eSpark-Backup/nabilfesal-smartmeter-hw/Design-Files/OFP_MCM_v1.6.3/Deliverables/_Renderings/2D_C_View.png

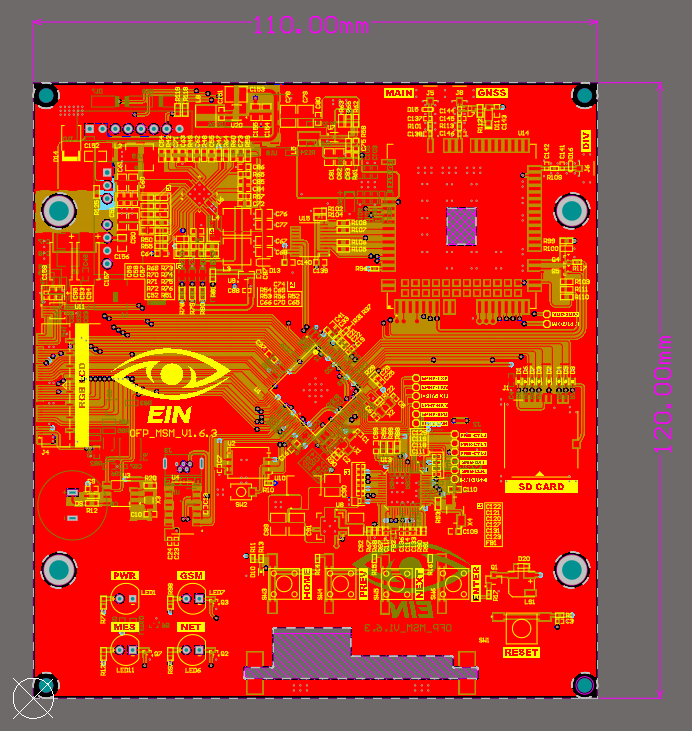
Design-Files/OFP_MCM_v1.6.3/Deliverables/_Renderings/2D_C_View.png
