eSpark-Backup/nabilfesal-smartmeter-hw/Design-Files/OFP_MCM_v1.6.3/Deliverables/_Renderings/3D_Isometric_View.png

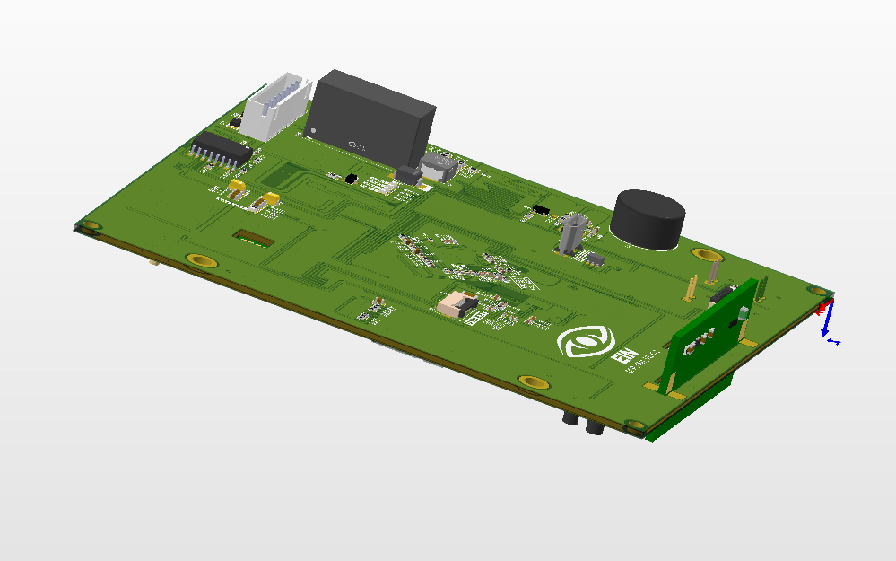
Design-Files/OFP_MCM_v1.6.3/Deliverables/_Renderings/3D_Isometric_View.png
