eSpark-Backup/nabilfesal-smartmeter-hw/Design-Files/OFP_VIM_DC_v1.51/Deliverables/Renderings/2D-C-view.png

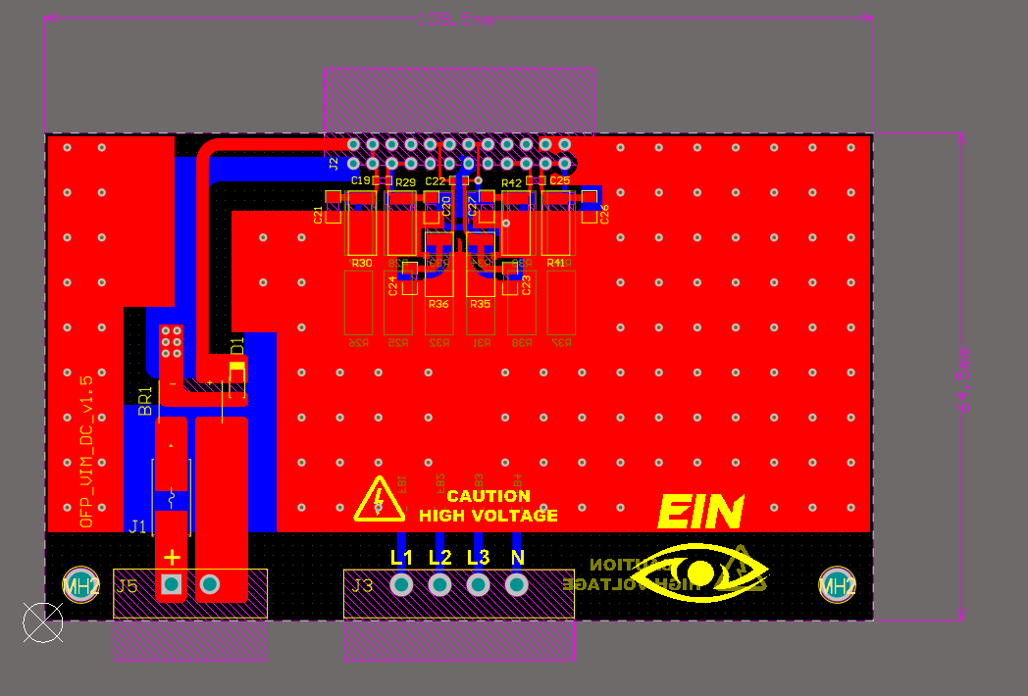
Design-Files/OFP_VIM_DC_v1.51/Deliverables/Renderings/2D-C-view.png
