eSpark-Backup/nabilfesal-smartmeter-hw/Design-Files/OFP_VIM_v1.51/Deliverables/Renderings/3D-ISOMETRIC-view.png

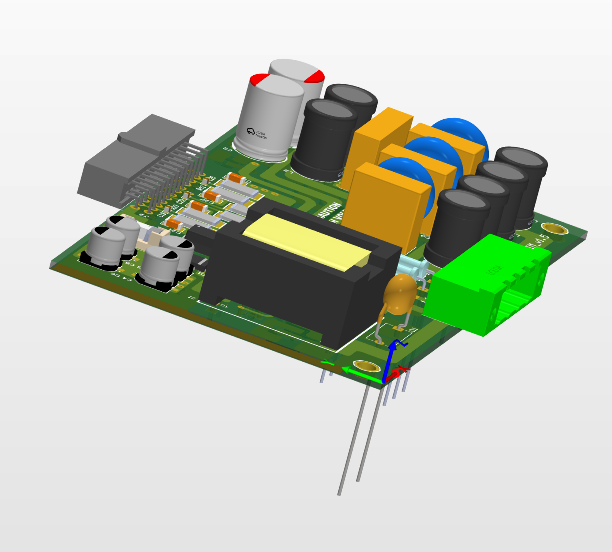
Design-Files/OFP_VIM_v1.51/Deliverables/Renderings/3D-ISOMETRIC-view.png
