eSpark-Backup/nabilfesal-smartmeter-hw/docs/Client-Files/PCB Images/20241227_104141.jpg

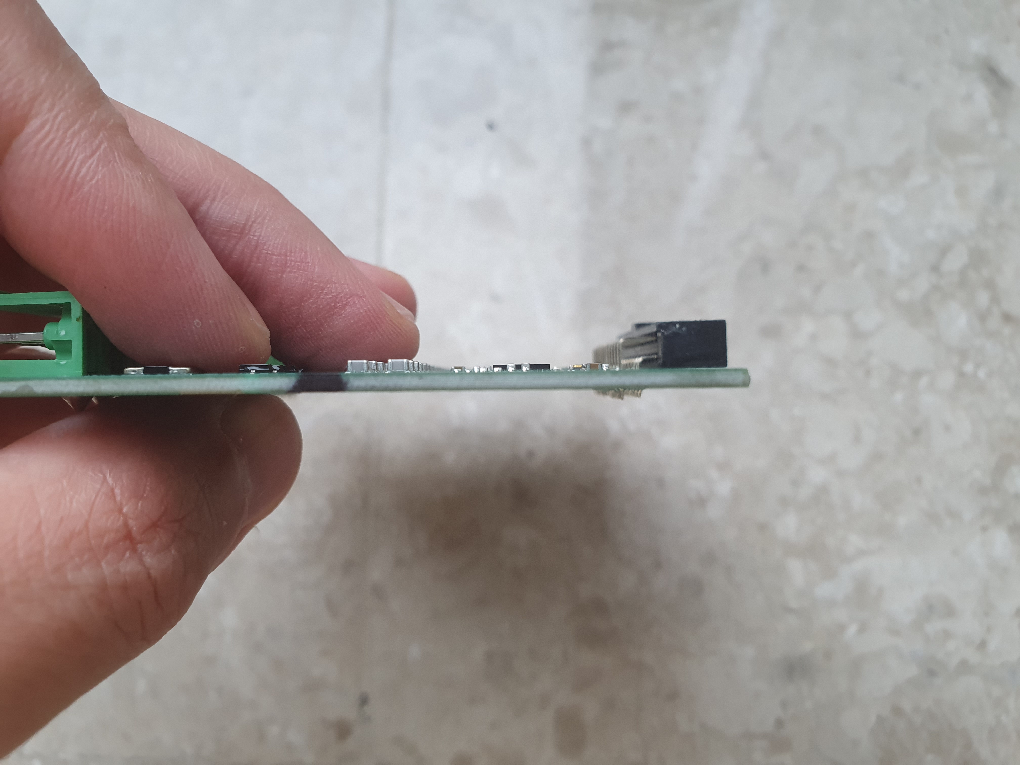
docs/Client-Files/PCB Images/20241227_104141.jpg
