eSpark-Backup/nabilfesal-smartmeter-hw/docs/Client-Files/PCB Images/20241227_104458.jpg

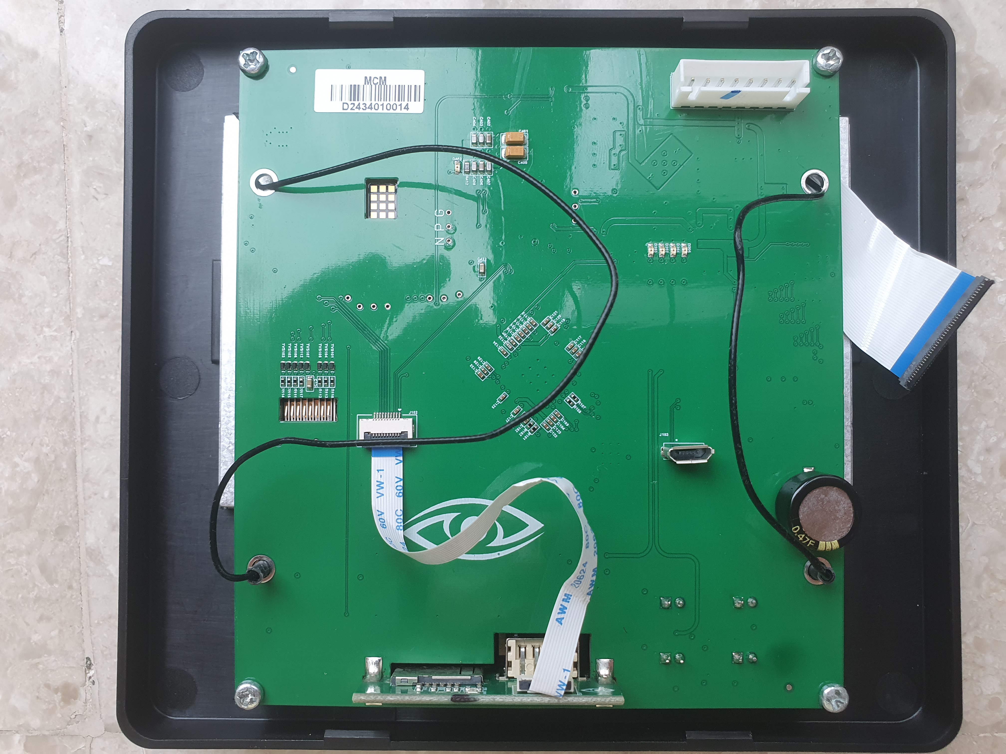
docs/Client-Files/PCB Images/20241227_104458.jpg
