eSpark-Backup/nabilfesal-smartmeter-hw/docs/Client-Files/PCB Images/20241227_105442.jpg

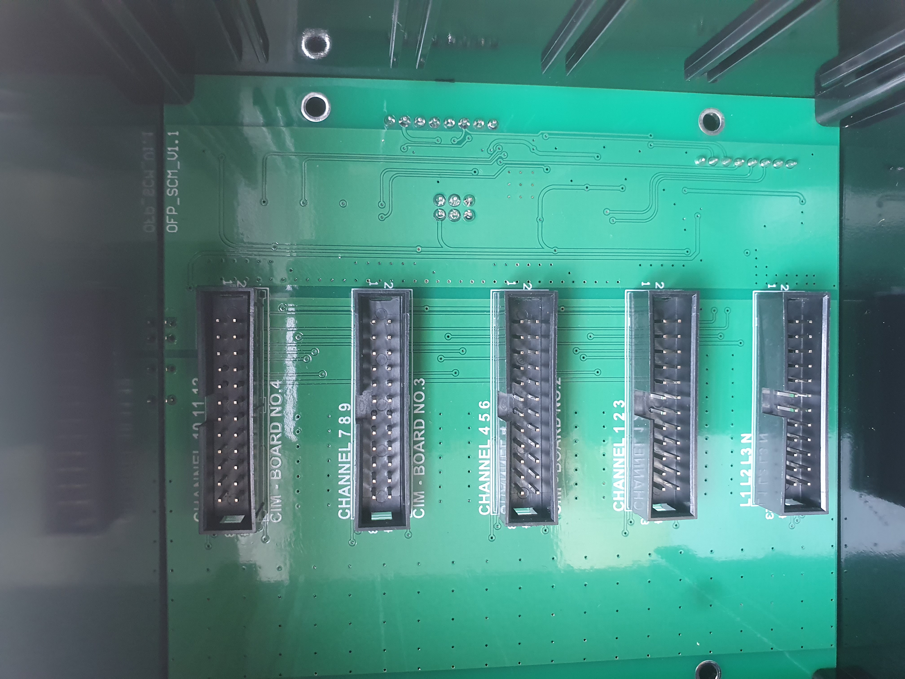
docs/Client-Files/PCB Images/20241227_105442.jpg
