eSpark-Backup/nabilfesal-smartmeter-hw/docs/Client-Files/PCB Images/WhatsApp Image 2024-12-26 at 13.09.12.jpeg

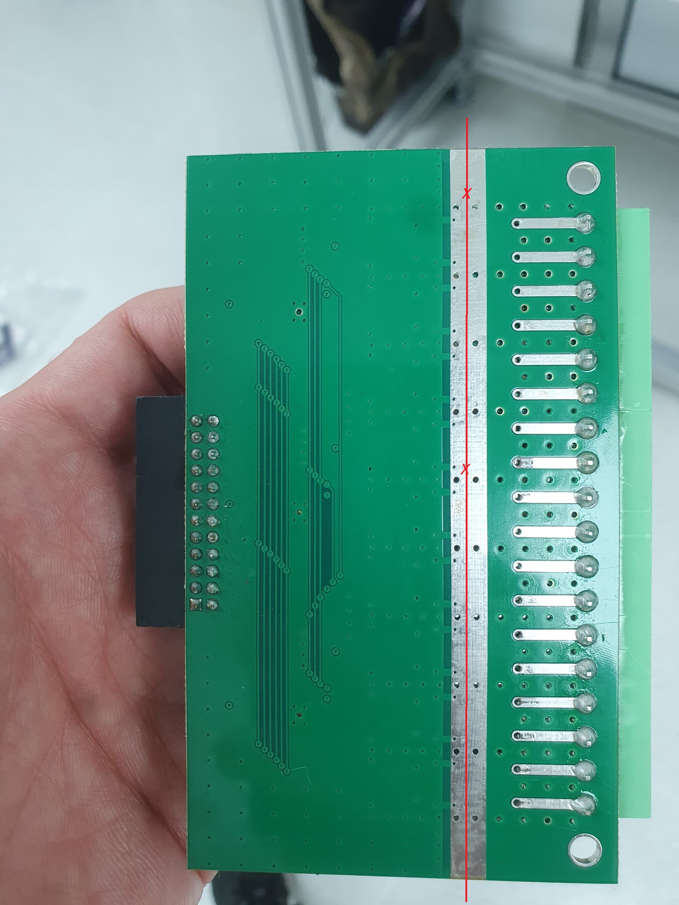
docs/Client-Files/PCB Images/WhatsApp Image 2024-12-26 at 13.09.12.jpeg
