eSpark-Backup/nabilfesal-smartmeter-hw/docs/Custom-Transformer/img-1.png

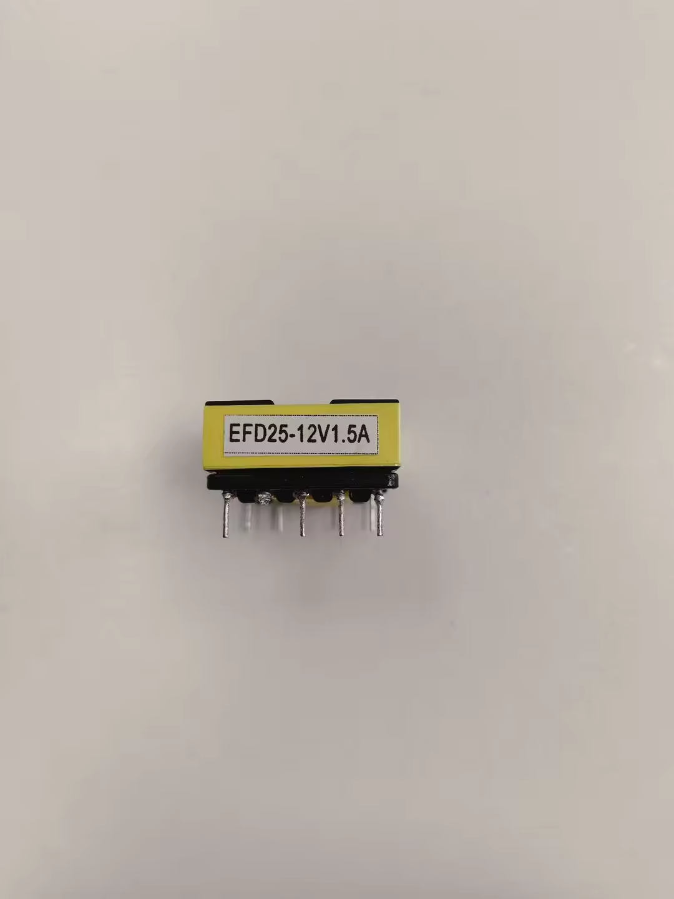
docs/Custom-Transformer/img-1.png
