eSpark-Backup/nabilfesal-smartmeter-hw/docs/Custom-Transformer/img-2.png

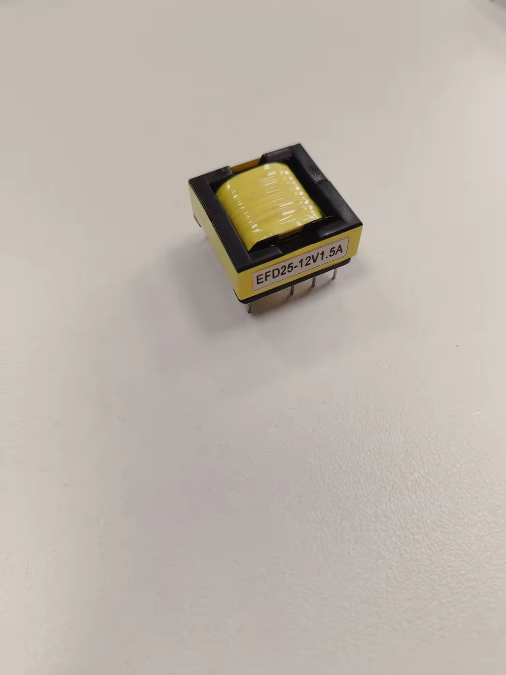
docs/Custom-Transformer/img-2.png
