eSpark-Backup/nabilfesal-smartmeter-hw/docs/Custom-Transformer/img-3.png

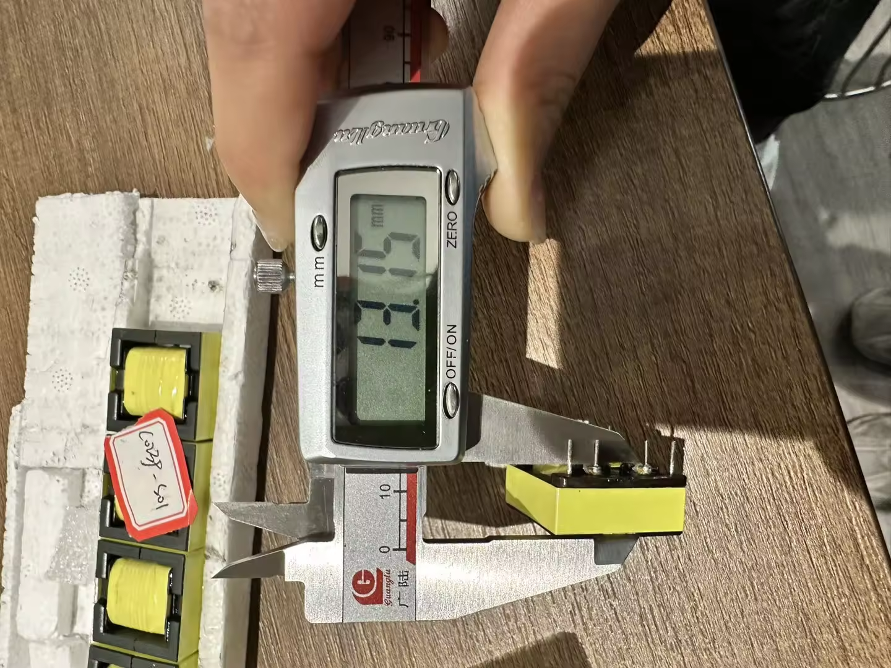
docs/Custom-Transformer/img-3.png
