eSpark-Backup/nabilfesal-smartmeter-hw/docs/Custom-Transformer/img-4.png

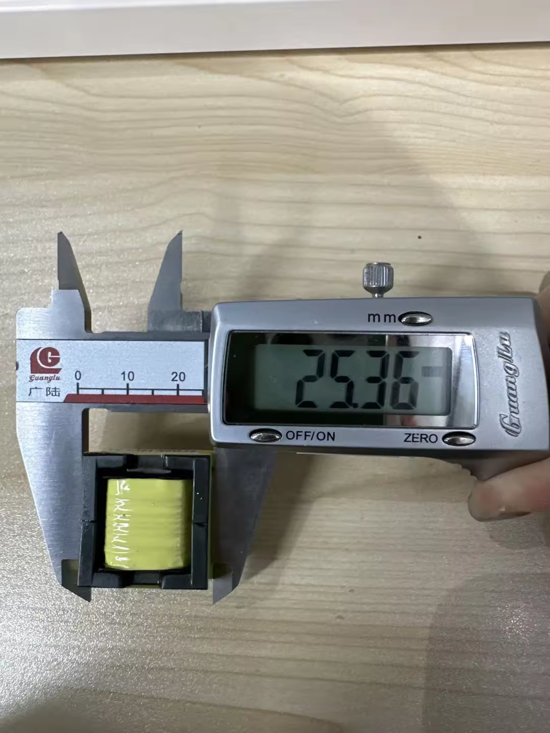
docs/Custom-Transformer/img-4.png
