eSpark-Backup/nabilfesal-smartmeter-hw/docs/Custom-Transformer/img-5.png

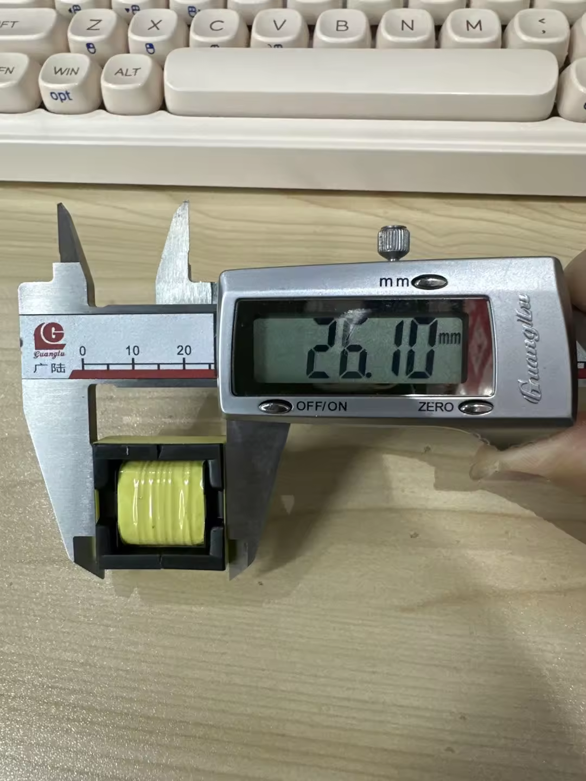
docs/Custom-Transformer/img-5.png
