eSpark-Backup/nabilfesal-smartmeter-hw/docs/Custom-Transformer/img-6.png

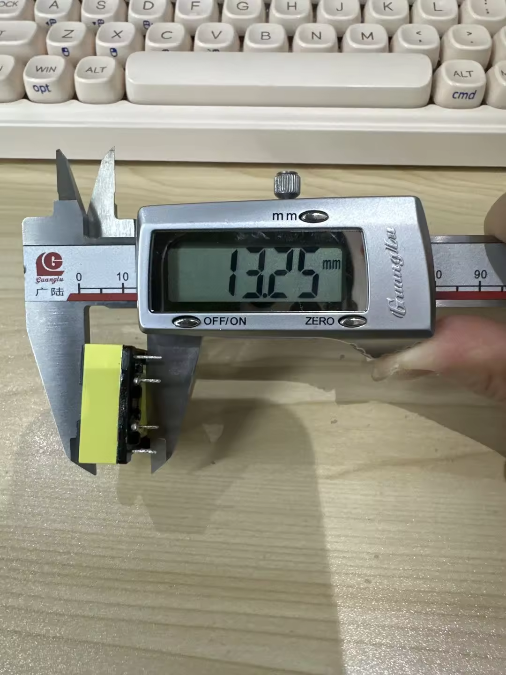
docs/Custom-Transformer/img-6.png
