eSpark-Backup/nabilfesal-smartmeter-hw/docs/Custom-Transformer/img-7.png

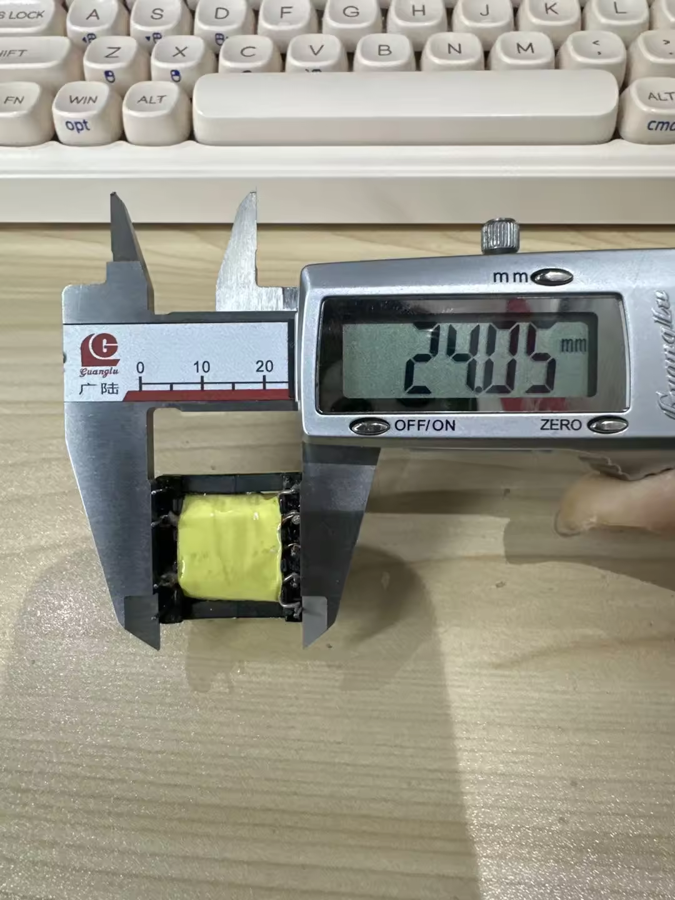
docs/Custom-Transformer/img-7.png
