eSpark-Backup/nabilfesal-smartmeter-hw/docs/Custom-Transformer/img-8.png

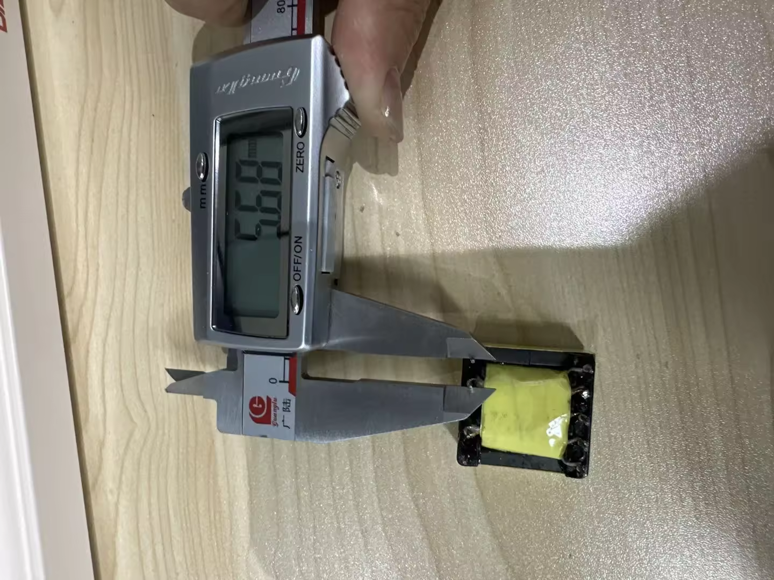
docs/Custom-Transformer/img-8.png
