eSpark-Backup/nabilfesal-smartmeter-hw/docs/Custom-Transformer/img-9.png

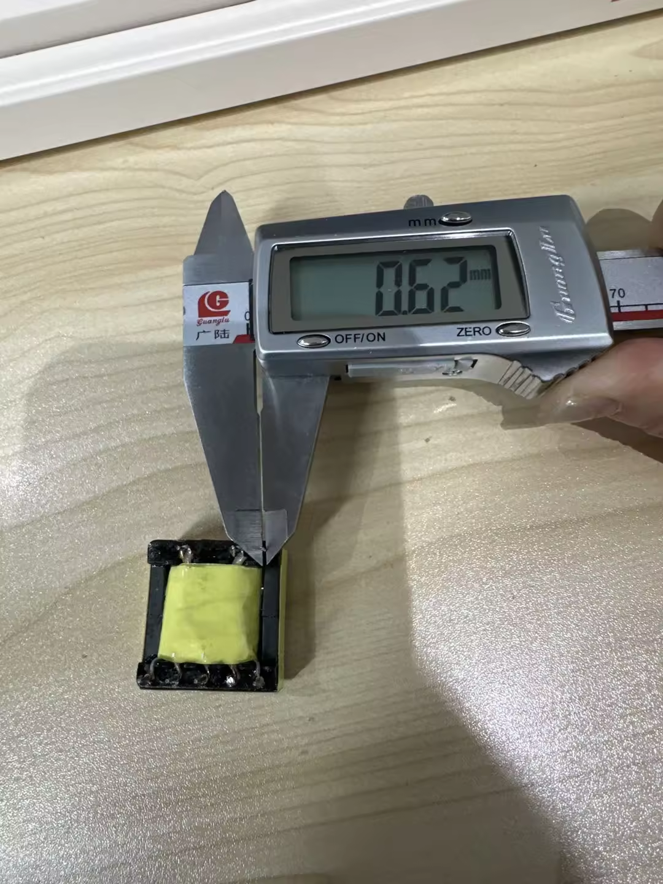
docs/Custom-Transformer/img-9.png
