eSpark-Backup/nabilfesal-smartmeter-hw/Enclosure-Files/Multichannel Smart Meter (MSM)-20251015T050852Z-1-001/Multichannel Smart Meter (MSM)/MSM Final Version V1 141025/MSM Packaging Stuff/BOX Stickers/Box Top Label.png

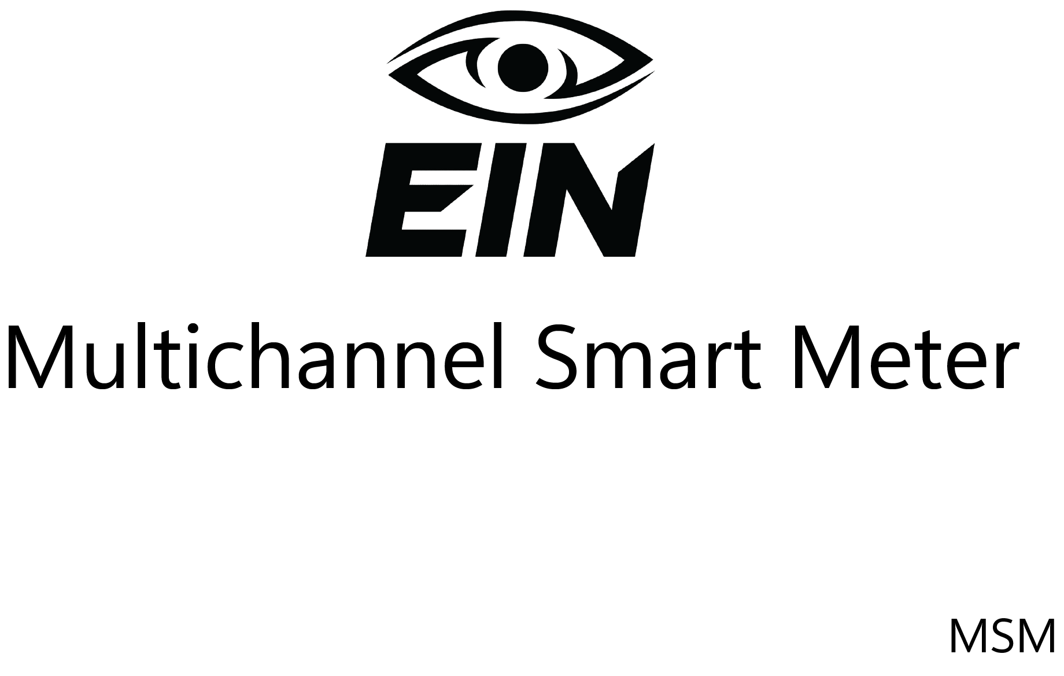
Enclosure-Files/Multichannel Smart Meter (MSM)-20251015T050852Z-1-001/Multichannel Smart Meter (MSM)/MSM Final Version V1 141025/MSM Packaging Stuff/BOX Stickers/Box Top Label.png
