eSpark-Backup/nabilfesal-smartmeter-hw/pics/Prototype/OFP_CIM_v1.5/OFP_CIM_v1 (6).JPG

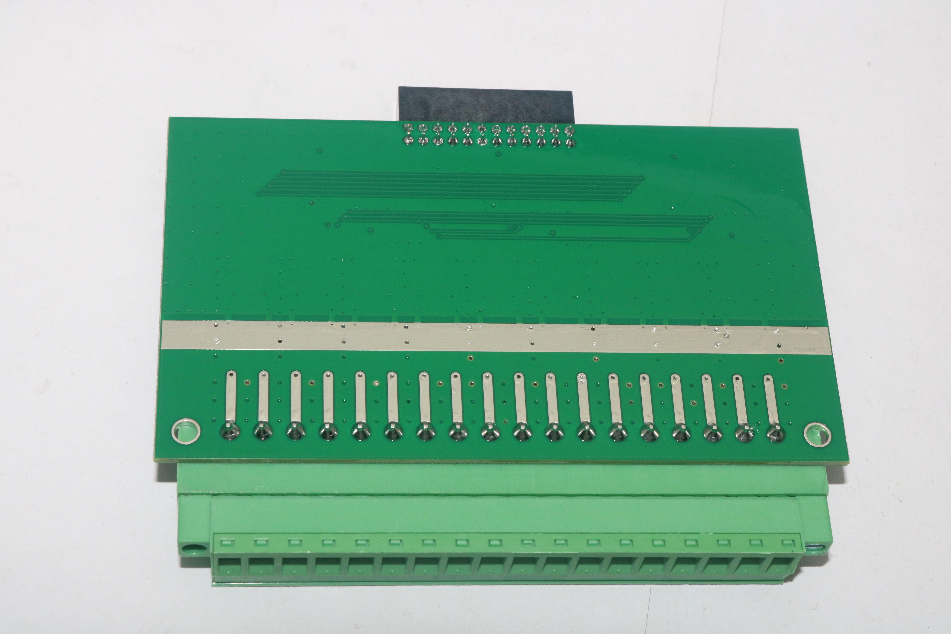
pics/Prototype/OFP_CIM_v1.5/OFP_CIM_v1 (6).JPG
