eSpark-Backup/nabilfesal-smartmeter-hw/pics/Prototype/OFP_MCM_v1.5/IMG_5417.JPG

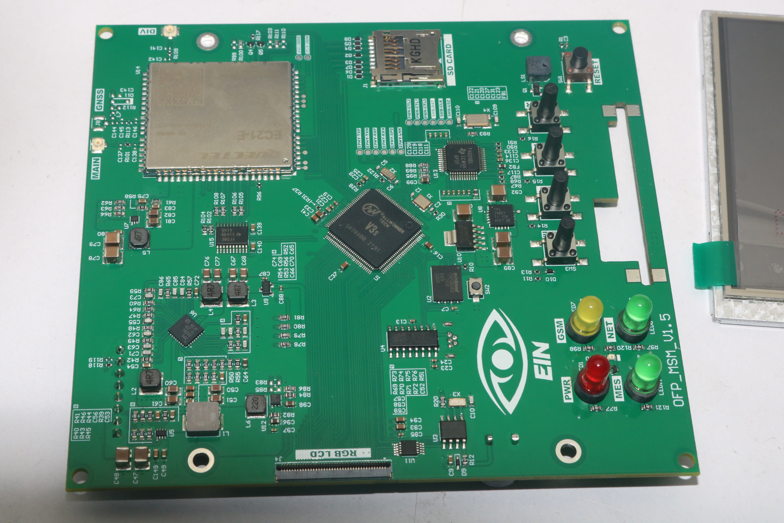
pics/Prototype/OFP_MCM_v1.5/IMG_5417.JPG
