eSpark-Backup/nabilfesal-smartmeter-hw/pics/Prototype/OFP_MCM_v1.5/IMG_5419.JPG

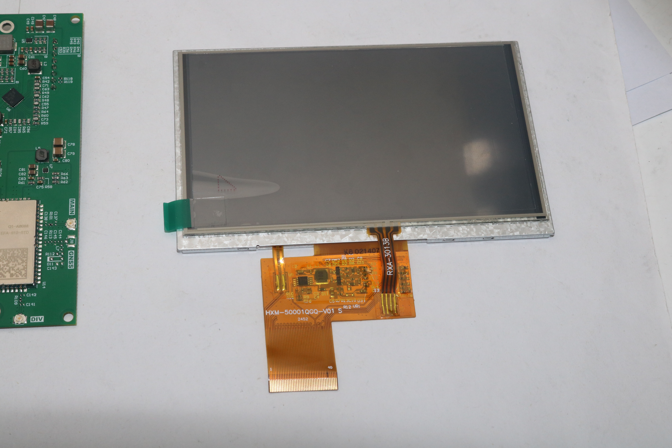
pics/Prototype/OFP_MCM_v1.5/IMG_5419.JPG
