eSpark-Backup/nabilfesal-smartmeter-hw/pics/Prototype/OFP_SCM_v1.5/OFP_SCM_v1 (1).JPG

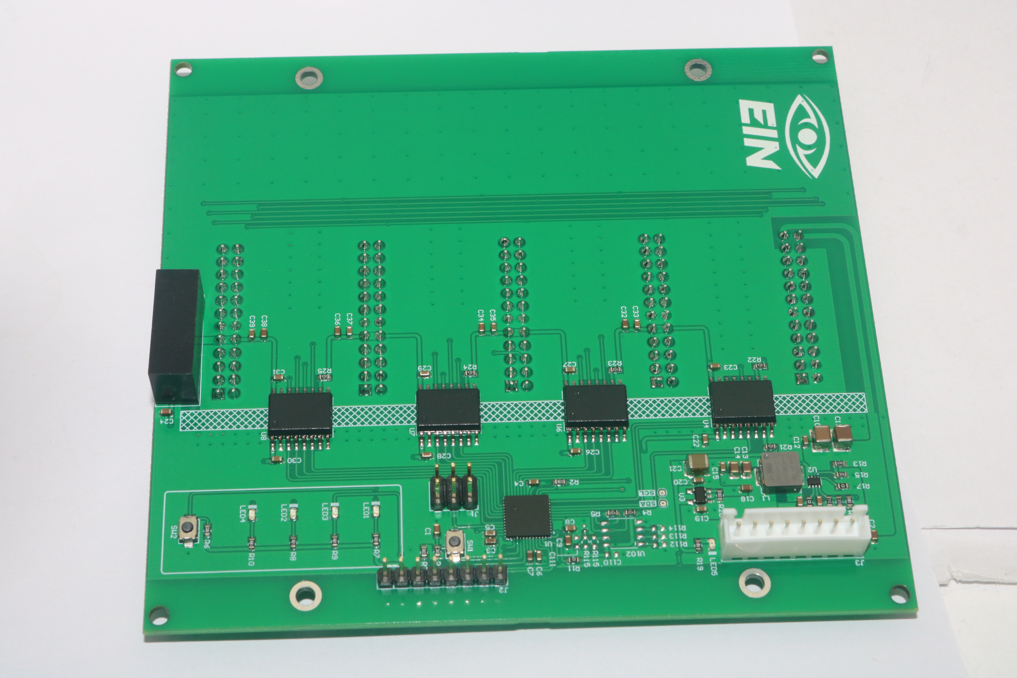
pics/Prototype/OFP_SCM_v1.5/OFP_SCM_v1 (1).JPG
