eSpark-Backup/nabilfesal-smartmeter-hw/pics/Prototype/OFP_USM_v1.5/OFP_USM_v1 (1).JPG

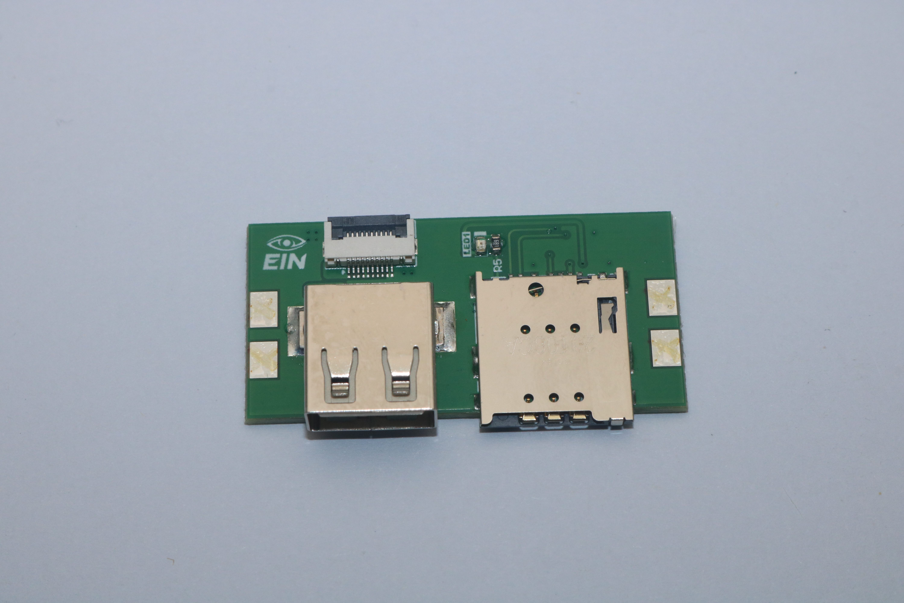
pics/Prototype/OFP_USM_v1.5/OFP_USM_v1 (1).JPG
