eSpark-Backup/nabilfesal-smartmeter-hw/pics/Prototype/OFP_VIM_v1.5/IMG_1143.JPG

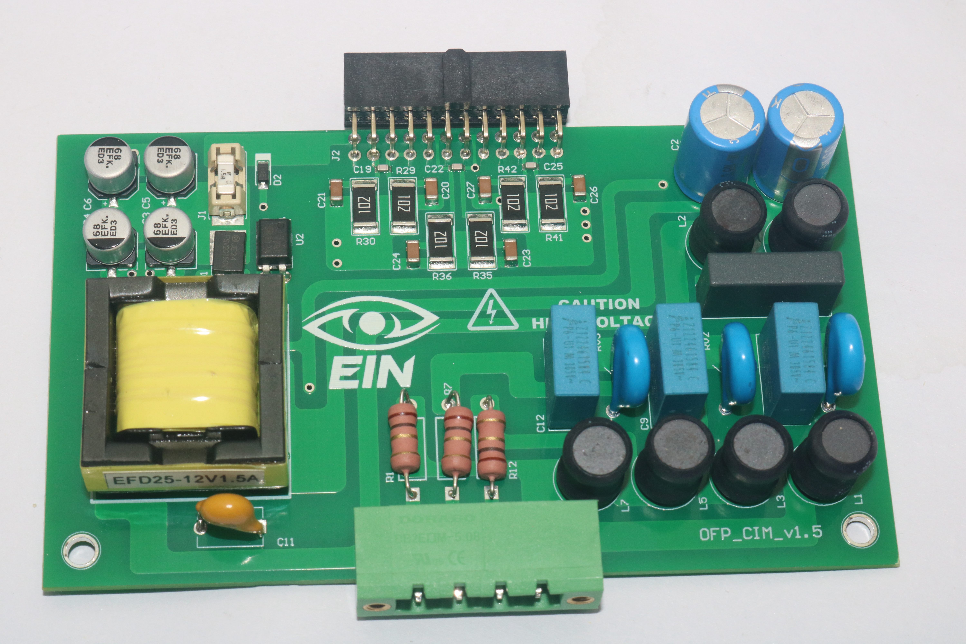
pics/Prototype/OFP_VIM_v1.5/IMG_1143.JPG
