eSpark-Backup/nabilfesal-smartmeter-hw/pics/Prototype/OFP_VIM_v1.5/OFP_VIM_v1 (4).JPG

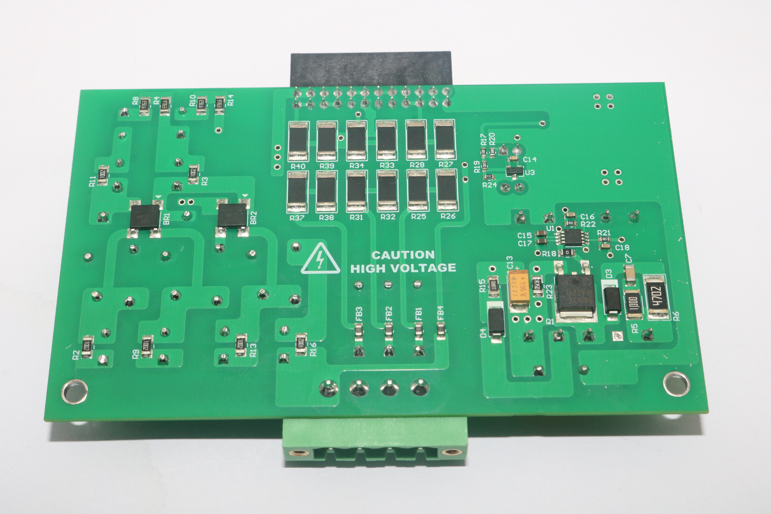
pics/Prototype/OFP_VIM_v1.5/OFP_VIM_v1 (4).JPG
