eSpark-Backup/nabilfesal-smartmeter-hw/Design-Files/OFP_VIM_DC_v1.51/BOM/Client-BOM-OFP_VIM_DC_v1.5.xlsx

# | Item Type | Designator | Description | Footprint | Manufacturer Part Number | Manufacturer | Comment | Quantity
1 | Bridge Rectifiers | BR1 | 60A 1.1V@3A 3A 1kV DBS Bridge Rectifiers ROHS | DBS | DB307S | GOODWORK | DB307S | 1
2 | Capacitors | C19, C22, C25 | 51 pF ±1% 250V Ceramic Capacitor C0G, NP0 0603 (1608 Metric) | Cap-0603 | GQM1875C2E510FB12D | Murata | 51pF | 3
3 | Capacitors | C20, C21, C23, C24, C26, C27 | CAP CER 0.022UF 500V X7R 1206 | Cap-1206 | CC1206KKX7RBBB223 | Yageo | 22nF | 6
4 | Diodes | D1 | DIODE ZENER 15V 500MW SOD123 | SOD-123W | MMSZ5245B-7-F | Diodes | 15V | 1
5 | Fuses | F1 | FUSE BRD MNT 1.5A 125VAC/VDC SMD |  | 045301.5MR | Littelfuse | 045301.5MR | 1
6 | Ferrite Beads | FB1, FB2, FB3, FB4 | FERRITE BEAD 1.5 KOHM 0805 1LN | Ind-0805 | BLM21BD152SN1D | Murata | BLM21BD152SN1D | 4
7 | Fuse Holders | J1 | FUSE BLOK CARTRIDGE 125V 10A SMD | 01550900M | 01550900M | Littelfuse | 01550900M | 1
8 | Connectors | J2 | CONN HDR 24POS 0.1 GOLD PCB R/A | SFH11-PBPC-D12-RA-BK | SFH11-PBPC-D12-RA-BK | Sullins | SFH11-PBPC-D12-RA-BK | 1
9 | Terminal Block | J3 | 320V 20A 4 Bend -40℃~+105℃ 1 5.08mm 1x4P Green Receptacle-Close Screw Fixing Push-Pull,P=5.08mm Pluggable System Terminal Block ROHS | DB2ERM-5.08-4P-GN | DB2ERM-5.08-4P-GN | DORABO | DB2ERM-5.08-4P-GN | 1
10 | Terminal Block | J4 | -40℃~+105℃ 2.5 1 14~28 5.08mm 320V 20A 4 1x4P Green Plug Screw Fixing P=5.08mm Pluggable System Terminal Block ROHS |  | DB2EKM-5.08-4P-GN-S | DORABO | DB2EKM-5.08-4P-GN-S | 1
11 | Terminal Block | J5 | 320V 20A 2 Right-Angle Pin -40℃~+105℃ 1 5.08mm 1x2P Green Board Side/Socket - Closed Screw Push-Pull,P=5.08mm Pluggable System Terminal Block ROHS | DB2ERM-5.08-2P-GN | DB2ERM-5.08-2P-GN | DORABO | DB2ERM-5.08-2P-GN | 1
12 | Terminal Block | J6 | 40℃~+105℃ 2.5 1 14~28 5.08mm 320V 20A 2 1x2P Green Plug Screw P=5.08mm Pluggable System Terminal Block ROHS |  | DB2EKM-5.08-2P-GN-S | DORABO | DB2EKM-5.08-2P-GN-S | 1
13 | Resistors | R25, R26, R27, R28, R31, R32, R33, R34, R37, R38, R39, R40 | RES SMD 200K OHM 1% 1W 2512 | RES-2512 | CRCW2512200KFKEG | Vishay Dale | 200K | 12
14 | Resistor | R29, R30, R35, R36, R41, R42 | RES 1K OHM 5% 1W 2512 | RES-2512 | RC2512JK-071KL | Yageo | 1K | 6
