eSpark-Backup/nabilfesal-smartmeter-hw/Design-Files/OFP_CIM_v1.5/BOM/Client-BOM-OFP_CIM_v1.5.xlsx

# | Item Type | Designator | Description | Footprint | Manufacturer Part Number | Manufacturer | Value | Quantity | Remarks
1 | Capacitors | C1, C2, C3, C4, C5, C6, C7, C8, C11, C12, C13, C14, C28, C29, C30, C31, C32, C33, C34, C35, C38, C39, C40, C41, C55, C56, C57, C58, C59, C60, C61, C62, C65, C66, C67, C68 | CAP CER 0.022UF 50V C0G/NP0 0805 | Cap-0805 | GRM21B5C1H223JA01L | Murata | 22nF | 36
2 | Capacitor | C9, C10, C36, C37, C63, C64 | CAP CER 15PF 50V C0G/NPO 0603 | Cap-0603 | CC0603JRNPO9BN150 | Yageo | 15pF | 6
3 | Capacitors | C15, C20, C22, C24, C26, C42, C47, C49, C51, C53, C69, C74, C76, C78, C80, C82 | CAP CER 0.1UF 50V X7R 0603 | Cap-0603 | GCJ188R71H104KA12D | Murata | 0.1uF | 16
4 | Capacitors | C21, C23, C25, C27, C48, C50, C52, C54, C75, C77, C79, C81, C83 | CAP CER 4.7UF 10V X7R 0603 | Cap-0603 | GRM188Z71A475KE15D | Murata | 4.7uF | 13
5 | Diodes | D1, D2, D3, D4, D5, D6, D9, D10, D11, D12, D13, D14, D17, D18, D19, D20, D21, D22 | DIODE ARR GP 100V 215MA TO-236AB | SOT-23 | BAV99,215 | Nexperia | - | 18
6 | Terminal Block | J1 | 320V 20A 18 Bend -40℃~+105℃ 1 5.08mm 1x18P Green Receptacle-Close Screw Fixing Push-Pull,P=5.08mm Pluggable System Terminal Block ROHS | DB2ERM-5.08-18P-GN | DB2ERM-5.08-18P-GN | DORABO | - | 1
7 | Connectors | J2 | CONN HDR 24POS 0.1 GOLD PCB R/A | Custom | SFH11-PBPC-D12-RA-BK | Sullins | - | 1
8 | Terminal Block | J3 | -40℃~+105℃ 2.5 1 14~28 5.08mm 320V 20A 18 1x18P Green Plug Screw Fixing P=5.08mm Pluggable System Terminal Block ROHS | Custom | DB2EKM-5.08-18P-GN-S | DORABO | - | 1 | This Part Use As Peripheral
9 | LED | LED1, LED2, LED3, LED4, LED5, LED6, LED7, LED8, LED9, LED10, LED11, LED12 | Emerald 0603 Light Emitting Diodes (LED) ROHS | LED-0603 | NCD0603G2 | Foshan NationStar Optoelectronics | - | 12
10 | Resistor | R1, R5, R7, R8, R9, R13, R15, R19, R25, R27, R34, R38, R40, R41, R42, R46, R48, R52, R58, R60, R67, R71, R73, R74, R75, R79, R81, R85, R91, R93 | RES SMD 0R, 1%, 0.1W, 0603 | Res-0603 | RC0603FR-070RL | Yageo | 0R | 30
11 | Resistor | R2, R6, R10, R14, R16, R20, R35, R39, R43, R47, R49, R53, R68, R72, R76, R80, R82, R86 | RES SMD 1K OHM 1% 1/10W 0603 | Res-0603 | RC0603FR-071KL | Yageo | 1K | 18
12 | Resistors | R3, R4, R11, R12, R17, R18, R36, R37, R44, R45, R50, R51, R69, R70, R77, R78, R83, R84 | RES 0.002 OHM 1% 3W 2512 | RES-2512 | PA2512FKE7T0R002E | Yageo | 2mR | 18
13 | Resistor | R21, R54, R87 | RES SMD 10K Ohm 1% 1/10W 0603 | Res-0603 | RC0603FR-0710KL | Yageo | 10K | 3
14 | Resistor | R30, R31, R32, R33, R63, R64, R65, R66, R96, R97, R98, R99 | RES SMD 680 OHM 1% 1/10W 0603 | Res-0603 | RC0603FR-07680RL | Yageo | 680R | 12
15 | IC | U1, U2, U3 | IC AFE 7 CHAN 40LFCSP-WQ | 40-LFCSP-WQ (6x6) | ADE9000ACPZ | Analog Devices | - | 3
16 | Crystal | X1, X2, X3 | 24.576MHz Surface Mount Crystal 12pF ±10ppm ±20ppm SMD3225-4P Crystals ROHS | SMD3225-4P | X322524576MOB4SI | YXC | 24.576MHz | 3
