eSpark-Backup/nabilfesal-smartmeter-hw/Design-Files/OFP_VIM_v1.51/BOM/Client-BOM-OFP_VIM_v1.51.xlsx

# | Item Type | Designator | Description | Footprint | Manufacturer Part Number | Manufacturer | Value | Quantity | Remarks
1 | Bridge | BR1, BR2 | 30A 950mV@400mA 1A 800V LMBS-1 Bridge Rectifiers ROHS | LMBS-1 | LMB8S-TP | MCC(Micro Commercial Components) | - | 2
2 | Film Capacitors | C1, C9, C12 | CAP FILM 0.1UF 20% 630VDC RADIAL | Custom | B32921C3104M000 | TDK EPCOS | 0.1uF | 3
3 | Capacitor | C2, C10 | 33uF 420V 1Ω@100kHz 430mA@100kHz ±20% Plugin,D10xL16mm Aluminum Electrolytic Capacitors - Leaded ROHS | Custom | 87EC0494 | KNSCHA | 33uF | 2
4 | Capacitor | C3, C4, C5, C6 | CAP ALUM 68UF 20% 25V SMD | Custom | EEE-FK1E680P | Panasonic | 68uF | 4
5 | Capacitors | C7 | CAP CER 1000PF 1KV X7R 1206 | Cap-1206 | GRM31BR73A102KW01L | Murata | 1nF | 1
6 | Capacitor | C8 | 10nF -40℃~+105℃ ±5% 1kV Plugin,P=15mm Polypropylene Film Capacitors (CBB) ROHS | Custom | KP103J1000VP15 | KYET | 10nF | 1
7 | Capacitors | C11 | CAP CER 1000PF 440VAC Y5U RADIAL | Custom | VY2102M29Y5US6TV7 | Vishay BCcomponents | 1nF | 1
8 | Tantalum Capacitors | C13 | CAP TANT 10UF 10% 35V 2312 | Case-C | TAJC106K035RNJ | Kyocera AVX | 10uF | 1
9 | Capacitor | C14 | CAP CER 10000PF 50V X7R 0603 | Cap-0603 | CC0603KRX7R9BB103 | Yageo | 0.01uF | 1
10 | Capacitors | C15, C17 | CAP CER 1UF 50V X7R 0603 | Cap-0603 | CC0603KRX7R9BB105 | Yageo | 1uF | 2
11 | Capacitors | C16 | CAP CER 0.22UF 25V X7R 0603 | Cap-0603 | CC0603KRX7R8BB224 | Yageo | 220nF | 1
12 | Capacitors | C18 | CAP CER 220PF 50V X7R 0603 | Cap-0603 | CC0603JRX7R9BB221 | Yageo | 220pF | 1
13 | Capacitors | C19, C22, C25 | 51 pF ±1% 250V Ceramic Capacitor C0G, NP0 0603 (1608 Metric) | Cap-0603 | GQM1875C2E510FB12D | Murata | 51pF | 3
14 | Capacitors | C20, C21, C23, C24, C26, C27 | CAP CER 0.022UF 500V X7R 1206 | Cap-1206 | CC1206KKX7RBBB223 | Yageo | 22nF | 6
15 | Diodes | D1 | DIODE SCHOTTKY 150V 20A TO2773 | TO-277A | FSV20150V | ON Semiconductor / Fairchild | - | 1
16 | Diodes | D2 | DIODE ZENER 15V 500MW SOD123 | SOD-123W | MMSZ5245B-7-F | Diodes | 15V | 1
17 | Diodes | D3 | DIODE STANDARD 800V 1A SMA | SMA | US1K-13-F | Diodes | - | 1
18 | Diodes | D4 | DIODE STANDARD 150V 1A SMA | SMA | ES1C-13-F | Diodes | - | 1
19 | Fuses | F1 | FUSE BRD MNT 1.5A 125VAC/VDC SMD | Custom | 045301.5MR | Littelfuse | - | 1
20 | Ferrite Beads | FB1, FB2, FB3, FB4 | FERRITE BEAD 1.5 KOHM 0805 1LN | Ind-0805 | BLM21BD152SN1D | Murata | - | 4
21 | Fuse Holders | J1 | FUSE BLOK CARTRIDGE 125V 10A SMD | Custom | 01550900M | Littelfuse | - | 1
22 | Connectors | J2 | CONN HDR 24POS 0.1 GOLD PCB R/A | Custom | SFH11-PBPC-D12-RA-BK | Sullins | - | 1
23 | Terminal Block | J3 | 320V 20A 4 Bend -40℃~+105℃ 1 5.08mm 1x4P Green Receptacle-Close Screw Fixing Push-Pull,P=5.08mm Pluggable System Terminal Block ROHS | Custom | DB2ERM-5.08-4P-GN | DORABO | - | 1
24 | Terminal Block | J4 | -40℃~+105℃ 2.5 1 14~28 5.08mm 320V 20A 4 1x4P Green Plug Screw Fixing P=5.08mm Pluggable System Terminal Block ROHS | Custom | DB2EKM-5.08-4P-GN-S | DORABO | - | 1 | This Part Use As Peripheral
25 | Inductor | L1, L2, L3, L5, L6, L7 | 420mA 470uH EI-core Inductor ±20% Plugin Power Inductors ROHS | Custom | PK0810-471MB | SXN(Shun Xiang Nuo Elec) | 470uH | 6
26 | Mosfet | Q1 | 900V 5.1A 83W 1.2Ω@10V,2.8A 3.5V 1 N-channel TO-252-3 MOSFETs ROHS | TO-252-2L | IPD90R1K2C3 | Infineon | - | 1
27 | Through-Hole Resistors | R1, R7, R12 | RES 1 OHM 5% 2W AXIAL | Custom | FMP200JR-52-1R | Yageo | 1R | 3
28 | Resistors | R2, R3, R9, R11, R13, R16 | RES 10K OHM 1% 1/2W 1206 | Res-1206 | AC1206FR-7W10KL | Yageo | 10K | 6
29 | Resistors | R4, R8, R10, R14 | RES SMD 976K OHM 0.1% 1/4W 1206 | Res-1206 | RT1206BRD07976KL | Yageo | 976K | 4
30 | Resistors | R5 | RES SMD 100 OHM 1% 3/4W 2010 | Res_1210 | AC2010FK-07100RL | Yageo | 100R | 1
31 | Resistors | R6 | RES SMD 47K OHM 1% 1W 2512 | RES-2512 | AC2512FK-0747KL | Yageo | 47K | 1
32 | Resistor | R15 | RES 10 OHM 1% 1/4W 1206 | Res-1206 | RC1206FR-0710RL | Yageo | 10R | 1
33 | Resistor | R17 | RES 49.9 OHM 1% 1/10W 0603 | Res-0603 | RC0603FR-0749R9L | Yageo | 49.9R | 1
34 | Resistor | R18 | RES 0 OHM JUMPER 1/8W 0805 | Res-0805 | RC0805FR-070RL | Yageo | 0R | 1
35 | Resistors | R19 | RES 100K OHM 1% 1/10W 0603 | Res-0603 | RC0603FR-07100KL | Yageo | 100K | 1
36 | Resistors | R20 | RES 4.99K OHM 1% 1/10W 0603 | Res-0603 | RC0603FR-074K99L | Yageo | 4.99K | 1
37 | Resistor | R21 | RES SMD 1K OHM 1% 1/10W 0603 | Res-0603 | RC0603FR-071KL | Yageo | 1K | 1
38 | Resistors | R22 | RES SMD 66.5KOHM 0.1% 1/10W 0603 | Res-0603 | RT0603BRD0766K5L | Yageo | 66.5K | 1
39 | Resistors | R23 | RES 0.75 OHM 1% 1/2W 1206 | Res-1206 | RL1206FR-7W0R75L | Yageo | 750mR | 1
40 | Resistors | R24 | RES SMD 26.1KOHM 0.1% 1/10W 0603 | Res-0603 | RT0603BRD0726K1L | Yageo | 26.1K | 1
41 | Resistors | R25, R26, R27, R28, R31, R32, R33, R34, R37, R38, R39, R40 | RES SMD 200K OHM 1% 1W 2512 | RES-2512 | CRCW2512200KFKEG | Vishay Dale | 200K | 12
42 | Resistor | R29, R30, R35, R36, R41, R42 | RES 1K OHM 5% 1W 2512 | RES-2512 | RC2512JK-071KL | Yageo | 1K | 6
43 | Varistors | RV1, RV2, RV3 | 775V 385V 300V 470V Plugin Varistors ROHS | Custom | 471KD10J | Yageo | - | 3
44 | Transformer | T1 | 12V/1.5A transformer | Custom | FTEFD25-037 | - | - | 1 | Design From Custom Supplier
45 | IC | U1 | IC OFFLINE SW MULT TOP 8VSSOP | 8-VSSOP (Pitch 0.65mm)(5x3.1mm) | LM5021MM-1/NOPB | TI National Semiconductor | - | 1
46 | IC | U2 | OPTOISOLATOR 5KV TRANSISTOR 4DIP | DIP-4 | FOD817A | ON Semiconductor / Fairchild | - | 1
47 | IC | U3 | IC VREF SHUNT ADJ 1% SOT23-3 | SOT-23 | ATL431AIDBZR | Texas Instruments | - | 1
