eSpark-Backup/nabilfesal-smartmeter-hw/Design-Files/OFP_VIM_v1.51/BOM/eSpark-BOM-OFP_VIM_v1.51.xlsx

Sheet: 10 Boards
 |  | Component list |  | Bill of Materials for Project [OFP_VIM_v1.5
 |  | Project: |  | OFP_VIM_v1.5
# | Item Type | Designator | Description | Footprint | Manufacturer Part Number | Manufacturer | Alternate Part Number | LCSC Part Number | Value | Quantity | Quantity (10 Boards) | MOQ (10 Boards) | Links | Unit Cost (10 Boards) | Total Cost (10 Boards) | Remarks
1 | Bridge | BR1, BR2 | 30A 950mV@400mA 1A 800V LMBS-1 Bridge Rectifiers ROHS | LMBS-1 | LMB8S-TP | MCC(Micro Commercial Components) | - | C435904 | - | 2 | 20 | 25 | LCSC (https://www.lcsc.com/product-detail/bridge-rectifiers_mcc-micro-commercial-components-lmb8s-tp_C435904.html) | 0.0852 | $2.1300
2 | Film Capacitors | C1, C9, C12 | CAP FILM 0.1UF 20% 630VDC RADIAL | Custom | B32921C3104M000 | TDK EPCOS | - | C361368 | 0.1uF | 3 | 30 | 35 | LCSC (https://www.lcsc.com/product-detail/Safety-Capacitors_TDK-B32921C3104M000_C361368.html?s_z=n_C361368) | $0.2131 | $7.4585
3 | Capacitor | C2, C10 | 33uF 420V 1Ω@100kHz 430mA@100kHz ±20% Plugin,D10xL16mm Aluminum Electrolytic Capacitors - Leaded ROHS | Custom | 87EC0494 | KNSCHA | - | C6718366 | 33uF | 2 | 20 | 21 | LCSC (https://www.lcsc.com/product-detail/aluminum-electrolytic-capacitors-leaded_knscha-87ec0494_C6718366.html) | 0.2582 | $5.4222
4 | Capacitor | C3, C4, C5, C6 | CAP ALUM 68UF 20% 25V SMD | Custom | EEE-FK1E680P | Panasonic | - | C336242 | 68uF | 4 | 40 | 45 | LCSC (https://www.lcsc.com/product-detail/aluminum-electrolytic-capacitors-smd_panasonic-eeefk1e680p_C336242.html) | 0.1894 | $8.5230
5 | Capacitors | C7 | CAP CER 1000PF 1KV X7R 1206 | Cap-1206 | GRM31BR73A102KW01L | Murata | - | C97941 | 1nF | 1 | 10 | 20 | LCSC (https://www.lcsc.com/product-detail/multilayer-ceramic-capacitors-mlcc-smd-smt_murata-electronics-grm31br73a102kw01l_C97941.html) | 0.0238 | $0.4760
6 | Capacitor | C8 | 10nF -40℃~+105℃ ±5% 1kV Plugin,P=15mm Polypropylene Film Capacitors (CBB) ROHS | Custom | KP103J1000VP15 | KYET | - | C390160 | 10nF | 1 | 10 | 15 | LCSC (https://www.lcsc.com/product-detail/polypropylene-film-capacitors-cbb_kyet-kp103j1000vp15_C390160.html) | 0.1561 | $2.3415
7 | Capacitors | C11 | CAP CER 1000PF 440VAC Y5U RADIAL | Custom | VY2102M29Y5US6TV7 | Vishay BCcomponents | - | C511063 | 1nF | 1 | 10 | 15 | LCSC (https://www.lcsc.com/product-detail/safety-capacitors_vishay-intertech-vy2102m29y5us6tv7_C511063.html) | 0.1303 | $1.9545
8 | Tantalum Capacitors | C13 | CAP TANT 10UF 10% 35V 2312 | Case-C | TAJC106K035RNJ | Kyocera AVX | - | C7211 | 10uF | 1 | 10 | 15 | LCSC (https://www.lcsc.com/product-detail/tantalum-capacitors_kyocera-avx-tajc106k035rnj_C7211.html) | 0.2657 | $3.9855
9 | Capacitor | C14 | CAP CER 10000PF 50V X7R 0603 | Cap-0603 | CC0603KRX7R9BB103 | Yageo | - | C100042 | 0.01uF | 1 | 10 | 100 | LCSC (https://www.lcsc.com/product-detail/multilayer-ceramic-capacitors-mlcc-smd-smt_yageo-cc0603krx7r9bb103_C100042.html) | 0.0022 | $0.2200
10 | Capacitors | C15, C17 | CAP CER 1UF 50V X7R 0603 | Cap-0603 | CC0603KRX7R9BB105 | Yageo | - | C559769 | 1uF | 2 | 20 | 40 | LCSC (https://www.lcsc.com/product-detail/multilayer-ceramic-capacitors-mlcc-smd-smt_yageo-cc0603krx7r9bb105_C559769.html) | 0.0257 | $1.0280
11 | Capacitors | C16 | CAP CER 0.22UF 25V X7R 0603 | Cap-0603 | CC0603KRX7R8BB224 | Yageo | - | C106857 | 220nF | 1 | 10 | 50 | LCSC (https://www.lcsc.com/product-detail/multilayer-ceramic-capacitors-mlcc-smd-smt_yageo-cc0603krx7r8bb224_C106857.html) | 0.0079 | $0.3950
12 | Capacitors | C18 | CAP CER 220PF 50V X7R 0603 | Cap-0603 | CC0603JRX7R9BB221 | Yageo | - | C327270 | 220pF | 1 | 10 | 100 | LCSC (https://www.lcsc.com/product-detail/multilayer-ceramic-capacitors-mlcc-smd-smt_yageo-cc0603jrx7r9bb221_C327270.html) | 0.0042 | $0.4200
13 | Capacitors | C19, C22, C25 | 51 pF ±1% 250V Ceramic Capacitor C0G, NP0 0603 (1608 Metric) | Cap-0603 | GQM1875C2E510FB12D | Murata | - | C17504198 | 51pF | 3 | 30 | 32 | LCSC (https://www.lcsc.com/product-detail/multilayer-ceramic-capacitors-mlcc-smd-smt_murata-electronics-gqm1875c2e510fb12d_C17504198.html) | 0.1606 | $5.1392
14 | Capacitors | C20, C21, C23, C24, C26, C27 | CAP CER 0.022UF 500V X7R 1206 | Cap-1206 | CC1206KKX7RBBB223 | Yageo | - | - | 22nF | 6 | 60 | 61 | Chipsmall (https://www.chipsmall.com/Products/CC1206KKX7RBBB223_11665884.html) | $0.0210 | $1.2810
15 | Diodes | D1 | DIODE SCHOTTKY 150V 20A TO2773 | TO-277A | FSV20150V | ON Semiconductor / Fairchild | - | C606024 | - | 1 | 10 | 11 | LCSC (https://www.lcsc.com/product-detail/schottky-diodes_onsemi-fsv20150v_C606024.html) | 0.8316 | $9.1476
16 | Diodes | D2 | DIODE ZENER 15V 500MW SOD123 | SOD-123W | MMSZ5245B-7-F | Diodes | - | C177050 | 15V | 1 | 10 | 20 | LCSC (https://www.lcsc.com/product-detail/zener-diodes_diodes-incorporated-mmsz5245b-7-f_C177050.html) | 0.0285 | $0.5700
17 | Diodes | D3 | DIODE STANDARD 800V 1A SMA | SMA | US1K-13-F | Diodes | - | C110532 | - | 1 | 10 | 20 | LCSC (https://www.lcsc.com/product-detail/fast-recovery-high-efficiency-diodes_diodes-incorporated-us1k-13-f_C110532.html) | 0.0570 | $1.1400
18 | Diodes | D4 | DIODE STANDARD 150V 1A SMA | SMA | ES1C-13-F | Diodes | - | C781252 | - | 1 | 10 | 15 | LCSC (https://www.lcsc.com/product-detail/fast-recovery-high-efficiency-diodes_diodes-incorporated-es1c-13-f_C781252.html) | 0.1548 | $2.3220
19 | Fuses | F1 | FUSE BRD MNT 1.5A 125VAC/VDC SMD | Custom | 045301.5MR | Littelfuse | - | C178994 | - | 1 | 10 | 15 | LCSC (https://www.lcsc.com/product-detail/disposable-fuses_littelfuse-045301-5mr_C178994.html) | 0.2443 | $3.6645
20 | Ferrite Beads | FB1, FB2, FB3, FB4 | FERRITE BEAD 1.5 KOHM 0805 1LN | Ind-0805 | BLM21BD152SN1D | Murata | - | C413959 | - | 4 | 40 | 50 | LCSC (https://www.lcsc.com/product-detail/ferrite-beads_murata-electronics-blm21bd152sn1d_C413959.html) | 0.0438 | $2.1900
21 | Fuse Holders | J1 | FUSE BLOK CARTRIDGE 125V 10A SMD | Custom | 01550900M | Littelfuse | - | C108518 | - | 1 | 10 | 11 | LCSC (https://www.lcsc.com/product-detail/fuseholders_littelfuse-01550900m_C108518.html) | 0.2866 | $3.1526
22 | Connectors | J2 | CONN HDR 24POS 0.1 GOLD PCB R/A | Custom | SFH11-PBPC-D12-RA-BK | Sullins | - | - | - | 1 | 10 | 11 | Chipsmall (https://www.chipsmall.com/Products/SFH11-PBPC-D12-RA-BK_12482478.html) | $1.8387 | $20.2257
23 | Terminal Block | J3 | Plugin,P=3.81mm Pluggable System Terminal Block ROHS | Custom | KF2EDGRG-3.81-4P | Cixi Kefa Elec | - | C6392932 | - | 1 | 10 | 15 | LCSC (https://www.lcsc.com/product-detail/Pluggable-System-Terminal-Block_Cixi-Kefa-Elec-KF2EDGRG-3-81-4P_C6392932.html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) | $0.1853 | $2.7795
24 | Terminal Block | J4 | -40℃~+105℃ 1.5 1 16~28 3.81mm 160V 7A 4 1x4P Green Plug Snap Fit P=3.81mm Pluggable System Terminal Block ROHS | Custom | KF2EDGKNG-3.81-4P | Cixi Kefa Elec | - | C2923028 | - | 1 | 10 | 11 | LCSC (https://www.lcsc.com/product-detail/Pluggable-System-Terminal-Block_Cixi-Kefa-Elec-KF2EDGKNG-3-81-4P_C2923028.html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) | $0.5042 | $5.5462
25 | Inductor | L1, L2, L3, L5, L6, L7 | 420mA 470uH EI-core Inductor ±20% Plugin Power Inductors ROHS | Custom | PK0810-471MB | SXN(Shun Xiang Nuo Elec) | - | C400319 | 470uH | 6 | 60 | 65 | LCSC (https://www.lcsc.com/product-detail/power-inductors_sxn-shun-xiang-nuo-elec-pk0810-471mb_C400319.html) | 0.0861 | $5.5965
26 | Mosfet | Q1 | 900V 5.1A 83W 1.2Ω@10V,2.8A 3.5V 1 N-channel TO-252-3 MOSFETs ROHS | TO-252-2L | IPD90R1K2C3 | Infineon | - | C386347 | - | 1 | 10 | 11 | LCSC (https://www.lcsc.com/product-detail/mosfets_infineon-technologies-ipd90r1k2c3_C386347.html) | 0.7160 | $7.8760
27 | Through-Hole Resistors | R1, R7, R12 | RES 1 OHM 5% 2W AXIAL | Custom | FMP200JR-52-1R | Yageo | - | C1741654 | 1R | 3 | 30 | 40 | LCSC (https://www.lcsc.com/product-detail/through-hole-resistors_yageo-fmp200jr-52-1r_C1741654.html) | 0.0668 | $2.6720
28 | Resistors | R2, R3, R9, R11, R13, R16 | RES 10K OHM 1% 1/2W 1206 | Res-1206 | AC1206FR-7W10KL | Yageo | - | C326700 | 10K | 6 | 60 | 100 | LCSC (https://www.lcsc.com/product-detail/chip-resistor-surface-mount_yageo-ac1206fr-7w10kl_C326700.html) | 0.0104 | $1.0400
29 | Resistors | R4, R8, R10, R14 | RES SMD 976K OHM 0.1% 1/4W 1206 | Res-1206 | RT1206BRD07976KL | Yageo | - | C870948 | 976K | 4 | 40 | 50 | LCSC (https://www.lcsc.com/product-detail/chip-resistor-surface-mount_yageo-rt1206brd07976kl_C870948.html) | 0.0468 | $2.3400
30 | Resistors | R5 | RES SMD 100 OHM 1% 3/4W 2010 | Res_1210 | AC2010FK-07100RL | Yageo | - | C138240 | 100R | 1 | 10 | 20 | LCSC (https://www.lcsc.com/product-detail/chip-resistor-surface-mount_yageo-ac2010fk-07100rl_C138240.html) | 0.0289 | $0.5780
31 | Resistors | R6 | RES SMD 47K OHM 1% 1W 2512 | RES-2512 | AC2512FK-0747KL | Yageo | - | C728203 | 47K | 1 | 10 | 20 | LCSC (https://www.lcsc.com/product-detail/chip-resistor-surface-mount_yageo-ac2512fk-0747kl_C728203.html) | 0.0501 | $1.0020
32 | Resistor | R15 | RES 10 OHM 1% 1/4W 1206 | Res-1206 | RC1206FR-0710RL | Yageo | - | C108080 | 10R | 1 | 10 | 50 | LCSC (https://www.lcsc.com/product-detail/chip-resistor-surface-mount_yageo-rc1206fr-0710rl_C108080.html) | 0.0109 | $0.5450
33 | Resistor | R17 | RES 49.9 OHM 1% 1/10W 0603 | Res-0603 | RC0603FR-0749R9L | Yageo | - | C114625 | 49.9R | 1 | 10 | 100 | LCSC (https://www.lcsc.com/product-detail/chip-resistor-surface-mount_yageo-rc0603fr-0749r9l_C114625.html) | 0.0013 | $0.1300
34 | Resistor | R18 | RES 0 OHM JUMPER 1/8W 0805 | Res-0805 | RC0805FR-070RL | Yageo | - | C100045 | 0R | 1 | 10 | 100 | LCSC (https://www.lcsc.com/product-detail/chip-resistor-surface-mount_yageo-rc0805fr-070rl_C100045.html) | 0.0022 | $0.2200
35 | Resistors | R19 | RES 100K OHM 1% 1/10W 0603 | Res-0603 | RC0603FR-07100KL | Yageo | - | C14675 | 100K | 1 | 10 | 100 | LCSC (https://www.lcsc.com/product-detail/chip-resistor-surface-mount_yageo-rc0603fr-07100kl_C14675.html) | 0.0008 | $0.0800
36 | Resistors | R20 | RES 4.99K OHM 1% 1/10W 0603 | Res-0603 | RC0603FR-074K99L | Yageo | - | C114621 | 4.99K | 1 | 10 | 100 | LCSC (https://www.lcsc.com/product-detail/chip-resistor-surface-mount_yageo-rc0603fr-074k99l_C114621.html) | 0.0012 | $0.1200
37 | Resistor | R21 | RES SMD 1K OHM 1% 1/10W 0603 | Res-0603 | RC0603FR-071KL | Yageo | - | C22548 | 1K | 1 | 10 | 100 | LCSC (https://www.lcsc.com/product-detail/chip-resistor-surface-mount_yageo-rc0603fr-071kl_C22548.html) | 0.0011 | $0.1100
38 | Resistors | R22 | RES SMD 66.5KOHM 0.1% 1/10W 0603 | Res-0603 | RT0603BRD0766K5L | Yageo | - | C861515 | 66.5K | 1 | 10 | 20 | LCSC (https://www.lcsc.com/product-detail/chip-resistor-surface-mount_yageo-rt0603brd0766k5l_C861515.html) | 0.0248 | $0.4960
39 | Resistors | R23 | RES 0.75 OHM 1% 1/2W 1206 | Res-1206 | RL1206FR-7W0R75L | Yageo | - | C859938 | 750mR | 1 | 10 | 50 | LCSC (https://www.lcsc.com/product-detail/chip-resistor-surface-mount_yageo-rl1206fr-7w0r75l_C859938.html) | 0.0190 | $0.9500
40 | Resistors | R24 | RES SMD 26.1KOHM 0.1% 1/10W 0603 | Res-0603 | RT0603BRD0726K1L | Yageo | - | C728586 | 26.1K | 1 | 10 | 20 | LCSC (https://www.lcsc.com/product-detail/chip-resistor-surface-mount_yageo-rt0603brd0726k1l_C728586.html) | 0.0244 | $0.4880
41 | Resistors | R25, R26, R27, R28, R31, R32, R33, R34, R37, R38, R39, R40 | RES SMD 200K OHM 1% 1W 2512 | RES-2512 | CRCW2512200KFKEG | Vishay Dale | - | C2078538 | 200K | 12 | 120 | 125 | LCSC (https://www.lcsc.com/product-detail/chip-resistor-surface-mount_vishay-intertech-crcw2512200kfkeg_C2078538.html) | 0.1801 | $22.5125
42 | Resistor | R29, R30, R35, R36, R41, R42 | RES 1K OHM 5% 1W 2512 | RES-2512 | ~~RC2512JK-071KL~~ | Yageo | FRC2512J102 TS | C2960674 | 1K | 6 | 60 | 100 | LCSC (https://www.lcsc.com/product-detail/Chip-Resistor-Surface-Mount_FOJAN-FRC2512J102-TS_C2960674.html) | 0.0192 | $1.9200
43 | Varistors | RV1, RV2, RV3 | 775V 385V 300V 470V Plugin Varistors ROHS | Custom | 471KD10J | Yageo | - | C522648 | - | 3 | 30 | 40 | LCSC (https://www.lcsc.com/product-detail/varistors_brightking-471kd10j_C522648.html) | 0.0702 | $2.8080
44 | Transformer | T1 | 12V/1.5A transformer | Custom | FTEFD25-037 | - | - | - |  | 1 | 10 | 11 | - | - | -
45 | IC | U1 | IC OFFLINE SW MULT TOP 8VSSOP | 8-VSSOP (Pitch 0.65mm)(5x3.1mm) | LM5021MM-1/NOPB | TI National Semiconductor | - | C202233 | - | 1 | 10 | 11 | LCSC (https://www.lcsc.com/product-detail/ac-dc-controllers-and-regulators_texas-instruments-lm5021mm-1-nopb_C202233.html) | 1.2054 | $13.2594
46 | IC | U2 | OPTOISOLATOR 5KV TRANSISTOR 4DIP | DIP-4 | FOD817A | ON Semiconductor / Fairchild | - | C900909 | - | 1 | 10 | 15 | LCSC (https://www.lcsc.com/product-detail/transistor-photovoltaic-output-optoisolators_onsemi-fod817a_C900909.html) | 0.2352 | $3.5280
47 | IC | U3 | IC VREF SHUNT ADJ 1% SOT23-3 | SOT-23 | ATL431AIDBZR | Texas Instruments | - | C134067 | - | 1 | 10 | 15 | LCSC (https://www.lcsc.com/product-detail/voltage-reference_texas-instruments-atl431aidbzr_C134067.html) | 0.2617 | $3.9255
 |  |  |  |  |  |  |  |  |  |  |  | Total Component Cost |  |  | $163.71
 |  |  |  |  |  |  |  |  |  |  |  | Single Board Cost |  |  | $16.37

Sheet: 1000 Boards
 |  | Component list |  | Bill of Materials for Project [OFP_VIM_v1.5
 |  | Project: |  | OFP_VIM_v1.5
# | Item Type | Designator | Description | Footprint | Manufacturer Part Number | Manufacturer | Alternate Part Number | LCSC Part Number | Value | Quantity | Quantity (1000 Boards) | MOQ (1000 Boards) | Links | Unit Cost (1000 Boards) | Total Cost (1000 Boards) | Remarks
1 | Bridge | BR1, BR2 | 30A 950mV@400mA 1A 800V LMBS-1 Bridge Rectifiers ROHS | LMBS-1 | LMB8S-TP | MCC(Micro Commercial Components) | - | C435904 | - | 2 | 2000 | 2005 | LCSC (https://www.lcsc.com/product-detail/bridge-rectifiers_mcc-micro-commercial-components-lmb8s-tp_C435904.html) | 0.0533 | $106.8665
2 | Film Capacitors | C1, C9, C12 | CAP FILM 0.1UF 20% 630VDC RADIAL | Custom | B32921C3104M000 | TDK EPCOS | - | C361368 | 0.1uF | 3 | 3000 | 3005 | LCSC (https://www.lcsc.com/product-detail/Safety-Capacitors_TDK-B32921C3104M000_C361368.html?s_z=n_C361368) | 0.1316 | $395.4580
3 | Capacitor | C2, C10 | 33uF 420V 1Ω@100kHz 430mA@100kHz ±20% Plugin,D10xL16mm Aluminum Electrolytic Capacitors - Leaded ROHS | Custom | 87EC0494 | KNSCHA | - | C6718366 | 33uF | 2 | 2000 | 2002 | LCSC (https://www.lcsc.com/product-detail/aluminum-electrolytic-capacitors-leaded_knscha-87ec0494_C6718366.html) | 0.2105 | $421.4210
4 | Capacitor | C3, C4, C5, C6 | CAP ALUM 68UF 20% 25V SMD | Custom | EEE-FK1E680P | Panasonic | - | C336242 | 68uF | 4 | 4000 | 4005 | LCSC (https://www.lcsc.com/product-detail/aluminum-electrolytic-capacitors-smd_panasonic-eeefk1e680p_C336242.html) | 0.1038 | $415.7190
5 | Capacitors | C7 | CAP CER 1000PF 1KV X7R 1206 | Cap-1206 | GRM31BR73A102KW01L | Murata | - | C97941 | 1nF | 1 | 1000 | 1020 | LCSC (https://www.lcsc.com/product-detail/multilayer-ceramic-capacitors-mlcc-smd-smt_murata-electronics-grm31br73a102kw01l_C97941.html) | 0.0153 | $15.6060
6 | Capacitor | C8 | 10nF -40℃~+105℃ ±5% 1kV Plugin,P=15mm Polypropylene Film Capacitors (CBB) ROHS | Custom | KP103J1000VP15 | KYET | - | C390160 | 10nF | 1 | 1000 | 1005 | LCSC (https://www.lcsc.com/product-detail/polypropylene-film-capacitors-cbb_kyet-kp103j1000vp15_C390160.html) | 0.0827 | $83.1135
7 | Capacitors | C11 | CAP CER 1000PF 440VAC Y5U RADIAL | Custom | VY2102M29Y5US6TV7 | Vishay BCcomponents | - | C511063 | 1nF | 1 | 1000 | 5005 | LCSC (https://www.lcsc.com/product-detail/safety-capacitors_vishay-intertech-vy2102m29y5us6tv7_C511063.html) | 0.0626 | $313.3130
8 | Tantalum Capacitors | C13 | CAP TANT 10UF 10% 35V 2312 | Case-C | TAJC106K035RNJ | Kyocera AVX | - | C7211 | 10uF | 1 | 1000 | 1005 | LCSC (https://www.lcsc.com/product-detail/tantalum-capacitors_kyocera-avx-tajc106k035rnj_C7211.html) | 0.1632 | $164.0160
9 | Capacitor | C14 | CAP CER 10000PF 50V X7R 0603 | Cap-0603 | CC0603KRX7R9BB103 | Yageo | - | C100042 | 0.01uF | 1 | 1000 | 1100 | LCSC (https://www.lcsc.com/product-detail/multilayer-ceramic-capacitors-mlcc-smd-smt_yageo-cc0603krx7r9bb103_C100042.html) | 0.0017 | $1.8700
10 | Capacitors | C15, C17 | CAP CER 1UF 50V X7R 0603 | Cap-0603 | CC0603KRX7R9BB105 | Yageo | - | C559769 | 1uF | 2 | 2000 | 2020 | LCSC (https://www.lcsc.com/product-detail/multilayer-ceramic-capacitors-mlcc-smd-smt_yageo-cc0603krx7r9bb105_C559769.html) | 0.0166 | $33.5320
11 | Capacitors | C16 | CAP CER 0.22UF 25V X7R 0603 | Cap-0603 | CC0603KRX7R8BB224 | Yageo | - | C106857 | 220nF | 1 | 1000 | 1050 | LCSC (https://www.lcsc.com/product-detail/multilayer-ceramic-capacitors-mlcc-smd-smt_yageo-cc0603krx7r8bb224_C106857.html) | 0.0061 | $6.4050
12 | Capacitors | C18 | CAP CER 220PF 50V X7R 0603 | Cap-0603 | CC0603JRX7R9BB221 | Yageo | - | C327270 | 220pF | 1 | 1000 | 1100 | LCSC (https://www.lcsc.com/product-detail/multilayer-ceramic-capacitors-mlcc-smd-smt_yageo-cc0603jrx7r9bb221_C327270.html) | 0.0032 | $3.5200
13 | Capacitors | C19, C22, C25 | 51 pF ±1% 250V Ceramic Capacitor C0G, NP0 0603 (1608 Metric) | Cap-0603 | GQM1875C2E510FB12D | Murata | - | C17504198 | 51pF | 3 | 3000 | 3002 | LCSC (https://www.lcsc.com/product-detail/multilayer-ceramic-capacitors-mlcc-smd-smt_murata-electronics-gqm1875c2e510fb12d_C17504198.html) | 0.0609 | $182.8218
14 | Capacitors | C20, C21, C23, C24, C26, C27 | CAP CER 0.022UF 500V X7R 1206 | Cap-1206 | CC1206KKX7RBBB223 | Yageo | - | - | 22nF | 6 | 6000 | 6002 | Chipsmall (https://www.chipsmall.com/Products/CC1206KKX7RBBB223_11665884.html) | $0.0140 | $84.0280
15 | Diodes | D1 | DIODE SCHOTTKY 150V 20A TO2773 | TO-277A | FSV20150V | ON Semiconductor / Fairchild | - | C606024 | - | 1 | 1000 | 1002 | LCSC (https://www.lcsc.com/product-detail/schottky-diodes_onsemi-fsv20150v_C606024.html) | 0.5540 | $555.1080
16 | Diodes | D2 | DIODE ZENER 15V 500MW SOD123 | SOD-123W | MMSZ5245B-7-F | Diodes | - | C177050 | 15V | 1 | 1000 | 1020 | LCSC (https://www.lcsc.com/product-detail/zener-diodes_diodes-incorporated-mmsz5245b-7-f_C177050.html) | 0.0184 | $18.7680
17 | Diodes | D3 | DIODE STANDARD 800V 1A SMA | SMA | US1K-13-F | Diodes | - | C110532 | - | 1 | 1000 | 1010 | LCSC (https://www.lcsc.com/product-detail/fast-recovery-high-efficiency-diodes_diodes-incorporated-us1k-13-f_C110532.html) | 0.0385 | $38.8850
18 | Diodes | D4 | DIODE STANDARD 150V 1A SMA | SMA | ES1C-13-F | Diodes | - | C781252 | - | 1 | 1000 | 1005 | LCSC (https://www.lcsc.com/product-detail/fast-recovery-high-efficiency-diodes_diodes-incorporated-es1c-13-f_C781252.html) | 0.0922 | $92.6610
19 | Fuses | F1 | FUSE BRD MNT 1.5A 125VAC/VDC SMD | Custom | 045301.5MR | Littelfuse | - | C178994 | - | 1 | 1000 | 1005 | LCSC (https://www.lcsc.com/product-detail/disposable-fuses_littelfuse-045301-5mr_C178994.html) | 0.1497 | $150.4485
20 | Ferrite Beads | FB1, FB2, FB3, FB4 | FERRITE BEAD 1.5 KOHM 0805 1LN | Ind-0805 | BLM21BD152SN1D | Murata | - | C413959 | - | 4 | 4000 | 4010 | LCSC (https://www.lcsc.com/product-detail/ferrite-beads_murata-electronics-blm21bd152sn1d_C413959.html) | 0.0228 | $91.4280
21 | Fuse Holders | J1 | FUSE BLOK CARTRIDGE 125V 10A SMD | Custom | 01550900M | Littelfuse | - | C108518 | - | 1 | 1000 | 1002 | LCSC (https://www.lcsc.com/product-detail/fuseholders_littelfuse-01550900m_C108518.html) | 0.1865 | $186.8730
22 | Connectors | J2 | CONN HDR 24POS 0.1 GOLD PCB R/A | Custom | SFH11-PBPC-D12-RA-BK | Sullins | - | - | - | 1 | 1000 | 1002 | Chipsmall (https://www.chipsmall.com/Products/SFH11-PBPC-D12-RA-BK_12482478.html) | $0.9194 | $921.1887
23 | Terminal Block | J3 | Plugin,P=3.81mm Pluggable System Terminal Block ROHS | Custom | KF2EDGRG-3.81-4P | Cixi Kefa Elec | - | C6392932 | - | 1 | 1000 | 1005 | LCSC (https://www.lcsc.com/product-detail/Pluggable-System-Terminal-Block_Cixi-Kefa-Elec-KF2EDGRG-3-81-4P_C6392932.html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) | $0.1072 | $107.7360
24 | Terminal Block | J4 | -40℃~+105℃ 1.5 1 16~28 3.81mm 160V 7A 4 1x4P Green Plug Snap Fit P=3.81mm Pluggable System Terminal Block ROHS | Custom | KF2EDGKNG-3.81-4P | Cixi Kefa Elec | - | C2923028 | - | 1 | 1000 | 1002 | LCSC (https://www.lcsc.com/product-detail/Pluggable-System-Terminal-Block_Cixi-Kefa-Elec-KF2EDGKNG-3-81-4P_C2923028.html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) | $0.4649 | $465.8298
25 | Inductor | L1, L2, L3, L5, L6, L7 | 420mA 470uH EI-core Inductor ±20% Plugin Power Inductors ROHS | Custom | PK0810-471MB | SXN(Shun Xiang Nuo Elec) | - | C400319 | 470uH | 6 | 6000 | 6005 | LCSC (https://www.lcsc.com/product-detail/power-inductors_sxn-shun-xiang-nuo-elec-pk0810-471mb_C400319.html) | 0.0544 | $326.6720
26 | Mosfet | Q1 | 900V 5.1A 83W 1.2Ω@10V,2.8A 3.5V 1 N-channel TO-252-3 MOSFETs ROHS | TO-252-2L | IPD90R1K2C3 | Infineon | - | C386347 | - | 1 | 1000 | 1002 | LCSC (https://www.lcsc.com/product-detail/mosfets_infineon-technologies-ipd90r1k2c3_C386347.html) | 0.4727 | $473.6454
27 | Through-Hole Resistors | R1, R7, R12 | RES 1 OHM 5% 2W AXIAL | Custom | FMP200JR-52-1R | Yageo | - | C1741654 | 1R | 3 | 3000 | 3010 | LCSC (https://www.lcsc.com/product-detail/through-hole-resistors_yageo-fmp200jr-52-1r_C1741654.html) | 0.0397 | $119.4970
28 | Resistors | R2, R3, R9, R11, R13, R16 | RES 10K OHM 1% 1/2W 1206 | Res-1206 | AC1206FR-7W10KL | Yageo | - | C326700 | 10K | 6 | 6000 | 6050 | LCSC (https://www.lcsc.com/product-detail/chip-resistor-surface-mount_yageo-ac1206fr-7w10kl_C326700.html) | 0.0063 | $38.1150
29 | Resistors | R4, R8, R10, R14 | RES SMD 976K OHM 0.1% 1/4W 1206 | Res-1206 | RT1206BRD07976KL | Yageo | - | C870948 | 976K | 4 | 4000 | 4010 | LCSC (https://www.lcsc.com/product-detail/chip-resistor-surface-mount_yageo-rt1206brd07976kl_C870948.html) | 0.0301 | $120.7010
30 | Resistors | R5 | RES SMD 100 OHM 1% 3/4W 2010 | Res_1210 | AC2010FK-07100RL | Yageo | - | C138240 | 100R | 1 | 1000 | 1020 | LCSC (https://www.lcsc.com/product-detail/chip-resistor-surface-mount_yageo-ac2010fk-07100rl_C138240.html) | 0.0193 | $19.6860
31 | Resistors | R6 | RES SMD 47K OHM 1% 1W 2512 | RES-2512 | AC2512FK-0747KL | Yageo | - | C728203 | 47K | 1 | 1000 | 1010 | LCSC (https://www.lcsc.com/product-detail/chip-resistor-surface-mount_yageo-ac2512fk-0747kl_C728203.html) | 0.0324 | $32.7240
32 | Resistor | R15 | RES 10 OHM 1% 1/4W 1206 | Res-1206 | RC1206FR-0710RL | Yageo | - | C108080 | 10R | 1 | 1000 | 1050 | LCSC (https://www.lcsc.com/product-detail/chip-resistor-surface-mount_yageo-rc1206fr-0710rl_C108080.html) | 0.0086 | $9.0300
33 | Resistor | R17 | RES 49.9 OHM 1% 1/10W 0603 | Res-0603 | RC0603FR-0749R9L | Yageo | - | C114625 | 49.9R | 1 | 1000 | 1100 | LCSC (https://www.lcsc.com/product-detail/chip-resistor-surface-mount_yageo-rc0603fr-0749r9l_C114625.html) | 0.0010 | $1.1000
34 | Resistor | R18 | RES 0 OHM JUMPER 1/8W 0805 | Res-0805 | RC0805FR-070RL | Yageo | - | C100045 | 0R | 1 | 1000 | 1100 | LCSC (https://www.lcsc.com/product-detail/chip-resistor-surface-mount_yageo-rc0805fr-070rl_C100045.html) | 0.0017 | $1.8700
35 | Resistors | R19 | RES 100K OHM 1% 1/10W 0603 | Res-0603 | RC0603FR-07100KL | Yageo | - | C14675 | 100K | 1 | 1000 | 1100 | LCSC (https://www.lcsc.com/product-detail/chip-resistor-surface-mount_yageo-rc0603fr-07100kl_C14675.html) | 0.0006 | $0.6600
36 | Resistors | R20 | RES 4.99K OHM 1% 1/10W 0603 | Res-0603 | RC0603FR-074K99L | Yageo | - | C114621 | 4.99K | 1 | 1000 | 1100 | LCSC (https://www.lcsc.com/product-detail/chip-resistor-surface-mount_yageo-rc0603fr-074k99l_C114621.html) | 0.0009 | $0.9900
37 | Resistor | R21 | RES SMD 1K OHM 1% 1/10W 0603 | Res-0603 | RC0603FR-071KL | Yageo | - | C22548 | 1K | 1 | 1000 | 1100 | LCSC (https://www.lcsc.com/product-detail/chip-resistor-surface-mount_yageo-rc0603fr-071kl_C22548.html) | 0.0008 | $0.8800
38 | Resistors | R22 | RES SMD 66.5KOHM 0.1% 1/10W 0603 | Res-0603 | RT0603BRD0766K5L | Yageo | - | C861515 | 66.5K | 1 | 1000 | 1020 | LCSC (https://www.lcsc.com/product-detail/chip-resistor-surface-mount_yageo-rt0603brd0766k5l_C861515.html) | 0.0170 | $17.3400
39 | Resistors | R23 | RES 0.75 OHM 1% 1/2W 1206 | Res-1206 | RL1206FR-7W0R75L | Yageo | - | C859938 | 750mR | 1 | 1000 | 1050 | LCSC (https://www.lcsc.com/product-detail/chip-resistor-surface-mount_yageo-rl1206fr-7w0r75l_C859938.html) | 0.0150 | $15.7500
40 | Resistors | R24 | RES SMD 26.1KOHM 0.1% 1/10W 0603 | Res-0603 | RT0603BRD0726K1L | Yageo | - | C728586 | 26.1K | 1 | 1000 | 1020 | LCSC (https://www.lcsc.com/product-detail/chip-resistor-surface-mount_yageo-rt0603brd0726k1l_C728586.html) | 0.0168 | $17.1360
41 | Resistors | R25, R26, R27, R28, R31, R32, R33, R34, R37, R38, R39, R40 | RES SMD 200K OHM 1% 1W 2512 | RES-2512 | CRCW2512200KFKEG | Vishay Dale | - | C2078538 | 200K | 12 | 12000 | 12005 | LCSC (https://www.lcsc.com/product-detail/chip-resistor-surface-mount_vishay-intertech-crcw2512200kfkeg_C2078538.html) | 0.1186 | $1423.7930
42 | Resistor | R29, R30, R35, R36, R41, R42 | RES 1K OHM 5% 1W 2512 | RES-2512 | ~~RC2512JK-071KL~~ | Yageo | FRC2512J102 TS | C2960674 | 1K | 6 | 6000 | 6050 | LCSC (https://www.lcsc.com/product-detail/Chip-Resistor-Surface-Mount_FOJAN-FRC2512J102-TS_C2960674.html) | 0.0160 | $96.8000
43 | Varistors | RV1, RV2, RV3 | 775V 385V 300V 470V Plugin Varistors ROHS | Custom | 471KD10J | Yageo | - | C522648 | - | 3 | 3000 | 3010 | LCSC (https://www.lcsc.com/product-detail/varistors_brightking-471kd10j_C522648.html) | 0.0426 | $128.2260
44 | Transformer | T1 | 12V/1.5A transformer | Custom | FTEFD25-037 | - | - | - |  | 1 | 1000 | 1002 | - | - | -
45 | IC | U1 | IC OFFLINE SW MULT TOP 8VSSOP | 8-VSSOP (Pitch 0.65mm)(5x3.1mm) | LM5021MM-1/NOPB | TI National Semiconductor | - | C202233 | - | 1 | 1000 | 1002 | LCSC (https://www.lcsc.com/product-detail/ac-dc-controllers-and-regulators_texas-instruments-lm5021mm-1-nopb_C202233.html) | 0.7933 | $794.8866
46 | IC | U2 | OPTOISOLATOR 5KV TRANSISTOR 4DIP | DIP-4 | FOD817A | ON Semiconductor / Fairchild | - | C900909 | - | 1 | 1000 | 1005 | LCSC (https://www.lcsc.com/product-detail/transistor-photovoltaic-output-optoisolators_onsemi-fod817a_C900909.html) | 0.1318 | $132.4590
47 | IC | U3 | IC VREF SHUNT ADJ 1% SOT23-3 | SOT-23 | ATL431AIDBZR | Texas Instruments | - | C134067 | - | 1 | 1000 | 1005 | LCSC (https://www.lcsc.com/product-detail/voltage-reference_texas-instruments-atl431aidbzr_C134067.html) | 0.1497 | $150.4485
 |  |  |  |  |  |  |  |  |  |  |  | Total Component Cost |  |  | $8779.03
 |  |  |  |  |  |  |  |  |  |  |  | Single Board Cost |  |  | $8.78
