eSpark-Backup/nabilfesal-smartmeter-hw/Design-Files/OFP_USM_v1.5/BOM/eSpark-BOM-OFP_USM_v1.5.xlsx

Sheet: 10 Boards
 |  | Component list |  | Bill of Materials for Project [OFP_USM_v1.5
 |  | Project: |  | OFP_USM_v1.5
# | Item Type | Designator | Description | Footprint | Manufacturer Part Number | Manufacturer | Alternate Part Number | LCSC Part Number | Value | Quantity | Quantity (10 Boards) | MOQ (10 Boards) | Links | Unit Cost (10 Boards) | Total Cost (10 Boards) | Remarks
1 | Capacitors | C1 | CAP CER 0.1UF 50V X7R 0603 | Cap-0603 | GCJ188R71H104KA12D | Murata | - | C161115 | 0.1uF | 1 | 10 | 50 | LCSC (https://www.lcsc.com/product-detail/multilayer-ceramic-capacitors-mlcc-smd-smt_murata-electronics-gcj188r71h104ka12d_C161115.html) | 0.0233 | $1.1650
2 | Capacitors | C2, C3, C4 | CAP CER 33PF 100V C0G/NP0 0603 | Cap-0603 | GCM1885C2A330JA16D | Murata | - | C126578 | 33pF | 3 | 30 | 50 | LCSC (https://www.lcsc.com/product-detail/multilayer-ceramic-capacitors-mlcc-smd-smt_murata-electronics-gcm1885c2a330ja16d_C126578.html) | 0.0179 | $0.8950
3 | (TVS/ESD) | D1 | 4A 14V 40W 6V Unidirectional 5V SOT-563 ESD and Surge Protection (TVS/ESD) ROHS | SOT-563 | ESDA6V8AV6 | TECH PUBLIC | - | C3021131 | - | 1 | 10 | 15 | LCSC (https://www.lcsc.com/product-detail/esd-and-surge-protection-tvs-esd_tech-public-esda6v8av6_C3021131.html) | 0.0917 | $1.3755
4 | (TVS/ESD) | D2, D3 | 3A 35W 12V 5.6V Bidirectional 5V DFN1006 ESD and Surge Protection (TVS/ESD) ROHS | DFN1006-2L (Bi-Directional) | ESD9B5VL | TECH PUBLIC | - | C2827544 | - | 2 | 20 | 40 | LCSC (https://www.lcsc.com/product-detail/esd-and-surge-protection-tvs-esd_tech-public-esd9b5vl_C2827544.html) | 0.0368 | $1.4720
5 | TVS/ESD | D4 | 60W 5.6V Bidirectional 5V DFN1006 ESD and Surge Protection (TVS/ESD) ROHS | DFN1006-2L (Bi-Directional) | SLESD5451X | Slkor(SLKORMICRO Elec.) | - | C5185982 | - | 1 | 10 | 50 | LCSC (https://www.lcsc.com/product-detail/esd-and-surge-protection-tvs-esd_slkor-slkormicro-elec-slesd5451x_C5185982.html) | 0.0140 | $0.7000
6 | Resettable Fuses | F1 | 6V 350mA 100A 750mA 0805 Resettable Fuses ROHS | Fuse-0805 | SMD0805B035TF | Brightking | - | C269103 | - | 1 | 10 | 20 | LCSC (https://www.lcsc.com/product-detail/resettable-fuses_brightking-smd0805b035tf_C269103.html) | 0.0178 | $0.3560
7 | Memory Connectors | J1 | CONN MICRO SIMM PUSH-PUSH R/A | Custom | 503960-0696 | Molex | - | C132719 | - | 1 | 10 | 11 | LCSC (https://www.lcsc.com/product-detail/sim-card-connectors_molex-5039600696_C132719.html) | 0.8583 | $9.4413
8 | FFC/FPC Cable | J2 | Flip type 10P Bottom Contact Horizontal attachment 0.5mm SMD,P=0.5mm FFC, FPC (Flat Flexible) Connector Assemblies ROHS | Custom | HX0.5-10P XJH2.0 043 | hanxia | - | C5691101 | - | 1 | 10 | 15 | LCSC (https://www.lcsc.com/product-detail/ffc-fpc-flat-flexible-connector-assemblies_hanxia-hx0-5-10p-xjh2-0-043_C5691101.html) | 0.0804 | $1.2060
9 | USB Connector | J3 | 1.5A USB 2.0 1 Horizontal attachment 4P Female -20℃~+70℃ Type-A SMD USB Connectors ROHS | Custom | USB-234-BCW | XUNPU | - | C720528 | - | 1 | 10 | 15 | LCSC (https://www.lcsc.com/product-detail/usb-connectors_xunpu-usb-234-bcw_C720528.html) | 0.1058 | $1.5870
10 | LED | LED1 | RED LED 0603 Light Emitting Diodes | LED-0603 | NCD0603R3 | Foshan NationStar Optoelectronics | - | C3151730 | - | 1 | 10 | 20 | LCSC (https://www.lcsc.com/product-detail/led-indication-discrete_foshan-nationstar-optoelectronics-ncd0603r3_C3151730.html) | 0.0248 | $0.4960
11 | Resistor | R1 | RES 15K OHM 1% 1/10W 0603 | Res-0603 | RC0603FR-0715KL | Yageo | - | C114661 | 15K | 1 | 10 | 100 | LCSC (https://www.lcsc.com/product-detail/chip-resistor-surface-mount_yageo-rc0603fr-0715kl_C114661.html) | 0.0012 | $0.1200
12 | Resistor | R2, R3, R4 | RES 22 OHM 1% 1/10W 0603 | Res-0603 | RC0603FR-0722RL | Yageo | - | C107701 | 22R | 3 | 30 | 100 | LCSC (https://www.lcsc.com/product-detail/chip-resistor-surface-mount_yageo-rc0603fr-0722rl_C107701.html) | 0.0012 | $0.1200
13 | Resistor | R5 | RES SMD 680 OHM 1% 1/10W 0603 | Res-0603 | RC0603FR-07680RL | Yageo | - | C112310 | 680R | 1 | 10 | 100 | LCSC (https://www.lcsc.com/product-detail/chip-resistor-surface-mount_yageo-rc0603fr-07680rl_C112310.html) | 0.0012 | $0.1200
14 | Peripheral | - | 0.3mm 10P 0.5mm 60mm P=0.5mm FFC Cable (Flexible Flat Cable) ROHS | P=0.5mm | AB03A0100000180A | BZCN | - | C5110315 | - | 1 | 10 | 20 | LCSC (https://www.lcsc.com/product-detail/ffc-cable-flexible-flat-cable_bzcn-ab03a0100000180a_C5110315.html) | 0.0495 | $0.9900
 |  |  |  |  |  |  |  |  |  |  |  | Total Component Cost |  |  | $20.04
 |  |  |  |  |  |  |  |  |  |  |  | Single Board Cost |  |  | $2.00

Sheet: 1000 Boards
 |  | Component list |  | Bill of Materials for Project [OFP_USM_v1.5
 |  | Project: |  | OFP_USM_v1.5
# | Item Type | Designator | Description | Footprint | Manufacturer Part Number | Manufacturer | Alternate Part Number | LCSC Part Number | Value | Quantity | Quantity (1000 Boards) | MOQ (1000 Boards) | Links | Unit Cost (1000 Boards) | Total Cost (1000 Boards) | Remarks
1 | Capacitors | C1 | CAP CER 0.1UF 50V X7R 0603 | Cap-0603 | GCJ188R71H104KA12D | Murata | - | C161115 | 0.1uF | 1 | 1000 | 1050 | LCSC (https://www.lcsc.com/product-detail/multilayer-ceramic-capacitors-mlcc-smd-smt_murata-electronics-gcj188r71h104ka12d_C161115.html) | 0.0192 | $20.1600
2 | Capacitors | C2, C3, C4 | CAP CER 33PF 100V C0G/NP0 0603 | Cap-0603 | GCM1885C2A330JA16D | Murata | - | C126578 | 33pF | 3 | 3000 | 3050 | LCSC (https://www.lcsc.com/product-detail/multilayer-ceramic-capacitors-mlcc-smd-smt_murata-electronics-gcm1885c2a330ja16d_C126578.html) | 0.0124 | $37.8200
3 | (TVS/ESD) | D1 | 4A 14V 40W 6V Unidirectional 5V SOT-563 ESD and Surge Protection (TVS/ESD) ROHS | SOT-563 | ESDA6V8AV6 | TECH PUBLIC | - | C3021131 | - | 1 | 1000 | 1005 | LCSC (https://www.lcsc.com/product-detail/esd-and-surge-protection-tvs-esd_tech-public-esda6v8av6_C3021131.html) | 0.0528 | $53.0640
4 | (TVS/ESD) | D2, D3 | 3A 35W 12V 5.6V Bidirectional 5V DFN1006 ESD and Surge Protection (TVS/ESD) ROHS | DFN1006-2L (Bi-Directional) | ESD9B5VL | TECH PUBLIC | - | C2827544 | - | 2 | 2000 | 2020 | LCSC (https://www.lcsc.com/product-detail/esd-and-surge-protection-tvs-esd_tech-public-esd9b5vl_C2827544.html) | 0.0205 | $41.4100
5 | TVS/ESD | D4 | 60W 5.6V Bidirectional 5V DFN1006 ESD and Surge Protection (TVS/ESD) ROHS | DFN1006-2L (Bi-Directional) | SLESD5451X | Slkor(SLKORMICRO Elec.) | - | C5185982 | - | 1 | 1000 | 1050 | LCSC (https://www.lcsc.com/product-detail/esd-and-surge-protection-tvs-esd_slkor-slkormicro-elec-slesd5451x_C5185982.html) | 0.0111 | $11.6550
6 | Resettable Fuses | F1 | 6V 350mA 100A 750mA 0805 Resettable Fuses ROHS | Fuse-0805 | SMD0805B035TF | Brightking | - | C269103 | - | 1 | 1000 | 1020 | LCSC (https://www.lcsc.com/product-detail/resettable-fuses_brightking-smd0805b035tf_C269103.html) | 0.0111 | $11.3220
7 | Memory Connectors | J1 | CONN MICRO SIMM PUSH-PUSH R/A | Custom | 503960-0696 | Molex | - | C132719 | - | 1 | 1000 | 1002 | LCSC (https://www.lcsc.com/product-detail/sim-card-connectors_molex-5039600696_C132719.html) | 0.5059 | $506.9118
8 | FFC/FPC Cable | J2 | Flip type 10P Bottom Contact Horizontal attachment 0.5mm SMD,P=0.5mm FFC, FPC (Flat Flexible) Connector Assemblies ROHS | Custom | HX0.5-10P XJH2.0 043 | hanxia | - | C5691101 | - | 1 | 1000 | 1005 | LCSC (https://www.lcsc.com/product-detail/ffc-fpc-flat-flexible-connector-assemblies_hanxia-hx0-5-10p-xjh2-0-043_C5691101.html) | 0.0485 | $48.7425
9 | USB Connector | J3 | 1.5A USB 2.0 1 Horizontal attachment 4P Female -20℃~+70℃ Type-A SMD USB Connectors ROHS | Custom | USB-234-BCW | XUNPU | - | C720528 | - | 1 | 1000 | 1005 | LCSC (https://www.lcsc.com/product-detail/usb-connectors_xunpu-usb-234-bcw_C720528.html) | 0.0639 | $64.2195
10 | LED | LED1 | RED LED 0603 Light Emitting Diodes | LED-0603 | NCD0603R3 | Foshan NationStar Optoelectronics | - | C3151730 | - | 1 | 1000 | 1020 | LCSC (https://www.lcsc.com/product-detail/led-indication-discrete_foshan-nationstar-optoelectronics-ncd0603r3_C3151730.html) | 0.0178 | $18.1560
11 | Resistor | R1 | RES 15K OHM 1% 1/10W 0603 | Res-0603 | RC0603FR-0715KL | Yageo | - | C114661 | 15K | 1 | 1000 | 1100 | LCSC (https://www.lcsc.com/product-detail/chip-resistor-surface-mount_yageo-rc0603fr-0715kl_C114661.html) | 0.0009 | $0.9900
12 | Resistor | R2, R3, R4 | RES 22 OHM 1% 1/10W 0603 | Res-0603 | RC0603FR-0722RL | Yageo | - | C107701 | 22R | 3 | 3000 | 3100 | LCSC (https://www.lcsc.com/product-detail/chip-resistor-surface-mount_yageo-rc0603fr-0722rl_C107701.html) | 0.0009 | $2.7900
13 | Resistor | R5 | RES SMD 680 OHM 1% 1/10W 0603 | Res-0603 | RC0603FR-07680RL | Yageo | - | C112310 | 680R | 1 | 1000 | 1100 | LCSC (https://www.lcsc.com/product-detail/chip-resistor-surface-mount_yageo-rc0603fr-07680rl_C112310.html) | 0.0009 | $0.9900
14 | Peripheral | - | 0.3mm 10P 0.5mm 60mm P=0.5mm FFC Cable (Flexible Flat Cable) ROHS | P=0.5mm | AB03A0100000180A | BZCN | - | C5110315 | - | 1 | 1000 | 1010 | LCSC (https://www.lcsc.com/product-detail/ffc-cable-flexible-flat-cable_bzcn-ab03a0100000180a_C5110315.html) | 0.0301 | $30.4010
 |  |  |  |  |  |  |  |  |  |  |  | Total Component Cost |  |  | $848.63
 |  |  |  |  |  |  |  |  |  |  |  | Single Board Cost |  |  | $0.85
