eSpark-Backup/nabilfesal-smartmeter-hw/Design-Files/OFP_CIM_v1.5/BOM/eSpark-BOM-OFP_CIM_v1.5.xlsx

Sheet: 10 Boards
 |  | Component list |  | Bill of Materials for Project [OFP_CIM_v1.5
 |  | Project: |  | OFP_CIM_v1.5
# | Item Type | Designator | Description | Footprint | Manufacturer Part Number | Manufacturer | Alternate Part Number | LCSC Part Number | Value | Quantity | Quantity (10 Boards) | MOQ (10 Boards) | Links | Unit Cost (10 Boards) | Total Cost (10 Boards) | Remarks
1 | Capacitors | C1, C2, C3, C4, C5, C6, C7, C8, C11, C12, C13, C14, C28, C29, C30, C31, C32, C33, C34, C35, C38, C39, C40, C41, C55, C56, C57, C58, C59, C60, C61, C62, C65, C66, C67, C68 | CAP CER 0.022UF 50V C0G/NP0 0805 | Cap-0805 | GRM21B5C1H223JA01L | Murata | - | C77069 | 22nF | 36 | 360 | 370 | LCSC (https://www.lcsc.com/product-detail/multilayer-ceramic-capacitors-mlcc-smd-smt_murata-electronics-grm21b5c1h223ja01l_C77069.html) | 0.0292 | $10.8040
2 | Capacitor | C9, C10, C36, C37, C63, C64 | CAP CER 15PF 50V C0G/NPO 0603 | Cap-0603 | CC0603JRNPO9BN150 | Yageo | - | C107037 | 15pF | 6 | 60 | 100 | LCSC (https://www.lcsc.com/product-detail/multilayer-ceramic-capacitors-mlcc-smd-smt_yageo-cc0603jrnpo9bn150_C107037.html) | 0.0024 | $0.2400
3 | Capacitors | C15, C20, C22, C24, C26, C42, C47, C49, C51, C53, C69, C74, C76, C78, C80, C82 | CAP CER 0.1UF 50V X7R 0603 | Cap-0603 | GCJ188R71H104KA12D | Murata | - | C161115 | 0.1uF | 16 | 160 | 200 | LCSC (https://www.lcsc.com/product-detail/multilayer-ceramic-capacitors-mlcc-smd-smt_murata-electronics-gcj188r71h104ka12d_C161115.html) | 0.0248 | $4.9600
4 | Capacitors | C21, C23, C25, C27, C48, C50, C52, C54, C75, C77, C79, C81, C83 | CAP CER 4.7UF 10V X7R 0603 | Cap-0603 | GRM188Z71A475KE15D | Murata | - | C913474 | 4.7uF | 13 | 130 | 140 | LCSC (https://www.lcsc.com/product-detail/multilayer-ceramic-capacitors-mlcc-smd-smt_murata-electronics-grm188z71a475ke15d_C913474.html) | 0.0330 | $4.6200
5 | Diodes | D1, D2, D3, D4, D5, D6, D9, D10, D11, D12, D13, D14, D17, D18, D19, D20, D21, D22 | DIODE ARR GP 100V 215MA TO-236AB | SOT-23 | BAV99,215 | Nexperia | - | C2500 | - | 18 | 180 | 200 | LCSC (https://www.lcsc.com/product-detail/switching-diodes_nexperia-bav99-215_C2500.html) | 0.0078 | $1.5600
6 | Terminal Block | J1 | 450V 17.5A 18 Bend -40℃~+105℃ 1 5.08mm 1x18P Green Board end/socket - Open type Push-Pull,P=5.08mm Pluggable System Terminal Block ROHS | Custom | DB2ER-5.08-18P-GN | DIBO | - | C430511 | - | 1 | 10 | 11 | LCSC (https://www.lcsc.com/product-detail/pluggable-system-terminal-block_dorabo-db2er-5-08-18p-gn_C430511.html) | 0.5042 | $5.5462
7 | Connectors | J2 | CONN HDR 24POS 0.1 GOLD PCB R/A | Custom | SFH11-PBPC-D12-RA-BK | Sullins | - | - | - | 1 | 10 | 11 | Chipsmall (https://www.chipsmall.com/Products/SFH11-PBPC-D12-RA-BK_12482478.html) | $1.8387 | $20.2257
8 | Terminal Block | J3, J4, J5 | 450V 17.5A 6 -40℃~+105℃ 1.5 1 14~28 5.08mm 1x6P Green Plug P=5.08mm Pluggable System Terminal Block ROHS | Custom | DB2EK-5.08-6P-GN-S | DIBO | - | C395774 | - | 3 | 30 | 32 | LCSC (https://www.lcsc.com/product-detail/pluggable-system-terminal-block_dorabo-db2ek-5-08-6p-gn-s_C395774.html) | 0.3834 | $12.2688 | This Part Use As Peripheral
9 | LED | LED1, LED2, LED3, LED4, LED5, LED6, LED7, LED8, LED9, LED10, LED11, LED12 | Emerald 0603 Light Emitting Diodes (LED) ROHS | LED-0603 | NCD0603G2 | Foshan NationStar Optoelectronics | - | C87326 | - | 12 | 120 | 140 | LCSC (https://www.lcsc.com/product-detail/led-indication-discrete_foshan-nationstar-optoelectronics-ncd0603g2_C87326.html) | 0.0235 | $3.2900
10 | Resistor | R1, R5, R7, R8, R9, R13, R15, R19, R25, R27, R34, R38, R40, R41, R42, R46, R48, R52, R58, R60, R67, R71, R73, R74, R75, R79, R81, R85, R91, R93 | RES SMD 0R, 1%, 0.1W, 0603 | Res-0603 | RC0603FR-070RL | Yageo | - | C100044 | 0R | 30 | 300 | 400 | LCSC (https://www.lcsc.com/product-detail/chip-resistor-surface-mount_yageo-rc0603fr-070rl_C100044.html) | 0.0011 | $0.4400
11 | Resistor | R2, R6, R10, R14, R16, R20, R35, R39, R43, R47, R49, R53, R68, R72, R76, R80, R82, R86 | RES SMD 1K OHM 1% 1/10W 0603 | Res-0603 | RC0603FR-071KL | Yageo | - | C22548 | 1K | 18 | 180 | 200 | LCSC (https://www.lcsc.com/product-detail/chip-resistor-surface-mount_yageo-rc0603fr-071kl_C22548.html) | 0.0011 | $0.2200
12 | Resistors | R3, R4, R11, R12, R17, R18, R36, R37, R44, R45, R50, R51, R69, R70, R77, R78, R83, R84 | RES 0.002 OHM 1% 3W 2512 | RES-2512 | ~~PA2512FKE7T0R002E~~ | Yageo | HoLLR2512-3W-2mR-1% | C2994640 | 2mR | 18 | 180 | 185 | LCSC (https://www.lcsc.com/product-detail/Current-Sense-Resistors-Shunt-Resistors_Milliohm-HoLLR2512-3W-2mR-1_C2994640.html) | $0.0476 | $8.8060
13 | Resistor | R21, R54, R87 | RES SMD 10K Ohm 1% 1/10W 0603 | Res-0603 | RC0603FR-0710KL | Yageo | - | C98220 | 10K | 3 | 30 | 100 | LCSC (https://www.lcsc.com/product-detail/chip-resistor-surface-mount_yageo-rc0603fr-0710kl_C98220.html) | 0.0011 | $0.1100
14 | Resistor | R30, R31, R32, R33, R63, R64, R65, R66, R96, R97, R98, R99 | RES SMD 680 OHM 1% 1/10W 0603 | Res-0603 | RC0603FR-07680RL | Yageo | - | C112310 | 680R | 12 | 120 | 100 | LCSC (https://www.lcsc.com/product-detail/chip-resistor-surface-mount_yageo-rc0603fr-07680rl_C112310.html) | 0.0012 | $0.1200
15 | IC | U1, U2, U3 | IC AFE 7 CHAN 40LFCSP-WQ | 40-LFCSP-WQ (6x6) | ADE9000ACPZ | Analog Devices | - | C654559 | - | 3 | 30 | 31 | Chipsmall (https://www.chipsmall.com/Products/ADE9000ACPZ_12336253.html) | $7.3254 | $227.0862
16 | Crystal | X1, X2, X3 | 24.576MHz Surface Mount Crystal 12pF ±10ppm ±20ppm SMD3225-4P Crystals ROHS | SMD3225-4P | X322524576MOB4SI | YXC | - | C70568 | 24.576MHz | 3 | 30 | 35 | LCSC (https://www.lcsc.com/product-detail/crystals_yxc-crystal-oscillators-x322524576mob4si_C70568.html) | 0.0784 | $2.7440
 |  |  |  |  |  |  |  |  |  |  |  | Total Component Cost |  |  | $303.04
 |  |  |  |  |  |  |  |  |  |  |  | Single Board Cost |  |  | $30.30

Sheet: 1000 Boards
 |  | Component list |  | Bill of Materials for Project [OFP_CIM_v1.5
 |  | Project: |  | OFP_CIM_v1.5
# | Item Type | Designator | Description | Footprint | Manufacturer Part Number | Manufacturer | Alternate Part Number | LCSC Part Number | Value | Quantity | Quantity (1000 Boards) | MOQ (1000 Boards) | Links | Unit Cost (1000 Boards) | Total Cost (1000 Boards) | Remarks
1 | Capacitors | C1, C2, C3, C4, C5, C6, C7, C8, C11, C12, C13, C14, C28, C29, C30, C31, C32, C33, C34, C35, C38, C39, C40, C41, C55, C56, C57, C58, C59, C60, C61, C62, C65, C66, C67, C68 | CAP CER 0.022UF 50V C0G/NP0 0805 | Cap-0805 | GRM21B5C1H223JA01L | Murata | - | C77069 | 22nF | 36 | 36000 | 36010 | LCSC (https://www.lcsc.com/product-detail/multilayer-ceramic-capacitors-mlcc-smd-smt_murata-electronics-grm21b5c1h223ja01l_C77069.html) | 0.0228 | $821.0280
2 | Capacitor | C9, C10, C36, C37, C63, C64 | CAP CER 15PF 50V C0G/NPO 0603 | Cap-0603 | CC0603JRNPO9BN150 | Yageo | - | C107037 | 15pF | 6 | 6000 | 6100 | LCSC (https://www.lcsc.com/product-detail/multilayer-ceramic-capacitors-mlcc-smd-smt_yageo-cc0603jrnpo9bn150_C107037.html) | 0.0015 | $9.1500
3 | Capacitors | C15, C20, C22, C24, C26, C42, C47, C49, C51, C53, C69, C74, C76, C78, C80, C82 | CAP CER 0.1UF 50V X7R 0603 | Cap-0603 | GCJ188R71H104KA12D | Murata | - | C161115 | 0.1uF | 16 | 16000 | 16050 | LCSC (https://www.lcsc.com/product-detail/multilayer-ceramic-capacitors-mlcc-smd-smt_murata-electronics-gcj188r71h104ka12d_C161115.html) | 0.0159 | $255.1950
4 | Capacitors | C21, C23, C25, C27, C48, C50, C52, C54, C75, C77, C79, C81, C83 | CAP CER 4.7UF 10V X7R 0603 | Cap-0603 | GRM188Z71A475KE15D | Murata | - | C913474 | 4.7uF | 13 | 13000 | 13010 | LCSC (https://www.lcsc.com/product-detail/multilayer-ceramic-capacitors-mlcc-smd-smt_murata-electronics-grm188z71a475ke15d_C913474.html) | 0.0220 | $286.2200
5 | Diodes | D1, D2, D3, D4, D5, D6, D9, D10, D11, D12, D13, D14, D17, D18, D19, D20, D21, D22 | DIODE ARR GP 100V 215MA TO-236AB | SOT-23 | BAV99,215 | Nexperia | - | C2500 | - | 18 | 18000 | 18050 | LCSC (https://www.lcsc.com/product-detail/switching-diodes_nexperia-bav99-215_C2500.html) | 0.0045 | $81.2250
6 | Terminal Block | J1 | 450V 17.5A 18 Bend -40℃~+105℃ 1 5.08mm 1x18P Green Board end/socket - Open type Push-Pull,P=5.08mm Pluggable System Terminal Block ROHS | Custom | DB2ER-5.08-18P-GN | DIBO | - | C430511 | - | 1 | 1000 | 1002 | LCSC (https://www.lcsc.com/product-detail/pluggable-system-terminal-block_dorabo-db2er-5-08-18p-gn_C430511.html) | 0.3223 | $322.9446
7 | Connectors | J2 | CONN HDR 24POS 0.1 GOLD PCB R/A | Custom | SFH11-PBPC-D12-RA-BK | Sullins | - | - | - | 1 | 1000 | 1002 | Chipsmall (https://www.chipsmall.com/Products/SFH11-PBPC-D12-RA-BK_12482478.html) | $0.9194 | $921.1887
8 | Terminal Block | J3, J4, J5 | 450V 17.5A 6 -40℃~+105℃ 1.5 1 14~28 5.08mm 1x6P Green Plug P=5.08mm Pluggable System Terminal Block ROHS | Custom | DB2EK-5.08-6P-GN-S | DIBO | - | C395774 | - | 3 | 3000 | 3002 | LCSC (https://www.lcsc.com/product-detail/pluggable-system-terminal-block_dorabo-db2ek-5-08-6p-gn-s_C395774.html) | 0.2768 | $830.9536 | This Part Use As Peripheral
9 | LED | LED1, LED2, LED3, LED4, LED5, LED6, LED7, LED8, LED9, LED10, LED11, LED12 | Emerald 0603 Light Emitting Diodes (LED) ROHS | LED-0603 | NCD0603G2 | Foshan NationStar Optoelectronics | - | C87326 | - | 12 | 12000 | 12020 | LCSC (https://www.lcsc.com/product-detail/led-indication-discrete_foshan-nationstar-optoelectronics-ncd0603g2_C87326.html) | 0.0115 | $138.2300
10 | Resistor | R1, R5, R7, R8, R9, R13, R15, R19, R25, R27, R34, R38, R40, R41, R42, R46, R48, R52, R58, R60, R67, R71, R73, R74, R75, R79, R81, R85, R91, R93 | RES SMD 0R, 1%, 0.1W, 0603 | Res-0603 | RC0603FR-070RL | Yageo | - | C100044 | 0R | 30 | 30000 | 30100 | LCSC (https://www.lcsc.com/product-detail/chip-resistor-surface-mount_yageo-rc0603fr-070rl_C100044.html) | 0.0006 | $18.0600
11 | Resistor | R2, R6, R10, R14, R16, R20, R35, R39, R43, R47, R49, R53, R68, R72, R76, R80, R82, R86 | RES SMD 1K OHM 1% 1/10W 0603 | Res-0603 | RC0603FR-071KL | Yageo | - | C22548 | 1K | 18 | 18000 | 18100 | LCSC (https://www.lcsc.com/product-detail/chip-resistor-surface-mount_yageo-rc0603fr-071kl_C22548.html) | 0.0006 | $10.8600
12 | Resistors | R3, R4, R11, R12, R17, R18, R36, R37, R44, R45, R50, R51, R69, R70, R77, R78, R83, R84 | RES 0.002 OHM 1% 3W 2512 | RES-2512 | ~~PA2512FKE7T0R002E~~ | Yageo | HoLLR2512-3W-2mR-1% | C2994640 | 2mR | 18 | 18000 | 18005 | LCSC (https://www.lcsc.com/product-detail/Current-Sense-Resistors-Shunt-Resistors_Milliohm-HoLLR2512-3W-2mR-1_C2994640.html) | $0.0352 | $633.7760
13 | Resistor | R21, R54, R87 | RES SMD 10K Ohm 1% 1/10W 0603 | Res-0603 | RC0603FR-0710KL | Yageo | - | C98220 | 10K | 3 | 3000 | 3100 | LCSC (https://www.lcsc.com/product-detail/chip-resistor-surface-mount_yageo-rc0603fr-0710kl_C98220.html) | 0.0008 | $2.4800
14 | Resistor | R30, R31, R32, R33, R63, R64, R65, R66, R96, R97, R98, R99 | RES SMD 680 OHM 1% 1/10W 0603 | Res-0603 | RC0603FR-07680RL | Yageo | - | C112310 | 680R | 12 | 12000 | 12100 | LCSC (https://www.lcsc.com/product-detail/chip-resistor-surface-mount_yageo-rc0603fr-07680rl_C112310.html) | 0.0007 | $8.4700
15 | IC | U1, U2, U3 | IC AFE 7 CHAN 40LFCSP-WQ | 40-LFCSP-WQ (6x6) | ADE9000ACPZ | Analog Devices | - | - | - | 3 | 3000 | 3001 | Chipsmall (https://www.chipsmall.com/Products/ADE9000ACPZ_12336253.html) | $5.2324 | $15702.4324
16 | Crystal | X1, X2, X3 | 24.576MHz Surface Mount Crystal 12pF ±10ppm ±20ppm SMD3225-4P Crystals ROHS | SMD3225-4P | X322524576MOB4SI | YXC | - | C70568 | 24.576MHz | 3 | 3000 | 3005 | LCSC (https://www.lcsc.com/product-detail/crystals_yxc-crystal-oscillators-x322524576mob4si_C70568.html) | 0.0414 | $124.4070
 |  |  |  |  |  |  |  |  |  |  |  | Total Component Cost |  |  | $20166.62
 |  |  |  |  |  |  |  |  |  |  |  | Single Board Cost |  |  | $20.17
