eSpark-Backup/nabilfesal-smartmeter-hw/Design-Files/OFP_MCM_v1.6.3/Deliverables/BOM/Client-BOM-OFP_MCM_v1.62.xlsx

# | Item Type | Designator | Description | Footprint | Manufacturer Part Number | Manufacturer | Value | Quantity | Remarks
1 | Capacitors | C1, C2, C5, C6 | CAP CER 15PF 50V C0G/NP0 0402 | Cap-0402 | GJM1555C1H150FB01D | Murata | 15pF | 4
2 | Capacitors | C3, C17, C22, C23, C34, C38, C42, C45, C87, C88 | CAP CER 1UF 6.3V X7R 0402 | Cap-0402 | GRM155R70J105KA12J | Murata | 1uF | 10
3 | Capacitor | C4, C11, C16, C20, C33, C37, C41, C57, C58, C93, C94 | CAP CER 10UF 10V X7R 0603 | Cap-0603 | GRM188Z71A106KA73D | Murata | 10uF | 11
4 | Capacitors | C7, C12, C13, C14, C15, C18, C19, C24, C27, C28, C29, C30, C31, C35, C36, C39, C40, C43, C44, C46, C95, C97, C111, C114, C117, C120, C124, C127, C130, C133, C149, C150 | CAP CER 0.1UF 25V X7R 0402 | Cap-0402 | GRM155R71E104KE14D | Murata | 0.1uF | 32 | C149, C150
5 | Super Capaciitor | C8 | 0.47F -20%~+80% 5.5V | Custom | SC EB 5R5 474 M | Wincap(Xingkai) | 0.47F | 1
6 | Capacitors | C9, C49, C52, C53, C59, C75, C80, C83, C101, C106, C139, C140, C151 | CAP CER 0.1UF 50V X7R 0603 | Cap-0603 | GCJ188R71H104KA12D | Murata | 0.1uF | 13 | C151 added.
7 | Capacitor | C10 | CAP CER 12PF 100V C0G/NP0 0603 | Cap-0603 | GCM1885C2A120JA16D | Murata | 12pF | 1
8 | Capacitor | C21, C25 | CAP CER 4.7UF 16V X5R 0402 | Cap-0402 | CL05A475MO5NUNC | Samsung | 4.7uF | 2
9 | Capacitor | C26 | CAP CER 1000PF 50V C0G/NP0 0402 | Cap-0402 | GRM1555C1H102JA01D | Murata | 1nF | 1
10 | Capacitor | C32, C112, C115, C118, C121, C125, C128, C131, C134 | CAP CER 10000PF 50V X7R 0402 | Cap-0402 | GCM155R71H103JA55D | Murata | 10nF | 9
11 | Capacitor | C47, C48, C78, C79, C89, C90, C91, C92, C104, C153 | CAP CER 10UF 50V X7R 1210 | Cap-1210 | GRM32ER71H106KA12L | Murata | 10uF | 10 | C153 added.
12 | Capacitor | C50, C51 | CAP CER 22UF 10V X7R 0805 | Cap-0805 | GRM21BZ71A226ME15L | Murata | 22uF | 2
13 | Capacitor | C54, C65, C72 | CAP CER 0.047UF 50V X7R 0603 | Cap-0603 | GCJ188R71H473KA12D | Murata | 47nF | 3
14 | Capacitor | C55 | CAP CER 82PF 50V C0G/NPO 0603 | Cap-0603 | CC0603JRNPO9BN820 | Yageo | 82pF | 1
15 | Capacitor | C56 | CAP CER 0.033UF 50V X7R 0603 | Cap-0603 | GCJ188R71H333KA12D | Murata | 33nF | 1
16 | Capacitor | C60, C61, C67, C68, C76, C77, C81, C82, C154, C155 | CAP CER 22UF 6.3V X7R 0805 | Cap-0805 | GRM21BZ70J226ME44L | Murata | 22uF | 10 | C154, C155 added.
17 | Capacitor | C62, C66, C69, C73, C85 | CAP CER 22PF 100V C0G/NP0 0603 | Cap-0603 | GCM1885C2A220JA16D | Murata | 22pF | 5
18 | Capacitor | C63 | CAP CER 3300PF 50V C0G/NP0 0603 | Cap-0603 | GCM1885C1H332FA16D | Murata | 3.3nF | 1
19 | Capacitor | C64, C98, C99 | CAP CER 1UF 50V X7R 0603 | Cap-0603 | CC0603KRX7R9BB105 | Yageo | 1uF | 3
20 | Capacitor | C70, C86 | CAP CER 2200PF 50V C0G/NP0 0603 | Cap-0603 | GRM1885C1H222JA01D | Murata | 2.2nF | 2
21 | Capacitor | C71, C74, C84 | CAP CER 10000PF 50V C0G/NP0 0603 | Cap-0603 | GRM1885C1H103JA01D | Murata | 0.01uF | 3
22 | Capacitor | C96 | CAP CER 2.2UF 16V X7R 0603 | Cap-0603 | CC0603KRX7R7BB225 | Yageo | 2.2uF | 1
23 | Capacitor | C100, C105 | CAP TANT 100UF 20% 6V 1206 | Case-A | T490A107M006ATE800 | KEMET | 100uF | 2
24 | Capacitor | C102, C107 | CAP CER 33PF 100V C0G/NP0 0603 | Cap-0603 | GCM1885C2A330JA16D | Murata | 33pF | 2
25 | Capacitor | C103, C108 | CAP CER 10PF 50V C0G/NPO 0603 | Cap-0603 | CC0603JRNPO9BN100 | Yageo | 10pF | 2
26 | Capacitor | C109, C110 | CAP 30pF NP0 0603 50 V ±5 % SMD | Cap-0603 | CC0603JRNPO9BN300 | Yageo | 30pF | 2
27 | Capacitor | C113, C116, C119, C122, C126, C129, C132, C135 | CAP CER 1000PF 25V X7R 0402 | Cap-0402 | CC0402KRX7R8BB102 | Yageo | 1nF | 8
28 | Capacitor | C123 | CAP CER 1UF 25V X5R 0402 | Cap-0402 | CC0402KRX5R8BB105 | Yageo | 1uF | 1
29 | Capacitor | C136 | CAP CER 10UF 10V X5R 0402 | Cap-0402 | CC0402MRX5R6BB106 | Yageo | 10uF | 1
30 | Capacitor | ~~C137, C138, C141, C142, C144, C145, C146~~ | ~~CAP CER 33PF 25V C0G/NP0 0402~~ | ~~Cap-0402~~ | ~~GRM1555C1E330JA01D~~ | ~~Murata~~ | ~~DNP~~ | ~~7~~ | ~~DO NOT PLACE~~
31 | Capacitor | ~~C143~~ | ~~CAP CER 0.1UF 50V X7R 0603~~ | ~~Cap-0603~~ | ~~GCJ188R71H104KA12D~~ | ~~Murata~~ | ~~DNP~~ | ~~1~~ | ~~DO NOT PLACE~~
32 | Capacitor | C152 | CAP CER 47UF 25V X5R 1206 | Cap-1206 | C3216X5R1E476M160AC | TDK | 47uF | 1 | New Component added.
33 | Capacitor | C156 | CAP CER 22UF 25V X5R 0805 | Cap-0805 | CC0805MKX5R8BB226 | Yageo | 22uF | 1 | New Component added.
34 | Capacitor | C157, C158 | 47uF 25V 150mΩ@100kHz ±10% CASE-D-7343-31(mm) Tantalum Capacitors ROHS | CASE-D-7343-31(mm) | TPSD476K025R0150 | Kyocera AVX | 47uF | 2 | New Component added.
35 | (TVS/ESD) | D1, D2, D3, D4, D5, D6, D7, D8, D10 | 5A 60W 12V 3.6V 3.3V SOD-523 ESD and Surge Protection (TVS/ESD) ROHS | SOD-523 (Bi-Directional) | ESD5Z3.3C | MDD(Microdiode Semiconductor) | - | 9
36 | Diode | D9, D20 | DIODE GEN PURP 75V 200MA SOD523F | SOD-523F | 1N4148WT | ON Semiconductor / Fairchild | - | 2
37 | Diode | ~~D11~~ | ~~DIODE SCHOTTKY 40V 1A SOD123~~ | ~~SOD-123~~ | ~~1N5819HW-7-F~~ | ~~Diodes~~ | ~~DNP~~ | ~~1~~ | ~~DO NOT PLACE~~
38 | Diode | D12 | 65.2A 9.2V 6.4V 5V Unidirectional SMB TVS ROHS | SMB_ | SMBJ5.0A | AnBon | - | 1 | New Component added.
39 | TVS Diode | D13 | TVS DIODE 3.3VWM 11.5VC MICROSMP | MicroSMP | MSP3V3HM3/89A | Vishay Semiconductors | - | 1 | New Component added.
40 | TVS Diodes | D14 | TVS DIODE 13VWM 21.5VC DO-214AA | SMB_ | SMBJ13A | Littelfuse | - | 1 | New Component added.
41 | TVS Diodes | D15, D16 | TVS DIODE 3.6VWM 19VC 2X1SON | 2-X1SON (1x.60) | TPD1E0B04DPYR | Texas Instruments | - | 2 | New Component added.
42 | TVS Diodes | D17, D18, D19 | TVS DIODE 3.3VWM 6.8VC SOD123F | SOD-123FL | SMF3.3 | Littelfuse | - | 3 | New Component added.
43 | Ferrite Bead | FB1, FB2 | FERRITE BEAD 220 OHM 0603 1LN | IND-0603 (1608 Metric) | BLM18PG221SN1D | Murata | - | 2
44 | Connector | J1 | 1.10mm Pitch microSD Memory Card Connector, Reverse Mount SMT, Push-Push Type | Custom | 5027740891 | Molex | - | 1
45 | FFC/FPC Cable | J2 | Flip type 10P Bottom Contact Horizontal attachment 0.5mm SMD,P=0.5mm FFC, FPC (Flat Flexible) Connector Assemblies ROHS | Custom | HX0.5-10P XJH2.0 043 | hanxia | - | 1
46 | USB Micro B | J3 | 1A USB 2.0 1 Direct Insert 5P Female Micro-B Plugin USB Connectors ROHS | Custom | U-D-M5DD-Y-3 | HRO Electronics | - | 1
47 | Card Edge Connectors | J4 | CONN FFC BOTTOM 40POS 0.5MM R/A | Custom | FH41-40S-0.5SH(05) | Hirose | - | 1 | Connector changed.
48 | RF / Coaxial Connectors | J5, J6 | CONN U.FL RCPT STR 50 OHM SMD | Custom | U.FL-R-SMT(10) | Hirose | - | 2
49 | RF / Coaxial Connectors | ~~J8~~ | ~~CONN U.FL RCPT STR 50 OHM SMD~~ | ~~U.FL-R-SMT(10)~~ | ~~U.FL-R-SMT(10)~~ | ~~Hirose~~ | ~~DNP~~ | ~~1~~ | ~~DO NOT PLACE~~
50 | Wire to Board Connector | J10 | CONN HEADER VERT 8POS 2.5MM | Custom | B8B-XH-A(LF)(SN) | JST | - | 1
51 | Inductors | L1 | FIXED IND 6.8UH 4.5A 50.16 MOHM | Custom | ETQ-P3M6R8KVN | Panasonic | 6.8uH | 1
52 | Inductor | L2, L3, L4 | 4.7uH Molded Inductor ±20% SMD,5.4x5.2mm Fixed Inductors ROHS | Custom | YSPI0518S-4R7M | YJYCOIN | 4.7uH | 3 | Component changed
53 | Inductor | L5 | FIXED IND 4.7UH 1.9A 84 MOHM SMD | Custom | SRN4018-4R7M | Bourns | 4.7uH | 1
54 | Inductor | L6 | 590mA 22uH ±20% SMD,4x4x1.8mm Power Inductors ROHS | Custom | YNR4018-220M | YJYCOIN | 22uH | 1
55 | Inductors | ~~L7~~ | ~~FIXED IND 47NH 400MA 0.7OHM SMD~~ | ~~IND-0603 (1608 Metric)~~ | ~~LQG18HH47NJ00D~~ | ~~Murata~~ | ~~DNP~~ | ~~1~~ | ~~DO NOT PLACE~~
56 | Inductor | L8 | 2.3A 3.9uH ±20% 3.3A SMD,4x4mm Power Inductors ROHS | Custom | FNR4030S3R9MT | cjiang | 3.9uH | 1 | New Component added.
57 | LED | LED1 | D=5mm LED Indication - Discrete ROHS | TH LED 5mm_ | DY-333SDRD-SN-A3(EL)(HF) | TONYU | - | 1
58 | LED | LED2, LED3, LED4, LED5, LED8 | RED LED 0603 Light Emitting Diodes | LED-0603 | NCD0603R3 | Foshan NationStar Optoelectronics | - | 5
59 | LED | LED6, LED11 | 333-2 Series Yellow Green 5 x 5.9 x 8.6 mm 30° 80 mcd Diffused 2.4 V LED | TH LED 5mm Green | 333-2SYGD/S530-E2-L | Everlight | - | 2
60 | LED | LED7 | LED YELLOW DIFFUSED 5MM T/H | TH LED 5mm Yellow | 333-2UYD/S530-A3-L | Everlight | - | 1
61 | LED | LED10 | yellow 0603 Light Emitting Diodes (LED) ROHS | LED-0603 | NCD0603Y2 | Foshan NationStar Optoelectronics | - | 1
62 | Buzzers | LS1 | 80dB Passive (external drive) Electromagnetic Type 4kHz SMD,5x5mm Buzzers ROHS | Custom | FUET-5025 | FUET | - | 1
63 | Mosfet | Q1 | TRANS NPN 40V 0.6A SMD SOT23-3 | SOT-23 | MMBT2222A-7-F | Diodes | - | 1
64 | Mosfet | Q2, Q3, Q4, Q5, Q6, Q7 | TRANS PREBIAS NPN 50V 0.1A EMT3 | SOT-416 | DTC143ZETL | Rohm | - | 6
65 | (BJT) | Q8 | 40V 200mW 100 200mA NPN SOT-23 Bipolar (BJT) ROHS | SOT-23 | MMBT3904 | ElecSuper | - | 1 | New Component added.
 | Mosfet | Q9 | 30V 5.8A 32mΩ@10V,5.8A 1.4W 1.4V@250uA 1 N-Channel SOT-23 Single FETs, MOSFETs ROHS | SOT-23 | AO3400A | BORN | - | 1 | New Component added.
67 | Resistor | R1, R2, R3, R4, R5, R6, R7 | RES 47K OHM 1% 1/16W 0402 | Res-0402 | RC0402FR-0747KL | Yageo | 47K | 7
68 | Resistor | R8 | RES 3.3 OHM 1% 1/16W 0402 | Res-0402 | RC0402FR-073R3L | Yageo | 3.3R | 1
69 | Resistors | R9 | RES 5.6K OHM 1% 1/16W 0402 | Res-0402 | RC0402FR-075K6L | Yageo | 5.6K | 1
70 | Resistor | R10 | RES 10K OHM 1% 1/16W 0402 | Res-0402 | RC0402FR-0710KL | Yageo | 10K | 1
71 | Resistor | R11 | RES SMD 100K OHM 0.1% 1/16W 0402 | Res-0402 | RT0402BRD07100KL | Yageo | 100K | 1
72 | Resistor | R12 | RES 120 OHM 1% 1/10W 0603 | Res-0603 | RC0603FR-07120RL | Yageo | 120R | 1
73 | Resistors | R13 | RES SMD 6.8K OHM 0.1% 1/16W 0402 | Res-0402 | RT0402BRC076K8L | Yageo | 6.8K | 1
74 | Resistor | R14 | RES SMD 8.2K OHM 0.1% 1/16W 0402 | Res-0402 | RT0402BRD078K2L | Yageo | 8.2K | 1
75 | Resistor | R15 | RES SMD 10K OHM 0.1% 1/16W 0402 | Res-0402 | RT0402BRD0710KL | Yageo | 10K | 1
76 | Resistors | R16 | RES SMD 11K OHM 0.1% 1/16W 0402 | Res-0402 | RT0402BRE0711KL | Yageo | 11K | 1
77 | Resistor | R17 | RES 1K OHM 1% 1/16W 0402 | Res-0402 | RC0402FR-071KL | Yageo | 1K | 1
78 | Resistor | R18, R19, R82, R90, R91, R92, R94 | RES 4.7K OHM 1% 1/16W 0402 | Res-0402 | RC0402FR-074K7L | Yageo | 4.7K | 7 | R82 changed
79 | Resistor | R20 | RES 5.1K OHM 1% 1/10W 0603 | Res-0603 | RC0603FR-075K1L | Yageo | 5.1K | 1
80 | Resistors | R21, R22, R23, R24, R25, R26, R28, R32, R33, R34, R35, R36, R37, R38, R96, R101, R109, R117 | RES 0 OHM JUMPER 1/16W 0402 | Res-0402 | RC0402FR-070RL | Yageo | 0R | 18
81 | Resistor | R27, R29 | RES 2K OHM 1% 1/16W 0402 | Res-0402 | RC0402FR-072KL | Yageo | 2K | 2
82 | Resistors | R30 | RES 240 OHM 1% 1/16W 0402 | Res-0402 | RC0402FR-07240RL | Yageo | 240R | 1
83 | Resistor | R31 | RES 200K OHM 1% 1/16W 0402 | Res-0402 | RC0402FR-07200KL | Yageo | 200K | 1
84 | Resistor | R39, R42, R52, R55, R57, R58, R84, R104, R118 | RES SMD 0R, 1%, 0.1W, 0603 | Res-0603 | RC0603FR-070RL | Yageo | 0R | 9
85 | Resistors | R40 | RES SMD 536K OHM 0.1% 1/10W 0603 | Res-0603 | RT0603BRD07536KL | Yageo | 536K | 1
86 | Resistor | R41 | RES 49.9 OHM 1% 1/10W 0603 | Res-0603 | RC0603FR-0749R9L | Yageo | 49.9R | 1
87 | Resistors | R43 | RES SMD 107K OHM 0.1% 1/10W 0603 | Res-0603 | RT0603BRD07107KL | Yageo | 107K | 1
88 | Resistors | R44 | RES SMD 10.2KOHM 0.1% 1/10W 0603 | Res-0603 | RT0603BRE0710K2L | Yageo | 10.2K | 1
89 | Resistor | ~~R45, R110, R119~~ | ~~RES SMD 0R, 1%, 0.1W, 0603~~ | ~~Res-0603~~ | ~~RC0603FR-070RL~~ | ~~Yageo~~ | ~~DNP~~ | ~~3~~ | ~~DO NOT PLACE~~
90 | Resistors | R46 | RES SMD 53.6KOHM 0.1% 1/10W 0603 | Res-0603 | RT0603BRD0753K6L | Yageo | 53.6K | 1
91 | Resistor | R47, R48, R54, R60, R63, R89, R100 | RES SMD 10K Ohm 1% 1/10W 0603 | Res-0603 | RC0603FR-0710KL | Yageo | 10K | 7
92 | Resistor | R49, R59, R62, R73, R123, R124, R125, R126, R127 | RES 20K OHM 1% 1/10W 0603 | Res-0603 | RC0603FR-0720KL | Yageo | 20K | 9 | R123, R124, R125, R126, R127 added.
93 | Resistors | R50, R51, R70, R71, R72 | RES 100K OHM 1% 1/10W 0603 | Res-0603 | RC0603FR-07100KL | Yageo | 100K | 5
94 | Resistors | R53 | RES 45.3K OHM 1% 1/10W 0603 | Res-0603 | RC0603FR-0745K3L | Yageo | 45.3K | 1
95 | Resistors | R56, R65 | RES 30K OHM 1% 1/10W 0603 | Res-0603 |  |  | 30K | 2
96 | Resistor | R61 | RES SMD 51R 100mW 0603 | Res-0603 | RC0603FR-0751RL | Yageo | 51R | 1
97 | Resistor | R64 | RES SMD 73.2KOHM 0.1% 1/10W 0603 | Res-0603 | RT0603BRD0773K2L | Yageo | 73.2K | 1
98 | Resistors | R66 | RES 37.4K OHM 1% 1/10W 0603 | Res-0603 | RC0603FR-0737K4L | Yageo | 37.4K | 1
99 | Resistors | R67 | RES 1.87K OHM 1% 1/16W 0402 | Res-0402 | RC0402FR-071K87L | Yageo | 1.87K | 1
100 | Resistors | R68 | RES 4.99K OHM 1% 1/16W 0402 | Res-0402 | RC0402FR-074K99L | Yageo | 4.99K | 1
101 | Resistor | R69 | RES 140K OHM 1% 1/10W 0603 | Res-0603 | RC0603FR-07140KL | Yageo | 140K | 1
102 | Resistors | R74, R75, R76 | RES 51K OHM 1% 1/10W 0603 | Res-0603 | RC0603FR-0751KL | Yageo | 51K | 3
103 | Resistor | R77, R81, R97, R98, R114, R120, R121 | RES SMD 680 OHM 1% 1/10W 0603 | Res-0603 | RC0603FR-07680RL | Yageo | 680R | 7 | R81 added.
104 | Resistor | R78, R83, R128 | RES 820 OHM 1% 1/10W 0603 | Res-0603 | RC0603FR-07820RL | Yageo | 820R | 3 | R83, R128 added
105 | Resistor | R79 | RES 499 OHM 1% 1/10W 0603 | Res-0603 | RC0603FR-07499RL | Yageo | 499R | 1
106 | Resistor | R80 | RES SMD 100 OHM 1% 1/10W 0603 | Res-0603 | RC0603FR-07100RL | Yageo | 100R | 1
107 | Resistor | ~~R85~~ | ~~RES SMD 10K Ohm 1% 1/10W 0603~~ | ~~Res-0603~~ | ~~RC0603FR-0710KL~~ | ~~Yageo~~ | ~~DNP~~ | ~~1~~ | ~~DO NOT PLACE~~
108 | Resistor | R86 | RES SMD 10 OHM 1% 1/10W 0603 | Res-0603 | RC0603FR-0710RL | Yageo | 10R | 1
109 | Resistors | R87 | 63mW Thin Film Resistor ±50ppm/℃ ±0.1% 9.53kΩ 0402 Chip Resistor - Surface Mount ROHS | Res-0402 | RT0402BRE079K53L | Yageo | 9.53K | 1
110 | Resistors | R88 | RES 90.9K OHM 1% 1/10W 0603 | Res-0603 | RC0603FR-0790K9L | Yageo | 90.9K | 1
111 | Resistor | R93 | RES SMD 1M OHM 1% 1/10W 0603 | Res-0603 | RC0603FR-071ML | Yageo | 1M | 1
112 | Resistor | R95 | RES SMD 1K OHM 1% 1/10W 0603 | Res-0603 | RC0603FR-071KL | Yageo | 1K | 1
113 | Resistor | ~~R99~~ | ~~RES SMD 680 OHM 1% 1/10W 0603~~ | ~~Res-0603~~ | ~~RC0603FR-07680RL~~ | ~~Yageo~~ | ~~DNP~~ | ~~1~~ | ~~DO NOT PLACE~~
114 | Resistors | R102 | RES 47K OHM 1% 1/10W 0603 | Res-0603 | RC0603FR-0747KL | Yageo | 47K | 1
115 | Resistor | ~~R103~~ | ~~RES SMD 1K OHM 1% 1/10W 0603~~ | ~~Res-0603~~ | ~~RC0603FR-071KL~~ | ~~Yageo~~ | ~~DNP~~ | ~~1~~ | ~~DO NOT PLACE~~
116 | Resistor | R105, R106, R107, R108 | RES 22 OHM 1% 1/10W 0603 | Res-0603 | RC0603FR-0722RL | Yageo | 22R | 4
117 | Resistor | R111 | RES SMD 4.7K OHM 1% 1/10W 0603 | Res-0603 | RC0603FR-074K7L | Yageo | 4.7K | 1
118 | Resistor | ~~R112~~ | ~~RES SMD 10 OHM 1% 1/10W 0603~~ | ~~Res-0603~~ | ~~RC0603FR-0710RL~~ | ~~Yageo~~ | ~~DNP~~ | ~~1~~ | ~~DO NOT PLACE~~
119 | Resistor | ~~R113~~ | ~~RES 0 OHM JUMPER 1/16W 0402~~ | ~~Res-0402~~ | ~~RC0402FR-070RL~~ | ~~Yageo~~ | ~~DNP~~ | ~~1~~ | ~~DO NOT PLACE~~
120 | Resistor | R122 | RES SMD 10M Ohm 5% 1/16W 0402 | Res-0402 | RC0402JR-0710ML | Yageo | 10M | 1
121 | Switches | SW1 | SWITCH TACTILE SPST-NO 0.05A 24V | Custom | FSM6JSMATR | TE Connectivity Alcoswitch | - | 1
122 | Tactile Switch | SW2 | Without bracket 50mA 4mm 100000 Times 12V 160gf 3mm 2mm Round Button Standing paste SPST SMD Tactile Switches ROHS | Custom | TS-1088-AR02016 | XUNPU | - | 1
123 | Tactile Switch | SW3, SW4, SW5, SW6 | 6mm 13mm Round Button 50mA Standing paste 6mm SPST 12V SMD,6x6mm Tactile Switches ROHS | Custom | TS-1002S-13026C | XUNPU | - | 4 | Part number updated. Switch height increased by 1mm.
124 | IC | U1 | LQFP-128-EP(14x14) Microcontrollers (MCU/MPU/SOC) ROHS | LQFP-128-EP(14x14) | V3s | Allwinner Tech | - | 1
125 | IC | U2 | IC FLASH 128MBIT SPI/QUAD 8WSON | WSON-8-EP(6x8) | W25Q128JVEIQ | Winbond | - | 1
126 | IC | U3 | IC RTC CLOCK/CALENDAR I2C 8SO | SOIC-8(0.154", 3.90mm Width) | PCF8563T/5,518 | NXP Semiconductors | - | 1
127 | IC | U4 | 2Mbps Transceiver USB 2.0 SOP-16 USB ICs ROHS | SOP-16 | CH340C | WCH | - | 1
128 | IC | U5 | IC REG BUCK ADJ 3A SOT583 | SOT-583 | TPS62933DRLR | Texas Instruments | - | 1
129 | IC | U6 | IC REG BCK ADJ 3A/2A TRPL 32VQFN | 32-QFN (5x5) | TPS65261RHBR | Texas Instruments | - | 1
130 | IC | U7 | IC REG BUCK ADJ 3A SOT563 | SOT-563 | TPS563202DRLR | Texas Instruments | - | 1
131 | IC | U8 | IC REG LIN POS ADJ 1.5A 20VQFN | 20-VQFN (5x5) | TPS74801RGWR | Texas Instruments | - | 1
132 | IC | U9 | IC REG LINEAR 3V 200MA SOT23 | SOT-23 | XC6206P302MR-G | Torex | - | 1
133 | IC | U10 | IC REG LINEAR 3.3V 1.5A SOT223-6 | SOT-223-6_ | TPS7A4533DCQR | Texas Instruments | - | 1
134 | IC | U11 | MSOP-10 Touch Screen Controllers ROHS | 10-MSOP | NS2009 | Shenzhen Nsiway Tech | - | 1
135 | IC | U12 | IC LED DRVR RGLTR PWM 30MA 6WSON | WSON-6-EP(2x2) | TPS61158DRVR | Texas Instruments | - | 1
136 | IC | U13 | IC USB 2.0 2PORT HUB IND 48HTQFP | 48-HTQFP (7x7) | TUSB4020BIPHPR | Texas Instruments | - | 1
137 | IC | U14 | RF TXRX MOD CELLULARCARD EDGE | Custom | EC21EFA-512-STD | Quectel Wireless Solutions | - | 1
138 | IC | U15 | IC TRANSLATOR BIDIR 20TSSOP | TSSOP-20 | TXS0108EPWR | Texas Instruments | - | 1
139 | IC | U16 | IC XPND 400KHZ I2C SMBUS 16TSSOP | TSSOP_16 | PCA9557PW,118 | NXP Semiconductors | - | 1
140 | (TVS/ESD) | U17 | 6A 12V 150W 6V Unidirectional 5V SOT-23-6 ESD and Surge Protection (TVS/ESD) ROHS | SOT-23-6 | USBLC6-2SC6 | TECH PUBLIC | - | 1 | New Component added.
141 | IC | U18 | DG ISO 5KV 4CH CAN/RS232 16-SOIC | SOIC-16-300mil | ISO6742FDWR | Texas Instruments | - | 1 | New Component added.
142 | Module | U19 | 10W wide-voltage input, isolated and regulated single-channel/positive-negative dual-channel output DC/DC power supply module | Custom | VRB1212S-10WR3 | YLPTEC | - | 1 | New Component added.
143 | IC | U20 | IC REG BUCK 3.3V 2A TSOT26 | TSOT-23-6 | AP63203WU-7 | Diodes | - | 1 | New Component added.
144 | Crytal | X1 | 24MHz Surface Mount Crystal 12pF ±10ppm ±10ppm SMD3225-4P Crystals ROHS | SMD3225-4P | 7M24000192 | TXC Corp | 24MHz | 1
145 | Crystals | X2, X3 | CRYSTAL 32.7680KHZ 12.5PF SMD | SMD3215-2P | CM315D32768DZFT | Citizen | 32.768kHz | 2
146 | Crystal | X4 | 24MHz Surface Mount Crystal 20pF ±10ppm ±20ppm SMD5032-4P Crystals ROHS | SMD5032-4P | X503224MSB4SI | YXC | 24MHz | 1
 | Solder Bridge | SB1 | - | - | - | - | Do Not Connect | 1
148 | Peripheral | - | 20cm IPEX to SMA 1Gen RF Cables ROHS | Custom | BWIPX1-SMA-1.13L200 | BAT WIRELESS | - | 2
149 | Peripheral | - | Storage products | Custom | MKUS008G-IGT1A | MK | - | 1 | or any other industrial microSD card with 8GB of storage
150 | Peripheral | - | 0.3mm 40P 0.5mm Same Side 10cm P=0.5mm FFC Cable (Flexible Flat Cable) ROHS | Custom | JS05A-40P-100-3-4 | JUSHUO | - | 1
151 | Peripheral | - | 3 4G Antenna 3.8dBi Linear 10W Antennas ROHS | Custom | AECW004 | MyAntenna | - | 2
152 | Peripheral | - | FPC延长板 焊好2个0.5mm间距40p翻盖FPC连接器 组装 QWY(CN) RoHs | Custom |  |  | - | 1 | Moko Code: 12300000303070
153 | Peripheral | - | 5 inch TFT LCD Display 800*480 RGB Interface LCD Touch Screen Panel | Custom | RGB5001 | QDTFT | - | 1 | Already Provided
154 | Peripheral | - | LED SPACER MOUNTS for T-1 and T-13/4 | Custom | 8900 | Keystone | - | 4
