eSpark-Backup/nabilfesal-smartmeter-hw/docs/Client-Files/Product Files/MSM-Documentation-24122024/EIN-BOM_MSM-Final-010824.xlsx

#VALUE!
BOM list Bill of Materials for Current Input Module
 |  | # |  | Name |  |  |  | Footprint |  | Quantity |  |  |  |  | Description |  |  |  |  |  |  | Manufacturer_Name |  |  |  | Manufacturer_Part_Number |  |  |  |  | Unit Price (USD) |  |  |  |  |  | Extended Price (USD) |  |  |  | MOQ |  |  |  | LT (wks) | Remark
 |  | 1 |  | 22nF/50V |  |  |  | CAP0805 |  | 36 |  |  |  |  | SMD Multilayer Ceramic Capacitor, 22000 pF, 50 V, 0805 [2012 Metric], ± 5%, C0G / NP0, GRM Series |  |  |  |  |  |  | Murata |  |  |  | GRM21B5C1H223JA01L
 |  | 2 |  | 1k |  |  |  | RES0603 |  | 30 |  |  |  |  | SMD Chip Resistor, 1 kohm, ± 1%, 100 mW, 0603 [1608 Metric], Thick Film, General Purpose |  |  |  |  |  |  | Yageo |  |  |  | RC0603FR-071KL
 |  | 3 |  | 0R |  |  |  | RES0603 |  | 30 |  |  |  |  | SMD Chip Resistor, Jumper, 0 ohm, 100 mW, 0603 [1608 Metric], Thick Film, General Purpose |  |  |  |  |  |  | Yageo |  |  |  | RC0603FR-070RL
 |  | 4 |  | 0.002R |  |  |  | RES1206 |  | 18 |  |  |  |  | SMD Current Sense Resistor, 0.002 ohm, PA Series, 1206 [3216 Metric], 1 W, ± 1%, Metal Strip |  |  |  |  |  |  | Yageo |  |  |  | PA1206FRF470R002Z
 |  | 5 |  | 1500R/0.2A |  |  |  | FB0805 |  | 0 |  |  |  |  | Ferrite Bead, 0805 [2012 Metric], 1.5 kohm, 200 mA, BLM21B, 0.45 ohm, ± 25% |  |  |  |  |  |  | Murata |  |  |  | BLM21BD152SN1D
 |  | 6 7 |  | BAV99,215 |  |  |  | SOT-23 |  | 18 |  |  |  |  | Small Signal Diode, Dual Series, 100 V, 215 mA, 1.25 V, 4 ns, 4 A |  |  |  |  |  |  | NXP |  |  |  | BAV99,215
 |  |  |  | 0.1uF/50V |  |  |  | CAP0603 |  | 16 |  |  |  |  | SMD Multilayer Ceramic Capacitor, 0.1 µF, 50 V, 0603 [1608 Metric], ± 10%, X7R, GCJ Series |  |  |  |  |  |  | Murata |  |  |  | GCJ188R71H104KA12D
 |  | 8 |  | 4.7uF/16V |  |  |  | CAP0603 |  | 13 |  |  |  |  | SMD Multilayer Ceramic Capacitor, 4.7 µF, 16 V, 0603 [1608 Metric], ± 10%, X5R, GRM Series |  |  |  |  |  |  | Murata |  |  |  | GRM188R61C475KAAJD
 |  | 9 |  | Green |  |  |  | LED0603-GREEN |  | 12 |  |  |  |  | LED, Green, SMD, 0603, 30 mA, 3.2 V, 520 nm |  |  |  |  |  |  | Wurth |  |  |  | 150060GS75000
 |  | 10 |  | 12pF/100V |  |  |  | CAP0603 |  | 6 |  |  |  |  | SMD Multilayer Ceramic Capacitor, 12 pF, 100 V, 0603 [1608 Metric], ± 1%, C0G / NP0, GCM |  |  |  |  |  |  | Murata |  |  |  | GCM1885C2A120FA16D
 |  | 11 |  | 5.08mm-6P-RA |  |  |  | 5.08MM_6Ways |  | 1 |  |  |  |  | Terminal Block, Header, 5.08 mm, 6 Ways, 15 A, 300 V, Through Hole Right Angle(弯针） |  |  |  |  |  |  | HR |  |  |  | HR2EDGR-5.08-18p
 |  | 12 |  |  |  |  |  |  |  | 3 |  |  |  |  | Terminal Block, Header, 5.08 mm, 6 Ways, 15 A, 300 V, Through Hole |  |  |  |  |  |  | HR |  |  |  | HR2EDGK-5.08-6p
 |  | 13 |  | 10k |  |  |  | RES0603 |  | 3 |  |  |  |  | SMD Chip Resistor, 10 kohm, ± 1%, 100 mW, 0603 [1608 Metric], Thick Film, General Purpose |  |  |  |  |  |  | Yageo |  |  |  | RC0603FR-0710KL
 |  | 14 |  | 24.576MHz |  |  |  | SMD-4(3.2X2.5) |  | 3 |  |  |  |  | Crystal, 24.576 MHz, SMD, 3.2mm x 2.5mm, 50 ppm, 12 pF, 20 ppm, ECX-33Q |  |  |  |  |  |  | ECS Inc. |  |  |  | ECS-245.7-12-33Q-JES-TR
 |  | 15 |  | ADE9000ACPZ |  |  |  | LFCSP-40 |  | 3 |  |  |  |  | Monitoring IC, Energy and Power Quality, Multiphase, 2.97 to 3.63 V, -40 to 85 Deg C, LFCSP-EP-40 |  |  |  |  |  |  | Analog Devices |  |  |  | ADE9000ACPZ
 |  | 16 |  | SH_2X12_F |  |  |  | BH_24POS_2.54_ |  | 1 |  |  |  |  | 20 Position Header Connector 0.100" (2.54mm) Through Hole, Right Angle Gold |  |  |  |  |  |  | Sullins Connector Solutions |  |  |  | SFH11-PBPC-D10-RA-BK
 |  | 17 |  |  |  |  |  |  |  | 1 |  |  |  |  | PCB |  |  |  |  |  |  |  |  |  |  | OFP_CIM_V1.2_GERBER
 |  | pproved
A
 |  | BOM list Bill of Materials for Sub-Controller Module
 |  | # |  | Name |  |  | Footprint |  |  | Quantity |  |  |  |  |  | Description |  |  |  |  |  | Manufacturer_Name |  |  |  |  | Manufacturer_Part_Number |  |  |  |  |  | Unit Price (USD) |  |  |  |  |  | Extended Price (USD) |  |  |  |  |  | MOQ |  | LT (wks) |  |  | Remark
 |  | 1 |  | 10uF/6.3V |  |  | CAP0603 |  |  | 9 |  |  |  |  |  | SMD Multilayer Ceramic Capacitor, 10 µF, 6.3 V, 0603 [1608 Metric], ± 20%, X5R, GRM Series |  |  |  |  |  | Murata |  |  |  |  | GRM188R60J106ME47D
 |  | 2 3 5 |  | 0.1uF/50V |  |  | CAP0603 |  |  | 21 |  |  |  |  |  | SMD Multilayer Ceramic Capacitor, 0.1 µF, 50 V, 0603 [1608 Metric], ± 10%, X7R, GCJ Series |  |  |  |  |  | Murata/ Yageo |  |  |  |  | GCJ188R71H104KA12D/ CC0603KRX7R9BB104
 |  |  |  | 1uF/50V |  |  | CAP0603 |  |  | 1 |  |  |  |  |  | SMD Multilayer Ceramic Capacitor, 1 µF, 50 V, 0603 [1608 Metric], ± 10%, X5R, GRM Series |  |  |  |  |  | Murata |  |  |  |  | GRM188R61H105KAALD
 |  |  |  | 10uF/50V |  |  | CAP1206 |  |  | 2 |  |  |  |  |  | SMD Multilayer Ceramic Capacitor, 10 µF, 50 V, 1206 [3216 Metric], ± 10%, X5R, GRM Series |  |  |  |  |  | Murata |  |  |  |  | GRM31CR61H106KA12L
 |  | 6 7 |  | 33nF/50V |  |  | CAP0603 |  |  | 1 |  |  |  |  |  | SMD Multilayer Ceramic Capacitor, 0.033 µF, 50 V, 0603 [1608 Metric], ± 10%, X7R, -55 °C |  |  |  |  |  | Murata |  |  |  |  | GCJ188R71H333KA12D/ GRM188R71H333KA61D
 |  |  |  | 22uF/6.3V |  |  | CAP0805 |  |  | 2 |  |  |  |  |  | SMD Multilayer Ceramic Capacitor, 22 µF, 6.3 V, 0805 [2012 Metric], ± 20%, X5R, -55 °C |  |  |  |  |  | Murata |  |  |  |  | GRM21BR60J226ME39L
 |  | 8 9 |  | 10uF/16V |  |  | CAP0805 |  |  | 2 |  |  |  |  |  | SMD Multilayer Ceramic Capacitor, 10 µF, 16 V, 0805 [2012 Metric], ± 10%, X5R, GRM Series |  |  |  |  |  | Murata |  |  |  |  | GRM21BR61C106KE15K
 |  |  |  | 100uF/6.3V |  |  | CAP0805 |  |  | 1 |  |  |  |  |  | SMD Multilayer Ceramic Capacitor, 100 µF, 6.3 V, 0805 [2012 Metric], ± 20%, X5R, GRM Series |  |  |  |  |  | Murata |  |  |  |  | GRM21BR60J107ME15L
 |  | 10 11 |  | 4.7uF/16V |  |  | CAP0603 |  |  | 1 |  |  |  |  |  | SMD Multilayer Ceramic Capacitor, 4.7 µF, 16 V, 0603 [1608 Metric], ± 10%, X5R, GRM Series |  |  |  |  |  | Murata |  |  |  |  | GRM188R61C475KAAJD
 |  |  |  | Blue |  |  | LED0603- BLUE |  |  | 4 |  |  |  |  |  | LED, Blue, SMD, 0603, 30 mA, 3.2 V, 470 nm |  |  |  |  |  | Wurth Elektronik |  |  |  |  | 150060BS75000
 |  | 12 13 |  | Red |  |  | LED0603- RED |  |  | 1 |  |  |  |  |  | LED, Red, SMD, 0603, 30 mA, 2 V, 625 nm |  |  |  |  |  | Wurth Elektronik |  |  |  |  | 150060RS75000
 |  |  |  | PH-8P |  |  | PH_2.54MM_ 1X8P |  |  | 1 |  |  |  |  |  | Pin Header, Wire-to-Board, 2.54 mm, 1 Rows, 8 Contacts, Through Hole Straight, KK 254 4030 Series |  |  |  |  |  | MOLEX/ HXD |  |  |  |  | 22-10-2081/ PZ2.54-8P
 |  | 14 15 16 |  | PH-2X3P |  |  | PH_2.54MM_ 2X3P |  |  | 1 |  |  |  |  |  | Pin Header, Wire-to-Board, 2.54 mm, 2 Rows, 6 Contacts, Through Hole Straight, KK 254 4030 Series |  |  |  |  |  | MOLEX/ HXD |  |  |  |  | 90131-0763/ PZ2.54-6_2X3
 |  |  |  | JST-8P |  |  | PH_2.5MM_8 Ways |  |  | 1 |  |  |  |  |  | Pin Header, Wire-to-Board, 2.5 mm, 1 Rows, 6 Contacts, Through Hole, XH Series |  |  |  |  |  | JST |  |  |  |  | B8B-XH-A (LF)(SN)
 |  |  |  | SH_2X12 |  |  | BH_24POS_2 .54 |  |  | 5 |  |  |  |  |  | Pin Header, Boxed, Wire-to-Board, 2.54 mm, 2 Rows, 24 Contacts, Through Hole, Flex Stack TST |  |  |  |  |  | Samtec/ jinling |  |  |  |  | TST-112-01-G-D/ 3210-24SSO
 |  | 17 18 |  | 6.8uH/3.5A |  |  | ETQ(5.5X5) |  |  | 1 |  |  |  |  |  | 6.8 µH Shielded Drum Core, Wirewound Inductor 3.5 A 72.27mOhm Max 2-SMD, J-Lead |  |  |  |  |  | Panasonic |  |  |  |  | ETQ-P3M6R8KVP
 |  |  |  | 10k |  |  | RES0603 |  |  | 1 |  |  |  |  |  | SMD Chip Resistor, 10 kohm, ± 1%, 100 mW, 0603 [1608 Metric], Thick Film, General Purpose |  |  |  |  |  | Yageo |  |  |  |  | RC0603FR-0710KL
 |  | 19 20 24 |  | 0R |  |  | RES0603 |  |  | 4 |  |  |  |  |  | SMD Chip Resistor, Jumper, 0 ohm, 100 mW, 0603 [1608 Metric], Thick Film, General Purpose |  |  |  |  |  | Yageo |  |  |  |  | RC0603FR-070RL
 |  |  |  | 1k |  |  | RES0603 |  |  | 7 |  |  |  |  |  | SMD Chip Resistor, 1 kohm, ± 1%, 100 mW, 0603 [1608 Metric], Thick Film, General Purpose |  |  |  |  |  | Yageo |  |  |  |  | RC0603FR-071KL
 |  |  |  | 511k |  |  | RES0603 |  |  | 1 |  |  |  |  |  | SMD Chip Resistor, 511 kohm, ± 1%, 100 mW, 0603 [1608 Metric], Thick Film, Precision |  |  |  |  |  | Panasonic/ Uniohm |  |  |  |  | ERJ-3EKF5113V/ 0603WAF5113T5E
 |  | 25 26 |  | 88.7k |  |  | RES0603 |  |  | 1 |  |  |  |  |  | SMD Chip Resistor, 88.7 kohm, ± 1%, 250 mW, 0603 [1608 Metric], Thick Film |  |  |  |  |  | Panasonic/ Uniohm |  |  |  |  | ERJPA3F8872V/ 0603WAF8872T5E
 |  |  |  | 10.2k |  |  | RES0603 |  |  | 1 |  |  |  |  |  | SMD Chip Resistor, 10.2 kohm, ± 1%, 100 mW, 0603 [1608 Metric], Thick Film, General Purpose |  |  |  |  |  | Yageo |  |  |  |  | RC0603FR-0710K2L
 |  | 27 28 |  | 53.6k |  |  | RES0603 |  |  | 1 |  |  |  |  |  | SMD Chip Resistor, 53.6 kohm, ± 1%, 100 mW, 0603 [1608 Metric], Thick Film, General Purpose |  |  |  |  |  | Yageo/ uniohm |  |  |  |  | RC0603FR-0753K6L/ 0603WAF5362T5E
 |  |  |  | 49.9R |  |  | RES0603 |  |  | 1 |  |  |  |  |  | SMD Chip Resistor, 49.9 ohm, ± 1%, 100 mW, 0603 [1608 Metric], Thick Film, General Purpose |  |  |  |  |  | Yageo |  |  |  |  | RC0603FR-0749R9L
 |  | 29 30 |  | 100k |  |  | RES0603 |  |  | 1 |  |  |  |  |  | SMD Chip Resistor, 100 kohm, ± 1%, 100 mW, 0603 [1608 Metric], Thick Film, General Purpose |  |  |  |  |  | Yageo |  |  |  |  | RC0603FR-07100KL
 |  |  |  | 4.7k |  |  | RES0603 |  |  | 5 |  |  |  |  |  | SMD Chip Resistor, 4.7 kohm, ± 1%, 100 mW, 0603 [1608 Metric], Thick Film, General Purpose |  |  |  |  |  | Yageo |  |  |  |  | RC0603FR-074K7L
 |  | 31 32 34 |  | TS-1088 |  |  | SWITCH- 2(3X4X2) |  |  | 2 |  |  |  |  |  | NO 50mA 100MΩ 100000 Times 12V 160gf@±50gf Brick nogging SPST SMD Tactile Switches ROHS |  |  |  |  |  | XUNPU |  |  |  |  | TS-1088-AR02016
 |  |  |  | ATSAMD20G17-MU |  |  | QFN-48(7X7) |  |  | 1 |  |  |  |  |  | ARM MCU, SAM 32 Family SAM D Series Microcontrollers, ARM Cortex-M0+, 32 bit, 48 MHz, 128 KB |  |  |  |  |  | Microchip Technology |  |  |  |  | ATSAMD20G17A-MU
 |  |  |  | TPS62933DRLR |  |  | SOT-583 |  |  | 1 |  |  |  |  |  | Buck Switching Regulator IC Positive Adjustable 0.8V 1 Output 3A SOT-583 |  |  |  |  |  | Texas Instruments |  |  |  |  | TPS62933DRLR
 |  | 35 36 |  | TPRT9080-33GJ5 |  |  | SOT-23-5 |  |  | 1 |  |  |  |  |  | SOT-23-5 Linear Voltage Regulators (LDO) ROHS |  |  |  |  |  | Tech Public |  |  |  |  | TPRT9080-33GJ5
 |  |  |  | ISO7741DWR |  |  | SOIC-16-W |  |  | 1 |  |  |  |  |  | General Purpose Digital Isolator 5000Vrms 4 Channel 100Mbps 85kV/µs CMTI 16-SOIC (0.295", 7.50mm Width) |  |  |  |  |  | Texas Instruments |  |  |  |  | ISO7741DWR
 |  | 37 38 39 |  | ISO7740DWR |  |  | SOIC-16-W |  |  | 3 |  |  |  |  |  | General Purpose Digital Isolator 5000Vrms 4 Channel 100Mbps 85kV/µs CMTI 16-SOIC (0.295", 7.50mm Width) |  |  |  |  |  | Texas Instruments |  |  |  |  | ISO7740DWR
 |  |  |  | B0503S-2WR3 |  |  | SIP-4-7 |  |  | 1 |  |  |  |  |  | Isolated Module DC DC Converter 1 Output 3.3V 400mA 4.5V - 5.5V Input |  |  |  |  |  | Mornsun America, LLC |  |  |  |  | B0503S-2WR3
 |  |  |  |  |  |  |  |  |  | 1 |  |  |  |  |  | PCB |  |  |  |  |  |  |  |  |  |  | OFP_SCM_V1.1_GERBER
 |  | Approved
 |  | Notes
 |  |  | BOM list Bill of Materials for Voltage Input Module
 |  |  | # | Name |  |  |  |  | Footprint |  |  |  |  | Quantity |  |  | Description |  |  |  |  | nufacturer_Na |  |  | Manufacturer_Part_Numbe |  |  |  |  | Unit Price (USD) |  |  |  |  |  | Extended Price (USD) |  |  |  |  |  | MOQ |  |  |  | LT (wks) |  | Remark
 |  |  | 1 | 22nF/100V |  |  |  |  | CAP0603 |  |  |  |  | 6 |  |  | SMD Multilayer Ceramic Capacitor, 22000 pF, 100 V, 0603 [1608 Metric], ± 10%, X7R, AEC-Q200 GCM |  |  |  |  | Murata |  |  | GCM188R72A223KA37D
 |  |  | 2 3 | 51pF/250V |  |  |  |  | CAP0603 |  |  |  |  | 3 |  |  | SMD Multilayer Ceramic Capacitor, 51 pF, 250 V, 0603 [1608 Metric], ± 1%, C0G / NP0, GQM |  |  |  |  | Murata |  |  | GQM1875C2E510FB12D
 |  |  |  | 1500R/0.2A |  |  |  |  | FB0805 |  |  |  |  | 4 |  |  | Ferrite Bead, 0805 [2012 Metric], 1.5 kohm, 200 mA, BLM21B, 0.45 ohm, ± 25% |  |  |  |  | Murata |  |  | BLM21BD152SN1D
 |  |  | 4 | 5.08mm-4P-RA |  |  |  |  | TB_5.08MM_4 Ways_RA |  |  |  |  | 1 |  |  | Terminal Block, Header, 5.08 mm, 4 Ways, 15 A, 300 V, Through Hole Right Angle,male(弯针) |  |  |  |  | HR |  |  | HR2EDGR-5.08-4P
 |  |  | 5 |  |  |  |  |  |  |  |  |  |  | 1 |  |  | Terminal Block, Header, 5.08 mm, 4 Ways, 15 A, 300 V, Through Hole Right Angle,female |  |  |  |  | HR |  |  | HR2EDGK-5.08-4P
 |  |  | 6 | SH_2X12_F |  |  |  |  | BH_24POS_2.5 4_F |  |  |  |  | 1 |  |  | 24 Position Header Connector 0.100" (2.54mm) Through Hole, Right Angle Gold |  |  |  |  | Sullins Connector Solutions/ |  |  | SFH11-PBPC-D12-RA-BK/ connector 2*12p
 |  |  | 7 | 3.5mm-2P-RA |  |  |  |  | TB_3.5MM_2W ays_RA |  |  |  |  | 1 |  |  | Terminal Block, Header, 3.5 mm, 2 Ways, 10 A, 300 V, Through Hole Right Angle |  |  |  |  | Wurth Elektronik |  |  | ’691322110002
 |  |  | 8 9 | 200k |  |  |  |  | RES1206 |  |  |  |  | 12 |  |  | SMD Chip Resistor, 200 kohm, ± 1%, 250 mW, 1206 [3216 Metric], Thick Film, General Purpose |  |  |  |  | Yageo |  |  | RC1206FR-07200KL
 |  |  |  | 1k |  |  |  |  | RES0603 |  |  |  |  | 6 |  |  | SMD Chip Resistor, 1 kohm, ± 1%, 100 mW, 0603 [1608 Metric], Thick Film, General Purpose |  |  |  |  | Yageo |  |  | RC0603FR-071KL
 |  |  |  |  |  |  |  |  |  |  |  |  |  | 1 |  |  | PCB |  |  |  |  |  |  |  | OFP_VIM_V1.1_GERBER
 |  |  | Approved
 |  |  | Notes
BOM list Bill of Materials for Main Controller Module
# |  |  |  | Name | Footprint |  |  |  | Quantity |  |  |  | Description |  |  |  |  |  |  | nufacturer_N |  |  | Manufacturer_Part_Number |  |  |  |  | Unit Price (USD) |  |  |  | Extended Price (USD) |  |  |  |  |  |  |  | MOQ |  |  | LT (wks) |  |  |  | Remark
1 |  |  |  | PIEZO | BUZZER5020 |  |  |  | 1 |  |  |  | 5 mm, 3 Vo-p, 75 dB, Surface Mount (SMT), Magnetic Audio Transducer Buzzer |  |  |  |  |  |  | CUI Devices/ |  |  | CMT-0502-75-SMT-TR/
2 3 |  |  |  | 0.1uF/50V | CAP0402 |  |  |  | 3 |  |  |  | SMD Multilayer Ceramic Capacitor, 0.1 µF, 50 V, 0402 [1005 Metric], ± 10%, X7R, GCM Series |  |  |  |  |  |  | Murata |  |  | GCM155R71H104KE02D
 |  |  |  | 10uF/6.3V | CAP0603 |  |  |  | 9 |  |  |  | SMD Multilayer Ceramic Capacitor, 10 µF, 6.3 V, 0603 [1608 Metric], ± 20%, X5R, GRM Series |  |  |  |  |  |  | Murata |  |  | GRM188R60J106ME47D
4 5 |  |  |  | 1uF/6.3V | CAP0402 |  |  |  | 8 |  |  |  | SMD Multilayer Ceramic Capacitor, 1 µF, 6.3 V, 0402 [1005 Metric], ± 10%, X7R, -55 °C |  |  |  |  |  |  | Murata |  |  | GRM155R70J105KA12J/ GRM155R70J105KA12D
 |  |  |  | 0.1uF/25V | CAP0402 |  |  |  | 18 |  |  |  | SMD Multilayer Ceramic Capacitor, 0.1 µF, 25 V, 0402 [1005 Metric], ± 10%, X7R, -55 °C |  |  |  |  |  |  | Murata |  |  | GRM155R71E104KE14D
6 7 |  |  |  | 4.7uF/6.3V | CAP0402 |  |  |  | 2 |  |  |  | SMD Multilayer Ceramic Capacitor, 4.7 µF, 6.3 V, 0402 [1005 Metric], ± 20%, X5R, GRT |  |  |  |  |  |  | Murata |  |  | GRT155R60J475ME13D
 |  |  |  | 10nF/50V | CAP0402 |  |  |  | 1 |  |  |  | SMD Multilayer Ceramic Capacitor, 10000 pF, 50 V, 0402 [1005 Metric], ± 5%, X7R, GRM Series |  |  |  |  |  |  | Murata |  |  | GRM155R71H103JA88D/ GCM155R71H103JA55D
8 9 |  |  |  | 1nF/50V | CAP0402 |  |  |  | 1 |  |  |  | SMD Multilayer Ceramic Capacitor, 1000 pF, 50 V, 0402 [1005 Metric], ± 5%, C0G / NP0, -55 °C |  |  |  |  |  |  | Murata |  |  | GRM1555C1H102JA01D
 |  |  |  | 18pF/50V | CAP0402 |  |  |  | 4 |  |  |  | SMD Multilayer Ceramic Capacitor, 18 pF, 50 V, 0402 [1005 Metric], ± 5%, C0G / NP0, GJM Series |  |  |  |  |  |  | Murata/ Yageo |  |  | GJM1555C1H180JB01D/ CC0402JRNPO9BN180
10 11 |  |  |  | 12pF/100V | CAP0603 |  |  |  | 1 |  |  |  | SMD Multilayer Ceramic Capacitor, 12 pF, 100 V, 0603 [1608 Metric], ± 1%, C0G / NP0, GCM |  |  |  |  |  |  | Murata |  |  | GCM1885C2A120FA16D/ GCM1885C2A120JA16D
 |  |  |  | 0.1uF/50V | CAP0603 |  |  |  | 17 |  |  |  | SMD Multilayer Ceramic Capacitor, 0.1 µF, 50 V, 0603 [1608 Metric], ± 10%, X7R, GCJ Series |  |  |  |  |  |  | Murata |  |  | GCJ188R71H104KA12D
12 13 |  |  |  | 0.47F/5.5V | SUPCAP_H1 |  |  |  | 1 |  |  |  | 470 mF (EDLC) Supercapacitor 5.5 V Axial, Can - Horizontal 50Ohm @ 1kHz 1000 Hrs @ 70°C |  |  |  |  |  |  | Cornell Dubilier Electronics (CDE)/ wincap |  |  | EDC474Z5R5H/ S-C-EB-5R5-474-M
 |  |  |  | 10uF/50V | CAP1206 |  |  |  | 10 |  |  |  | SMD Multilayer Ceramic Capacitor, 10 µF, 50 V, 1206 [3216 Metric], ± 10%, X5R, GRM Series |  |  |  |  |  |  | Murata |  |  | GRM31CR61H106KA12L
14 15 |  |  |  | 33nF/50V | CAP0603 |  |  |  | 1 |  |  |  | SMD Multilayer Ceramic Capacitor, 0.033 µF, 50 V, 0603 [1608 Metric], ± 10%, X7R, -55 °C |  |  |  |  |  |  | Murata/ Samsung |  |  | GCJ188R71H333KA12D/ CL10B333KB8NNNC
 |  |  |  | 22uF/6.3V | CAP0805 |  |  |  | 4 |  |  |  | SMD Multilayer Ceramic Capacitor, 22 µF, 6.3 V, 0805 [2012 Metric], ± 20%, X5R, -55 °C |  |  |  |  |  |  | Murata |  |  | GRM21BR60J226ME39L
16 17 |  |  |  | 10uF/25V | CAP0603 |  |  |  | 2 |  |  |  | SMD Multilayer Ceramic Capacitor, 10 µF, 25 V, 0603 [1608 Metric], ± 20%, X5R, -55 °C |  |  |  |  |  |  | Murata |  |  | GRM188R61E106MA73D
 |  |  |  | 1uF/50V | CAP0603 |  |  |  | 3 |  |  |  | SMD Multilayer Ceramic Capacitor, 1 µF, 50 V, 0603 [1608 Metric], ± 10%, X5R, GRM Series |  |  |  |  |  |  | Murata |  |  | GRM188R61H105KAALD
18 19 |  |  |  | 10nF/50V | CAP0603 |  |  |  | 3 |  |  |  | SMD Multilayer Ceramic Capacitor, 10000 pF, 50 V, 0603 [1608 Metric], ± 5%, C0G / NP0, GRM Series |  |  |  |  |  |  | Murata |  |  | GRM1885C1H103JA01D
 |  |  |  | 47nF/50V | CAP0603 |  |  |  | 3 |  |  |  | SMD Multilayer Ceramic Capacitor, 47000 pF, 50 V, 0603 [1608 Metric], ± 10%, X7R, GCJ |  |  |  |  |  |  | Murata |  |  | GCJ188R71H473KA12D
20 |  |  |  | 22uF/6.3V | CAP0603 |  |  |  | 6 |  |  |  | SMD Multilayer Ceramic Capacitor, 22 µF, 6.3 V, 0603 [1608 Metric], ± 20%, X5R, GRM Series |  |  |  |  |  |  | Murata |  |  | GRM188R60J226MEA0D
 | 21 |  |  | 82pF/50V | CAP0603 |  |  |  | 1 |  |  |  | SMD Multilayer Ceramic Capacitor, 82 pF, 50 V, 0603 [1608 Metric], ± 5%, C0G / NP0 |  |  |  |  |  |  | Kemet/ Yageo |  |  | C0603C820J5GACAUTO/ CC0603JRNPO9BN820
 | 22 23 |  |  | 22pF/100V | CAP0603 |  |  |  | 5 |  |  |  | SMD Multilayer Ceramic Capacitor, 22 pF, 100 V, 0603 [1608 Metric], ± 1%, C0G / NP0, GCM |  |  |  |  |  |  | Murata |  |  | GCM1885C2A220FA16D/ GCM1885C2A220JA16D
 |  |  |  | 3300pF/50V | CAP0603 |  |  |  | 1 |  |  |  | SMD Multilayer Ceramic Capacitor, 3300 pF, 50 V, 0603 [1608 Metric], ± 10%, X7R, GCM Series |  |  |  |  |  |  | Murata |  |  | GCM188R71H332KA37D
 | 24 25 |  |  | 2.2nF/50V | CAP0603 |  |  |  | 2 |  |  |  | SMD Multilayer Ceramic Capacitor, 2200 pF, 50 V, 0603 [1608 Metric], ± 5%, C0G / NP0, GRM Series |  |  |  |  |  |  | Murata |  |  | GRM1885C1H222JA01D
 |  |  |  | 100uF/6.3V | CAP1206_TA N |  |  |  | 2 |  |  |  | Surface Mount Tantalum Capacitor, 100 µF, 6.3 V, 1206 [3216 Metric], T490 Series, ± 20%, -55 °C |  |  |  |  |  |  | KEMET |  |  | T490A107M006ATE800
 | 26 27 31 |  |  | 33pF/100V | CAP0603 |  |  |  | 5 |  |  |  | SMD Multilayer Ceramic Capacitor, 33 pF, 100 V, 0603 [1608 Metric], ± 5%, C0G / NP0, GCM |  |  |  |  |  |  | Murata |  |  | GCM1885C2A330JA16D
 |  |  |  | 10pF/50V | CAP0603 |  |  |  | 2 |  |  |  | SMD Multilayer Ceramic Capacitor, 10 pF, 50 V, 0603 [1608 Metric], ± 5%, C0G / NP0, -55 °C |  |  |  |  |  |  | Murata |  |  | GRM1885C1H100JA01D
 |  |  |  | 1N4148 | SOD-523 |  |  |  | 1 |  |  |  | Small Signal Diode, Single, 75 V, 300 mA, 1 V, 4 ns |  |  |  |  |  |  | ON Semiconduct or |  |  | 1N4148WT
 | 32 33 |  |  | Red | LED_5MM- RED |  |  |  | 2 |  |  |  | LED, Red, Through Hole, 5mm, 20 mA, 1.8 V, 643 nm |  |  |  |  |  |  | TONYU |  |  | DY-333SDRD-SN- A3(EL)(HF)
 |  |  |  | Red | LED0603-RED |  |  |  | 6 |  |  |  | LED, Red, SMD, 0603, 30 mA, 2 V, 625 nm |  |  |  |  |  |  | Wurth Elektronik |  |  | 150060RS75000
 | 34 35 |  |  | 1N5819 | SOD-123F |  |  |  | 1 |  |  |  | Schottky Rectifier, 40 V, 1 A, Single, SOD-123, 2 Pins, 750 mV |  |  |  |  |  |  | Diodes Incorporated |  |  | 1N5819HW-7-F
 |  |  |  | Green | LED_5MM- GREEN |  |  |  | 2 |  |  |  | 20mA 120mcd -25℃~+80℃ 574nm Green-yellow 30° 60mW 5mm 1.8V~2.4V Plugin,D=5mm Light Emitting Diodes (LED) ROHS |  |  |  |  |  |  | Everlight Elec |  |  | 333-2SYGD/S530-E2-L
 | 36 |  |  | Yellow | LED_5MM- YELLOW |  |  |  | 2 |  |  |  | 20mA 160mcd~300mcd -25℃~+80℃ 592nm Yellow 50° 60mW 5mm 1.8V~2.4V Plugin,D=5mm Light Emitting Diodes (LED) ROHS |  |  |  |  |  |  | Everlight Elec |  |  | 333-2UYD/S530-A3-L
 | 38 |  |  | Yellow | LED0603- Yellow |  |  |  | 2 |  |  |  | LED, 0603, Yellow, SMD, 0603, 20 mA, 2.1 V, 590 nm |  |  |  |  |  |  | ROHM |  |  | SML-D15YWT86C
 | 39 |  |  | MEM2075-00- 140-01-A | MICROSD_M EM2075 |  |  |  | 1 |  |  |  | Memory Card Connector, MicroSD, Push-Push, 9 Contacts, Copper Alloy, Gold Plated Contacts |  |  |  |  |  |  | GCT |  |  | MEM2075-00-140-01-A
 | 40 |  |  | HX0.5-10P XJH2.0 043 | FFC/FPC_10P |  |  |  | 1 |  |  |  | Clamshell 10P Bottom Contact Surface Mount，Right Angle 0.5mm SMD,P=0.5mm FFC/FPC Connectors ROHS |  |  |  |  |  |  | hanxia |  |  | HX0.5-10P XJH2.0 043
 | 41 42 |  |  | MicroUSB-V | USB_MICROU SB_TYPEB_V |  |  |  | 1 |  |  |  | USB Connector, Micro USB Type B, USB 2.0, Receptacle, 5 Ways, Through Hole Mount, Vertical |  |  |  |  |  |  | Wurth Elektronik |  |  | 614105150721
 |  |  |  | FH34SRJ-40S- 0.5SH(50) | FFC/FPC_40P |  |  |  | 1 |  |  |  | FFC / FPC Board Connector, 0.5 mm, 40 Contacts, Receptacle, FH34S, Surface Mount, Bottom |  |  |  |  |  |  | Hirose |  |  | FH34SRJ-40S-0.5SH(50)
 | 43 45 46 |  |  | U.FL-R- SMT_10 | U.FL |  |  |  | 2 |  |  |  | RF / Coaxial Connector, U.FL Coaxial, Straight Jack, Surface Mount Vertical, 50 ohm, Brass |  |  |  |  |  |  | Hirose Connector Foxconn |  |  | U.FL-R-SMT_10/ U.FL-R-SMT/KK23011-32-7H
 |  |  |  | JST-8P | PH_2.5MM_8 Ways |  |  |  | 1 |  |  |  | Pin Header, Wire-to-Board, 2.5 mm, 1 Rows, 6 Contacts, Through Hole, XH Series |  |  |  |  |  |  | JST |  |  | B8B-XH-A (LF)(SN)
 |  |  |  | 6.8uH/3.5A | ETQ(5.5X5) |  |  |  | 1 |  |  |  | 6.8 µH Shielded Drum Core, Wirewound Inductor 3.5 A 72.27mOhm Max 2-SMD, J-Lead |  |  |  |  |  |  | Panasonic |  |  | ETQ-P3M6R8KVP
 | 47 48 |  |  | 4.7uH/2.9A | SRN4018(4X4 ) |  |  |  | 3 |  |  |  | 2.9A 4.7uH ±20% 78mΩ SMD,4x4x3mm Power Inductors ROHS |  |  |  |  |  |  | Bourns |  |  | SMNR4030-4R7MT
 |  |  |  | 1.2uH/3.5A | SRN4018(4X4 ) |  |  |  | 1 |  |  |  | 1.2 µH Shielded Drum Core, Wirewound Inductor 3.5 A 25mOhm Max Nonstandard |  |  |  |  |  |  | Bourns |  |  | SRN4018-4R7M
 | 49 |  |  | 2.2uH/2A | BWVH(2.5X2) |  |  |  | 1 |  |  |  | 2.2 µH Shielded - Inductor 2 A 99mOhm Nonstandard |  |  |  |  |  |  | Yageo |  |  | BWVH002520122R2MH1
 | 51 52 |  |  | 2N2222A | SOT-23 |  |  |  | 1 |  |  |  | Bipolar (BJT) Single Transistor, NPN, 40 V, 600 mA, 300 mW, SOT-23, Surface Mount |  |  |  |  |  |  | Diodes Incorporated |  |  | MMBT2222A-7-F
 |  |  |  | DTC143ZETL | SOT-416 |  |  |  | 4 |  |  |  | Pre-Biased Bipolar Transistor (BJT) NPN - Pre- Biased 50 V 100 mA 250 MHz 150 mW Surface Mount EMT3 |  |  |  |  |  |  | Rohm Semiconduct or |  |  | DTC143ZETL
 | 53 54 |  |  | BC857A | SOT-23 |  |  |  | 2 |  |  |  | Bipolar (BJT) Single Transistor, General Purpose, PNP, 45 V, 100 mA, 250 mW, SOT-23, Surface Mount |  |  |  |  |  |  | NXP |  |  | BC857A,215
 |  |  |  | 2k | RES0402 |  |  |  | 2 |  |  |  | SMD Chip Resistor, 2 kohm, ± 1%, 62.5 mW, 0402 [1005 Metric], Thick Film, General Purpose |  |  |  |  |  |  | Yageo |  |  | RC0402FR-072KL
 | 55 56 |  |  | 240R | RES0402 |  |  |  | 1 |  |  |  | SMD Chip Resistor, 240 ohm, ± 1%, 62.5 mW, 0402 [1005 Metric], Thick Film, General Purpose |  |  |  |  |  |  | Yageo |  |  | RC0402FR-07240RL
 |  |  |  | 200k | RES0402 |  |  |  | 1 |  |  |  | SMD Chip Resistor, 200 kohm, ± 1%, 62.5 mW, 0402 [1005 Metric], Thick Film, General Purpose |  |  |  |  |  |  | Yageo |  |  | RC0402FR-07200KL
 | 57 58 |  |  | 0R | RES0402 |  |  |  | 7 |  |  |  | SMD Chip Resistor, Jumper, 0 ohm, 62.5mW, 0402 [1005 Metric], Thick Film, General Purpose |  |  |  |  |  |  | Yageo |  |  | RC0402FR-070RL
 |  |  |  | 4.7k | RES0402 |  |  |  | 3 |  |  |  | SMD Chip Resistor, 4.7 kohm, ± 1%, 62.5 mW, 0402 [1005 Metric], Thick Film, General Purpose |  |  |  |  |  |  | Yageo |  |  | RC0402FR-074K7L
 | 59 60 |  |  | 47k | RES0402 |  |  |  | 7 |  |  |  | SMD Chip Resistor, 47 kohm, ± 1%, 62.5 mW, 0402 [1005 Metric], Thick Film, General Purpose |  |  |  |  |  |  | Yageo |  |  | RC0402FR-0747KL
 |  |  |  | 5.6k | RES0402 |  |  |  | 1 |  |  |  | SMD Chip Resistor, 5.6 kohm, ± 1%, 62.5 mW, 0402 [1005 Metric], Thick Film, General Purpose |  |  |  |  |  |  | Yageo |  |  | RC0402FR-075K6L
 | 61 62 |  |  | 3.3R | RES0402 |  |  |  | 1 |  |  |  | SMD Chip Resistor, 3.3 ohm, ± 1%, 62.5 mW, 0402 [1005 Metric], Thick Film, General Purpose |  |  |  |  |  |  | Yageo |  |  | RC0402FR-073R3L
 |  |  |  | 10k | RES0402 |  |  |  | 2 |  |  |  | SMD Chip Resistor, 10 kohm, ± 1%, 62.5 mW, 0402 [1005 Metric], Thick Film, General Purpose |  |  |  |  |  |  | Yageo |  |  | RC0402FR-0710KL
 | 63 64 |  |  | 10M | RES0402 |  |  |  | 1 |  |  |  | SMD Chip Resistor, 10 Mohm, ± 1%, 62.5 mW, 0402 [1005 Metric], Thick Film, General Purpose |  |  |  |  |  |  | Walsin/ uniohm |  |  | WR04W1005FTL/ 0402WGF1005TCE
 |  |  |  | 1k | RES0402 |  |  |  | 2 |  |  |  | SMD Chip Resistor, 1 kohm, ± 1%, 62.5 mW, 0402 [1005 Metric], Thick Film, General Purpose |  |  |  |  |  |  | Yageo |  |  | RC0402FR-071KL
 | 65 66 |  |  | 100k | RES0402 |  |  |  | 2 |  |  |  | SMD Chip Resistor, 100 kohm, ± 1%, 63 mW, 0402 [1005 Metric], Thick Film, General Purpose |  |  |  |  |  |  | Yageo |  |  | RC0402FR-07100KL
 |  |  |  | 6.8k | RES0402 |  |  |  | 1 |  |  |  | SMD Chip Resistor, 6.8 kohm, ± 1%, 62.5 mW, 0402 [1005 Metric], Thick Film, General Purpose |  |  |  |  |  |  | Yageo |  |  | RC0402FR-076K8L
 | 67 68 |  |  | 8.2k | RES0402 |  |  |  | 1 |  |  |  | SMD Chip Resistor, 8.2 kohm, ± 1%, 62.5 mW, 0402 [1005 Metric], Thick Film, General Purpose |  |  |  |  |  |  | Yageo |  |  | RC0402FR-078K2P/ RC0402FR-078K2L
 |  |  |  | 11k | RES0402 |  |  |  | 1 |  |  |  | SMD Chip Resistor, 11 kohm, ± 1%, 62.5 mW, 0402 [1005 Metric], Thick Film, General Purpose |  |  |  |  |  |  | Yageo |  |  | RC0402FR-0711KL
 | 69 70 |  |  | 5.1k | RES0603 |  |  |  | 1 |  |  |  | SMD Chip Resistor, 5.1 kohm, ± 1%, 100 mW, 0603 [1608 Metric], Thick Film, General Purpose |  |  |  |  |  |  | Yageo |  |  | RC0603FR-075K1L
 |  |  |  | 120R | RES0603 |  |  |  | 2 |  |  |  | SMD Chip Resistor, 120 ohm, ± 1%, 100 mW, 0603 [1608 Metric], Thick Film, General Purpose |  |  |  |  |  |  | Yageo |  |  | RC0603FR-07120RL
 | 71 72 |  |  | 511k | RES0603 |  |  |  | 1 |  |  |  | SMD Chip Resistor, 511 kohm, ± 1%, 100 mW, 0603 [1608 Metric], Thick Film, Precision |  |  |  |  |  |  | Panasonic/ uniohm |  |  | ERJ-3EKF5113V/ 0603WAF5113T5E
 |  |  |  | 88.7k | RES0603 |  |  |  | 1 |  |  |  | SMD Chip Resistor, 88.7 kohm, ± 1%, 250 mW, 0603 [1608 Metric], Thick Film |  |  |  |  |  |  | Panasonic/ uniohm |  |  | ERJPA3F8872V/ 0603WAF8872T5E
 | 73 74 |  |  | 0R | RES0603 |  |  |  | 10 |  |  |  | SMD Chip Resistor, Jumper, 0 ohm, 100 mW, 0603 [1608 Metric], Thick Film, General Purpose |  |  |  |  |  |  | Yageo |  |  | RC0603FR-070RL
 |  |  |  | 10.2k | RES0603 |  |  |  | 1 |  |  |  | SMD Chip Resistor, 10.2 kohm, ± 1%, 100 mW, 0603 [1608 Metric], Thick Film, General Purpose |  |  |  |  |  |  | Yageo |  |  | RC0603FR-0710K2L
 | 75 76 |  |  | 53.6k | RES0603 |  |  |  | 1 |  |  |  | SMD Chip Resistor, 53.6 kohm, ± 1%, 100 mW, 0603 [1608 Metric], Thick Film, General Purpose |  |  |  |  |  |  | Yageo/ uniohm |  |  | RC0603FR-0753K6L/ 0603WAF5362T5E
 |  |  |  | 49.9R | RES0603 |  |  |  | 2 |  |  |  | SMD Chip Resistor, 49.9 ohm, ± 1%, 100 mW, 0603 [1608 Metric], Thick Film, General Purpose |  |  |  |  |  |  | Yageo |  |  | RC0603FR-0749R9L
 | 77 78 |  |  | 100k | RES0603 |  |  |  | 5 |  |  |  | SMD Chip Resistor, 100 kohm, ± 1%, 100 mW, 0603 [1608 Metric], Thick Film, General Purpose |  |  |  |  |  |  | Yageo |  |  | RC0603FR-07100KL
 |  |  |  | 73.2k | RES0603 |  |  |  | 1 |  |  |  | SMD Chip Resistor, 73.2 kohm, ± 1%, 100 mW, 0603 [1608 Metric], Thick Film, Precision |  |  |  |  |  |  | Panasonic/ uniohm |  |  | ERJ3EKF7322V/ 0603WAF7322T5E
 | 79 80 |  |  | 140k | RES0603 |  |  |  | 1 |  |  |  | SMD Chip Resistor, 140 kohm, ± 1%, 100 mW, 0603 [1608 Metric], Thick Film, Precision |  |  |  |  |  |  | Panasonic/ uniohm |  |  | ERJ3EKF1403V/ 0603WAF1403T5E
 |  |  |  | 20k | RES0603 |  |  |  | 4 |  |  |  | SMD Chip Resistor, 20 kohm, ± 1%, 100 mW, 0603 [1608 Metric], Thick Film, General Purpose |  |  |  |  |  |  | Yageo |  |  | RC0603FR-0720KL
 | 81 82 |  |  | 51k | RES0603 |  |  |  | 3 |  |  |  | SMD Chip Resistor, 51 kohm, ± 1%, 100 mW, 0603 [1608 Metric], Thick Film, General Purpose |  |  |  |  |  |  | Yageo |  |  | RC0603FR-0751KL
 |  |  |  | 10k | RES0603 |  |  |  | 6 |  |  |  | SMD Chip Resistor, 10 kohm, ± 1%, 100 mW, 0603 [1608 Metric], Thick Film, General Purpose |  |  |  |  |  |  | Yageo |  |  | RC0603FR-0710KL
 | 83 84 |  |  | 45.3k | RES0603 |  |  |  | 1 |  |  |  | SMD Chip Resistor, 45.3 kohm, ± 1%, 100 mW, 0603 [1608 Metric], Thick Film, General Purpose |  |  |  |  |  |  | Yageo |  |  | RC0603FR-0745K3L
 |  |  |  | 30k | RES0603 |  |  |  | 2 |  |  |  | SMD Chip Resistor, 30 kohm, ± 1%, 100 mW, 0603 [1608 Metric], Thick Film, General Purpose |  |  |  |  |  |  | Yageo |  |  | RC0603FR-0730KL
 | 85 86 |  |  | 37.4k | RES0603 |  |  |  | 1 |  |  |  | SMD Chip Resistor, 37.4 kohm, ± 1%, 100 mW, 0603 [1608 Metric], Thick Film, General Purpose |  |  |  |  |  |  | Yageo |  |  | RC0603FR-0737K4L
 |  |  |  | 51R | RES0603 |  |  |  | 1 |  |  |  | SMD Chip Resistor, 51 ohm, ± 5%, 100 mW, 0603 [1608 Metric], Thick Film, General Purpose |  |  |  |  |  |  | Yageo |  |  | RC0603JR-0751RL
 | 87 88 |  |  | 1k | RES0603 |  |  |  | 10 |  |  |  | SMD Chip Resistor, 1 kohm, ± 1%, 100 mW, 0603 [1608 Metric], Thick Film, General Purpose |  |  |  |  |  |  | Yageo |  |  | RC0603FR-071KL
 |  |  |  | 2k | RES0603 |  |  |  | 2 |  |  |  | SMD Chip Resistor, 2 kohm, ± 1%, 100 mW, 0603 [1608 Metric], Thick Film, General Purpose |  |  |  |  |  |  | Yageo |  |  | RC0603FR-072KL
 | 89 90 92 |  |  | 5R1 | RES0603 |  |  |  | 1 |  |  |  | SMD Chip Resistor, 5.1 ohm, ± 1%, 100 mW, 0603 [1608 Metric], Thick Film, General Purpose |  |  |  |  |  |  | Yageo |  |  | RC0603FR-075R1L
 |  |  |  | 2.2k | RES0603 |  |  |  | 2 |  |  |  | SMD Chip Resistor, 2.2 kohm, ± 1%, 100 mW, 0603 [1608 Metric], Thick Film, General Purpose |  |  |  |  |  |  | Yageo |  |  | RC0603FR-072K2L
 |  |  |  | 22R | RES0603 |  |  |  | 7 |  |  |  | SMD Chip Resistor, 22 ohm, ± 1%, 100 mW, 0603 [1608 Metric], Thick Film, General Purpose |  |  |  |  |  |  | Yageo |  |  | RC0603FR-0722RL
 | 94 97 98 |  |  | 47k | RES0603 |  |  |  | 1 |  |  |  | SMD Chip Resistor, 47 kohm, ± 1%, 100 mW, 0603 [1608 Metric], Thick Film, General Purpose |  |  |  |  |  |  | Yageo |  |  | RC0603FR-0747KL
 |  |  |  | 4.7k | RES0603 |  |  |  | 5 |  |  |  | SMD Chip Resistor, 4.7 kohm, ± 1%, 100 mW, 0603 [1608 Metric], Thick Film, General Purpose |  |  |  |  |  |  | Yageo |  |  | RC0603FR-074K7L
 |  |  |  | 2.7k | RES0402 |  |  |  | 1 |  |  |  | SMD Chip Resistor, 2.7 kohm, ± 1%, 62.5 mW, 0402 [1005 Metric], Thick Film, General Purpose |  |  |  |  |  |  | Yageo |  |  | RC0402FR-072K7L
 | 99 100 |  |  | TS-1088 | SWITCH- 2(3X4X2) |  |  |  | 2 |  |  |  | NO 50mA 100MΩ 100000 Times 12V 160gf@±50gf Brick nogging SPST SMD Tactile Switches ROHS |  |  |  |  |  |  | XUNPU |  |  | TS-1088-AR02016
 |  |  |  | 6mm*6mm | SWITCH- SMD(6X6) |  |  |  | 4 |  |  |  | Tactile Switch SPST-NO Top Actuated Surface Mount |  |  |  |  |  |  | E-Switch |  |  | TL3301FF160QG
 |  |  |  | 6mm*6mm*12m m | SWITCH- SMD(6X6X12) |  |  |  | 4 |  |  |  | 6mm 12mm Round Button 50mA Brick nogging 6mm SPST 12V SMD,6x6mm Tactile Switches ROHS |  |  |  |  |  |  | XUNPU |  |  | TS-1002S-12026C
 | 102 |  |  | SLESD5451X | DFN1006-2 |  |  |  | 11 |  |  |  | DFN1006 Electrostatic and Surge Protection (TVS/ESD) ROHS |  |  |  |  |  |  | Slkor |  |  | SLESD5451X
 | 103 |  |  | 4.7V | SOD-323F |  |  |  | 1 |  |  |  | TVS Diode Unidirectional, 4.7 V, SOD-323F, 2 Pins |  |  |  |  |  |  | Way On |  |  | WS4.5D3HV
 | 104 105 |  |  | V3s | LQFP-128 |  |  |  | 1 |  |  |  | LQFP-128-EP(14x14) Microcontroller Units (MCUs/MPUs/SOCs) ROHS |  |  |  |  |  |  | Allwinner Tech |  |  | V3s
 |  |  |  | W25Q128JVEI Q | WSON-8(6X8) |  |  |  | 1 |  |  |  | FLASH - NOR Memory IC 128Mbit SPI - Quad I/O, QPI, DTR 133 MHz 8-WSON (8x6) |  |  |  |  |  |  | Winbond |  |  | W25Q128JVEIQ
 | 106 107 |  |  | PCF8563T | SOIC-8 |  |  |  | 1 |  |  |  | Calendar, Clock IC, Format (YYYY:MM:WK:DD:hh:mm:ss/Binary), I2C, 1 V to 5.5 V supply, SOIC-8 |  |  |  |  |  |  | NXP |  |  | PCF8563T/5,518
 |  |  |  | CH340C | SOIC-16 |  |  |  | 1 |  |  |  | Interface Bridges, USB to UART, 3 V, 3.6 V, QFN, 24 Pins, -40 °C |  |  |  |  |  |  | WCH(Jiangs u Qin Heng) |  |  | CH340C
 | 108 109 |  |  | TPS62933DRL R | SOT-583 |  |  |  | 1 |  |  |  | Buck Switching Regulator IC Positive Adjustable 0.8V 1 Output 3A SOT-583 |  |  |  |  |  |  | Texas Instruments |  |  | TPS62933DRLR
 |  |  |  | TPS65261RHB R | VQFN-32 |  |  |  | 1 |  |  |  | Buck Switching Regulator IC Positive Adjustable 0.6V 3 Output 3A, 2A 32-VFQFN Exposed Pad |  |  |  |  |  |  | Texas Instruments |  |  | TPS65261RHBR
 | 110 111 |  |  | TPS563202DRL R | SOT-563 |  |  |  | 1 |  |  |  | Buck Switching Regulator IC Positive Adjustable 0.806V 1 Output 3A SOT-563, SOT-666 |  |  |  |  |  |  | Texas Instruments |  |  | TPS563202DRLR
 |  |  |  | XC6206P302M R-G | SOT-23 |  |  |  | 1 |  |  |  | LDO Voltage Regulator, Fixed, 1.8 V to 6 V in, 250 mV Drop, 3 V/200 mA out, SOT-23-3 |  |  |  |  |  |  | Torex Semiconduct or Ltd |  |  | XC6206P302MR-G
 | 112 |  |  | NS2009 | MSOP-10 |  |  |  | 1 |  |  |  | MSOP-10 Touch Screen Controllers ROHS |  |  |  |  |  |  | Shenzhen Nsiway Tech |  |  | NS2009
 | 113 |  |  | PT4103B23F | SOT-23-6 |  |  |  | 1 |  |  |  | SOT-23-6 LED Drivers ROHS |  |  |  |  |  |  | PowTech |  |  | PT4103B23F
 | 114 115 |  |  | EC21EFA-512- STD | EC21EFA-512- STD |  |  |  | 1 |  |  |  | Cellular GSM, LTE, WCDMA Transceiver Module Antenna Not Included Card Edge |  |  |  |  |  |  | Quectel |  |  | EC21EFA-512-STD
 |  |  |  | TXS0108EPWR | TSSOP-20 |  |  |  | 1 |  |  |  | Voltage Level Translator, Bidirectional, 8 Input, 620 µA, 4.8 ns, 1.2 V to 5.5 V, TSSOP-20 |  |  |  |  |  |  | Texas Instruments |  |  | TXS0108EPWR
 |  |  |  | FE8.1 | TSSOP-16 |  |  |  | 1 |  |  |  | FE8.1 USB2.0 High Speed 4 port hub controller |  |  |  |  |  |  | Terminus |  |  | FE8.1
 | 117 118 |  |  | PCA9557PW,1 18 | TSSOP-16 |  |  |  | 1 |  |  |  | I/O Expander, 8 bit, I2C, SMBus, 2.3 V, 5.5 V, TSSOP, 16 Pins |  |  |  |  |  |  | NXP Semiconduct ors |  |  | PCA9557PW,118
 |  |  |  | 24MHz | SMD- 4(3.2X2.5) |  |  |  | 1 |  |  |  | Crystal, 24 MHz, SMD, 3.2mm x 2.5mm, 10 ppm, 12 pF, 10 ppm, ABM8 |  |  |  |  |  |  | Abracon LLC |  |  | ABM8-24.000MHZ-12-B1U-T
 | 119 |  |  | 32.768kHz | SMD- 2(3.2X1.5) |  |  |  | 2 |  |  |  | 32.768 kHz ±20ppm Crystal 12.5pF 70 kOhms 2- SMD, No Lead |  |  |  |  |  |  | Citizen FineDevice |  |  | CM315D32768DZFT
 | 120 |  |  | 12MHz | SMD- 4(3.2X2.5) |  |  |  | 1 |  |  |  | Crystal, 12 MHz, SMD, 3.2mm x 2.5mm, 50 ppm, 18 pF, 20 ppm, ABM8 |  |  |  |  |  |  | Abracon LLC |  |  | ABM8-12.000MHZ-B2-T
 |  |  |  |  |  |  |  |  | 1 |  |  |  | PCB |  |  |  |  |  |  |  |  |  | MCM_V1.1
 | Approved
 | Notes
 |  | BOM list |  |  |  |  |  |  |  |  |  | Bill of Materials for U-Sub Module
 |  | # |  | Name |  | Footprint |  |  |  |  |  | Quantity |  |  | Description |  |  |  |  |  | Manufacturer_Nam |  |  | Manufacturer_Part_Number |  |  |  |  | Unit Price (USD) |  |  |  |  | Extended Price (USD) |  |  |  |  |  |  | MOQ |  |  |  | LT (wks) |  |  |  |  | Remark
 |  | 1 |  | 0.1uF/50V |  | CAP0603 |  |  |  |  |  | 1 |  |  | SMD Multilayer Ceramic Capacitor, 0.1 µF, 50 V, 0603 [1608 Metric], ± 10%, X7R, GCJ Series |  |  |  |  |  | Murata |  |  | GCJ188R71H104KA12D
 |  | 2 |  | 33pF/100V |  | CAP0603 |  |  |  |  |  | 3 |  |  | SMD Multilayer Ceramic Capacitor, 33 pF, 100 V, 0603 [1608 Metric], ± 5%, C0G / NP0, GCM |  |  |  |  |  | Murata |  |  | GCM1885C2A330JA16D
 |  | 3 |  | Red |  | LED0603-RED |  |  |  |  |  | 1 |  |  | LED, Red, SMD, 0603, 30 mA, 2 V, 625 nm |  |  |  |  |  | Wurth Elektronik |  |  | 150060RS75000
 |  | 4 |  | 6V/350mA |  | FUSE0805 |  |  |  |  |  | 1 |  |  | Resettable Fuse, PPTC, 0805 (2012 Metric), SMD0805 Series, 6 VDC, 350 mA, 750 mA, 0.1 s |  |  |  |  |  | Yageo |  |  | SMD0805B035TF
 |  | 5 |  | SIM7100-6-1-15-00-A |  | SIMCARD-MICRO |  |  |  |  |  | 1 |  |  | Memory Card Connector, Micro SIM, Push-Push, 6 Contacts, Phosphor Bronze, Gold Plated Contacts |  |  |  |  |  | Hanbo Electronic |  |  | SMO-1560-P7
 |  | 6 |  | USB2.0-TypeA-SMD |  | USB_USB2.0_TYPEA_S MD |  |  |  |  |  | 1 |  |  | 1.5A USB 2.0 1 260℃ Surface Mount，Right Angle 4P Female -20℃~+70℃ Type-A SMD USB Connectors ROHS |  |  |  |  |  | XUNPU |  |  | USB-234-BCW
 |  | 7 |  | HX0.5-10P XJH2.0 043 |  | FFC/FPC_10P |  |  |  |  |  | 1 |  |  | Clamshell 10P Bottom Contact Surface Mount，Right Angle 0.5mm SMD,P=0.5mm FFC/FPC Connectors ROHS |  |  |  |  |  | hanxia |  |  | HX0.5-10P XJH2.0 043
 |  | 8 |  | 15k |  | RES0603 |  |  |  |  |  | 1 |  |  | SMD Chip Resistor, 15 kohm, ± 1%, 100 mW, 0603 [1608 Metric], Thick Film, General Purpose |  |  |  |  |  | Yageo |  |  | RC0603FR-0715KL
 |  | 9 |  | 22R |  | RES0603 |  |  |  |  |  | 3 |  |  | SMD Chip Resistor, 22 ohm, ± 1%, 100 mW, 0603 [1608 Metric], Thick Film, General Purpose |  |  |  |  |  | Yageo |  |  | RC0603FR-0722RL
 |  | 10 |  | 1k |  | RES0603 |  |  |  |  |  | 1 |  |  | SMD Chip Resistor, 1 kohm, ± 1%, 100 mW, 0603 [1608 Metric], Thick Film, General Purpose |  |  |  |  |  | Yageo |  |  | RC0603FR-071KL
 |  | 11 |  | SLESD5451X |  | DFN1006-2 |  |  |  |  |  | 1 |  |  | DFN1006 Electrostatic and Surge Protection (TVS/ESD) ROHS |  |  |  |  |  | Slkor |  |  | SLESD5451X
 |  | 12 |  | ESD9B5VL |  | DFN1006-2 |  |  |  |  |  | 2 |  |  | DFN1006 Electrostatic and Surge Protection (TVS/ESD) ROHS |  |  |  |  |  | TECH PUBLIC |  |  | ESD9B5VL
 |  | 13 |  | ESDA6V8AV6 |  | SOT-563 |  |  |  |  |  | 1 |  |  | SOT-563 Electrostatic and Surge Protection (TVS/ESD) ROHS |  |  |  |  |  | TECH PUBLIC |  |  | ESDA6V8AV6
 |  | 14 |  |  |  |  |  |  |  |  |  | 1 |  |  |  |  |  |  |  |  | pcb |  |  | USM_V1.0
 |  | Approved
 |  | Notes
Mechanical BOBill of Materials for Mechanical Part MSM
# |  |  |  | Name |  |  |  |  |  |  | Description |  |  |  |  |  |  | Quantity | Manufacturer_Nam |  |  |  |  | Manufacturer_Part_Number |  |  |  |  |  |  |  |  |  |  | Unit Price (USD) |  |  | Extended Price (USD) |  |  |  |  |  | MOQ |  | LT (wks) |  |  | Remark
1 |  |  |  | Front Plastic Case |  |  |  |  |  |  | Front Plasctic Case , Dimension 154.5mm x 137mm |  |  |  |  |  |  | 1 | Chin Mah Plastic Industries |  |  |  |  | CSE0000001-1
2 3 |  |  |  | Rear Plastic Case |  |  |  |  |  |  | Rear Plastic Case , Dimension 114.5mm x 124.5mm |  |  |  |  |  |  | 1 | Chin Mah Plastic Industries |  |  |  |  | CSE0000002-1
 |  |  |  | Body Plastic Case |  |  |  |  |  |  | Body Plastic Case , Dimension 114.5mm x 124.5mm |  |  |  |  |  |  | 1 | Chin Mah Plastic Industries |  |  |  |  | CSE0000003-1
4 5 |  |  |  | Bracket LCD Plastic Case |  |  |  |  |  |  | Bracket LCD Plastic Case |  |  |  |  |  |  | 1 | Chin Mah Plastic Industries |  |  |  |  | CSE0000004-1
 |  |  |  | Micro SDCard 8GB |  |  |  |  |  |  | Micro SDCard 8GB |  |  |  |  |  |  | 1 | KingSton Technology |  |  |  |  | Micro SDCard 8GB
6 7 |  |  |  | FPC-40P-Extender |  |  |  |  |  |  | 40P |  |  |  |  |  |  | 1 | China |  |  |  |  | FPC-40P-Extender
 |  |  |  | FPC-40P-Cable |  |  |  |  |  |  | * 10厘米（100mm） * 40Pin（10条） * 0．5mm * 同向/A型 |  |  |  |  |  |  | 1 | China |  |  |  |  | FPC-40P-Cable
8 9 |  |  |  | FPC-10P-Cable |  |  |  |  |  |  | * 10厘米（100mm） * 10Pin（10条） * 0．5mm * 反向/B型 |  |  |  |  |  |  | 1 | China |  |  |  |  | FPC-10P-Cable
 |  |  |  | XH-2.54-8P-Cable |  |  |  |  |  |  | * 15cm(22号硅胶高温线） * 8P（10条） * 双头（同向） |  |  |  |  |  |  | 1 | China |  |  |  |  | XH-2.54-8P-Cable
10 11 |  |  |  | Antenna Extender |  |  |  |  |  |  | *1代IPEX转SMA母头内针 *0.2m |  |  |  |  |  |  | 2 | China |  |  |  |  | Antenna Extender
 |  |  |  | 4G Antenna |  |  |  |  |  |  | *R款 6DBI 20cm(黑色可折叠) *SMA内孔 |  |  |  |  |  |  | 2 | China |  |  |  |  | 4G Antenna
12 |  |  |  | 5MM-LEDTUBE |  |  |  |  |  |  | φ5 高度（2~3.5） 1千只 (记得与厂家备注 2mm 高度） |  |  |  |  |  |  | 4 | China |  |  |  |  | 5MM-LEDTUBE
13 14 |  |  |  | 5inch RGB LCD Display |  |  |  |  |  |  |  |  |  |  |  |  |  | 1 | 5inch RGB LCD Display |  |  |  |  | 5inch RGB LCD Display
 |  |  |  |  |  |  |  |  |  |  |  |  |  |  |  |  |  | 4 |  |  |  |  |  | Hex Head m5 x 12mm
15 16 |  |  |  |  |  |  |  |  |  |  |  |  |  |  |  |  |  | 4 |  |  |  |  |  | PMS+ 3x4.5 W7 TZN
 |  |  |  |  |  |  |  |  |  |  |  |  |  |  |  |  |  | 4 |  |  |  |  |  | PMS+ 3x8 W7 TZN
17 18 |  |  |  |  |  |  |  |  |  |  |  |  |  |  |  |  |  | 8 |  |  |  |  |  | PMS+ 3x6 W7 TZN
 |  |  |  |  |  |  |  |  |  |  |  |  |  |  |  |  |  | 1 |  |  |  |  |  | Carton Box
 | 19 20 |  |  |  |  |  |  |  |  |  |  |  |  |  |  |  |  | 1 |  |  |  |  |  | Label
 |  |  |  | Power Supply |  |  |  |  |  |  |  |  |  |  |  |  |  | 1 | Mean Well |  |  |  |  | RS-15-12
 | 21
 | Approved
 | Notes
