eSpark-Backup/nabilfesal-smartmeter-hw/Enclosure-Files/Multichannel Smart Meter (MSM)-20251015T050852Z-1-001/Multichannel Smart Meter (MSM)/MSM Final Version V1 141025/MSM BoM/MSM BoM with Reamrks updated.xlsx

Multi Channel Smart Meter BoM
Item No. | Part Name | Material | Quantity | Description | Supplier Link | MOKO Question 1 | Datasheet URL | eSpark's Response 1 | MOKO Question 2 | eSpark's Response 2 | MOKO Question 3 | eSpark's Response 3
1 | Front Panel | PC+ABS UL94 -V0 | 1 | Front face with display, button, LED, USB connector, and SD card slot cutouts. |  | Please confirm following specfication if works for you? Material: ABS+PC3100 Surface finish: Glossy Gating system: Conventional gate Color: pls provide the Pantone or CMYK code |  | _Material will be (abs +PC UL94 -V0) _Surface finish will be glossy but we need SPI Chart from your side to be confirm. _ Gating system will be conventional but suggest us which best for our product. _CMYk will be C = 0, M = 0, Y = 0, K = 100. |  |  | Pls confirm following update specification based on paysical samples: Material: ABS+PC3100 Surface finish: Glossy Gating system: Conventional gate Printing: Screen printing | Material would be the as same the sample you have right now.The Sample will be Just Use for the Material purpose and Text Visualisation Only but You need to stick on the deliverables files for other calculations.
2 | Main Enclosure | PC+ABS UL94 -V1 | 1 | Main housing with internal mounts. |  | Please confirm following specfication if works for you? Material: ABS+PC3100 Surface finish: Glossy Gating system: Conventional gate Color: pls provide the Pantone or CMYK code |  | _Material will be (abs +PC UL94 -V0) _Surface finish will be glossy but we need SPI Chart from your side to be confirm. _ Gating system will be conventional but suggest us which best for our product. _CMYk will be C = 0, M = 0, Y = 0, K = 100.
3 | Rear Cover | PC+ABS UL94 -V2 | 1 | Back cover with connector cutout. |  | Please confirm following specfication if works for you? Material: ABS+PC3100 Surface finish: Glossy Gating system: Conventional gate Color: pls provide the Pantone or CMYK code |  | _Material will be (abs +PC UL94 -V0) _Surface finish will be glossy but we need SPI Chart from your side to be confirm. _ Gating system will be conventional but suggest us which best for our product. _CMYk will be C = 0, M = 0, Y = 0, K = 100.
4 | LCD Mounting Bracket | PC+ABS UL94 -V3 | 1 | Supports Rear Side of LCD, Ensures Secure Fixing Inside Multi Channel Smart Meter. |  | Please confirm following specfication if works for you? Material: ABS+PC3100 Surface finish: Glossy Gating system: Conventional gate Color: pls provide the Pantone or CMYK code |  | _Material will be (abs +PC UL94 -V0) _Surface finish will be glossy but we need SPI Chart from your side to be confirm. _ Gating system will be conventional but suggest us which best for our product. _CMYk will be C = 0, M = 0, Y = 0, K = 100.
5 | M3-4.2mm(OD)-3mm length Brass Insert | Brass | 4 | M3-4.2mm(OD)-3mm length Brass Insert for LCD Mounting Bracket | M3,4.2,3mm (https://www.aliexpress.com/item/1005007640664497.html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)
6 | M3-4mm Machine Screw Phillips | Stainless steel | 8 | M3-4mm Length screw for LCD Mounting Bracket. | M3-4mm (https://www.aliexpress.com/item/1005008080704441.html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) | PM 3.0*4.0mm 304 stainless steel Salt Spray Resistance Approx. 48H, Natural Color Chinese brand. pls confirm if okay? | datasheet (http://oss.mokotechnology.com/uploads/20250417/1744859006982_PM3X4.png) | Confirmed
7 | M3-8mm Screw Self Tapping Phillips | Stainless steel | 4 | M3-8mm Length screw for Front Panel PCB. | M3-8mm (https://www.aliexpress.com/item/1005008654649644.html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) | PA 3.0*8.0mm 304 stainless steel Chinese brand. pls confirm if okay? | datasheet (http://oss.mokotechnology.com/uploads/20230606/25847/fdf13451ee934d8bb192aeeea5c12b06/%E8%9E%BA%E4%B8%9DM3x8%20%20%E5%8D%81%E5%AD%97%E5%9C%86%E5%A4%B4%E8%87%A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) | Confirmed
8 | M3-10mm Countersunk Self Tapping Screw Phillips | Stainless steel | 4 | M3-10mm Countersunk Self Tapping Screw Phillips for Rear Panel. | M3-10mm Countersunk (https://www.aliexpress.com/item/1005008611935228.html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) | PA 3.0*10mm 304 stainless steel Chinese brand. pls confirm if okay? | pls see the datasheet in attachment | Confirmed
9 | M3-8mm Screw Self Tapping Phillips | Stainless steel | 4 | M3-8mm Length screw for Main Enclouser PCB. | M3-4mm (https://www.aliexpress.com/item/1005008654649644.html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) | PA 3.0*8.0mm 304 stainless steel Chinese brand. pls confirm if okay? | datasheet (http://oss.mokotechnology.com/uploads/20230606/25847/fdf13451ee934d8bb192aeeea5c12b06/%E8%9E%BA%E4%B8%9DM3x8%20%20%E5%8D%81%E5%AD%97%E5%9C%86%E5%A4%B4%E8%87%A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) | Confirmed
10 | M5 Plain Washer | Stainless steel | 4 | M5 Plain washer for MSM Mounting. | Plain washer (https://www.amazon.com/Stainless-Washers-Corrosion-Resistant-Screws/dp/B0D44NL9QL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) | M5 plain washer 304 stainless steel Chinese brand. pls confirm if okay? | pls see the datasheet in attachment | Confirmed
11 | M5 Split Lock Washer | Stainless steel | 4 | M5 Split Lock Washer for MSM Mounting. | Lock Washer (https://www.amazon.com/ZAYI-Stainless-Spring-Washers-Elastic/dp/B09TSRW38Y) | M5 lock washer 304 stainless steel Chinese brand. pls confirm if okay? | pls see the datasheet in attachment | Confirmed
12 | M5 Nut | Stainless steel | 4 | M5 Nut for MSM Mounting. | M5 Nut (https://www.aliexpress.com/item/1005007593861199.html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) | M5.0*4.0mm 304 stainless steel Chinese brand. pls confirm if okay? | datasheet (http://oss.mokotechnology.com/uploads/20220519/105507/2638b741312c4befa1105e9a2ecfbc03/M5%E5%85%AD%E8%A7%92%E8%9E%BA%E6%AF%8D.png) | Confirmed
13 | M5 BOLT | Stainless steel | 4 | M5 - 12mm BOLT for MSM Mounting. | M5 BOLT (https://www.aliexpress.com/item/1005006090579821.html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) | M2*12 304 stainless steel Chinese brand. pls confirm if okay? | datasheet (http://oss.mokotechnology.com/uploads/20250423/1745398396471_%E5%85%AD%E8%A7%92%E8%9E%BA%E6%9D%86%20M2X12.png) | Confirmed
 | INNER BOX |  | 1 |  |  | Is this for outer box not inner box? pls confirm following specification if works for you? Flat size: 2086*1116MM Material: K=K with Reinforced Core Printing: No printing Quantity: How many folding boxes (inner boxes) fit into one outer box? | Dimension for Inner BOX | This is Inner Box with No Prinitng Material will be KK and each outer box contians one Inner Box. |  |  | Pls confirm following update specification based on paysical samples: Inner folding box Flat size: 830*440mm Material: S6S Printing: No printing kindly provide a detailed PDF with dimensions (similar to the one you shared for the Fault Indicator Ard-X project) for reference. | Please Use the Same Inner Box as the Sample you have right now for further calculation, we have converted the sample into our design format, you can carried out all the Information such as Dimension from the Sample Inner Box.
 | OUTER BOX |  | 1 |  |  | Is this for inner box not outer box? pls confirm following specification if works for you? Folding box Size:328*218*187.5MM Printing: Top surface printing | Dimension for Outer Box | This is for Outer Box. Folding Yes, Size is same as the deisgn file shared with you with TOP Printing. |  |  | kindly provide a detailed PDF with dimensions (similar to the one you shared for the Fault Indicator Ard-X project) for reference. | Please use the same outer box (Sample), We have replicate the the Sample design. Right now we can follow the sample but this will have the prinitng of Logo on Top Surface of the Box the logo file has been shared already with you.
 | Back Cover Label |  | 1 |  |  | Please confirm following specfication if works for you? PC Cover: 123.5×113.5×3.0mm, hardened & scratch-resistant, screen printed with cutouts. |  | Material is same. Dimension is Okay. Confirmed |  |  | Receommend similar material based on psysical sample, pls confirm if okay? Material: Silver Dragon 100 Art Paper Printing: 4C (CMYK) printing Coating: Gloss lamination Size: 122*113mm | Confirmed
 | Main Enlouser Label |  | 1 |  |  | Self-Adhesive PVC Label | Size: 90mm × 70mm | White background with Black Printing, pls confirm if okay? |  | Grey with Black printing | Self-Adhesive PVC Label Size: 90mm × 70mm Grey background with Black Printing | Confirmed | Receommend similar material based on psysical sample, pls confirm if okay? Material: Silver Dragon 100 Art Paper Printing: 4C (CMYK) printing Coating: Gloss lamination Size: 84*67mm | Confirmed
 | QC Label |  | 1 |  |  | Art Paper Label | Size: 80mm ×60mm | White background with Black Printing, pls confirm if okay? |  | Confirmed
 | SERIAL Number Label |  | 1 |  |  | Art Paper Label | Size: 70mm × 30mm | White background with Black Printing, pls confirm if okay? |  | Confirmed |  |  | To avoid further mistake please re-confirm: White background with Black Printing And please provide the serial number at your convenience | White background with Black Printing
 | Front Panel Text Printing |  | 1 |  |  | Front Panel Text will be done by Screen Printing, Previously it was engraved in the model. |  |  | Pls confirm following specification: Material: Optical-grade PC Size: 54.5*137.7MM Backing: 3M 9080A Adhesive | If we will use the Material: Optical - grade PC then It will be like pasting of Sticker. Our Main Goal is Viualise the TEXT Only, Can you please share Some example with the same material you are reffereing for? | Reference psysical samples this printing text no need quote separately, which includes in Front Panel | Confirmed
