eSpark-Backup/nabilfesal-smartmeter-hw/Design-Files/OFP_CIM_v1.5/Deliverables/_Supporting Files/OFP_CIM_v1.5.step

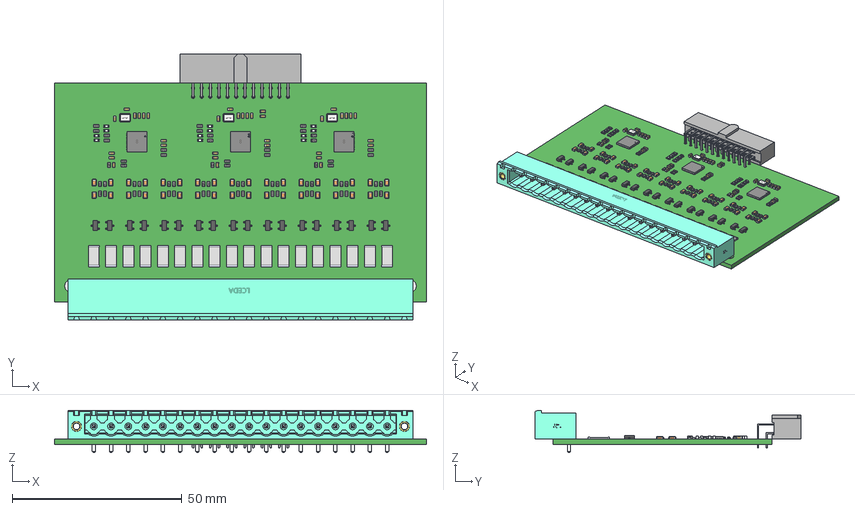
[picture p86: CAD file, 2025-03-27]
Design-Files/OFP_CIM_v1.5/Deliverables/_Supporting Files/OFP_CIM_v1.5.step
109.5 x 78.3 x 12.5 mm
User Library-User Library-Siward_SX3225 x 3
User Library-RESC1608X05N x 63
CircuitWorks-RESISTOR 2512 x 18
User Library-LED SMD0603 x 12
SFH11-_ _ _C-D12-RA-_ __RGB8421504
CircuitWorks-SOT-23 x 18
User Library-CAPC1608X09 x 35
User Library-0805 SMD Capacitor x 36
