eSpark-Backup/nabilfesal-smartmeter-hw/Design-Files/OFP_USM_v1.5/Deliverables/Supporting Files/OFP_USM_v1.5.step

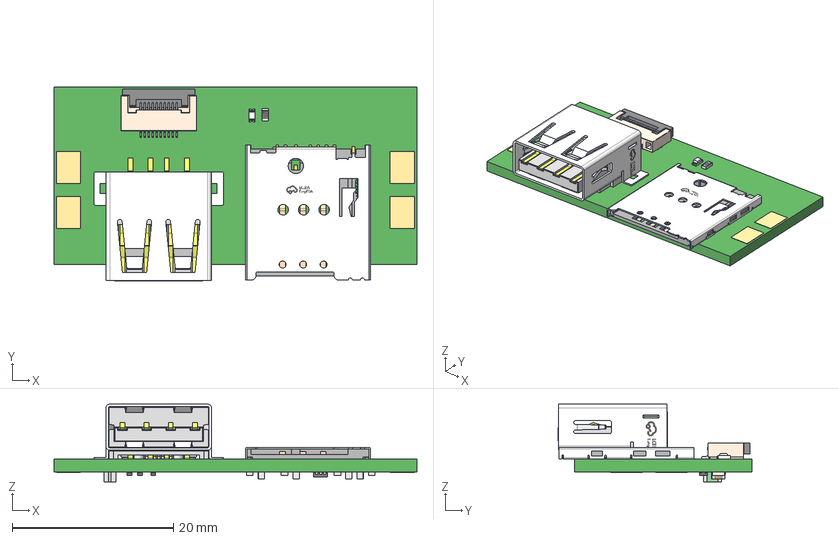
[picture p87: CAD file, 2025-03-10]
Design-Files/OFP_USM_v1.5/Deliverables/Supporting Files/OFP_USM_v1.5.step
45.0 x 24.1 x 9.65 mm
User Library-RESC1608X05N x 5
User Library-LED SMD0603
User Library-fuse0805L050WR
SOD882 body x 3
SOD882A3 singulated LF unit x 3
SOT_X-T1-GE3_VIS
User Library-CAPC1608X09 x 4
Extruded x 4
