eSpark-Backup/nabilfesal-smartmeter-hw/Design-Files/OFP_VIM_DC_v1.51/Deliverables/Supporting Files/OFP_VIM_DC_v1.51.step

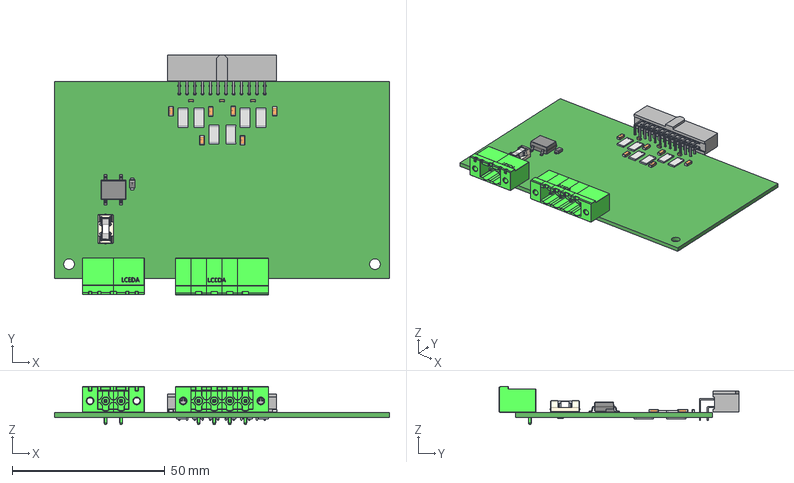
[picture p88: CAD file, 2025-06-13]
Design-Files/OFP_VIM_DC_v1.51/Deliverables/Supporting Files/OFP_VIM_DC_v1.51.step
109.5 x 78.3 x 12.5 mm
User Library-SOD123W
SFH11-_ _ _C-D12-RA-_ __RGB8421504
CircuitWorks-RESISTOR 2512 x 18
User Library-1206 SMD Capacitor x 6
User Library-CAPC1608X09 x 3
