eSpark-Backup/nabilfesal-smartmeter-hw/Design-Files/OFP_VIM_v1.51/Deliverables/Supporting Files/OFP_VIM_v1.51.step

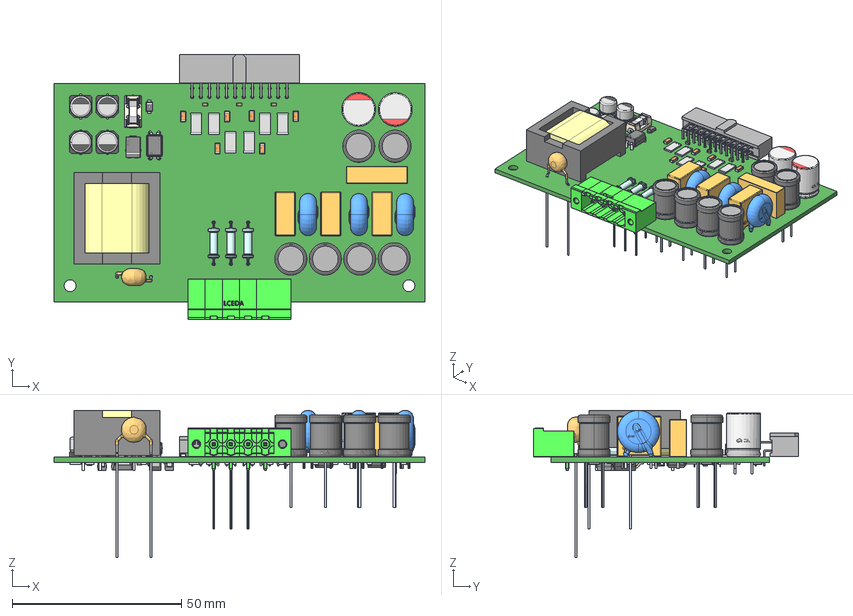
[picture p89: CAD file, 2025-03-27]
Design-Files/OFP_VIM_v1.51/Deliverables/Supporting Files/OFP_VIM_v1.51.step
109.5 x 78.3 x 43.5 mm
SFH11-_ _ _C-D12-RA-_ __RGB8421504
CircuitWorks-RESISTOR 2512 x 19
User Library-RESC1608X05N x 6
User Library-CR3216-1206 x 12
FMP200JR-52-1R x 3
ERJ-14YJ201U
User Library-DPAK-1
C400319 x 6
User Library-1206 SMD Capacitor x 7
User Library-CAPC1608X09 x 8
C-CASE
VY2100K29U2JS63V0
EEEFK1E680P x 4
CircuitWorks-SOT-23
LM74610QDGKRQ1
User Library-CR2012-0805
User Library-DO-214AC SMA x 2
User Library-SOD123W
EFD25-12V 1.5A
