eSpark-Backup/nabilfesal-smartmeter-hw/docs/Client-Files/Product Files/MSM-Documentation-24122024/MSM Casing/BACK_V1.1.STEP

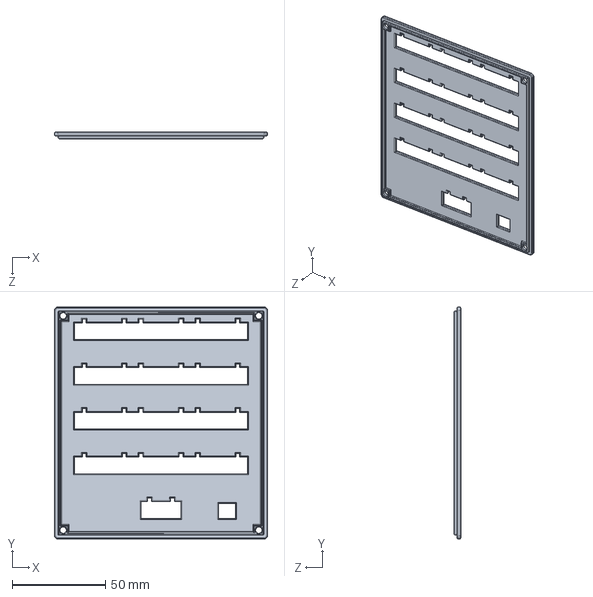
[picture p90: CAD file, 2025-01-22]
docs/Client-Files/Product Files/MSM-Documentation-24122024/MSM Casing/BACK_V1.1.STEP
114.5 x 124.5 x 3.50 mm
