eSpark-Backup/nabilfesal-smartmeter-hw/Enclosure-Files/Multichannel Smart Meter (MSM)-20251015T050852Z-1-001/Multichannel Smart Meter (MSM)/MSM Final Version V1 141025/MSM Packaging Stuff/BOX Stickers/Serial Number Label.dxf

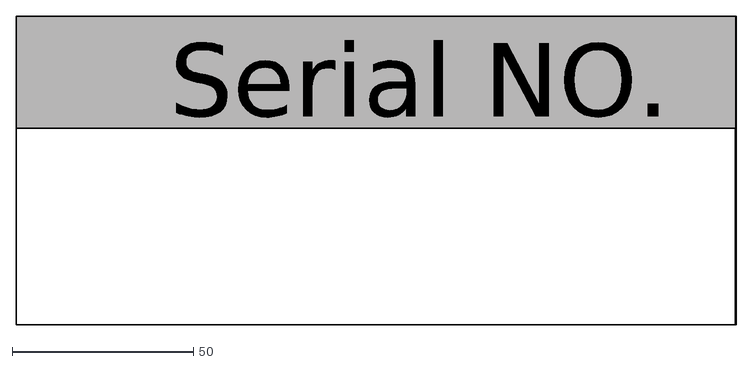
[picture p92: CAD file, 2025-10-16]
Enclosure-Files/Multichannel Smart Meter (MSM)-20251015T050852Z-1-001/Multichannel Smart Meter (MSM)/MSM Final Version V1 141025/MSM Packaging Stuff/BOX Stickers/Serial Number Label.dxf
Serial NO.
