eSpark-Backup/nabilfesal-smartmeter-hw/STEP 3D Files/OFP_SCM_v1.5.step

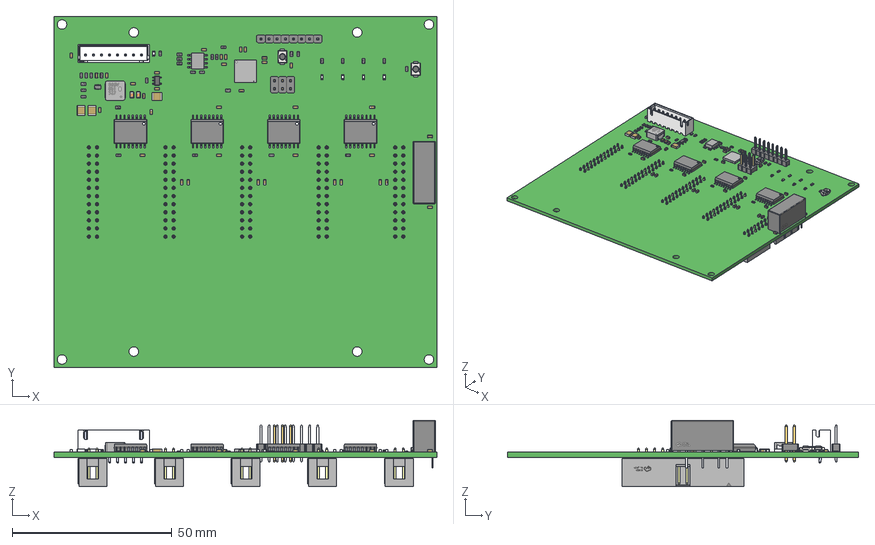
[picture p93: CAD file, 2025-03-10]
STEP 3D Files/OFP_SCM_v1.5.step
120.0 x 110.0 x 20.8 mm
User Library-CAPC1608X09 x 36
TRANS_IRF7103TRPBF_INF
User Library-RESC1608X05N x 30
ISO1050DWR x 4
User Library-tsot-23-5
User Library-LED SMD0603 x 5
B8B-XH-A_LF__SN_
User Library-CAPC3225X10 x 3
User Library-0805 SMD Capacitor x 2
