eSpark-Backup/nabilfesal-smartmeter-hw/docs/Client-Files/Product Files/MSM-Documentation-24122024/MSM Casing/BODY_V1.1.STEP

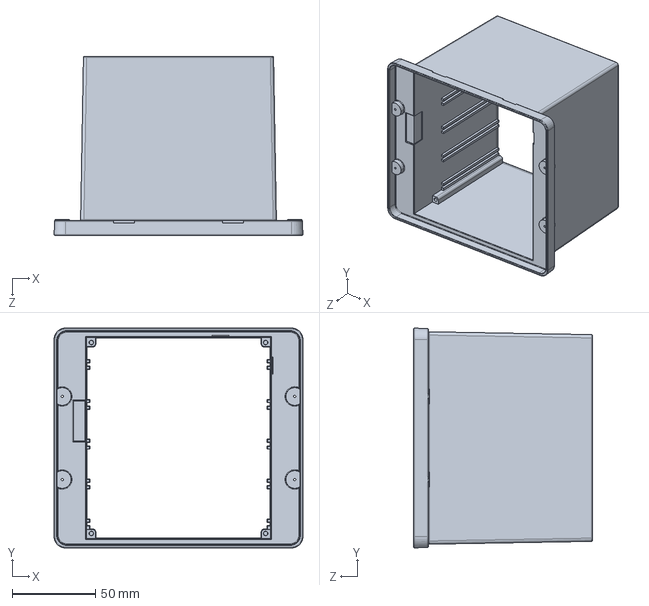
[picture p94: CAD file, 2025-01-22]
docs/Client-Files/Product Files/MSM-Documentation-24122024/MSM Casing/BODY_V1.1.STEP
149.9 x 132.4 x 107.7 mm
