eSpark-Backup/nabilfesal-smartmeter-hw/docs/Client-Files/Product Files/MSM-Documentation-24122024/MSM Casing/Bracket LCD_V1.3.STEP

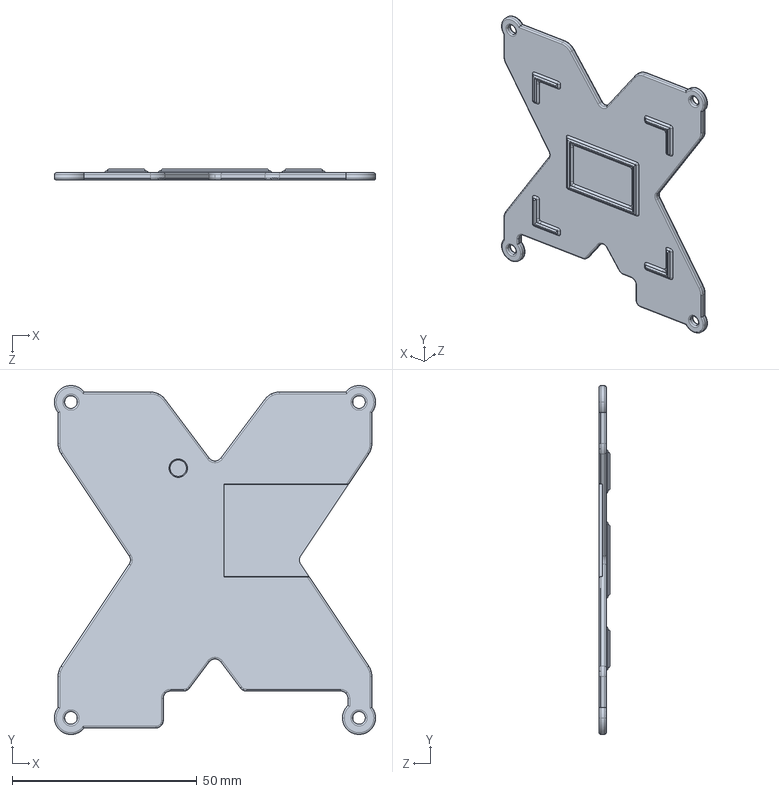
[picture p97: CAD file, 2025-01-22]
docs/Client-Files/Product Files/MSM-Documentation-24122024/MSM Casing/Bracket LCD_V1.3.STEP
87.0 x 94.5 x 3.00 mm
