eSpark-Backup/nabilfesal-smartmeter-hw/docs/Client-Files/Product Files/MSM-Documentation-24122024/MSM Casing/FRONT_V1.4.STEP

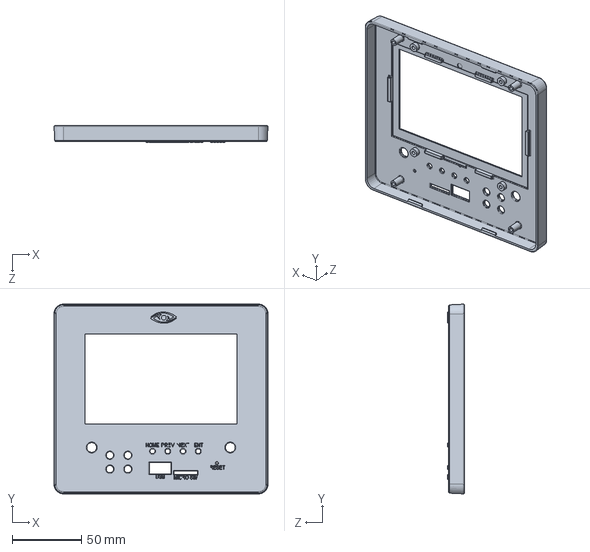
[picture p100: CAD file, 2025-01-22]
docs/Client-Files/Product Files/MSM-Documentation-24122024/MSM Casing/FRONT_V1.4.STEP
154.4 x 136.9 x 12.0 mm
