eSpark-Backup/nabilfesal-smartmeter-hw/(list of files, cad)

Other CAD files:
Design-Files/OFP_MCM_v1.6.3/Deliverables/_Supporting Files/OFP_MCM_v1.6.3.DWG
Design-Files/OFP_USM_v1.5/OFP_USM_v1.5.step
DXF Files/OFP_CIM_v1.5.DXF
DXF Files/OFP_SCM_v1.5.DXF
DXF Files/OFP_USM_v1.5.DXF
DXF Files/OFP_VIM_v1.5.DXF
Design-Files/OFP_CIM_v1.5/Deliverables/_Supporting Files/OFP_CIM_v1.5..DWG
Design-Files/OFP_CIM_v1.5/Deliverables/_Supporting Files/OFP_CIM_v1.5.DXF
Design-Files/OFP_MCM_v1.6.1/Deliverables/_Supporting Files/OFP_MCM_v1.61..DWG
Design-Files/OFP_MCM_v1.6.2/Deliverables/_Supporting Files/OFP_MCM_v1.62..DWG
Design-Files/OFP_MCM_v1.6/Deliverables/_Supporting Files/OFP_MCM_v1.6..DWG
Design-Files/OFP_SCM_v1.5/Deliverables/Supporting Files/OFP_SCM_v1.5..DWG
Design-Files/OFP_SCM_v1.5/Deliverables/Supporting Files/OFP_SCM_v1.5.DXF
Design-Files/OFP_USM_v1.5/Deliverables/Supporting Files/OFP_USM_v1.5..DWG
Design-Files/OFP_USM_v1.5/Deliverables/Supporting Files/OFP_USM_v1.5.DXF
Design-Files/OFP_VIM_DC_v1.51/Deliverables/Supporting Files/OFP_VIM_DC_v1.51.DWG
Design-Files/OFP_VIM_DC_v1.51/Deliverables/Supporting Files/OFP_VIM_DC_v1.51.DXF
Design-Files/OFP_VIM_v1.51/Deliverables/Supporting Files/OFP_VIM_v1.51.DWG
Design-Files/OFP_VIM_v1.51/Deliverables/Supporting Files/OFP_VIM_v1.51.DXF
