eSpark-Backup/nabilfesal-smartmeter-hw/docs/Client-Files/Existing Installation/IMG-20250109-WA0024.jpg

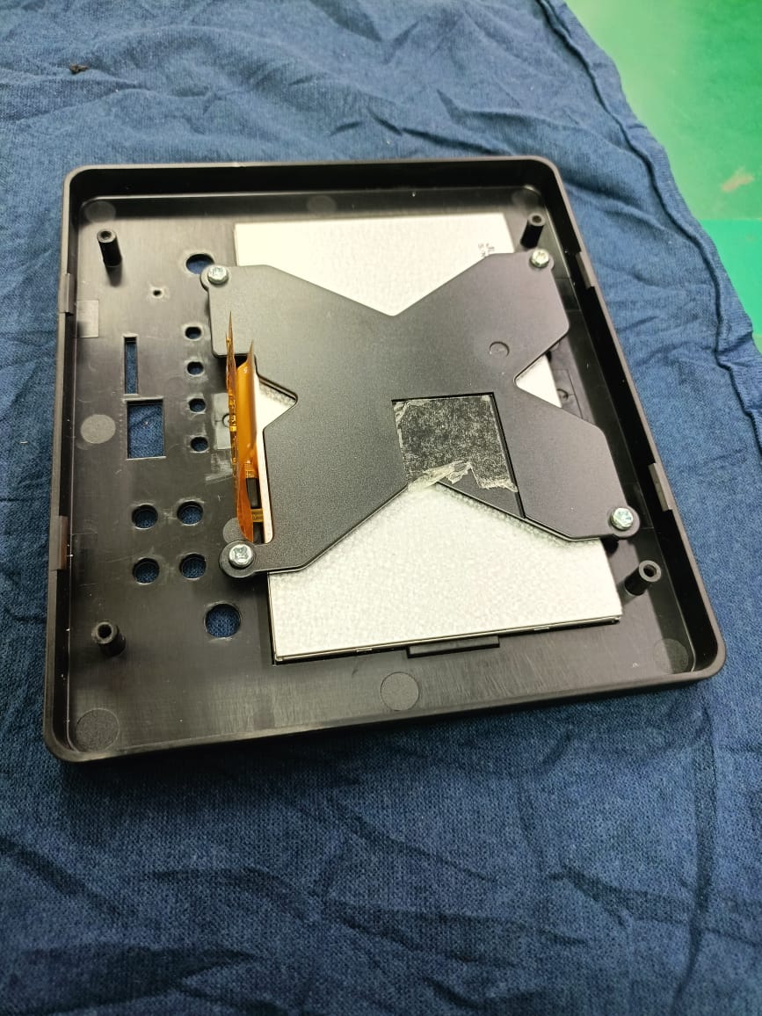
docs/Client-Files/Existing Installation/IMG-20250109-WA0024.jpg
