eSpark-Backup/nabilfesal-smartmeter-hw/docs/Client-Files/Existing Installation/Tape-Information.png

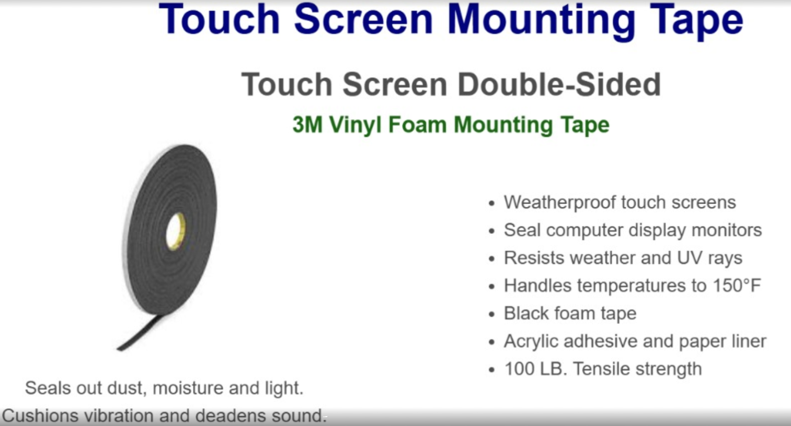
docs/Client-Files/Existing Installation/Tape-Information.png
