eSpark-Backup/nabilfesal-smartmeter-hw/docs/Client-Files/Existing Installation/Tissue-Tape-Information.png

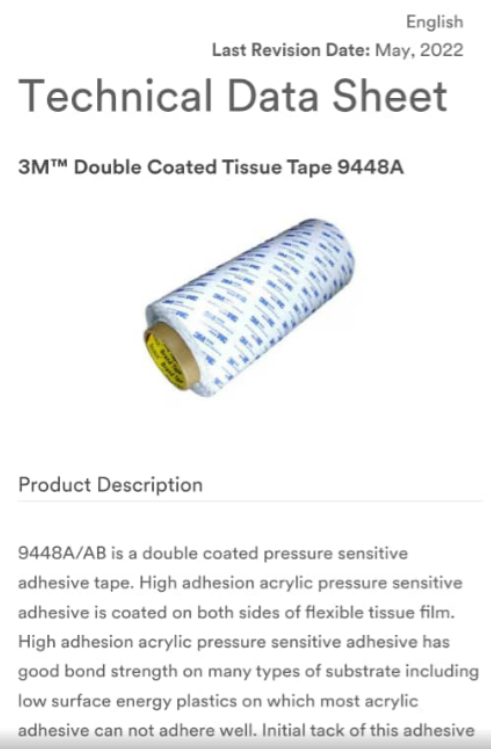
docs/Client-Files/Existing Installation/Tissue-Tape-Information.png
