eSpark-Backup/nabilfesal-smartmeter-hw/docs/Client-Files/Sample Data File/IND10000124-20241106-105806-testfile.csv

Date | Time | V(R) | In1(R1) | In1(RPF) | V(Y) | In1(Y1) | In1(YPF) | V(B) | In1(B1) | In1(BPF) | P1 | Q1 | S1 | Epimp1 | Epexp1 | Eqimp1 | Eqexp1 | F1(R) | PF(R1) | F1(Y) | PF(Y1) | F1(B) | PF(B1) | F1(P) | F1(Q) | F1(S) | F1(Epimp) | F1(Epexp) | F1(Eqimp) | F1(Eqexp) | F2(R2) | PF(R2) | F2(Y) | PF(Y2) | F2(B) | PF(B2) | F2(P) | F2(Q) | F2(S) | F2(Epimp) | F2(Epexp) | F2(Eqimp) | F2(Eqexp) | F3(R) | PF(R3) | F3(Y) | PF(Y3) | F3(B) | PF(B3) | F3(P) | F3(Q) | F3(S) | F3(Epimp) | F3(Epexp) | F3(Eqimp) | F3(Eqexp) | F4(R) | PF(R4) | F4(Y)
6/11/2024 | 8:20 | 4.4926 | 245.987 | 245.987 | 245.987 | 245.987 | 245.987 | 4.511 | 245.987 | 245.987 | 245.987 | 245.987 | 245.987 | 7.05006 | -0.026573 | 11.9661 | -0.014108 | 245.987 | 245.987 | 245.987 | 245.987 | 245.987 | 245.987 | 245.987 | 245.987 | 245.987 | 2.27882 | -0.047552 | 3.53876 | -0.061729 | 245.987 | 245.987 | 245.987 | 245.987 | 245.987 | 245.987 | 245.987 | 245.987 | 245.987 | 0.834002 | -1.00E-06 | 1.46956 | 245.987 | 245.987 | 245.987 | 245.987 | 245.987 | 245.987 | 245.987 | 245.987 | 245.987 | 245.987 | 245.987 | 245.987 | 245.987 | 245.987 | 245.987 | 245.987 | 245.987
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
