eSpark-Backup/nabilfesal-smartmeter-hw/Design-Files/OFP_CIM_v1.5/Schematic/OFP_CIM_v1.5.pdf

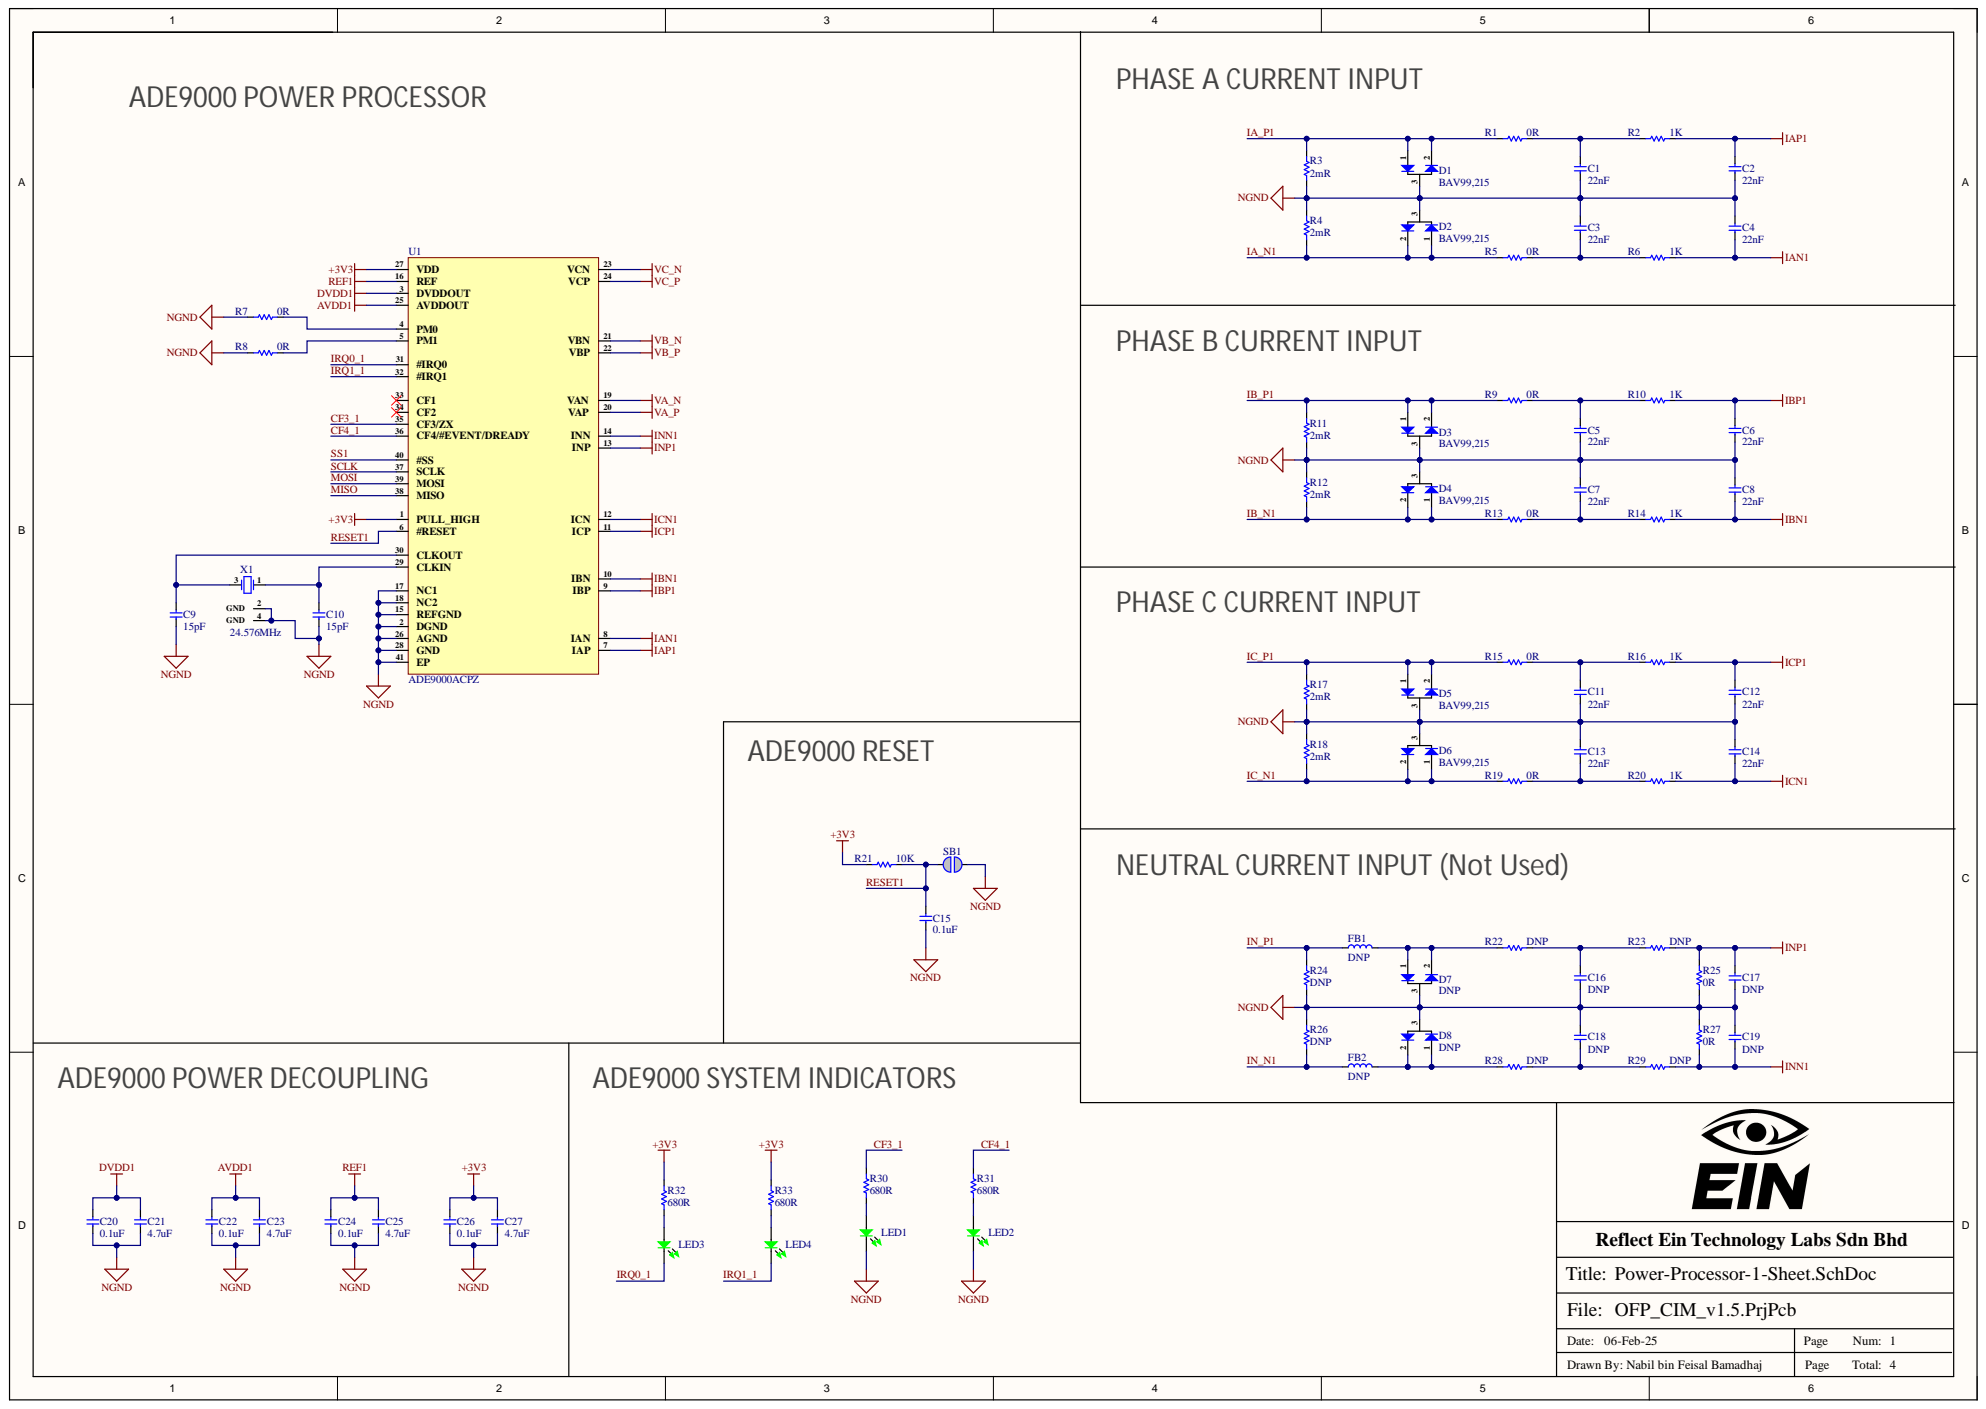
[picture p112: page 1]

ADE9000 POWER PROCESSO R U1 | PHASE A CURRENT INPUT D1 C1 C2

NEUTRAL CURRENT INPUT (Not Used)

Reflect Ein Technology Labs Sdn Bhd

Date : 0 6-F e b-2 5 | P a g e Nu m : 14

Drawn By: Nabil bin F eisal Ba m d h aj | P a g e T ota l :

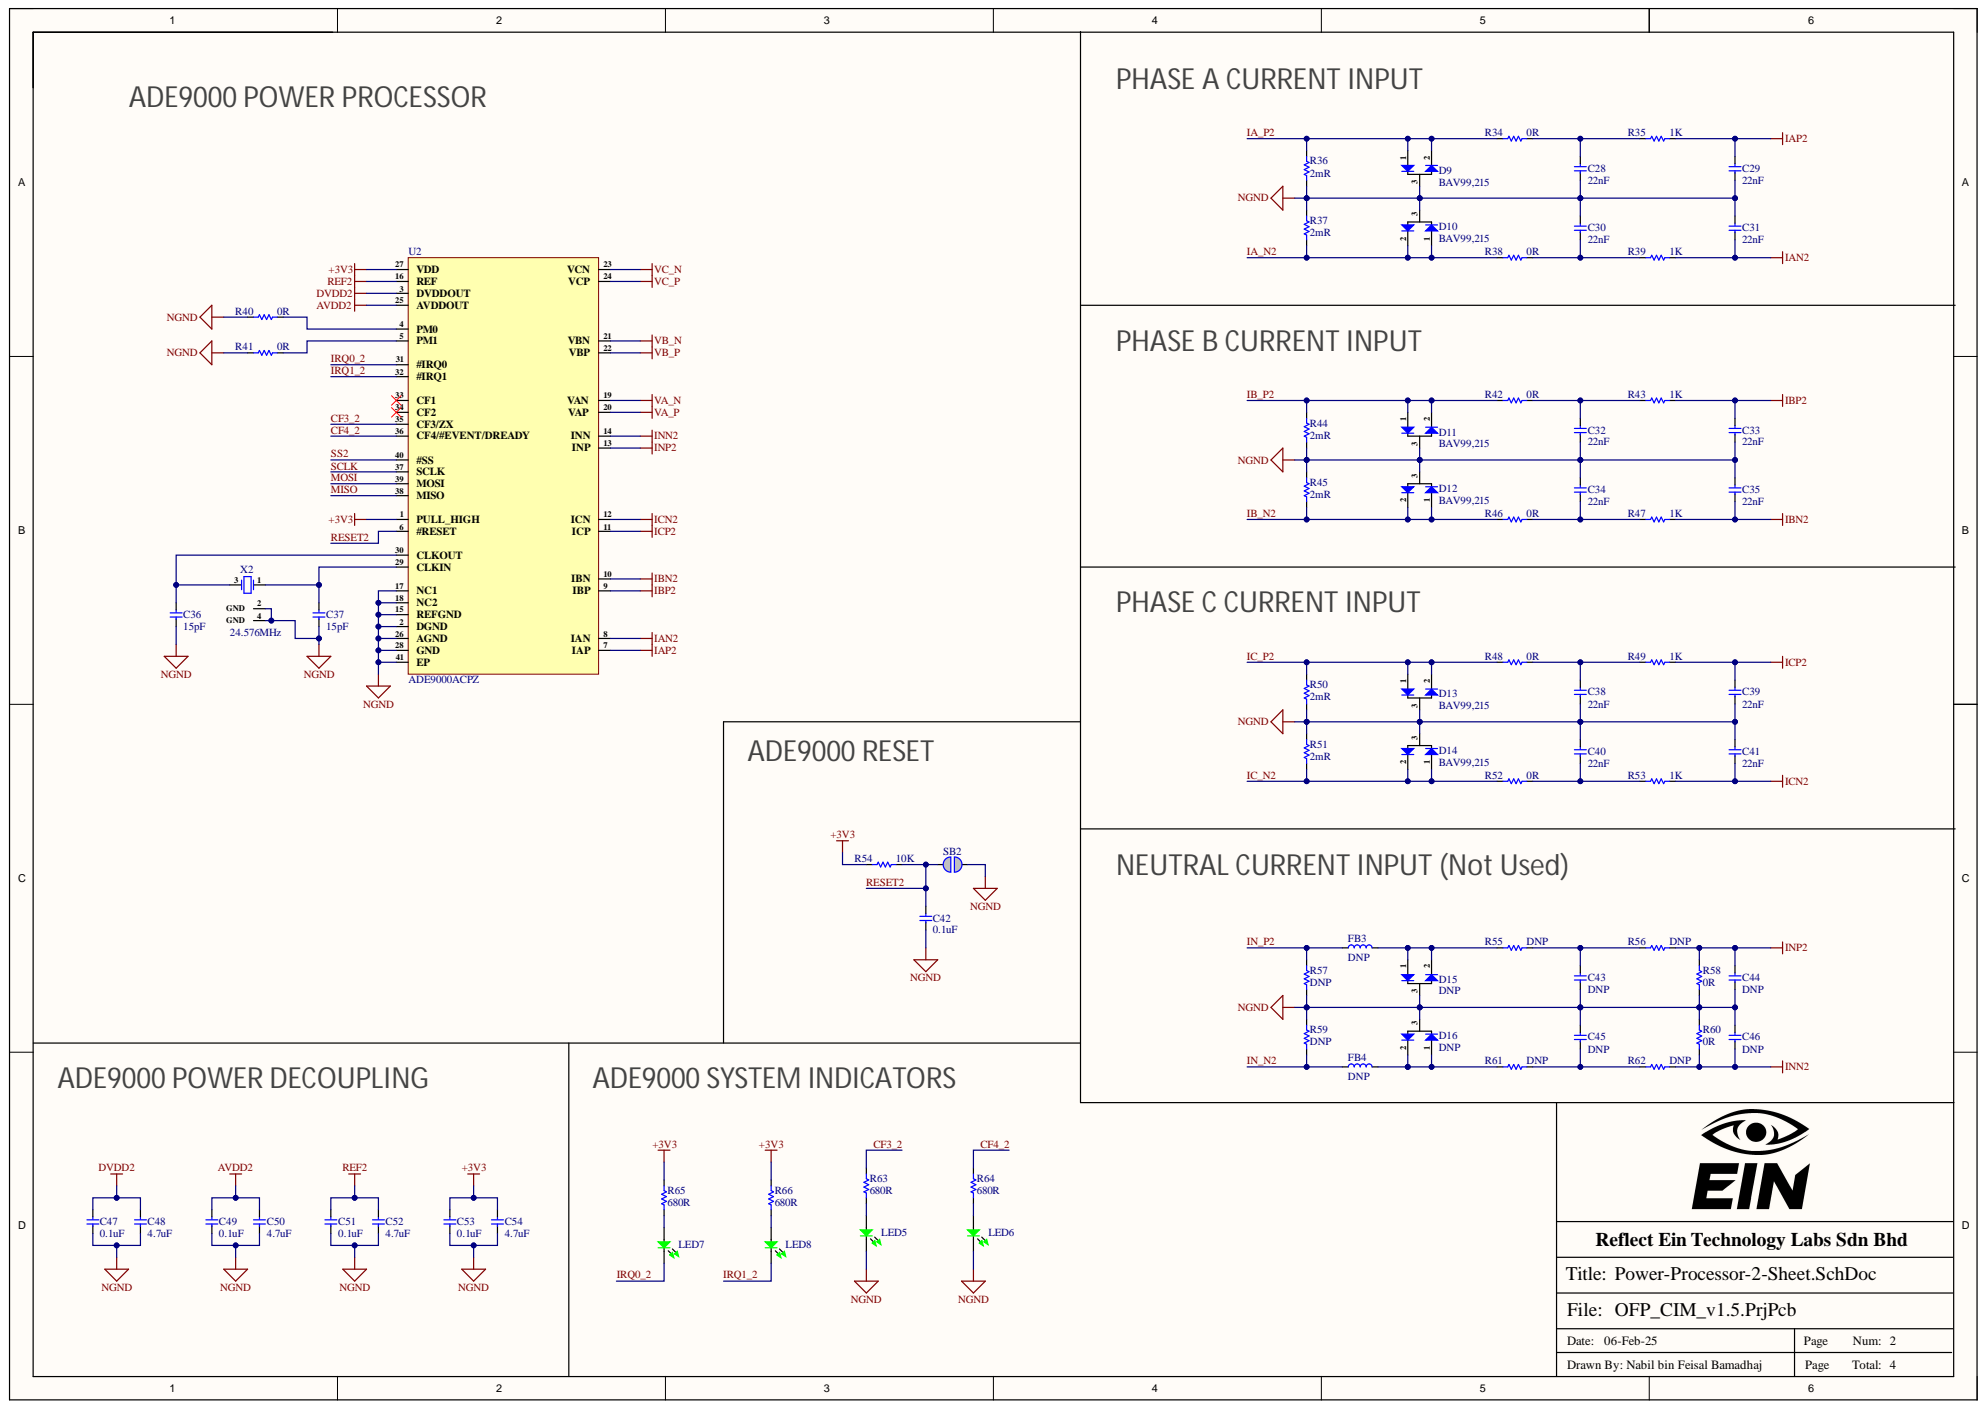
[picture p113: page 2]

ADE9000 POWER PROCESSO R U2 | PHASE A CURRENT INPUT D9 C28 C29

NEUTRAL CURRENT INPUT (Not Used)

Reflect Ein Technology Labs Sdn Bhd

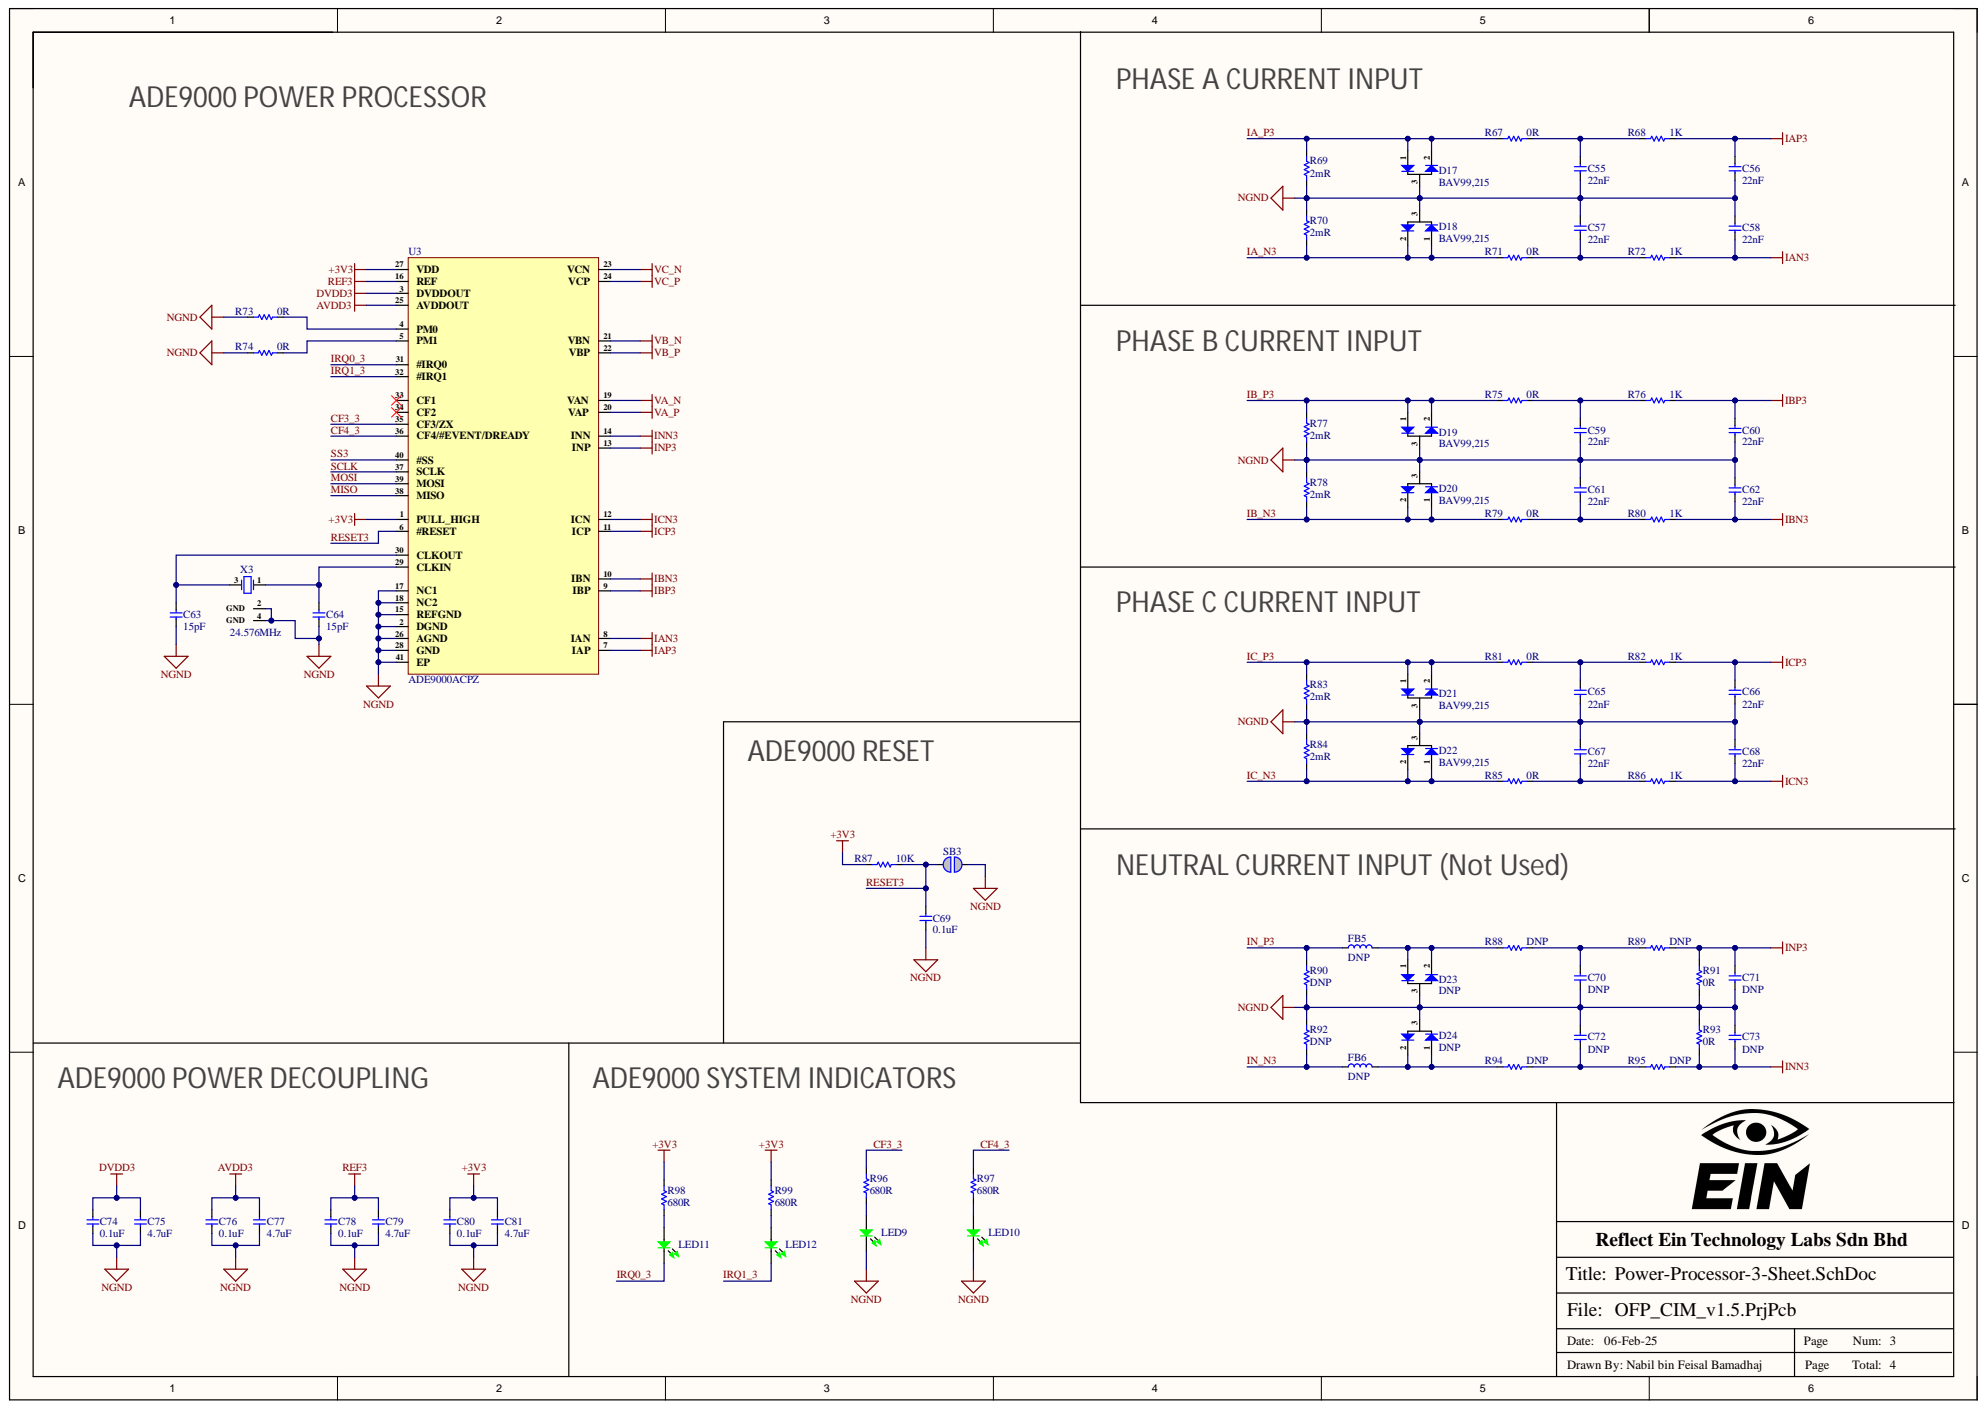
[picture p114: page 3]

ADE9000 POWER PROCESSO R U3 | PHASE A CURRENT INPUT D17 C55 C56

NEUTRAL CURRENT INPUT (Not Used)

Reflect Ein Technology Labs Sdn Bhd

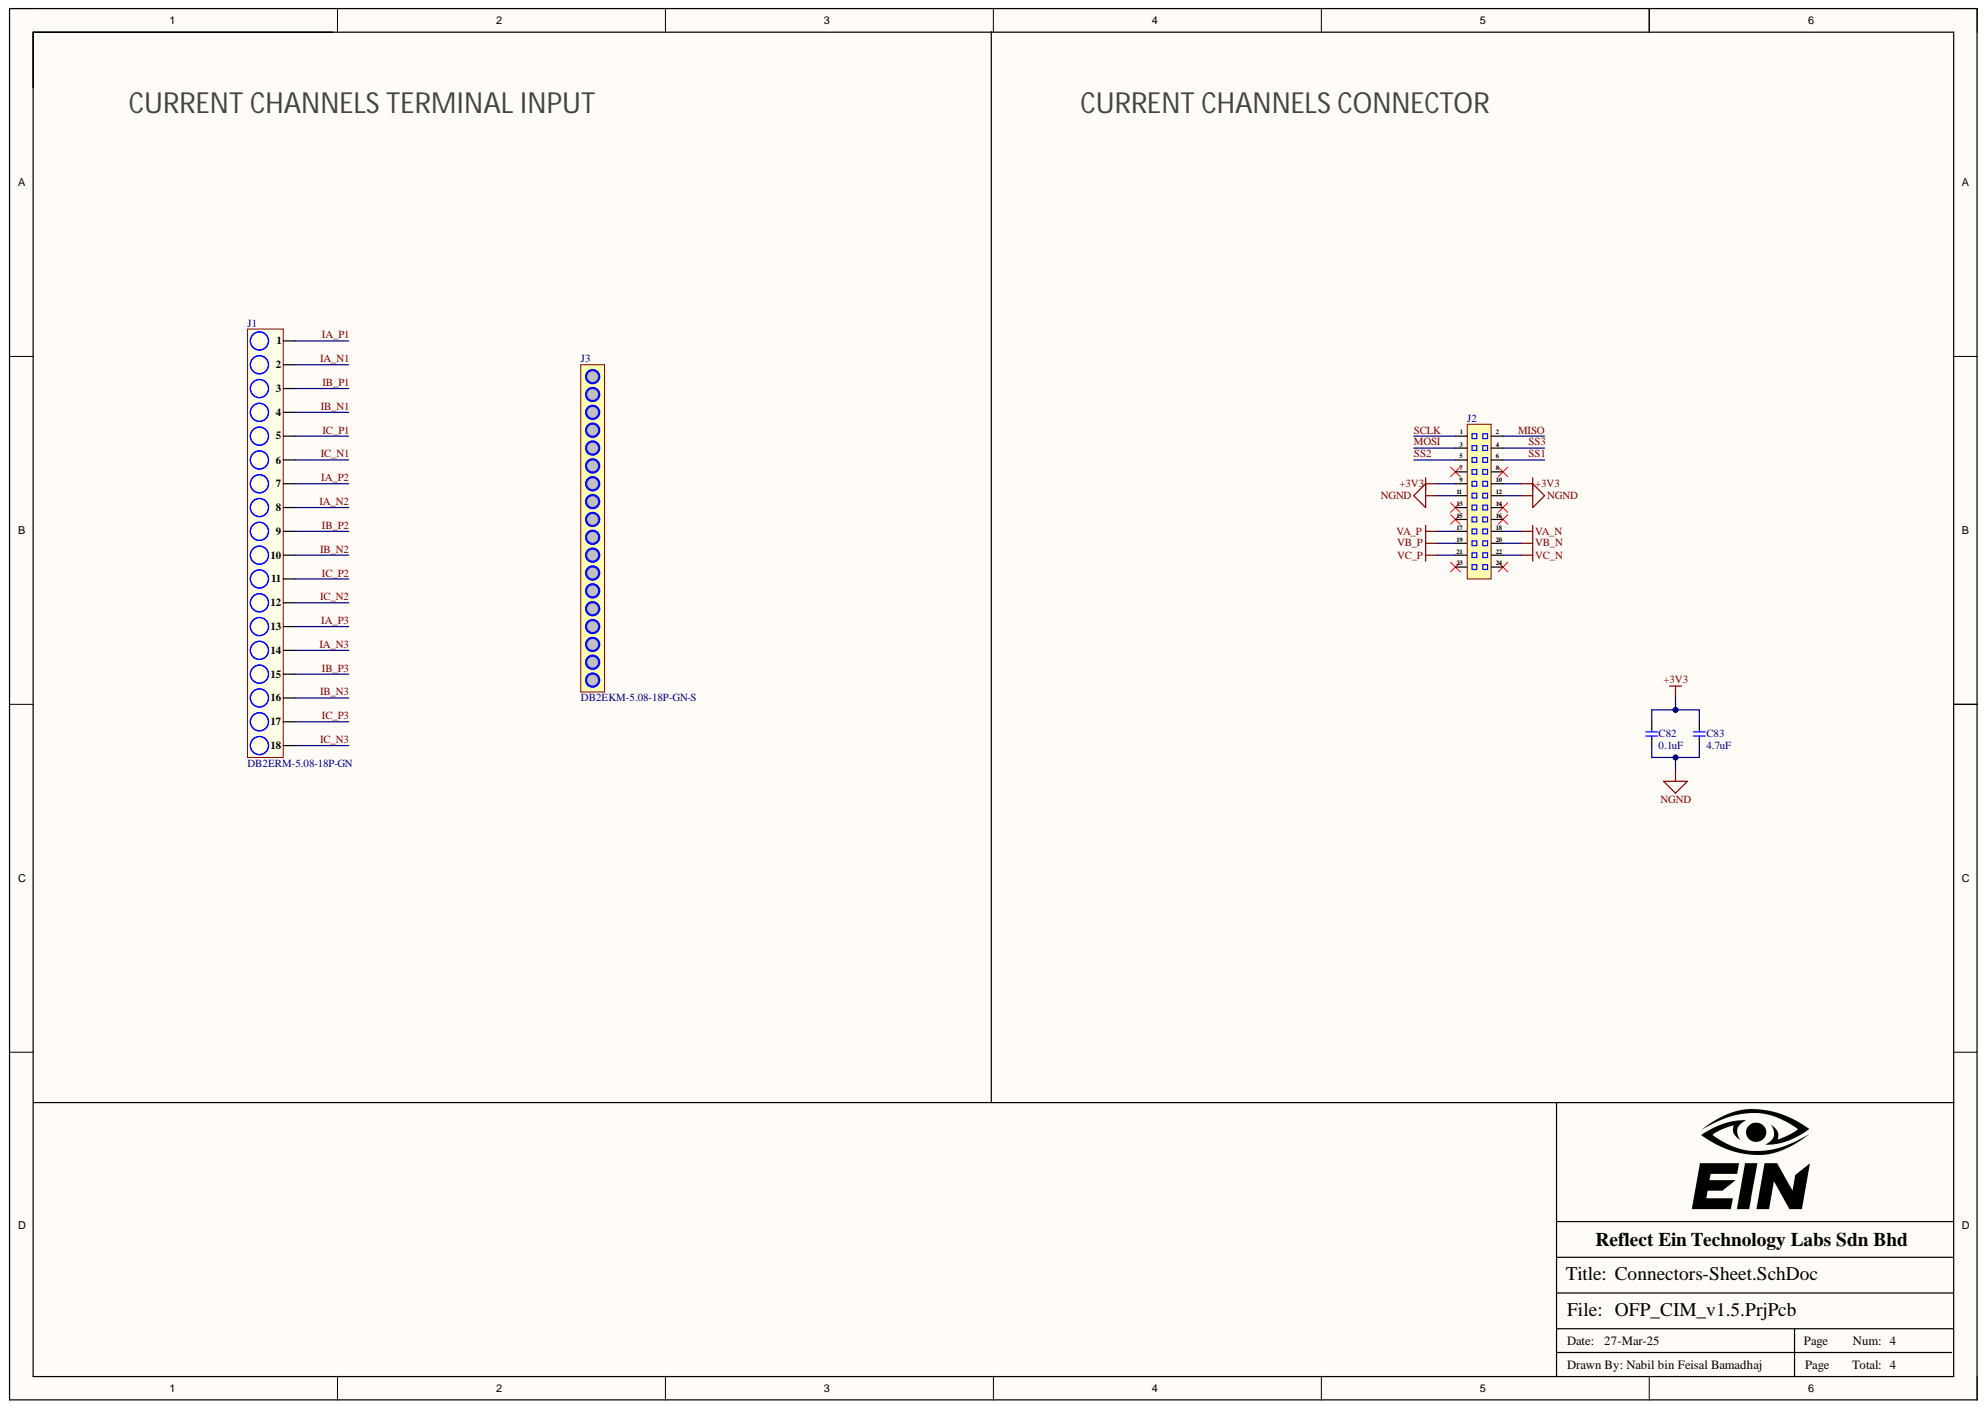
[picture p115: page 4]

Reflect Ein Technology Labs Sdn Bhd
