eSpark-Backup/nabilfesal-smartmeter-hw/Design-Files/OFP_VIM_DC_v1.51/Schematic/OFP_VIM_v1.5.pdf

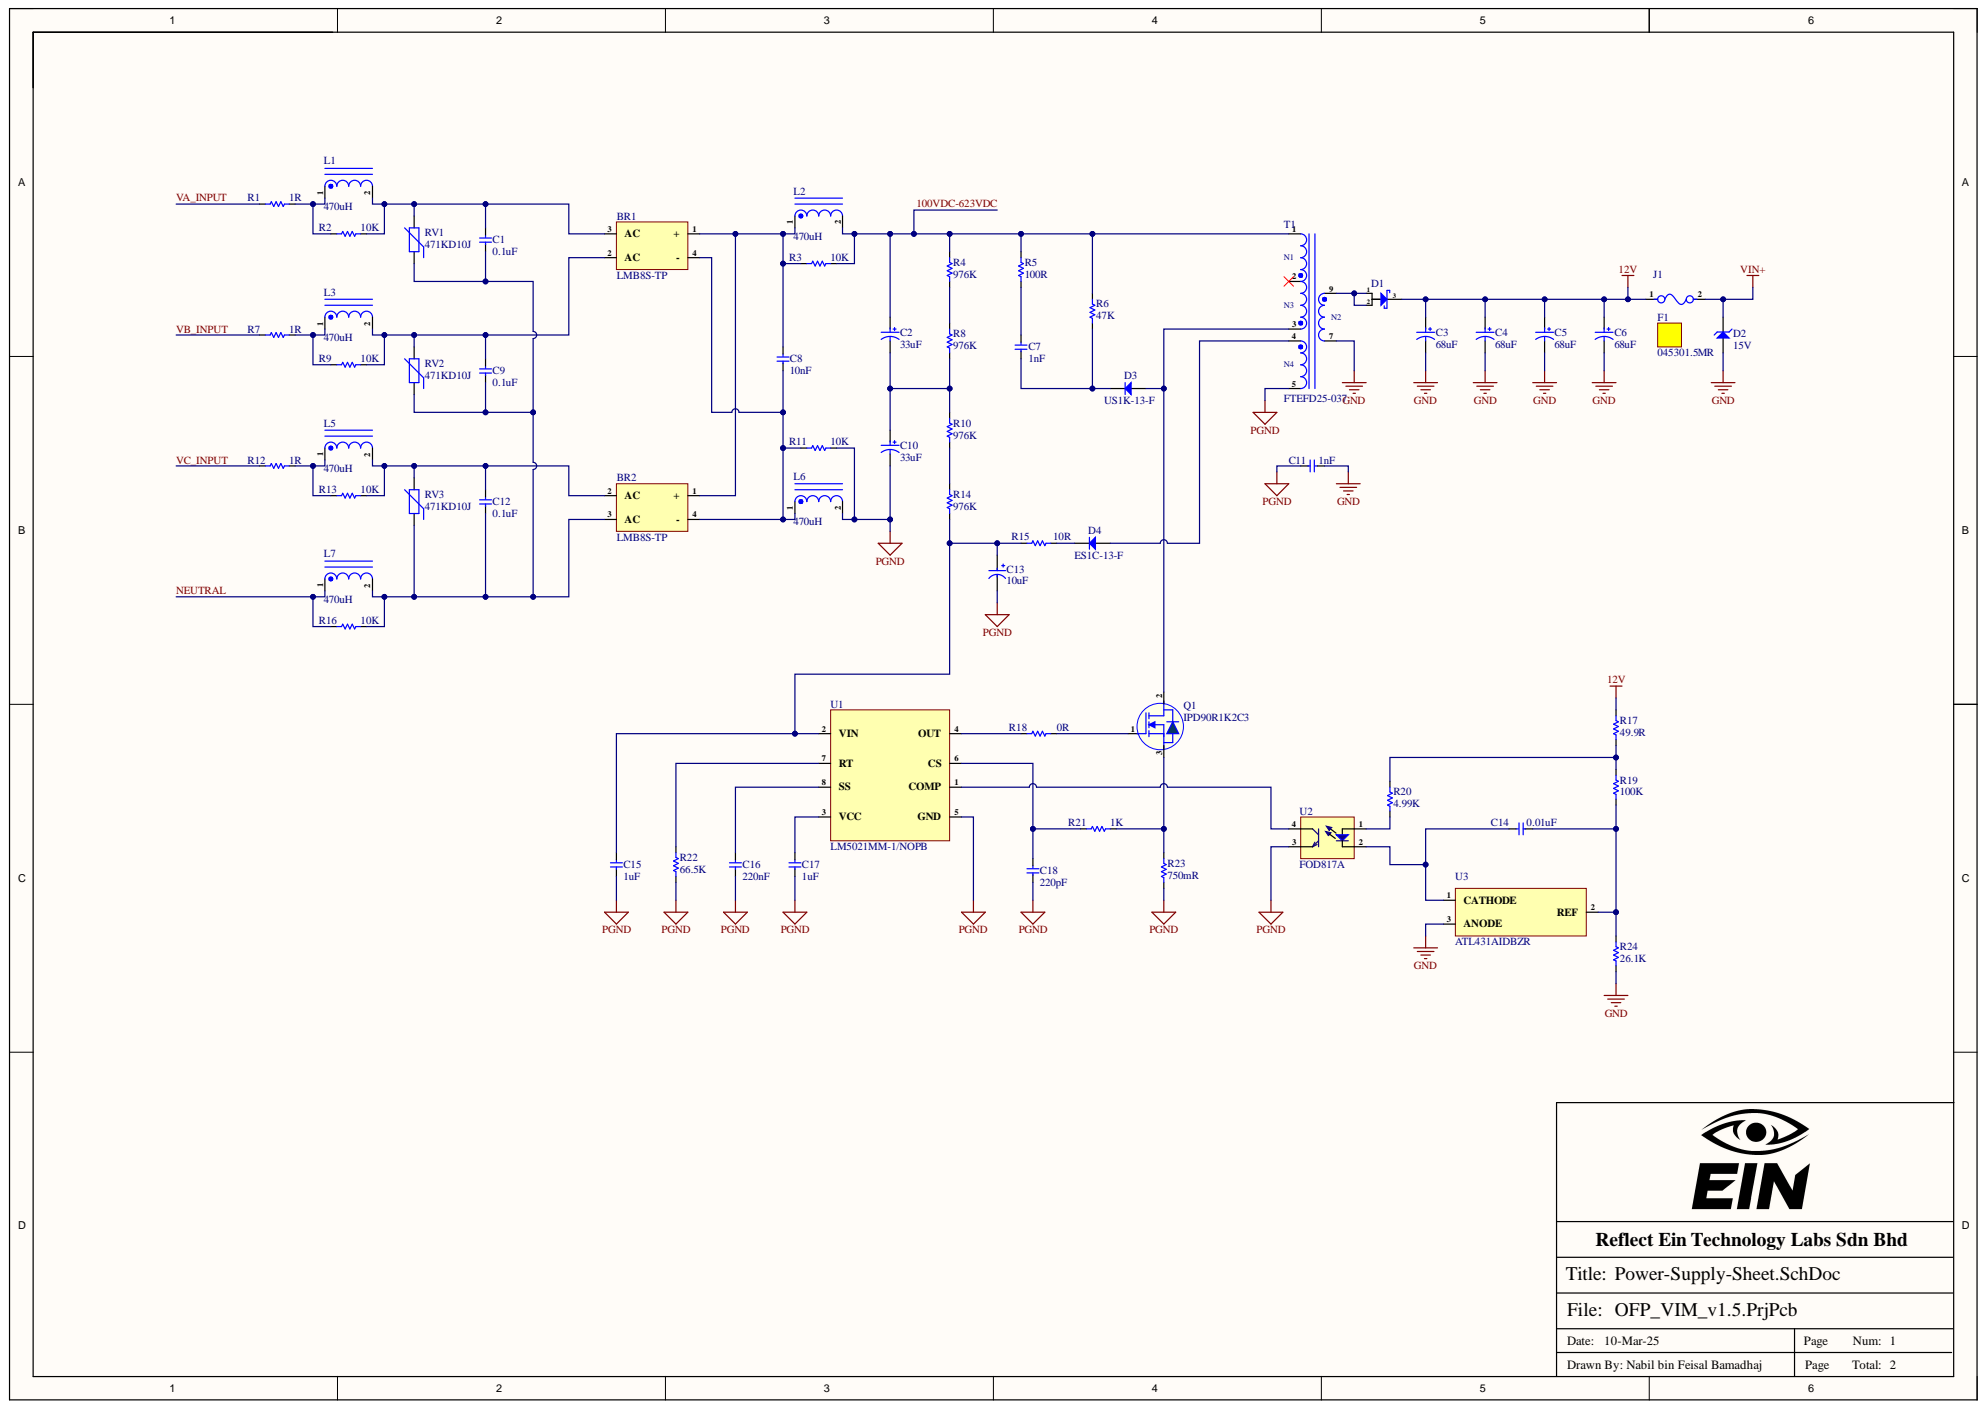
[picture p116: page 1]

7 | VIN OU T RT CS SS COM P VC C GN D | 6

Reflect Ein Technology Labs Sdn Bhd

Date : 1 0-M ar-2 5 | P a g e Nu m : 12

Drawn By: Nabil bin F eisal Ba m a d h aj | P a g e T ota l :

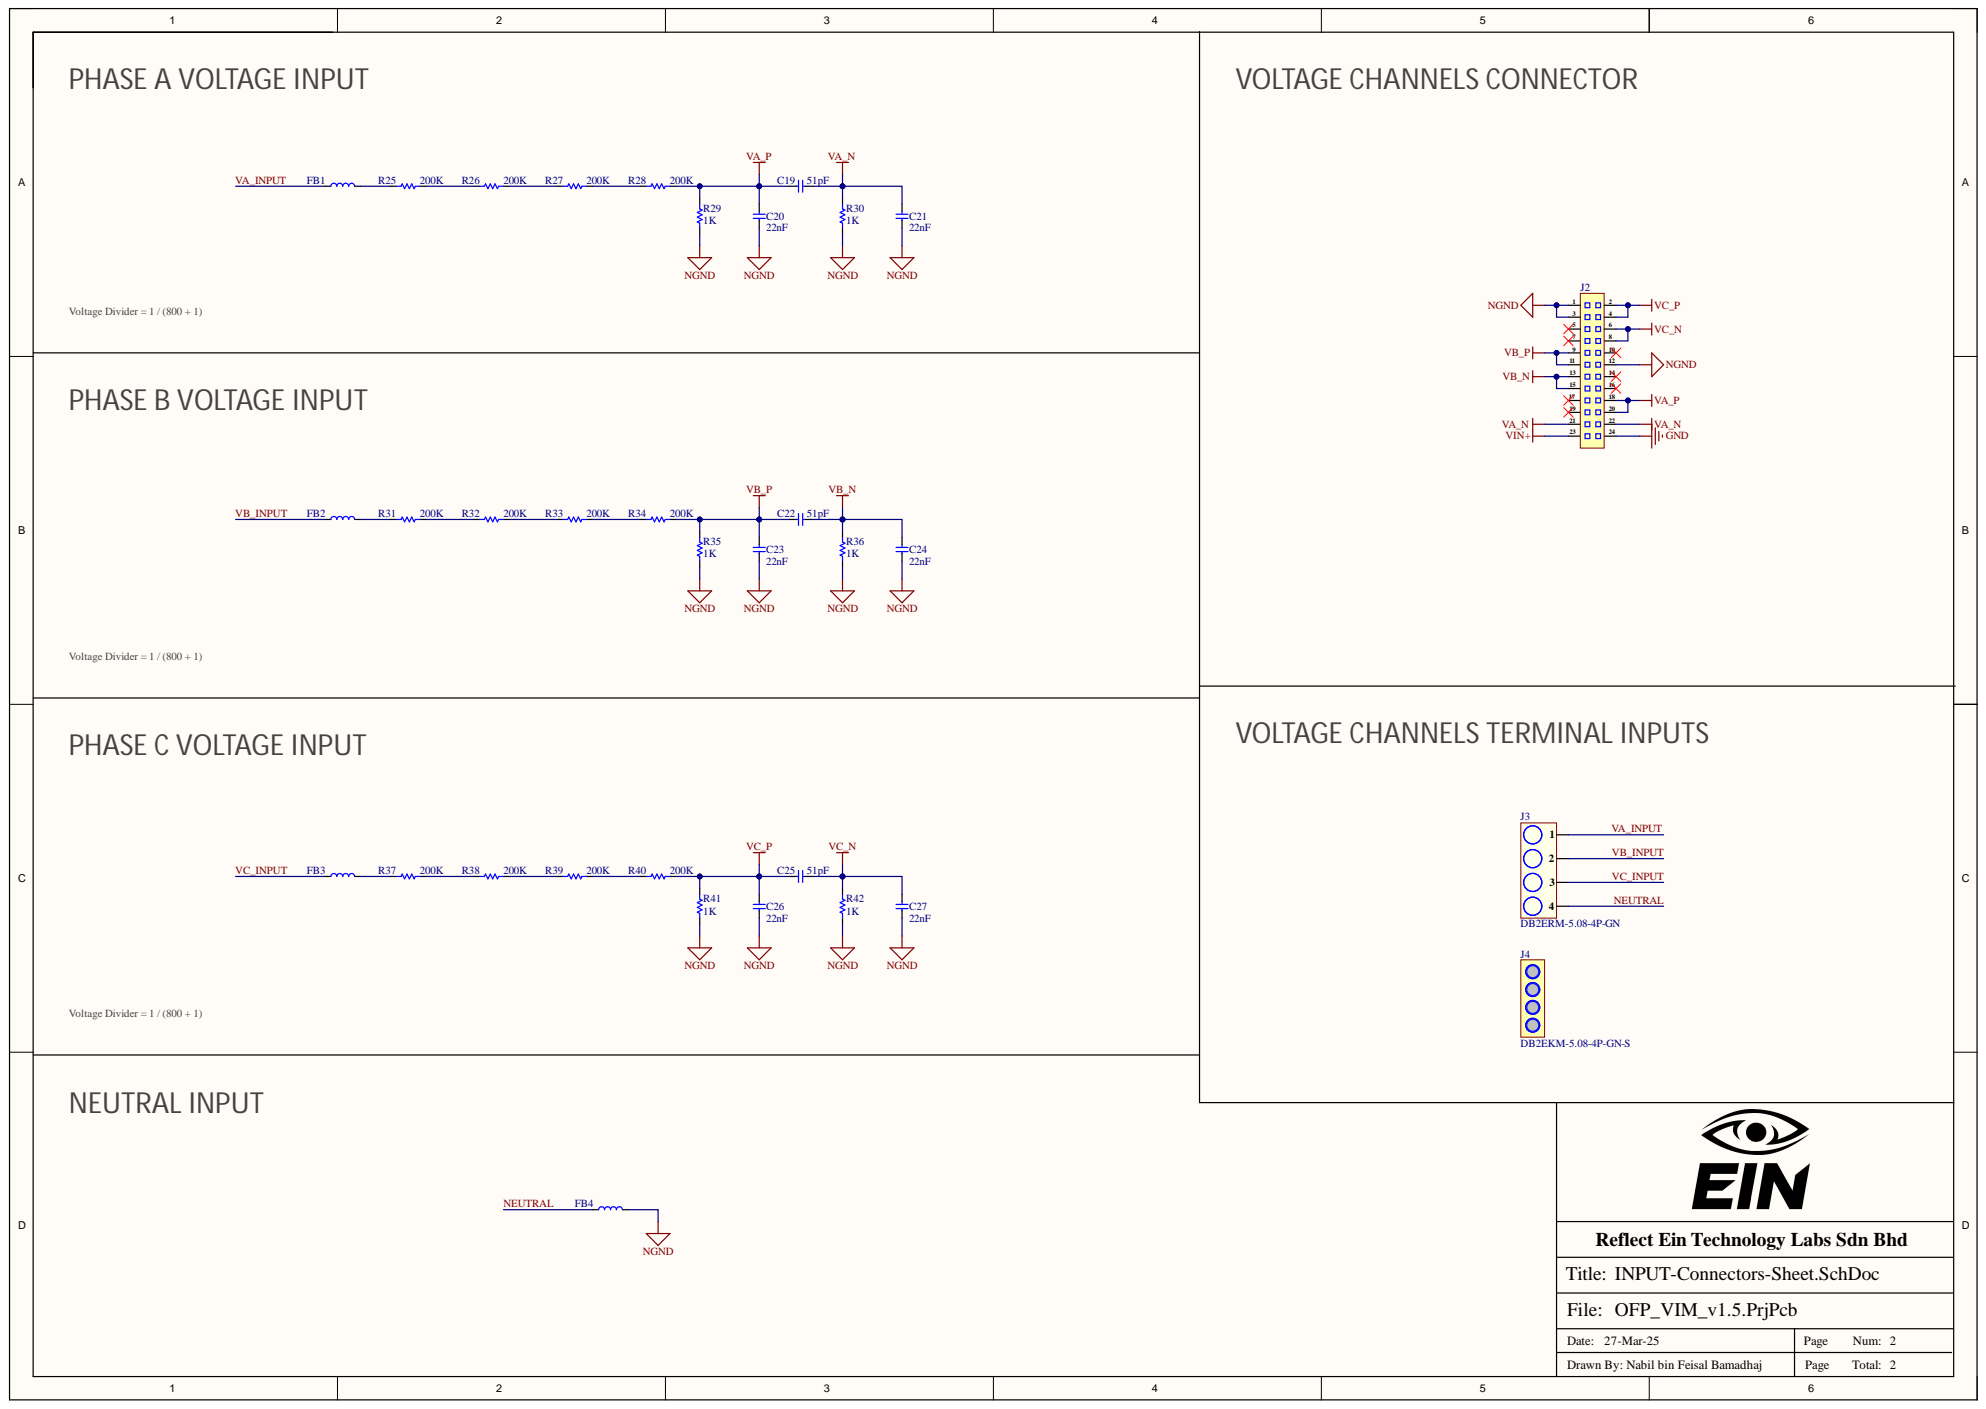
[picture p117: page 2]

PHASE A VOLTAGE INPUT VA_P VA_N C20 C21 Voltage Divider = 1 / (800 + 1) | J2

VOLTAGE CHANNELS TERMINAL INPUTS

Reflect Ein Technology Labs Sdn Bhd

INPUT-Connectors-Sheet.SchDoc

Date: 27-Mar-25 | Page Num: 2

Drawn By: Nabil bin Feisal Bamadhaj | Page Total: 2
