eSpark-Backup/nabilfesal-smartmeter-hw/Design-Files/OFP_USM_v1.5/Schematic/OFP_USM_v1.5.pdf

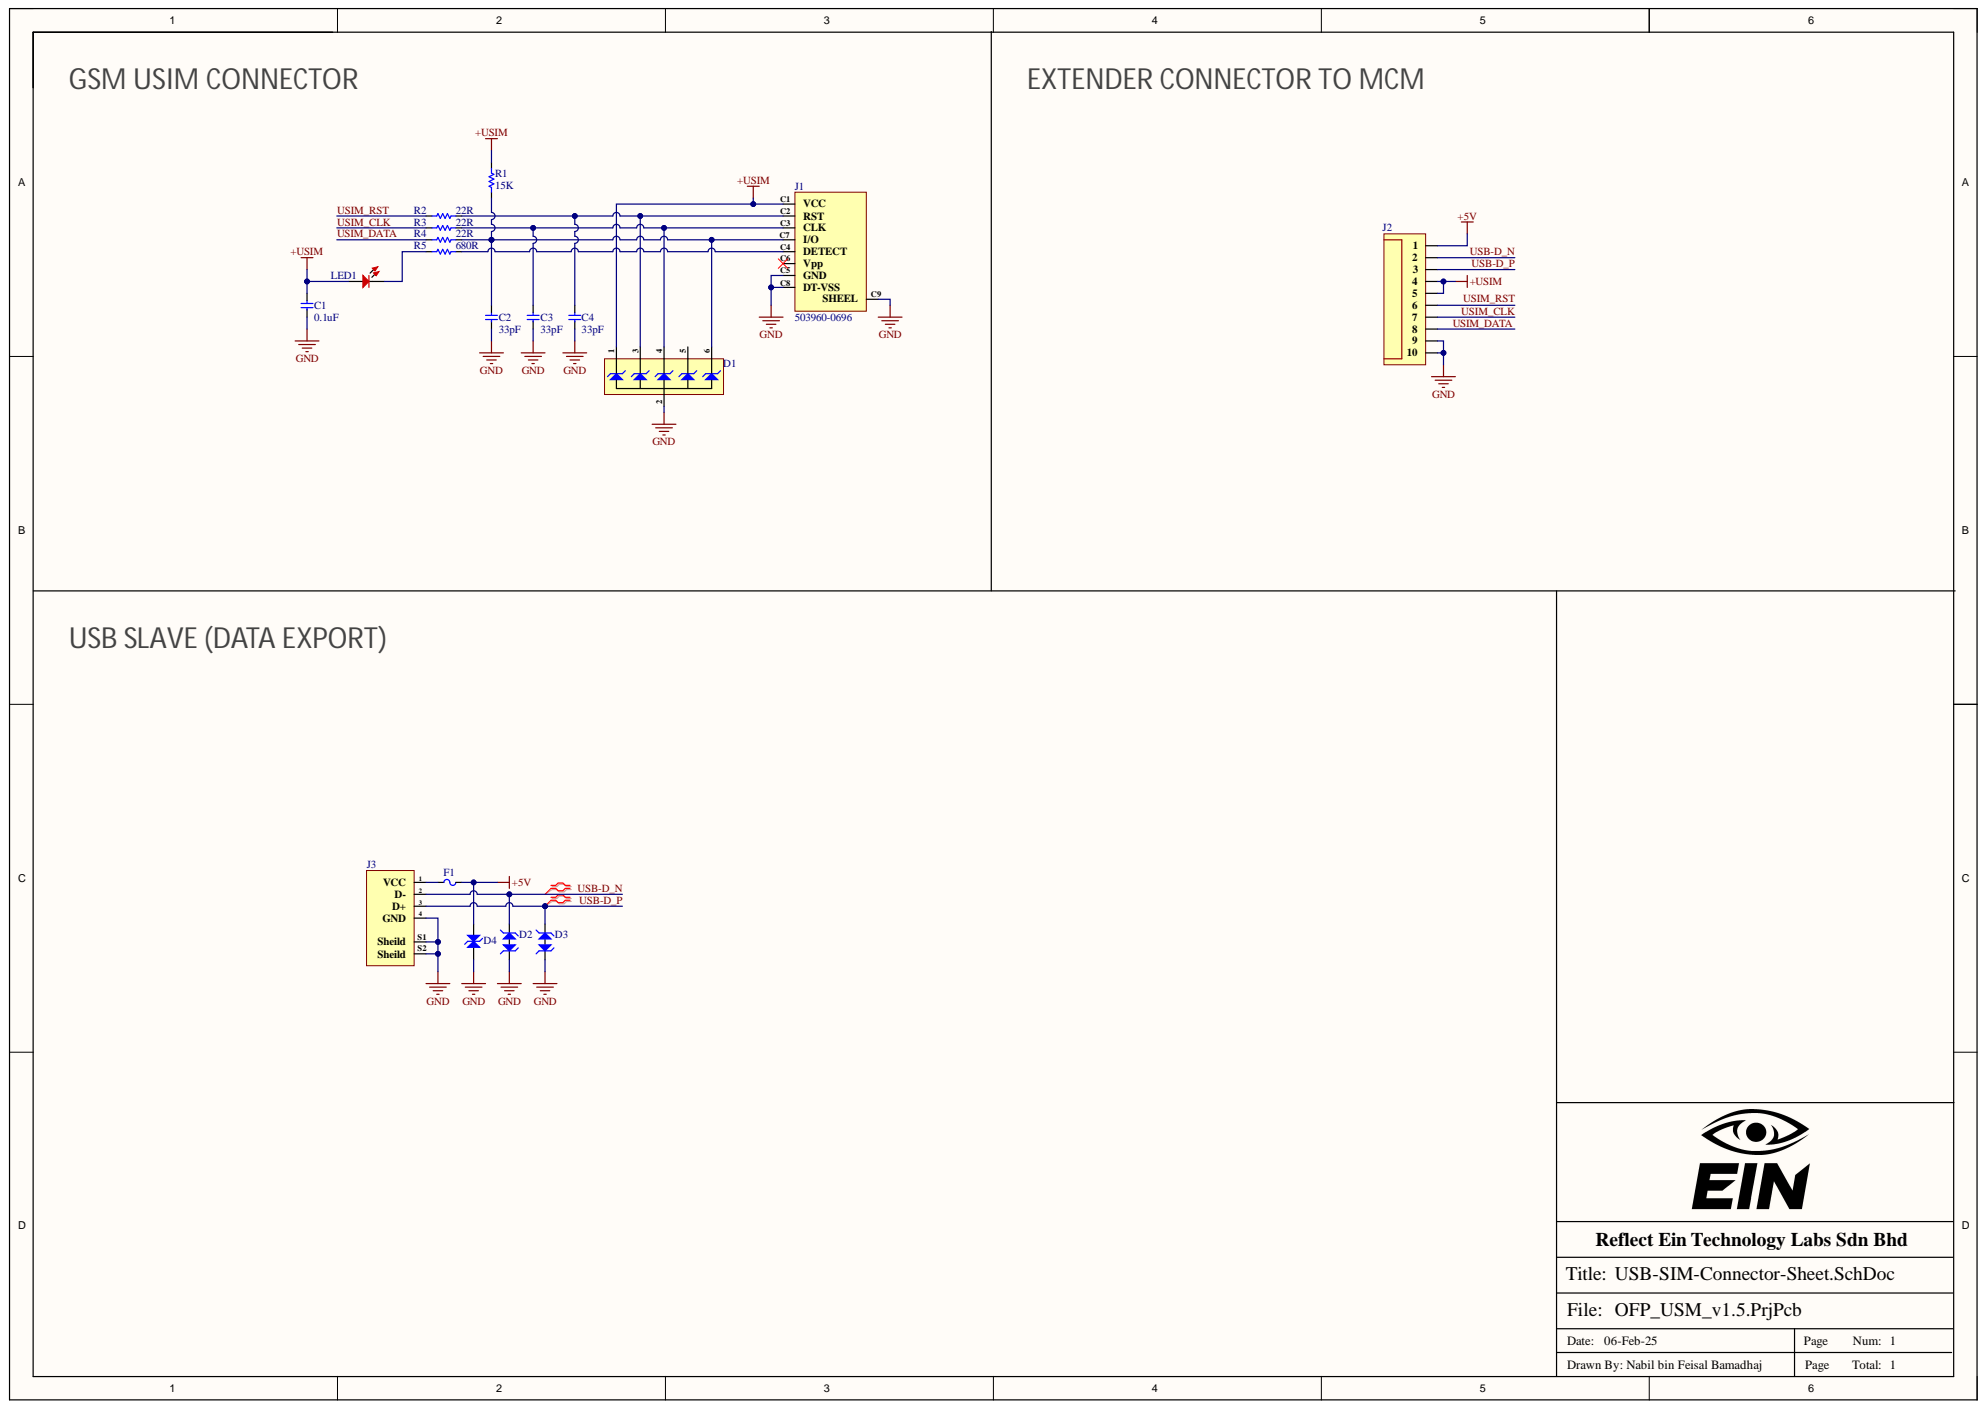
[picture p118: page 1]

+USIM R1 +USIM | +5V

USB SLAVE (DATA EXPORT)

Reflect Ein Technology Labs Sdn Bhd

USB-SIM-Connector-Sheet.SchDoc

Date: 06-Feb-25 | Page Num: 1

Drawn By: Nabil bin Feisal Bamadhaj | Page Total: 1
