eSpark-Backup/nabilfesal-smartmeter-hw/Design-Files/OFP_MCM_v1.6.3/Deliverables/_Schematics/OFP_MCM_v1.6.3.pdf

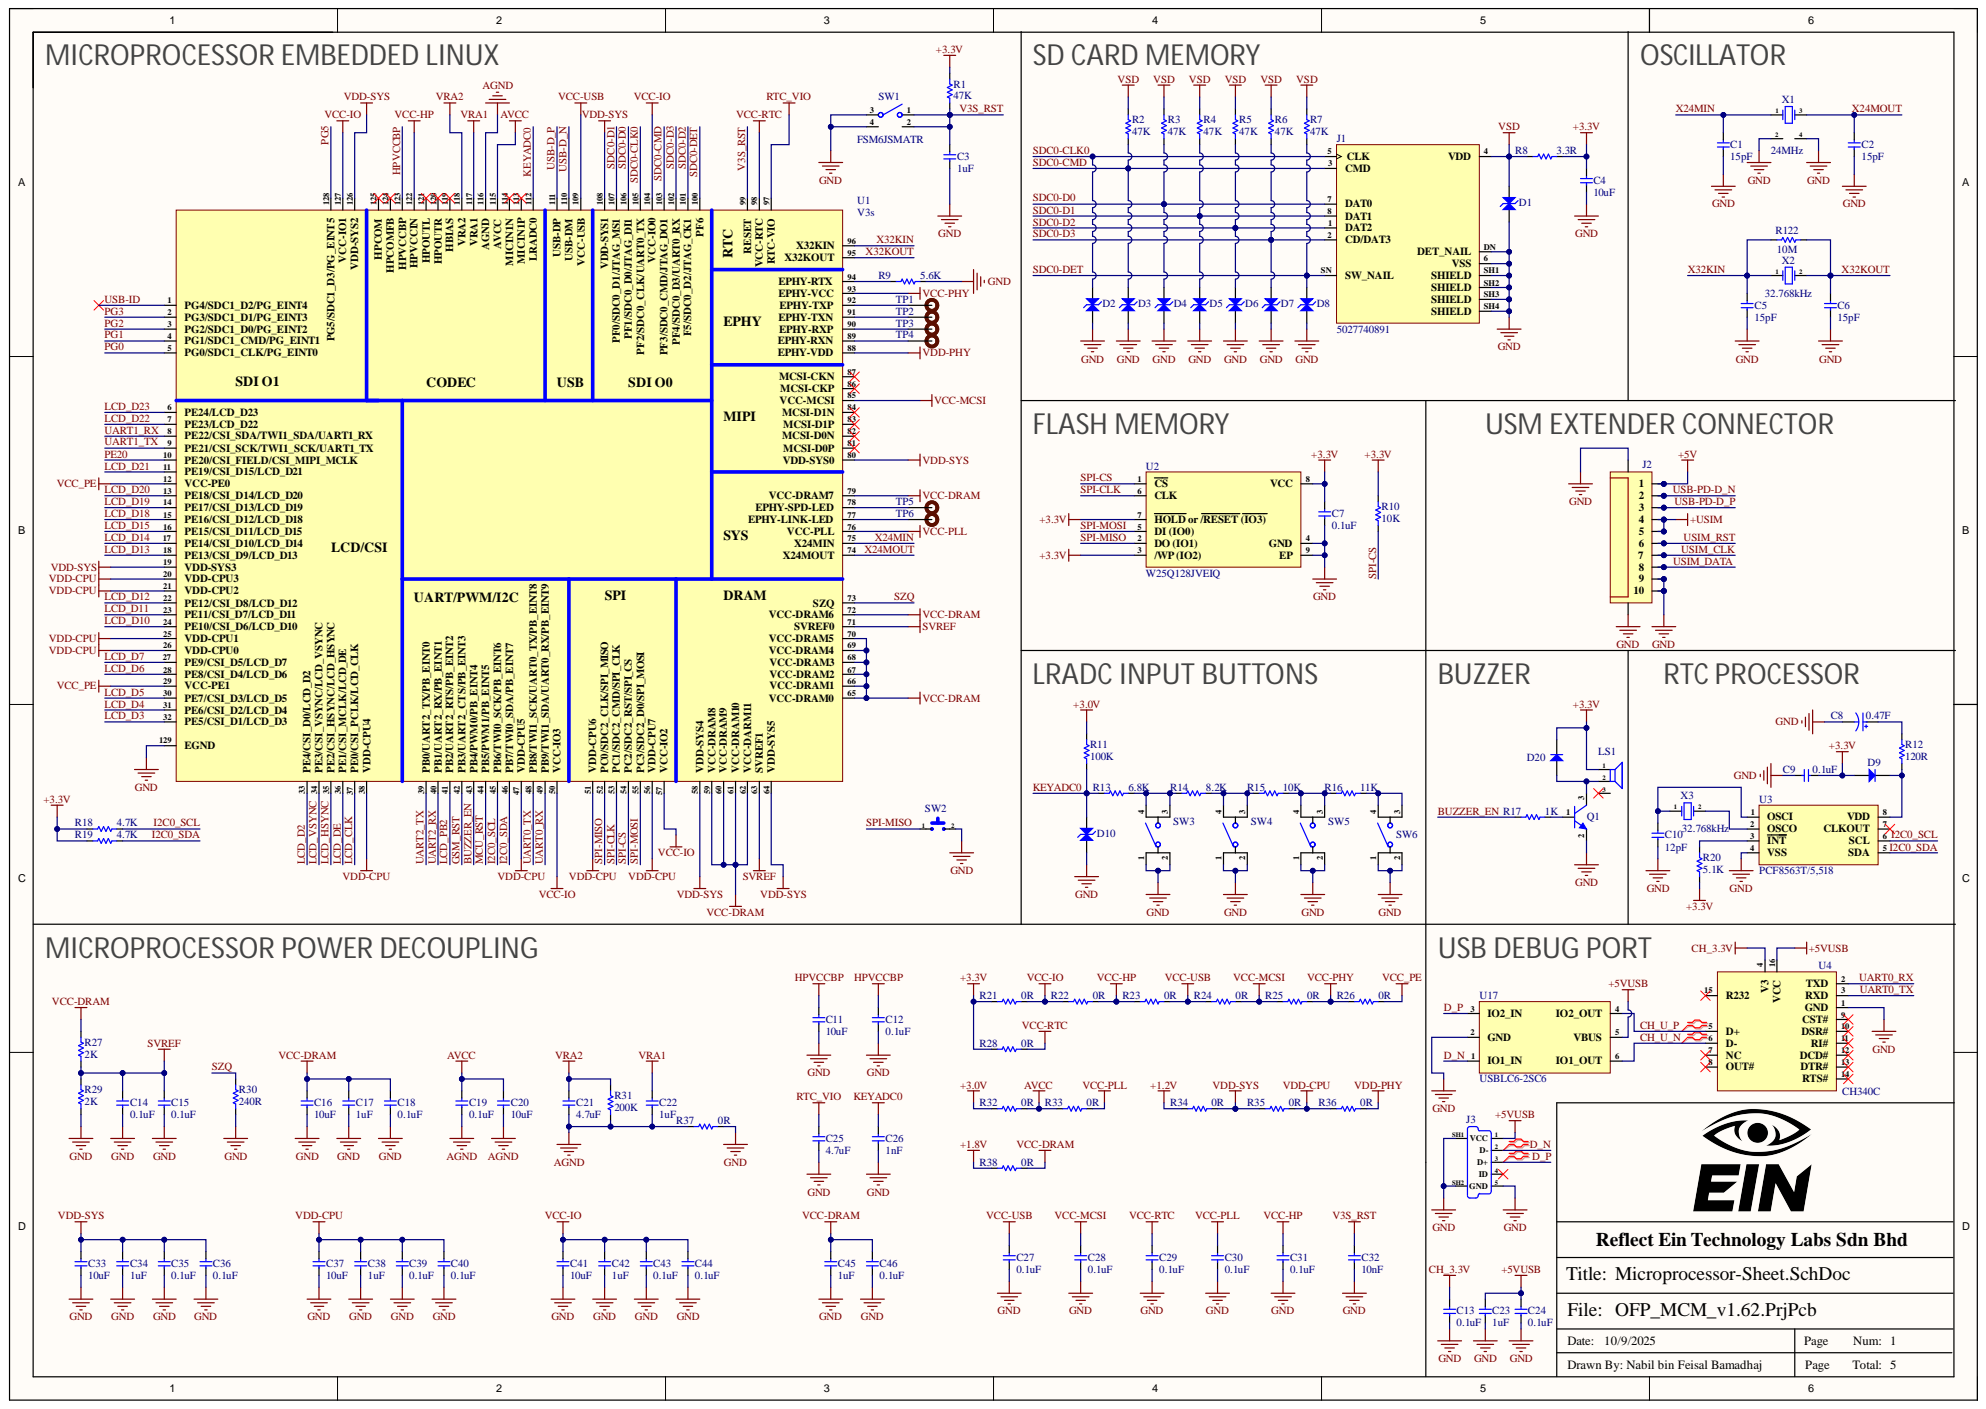
[picture p119: page 1]

VDD-SYS5 64 SVREF1 63 VCC-DARM11 62 VCC-DRAM10 61 VCC-DRAM9 60 VCC-DRAM8 59 VDD-SYS4 58

VCC-IO SPI-MISO

VDD-CPU
VCC-IO

Reflect Ein Technology Labs Sdn Bhd

Date: 10/9/2025 | Page Num: 1

Drawn By: Nabil bin Feisal Bamadhaj | Page Total:

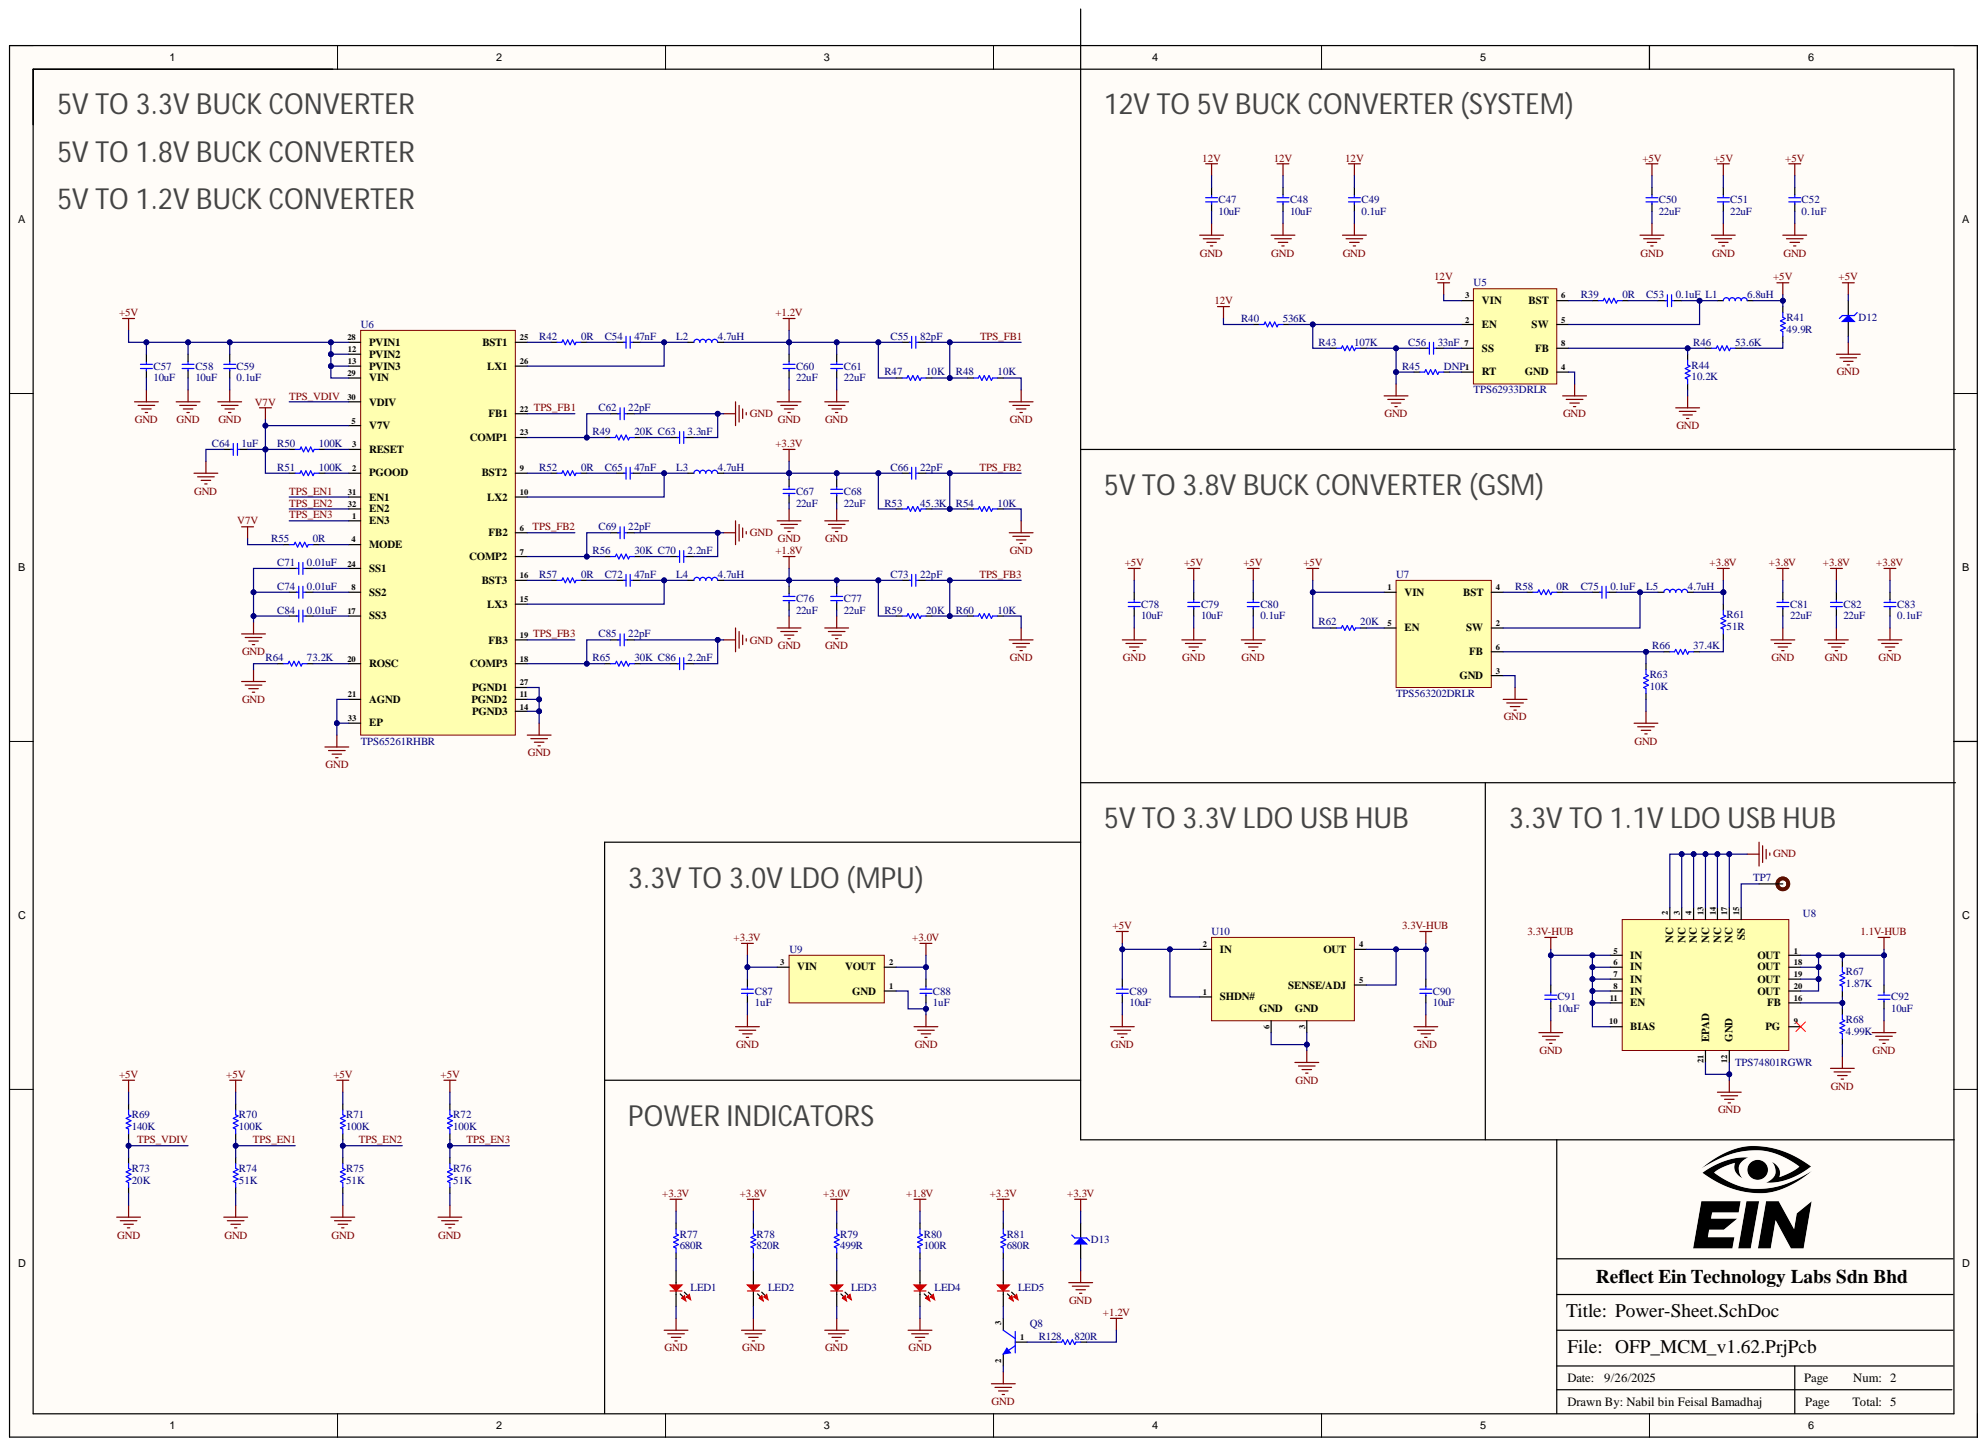
[picture p120: page 2]

12V TO 5V BUCK CONVERTER (SYSTEM)

5V TO 3.8V BUCK CONVERTER (GSM)

Reflect Ein Technology Labs Sdn Bhd

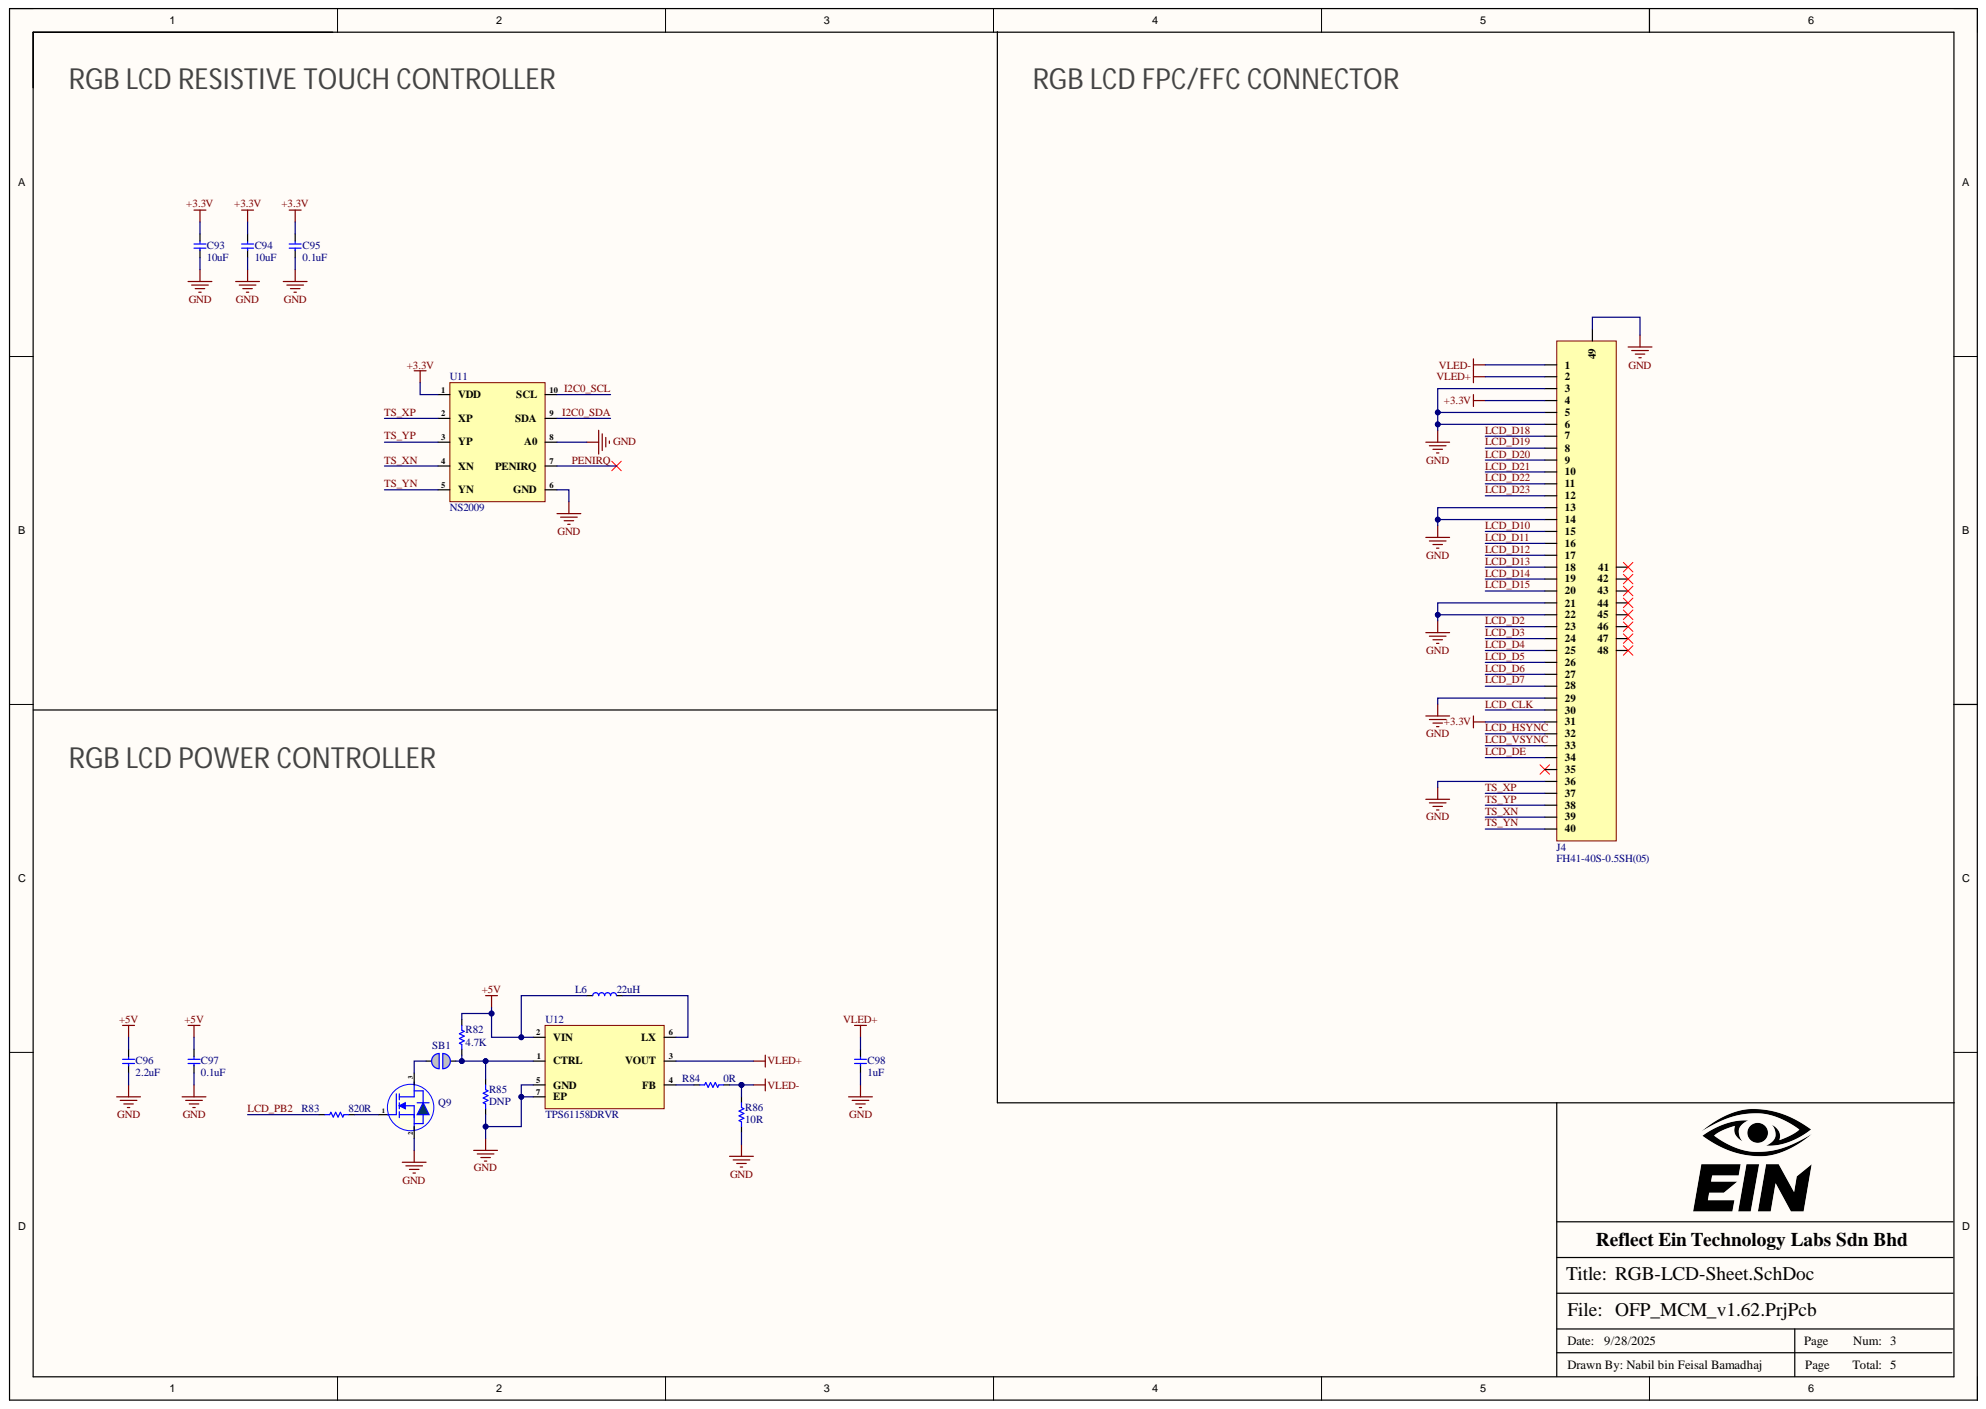
[picture p121: page 3]

RGB LCD FPC/FFC CONNECT

RGB LCD POWER CONTROLLER

1 | CTR L VOU T GN D FB EP

Reflect Ein Technology Labs Sdn Bhd

Date : 9/2 8/2 0 2 5 | P a g e Nu m : 35

Drawn By: Nabil bin F eisal Ba m a d h aj | P a g e T ota l :

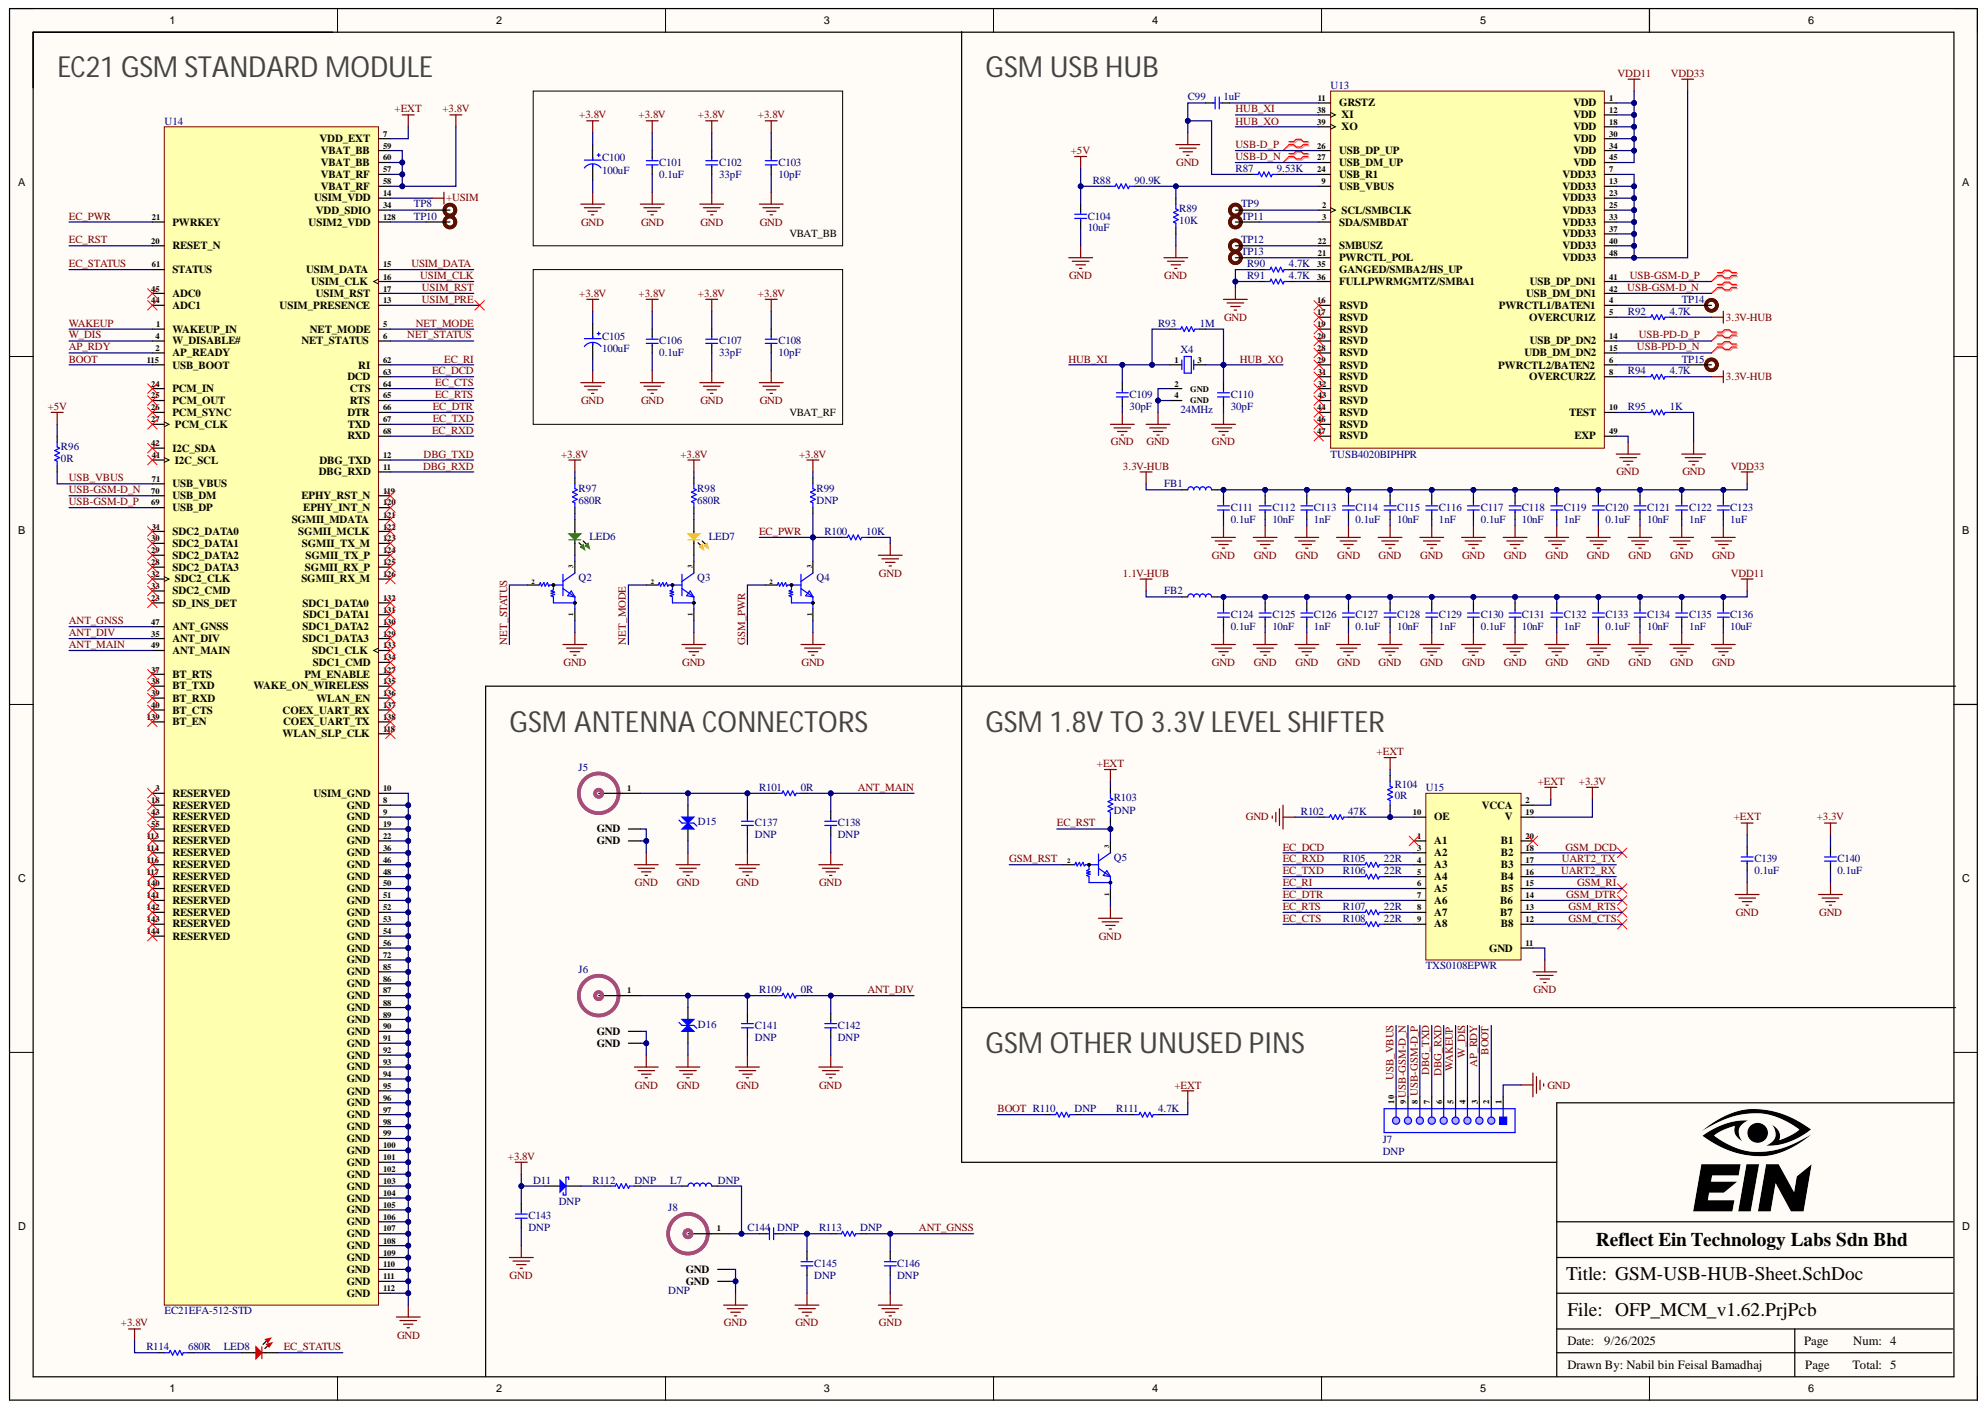
[picture p122: page 4]

GSM 1.8V TO 3.3V LEVEL SHIFTER

GSM OTHER UNUSED PINS

Reflect Ein Technology Labs Sdn Bhd

GSM-USB-HUB-Sheet.SchDoc

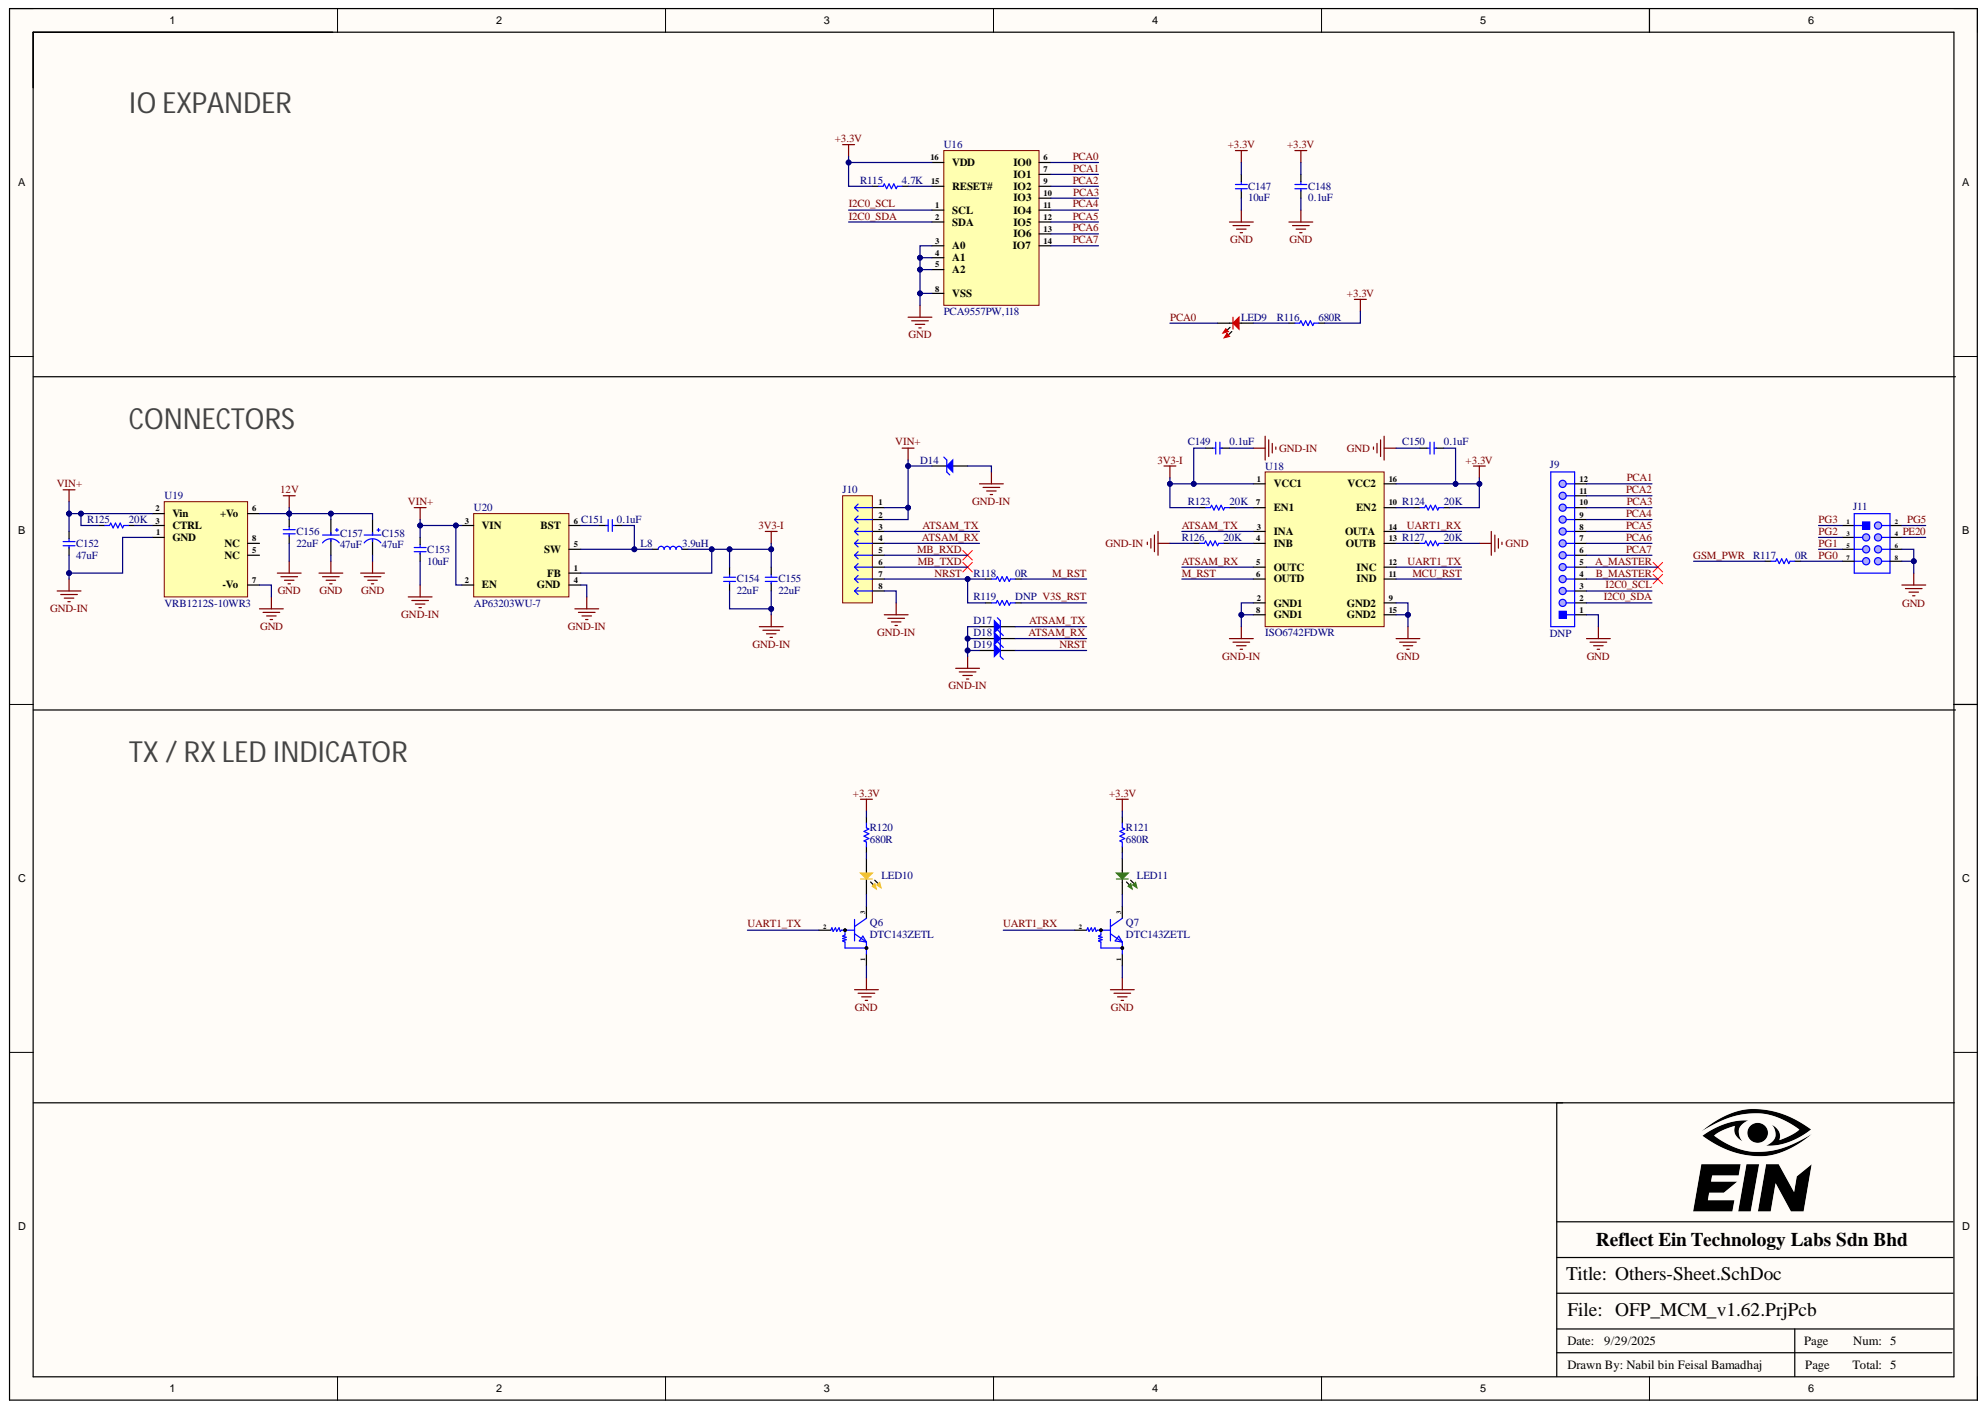
[picture p123: page 5]

D18
D19

TX / RX LED INDICATOR

Reflect Ein Technology Labs Sdn Bhd

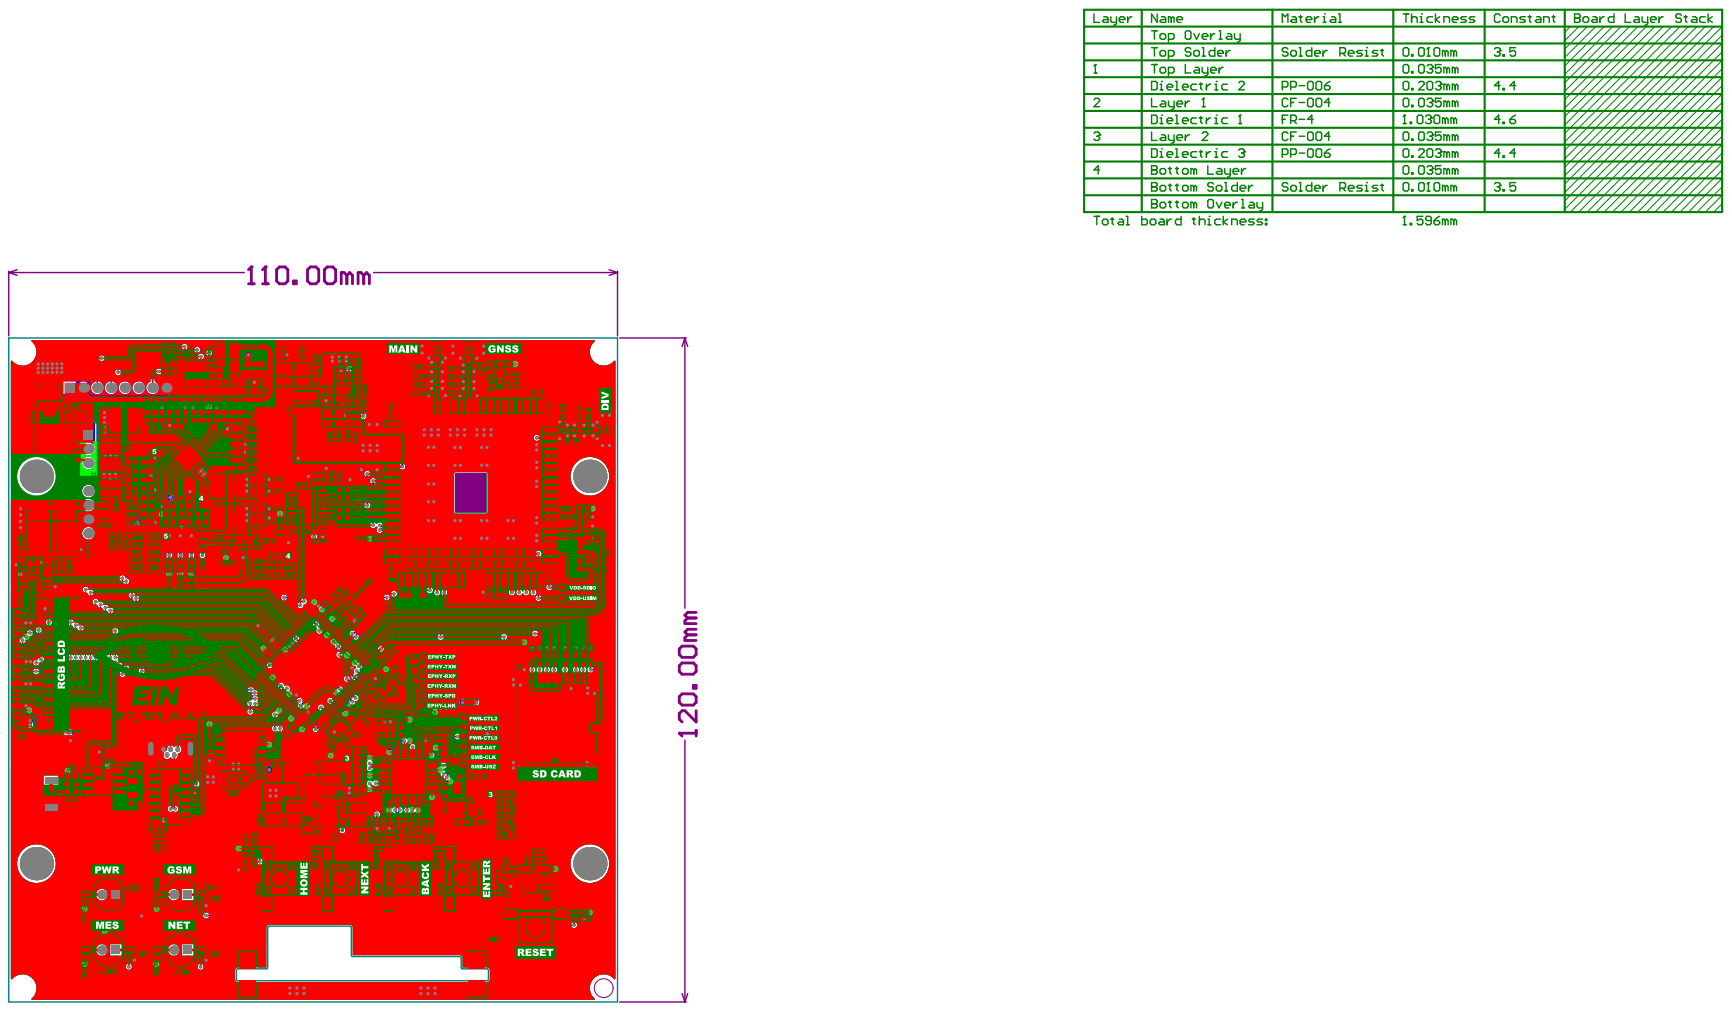
[picture p124: page 6]
