eSpark-Backup/nabilfesal-smartmeter-hw/Design-Files/OFP_VIM_DC_v1.51/Deliverables/Assembly Drawings/OFP_VIM_DC_v1.51.pdf

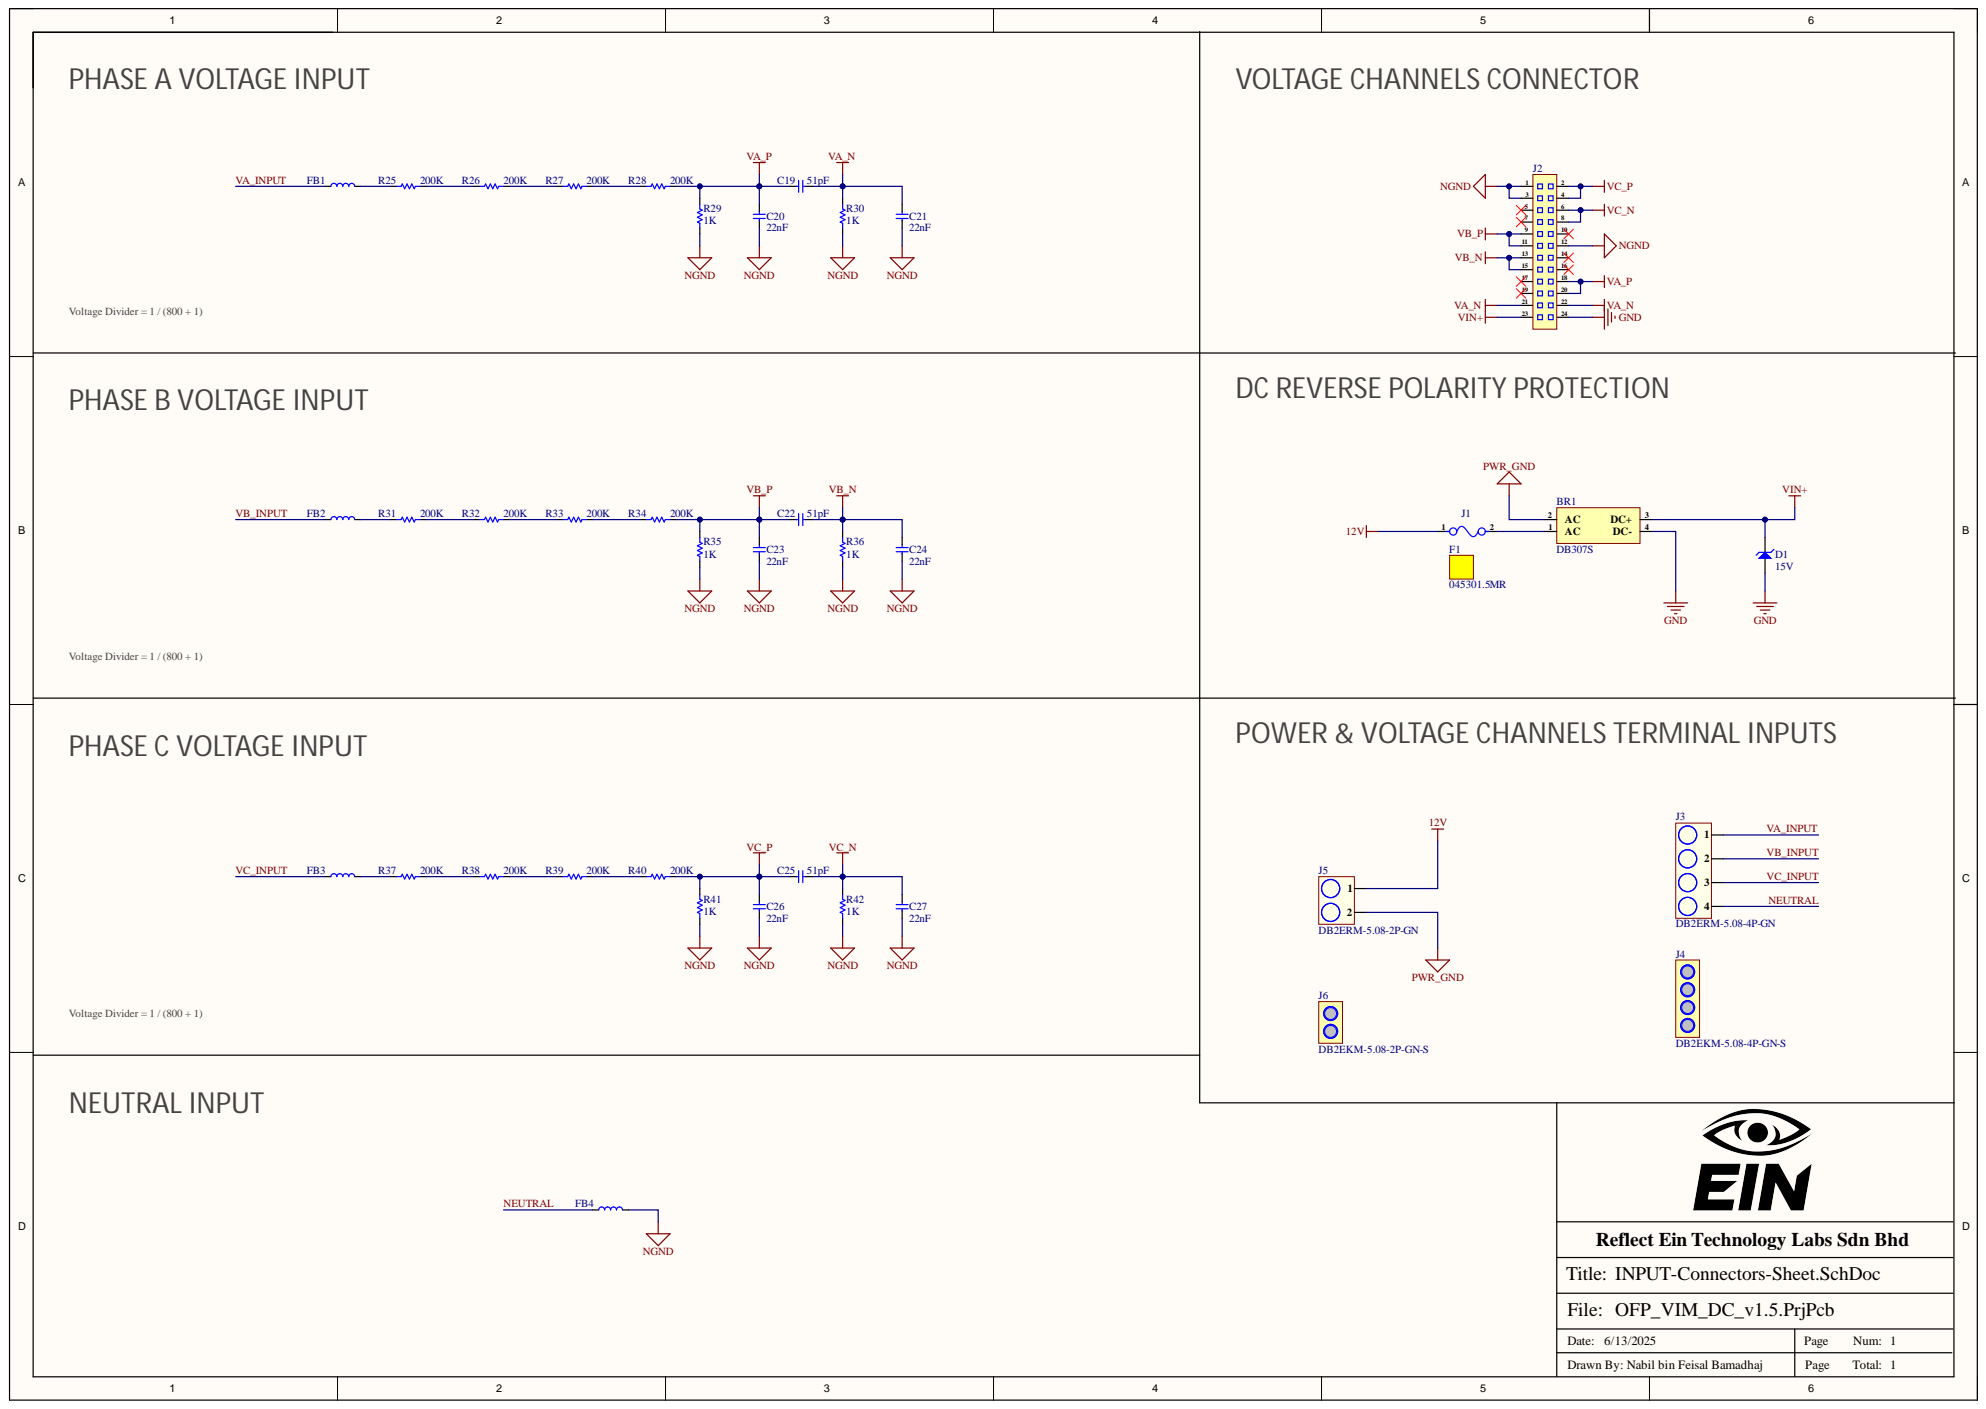
[picture p125: page 1]

PHASE A VOLTAGE INPUT VA_P VA_N C20 C21 Voltage Divider = 1 / (800 + 1) | VOLTAGE CHANNELS CONNECTOR J2

DC REVERSE POLARITY PROTECTION

PHASE C VOLTAGE INPUT VC_P VC_N C26 C27 Voltage Divider = 1 / (800 + 1) | POWER & VOLTAGE CHANNELS TERMINAL INPUTS J3

Reflect Ein Technology Labs Sdn Bhd

INPUT-Connectors-Sheet.SchDoc

Date: 6/13/2025 | Page Num: 1

Drawn By: Nabil bin Feisal Bamadhaj | Page Total: 1

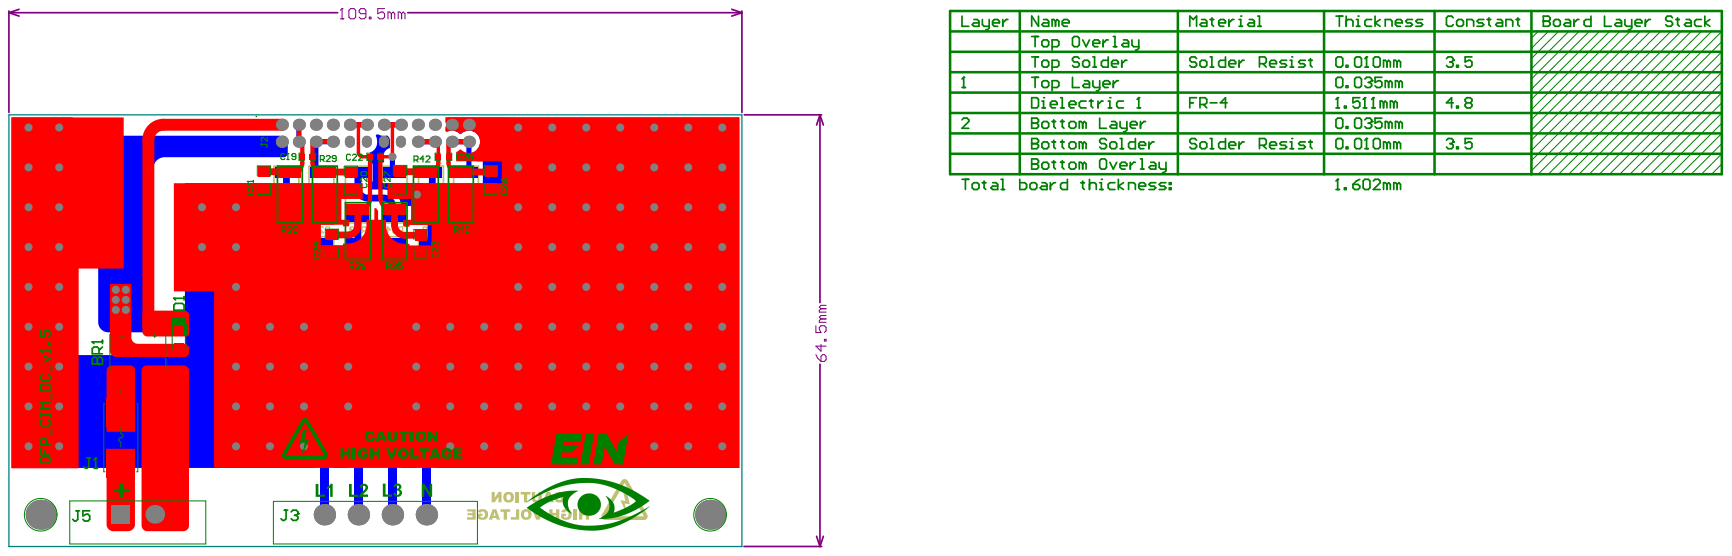
[picture p126: page 2]
