eSpark-Backup/nabilfesal-smartmeter-hw/Design-Files/OFP_CIM_v1.5/Deliverables/_Schematics/OFP_CIM_v1.5.pdf

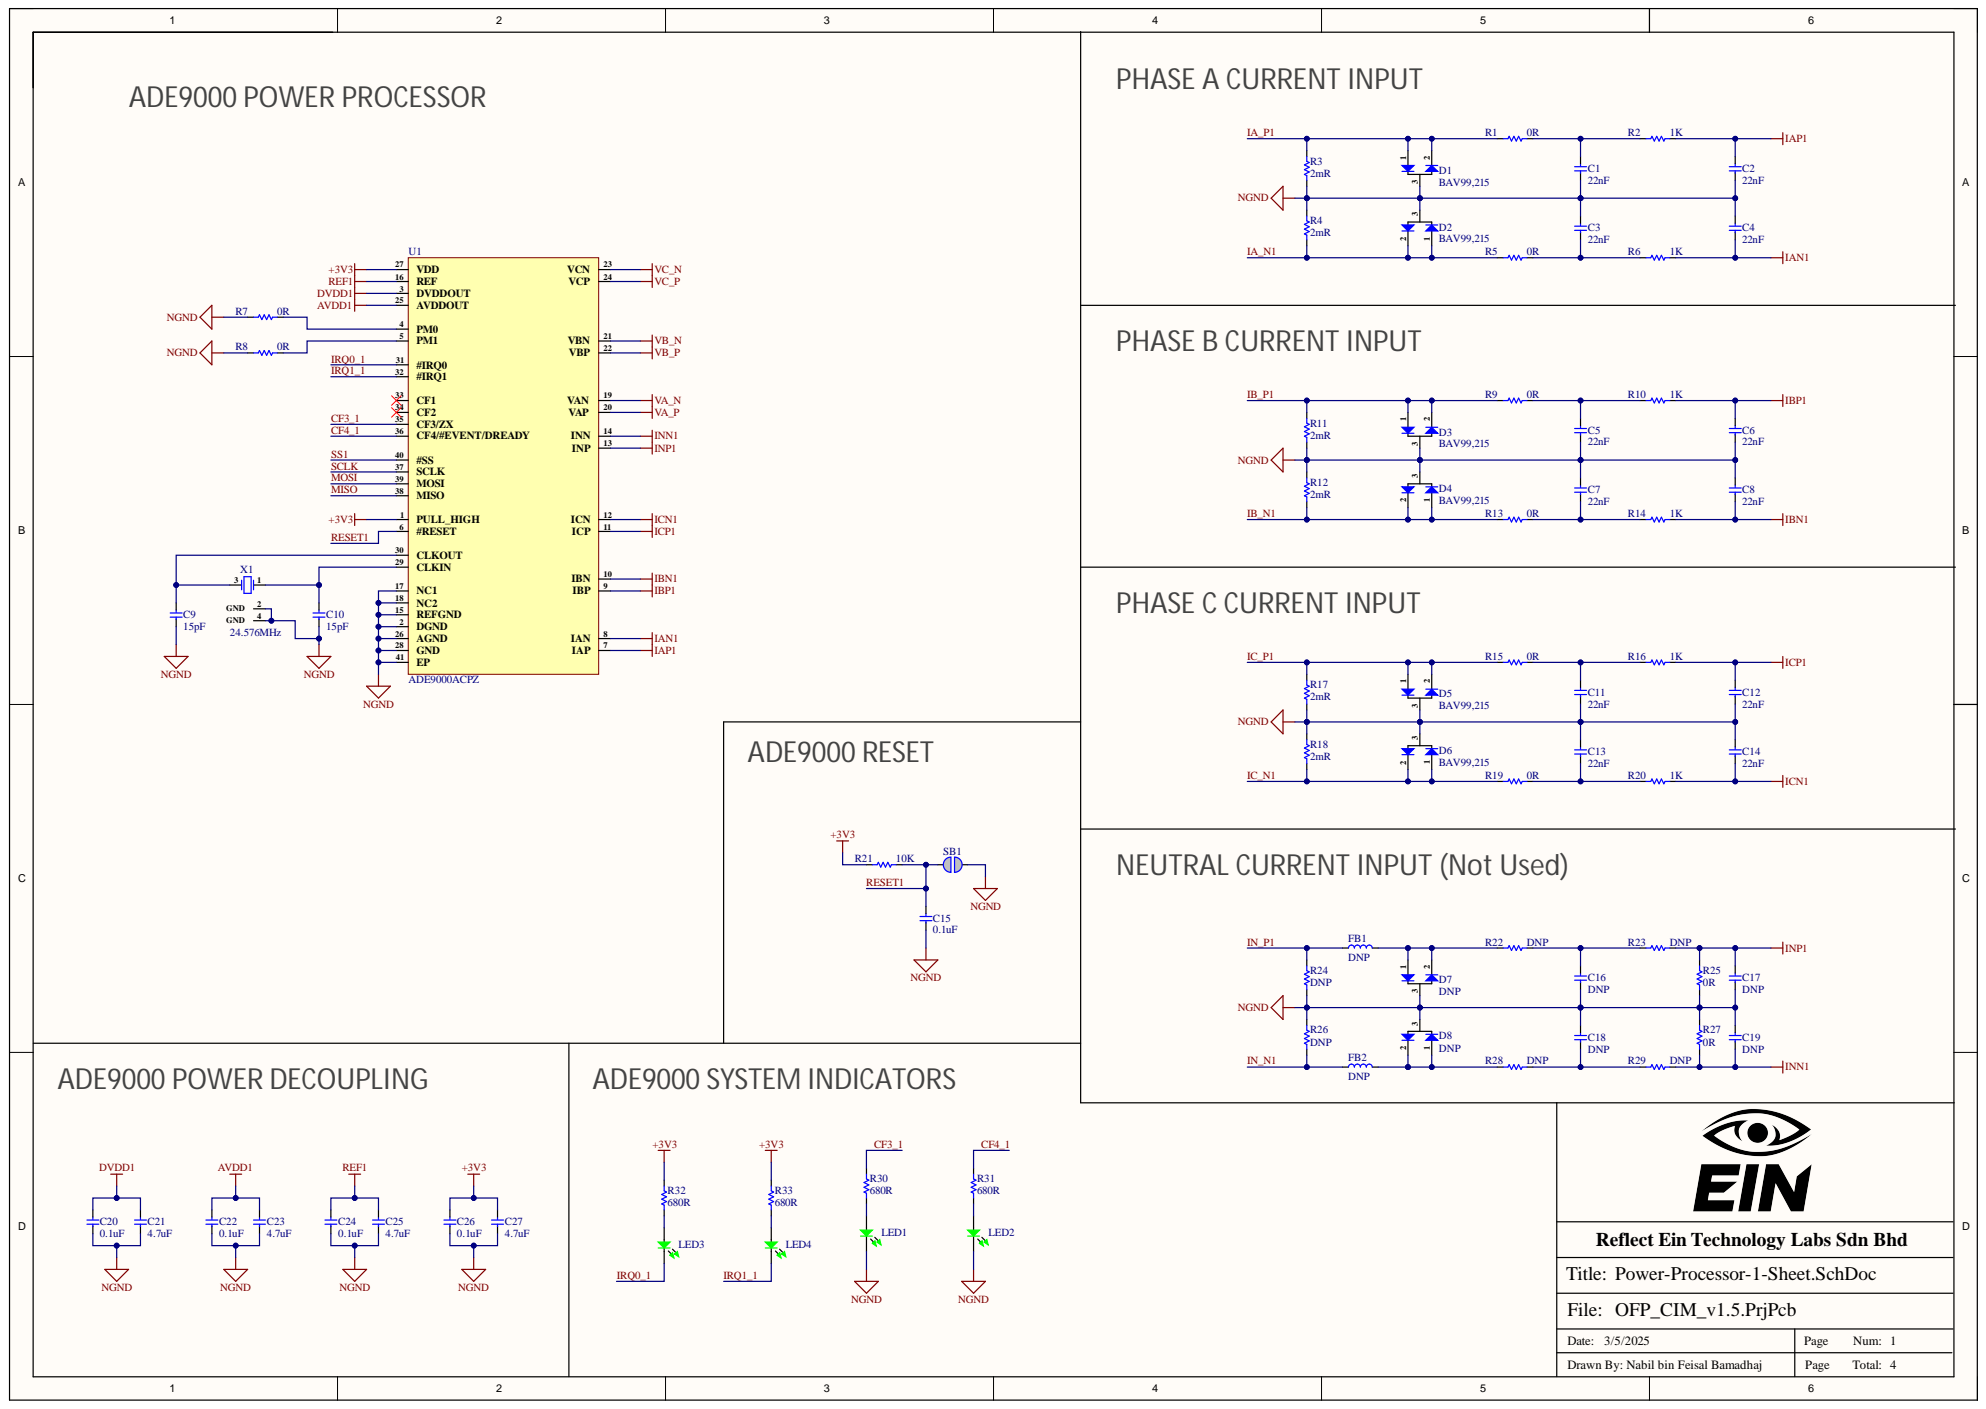
[picture p127: page 1]

ADE9000 POWER PROCESSO R U1 | PHASE A CURRENT INPUT D1 C1 C2

NEUTRAL CURRENT INPUT (Not Used)

Reflect Ein Technology Labs Sdn Bhd

Date : 3/5/2 0 2 5 | P a g e Nu m : 14

Drawn By: Nabil bin F eisal Ba m d h aj | P a g e T ota l :

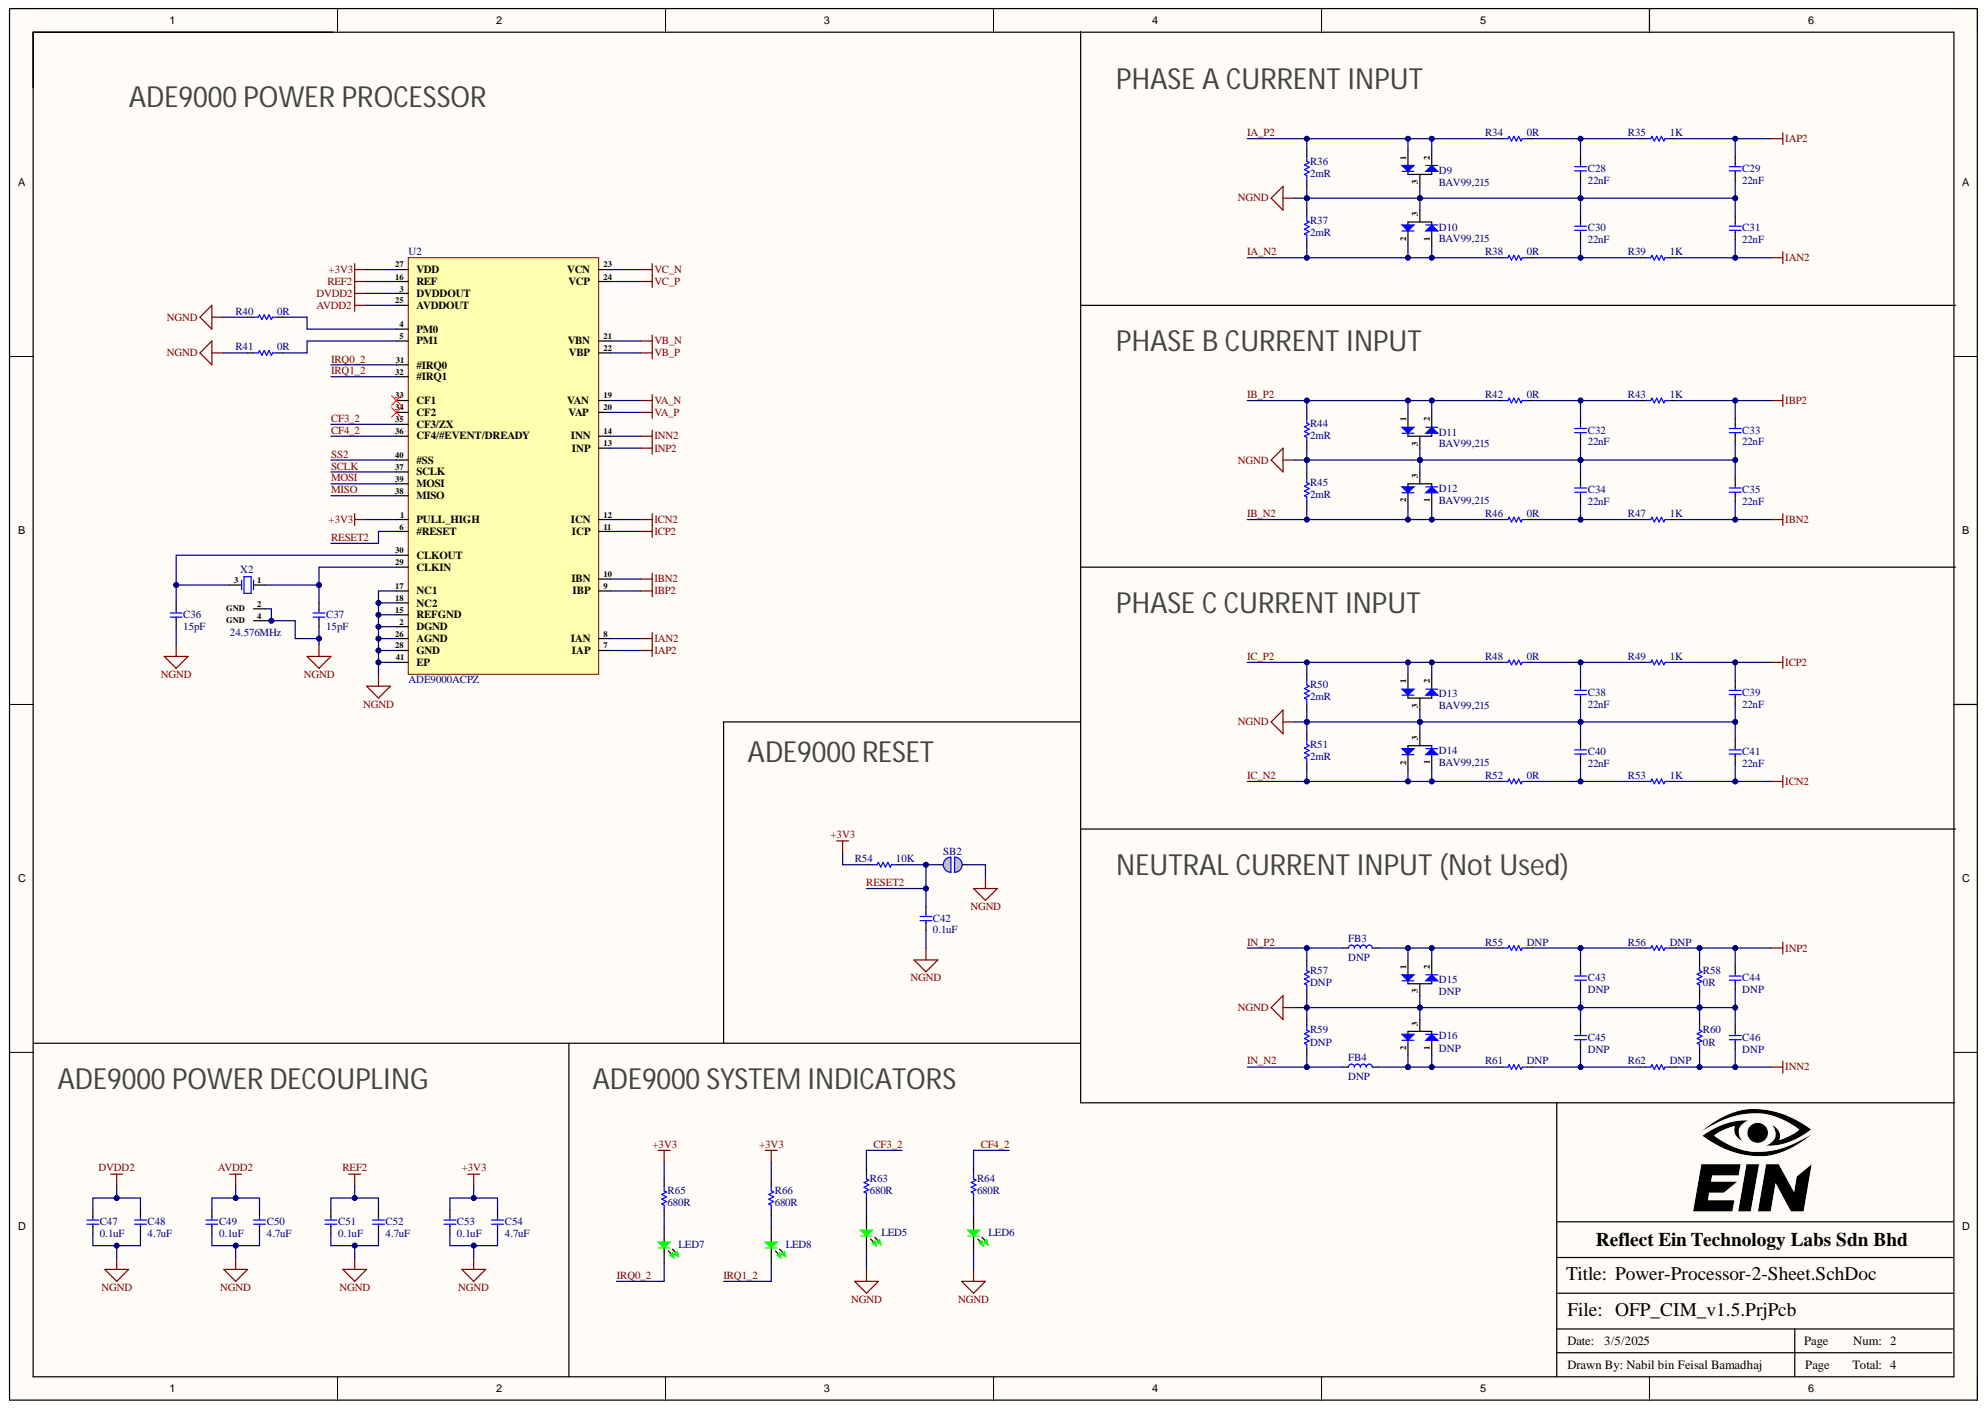
[picture p128: page 2]

ADE9000 POWER PROCESSO R U2 | PHASE A CURRENT INPUT D9 C28 C29

NEUTRAL CURRENT INPUT (Not Used)

Reflect Ein Technology Labs Sdn Bhd

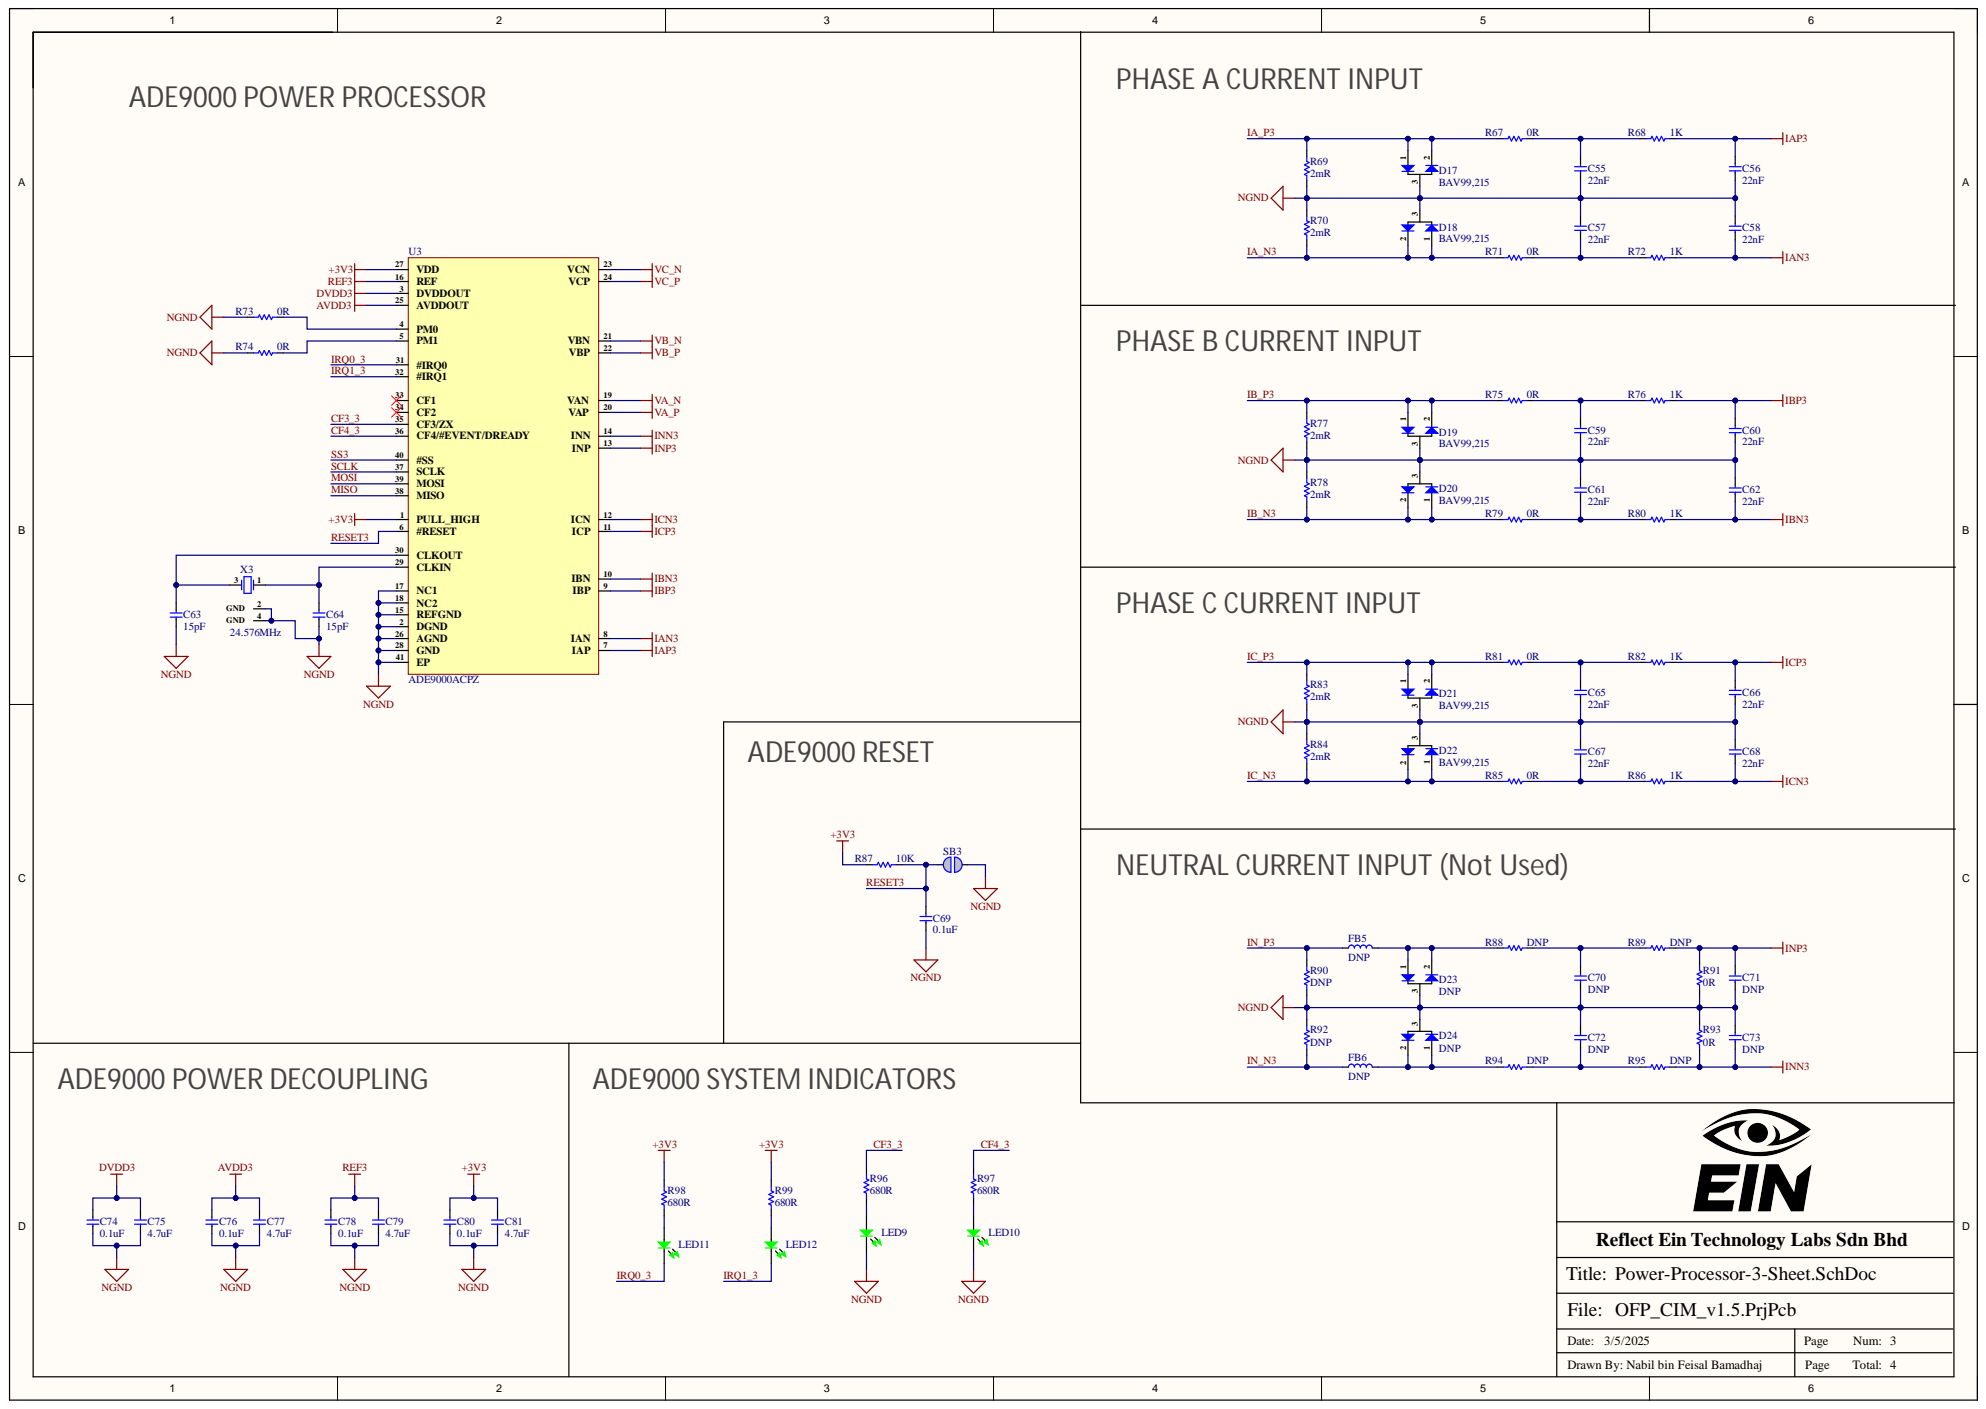
[picture p129: page 3]

ADE9000 POWER PROCESSO R U3 | PHASE A CURRENT INPUT D17 C55 C56

NEUTRAL CURRENT INPUT (Not Used)

Reflect Ein Technology Labs Sdn Bhd

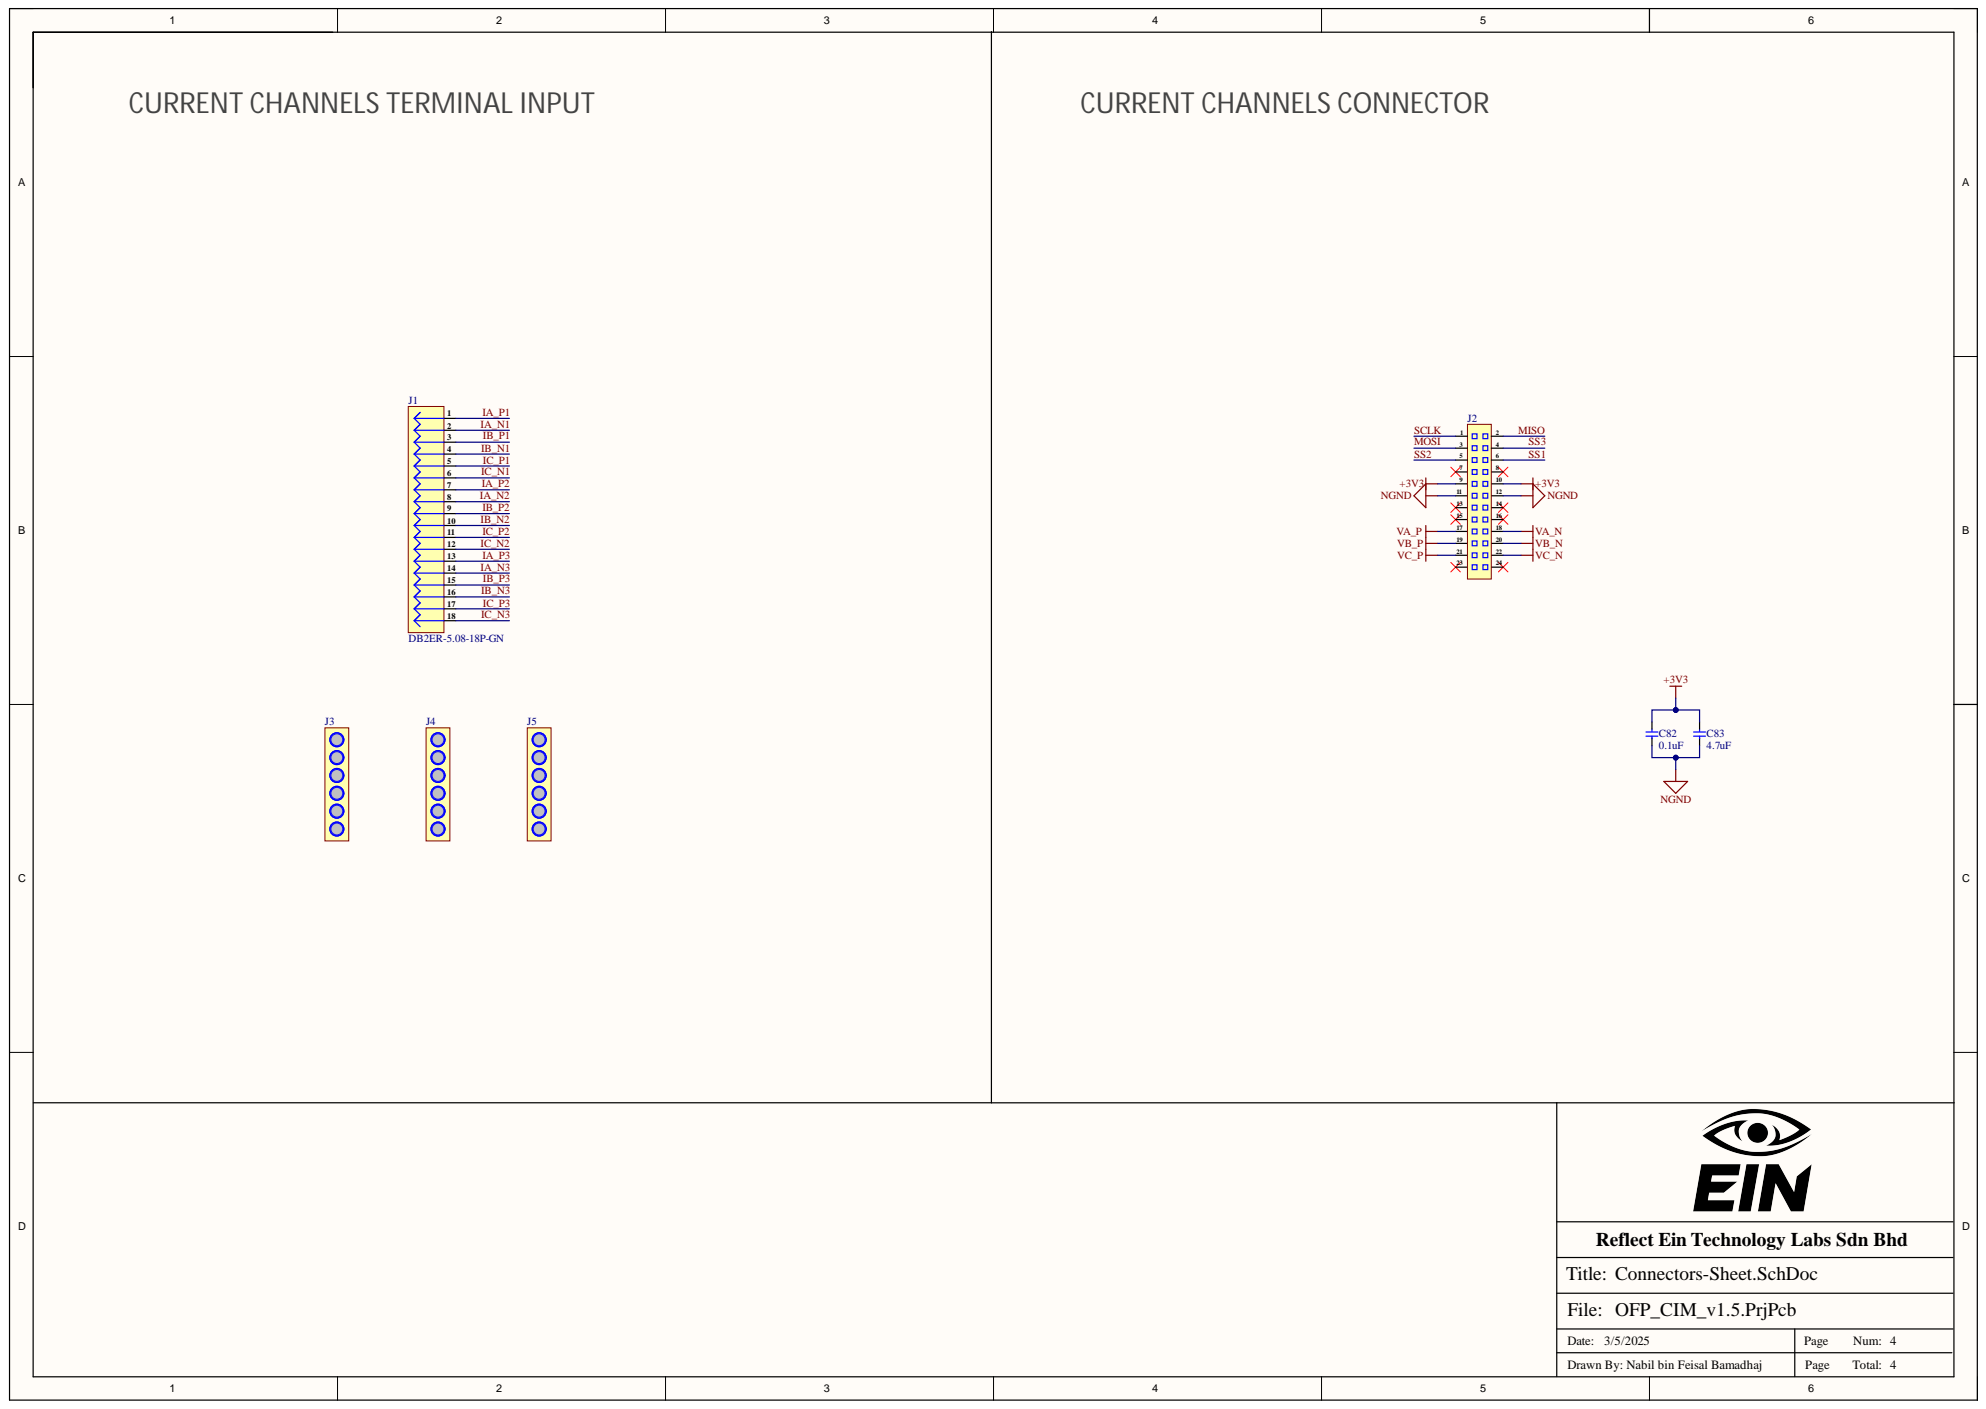
[picture p130: page 4]

Reflect Ein Technology Labs Sdn Bhd

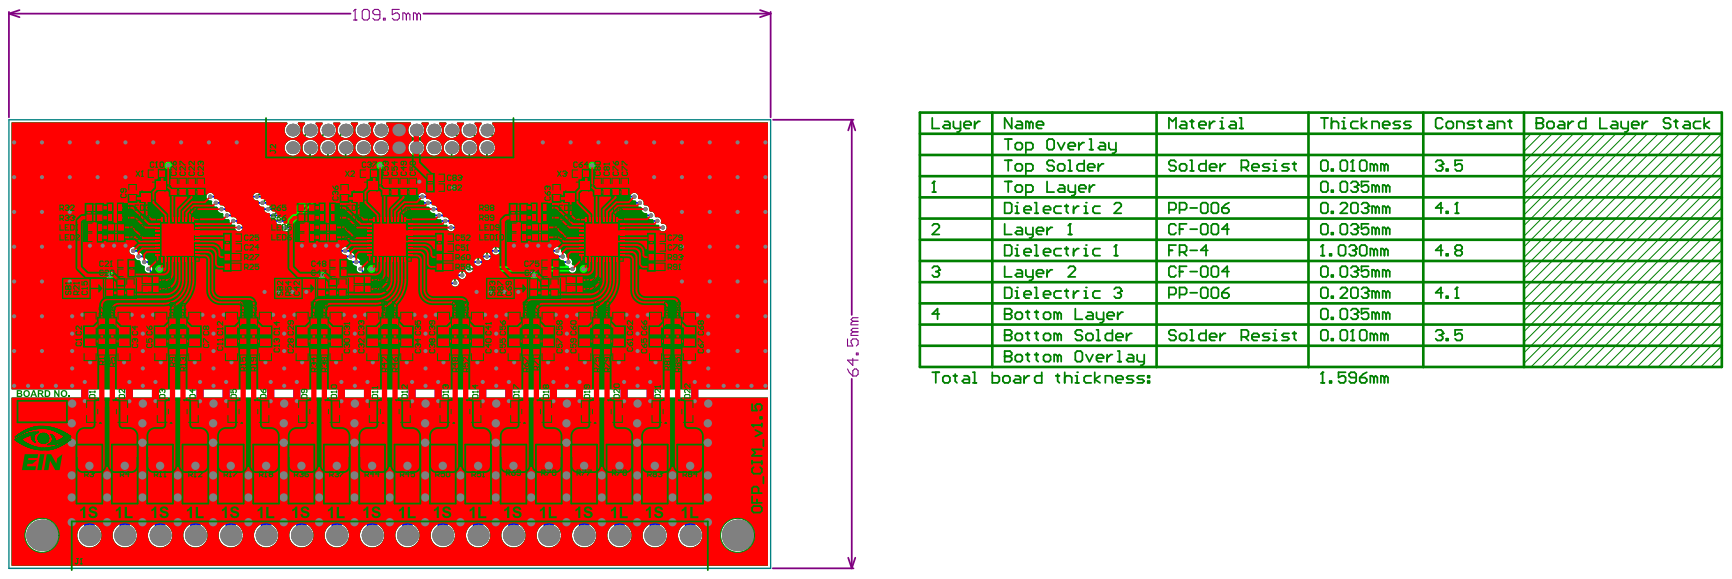
[picture p131: page 5]
