eSpark-Backup/nabilfesal-smartmeter-hw/Design-Files/OFP_VIM_v1.51/Deliverables/Assembly Drawings/OFP_VIM_v1.51.pdf

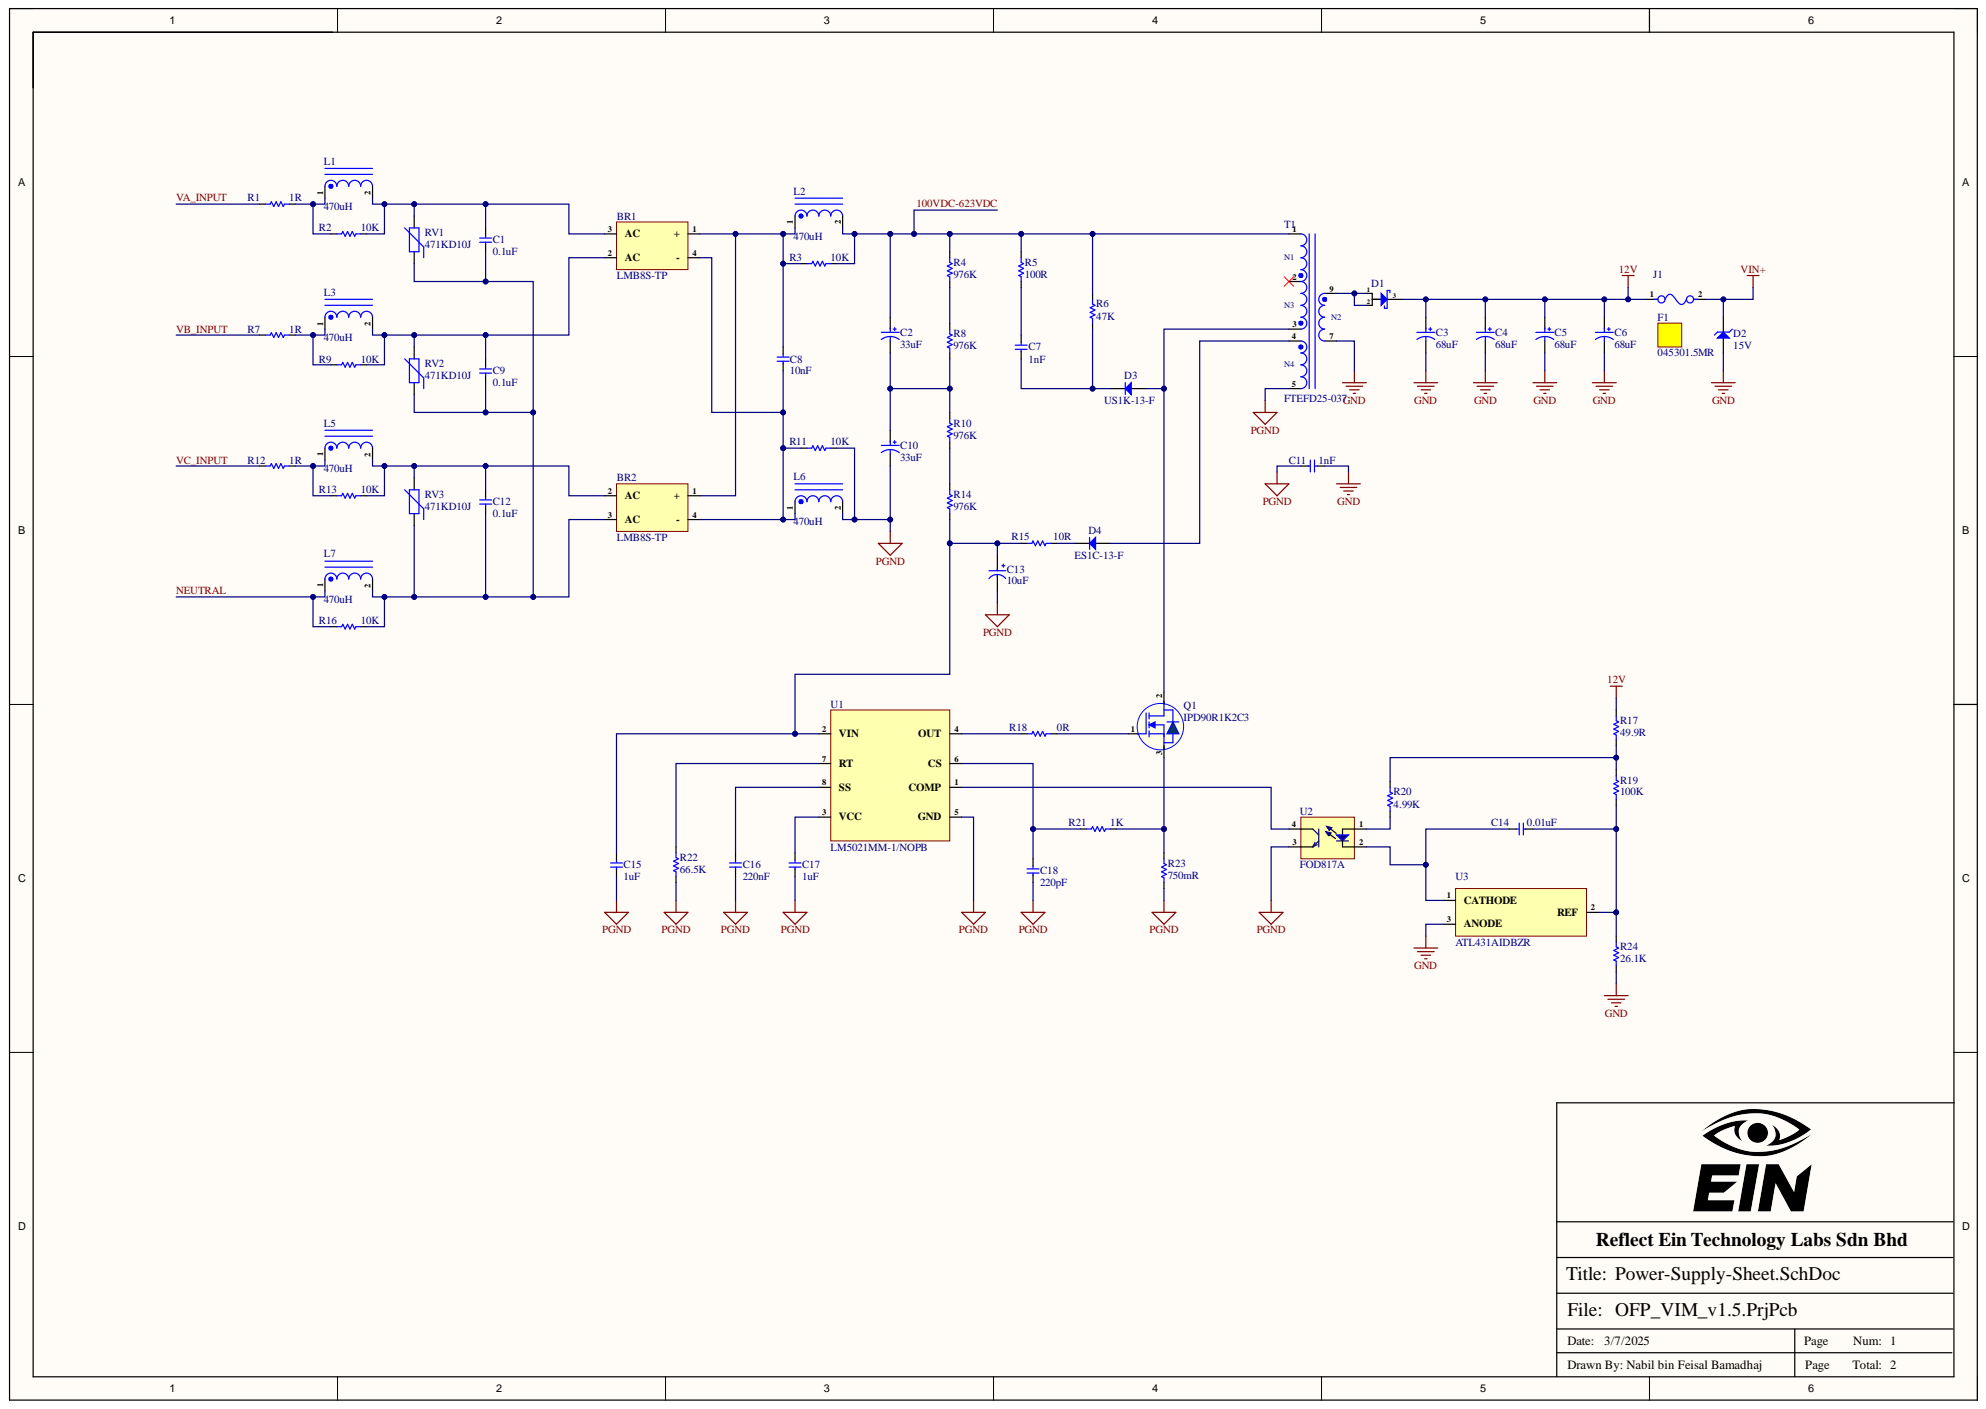
[picture p132: page 1]

7 | VIN OU T RT CS SS COM P VC C GN D | 6

Reflect Ein Technology Labs Sdn Bhd

Date : 3/7/2 0 2 5 | P a g e Nu m : 12

Drawn By: Nabil bin F eisal Ba m a d h aj | P a g e T ota l :

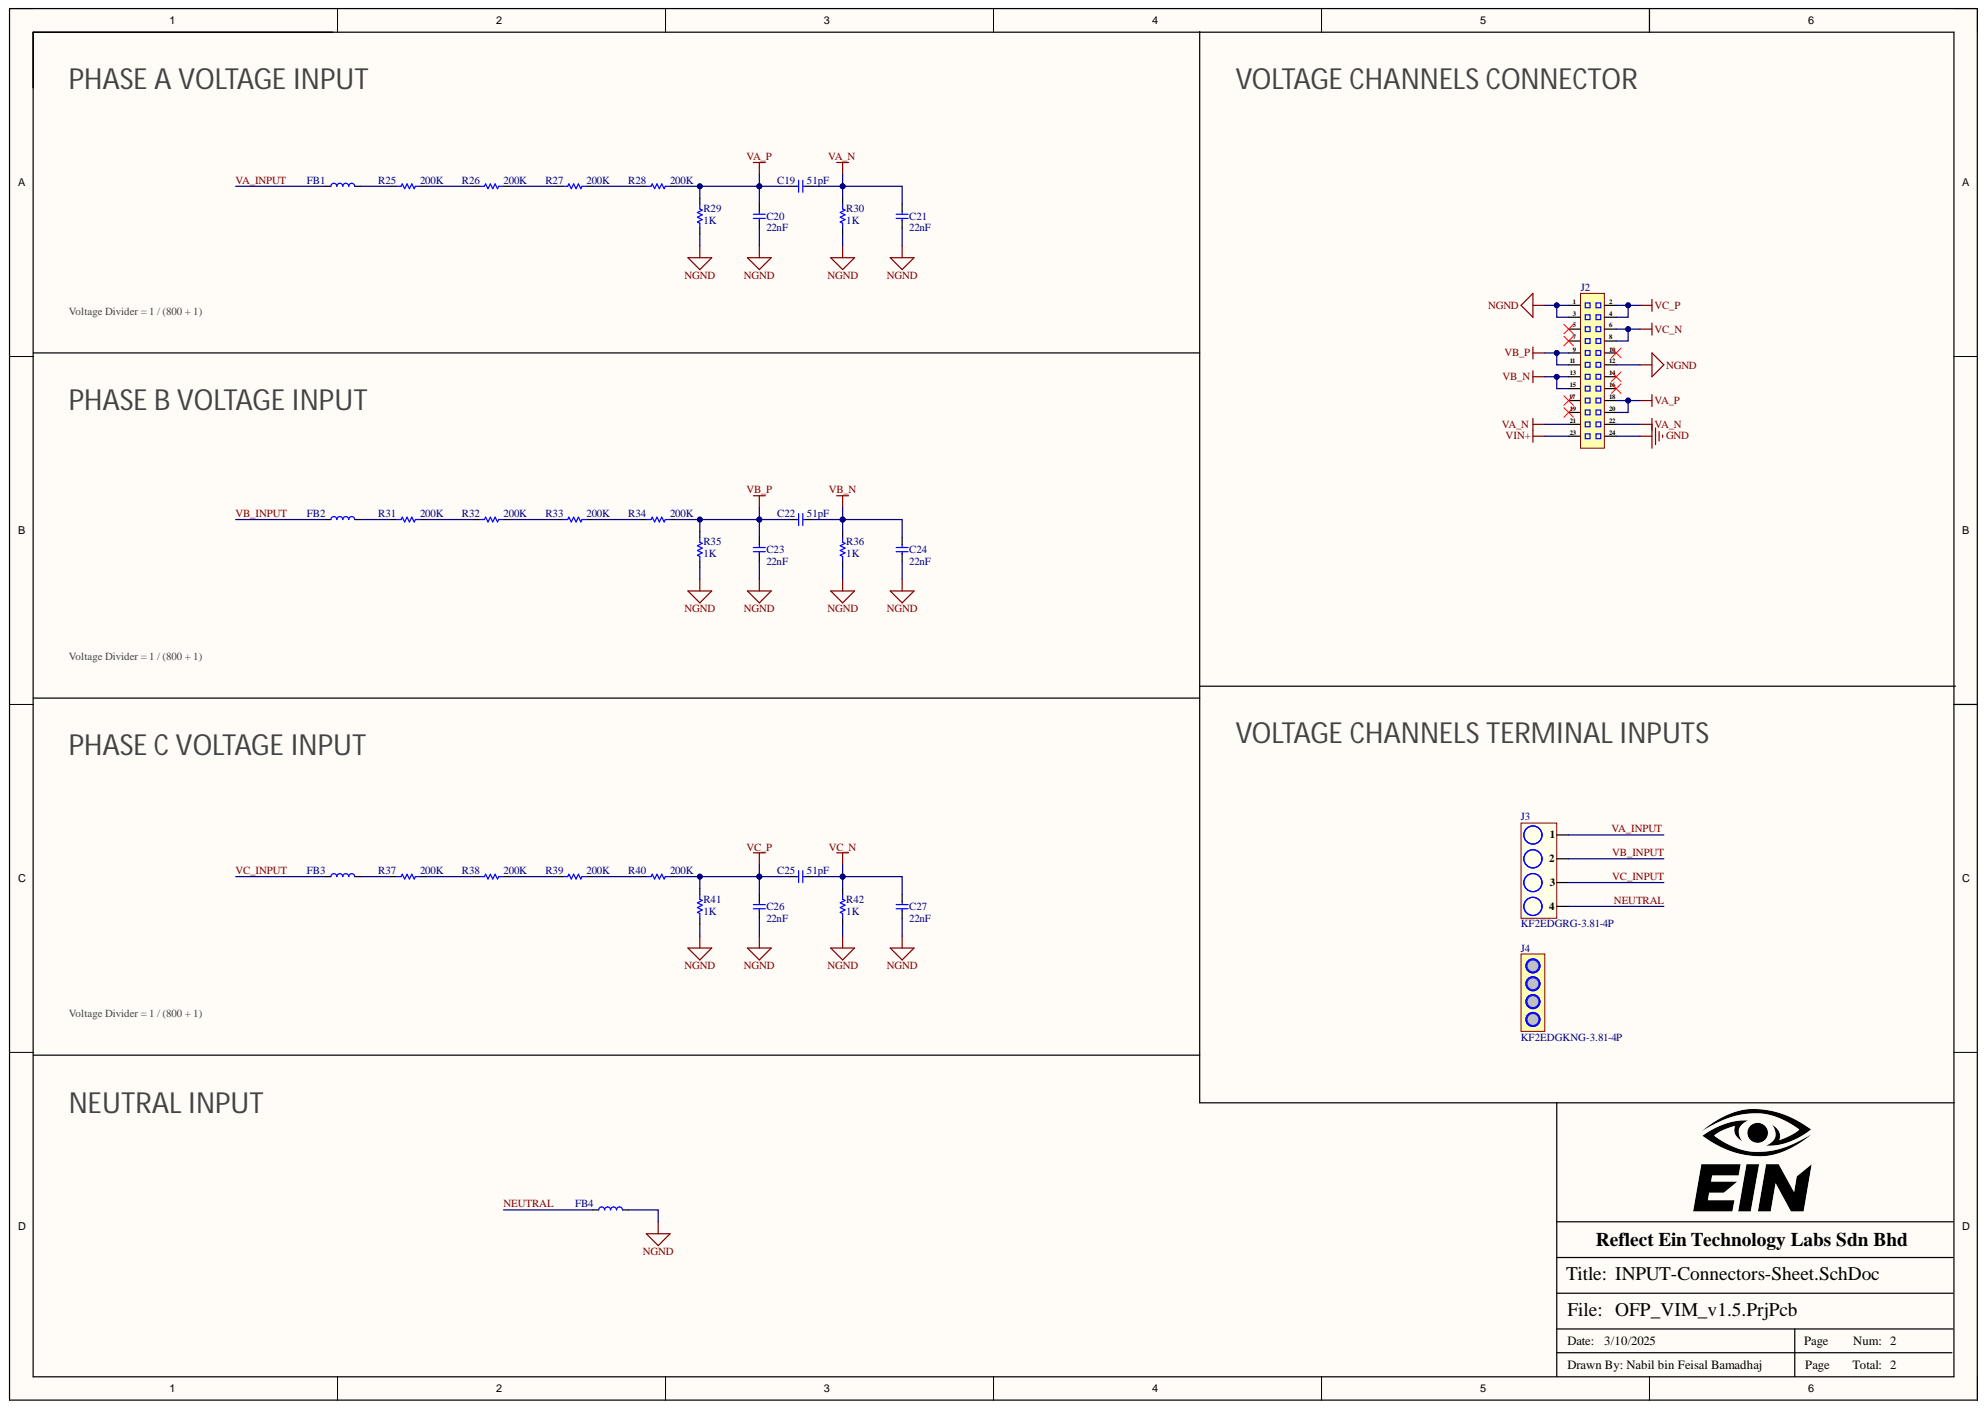
[picture p133: page 2]

PHASE A VOLTAGE INPUT VA_P VA_N C20 C21 Voltage Divider = 1 / (800 + 1) | J2

VOLTAGE CHANNELS TERMINAL INPUTS

Reflect Ein Technology Labs Sdn Bhd

INPUT-Connectors-Sheet.SchDoc

Date: 3/10/2025 | Page Num: 2

Drawn By: Nabil bin Feisal Bamadhaj | Page Total: 2

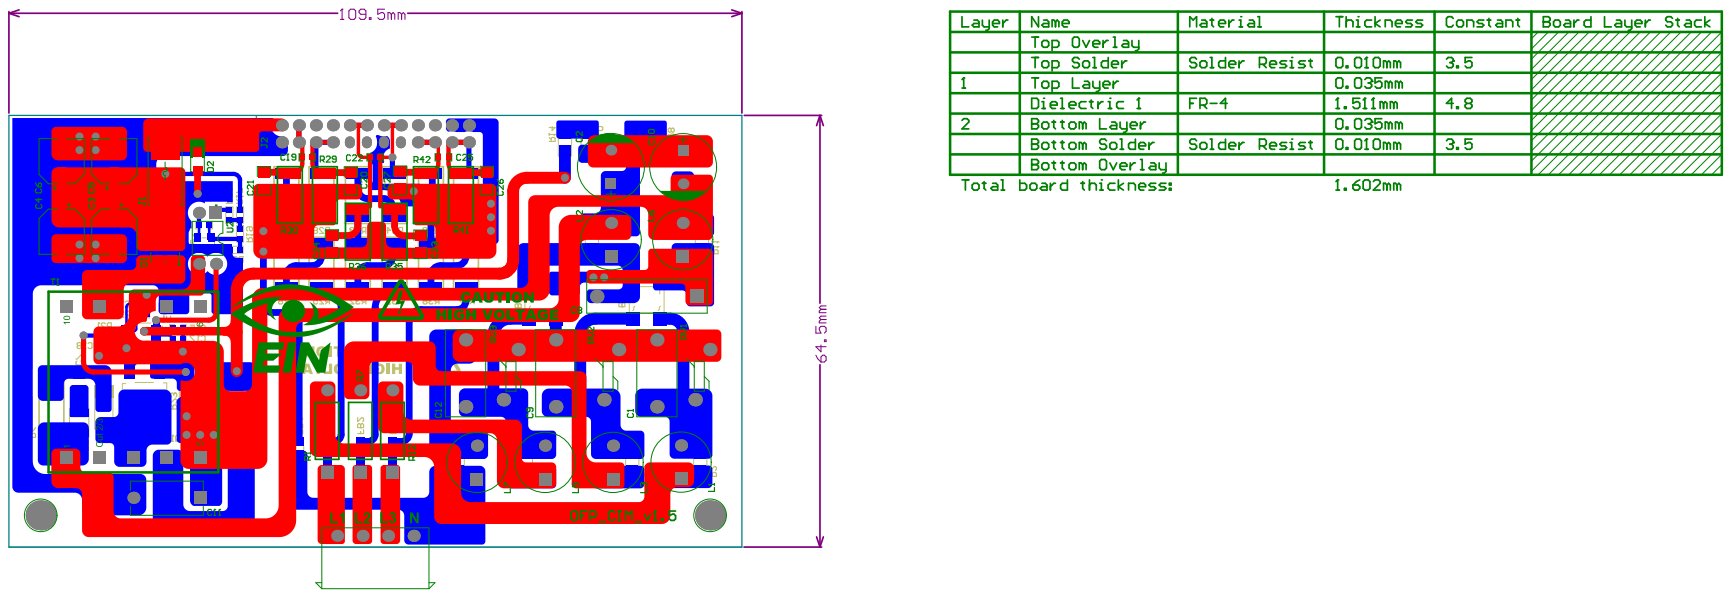
[picture p134: page 3]
