eSpark-Backup/nabilfesal-smartmeter-hw/docs/Client-Files/Product Files/MSM-Documentation-24122024/Schematic/Schematic_MSM_V1.4.pdf

## PHASE A CURRENT INPUT

## PHASE B CURRENT INPUT

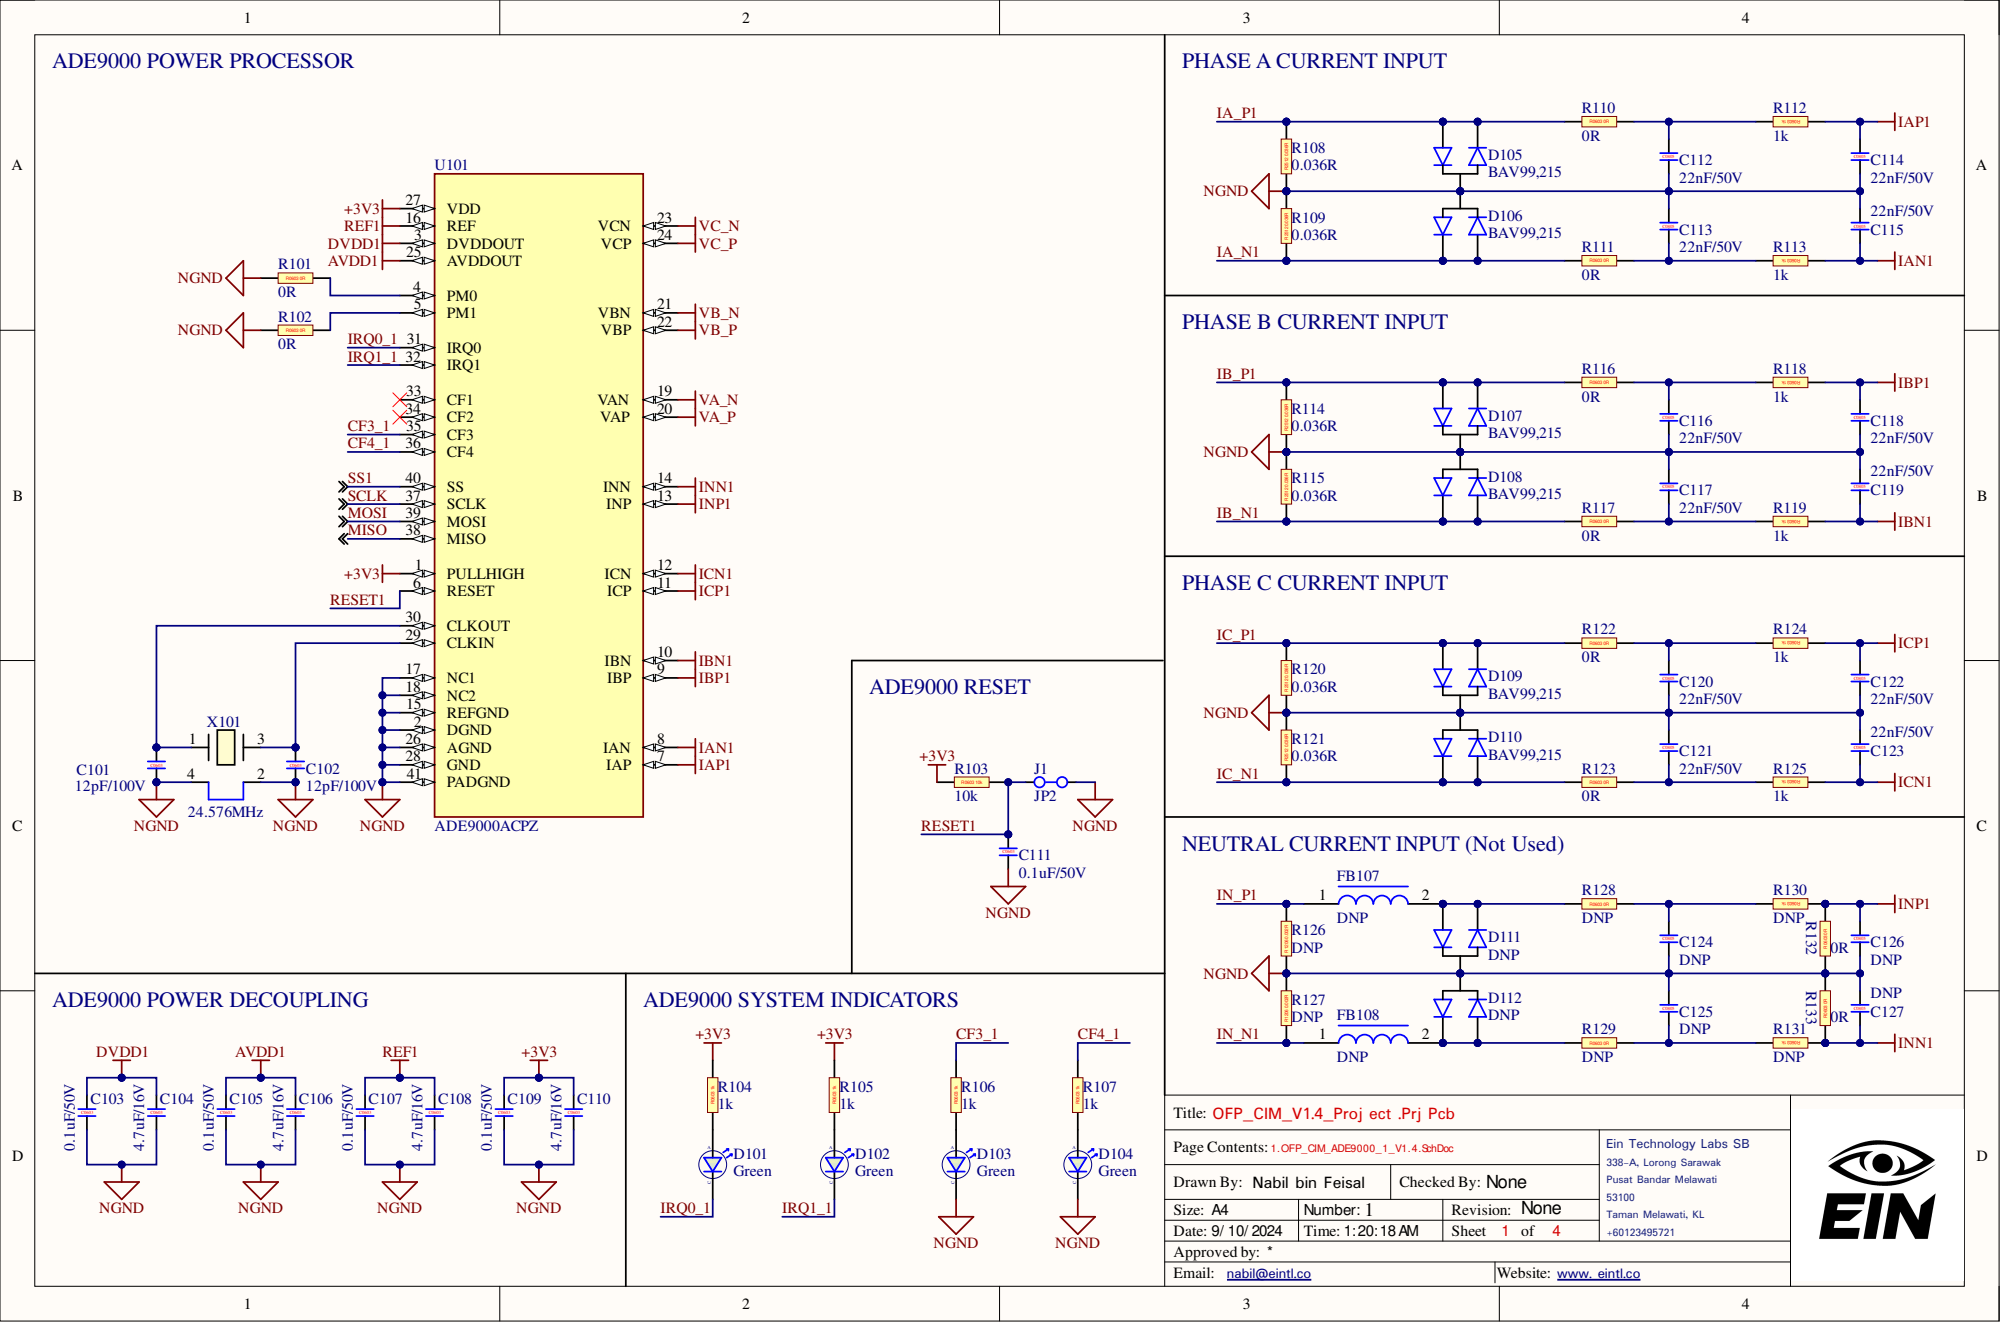
[picture p135: page 1]

NEUTRAL CURRENT INPUT (Not Used)

Page Contents: 1.OFP_CIM_ADE9000_1_V1.4.SchDoc | Ein Technology Labs SB D3 Innovation (M) Sdn Bhd 338-A, Lorong Sarawak Pusat Perniagaan, 3 Jalan Perniagaan, Taman Seri Juru Pusat Bandar Melawati 14100 53100 Simpang Ampat, Penang Taman Melawati, KL +60123495721

Drawn By: Chua Kai Quan Nabil bin Feisal | None Checked By:
Size: A4 | Number: 1 | Revision: None
Date: 9/ 10/ 2024 | Time: 1:20:18 AM | Sheet 1 of 4

## PHASE A CURRENT INPUT

## PHASE B CURRENT INPUT

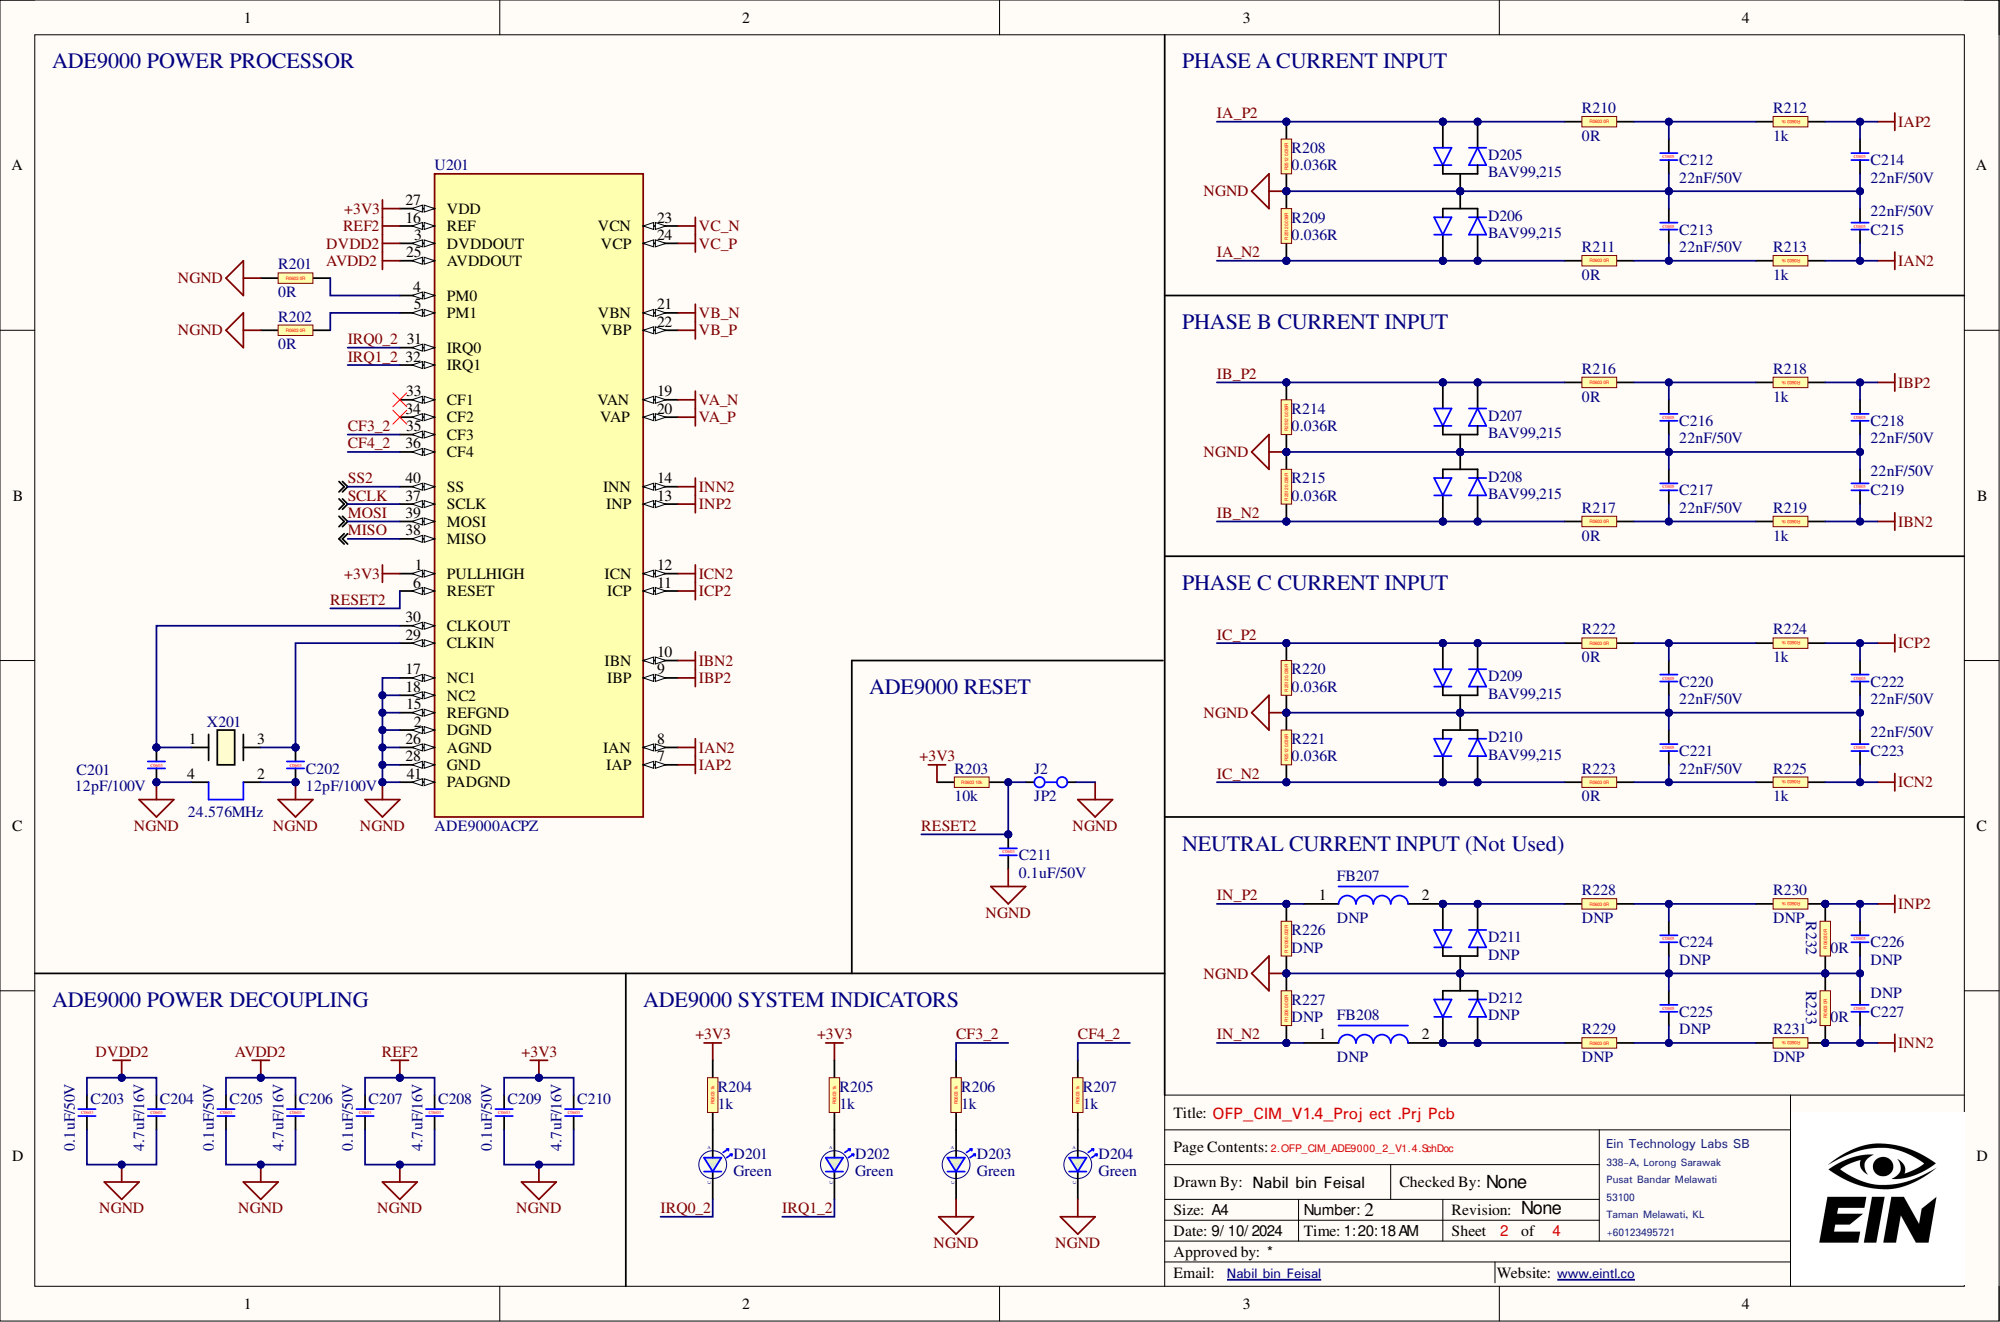
[picture p136: page 2]

NEUTRAL CURRENT INPUT (Not Used)

Page Contents: 2.OFP_CIM_ADE9000_2_V1.4.SchDoc | Ein Technology Labs SB D3 Innovation (M) Sdn Bhd 338-A, Lorong Sarawak Pusat Perniagaan, 3 Jalan Perniagaan, Taman Seri Juru Pusat Bandar Melawati 14100 53100

Drawn By: Chua Kai Quan Nabil bin Feisal | None Checked By:

2 | None

## PHASE A CURRENT INPUT

## PHASE B CURRENT INPUT

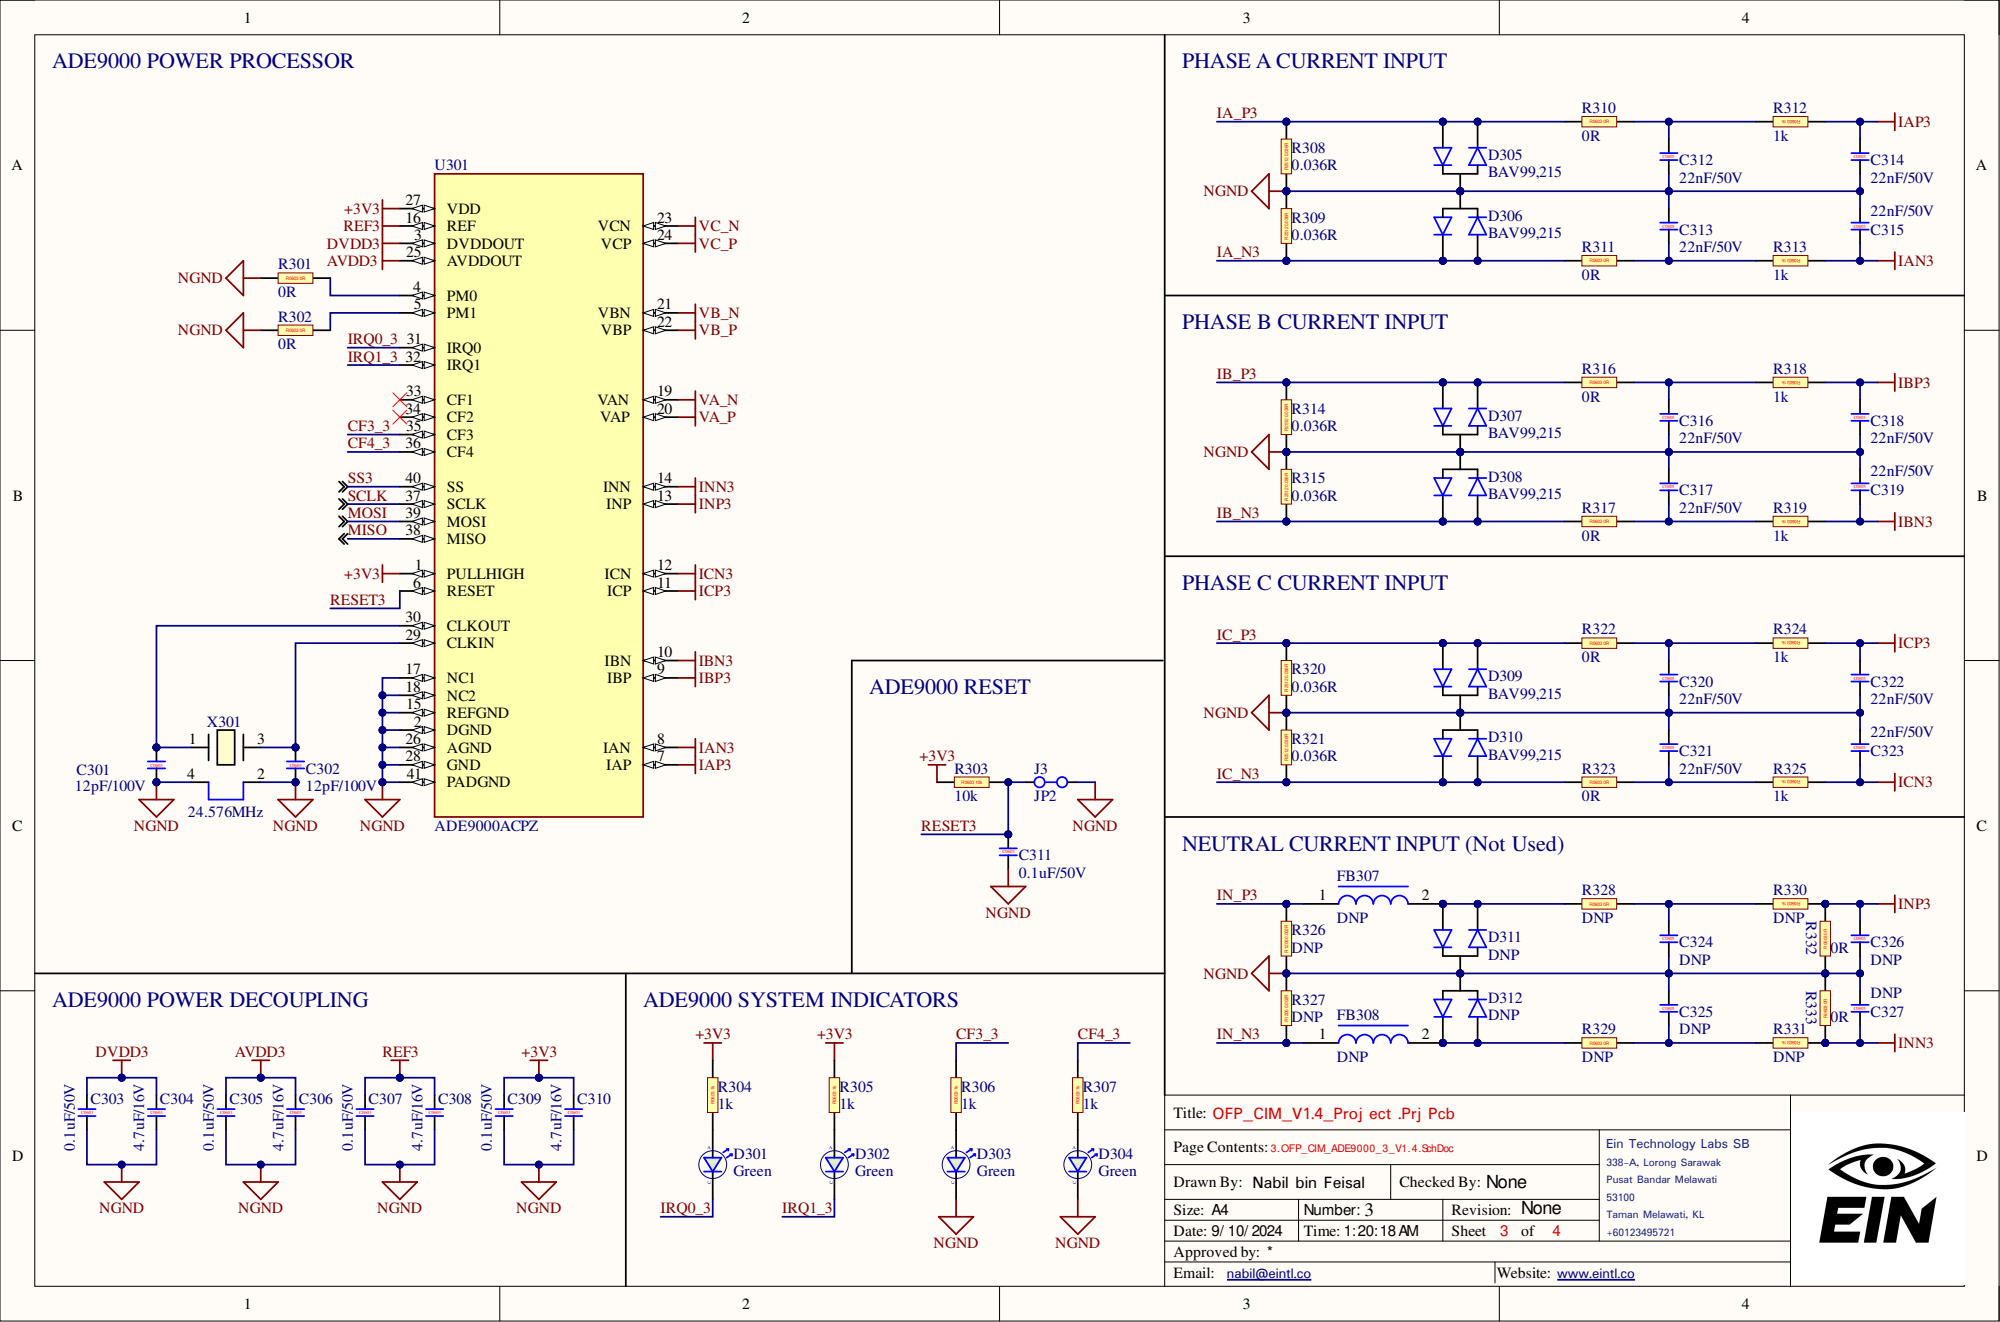
[picture p137: page 3]

NEUTRAL CURRENT INPUT (Not Used)

Page Contents: 3.OFP_CIM_ADE9000_3_V1.4.SchDoc | Ein Technology Labs SB D3 Innovation (M) Sdn Bhd 338-A, Lorong Sarawak Pusat Perniagaan, 3 Jalan Perniagaan, Taman Seri Juru Pusat Bandar Melawati 14100 53100

Drawn By: Chua Kai Quan Nabil bin Feisal | None Checked By:

3 | None

CURRENT CHANNELS TERMINAL INPUT | CURRENT CHANNELS CONNECTOR

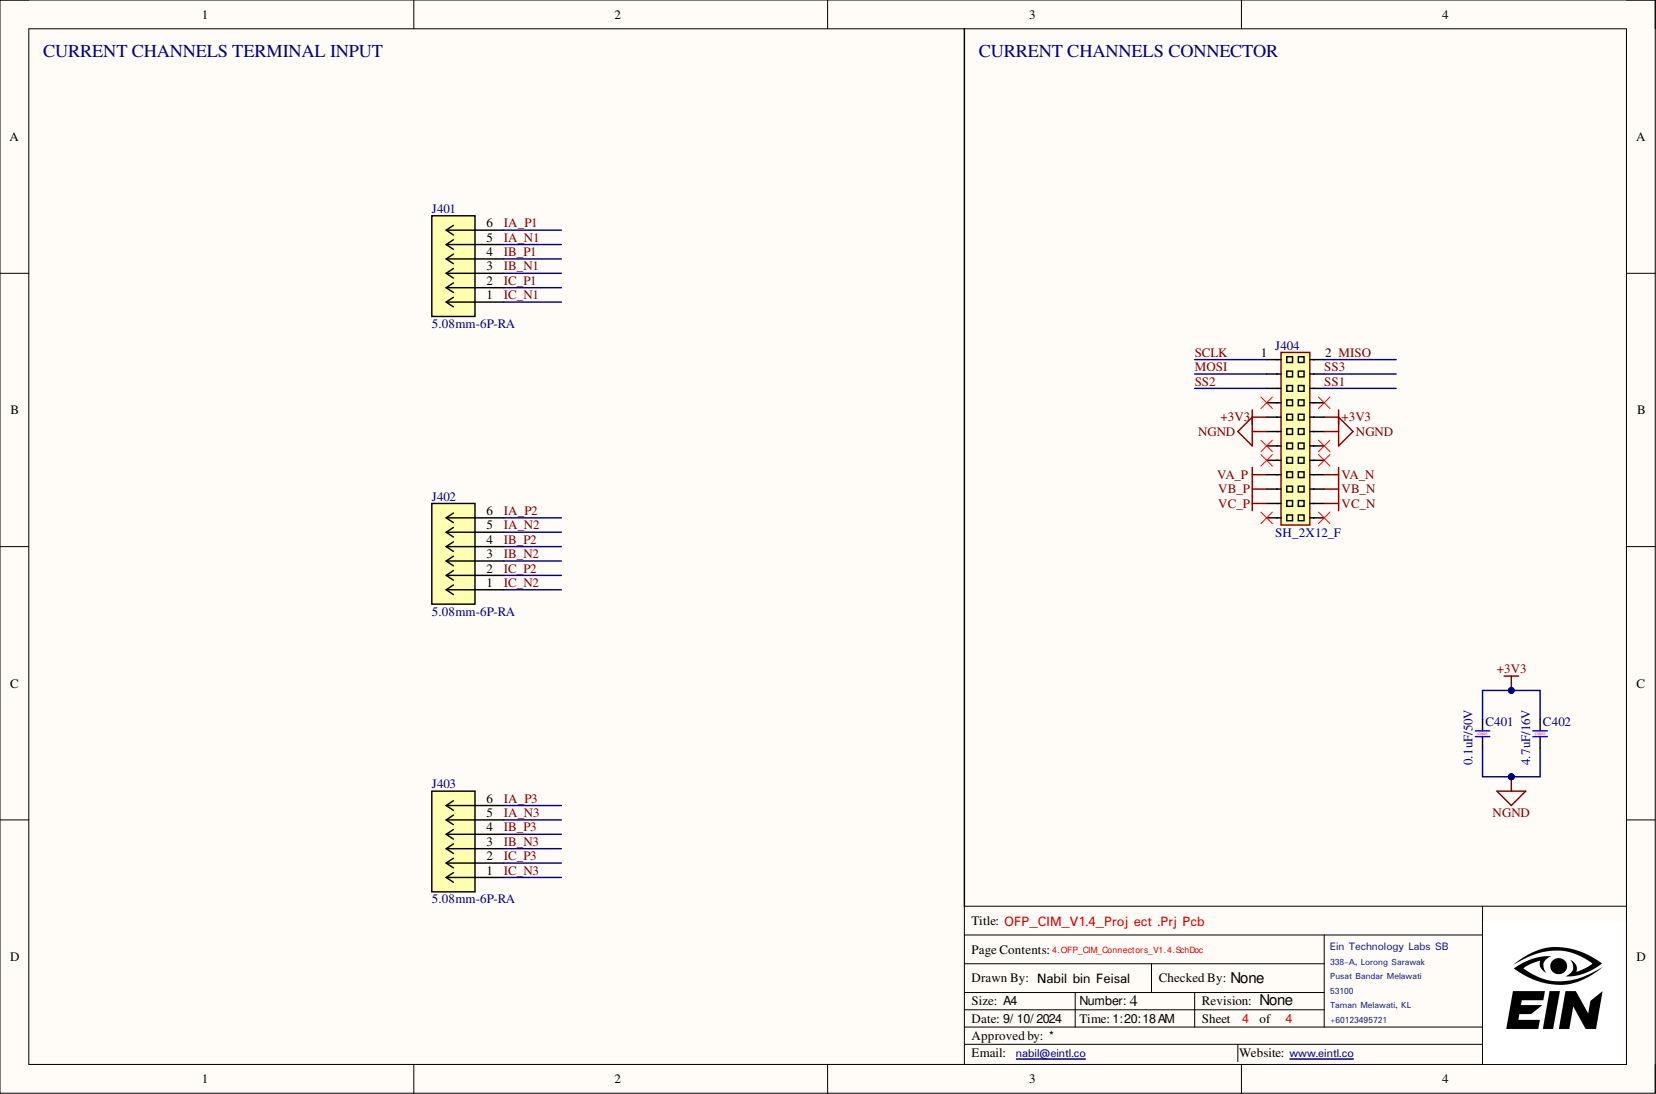
[picture p138: page 4]

Page Contents: 4.OFP_CIM_Connectors_V1.4.SchDoc | Ein Technology Labs SB D3 Innovation (M) Sdn Bhd 338-A, Lorong Sarawak Pusat Perniagaan, 3 Jalan Perniagaan, Taman Seri Juru Pusat Bandar Melawati 14100 53100

Drawn By: Chua Kai Quan Nabil bin Feisal | None Checked By:

4 | None

# MICROPROCESSOR EMBEDDED LINUX OSCILLATOR

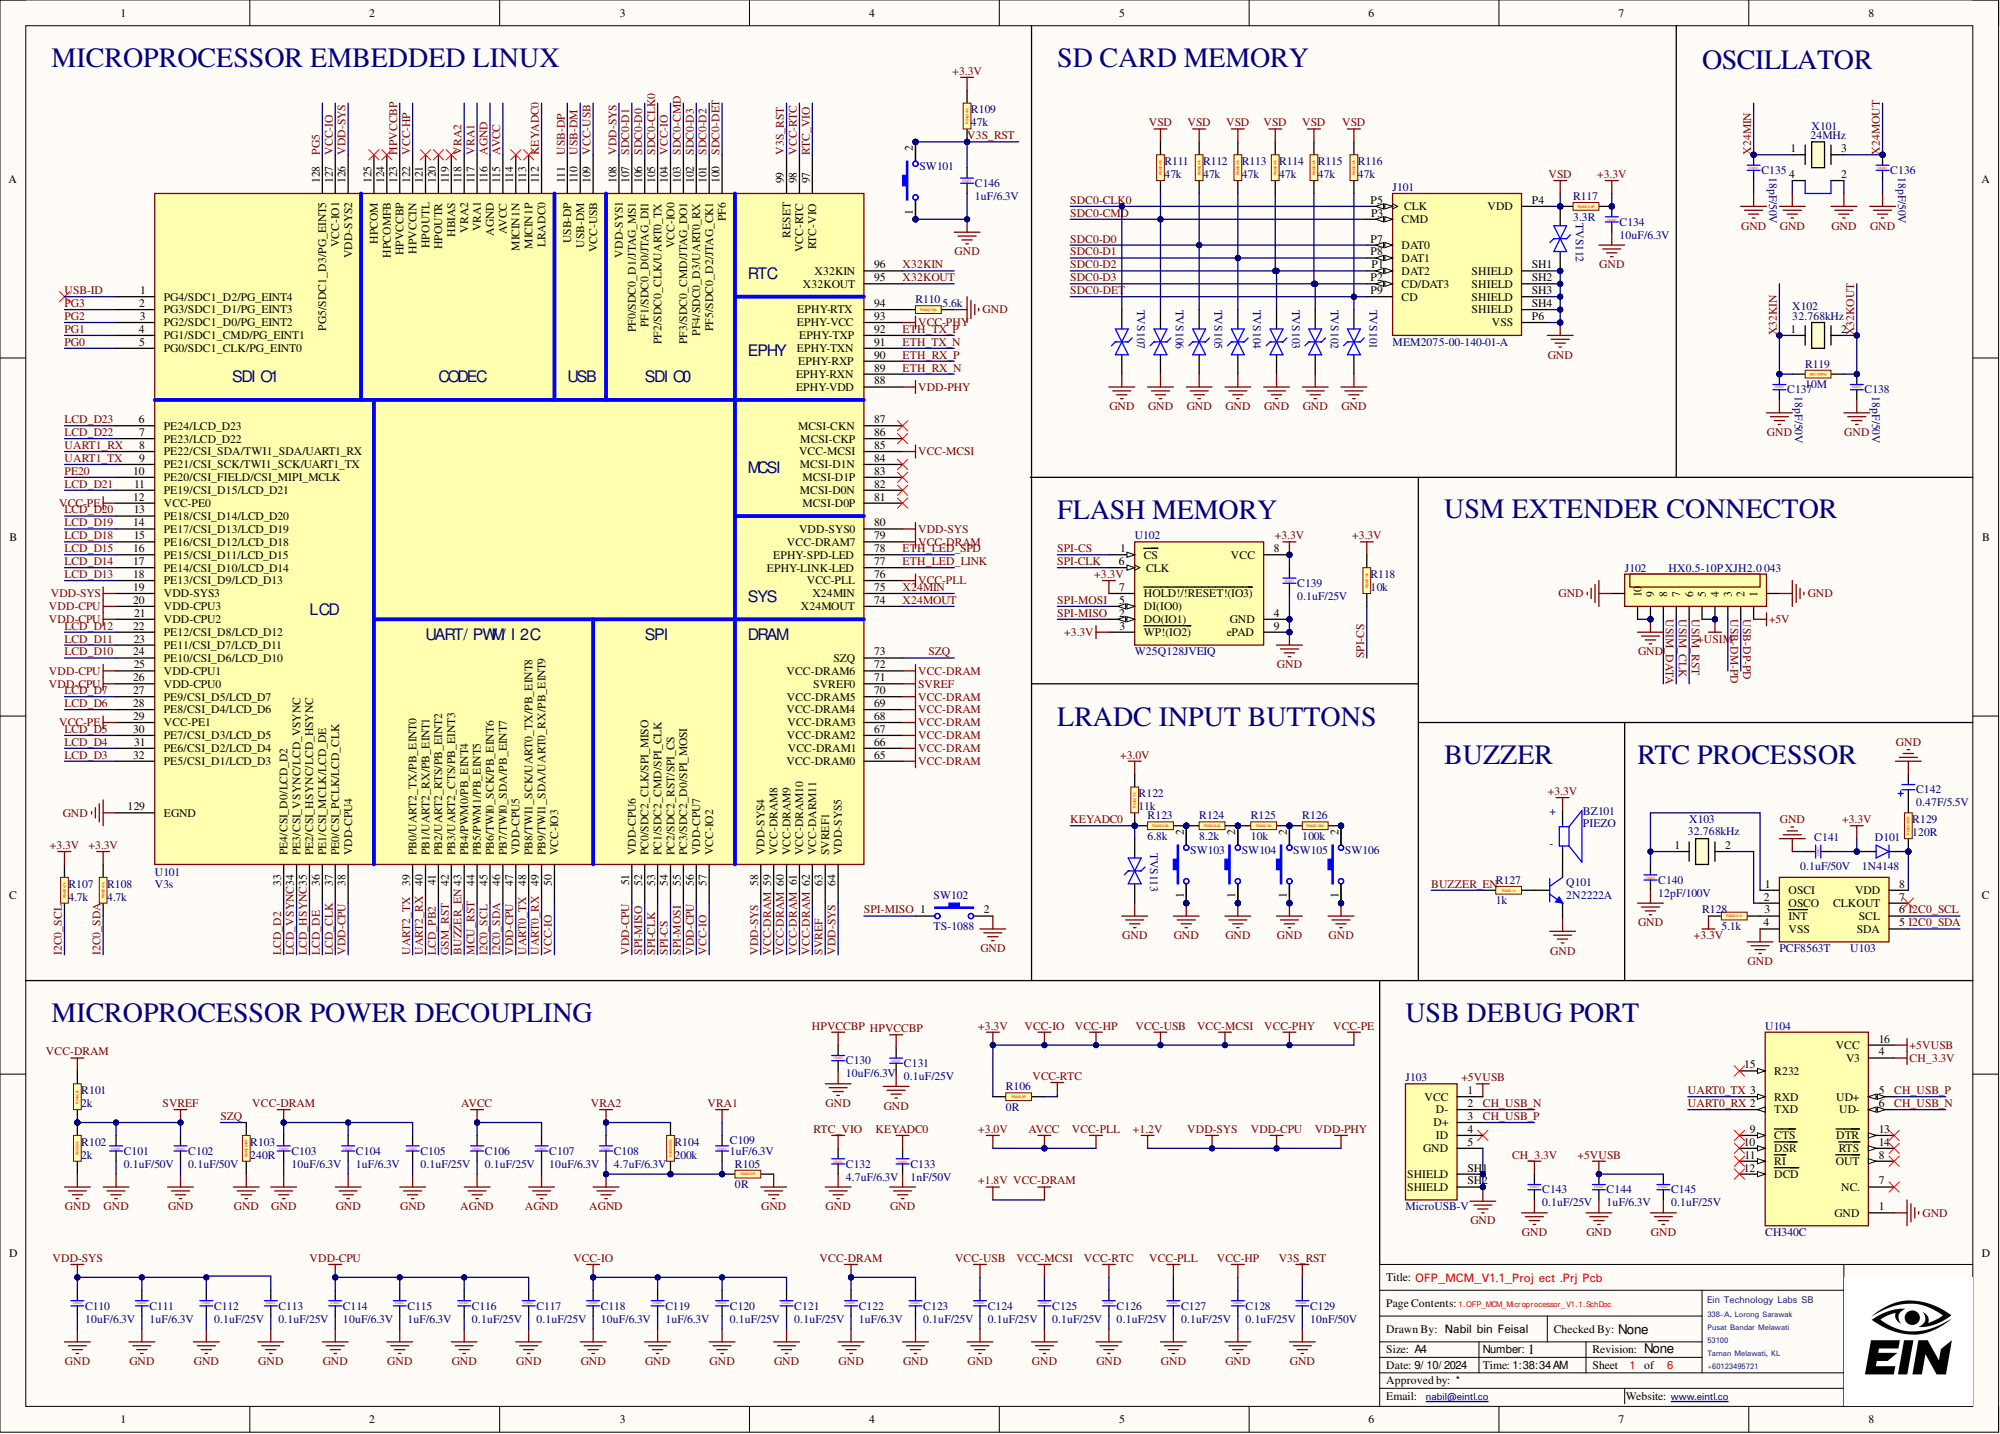
[picture p139: page 5]

Page Contents: 1.OFP_MCM_Microprocessor_V1.1.SchDoc | Ein Technology Labs SB D3 Innovation (M) Sdn Bhd Pusat Perniagaan, 3 338-A, Lorong Sarawak Jalan Perniagaan, Taman Seri Juru Pusat Bandar Melawati 53100

Nabil bin Feisal Drawn By: Chua Kai Quan | None Checked By:

1 | None

TER | 12V TO 5V BUCK CONVERTER (SYSTEM)5V TO 3.3V BUCK CONVER

## 5V TO 1.8V BUCK CONVERTER

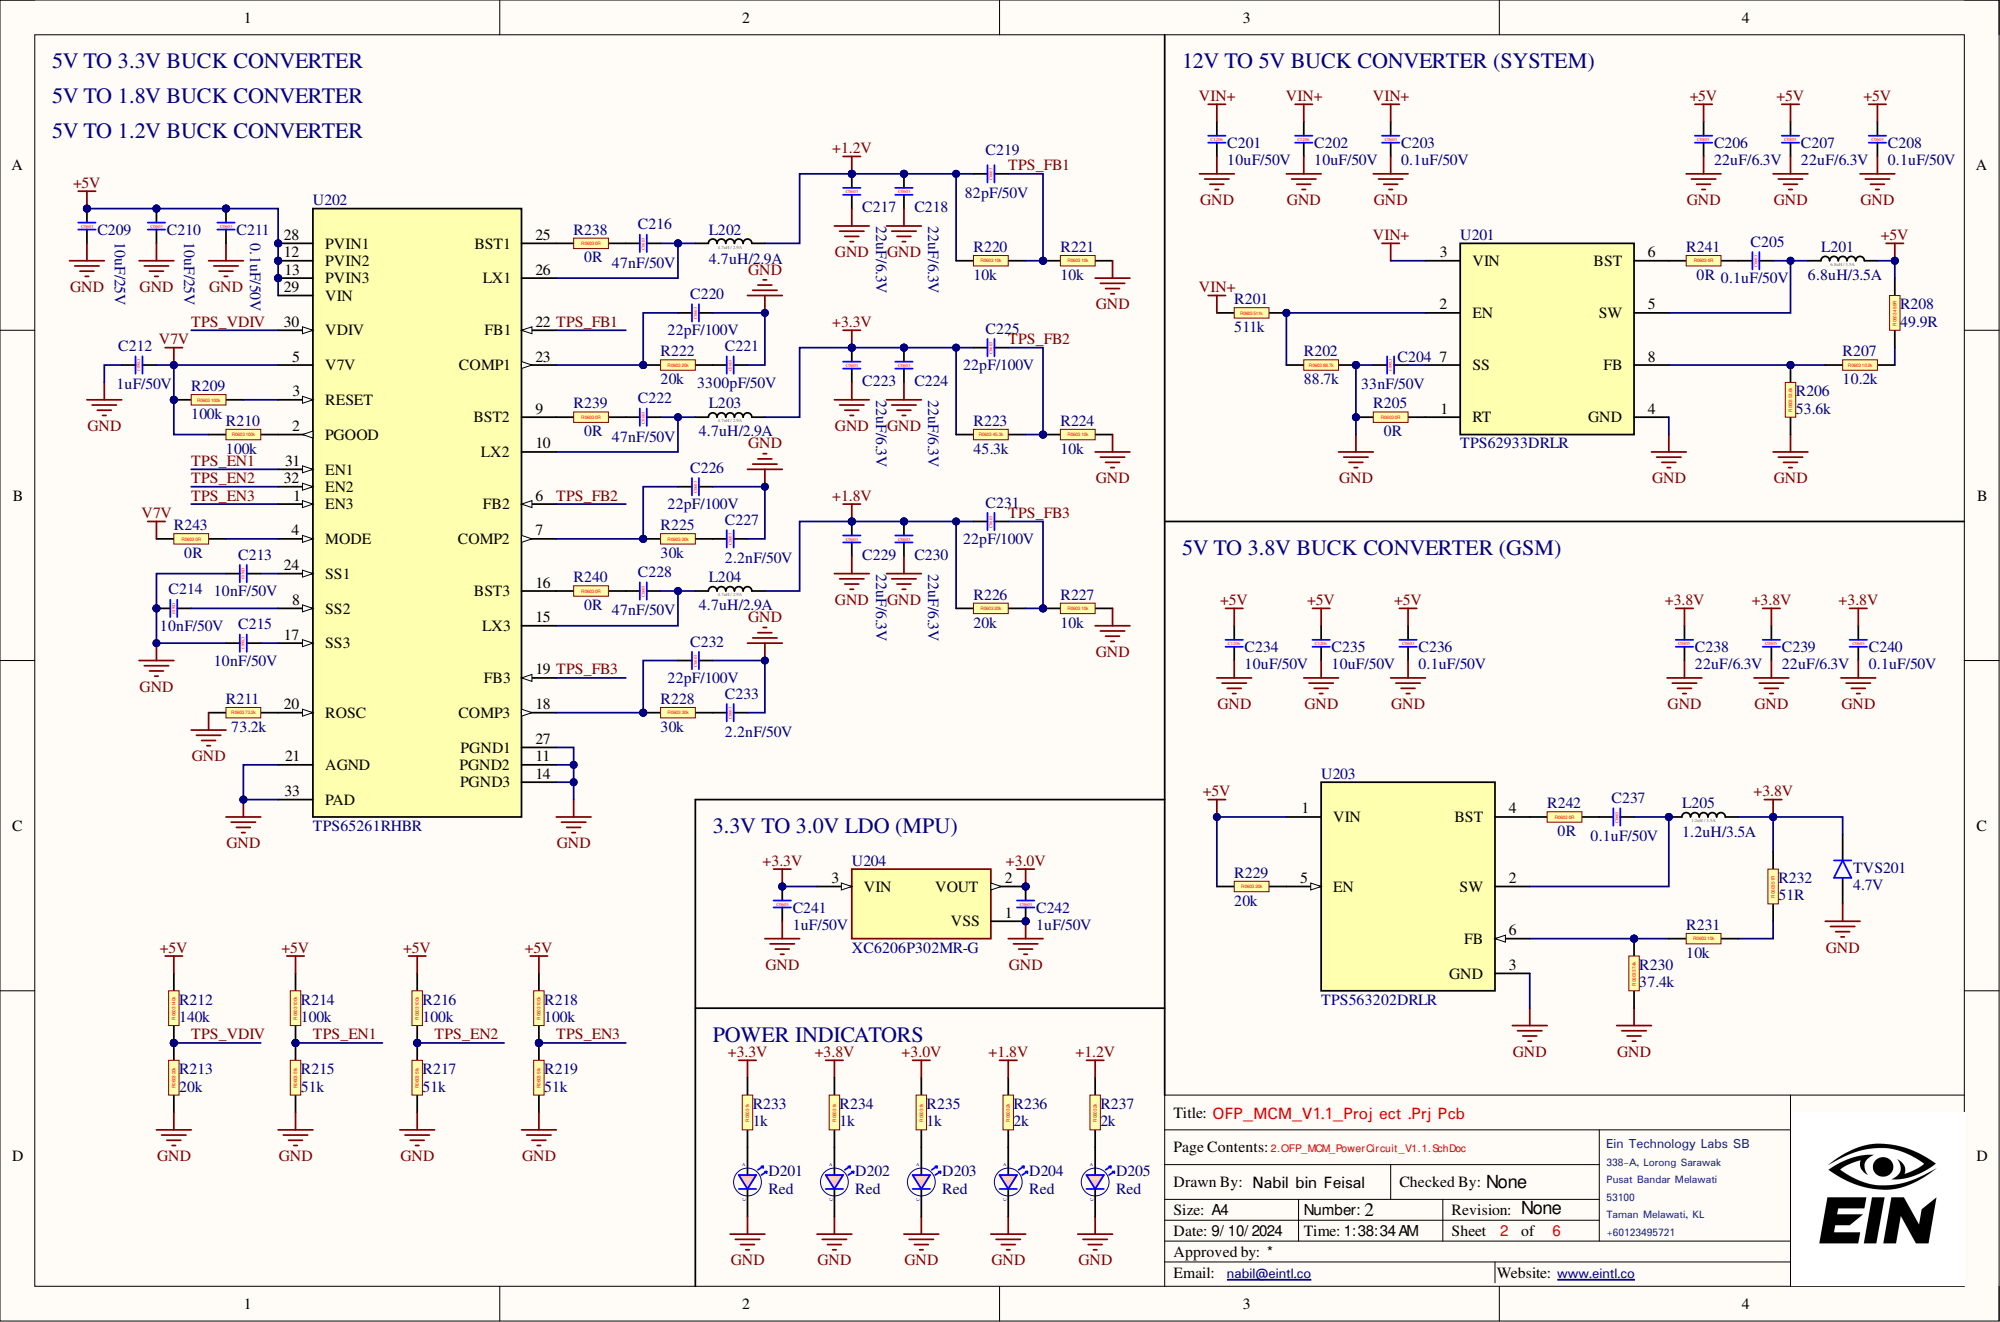
[picture p140: page 6]

5V TO 3.8V BUCK CONVERTER (GSM)

Page Contents: 2.OFP_MCM_PowerCircuit_V1.1.SchDoc | Ein Technology Labs SB D3 Innovation (M) Sdn Bhd 338-A, Lorong Sarawak Pusat Perniagaan, 3 Jalan Perniagaan, Taman Seri Juru Pusat Bandar Melawati 14100 53100

Drawn By: Chua Kai Quan Nabil bin Feisal | None Checked By:

2 | None

RGB LCD RESISTIVE TOUCH CONTROLLER | RGB LCD FPC/FFC CONNECTOR
10 10 | 11 11 | 12 12 | 13 13 | 14 14 | 15 15 | 16 16 | 17 17 | 18 18 | 19 19 | 20 20 | 21 21 | 22 22 | 23 23 | 24 24 | 25 25 | 26 26 | 27 27 | 28 28 | 29 29 | 30 30 | 31 31 | 32 32 | 33 33 | 34 34 | 35 35 | 36 36 | 37 37 | 38 38 | 39 39 | 40 40

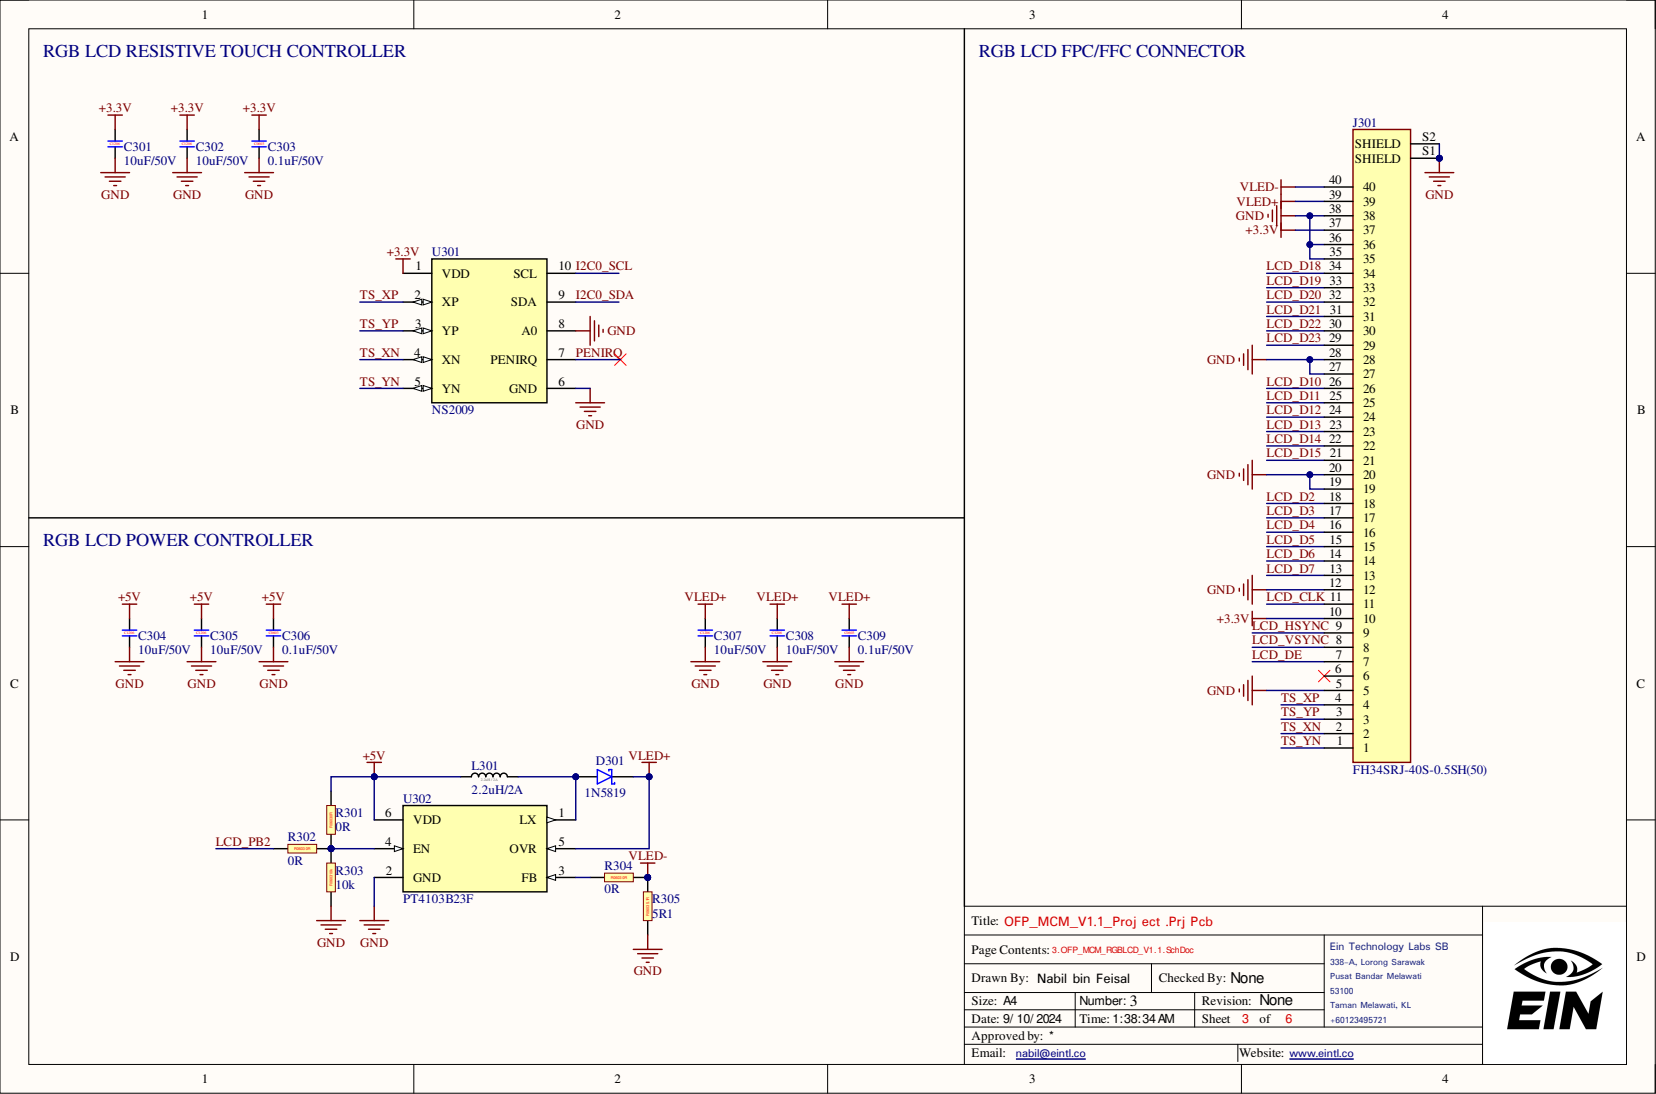
[picture p141: page 7]

RGB LCD POWER CONTROLLER

Page Contents: 3.OFP_MCM_RGBLCD_V1.1.SchDoc | Ein Technology Labs SB D3 Innovation (M) Sdn Bhd 338-A, Lorong Sarawak Pusat Perniagaan, 3 Jalan Perniagaan, Taman Seri Juru Pusat Bandar Melawati 14100 53100

Drawn By: Chua Kai Quan Nabil bin Feisal | None Checked By:

3 | None

## EC21 GSM STANDARD MODULE

## GSM USB HUB

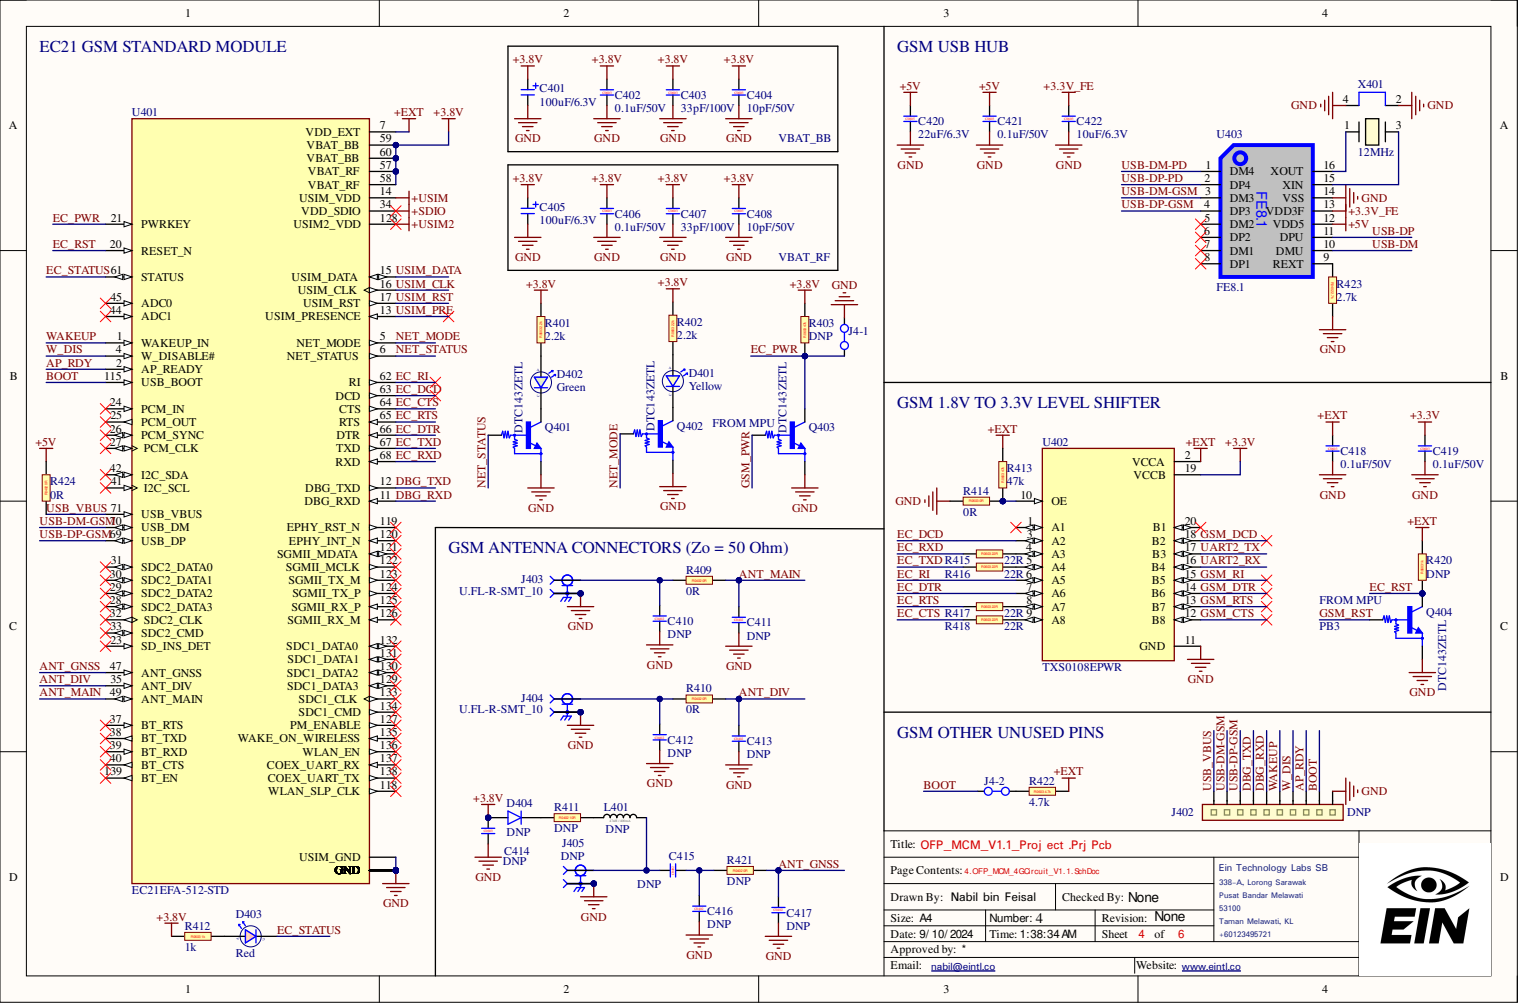
[picture p142: page 8]

GSM 1.8V TO 3.3V LEVEL SHIFTER

GSM ANTENNA CONNECTORS (Zo = 50 Ohm)

GSM OTHER UNUSED PINS

Page Contents: 4.OFP_MCM_4GCircuit_V1.1.SchDoc | Ein Technology Labs SB D3 Innovation (M) Sdn Bhd 338-A, Lorong Sarawak Pusat Perniagaan, 3 Jalan Perniagaan, Taman Seri Juru Pusat Bandar Melawati 14100 53100

Drawn By: Chua Kai Quan Nabil bin Feisal | None Checked By:

4 | None

## RS485 RTU MODBUS CIRCUIT - FROM MCU TO MPU

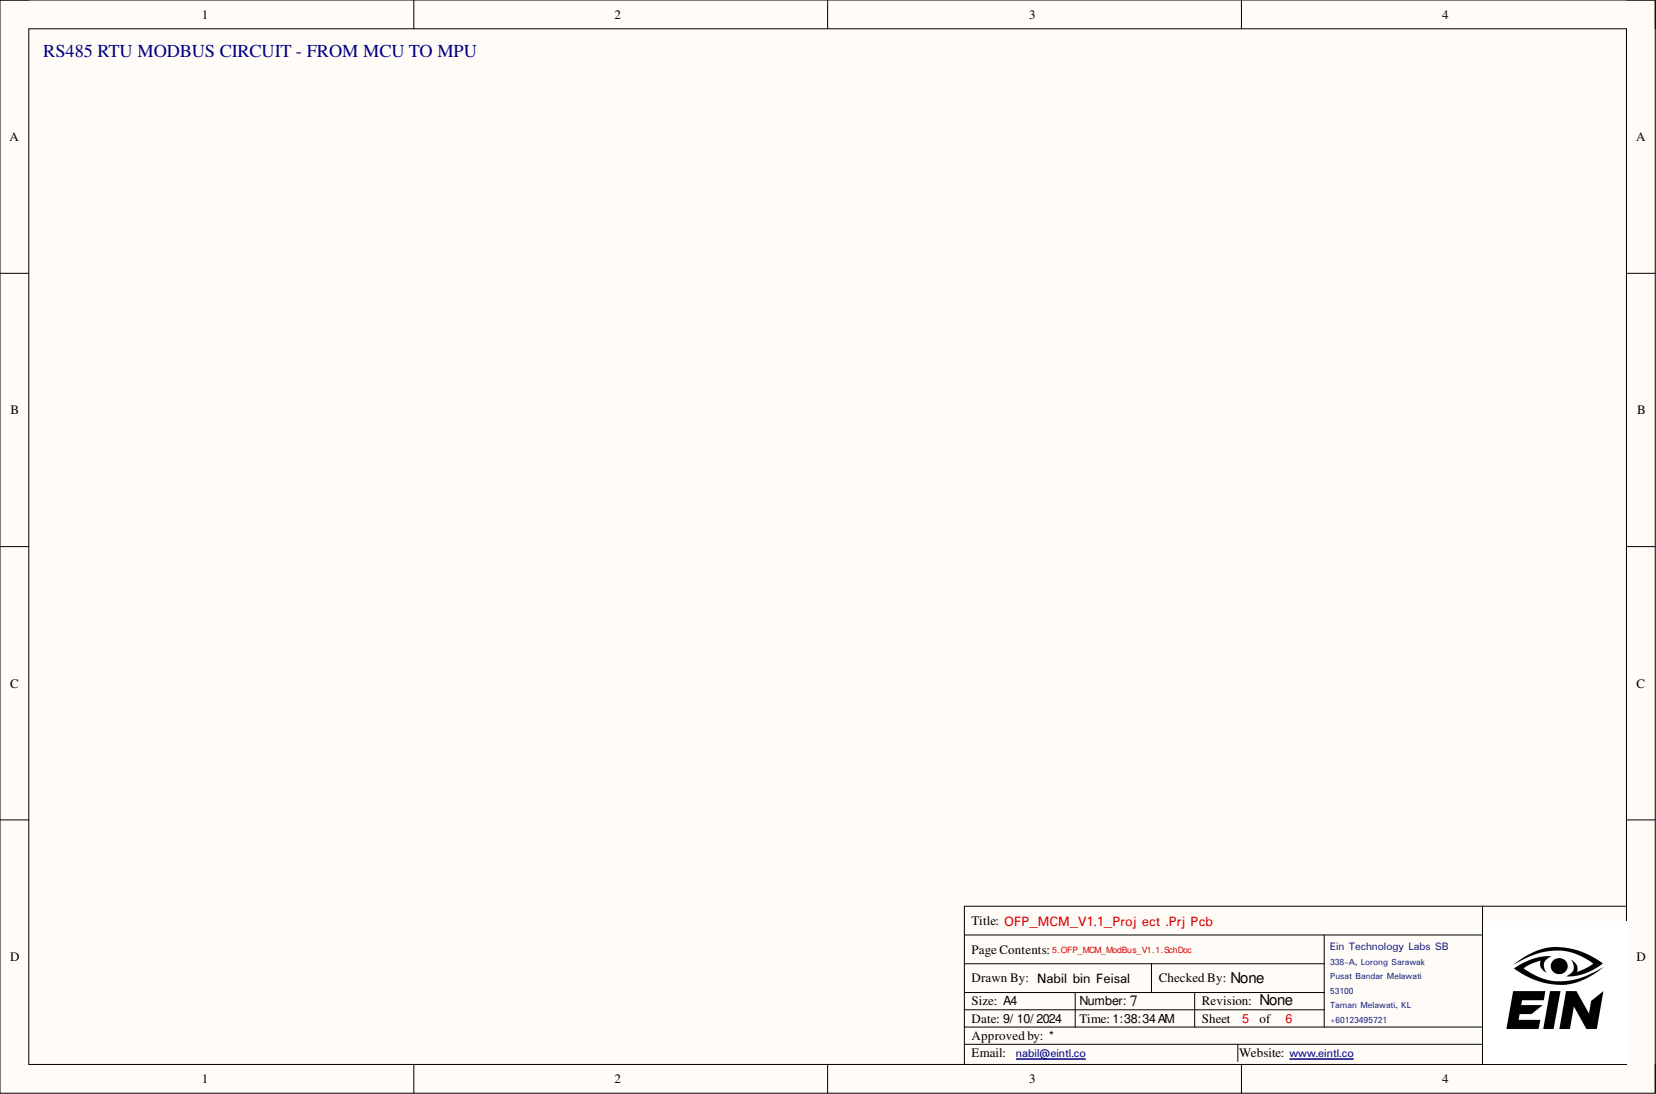
[picture p143: page 9]

OFP_MCM_V1.1_Proj ect .Prj Pcb
D3_OFP_MCM_V1.1_Project.PrjPcb
Title:

Page Contents: 5.OFP_MCM_ModBus_V1.1.SchDoc | Ein Technology Labs SB D3 Innovation (M) Sdn Bhd 338-A, Lorong Sarawak Pusat Perniagaan, 3 Jalan Perniagaan, Taman Seri Juru Pusat Bandar Melawati 14100 53100

Drawn By: Chua Kai Quan Nabil bin Feisal | None Checked By:

7 | None

ETHERNET PORT | IO EXPANDER

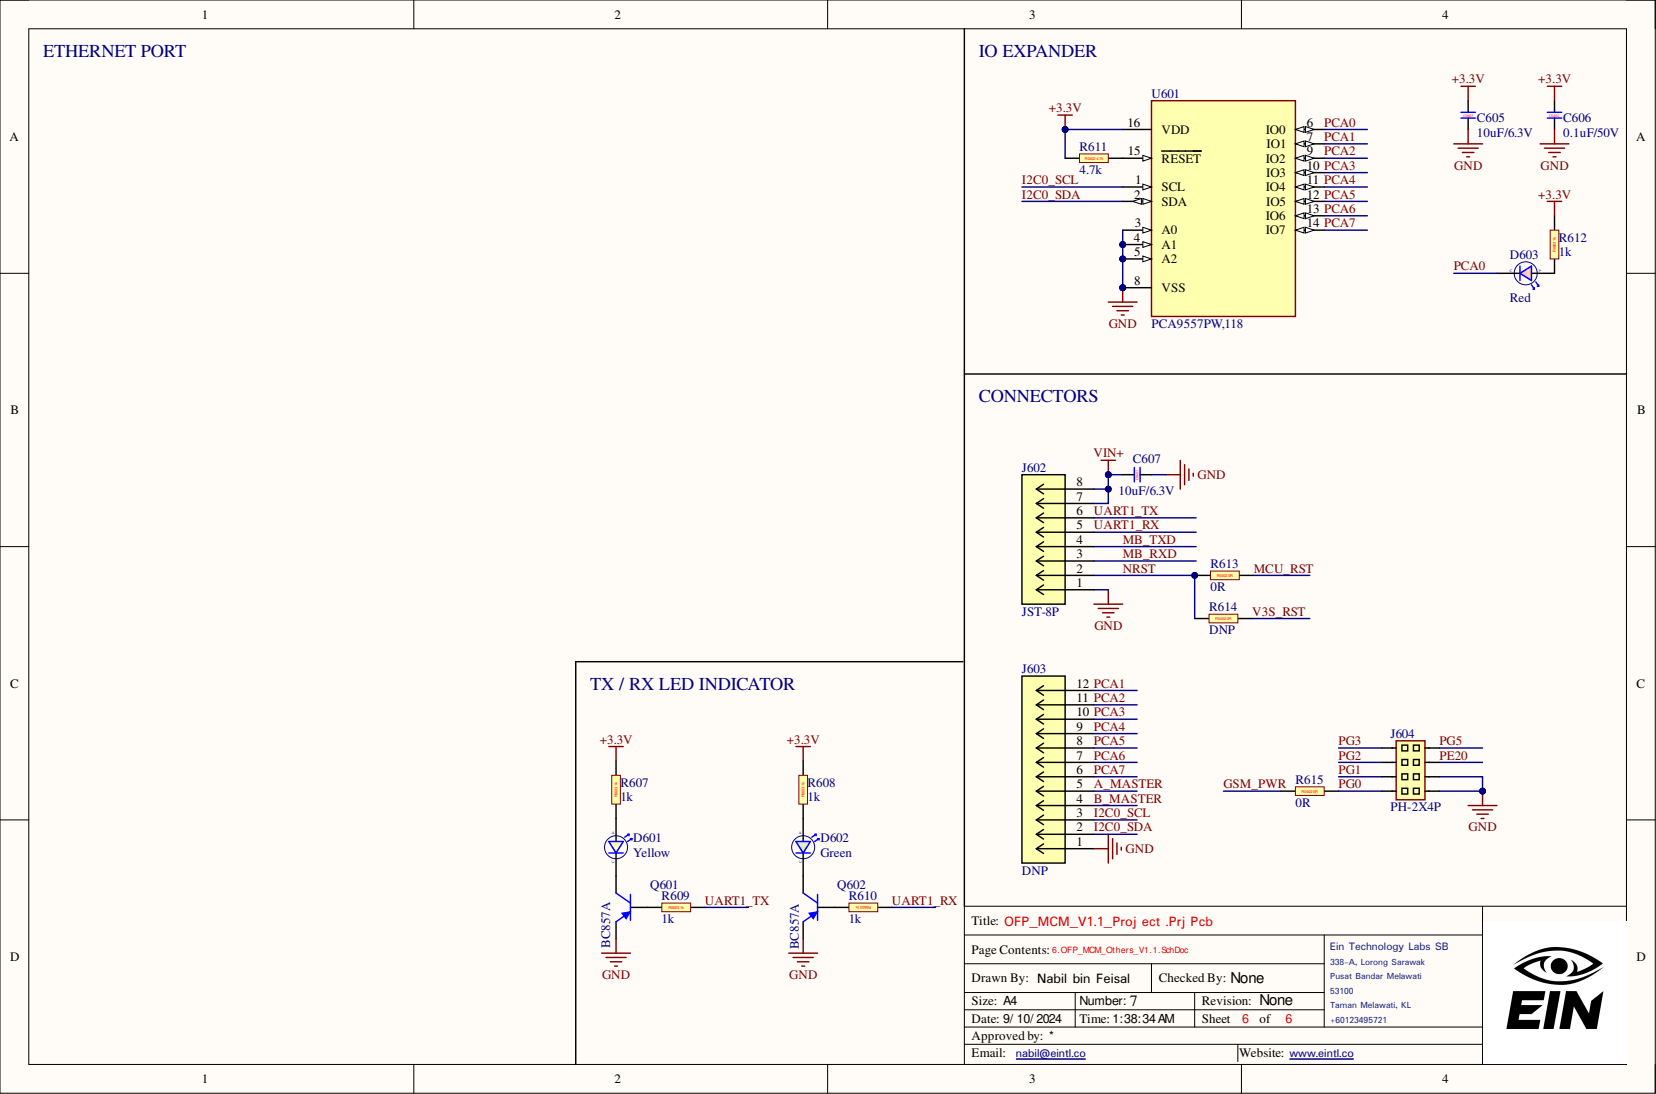
[picture p144: page 10]

TX / RX LED INDICATOR

Page Contents: 6.OFP_MCM_Others_V1.1.SchDoc | Ein Technology Labs SB D3 Innovation (M) Sdn Bhd 338-A, Lorong Sarawak Pusat Perniagaan, 3 Jalan Perniagaan, Taman Seri Juru Pusat Bandar Melawati 14100 53100

Drawn By: Chua Kai Quan Nabil bin Feisal | None Checked By:

## POWER METERING SUB CONTROLLER

SUB CONTROLLER NRESET | SWD PROGRAMMING HEADER

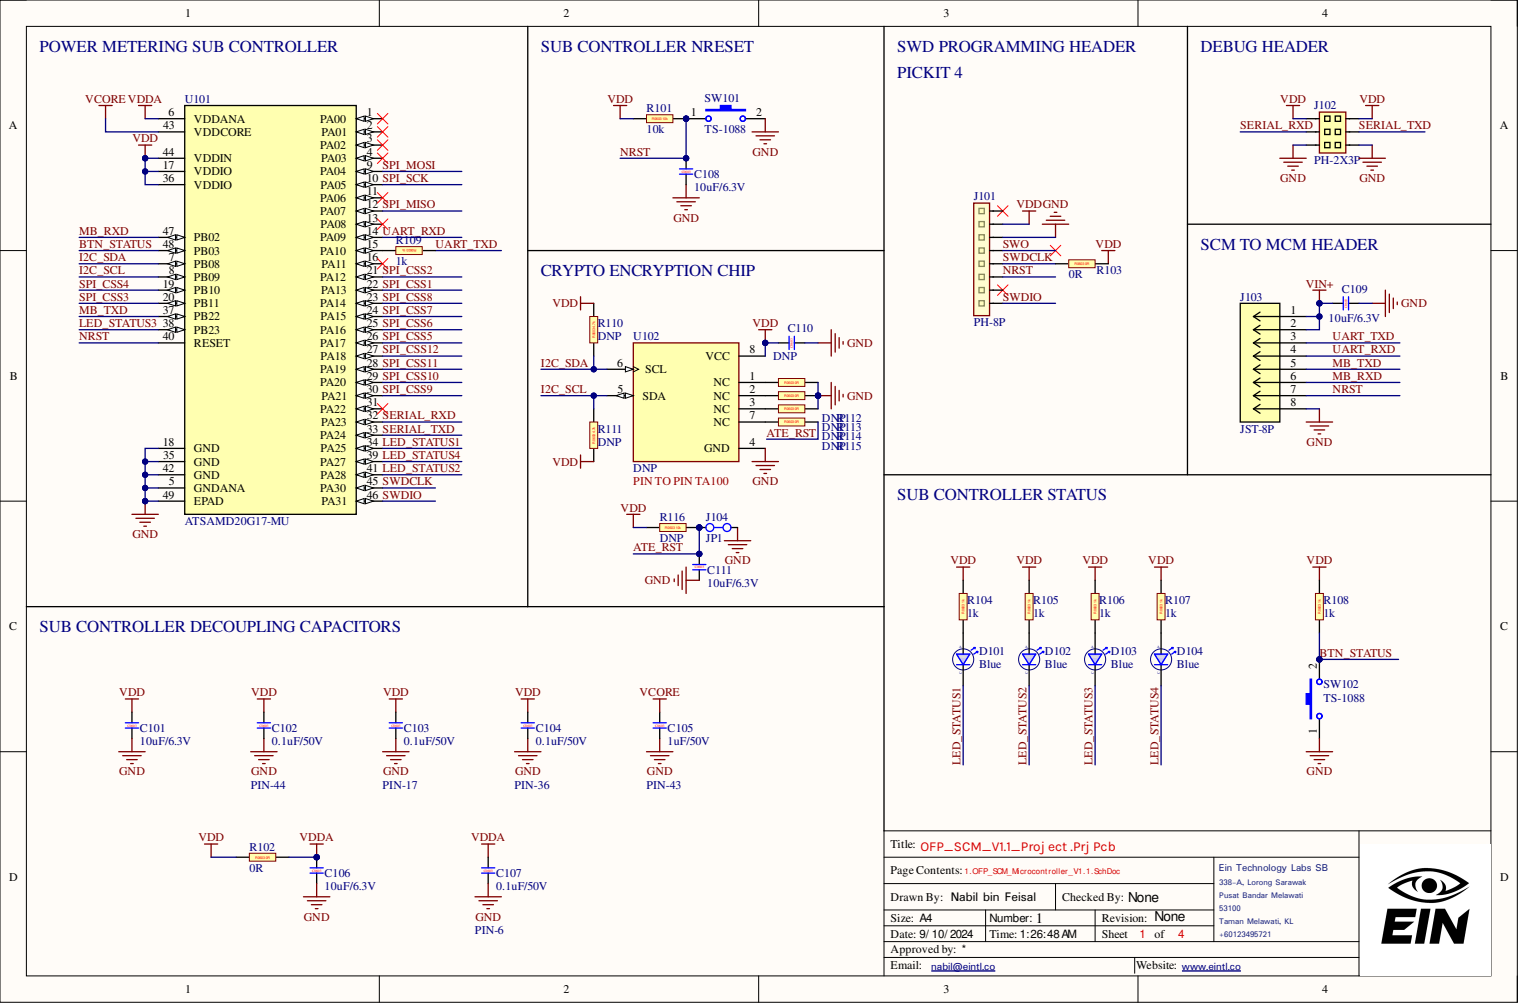
[picture p145: page 11]

SCM TO MCM HEADER

SUB CONTROLLER DECOUPLING CAPACITORS

Page Contents: 1.OFP_SCM_Microcontroller_V1.1.SchDoc | Ein Technology Labs SB D3 Innovation (M) Sdn Bhd 338-A, Lorong Sarawak Pusat Perniagaan, 3 Jalan Perniagaan, Taman Seri Juru Pusat Bandar Melawati 14100 53100

Drawn By: Chua Kai Quan Nabil bin Feisal | None Checked By:

1 | None

## 24VDC TO 5VDC STEP DOWN CONVERTER

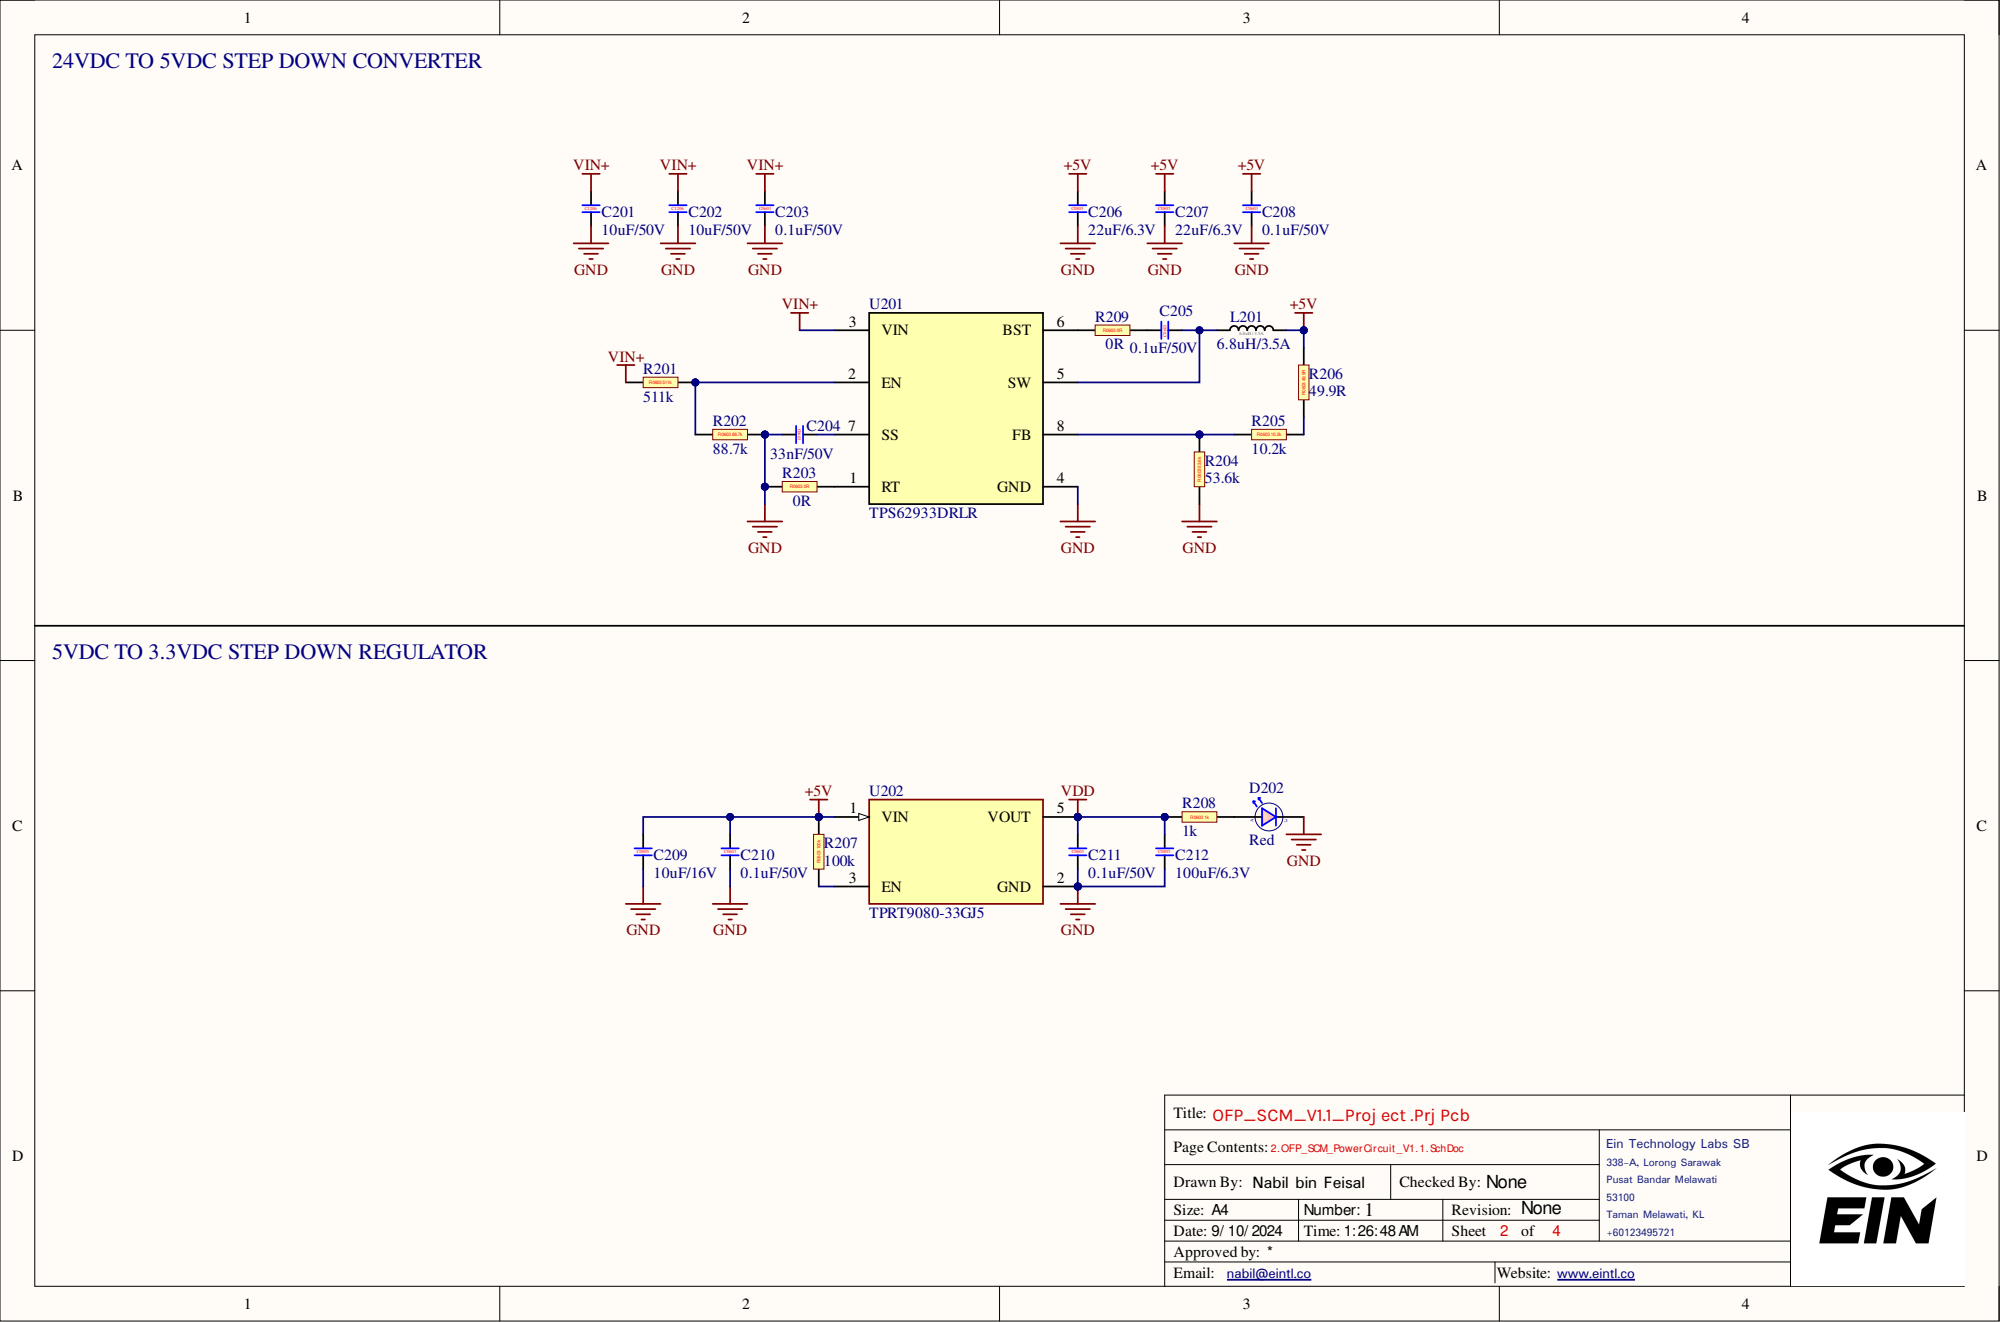
[picture p146: page 12]

5VDC TO 3.3VDC STEP DOWN REGULATOR

Page Contents: 2.OFP_SCM_PowerCircuit_V1.1.SchDoc | Ein Technology Labs SB D3 Innovation (M) Sdn Bhd 338-A, Lorong Sarawak Pusat Perniagaan, 3 Jalan Perniagaan, Taman Seri Juru Pusat Bandar Melawati 14100 53100

Drawn By: Chua Kai Quan Nabil bin Feisal | None Checked By:

1 | None

## SUB CONTROLLER SPI / POWER ISOLATIONS

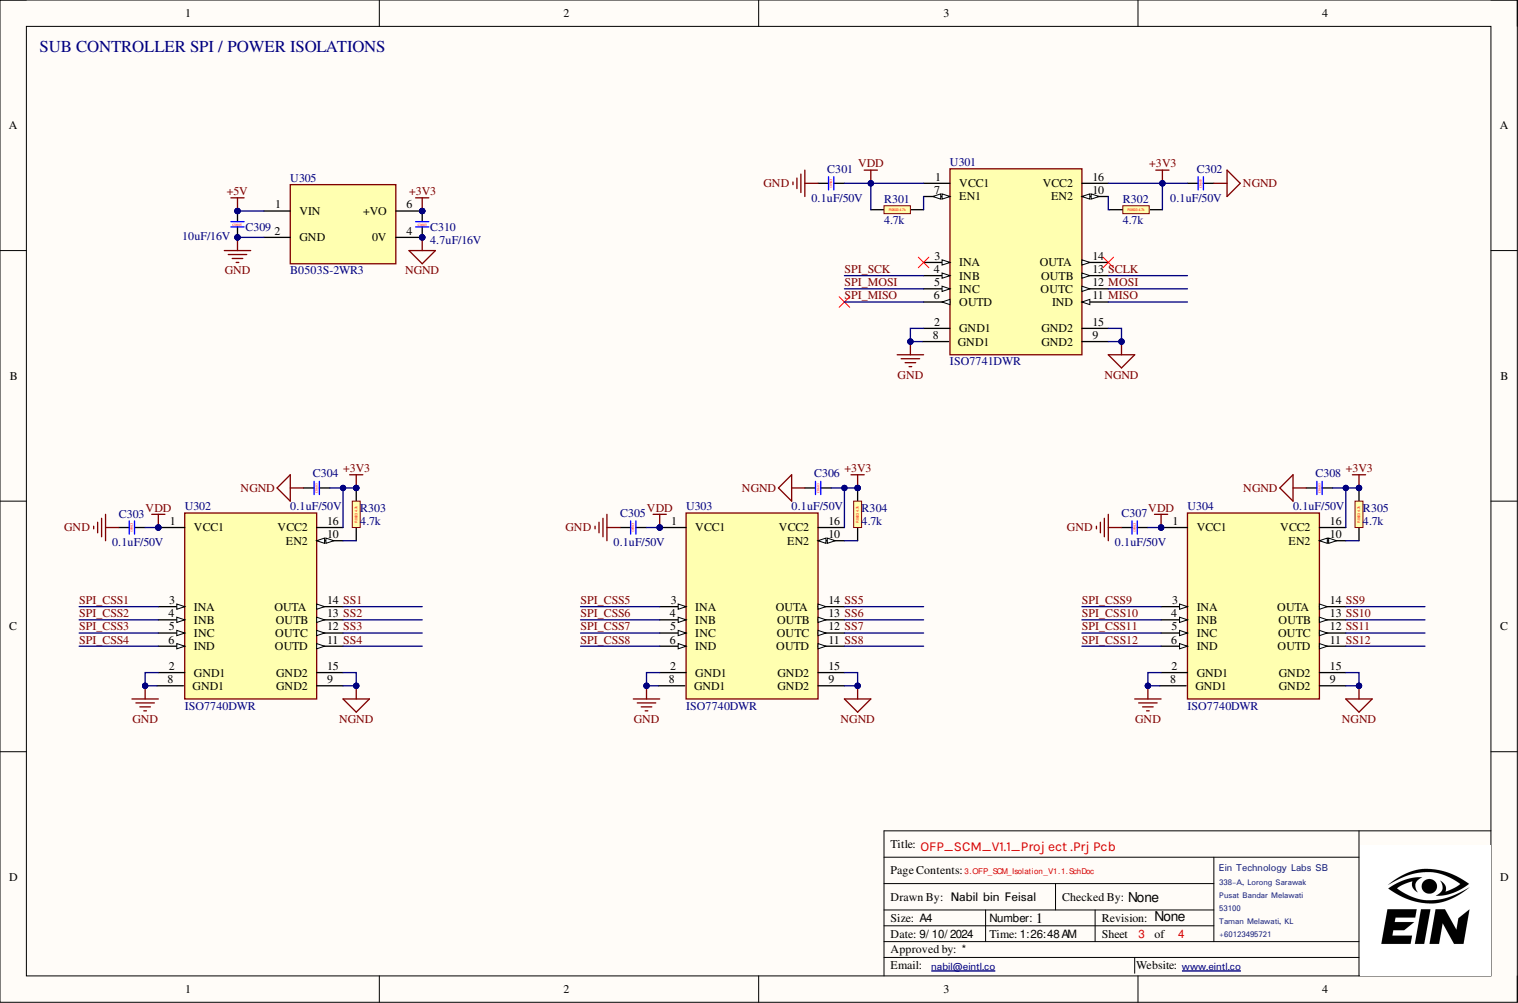
[picture p147: page 13]

Page Contents: 3.OFP_SCM_Isolation_V1.1.SchDoc | Ein Technology Labs SB D3 Innovation (M) Sdn Bhd 338-A, Lorong Sarawak Pusat Perniagaan, 3 Jalan Perniagaan, Taman Seri Juru Pusat Bandar Melawati 14100 53100

Drawn By: Chua Kai Quan Nabil bin Feisal | None Checked By:

1 | None

## VIM / CIM BOARDS CONNECTORS

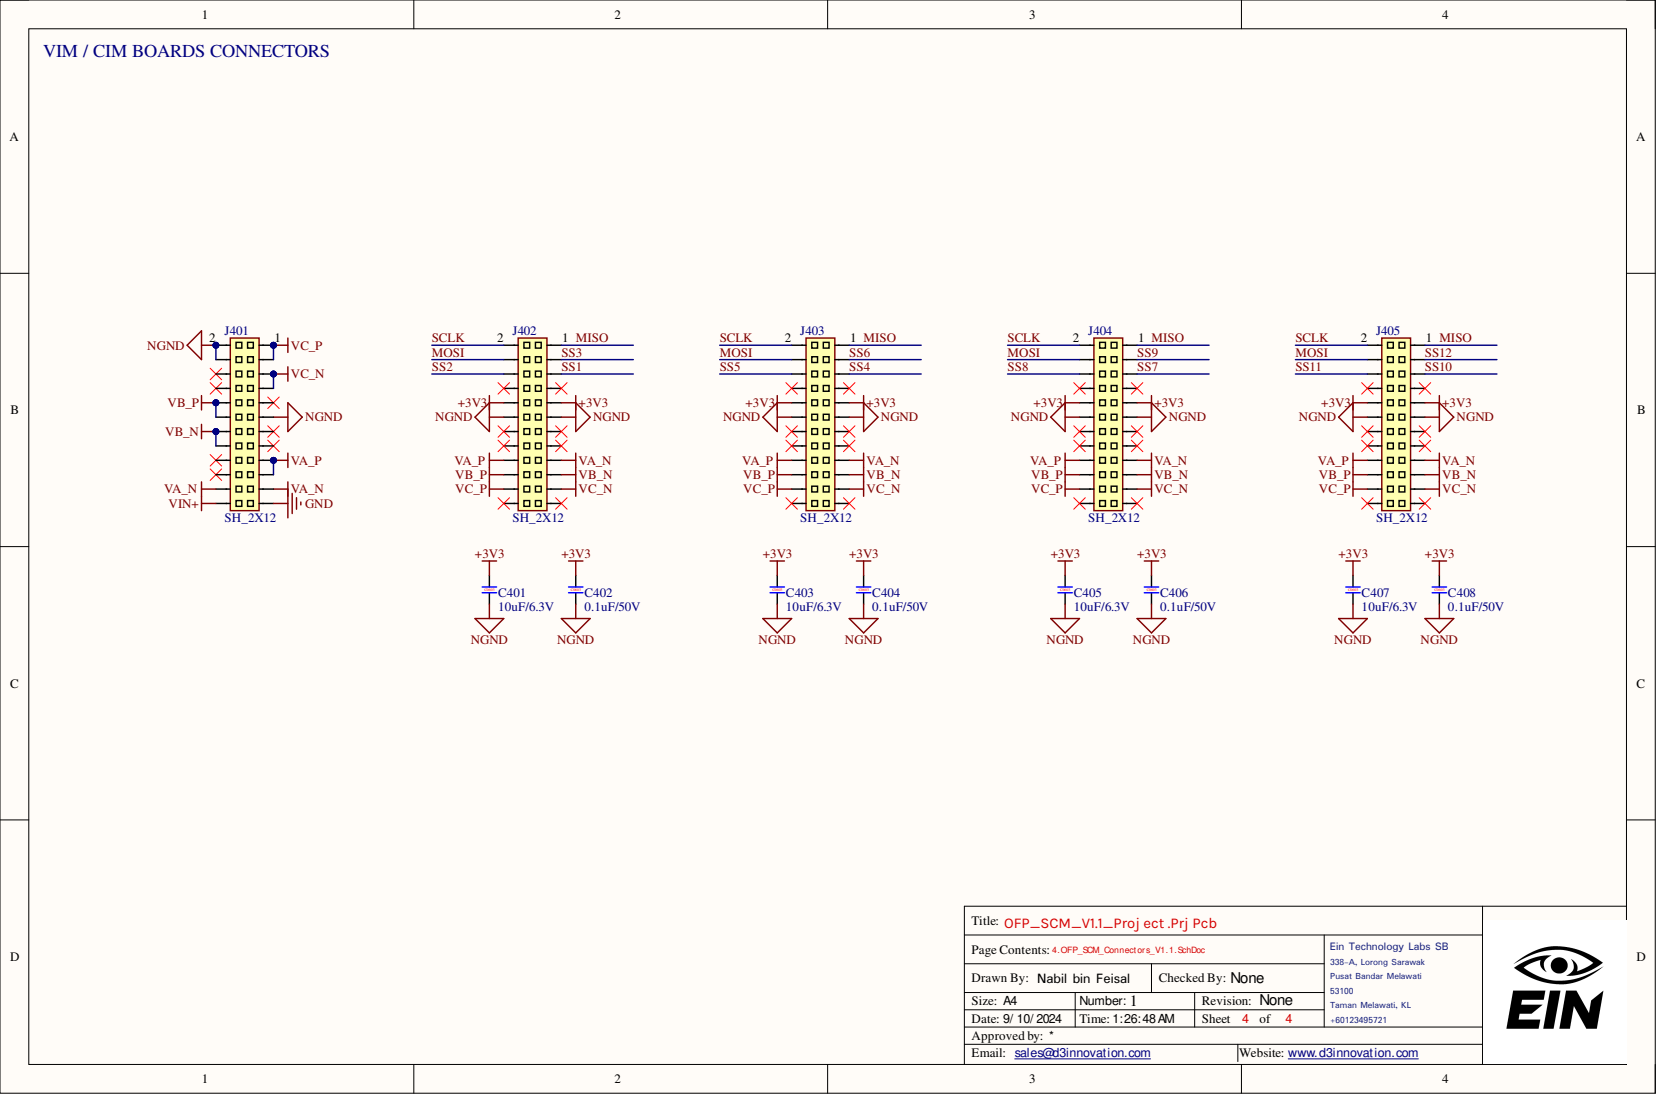
[picture p148: page 14]

Page Contents: 4.OFP_SCM_Connectors_V1.1.SchDoc | Ein Technology Labs SB D3 Innovation (M) Sdn Bhd 338-A, Lorong Sarawak Pusat Perniagaan, 3 Jalan Perniagaan, Taman Seri Juru Pusat Bandar Melawati 14100 53100

Drawn By: Chua Kai Quan Nabil bin Feisal | None Checked By:

1 | None

## GSM USIM CONNECTOR

## EXTENDER CONNECTOR TO MCM

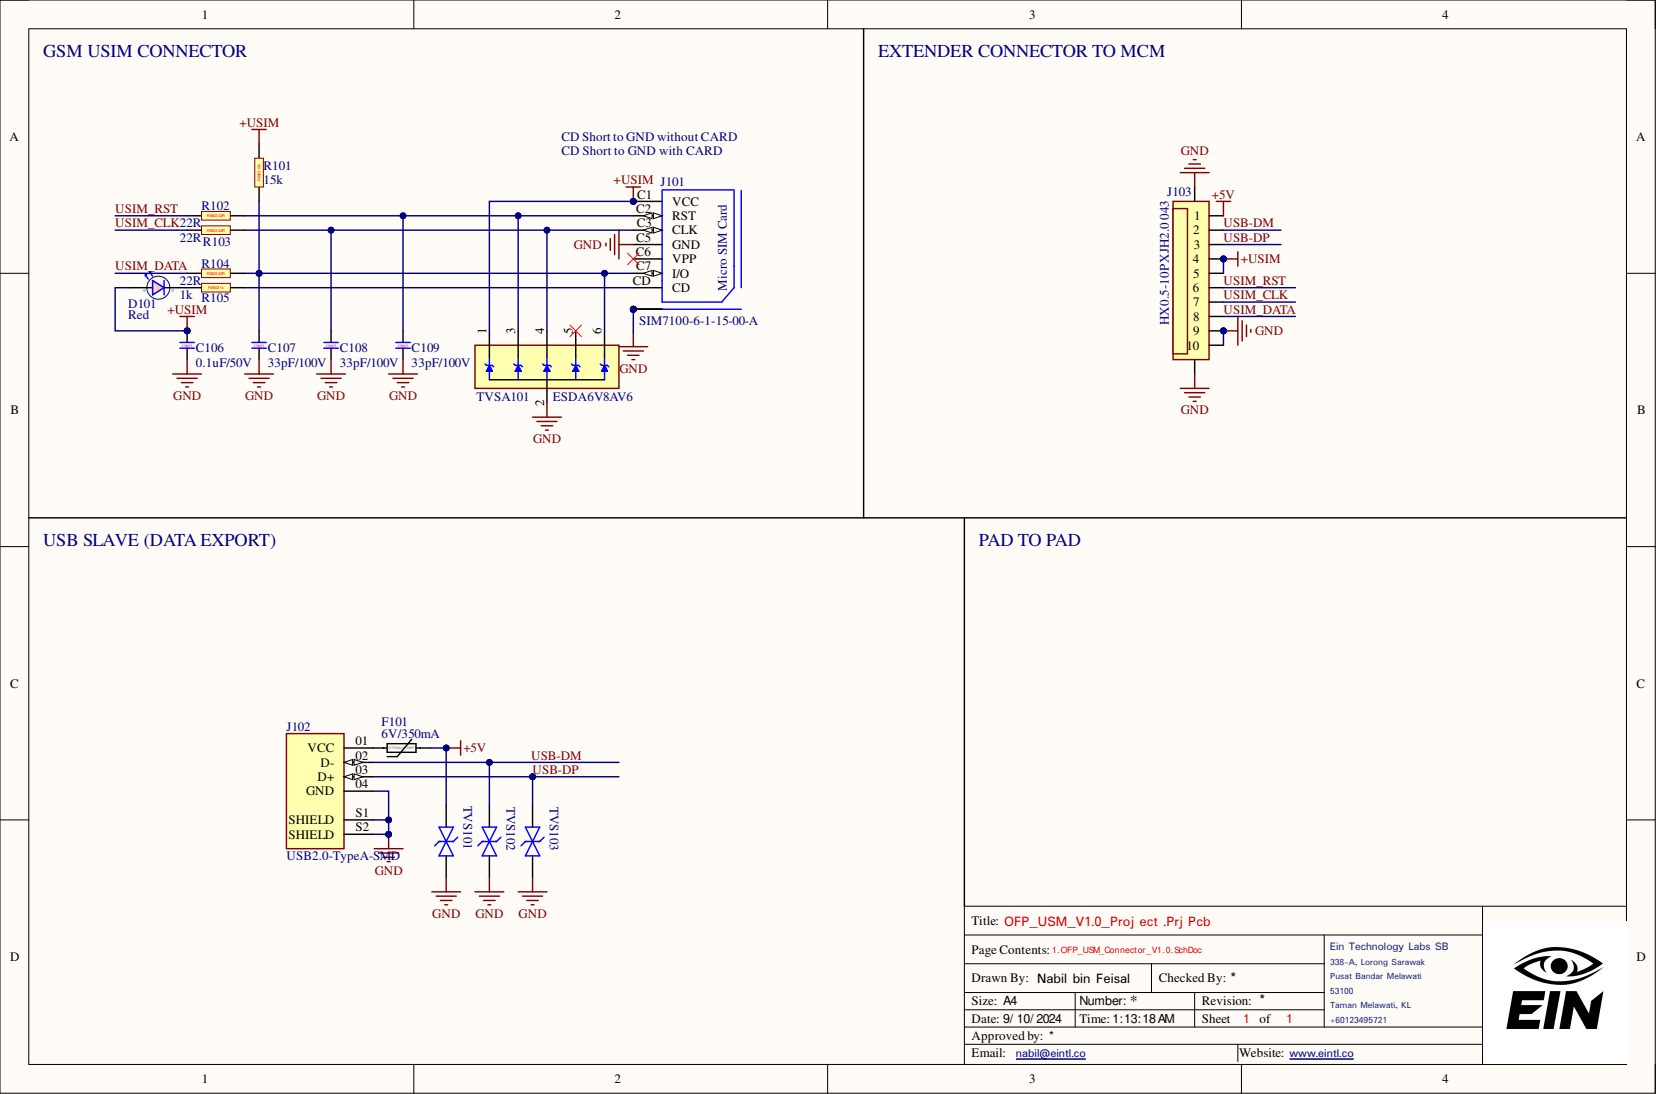
[picture p149: page 15]

CD Short to GND without CARD
CD Short to GND with CARD

USB SLAVE (DATA EXPORT)

Page Contents: 1.OFP_USM_Connector_V1.0.SchDoc | Ein Technology Labs SB D3 Innovation (M) Sdn Bhd 338-A, Lorong Sarawak Pusat Perniagaan, 3 Jalan Perniagaan, Taman Seri Juru Pusat Bandar Melawati 14100 53100

Drawn By: Chua Kai Quan Nabil bin Feisal | * Checked By:

## VOLTAGE CHANNELS CONNECTORPHASE A VOLTAGE INPUT

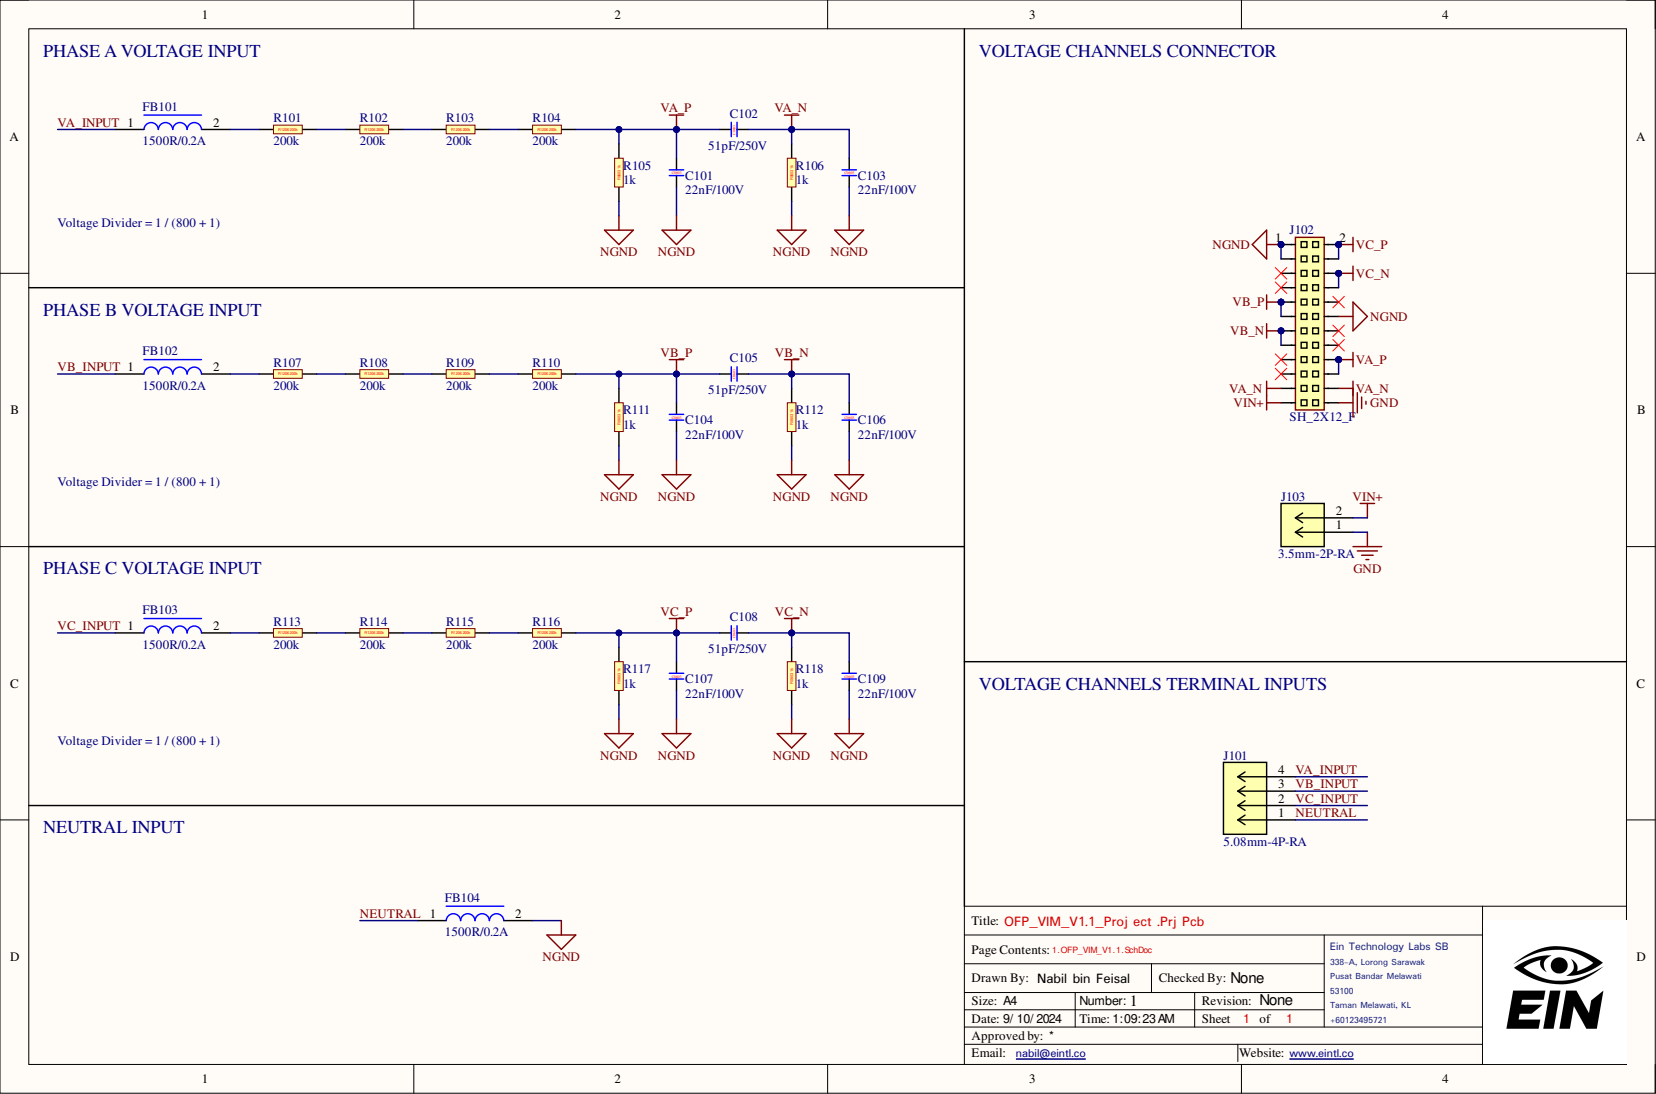
[picture p150: page 16]

VOLTAGE CHANNELS TERMINAL INPUTS

Page Contents: 1.OFP_VIM_V1.1.SchDoc | Ein Technology Labs SB D3 Innovation (M) Sdn Bhd 338-A, Lorong Sarawak Pusat Perniagaan, 3 Jalan Perniagaan, Taman Seri Juru Pusat Bandar Melawati 14100 53100

Drawn By: Chua Kai Quan Nabil bin Feisal | None Checked By:

1 | None
