eSpark-Backup/nabilfesal-smartmeter-hw/Design-Files/OFP_MCM_v1.6.3/Deliverables/_Schematics/Assembly File.pdf

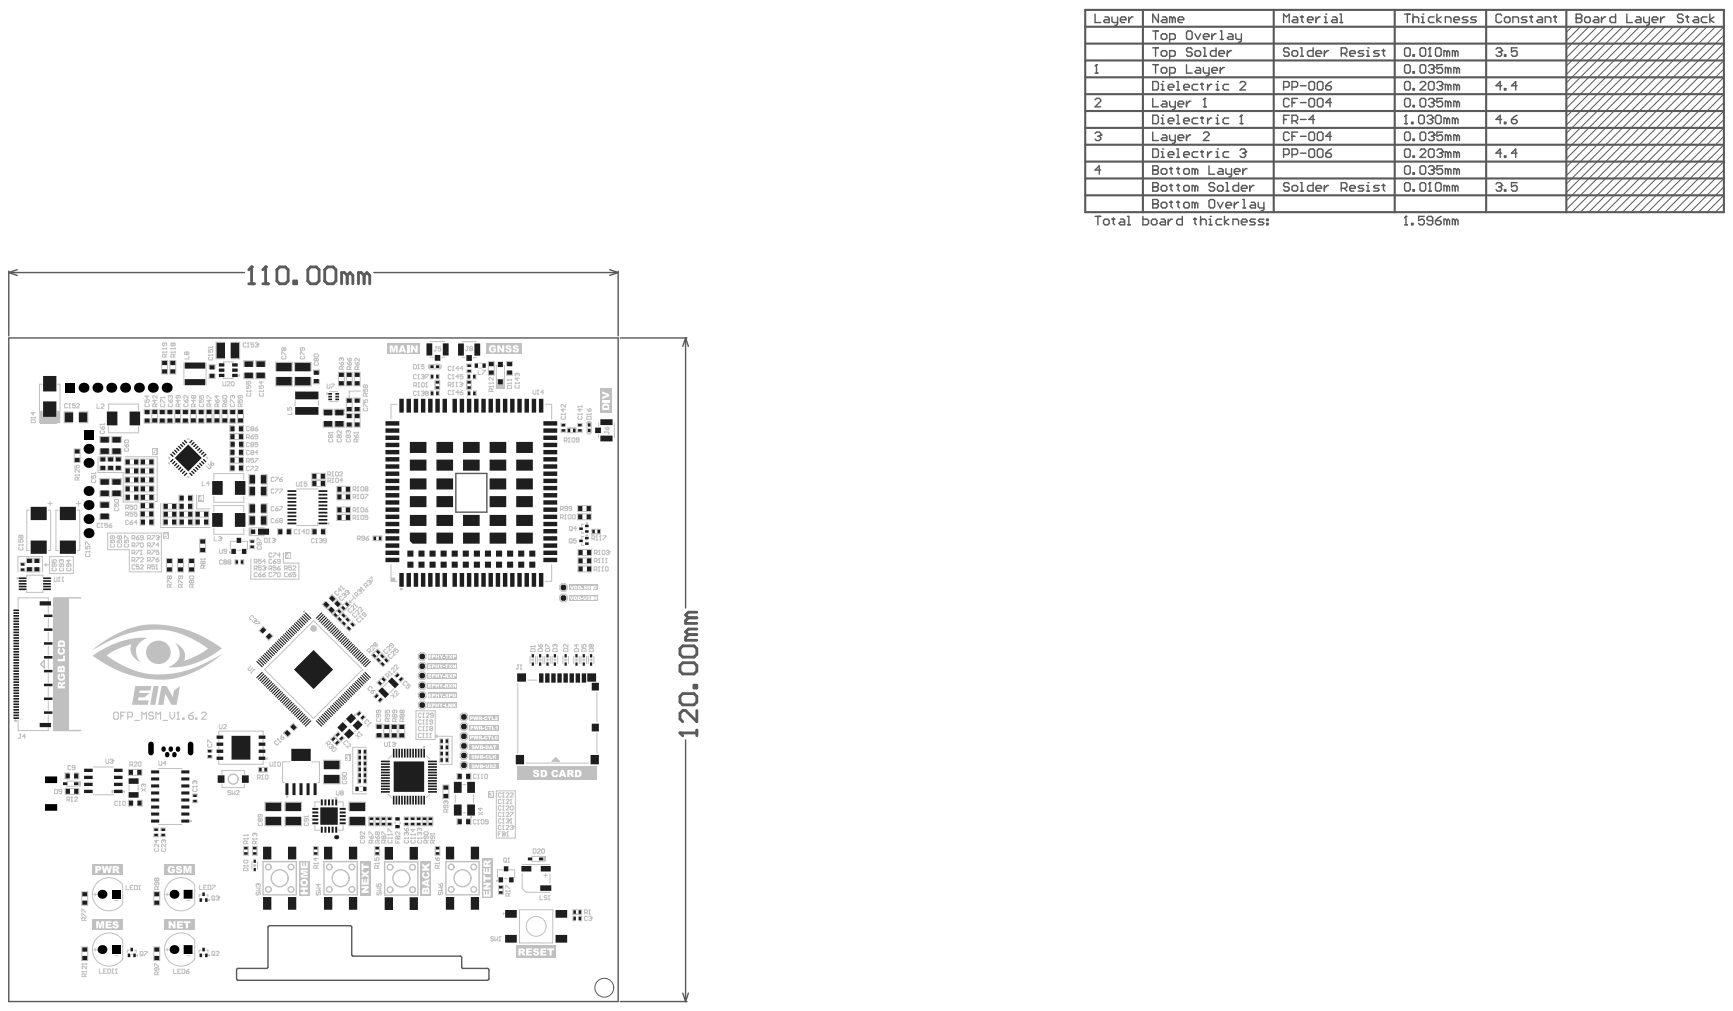
[picture p151: page 1]

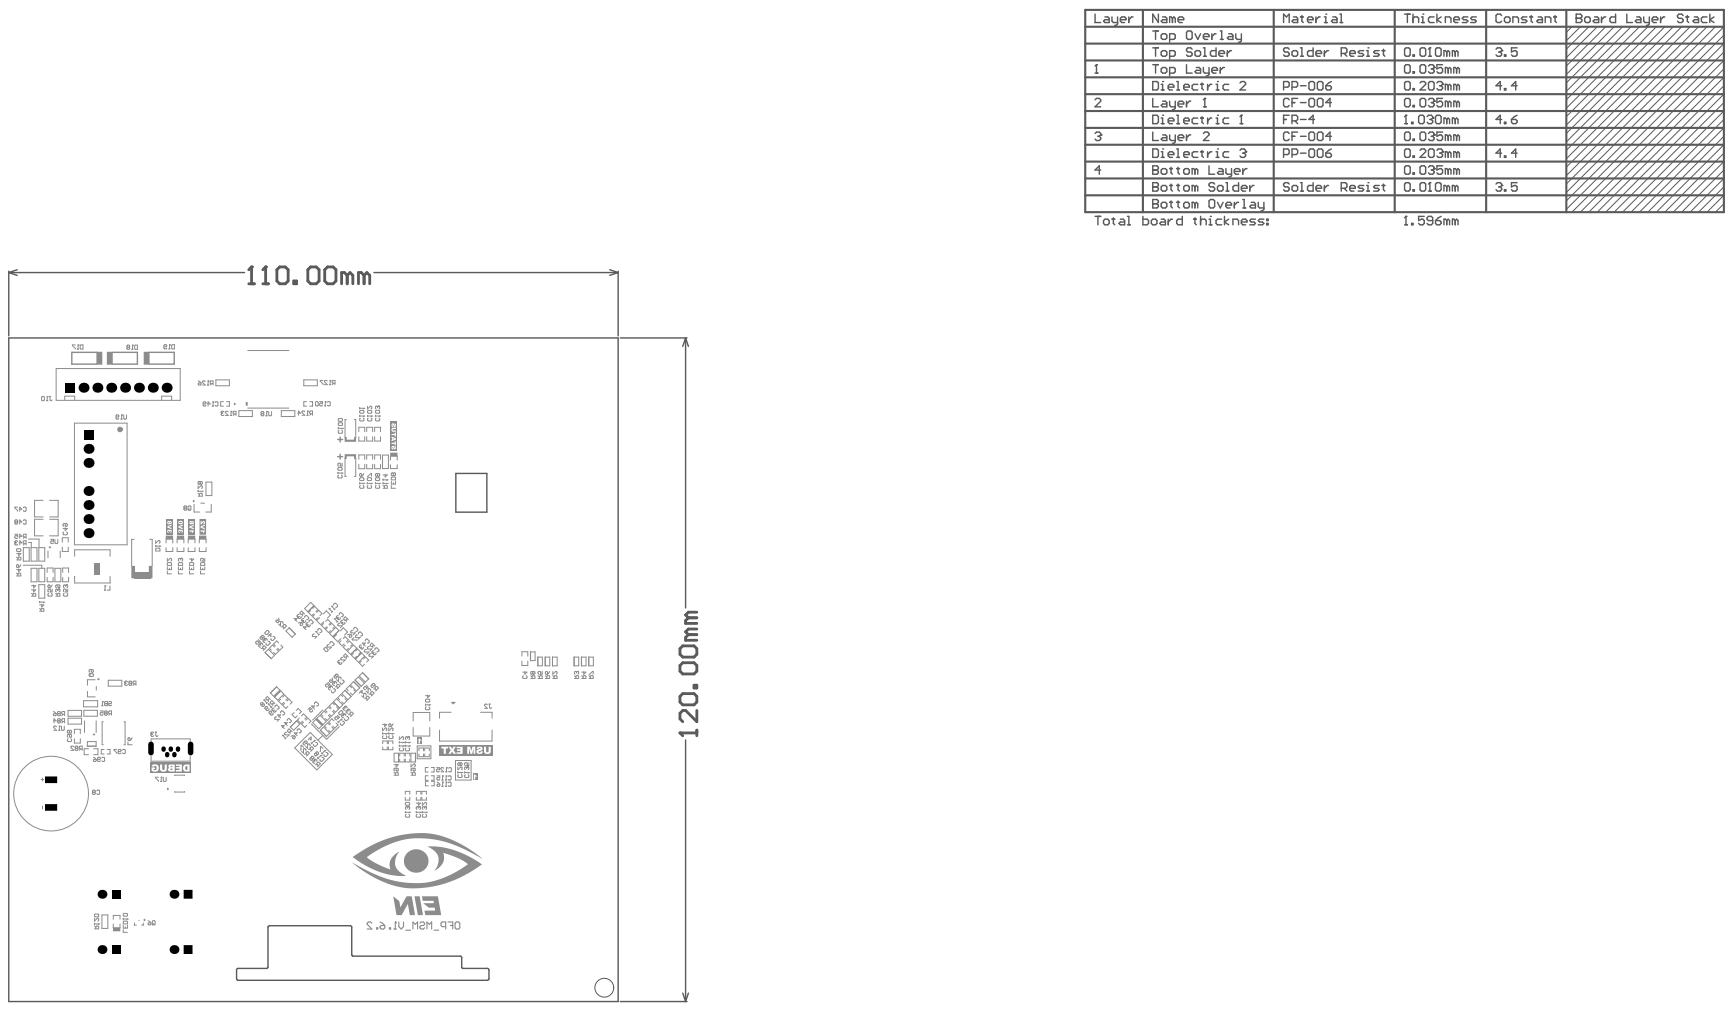
[picture p152: page 2]

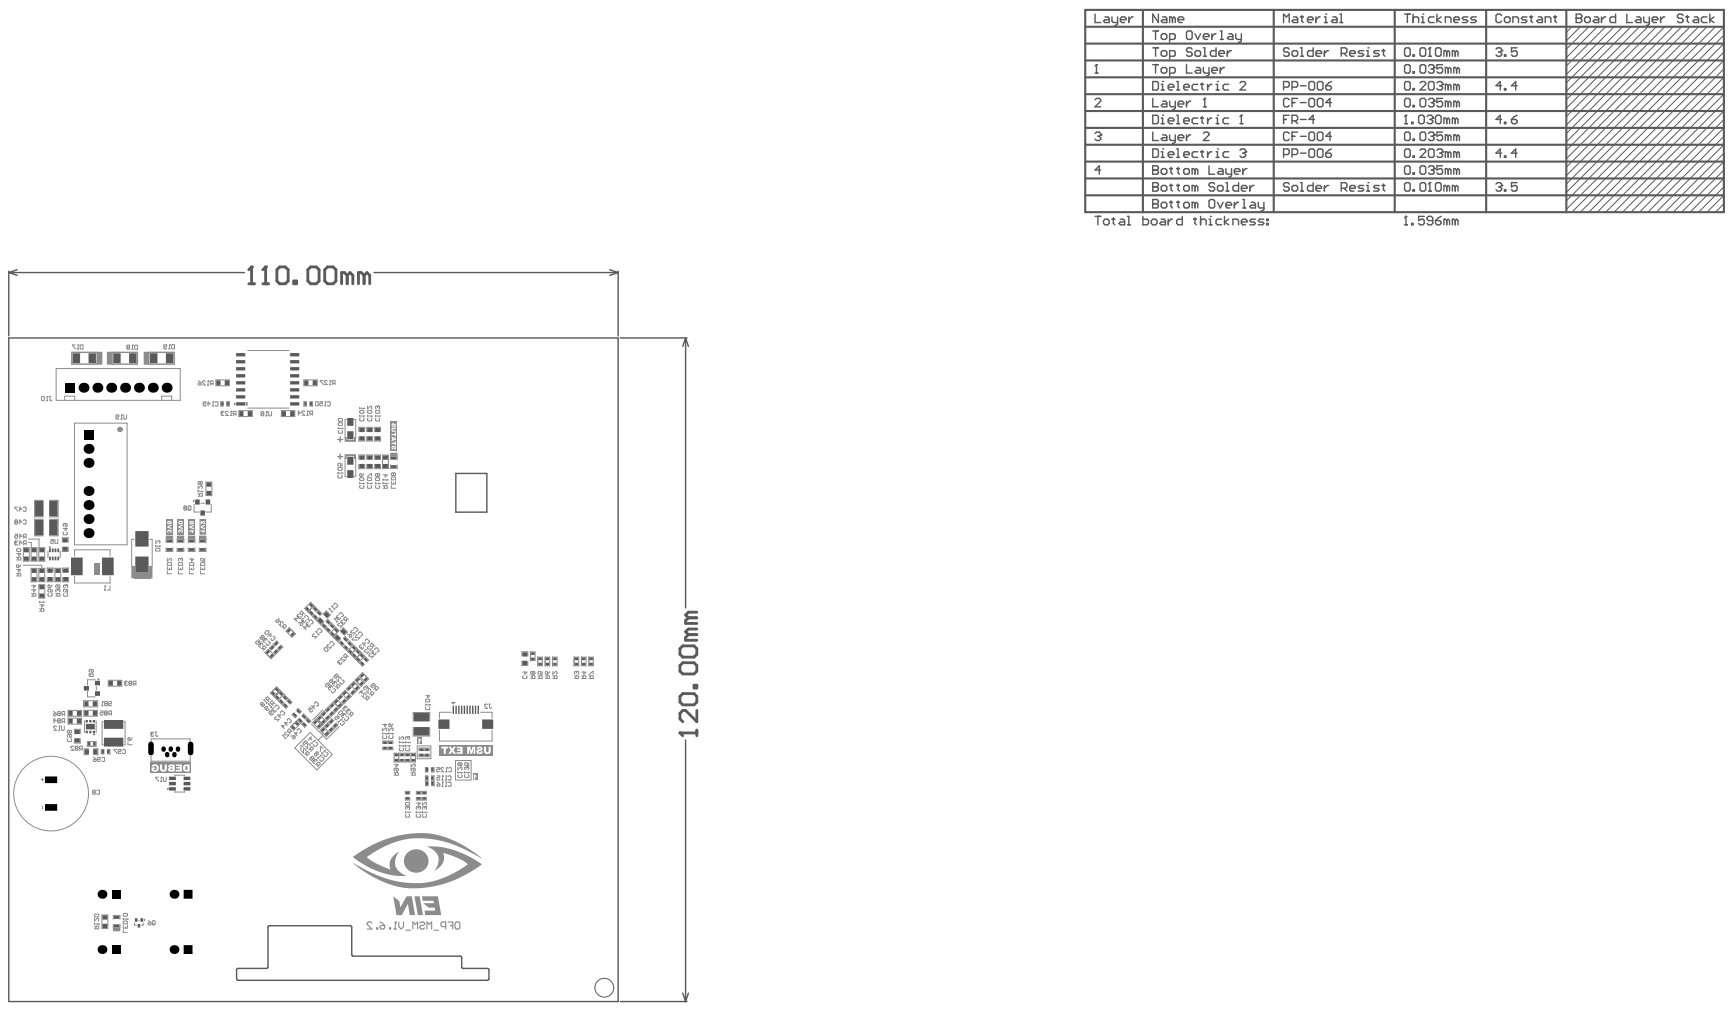
[picture p153: page 4]
