eSpark-Backup/nabilfesal-smartmeter-hw/Design-Files/OFP_VIM_DC_v1.51/Deliverables/Assembly Drawings/Assembly Drawing.pdf

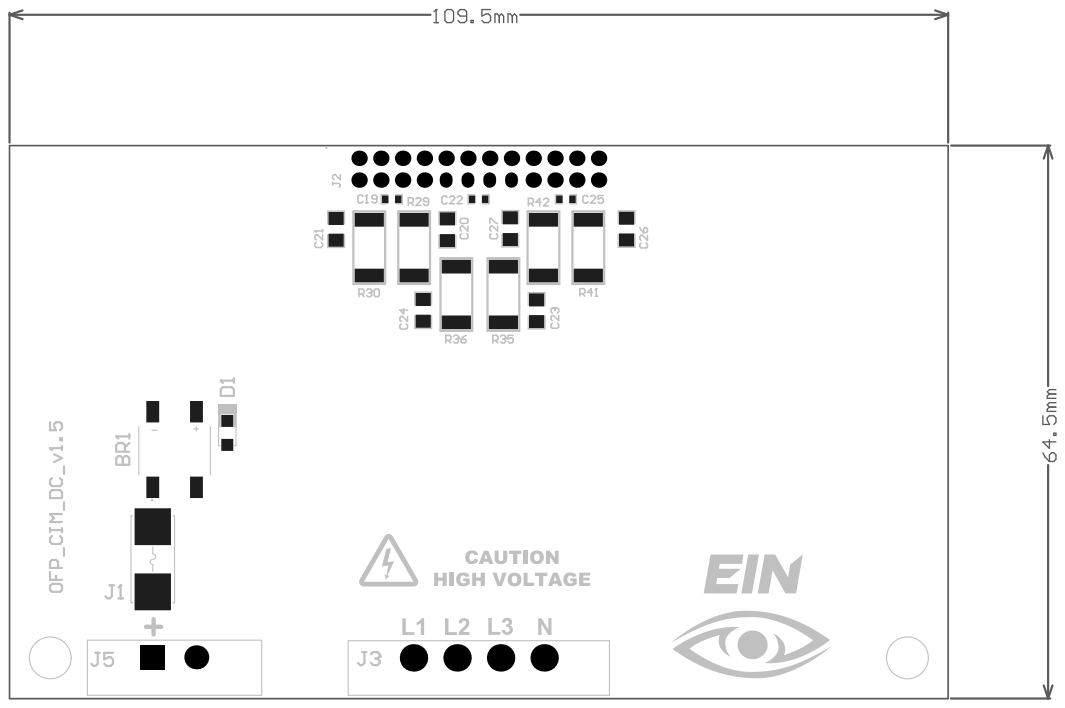
[picture p154: page 1]

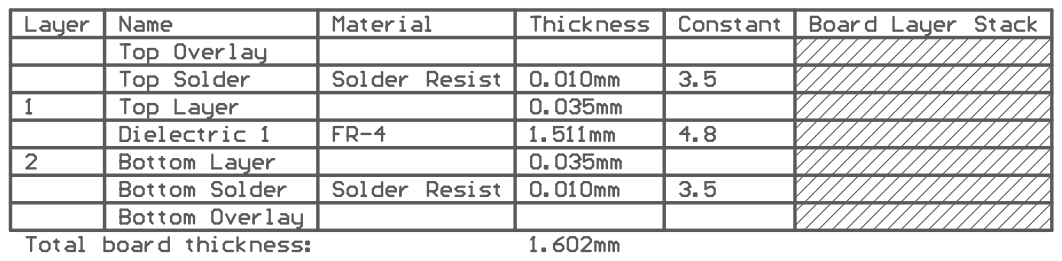
[picture p155: page 2]

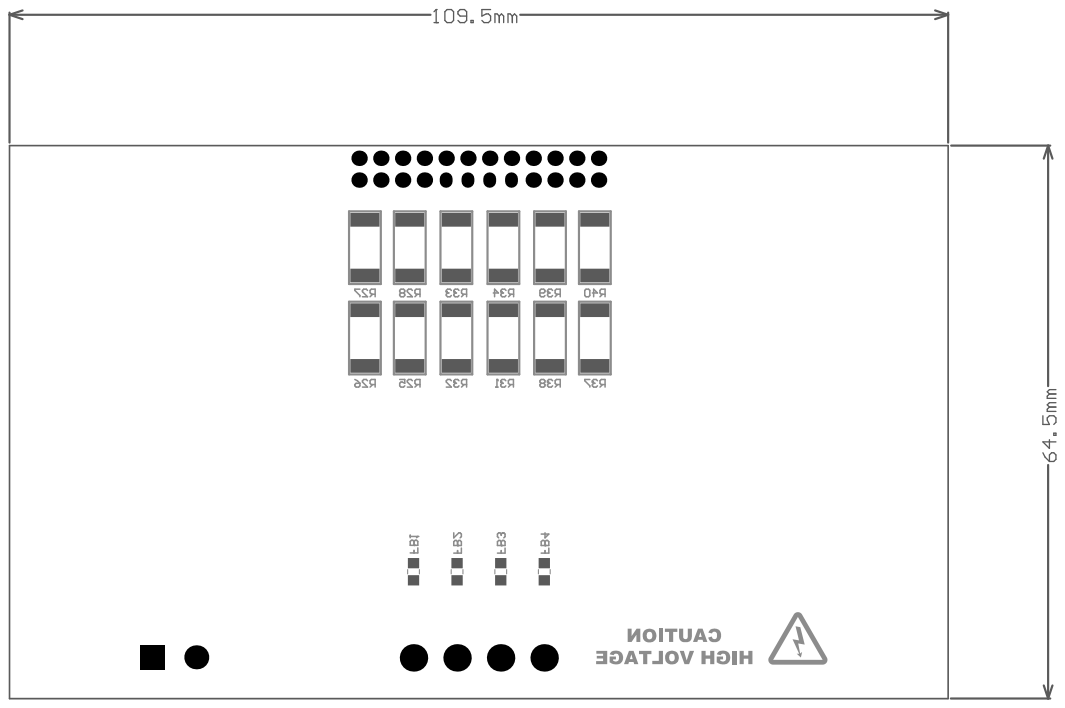
[picture p156: page 3]
