eSpark-Backup/nabilfesal-smartmeter-hw/Design-Files/OFP_VIM_v1.51/Deliverables/Assembly Drawings/Assembly Drawing.pdf

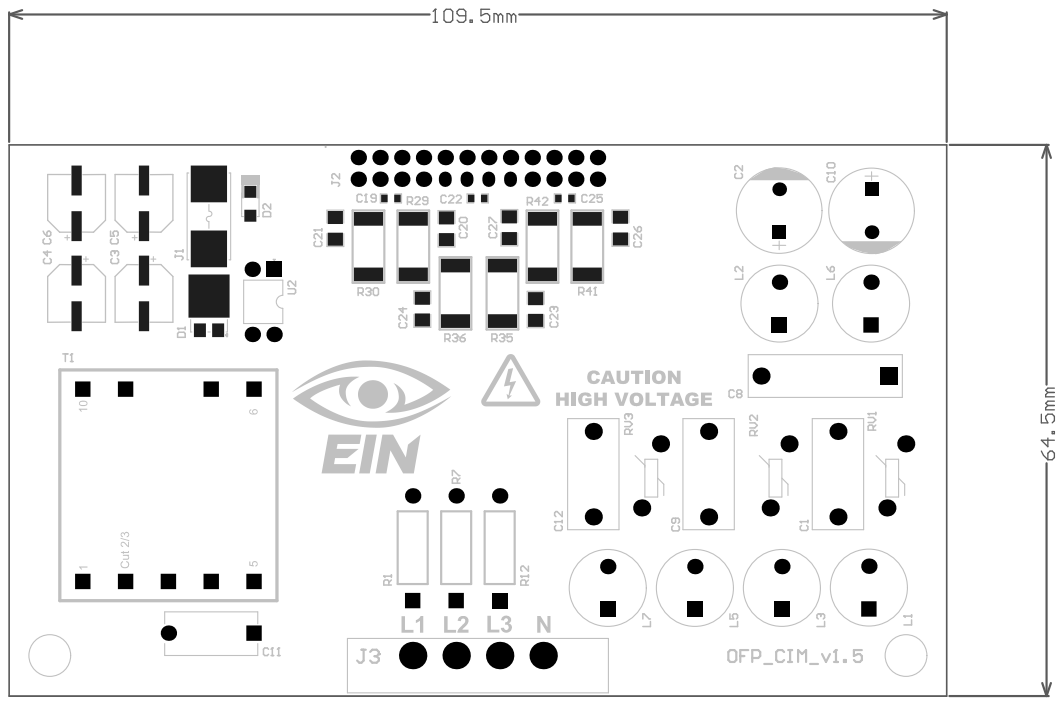
[picture p157: page 1]

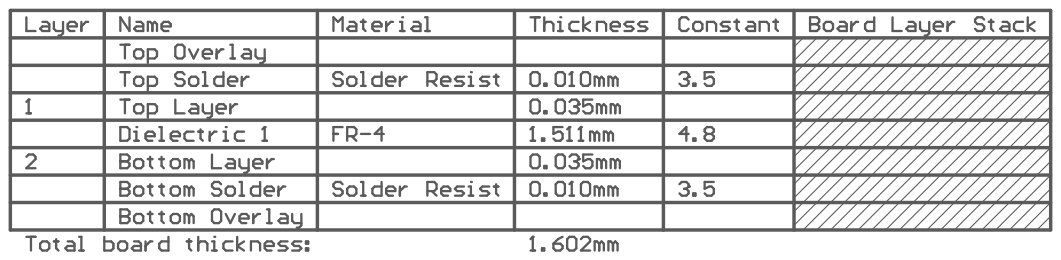
[picture p158: page 2]

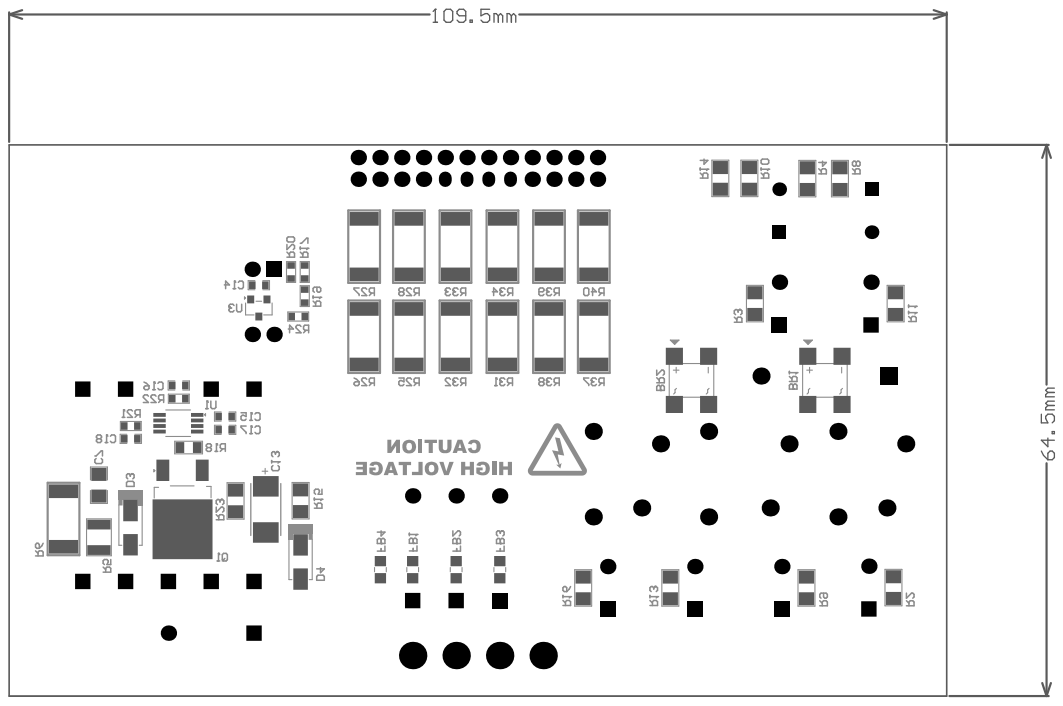
[picture p159: page 3]
