eSpark-Backup/nabilfesal-smartmeter-hw/Design-Files/OFP_USM_v1.5/Deliverables/Assembly Drawings/Assembly Drawing.pdf

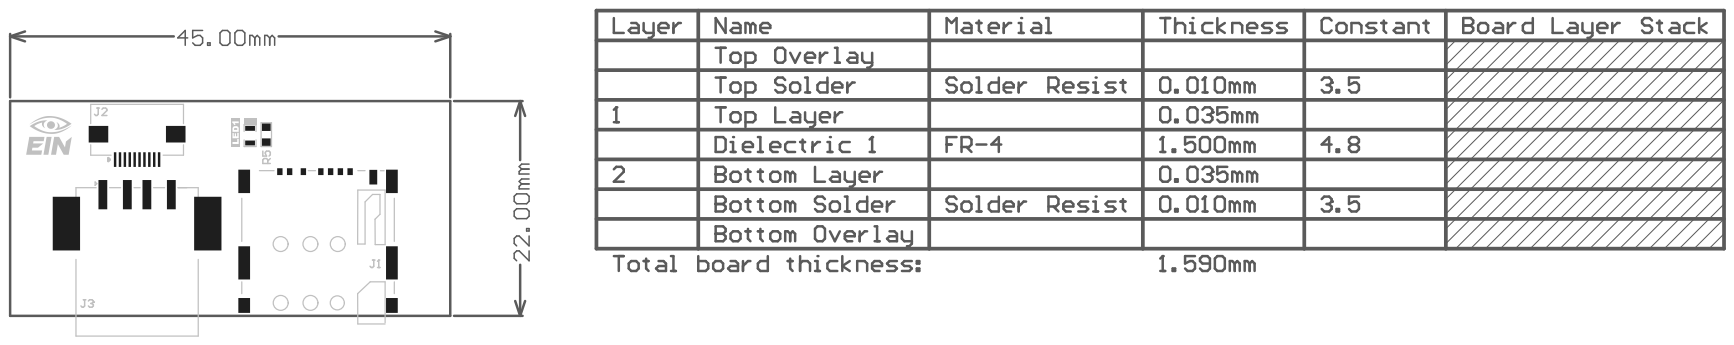
[picture p160: page 1]

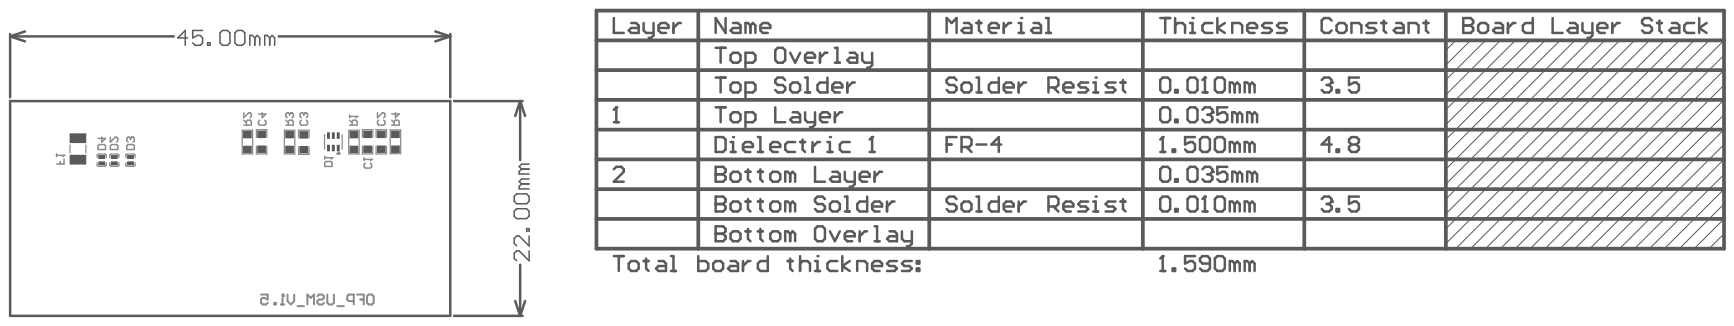
[picture p161: page 2]
