eSpark-Backup/nabilfesal-smartmeter-hw/Design-Files/OFP_USM_v1.5/Deliverables/Assembly Drawings/OFP_USM_v1.5.pdf

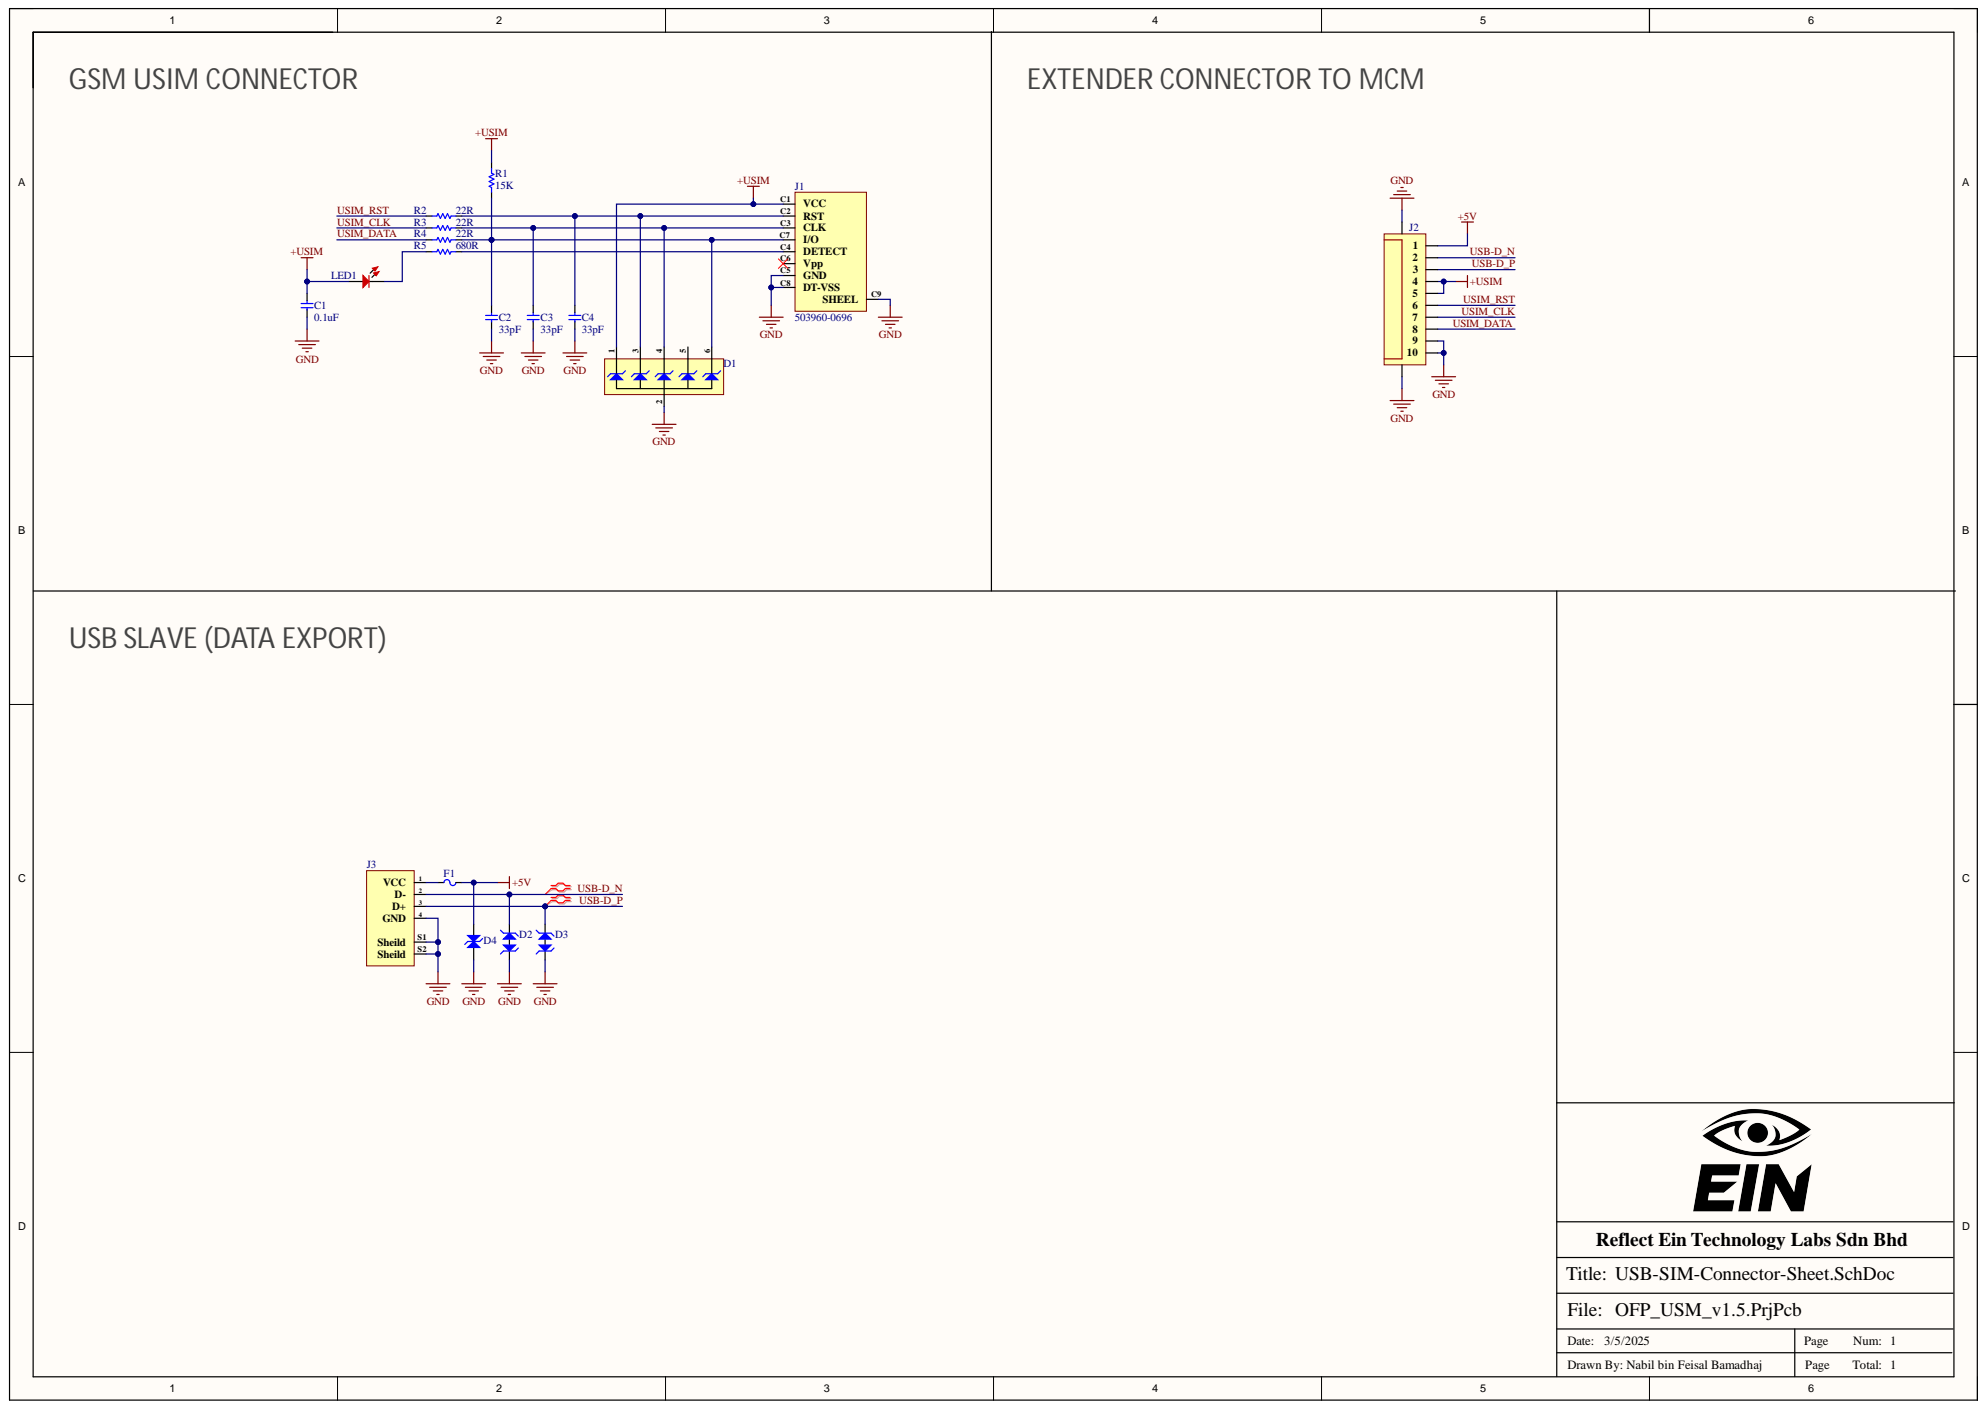
[picture p162: page 1]

3 | USB-D_ P

Reflect Ein Technology Labs Sdn Bhd

Date : 3/5/2 0 2 5 | P a g e Nu m : 11

Drawn By: Nabil bin F eisal Ba m a d h aj | P a g e T ota l :

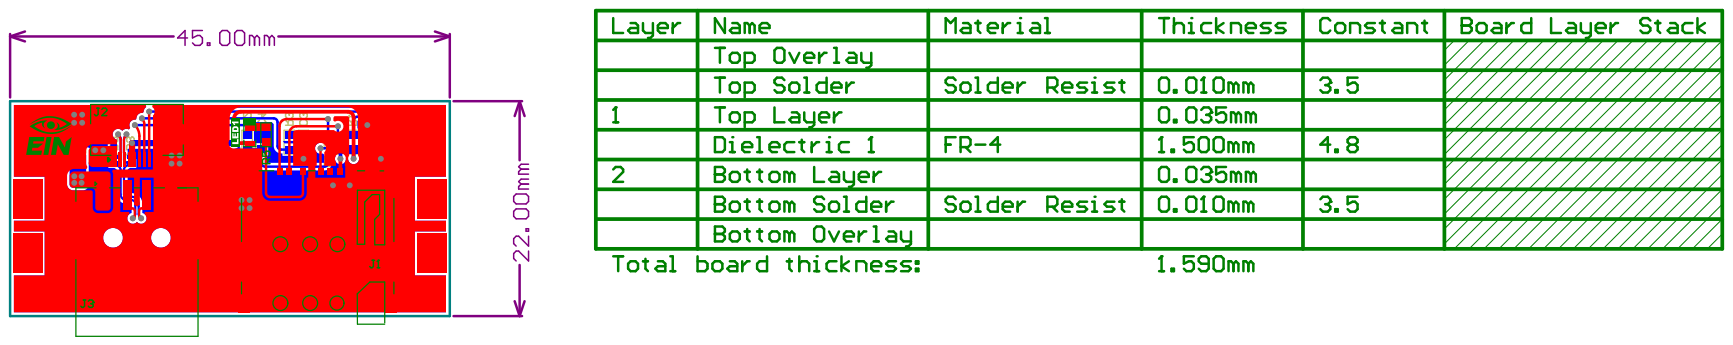
[picture p163: page 2]
