eSpark-Backup/nabilfesal-smartmeter-hw/docs/Client-Files/Product Files/MSM-Documentation-24122024/PCB/PCB_OutJob_CIM_V1.4.PDF

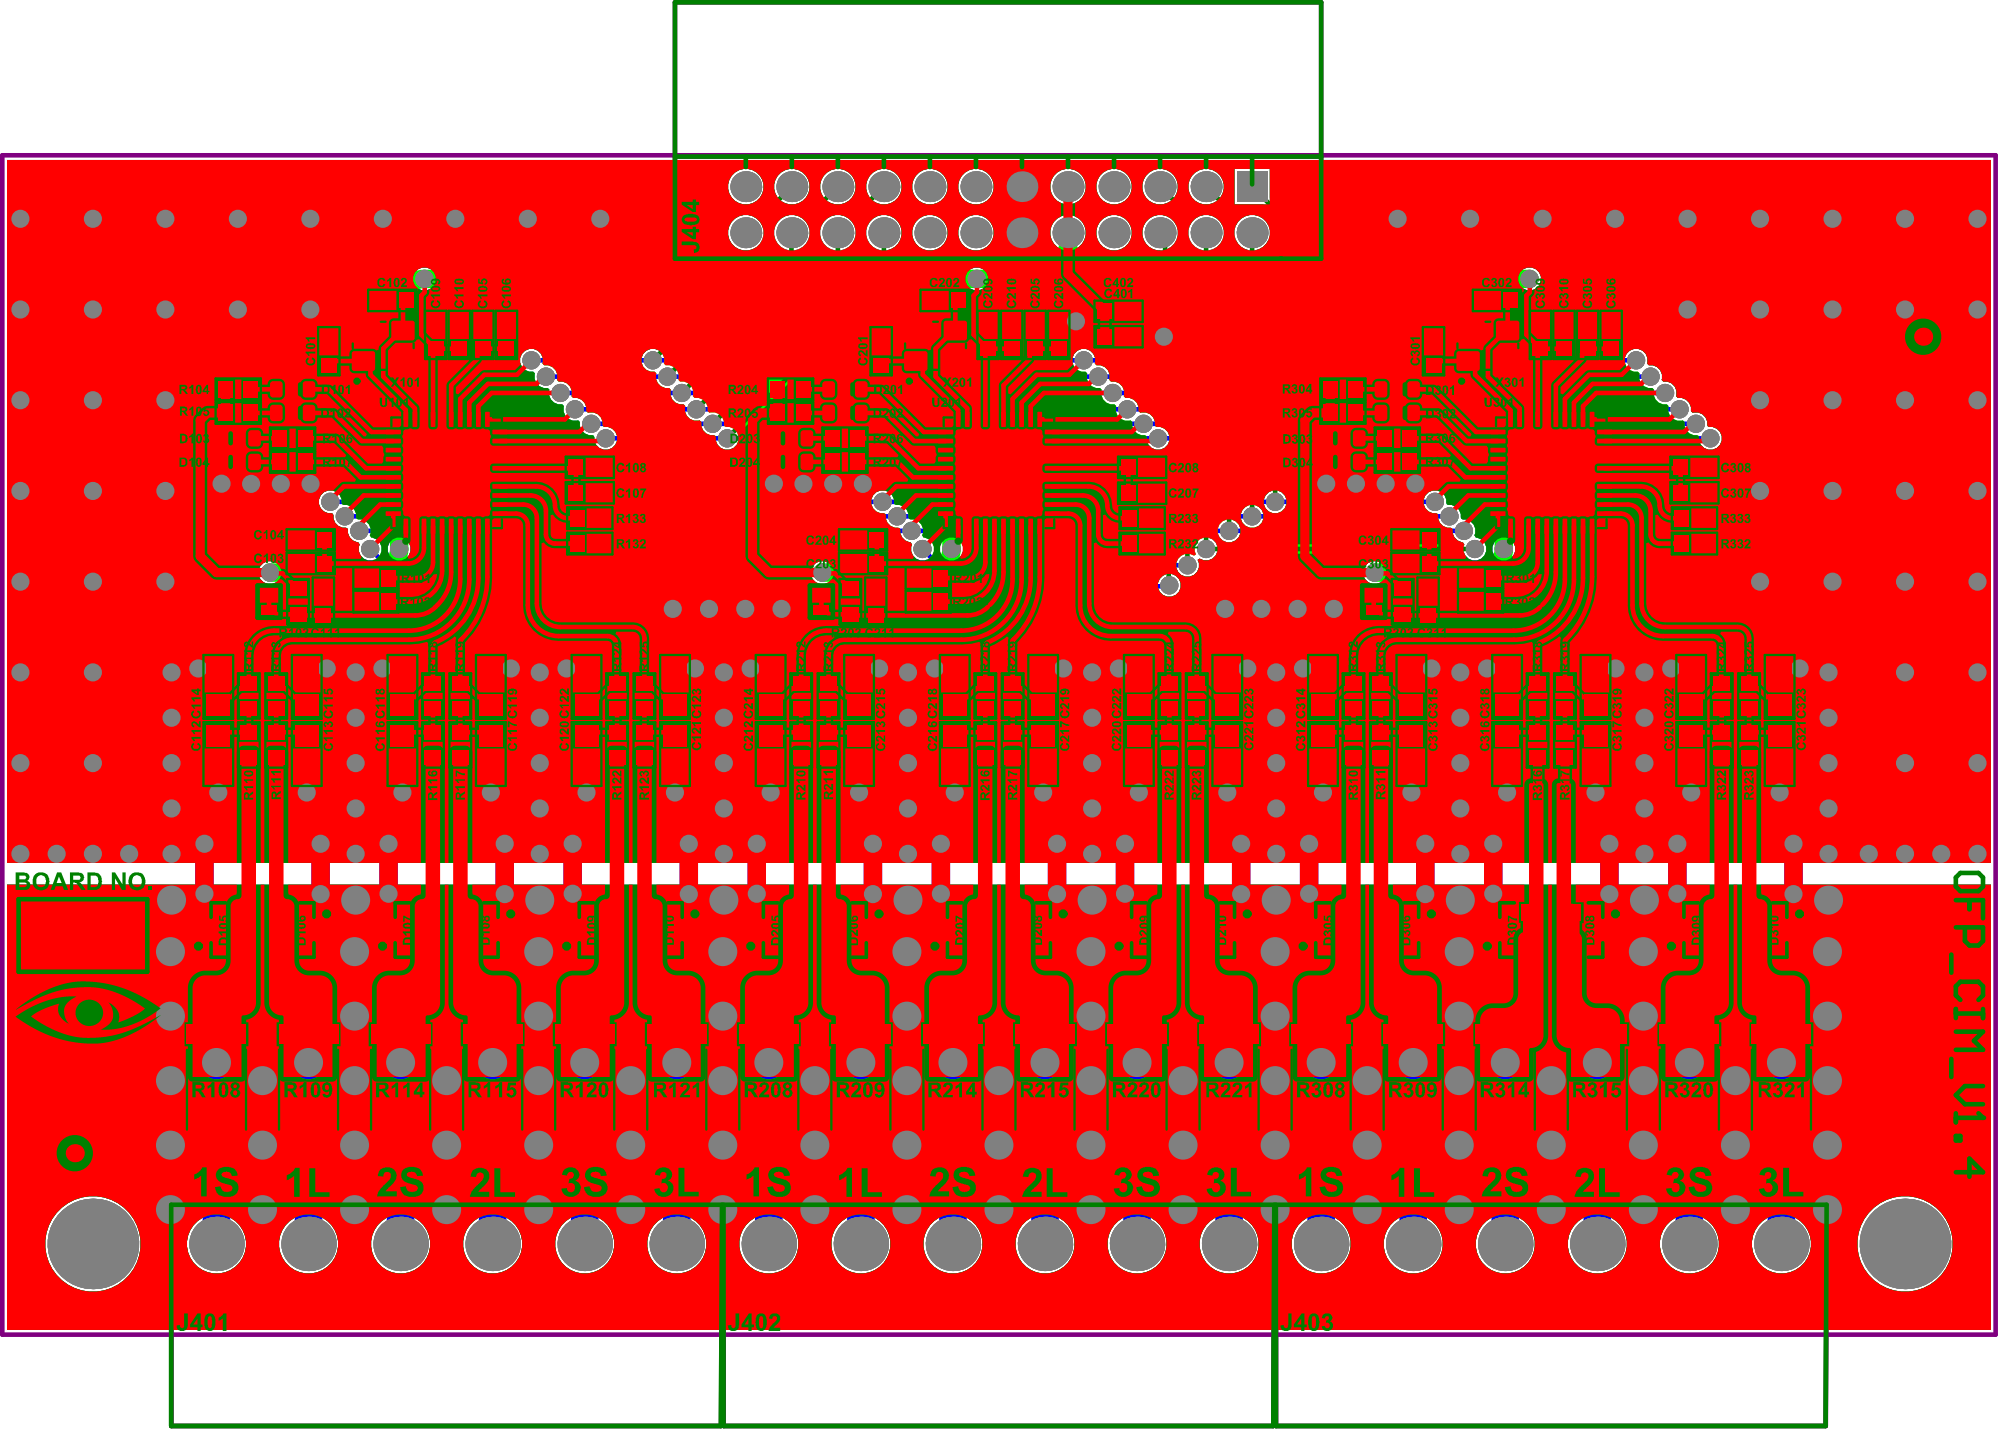
[picture p164: page 1]

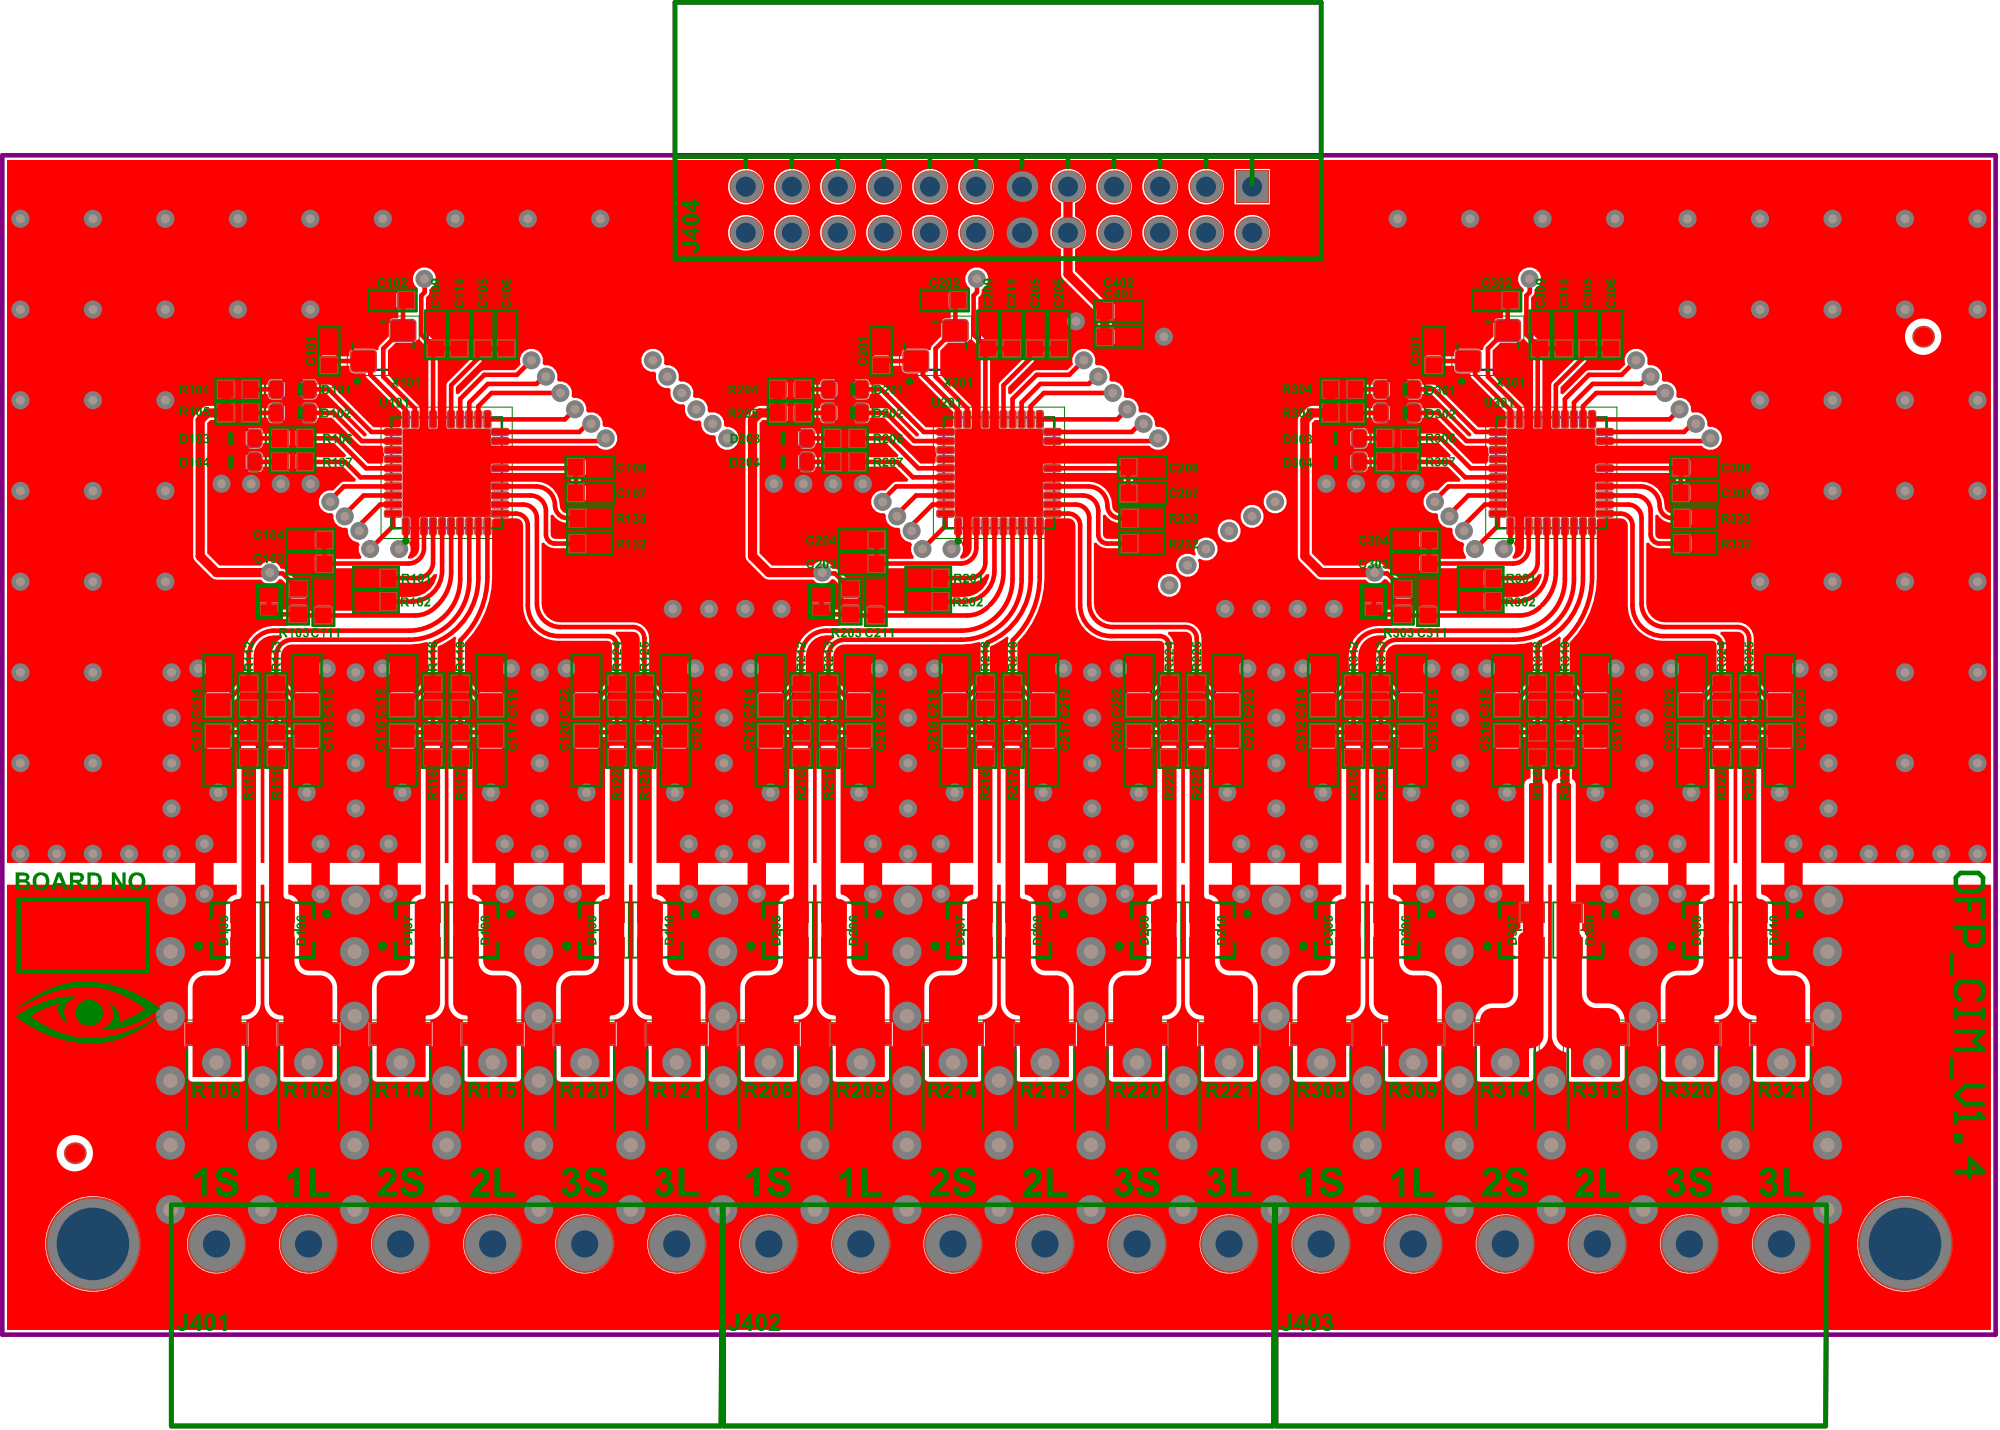
[picture p165: page 2]

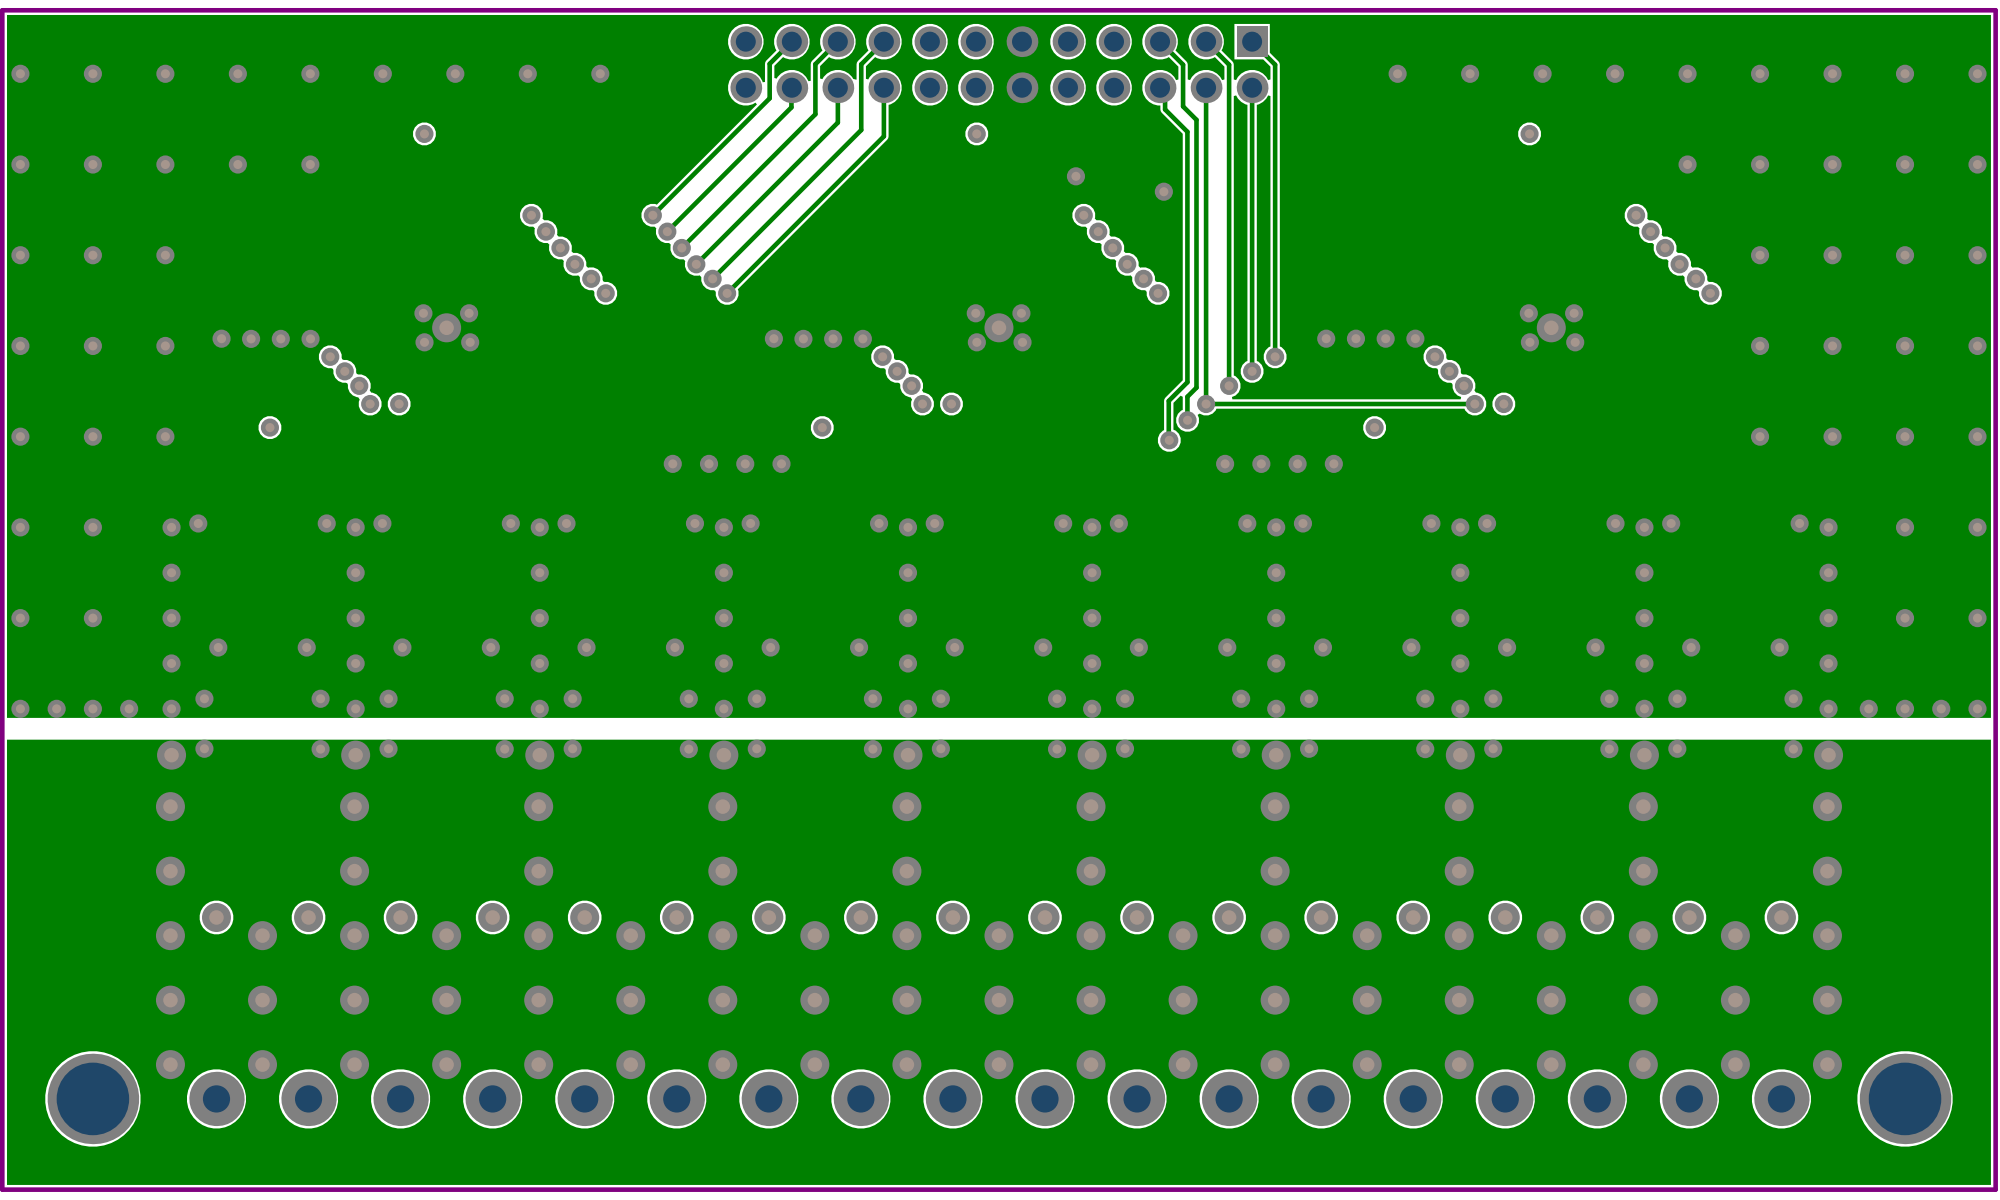
[picture p166: page 3]

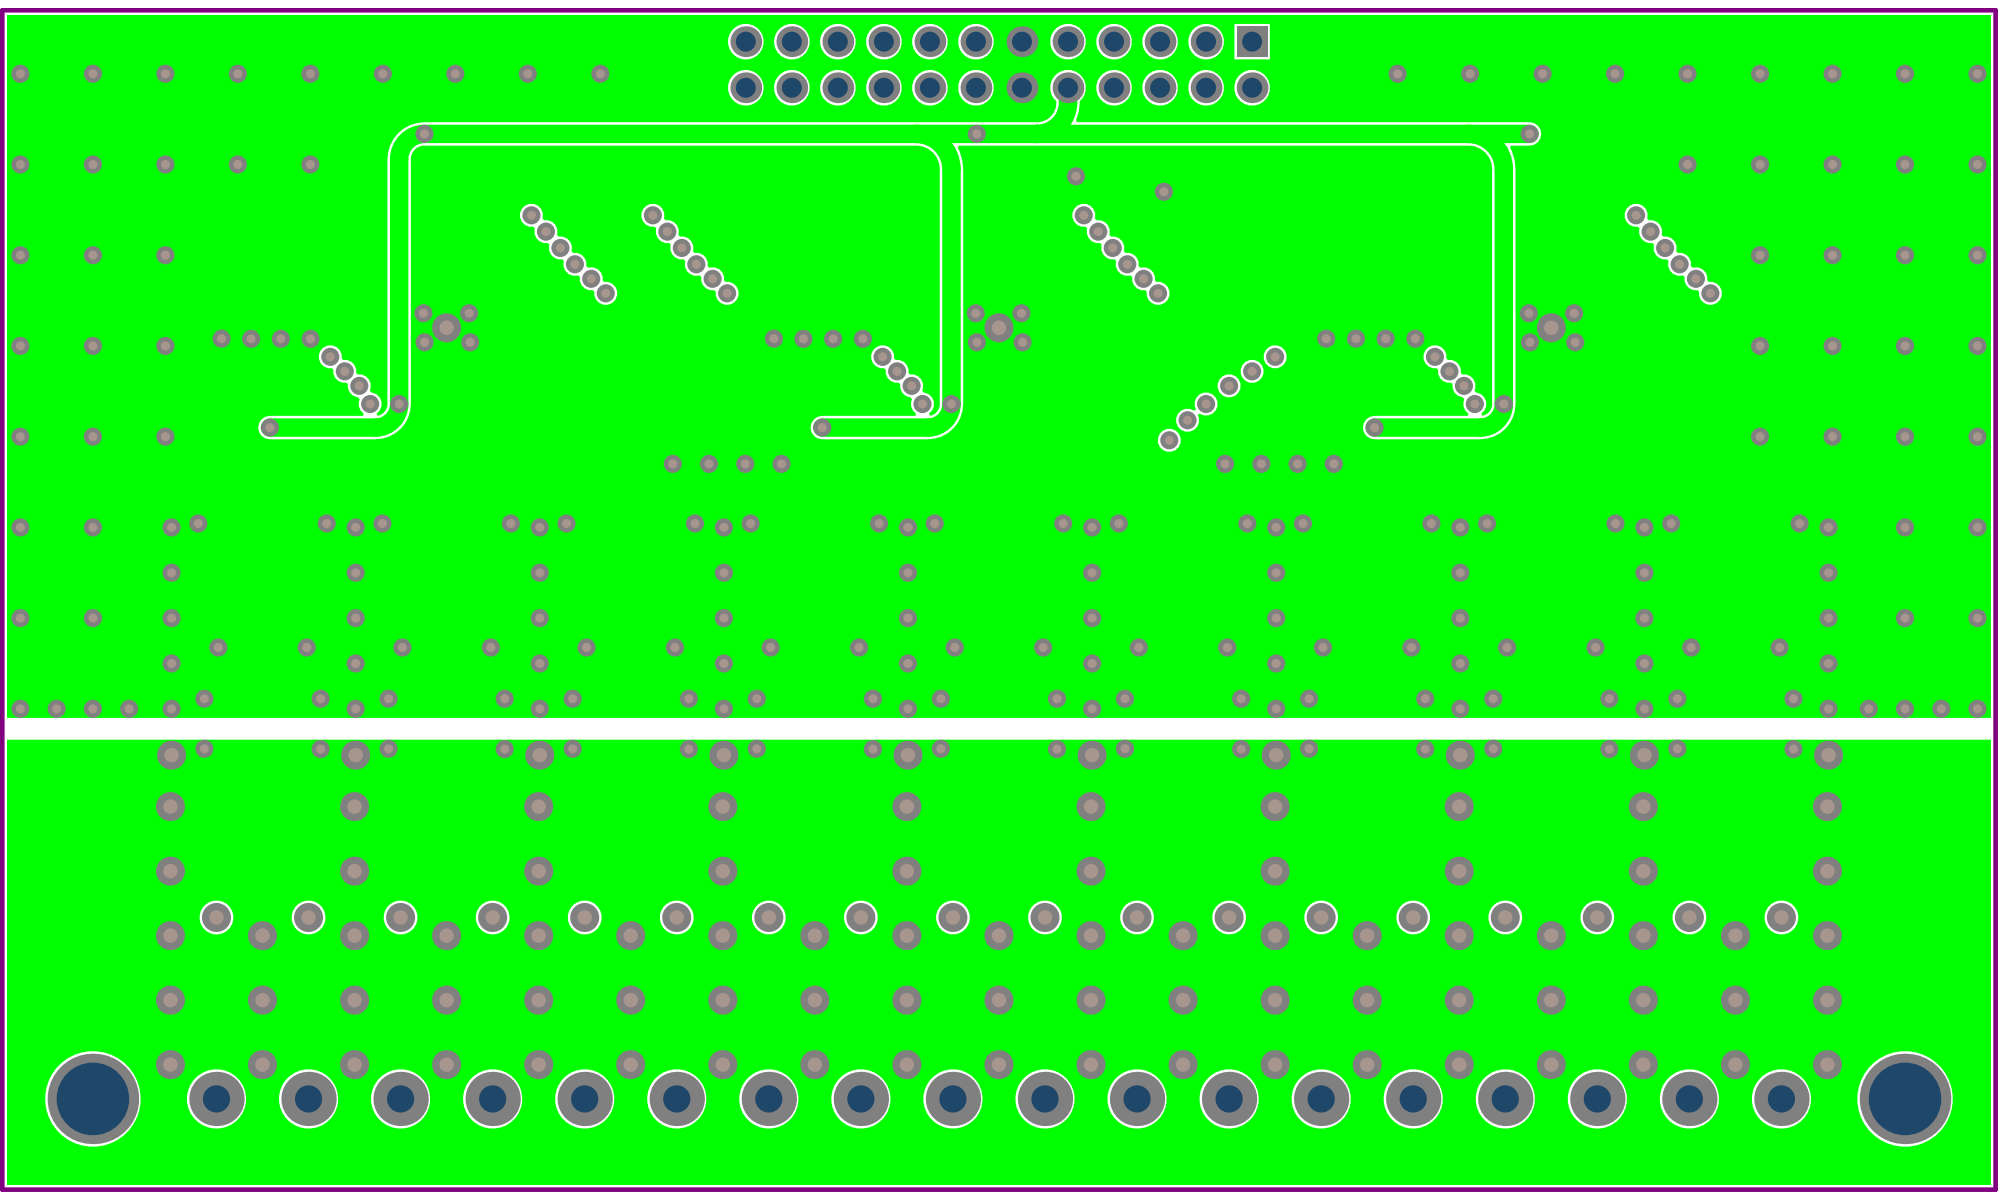
[picture p167: page 4]

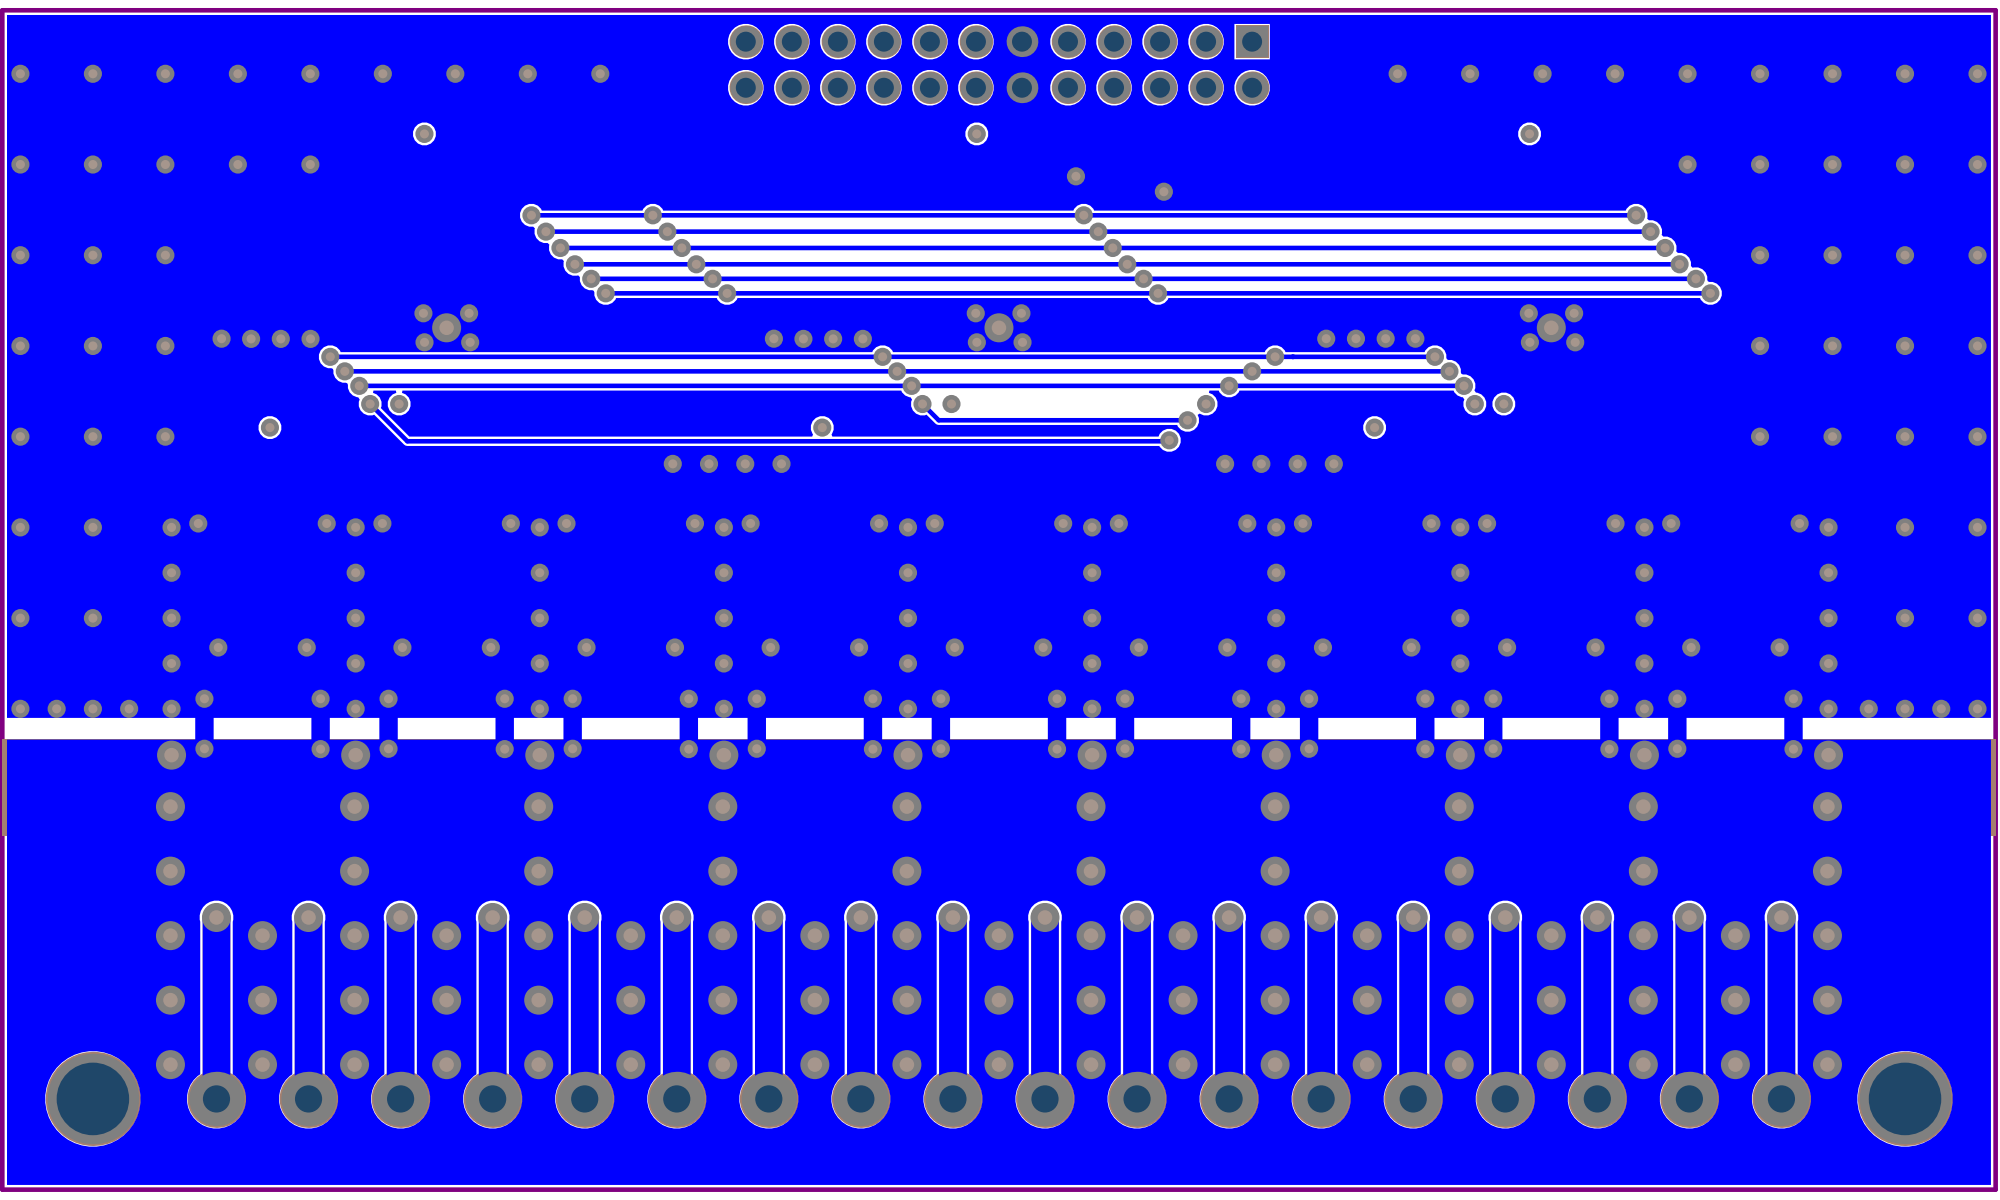
[picture p168: page 5]

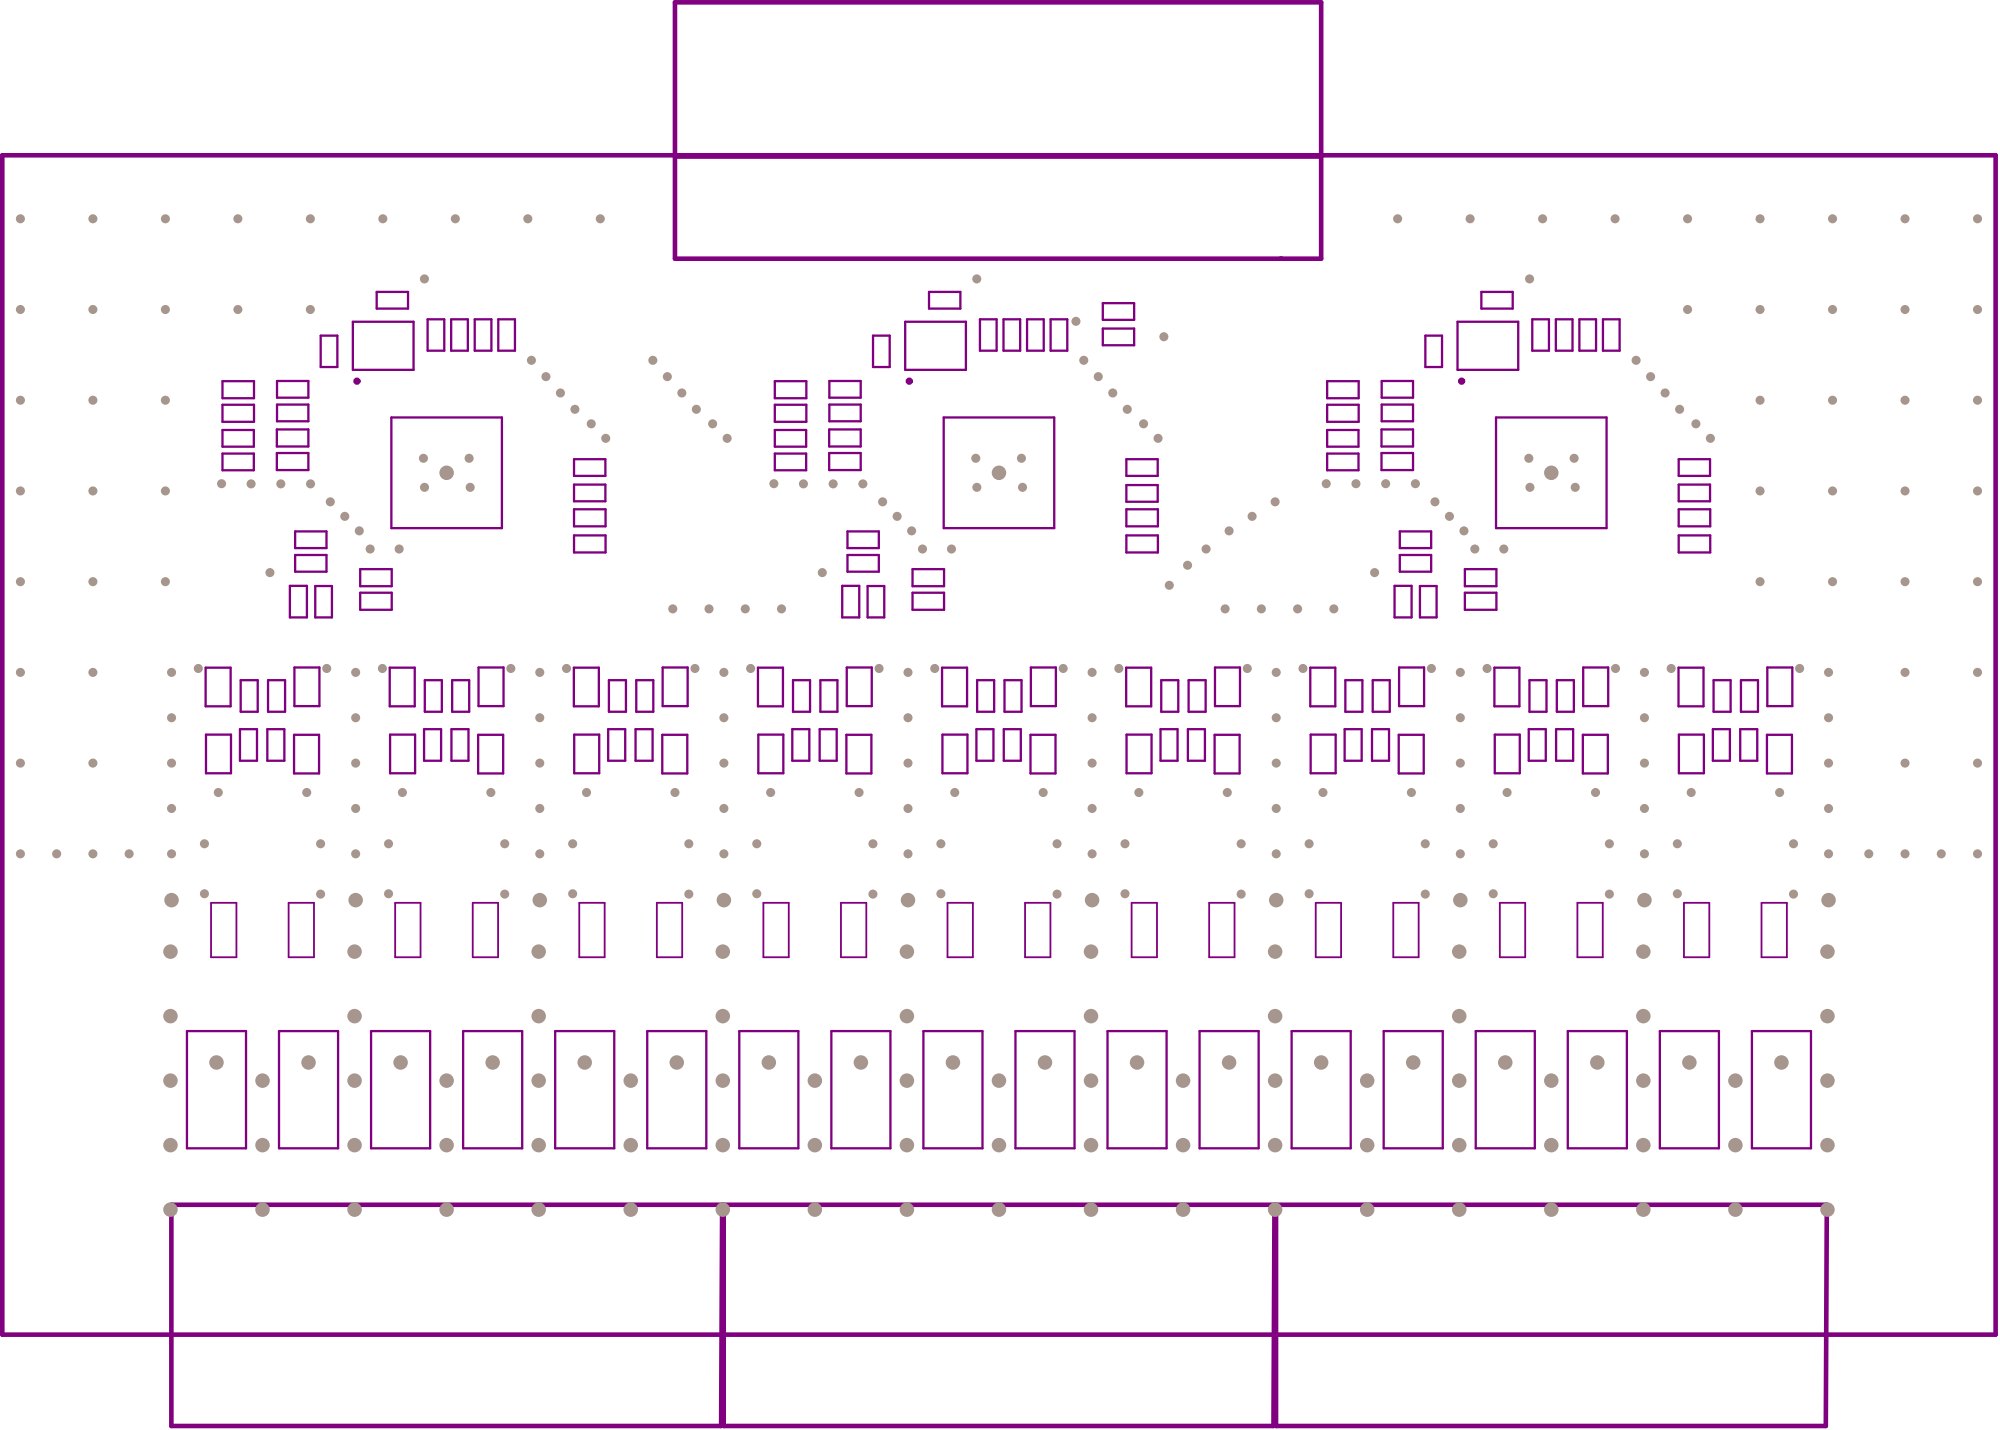
[picture p169: page 6]

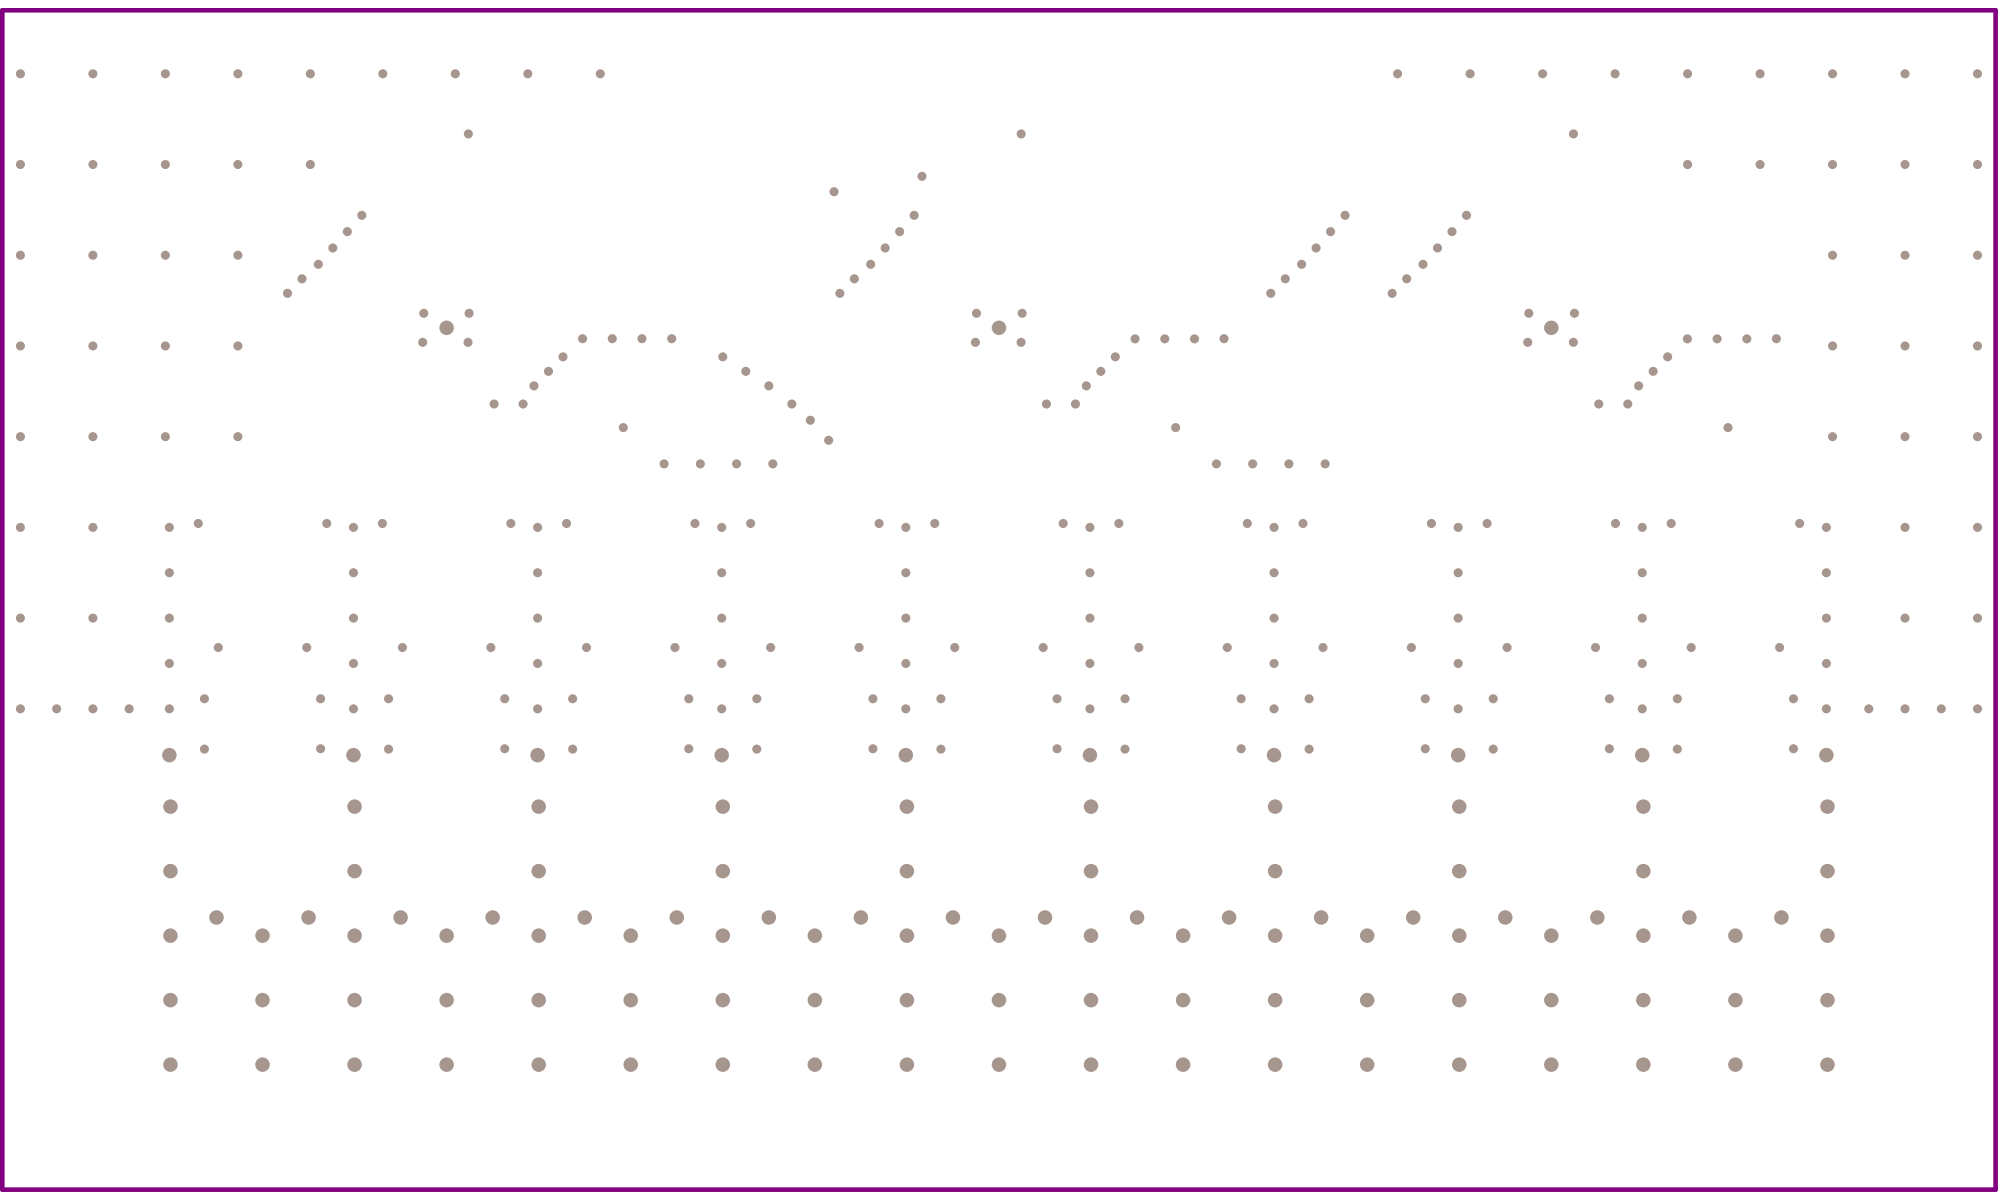
[picture p170: page 7]

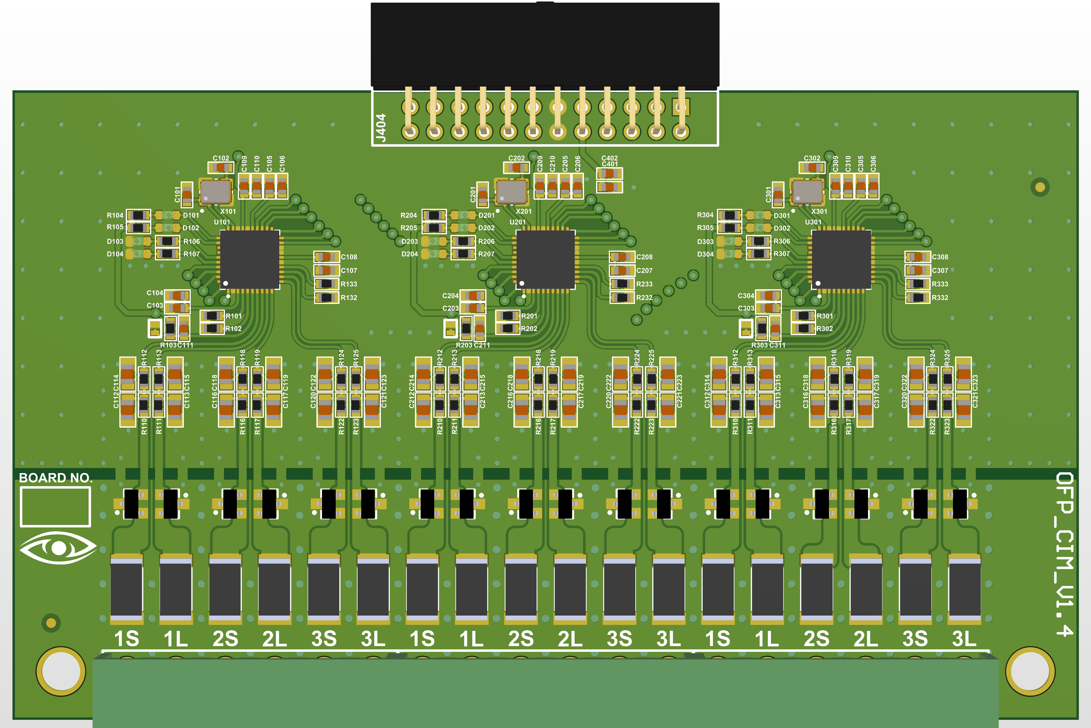
[picture p171: page 8]

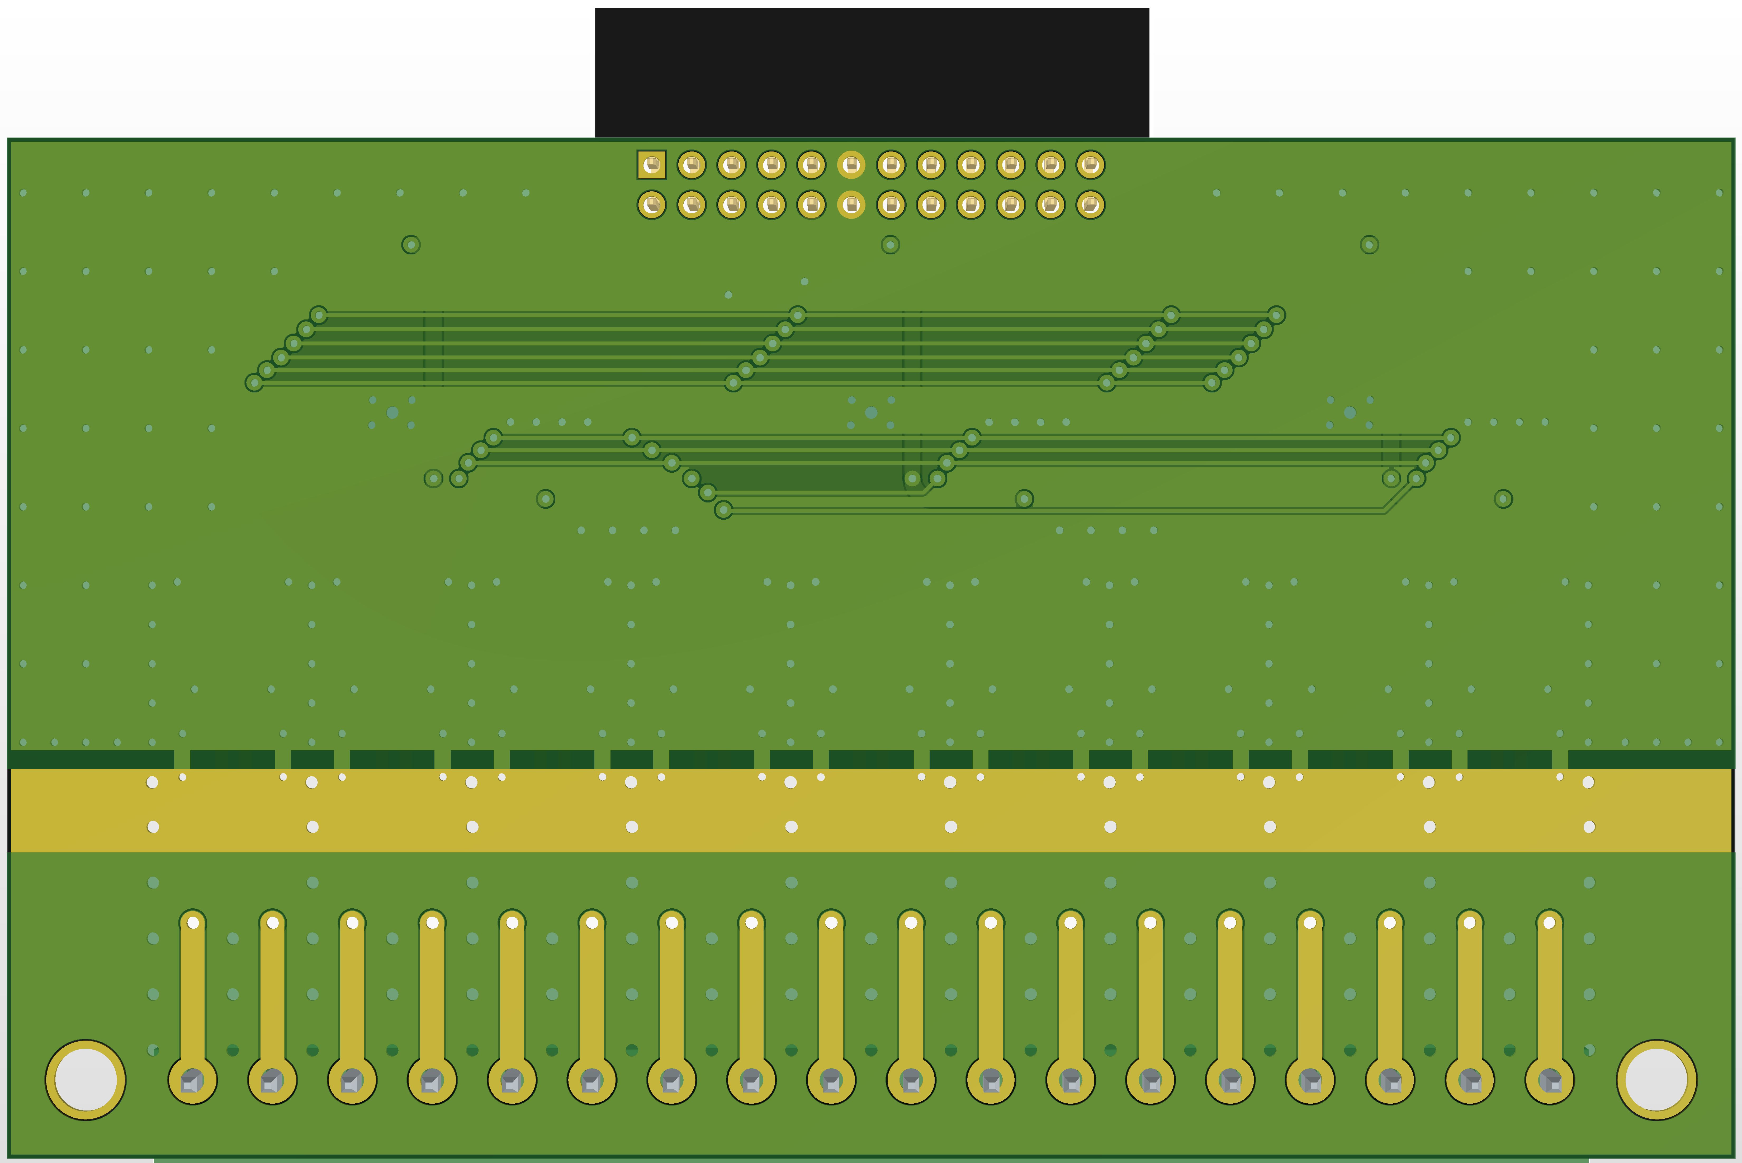
[picture p172: page 9]
