eSpark-Backup/nabilfesal-smartmeter-hw/docs/Client-Files/Product Files/MSM-Documentation-24122024/PCB/PCB_OutJob_MCM_V1.1.PDF

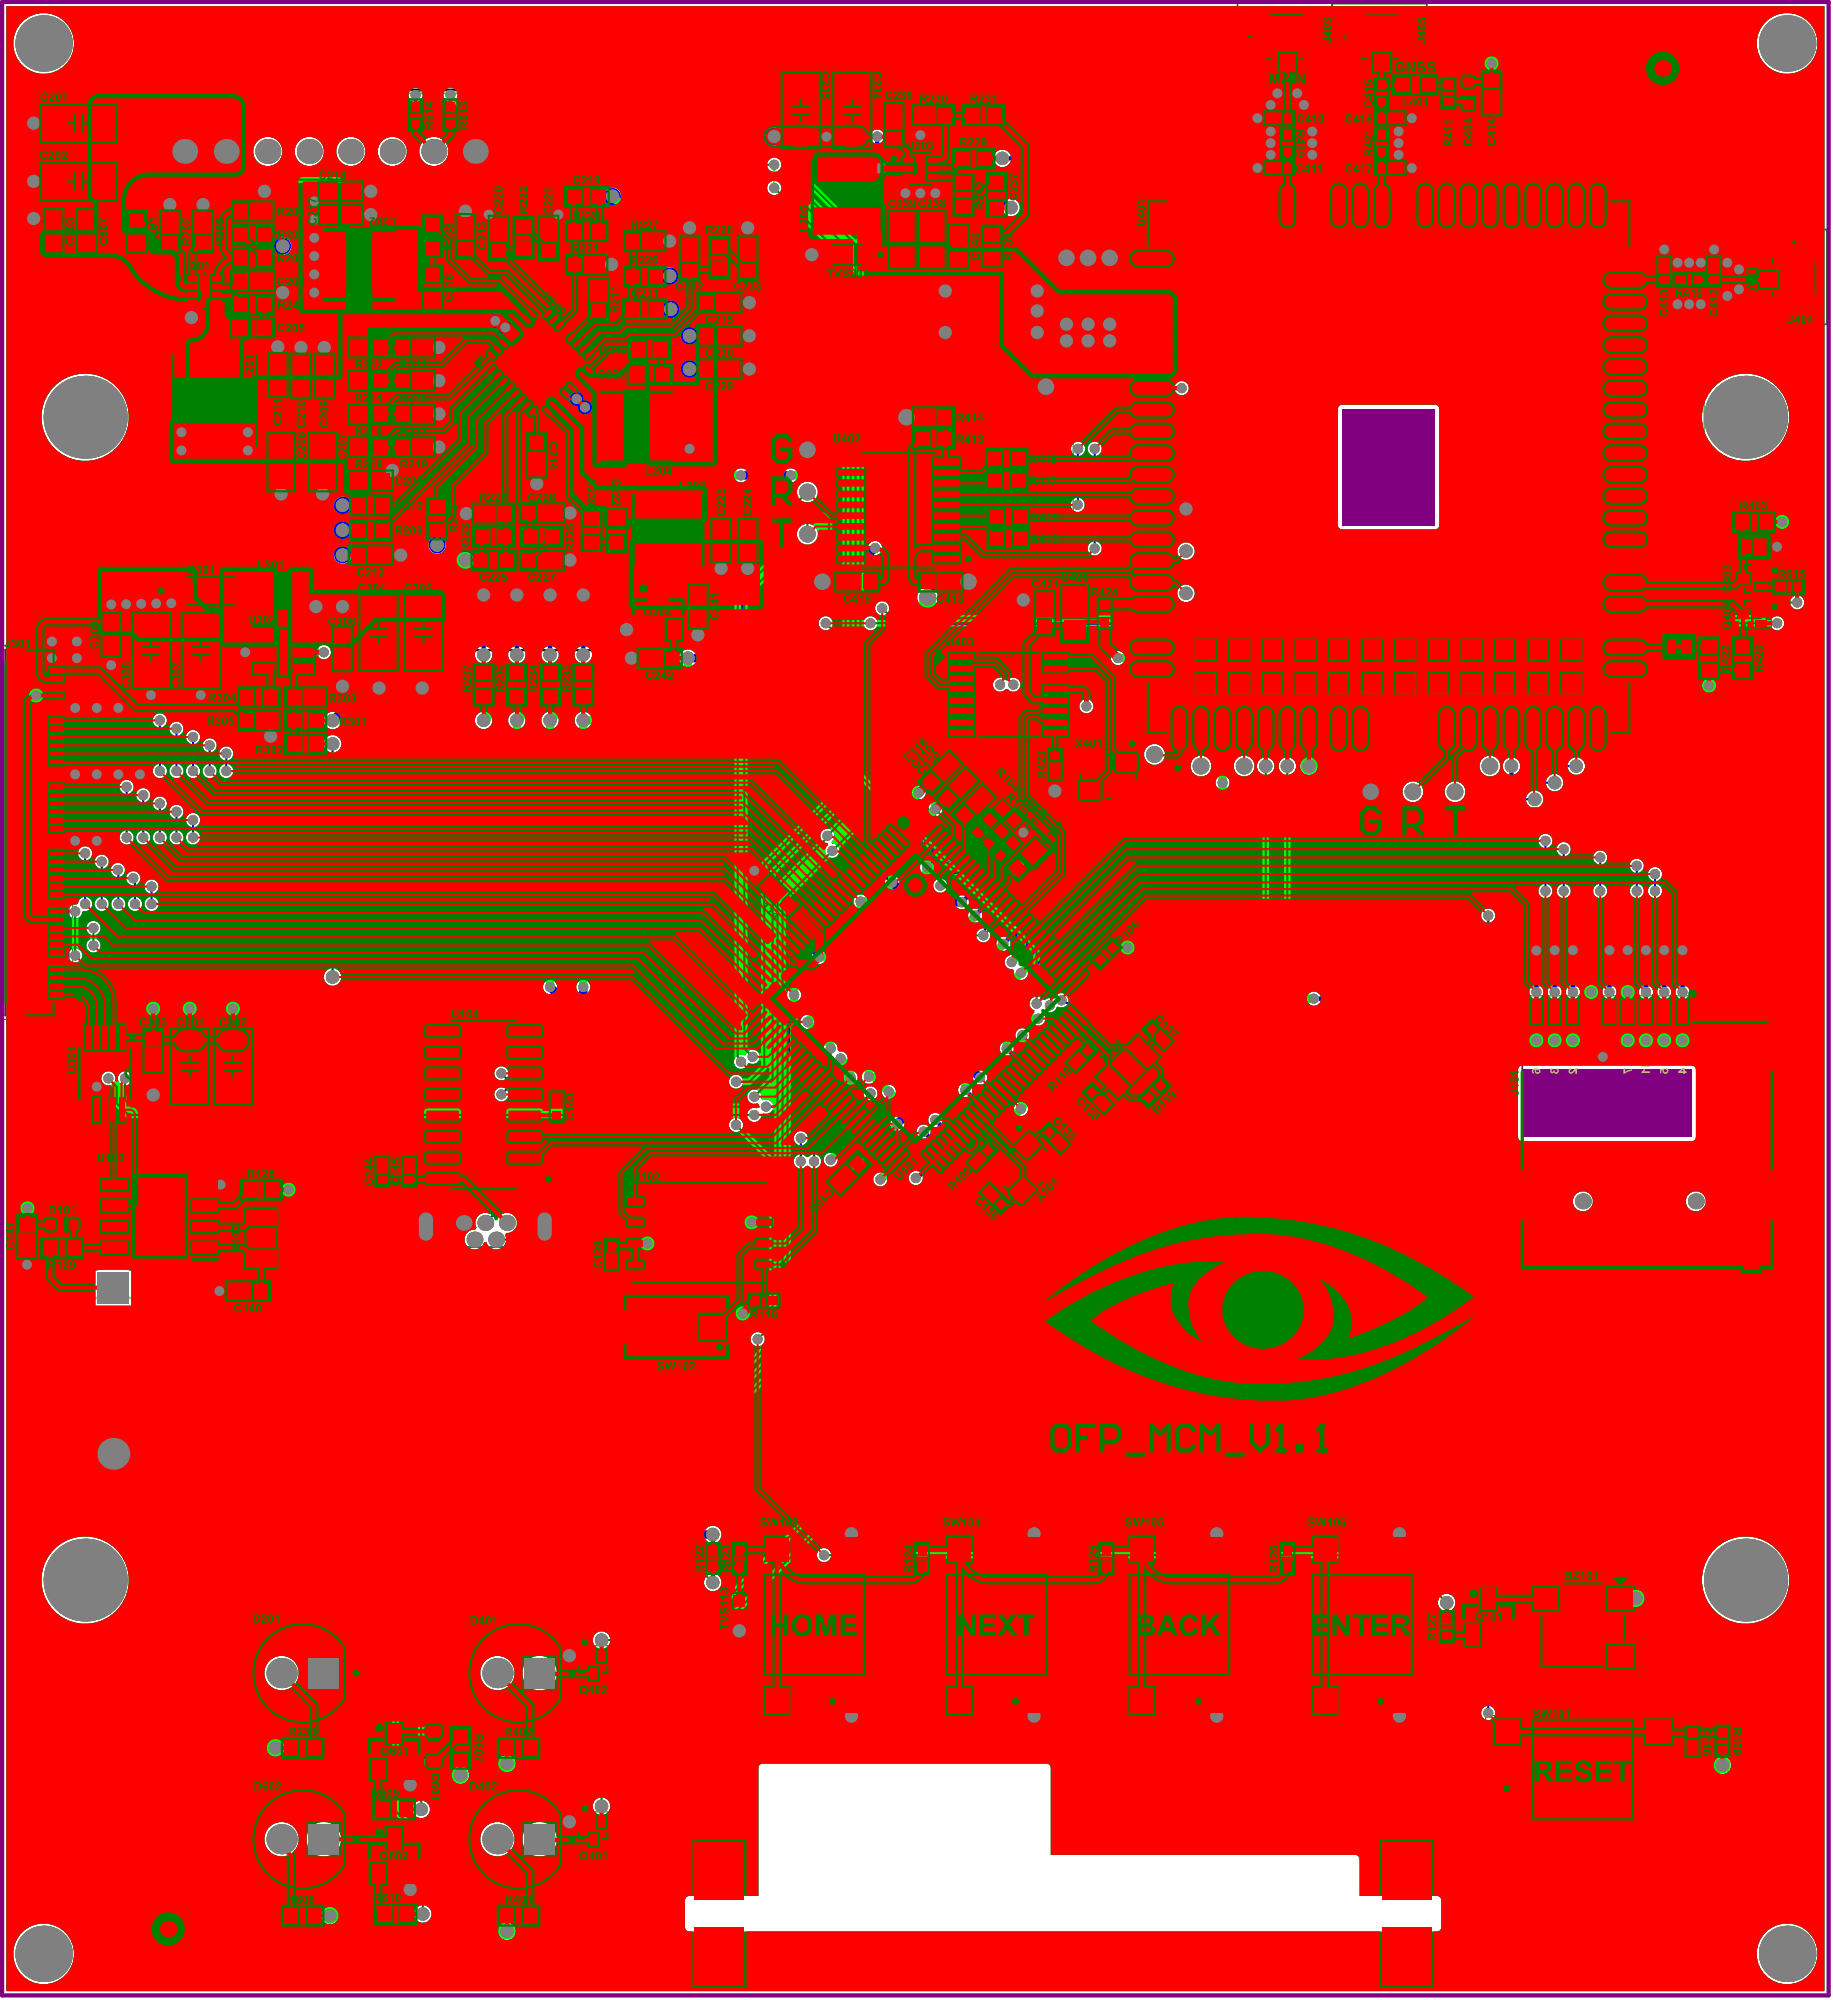
[picture p173: page 1]

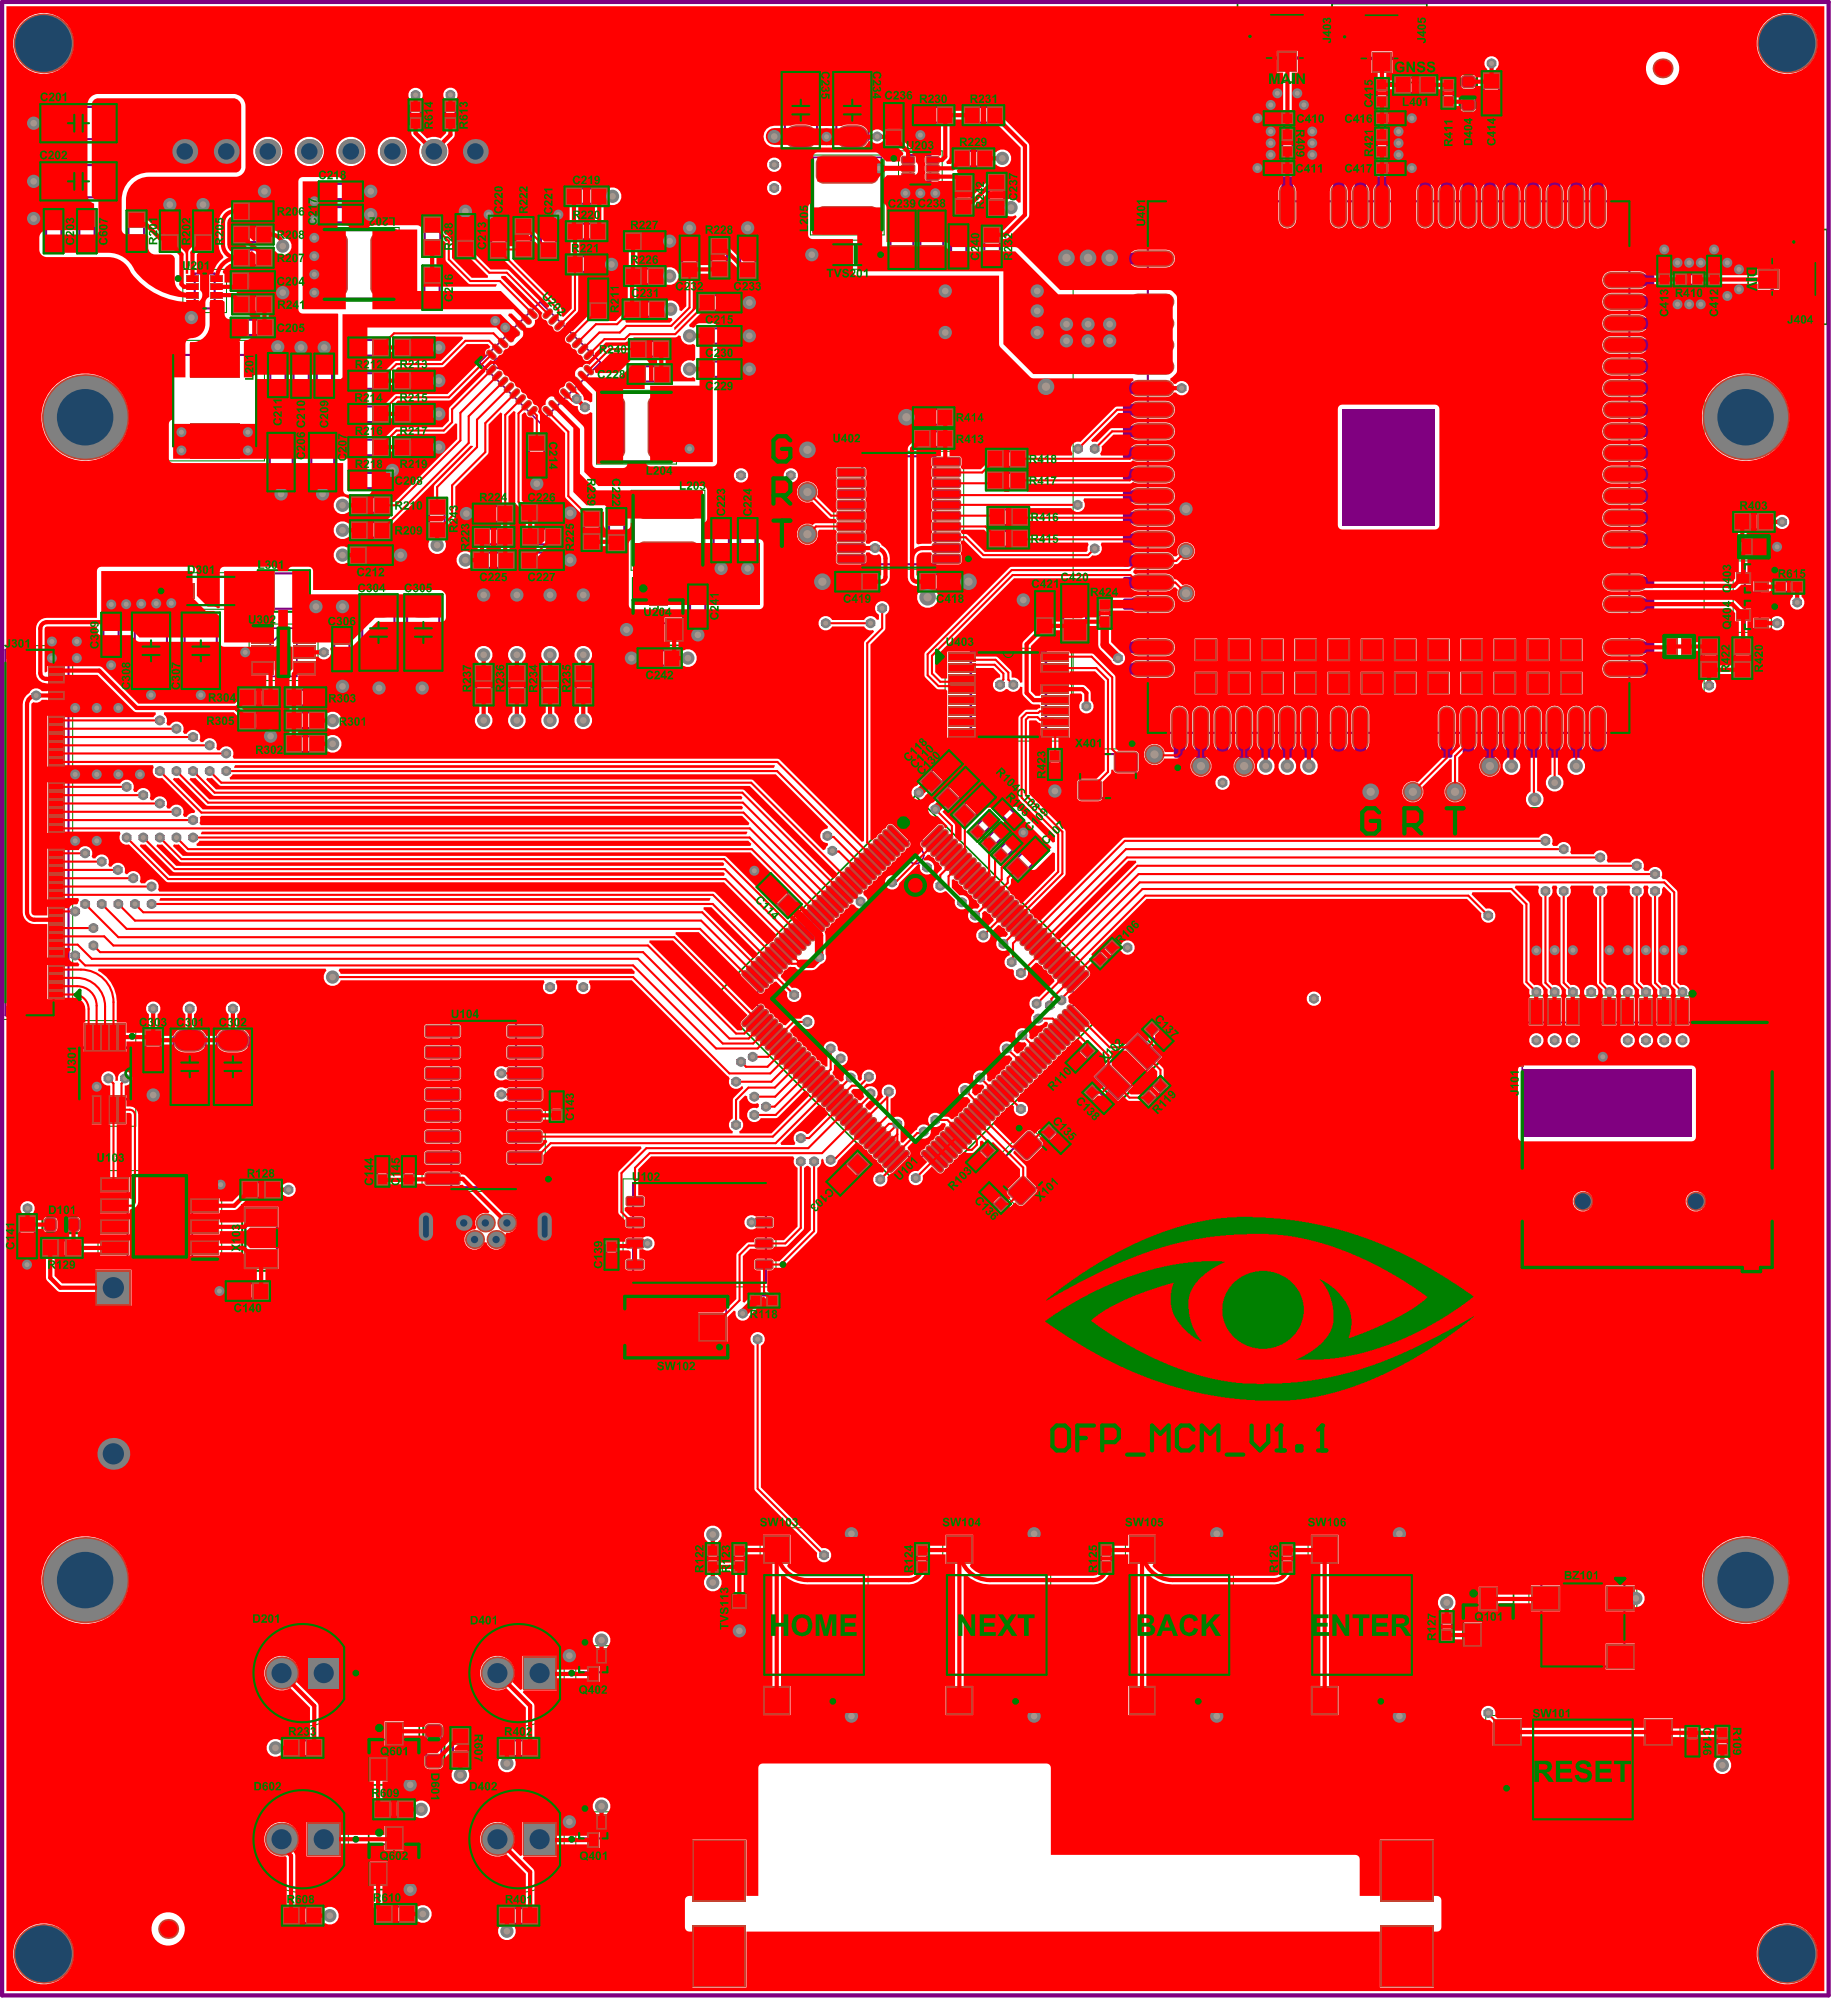
[picture p174: page 2]

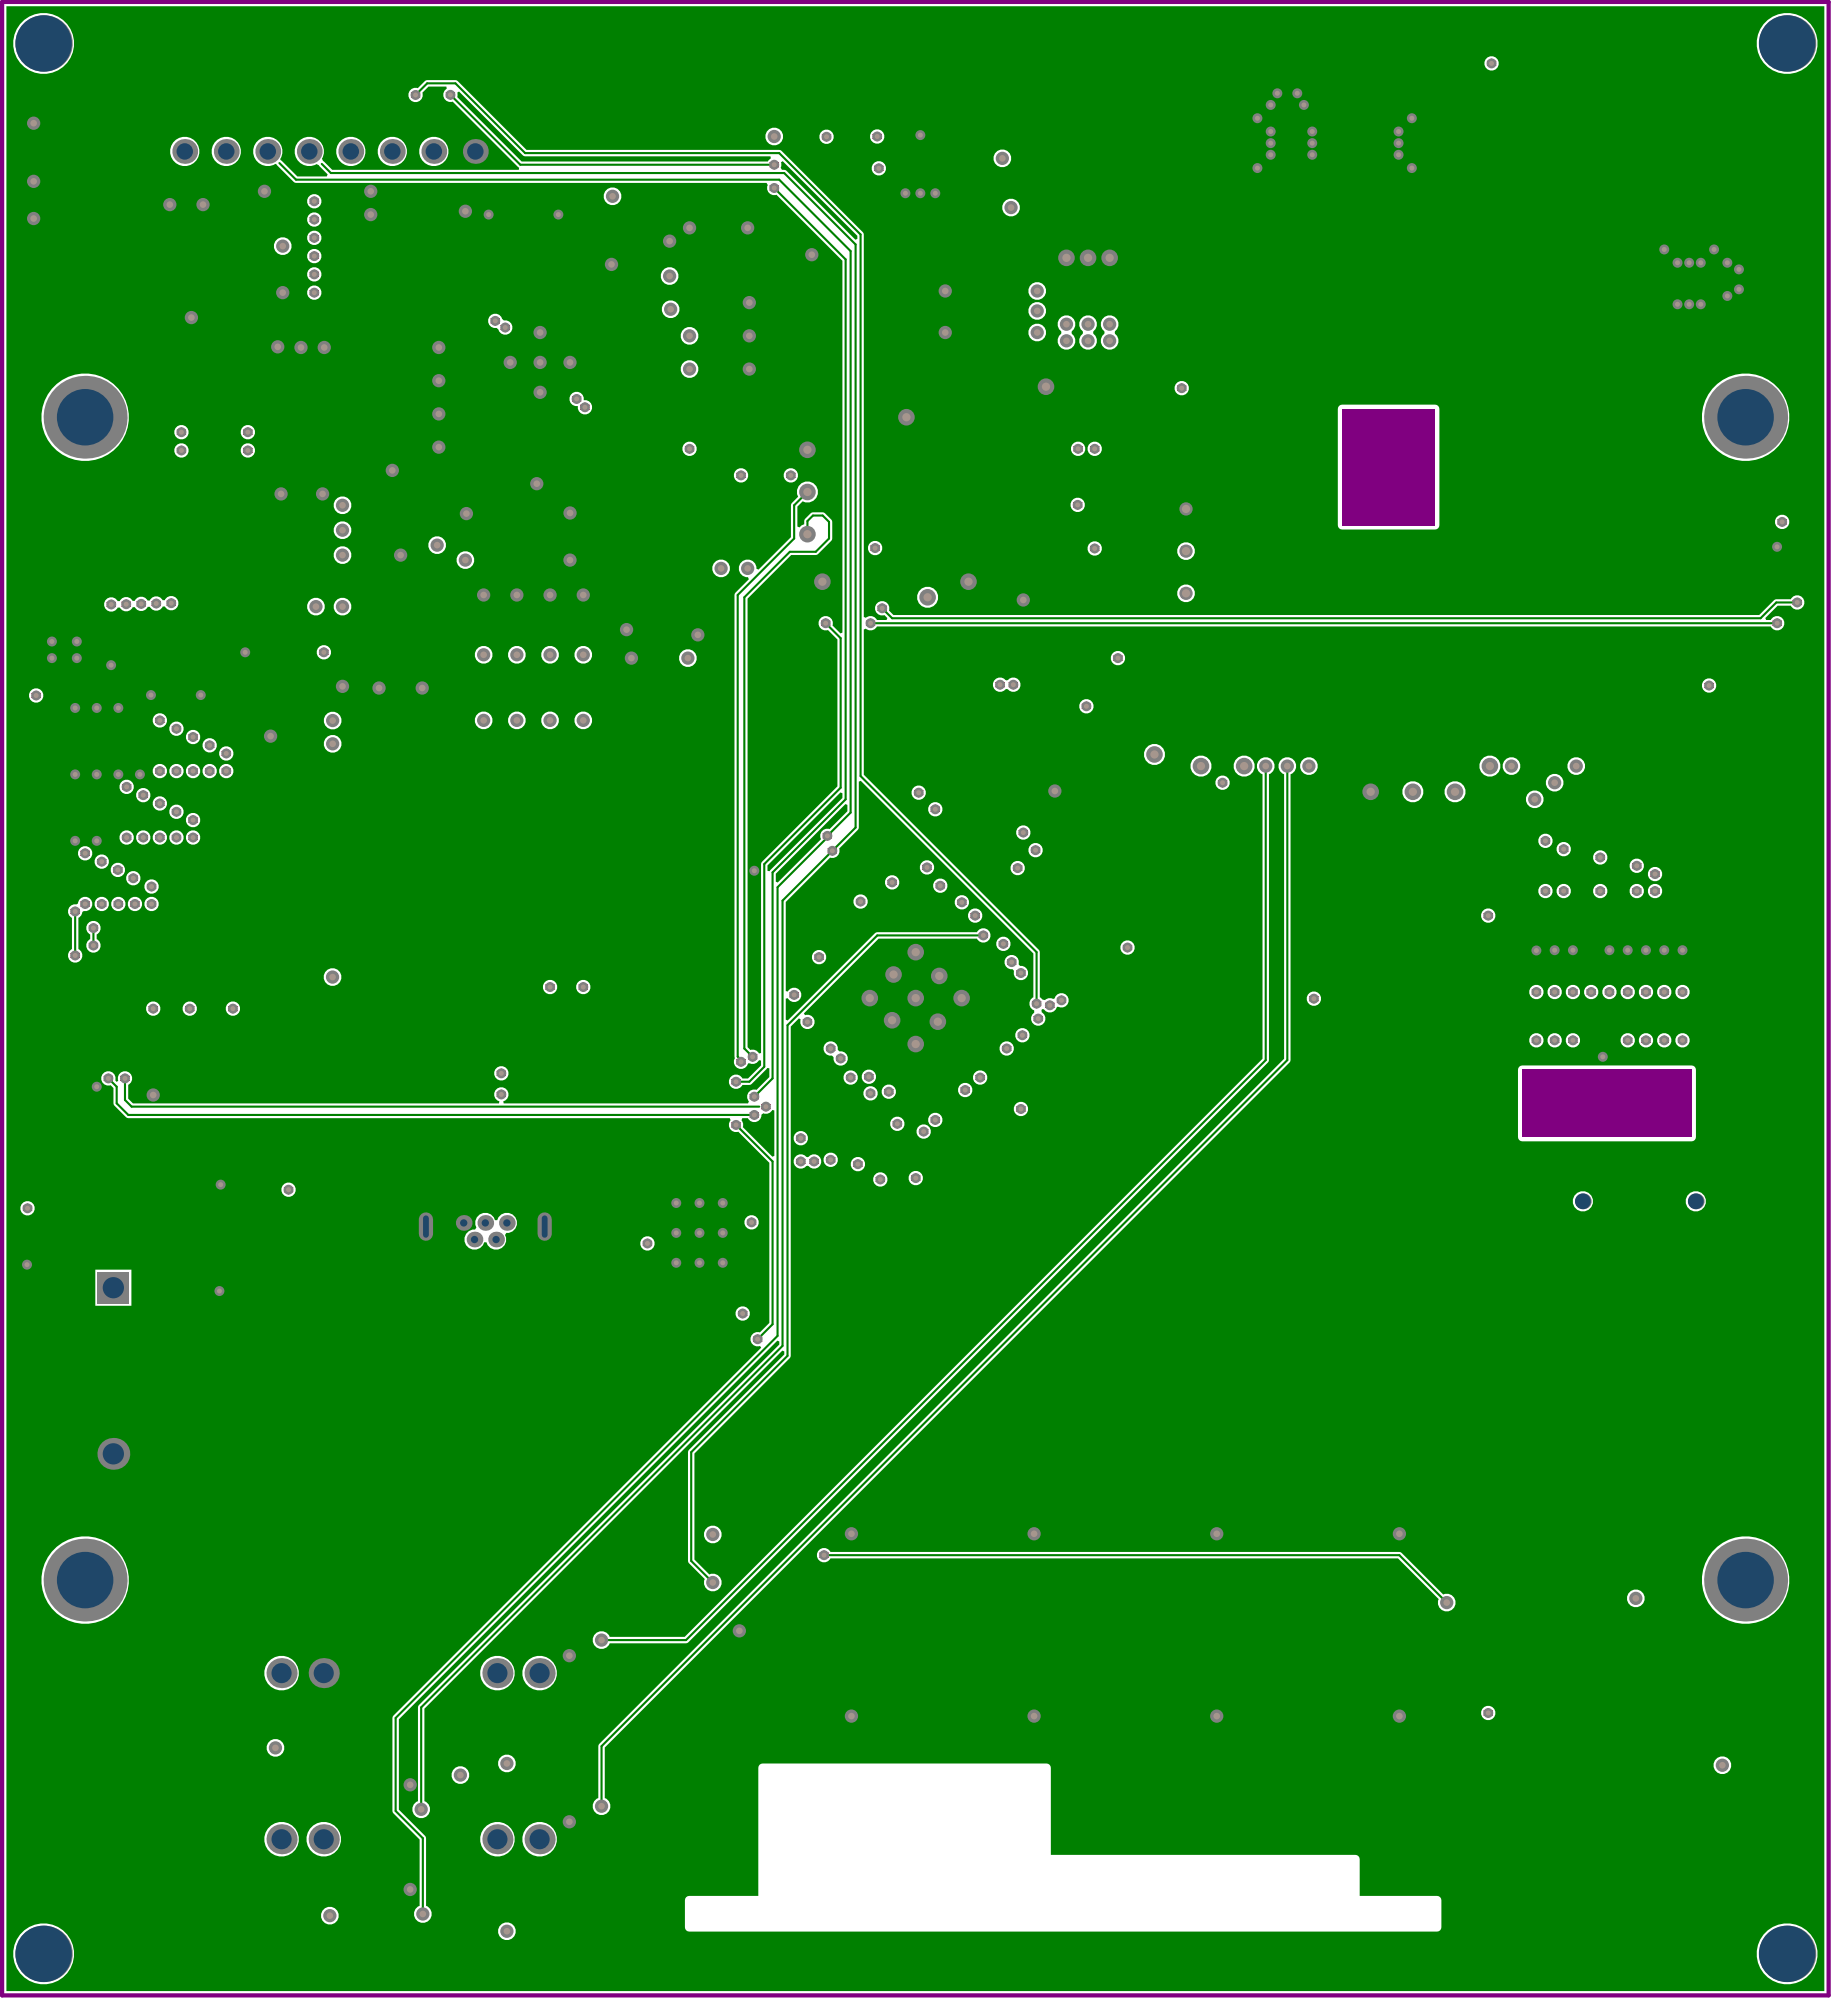
[picture p175: page 3]

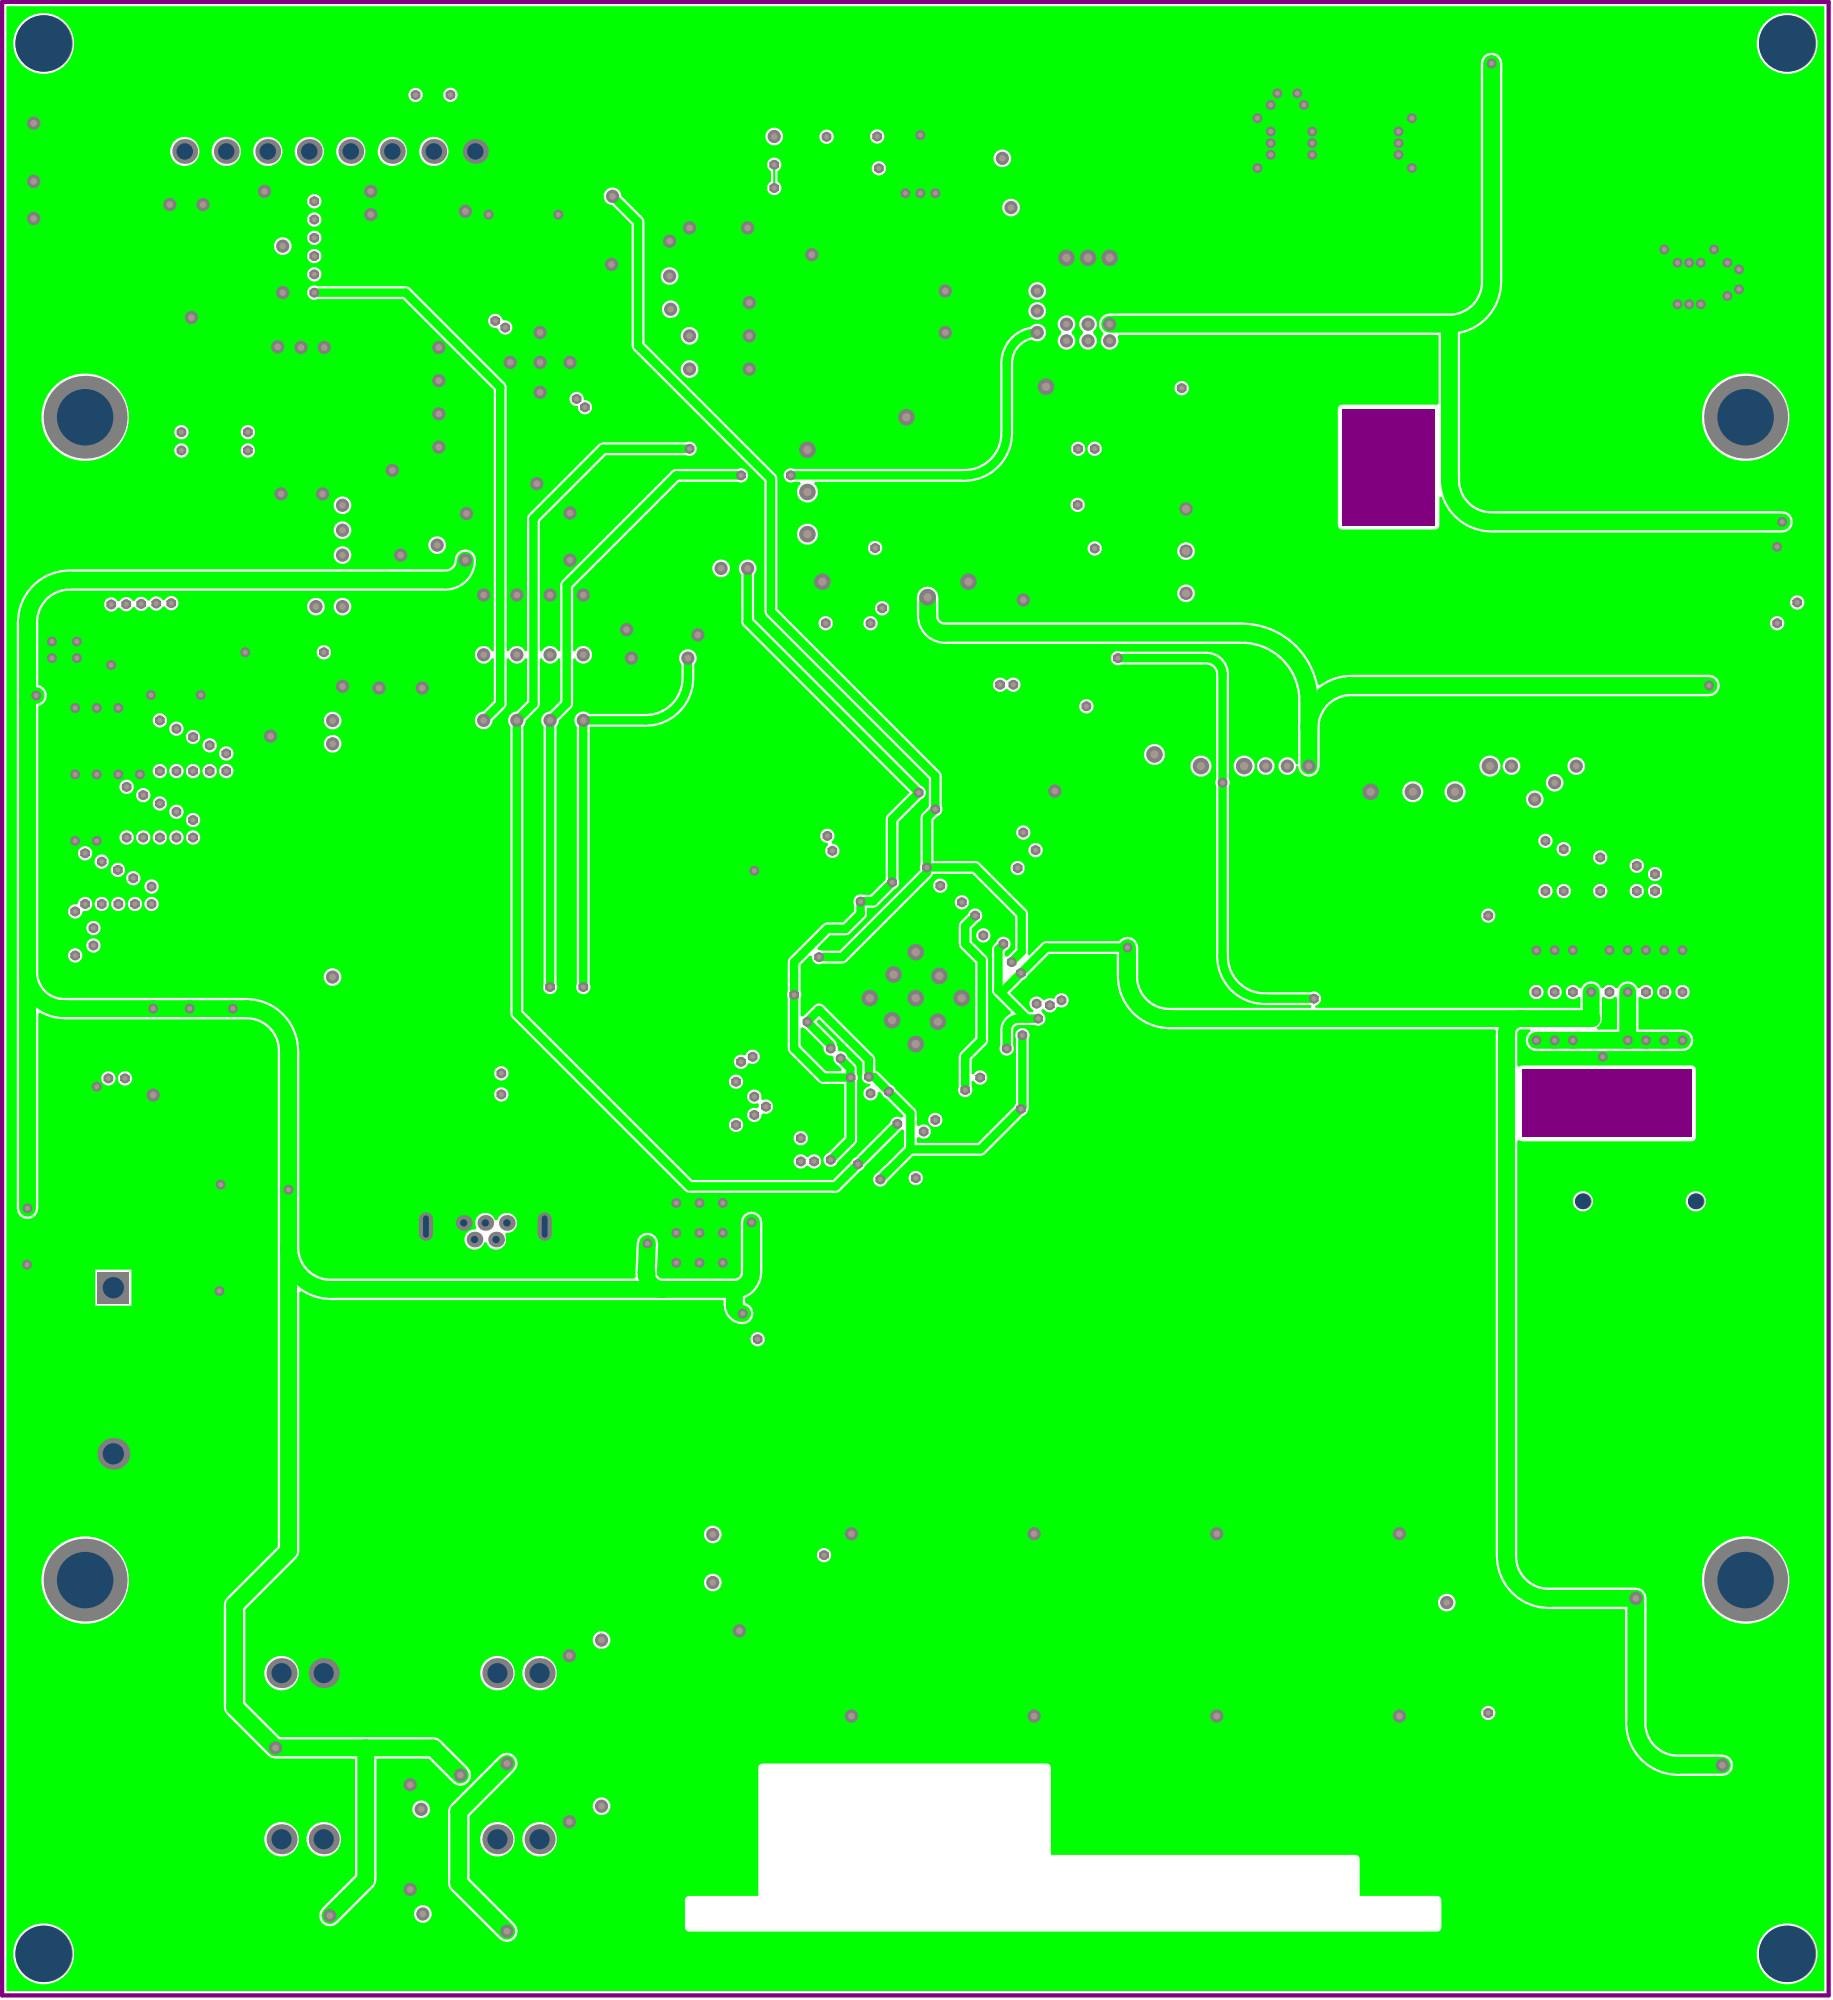
[picture p176: page 4]

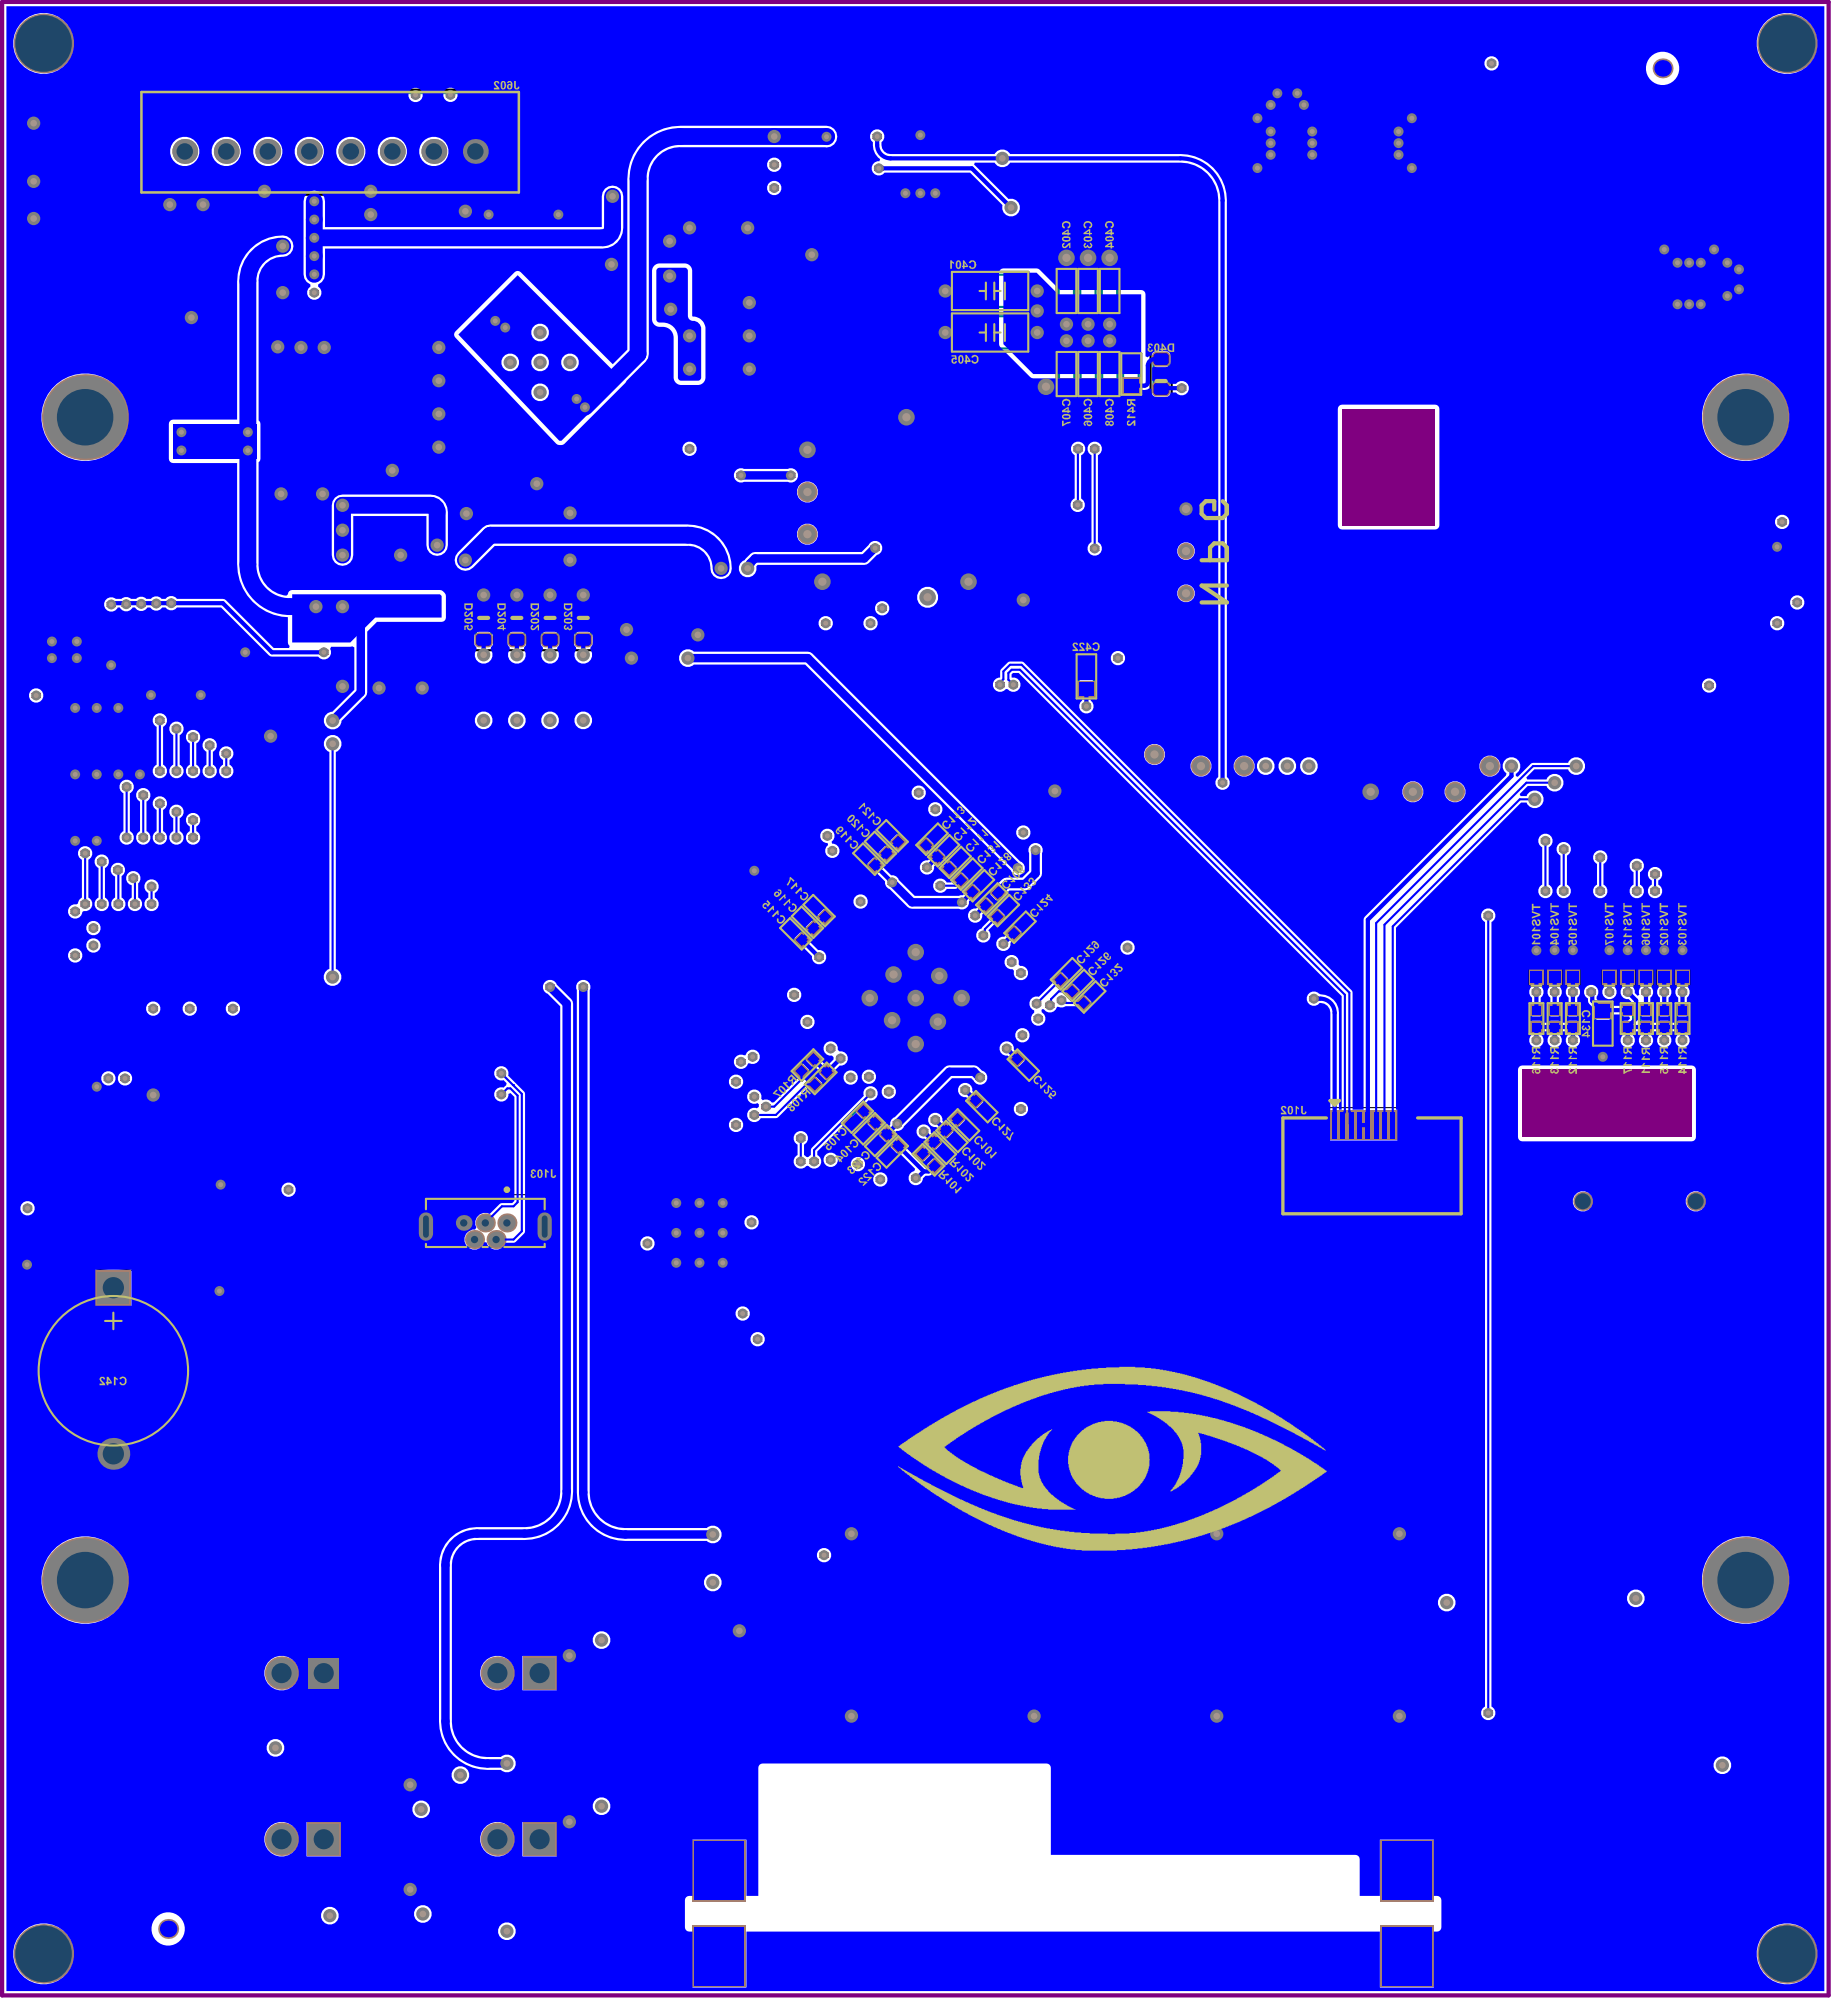
[picture p177: page 5]

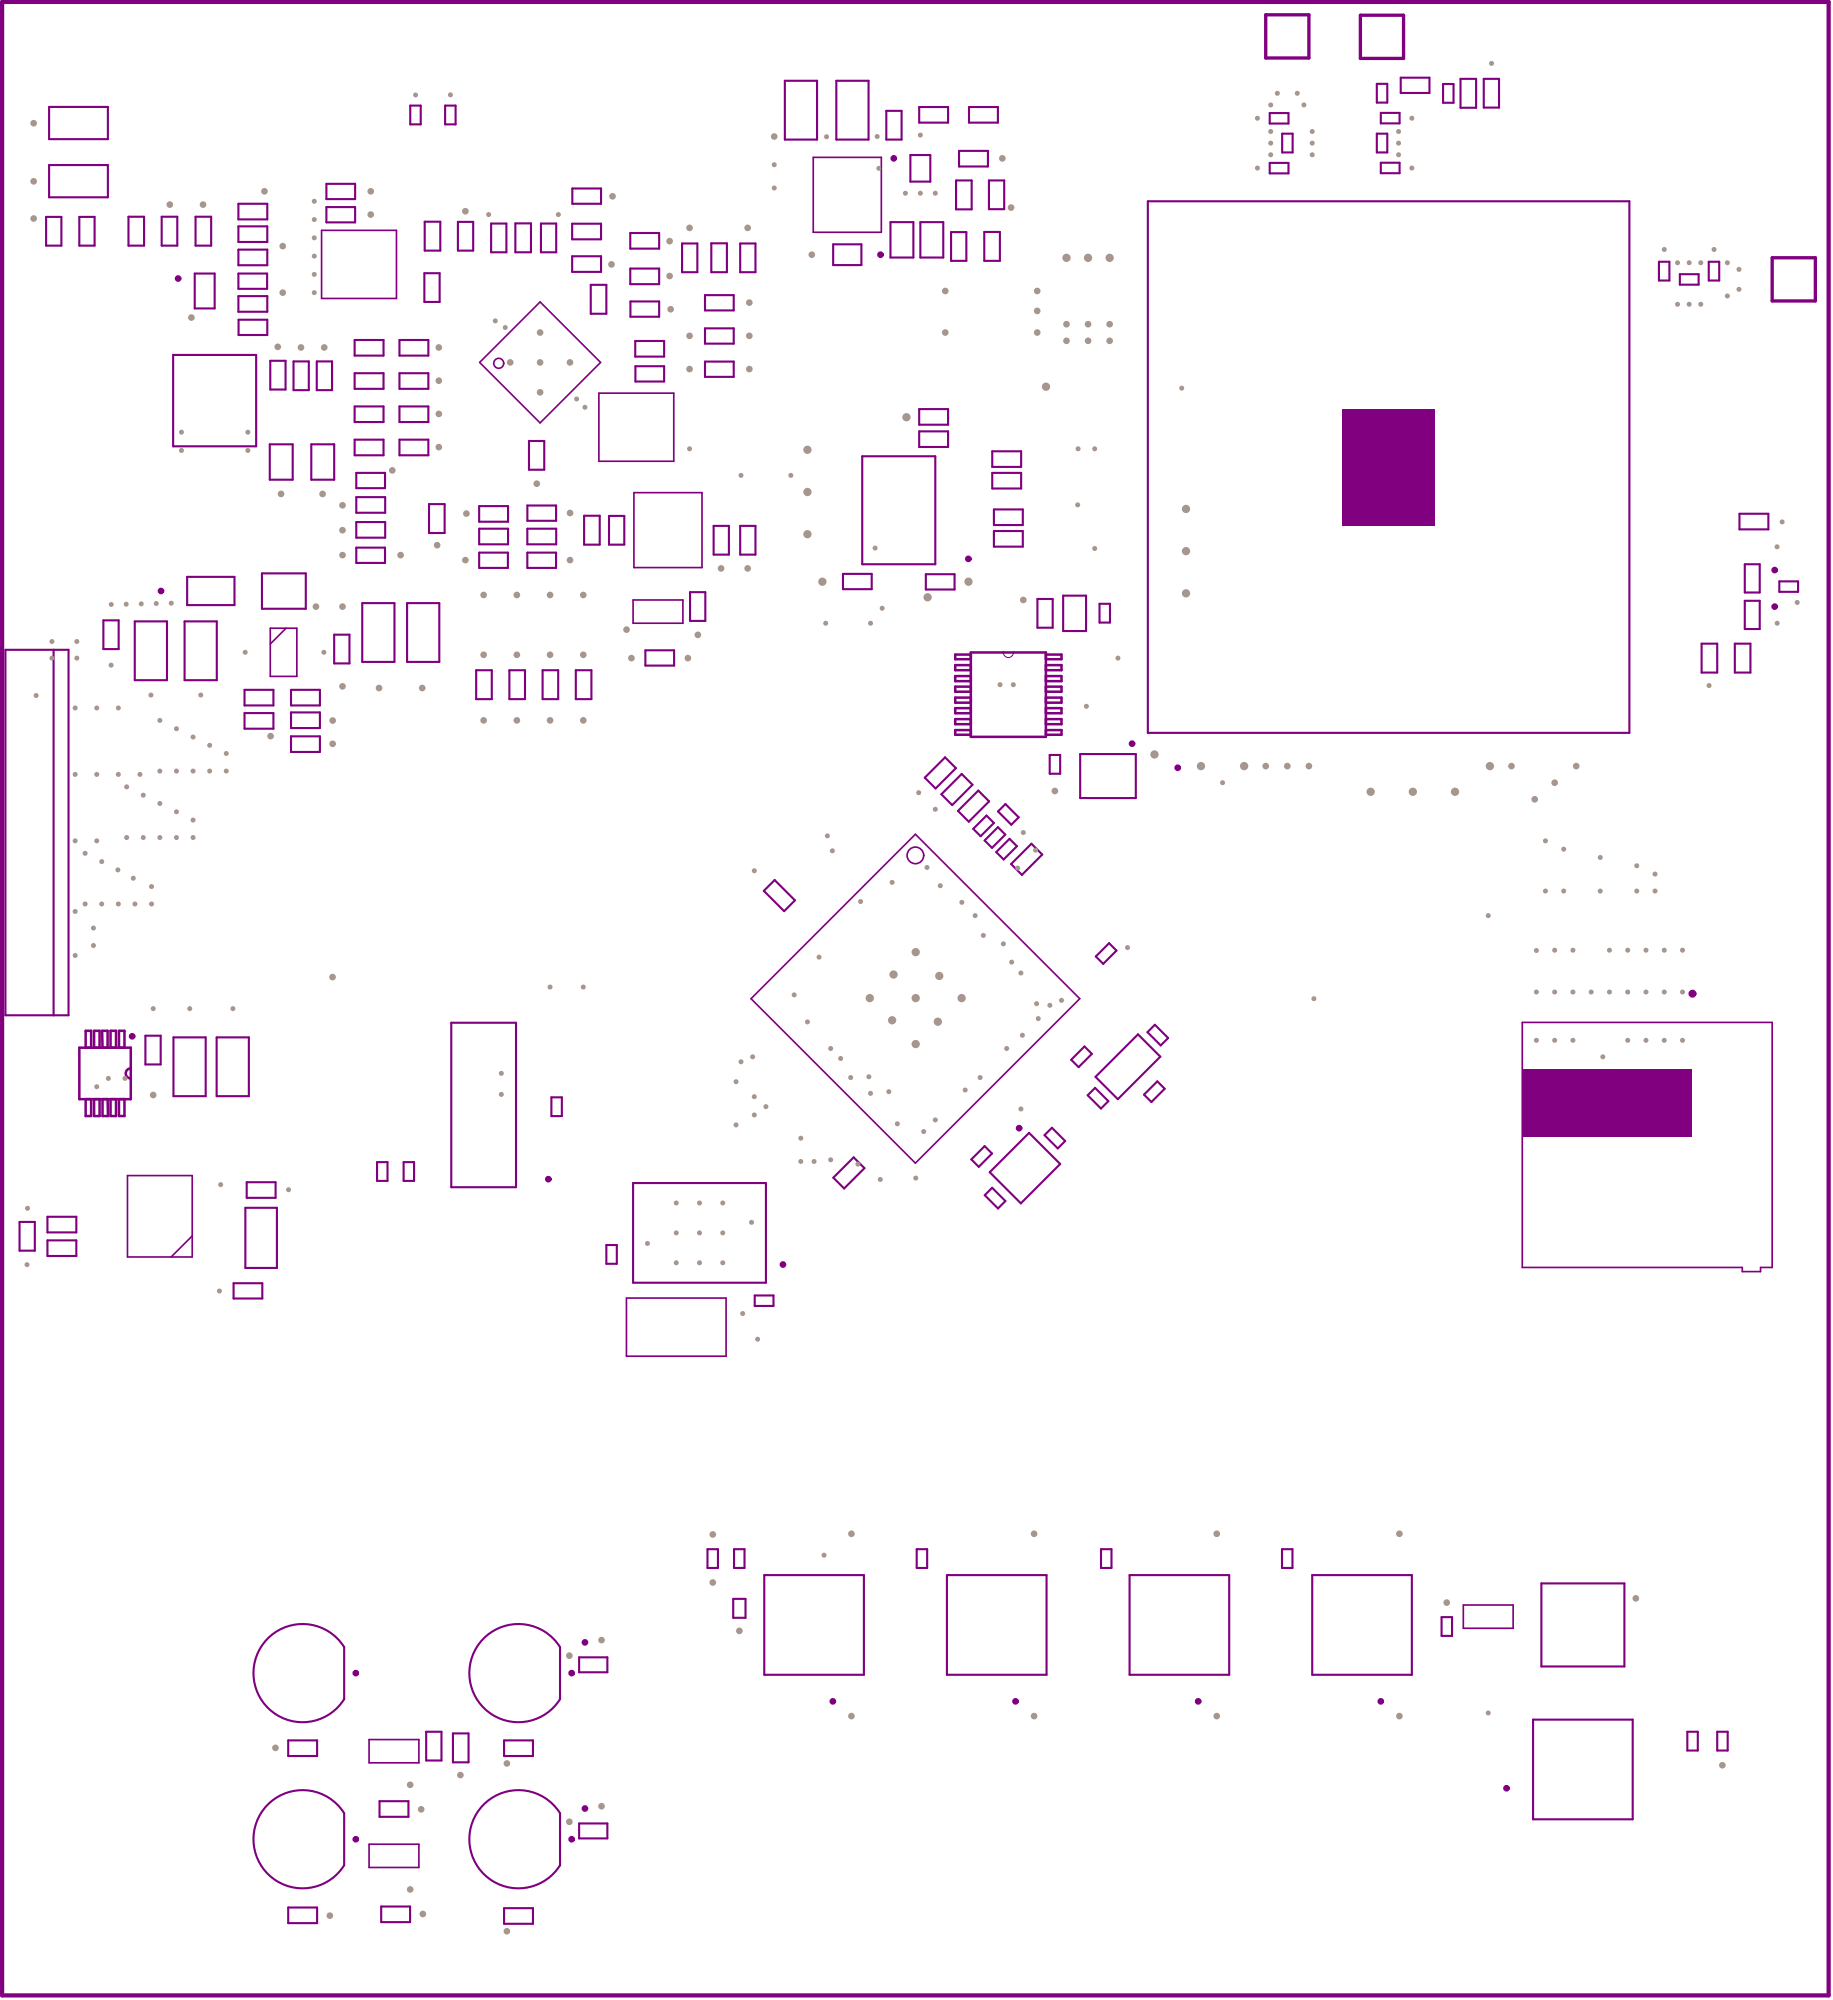
[picture p178: page 6]

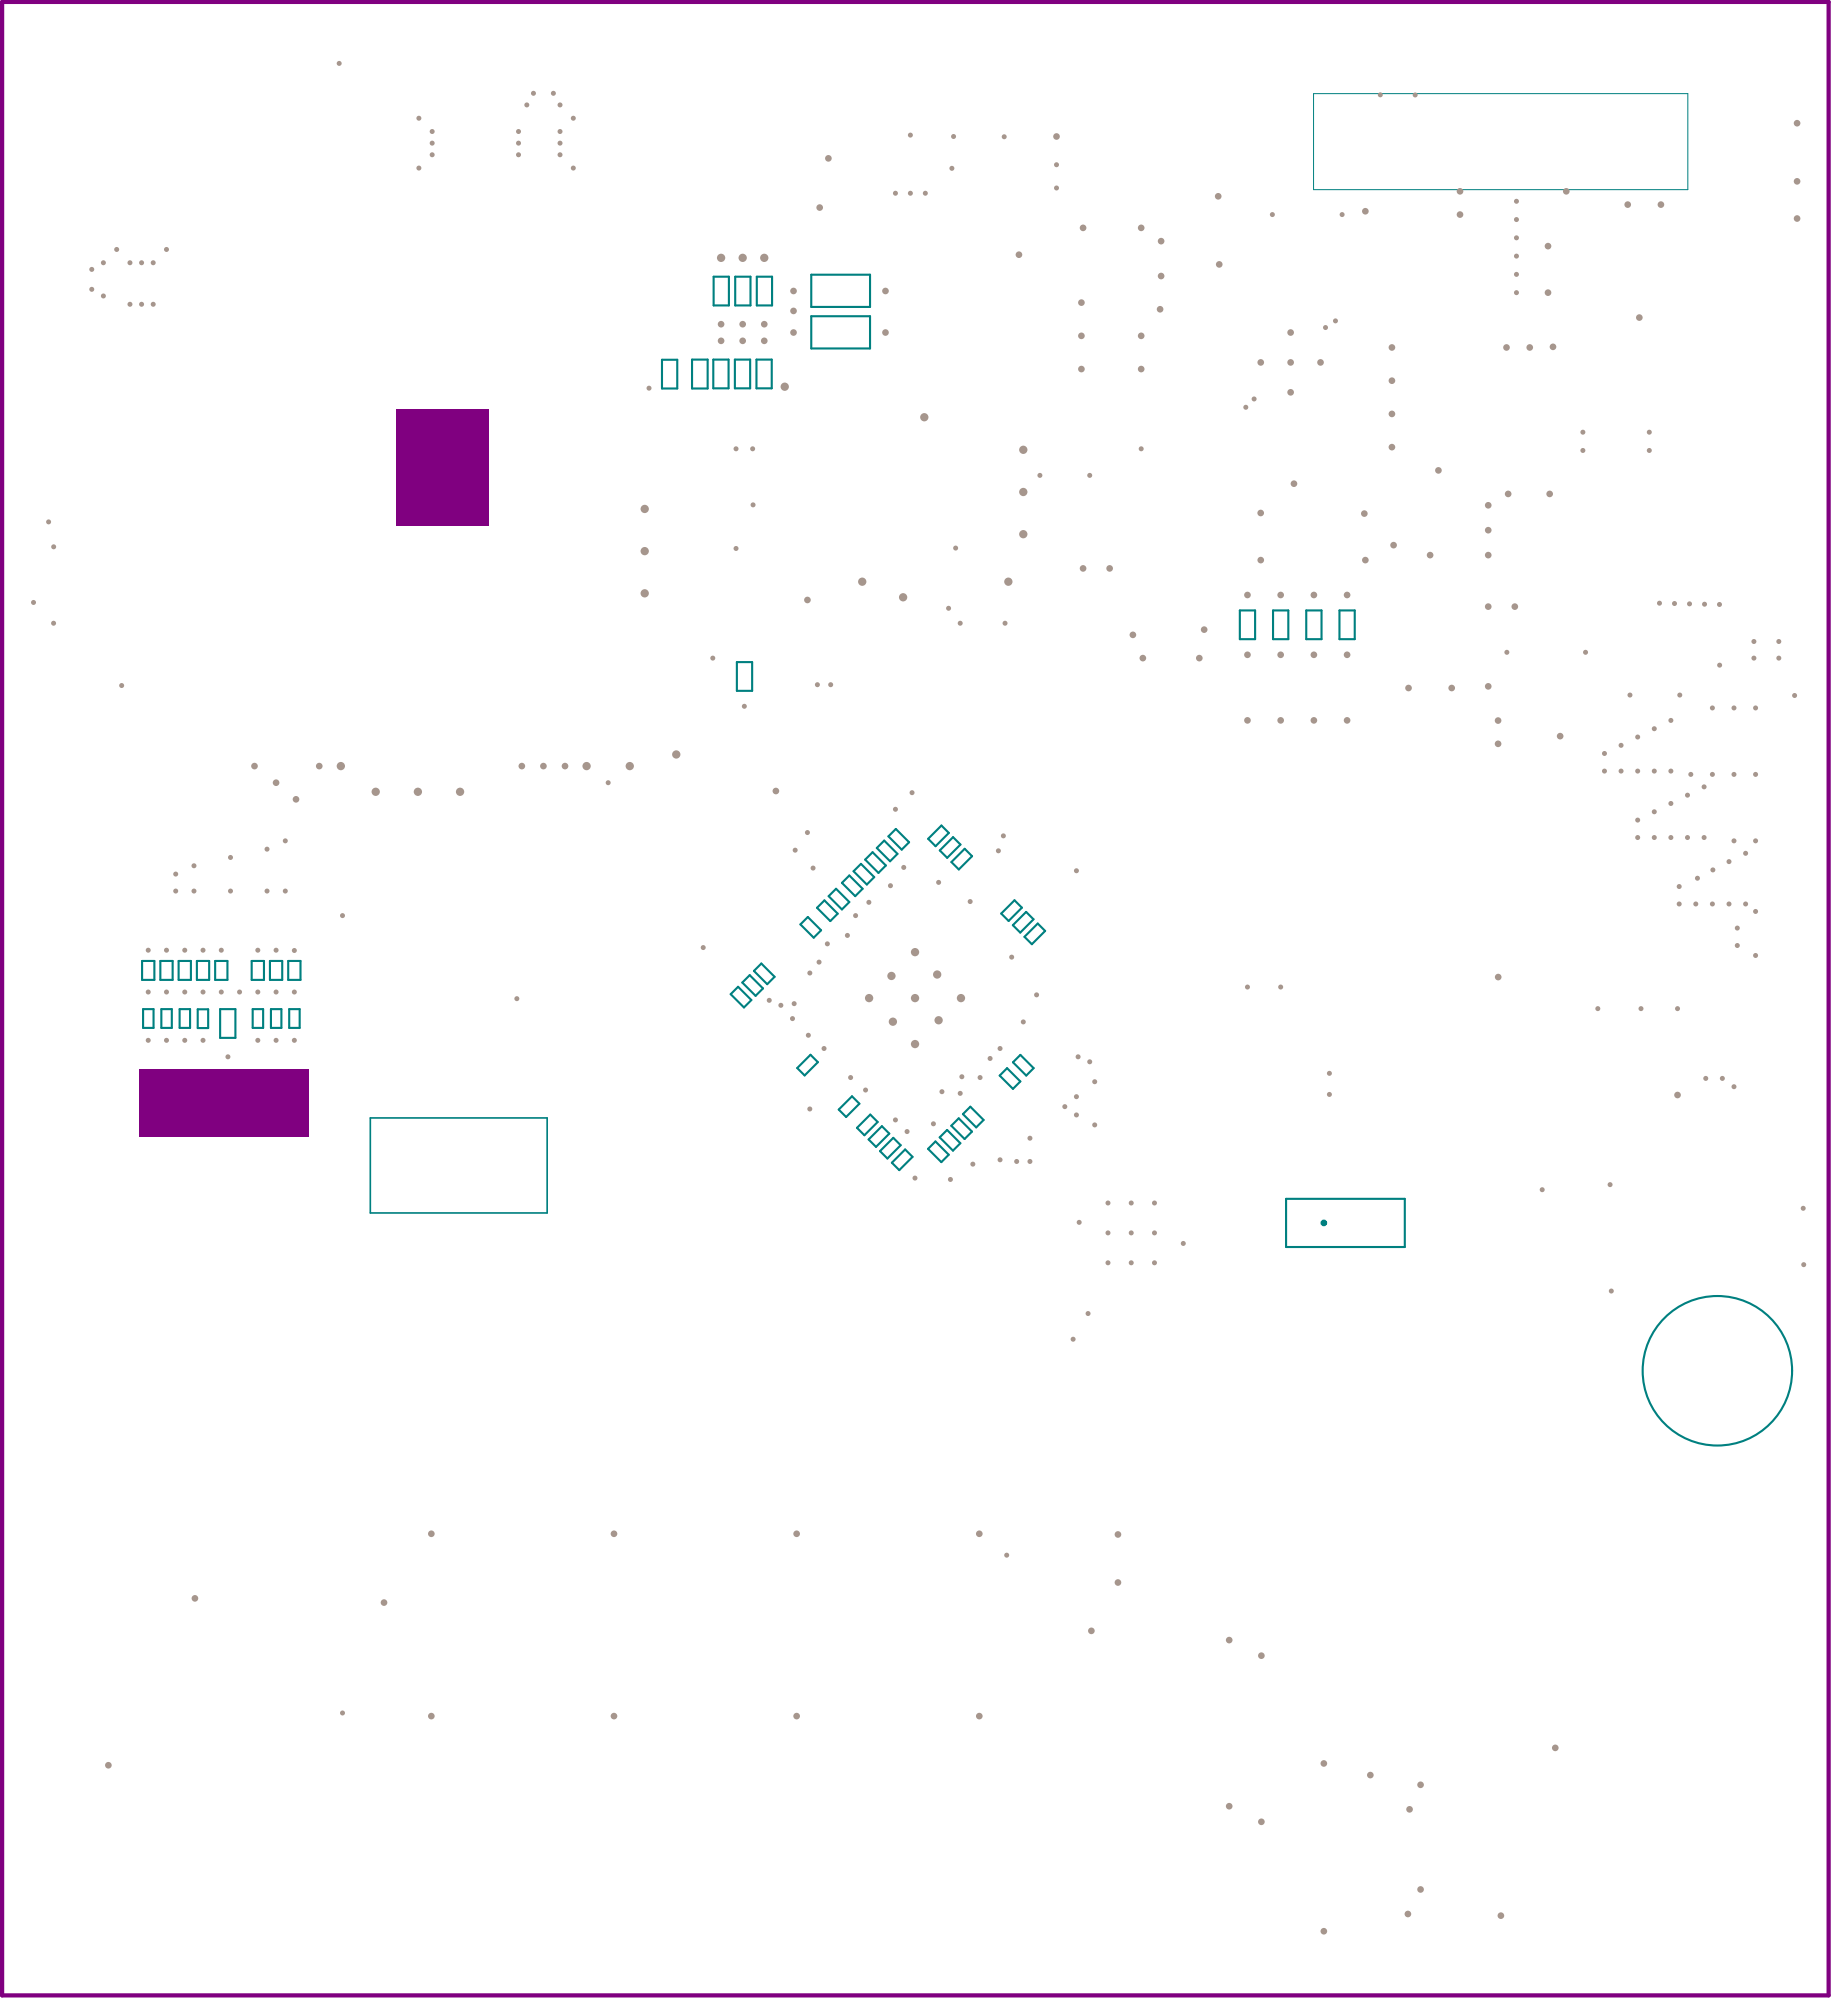
[picture p179: page 7]

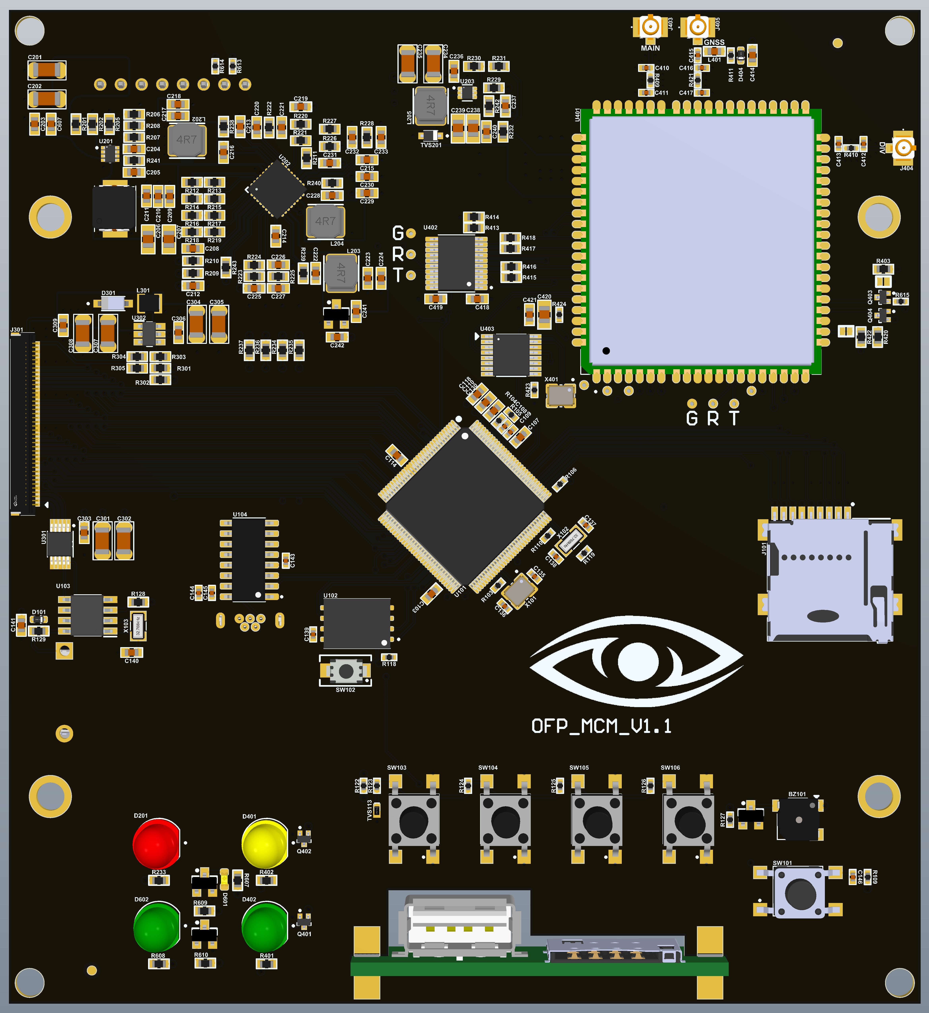
[picture p180: page 8]

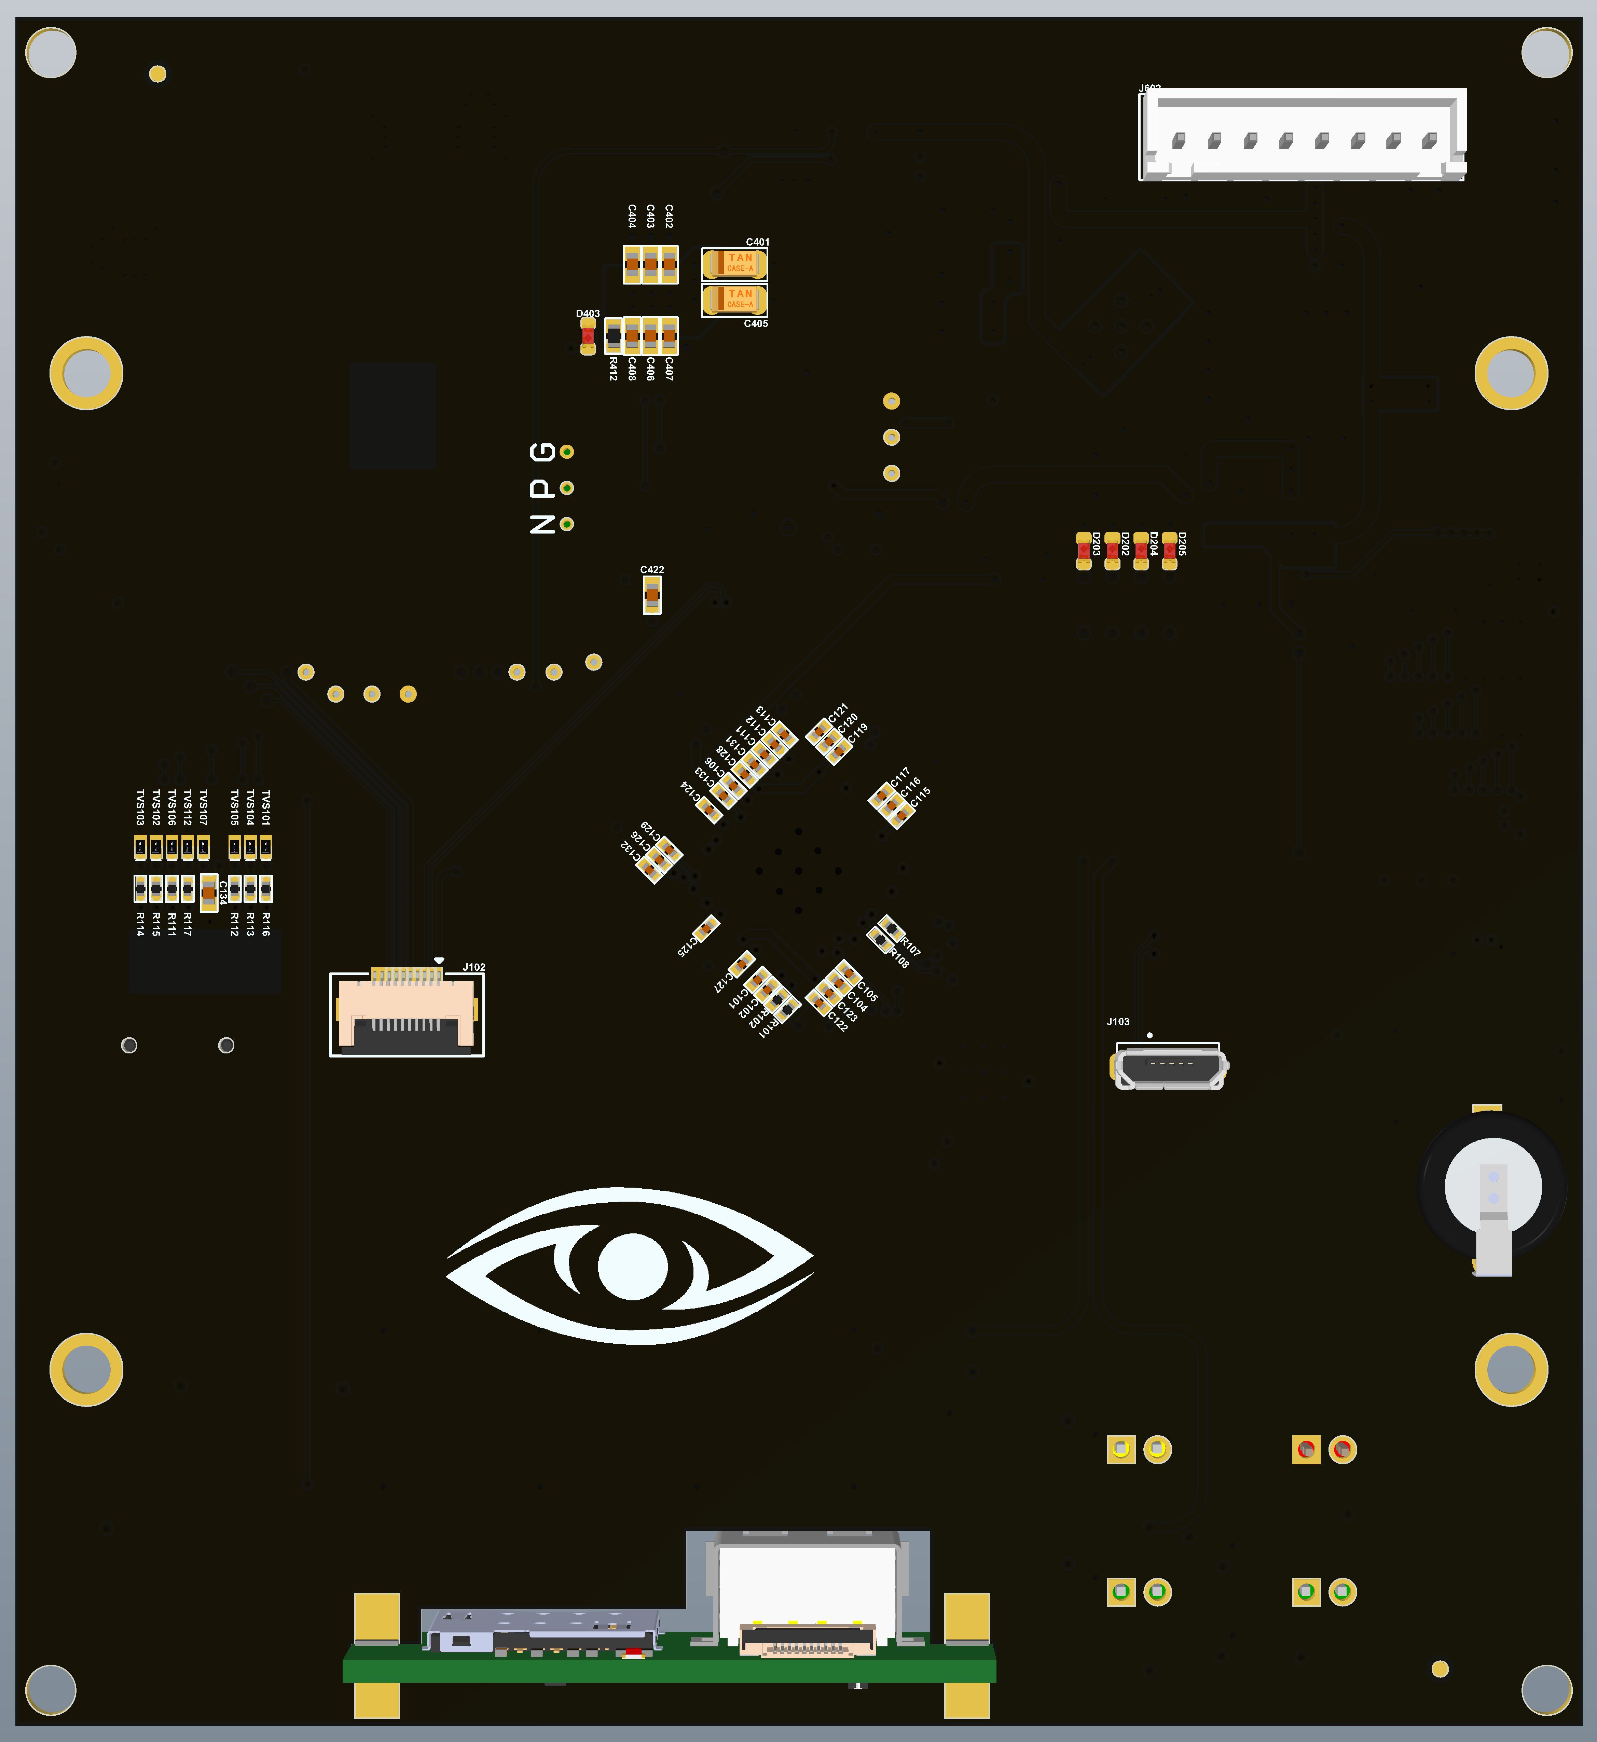
[picture p181: page 9]
