eSpark-Backup/nabilfesal-smartmeter-hw/docs/Client-Files/Product Files/MSM-Documentation-24122024/PCB/PCB_OutJob_SCM_V1.1.PDF

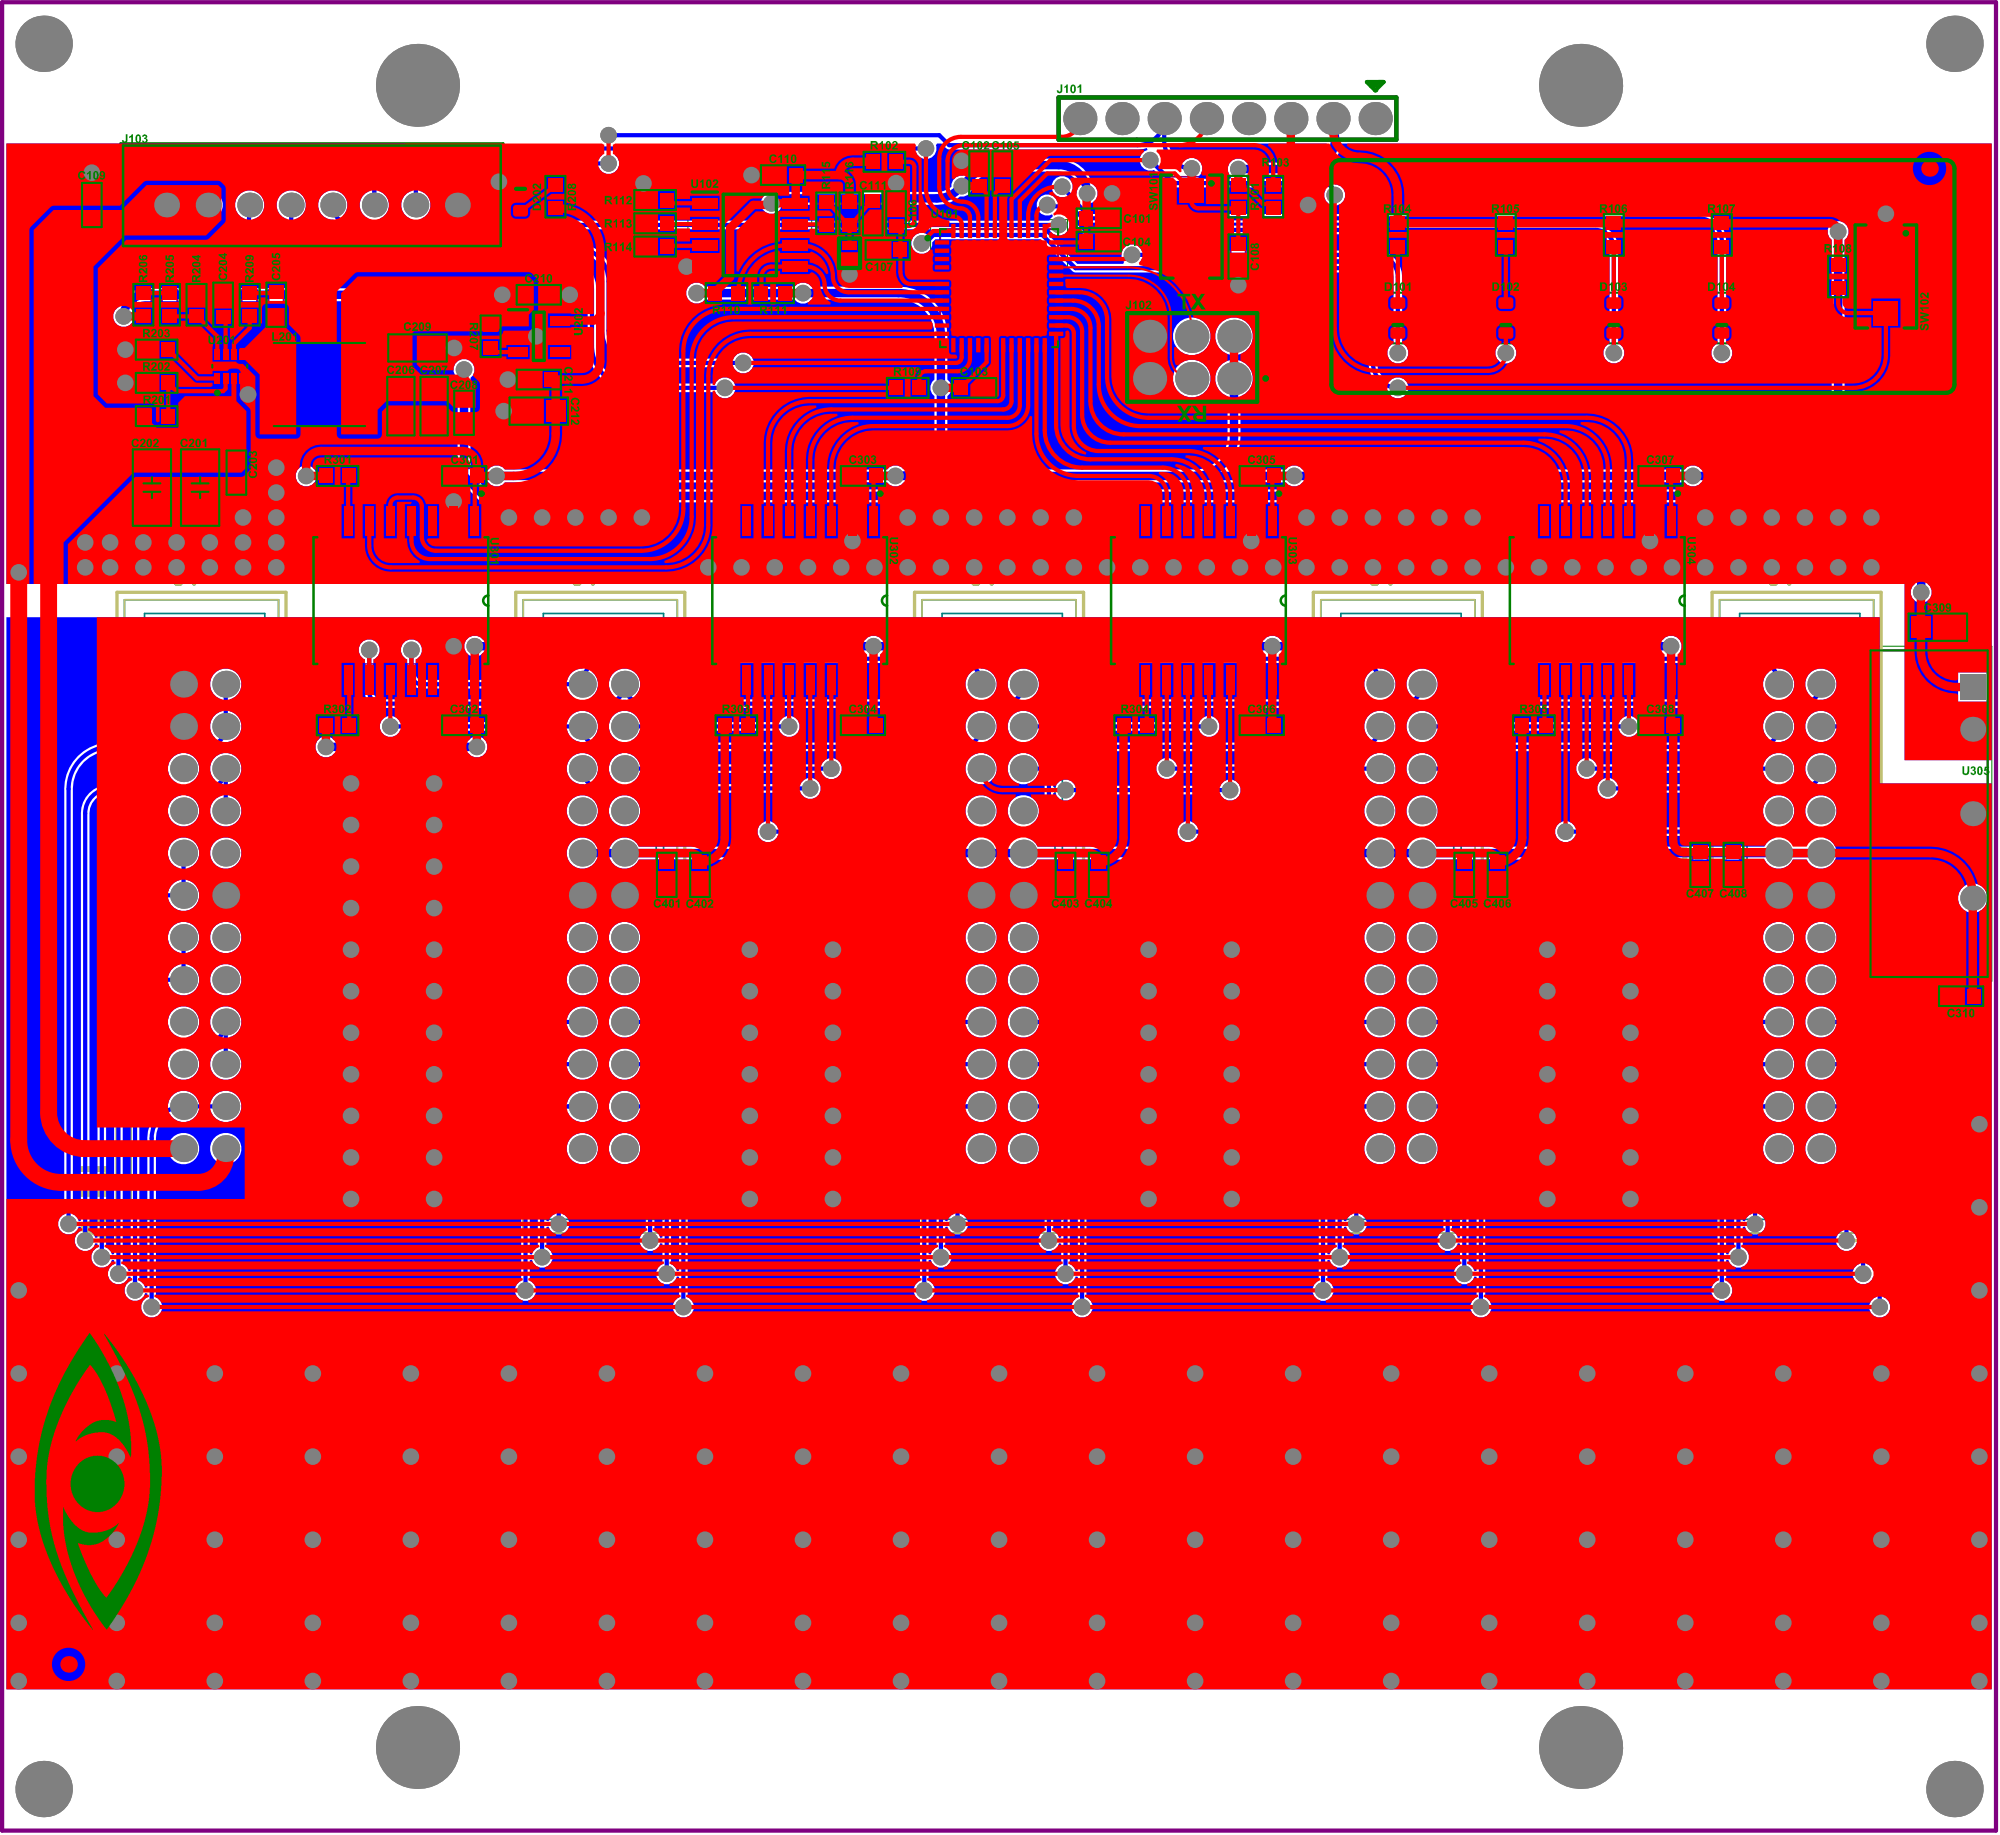
[picture p182: page 1]

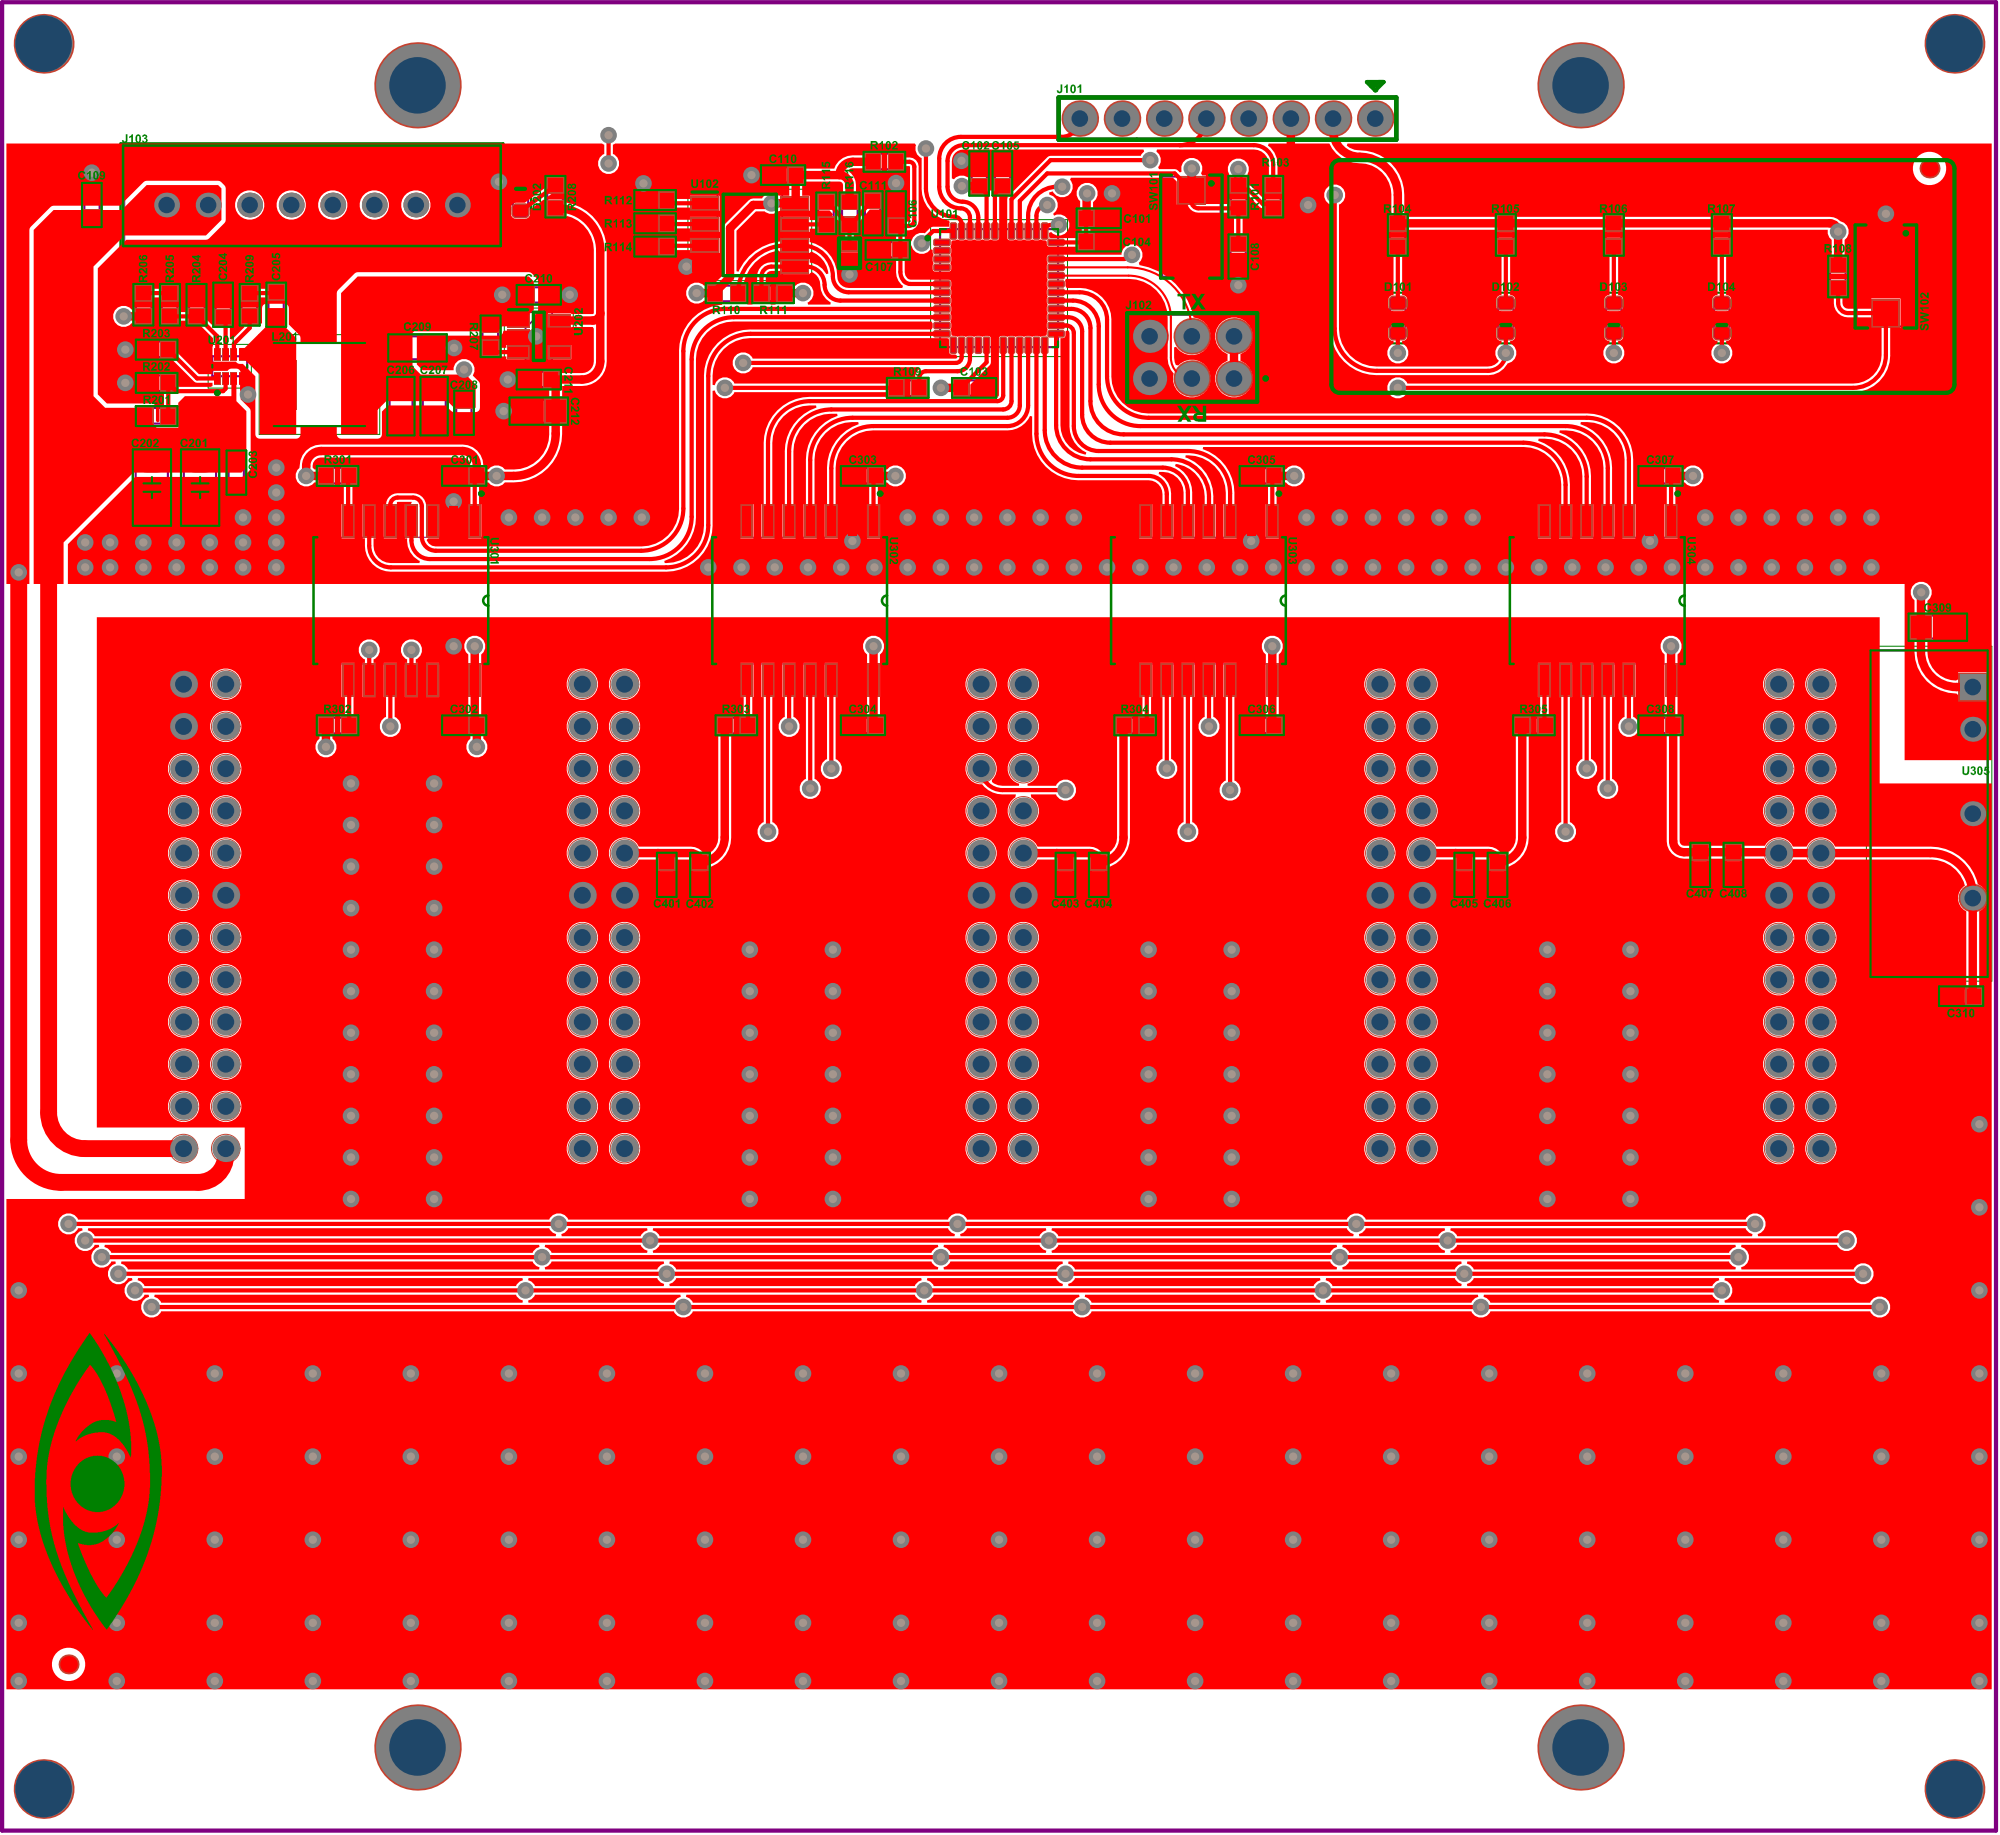
[picture p183: page 2]

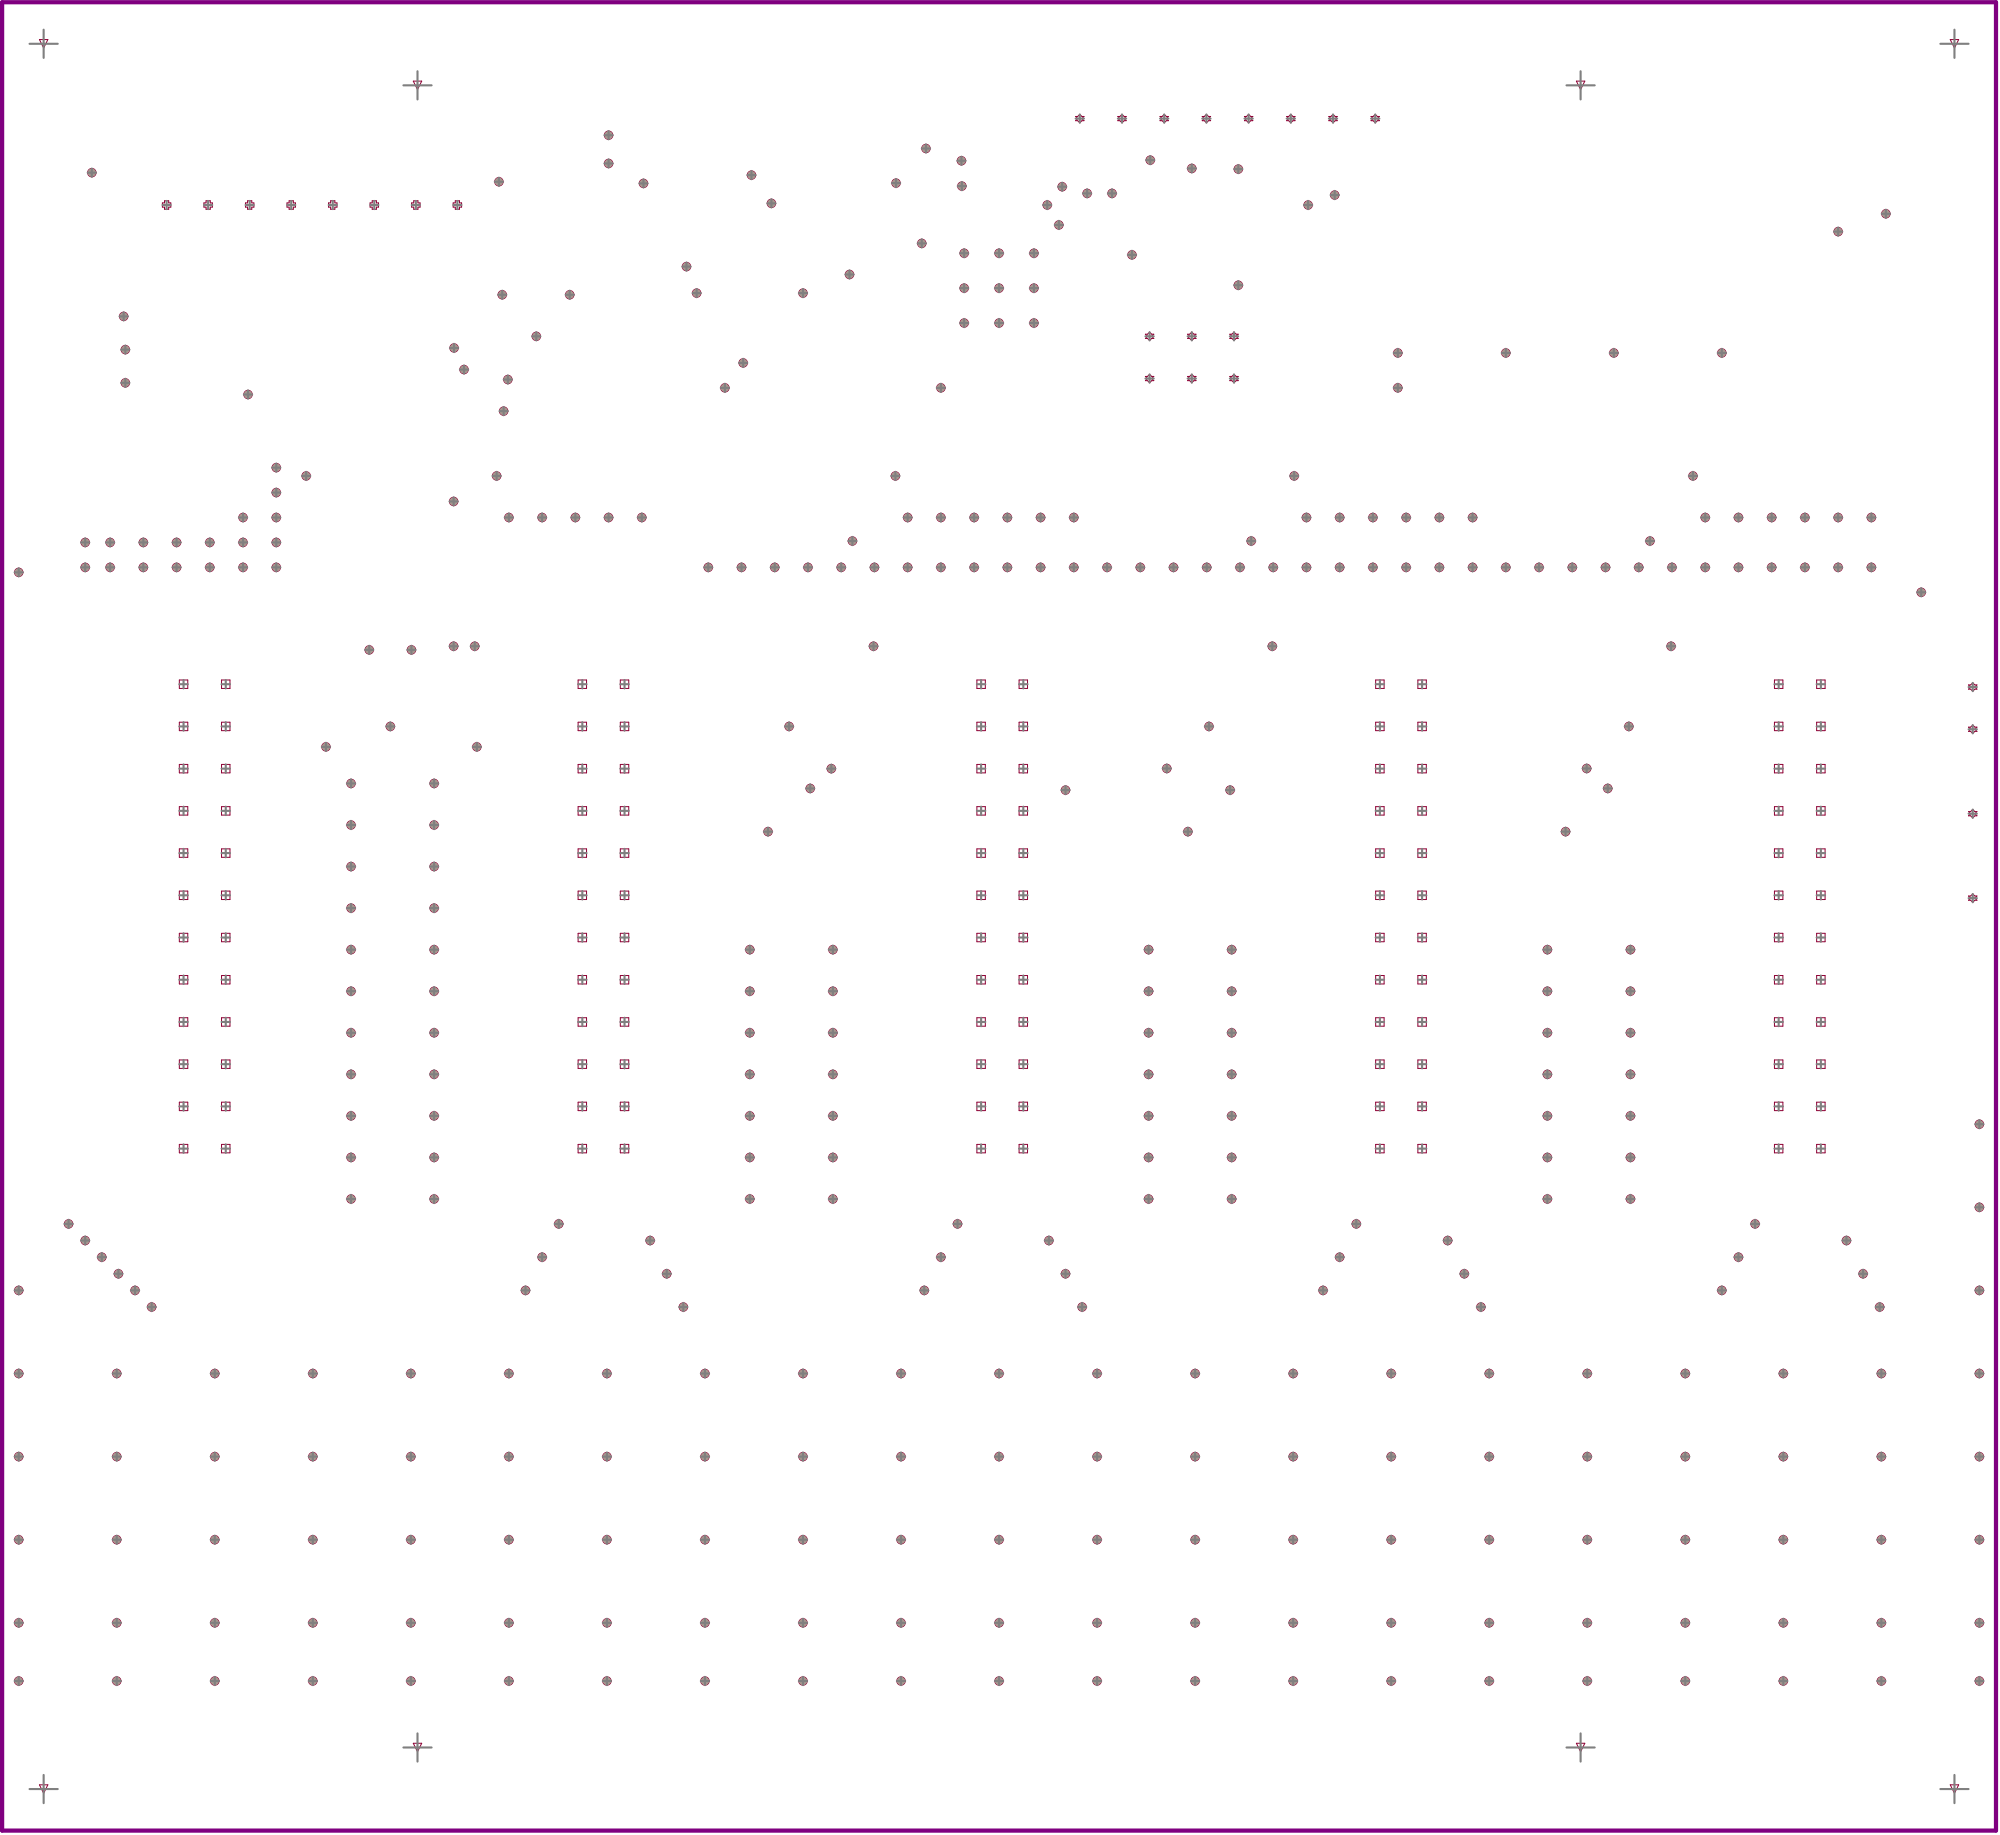
[picture p184: page 3]

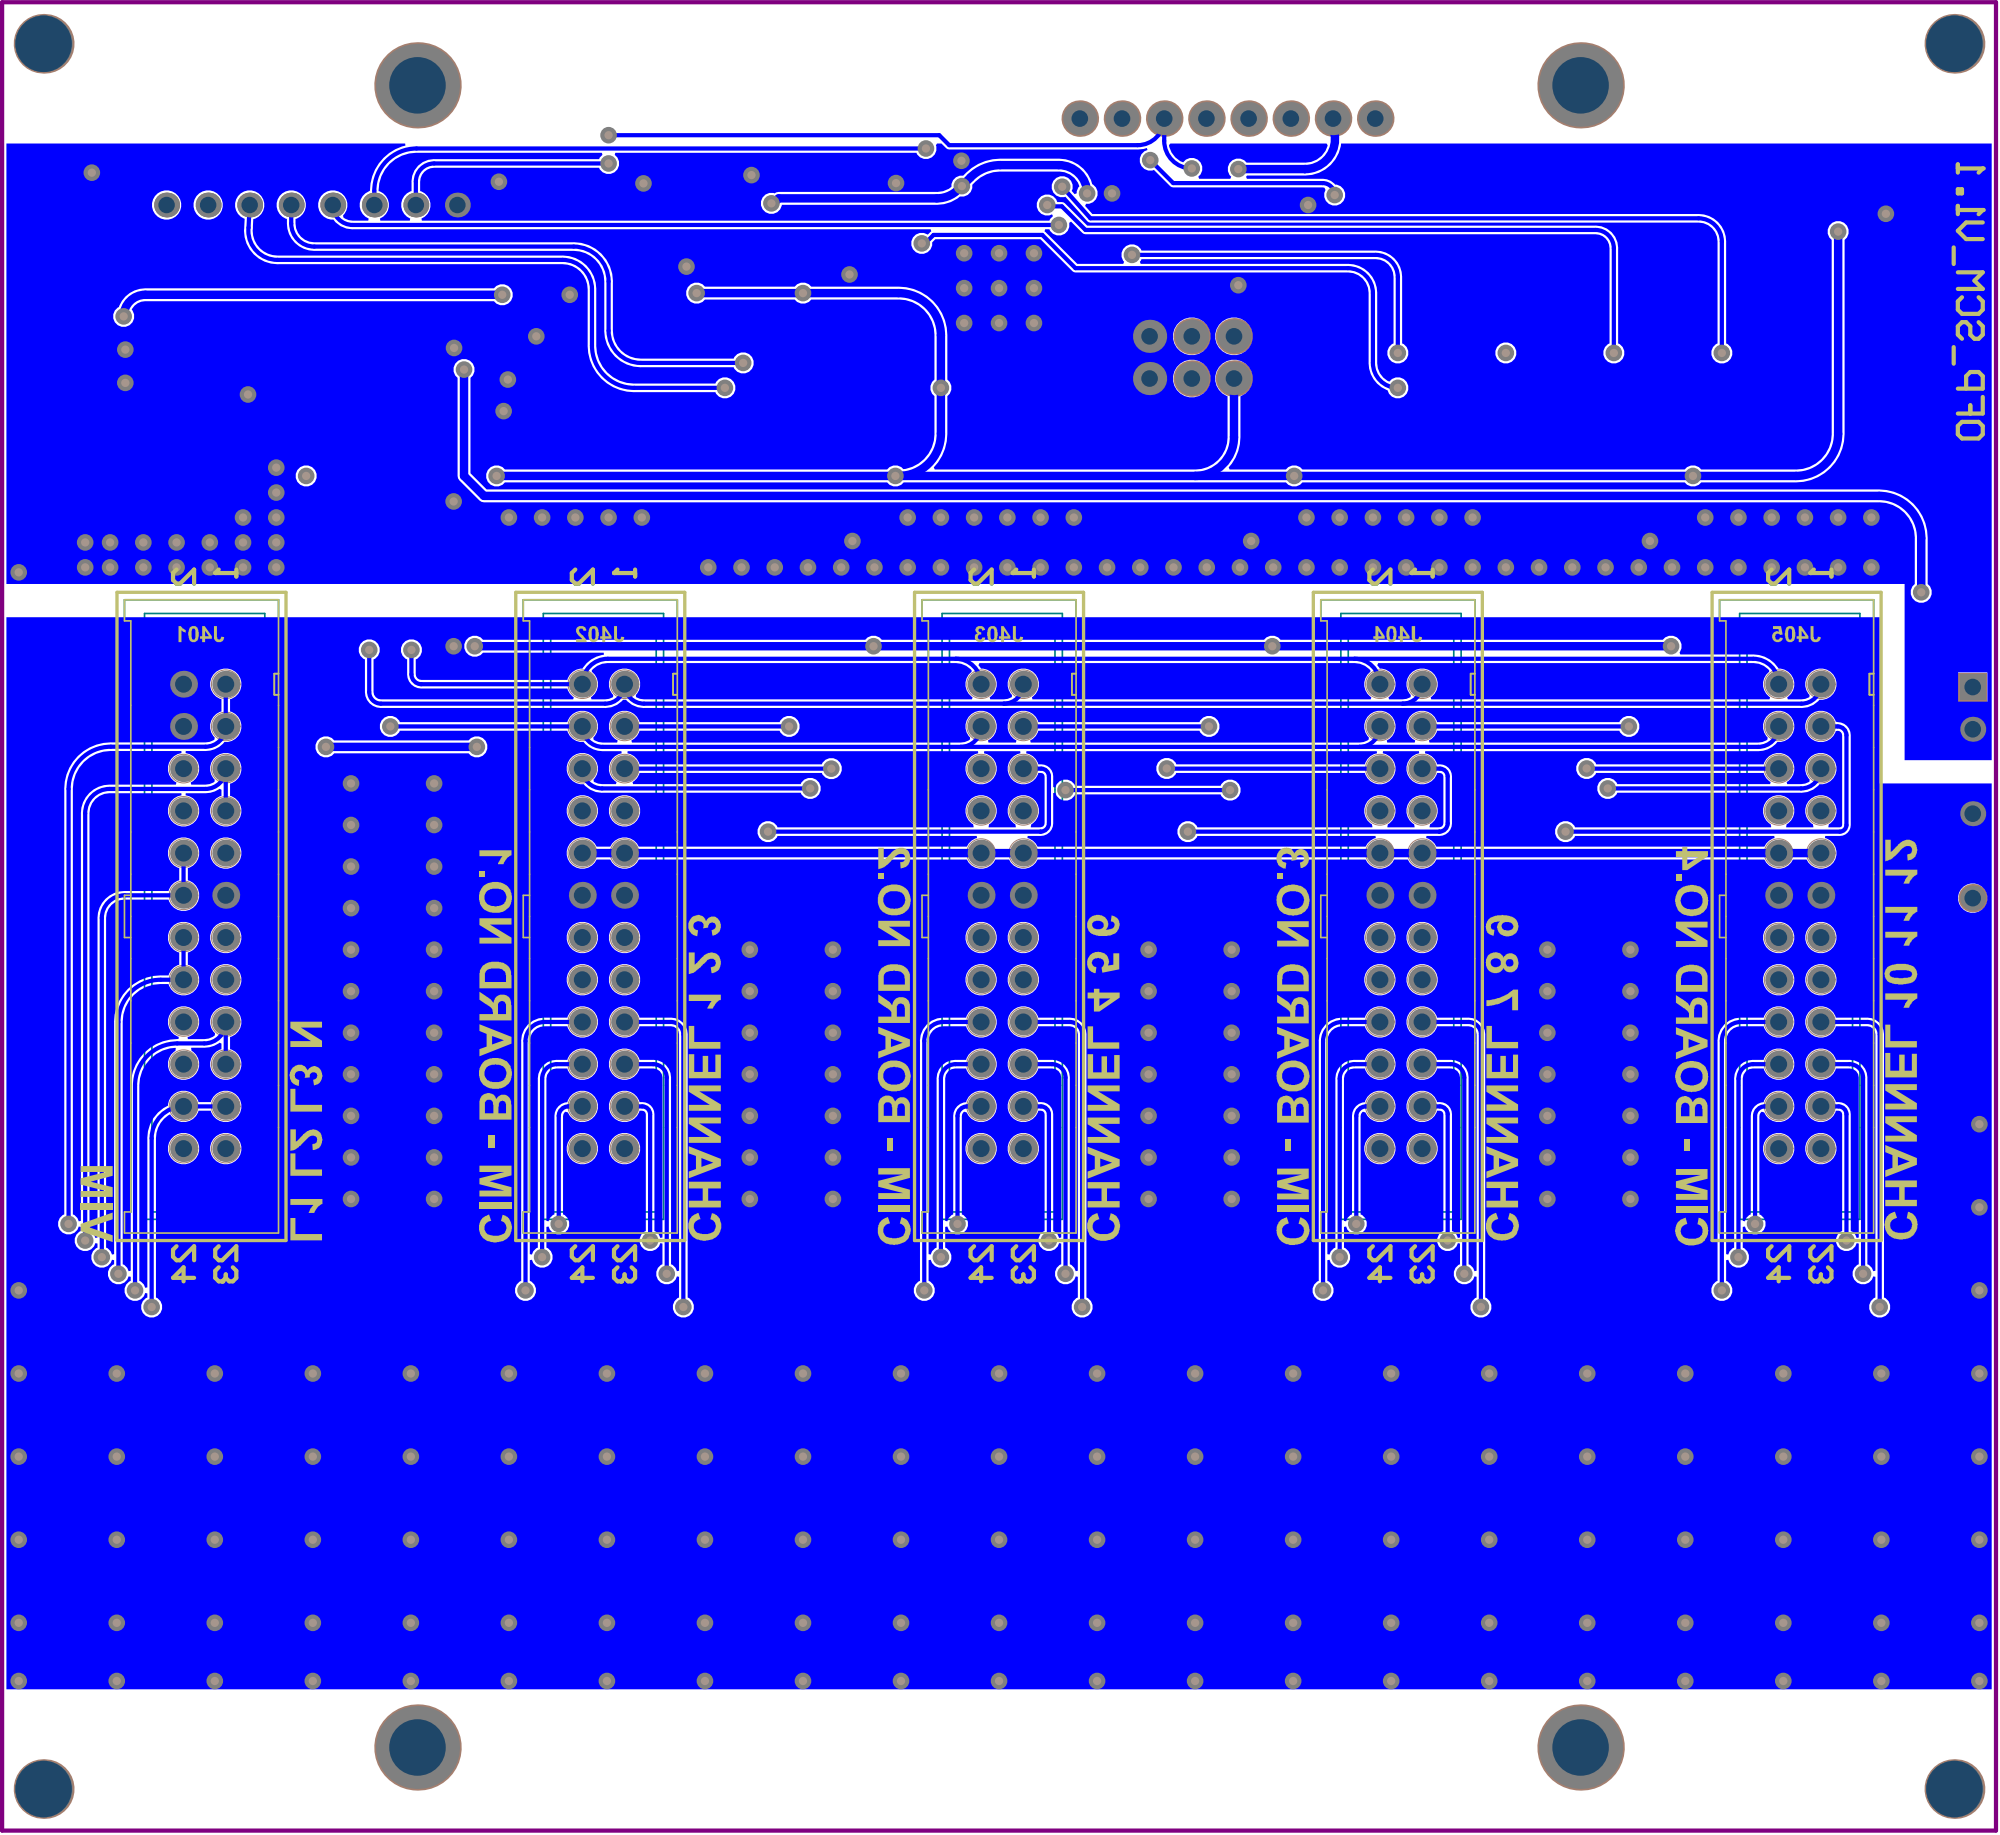
[picture p185: page 5]

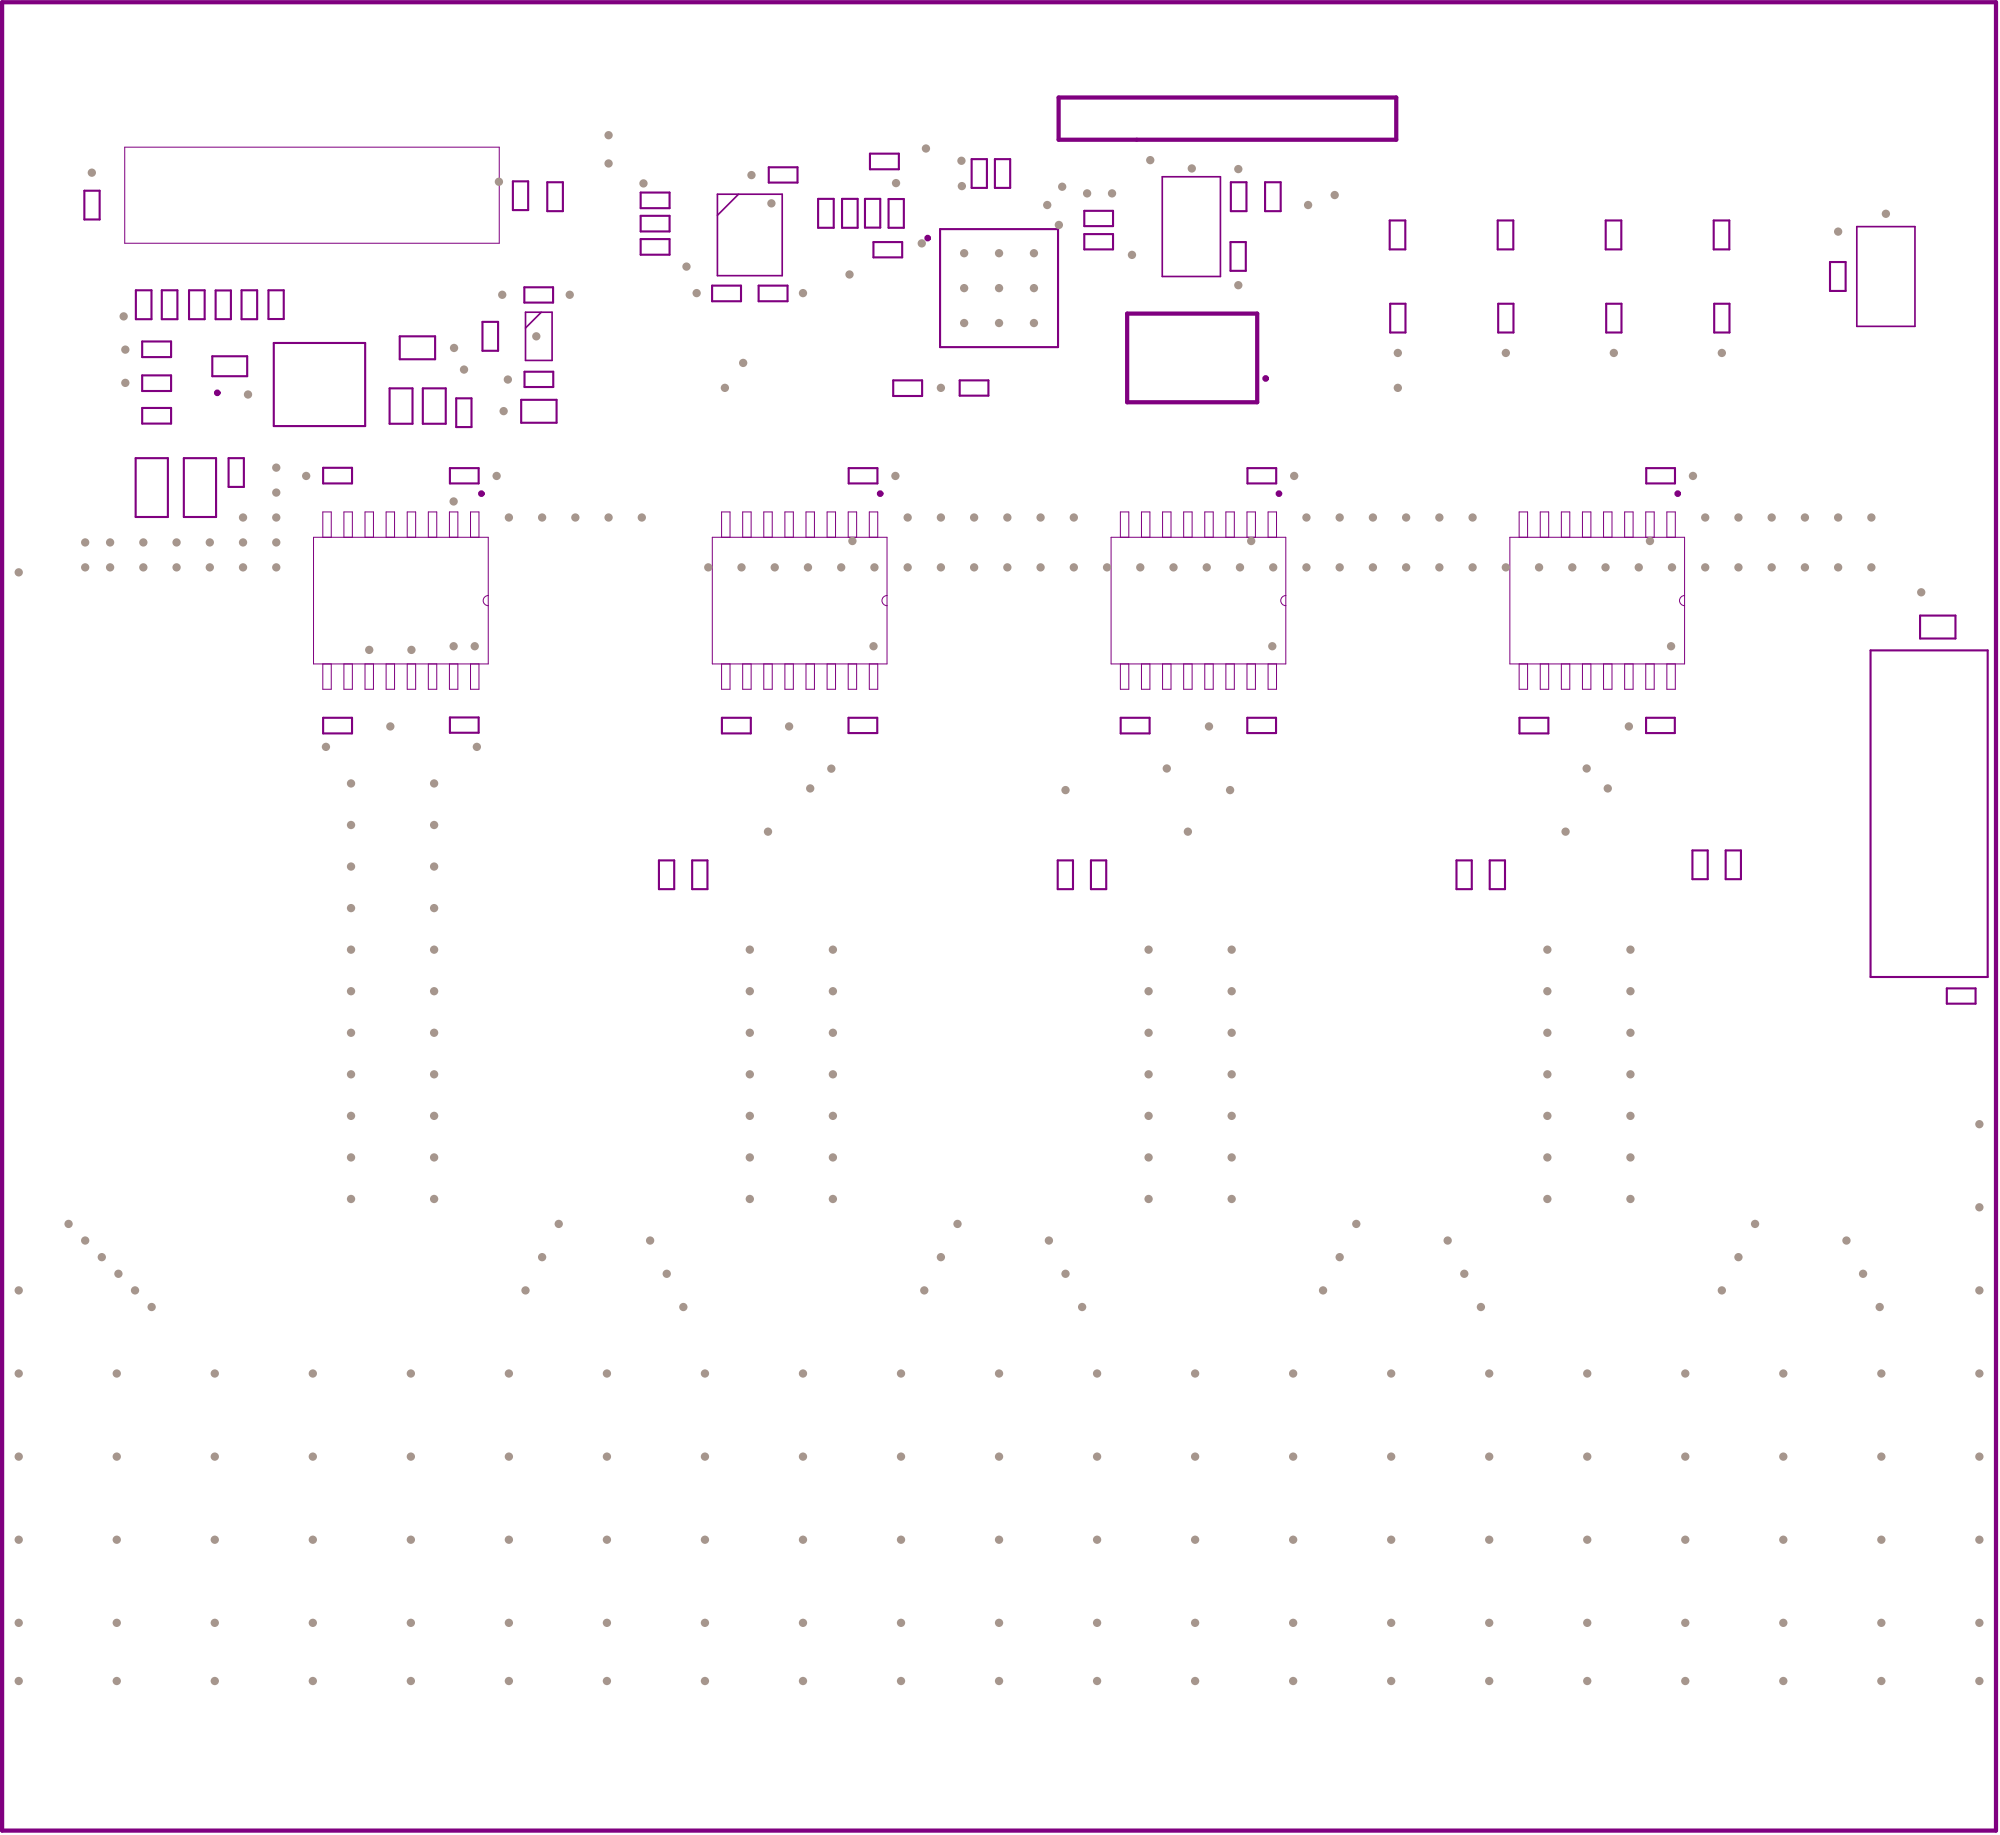
[picture p186: page 6]

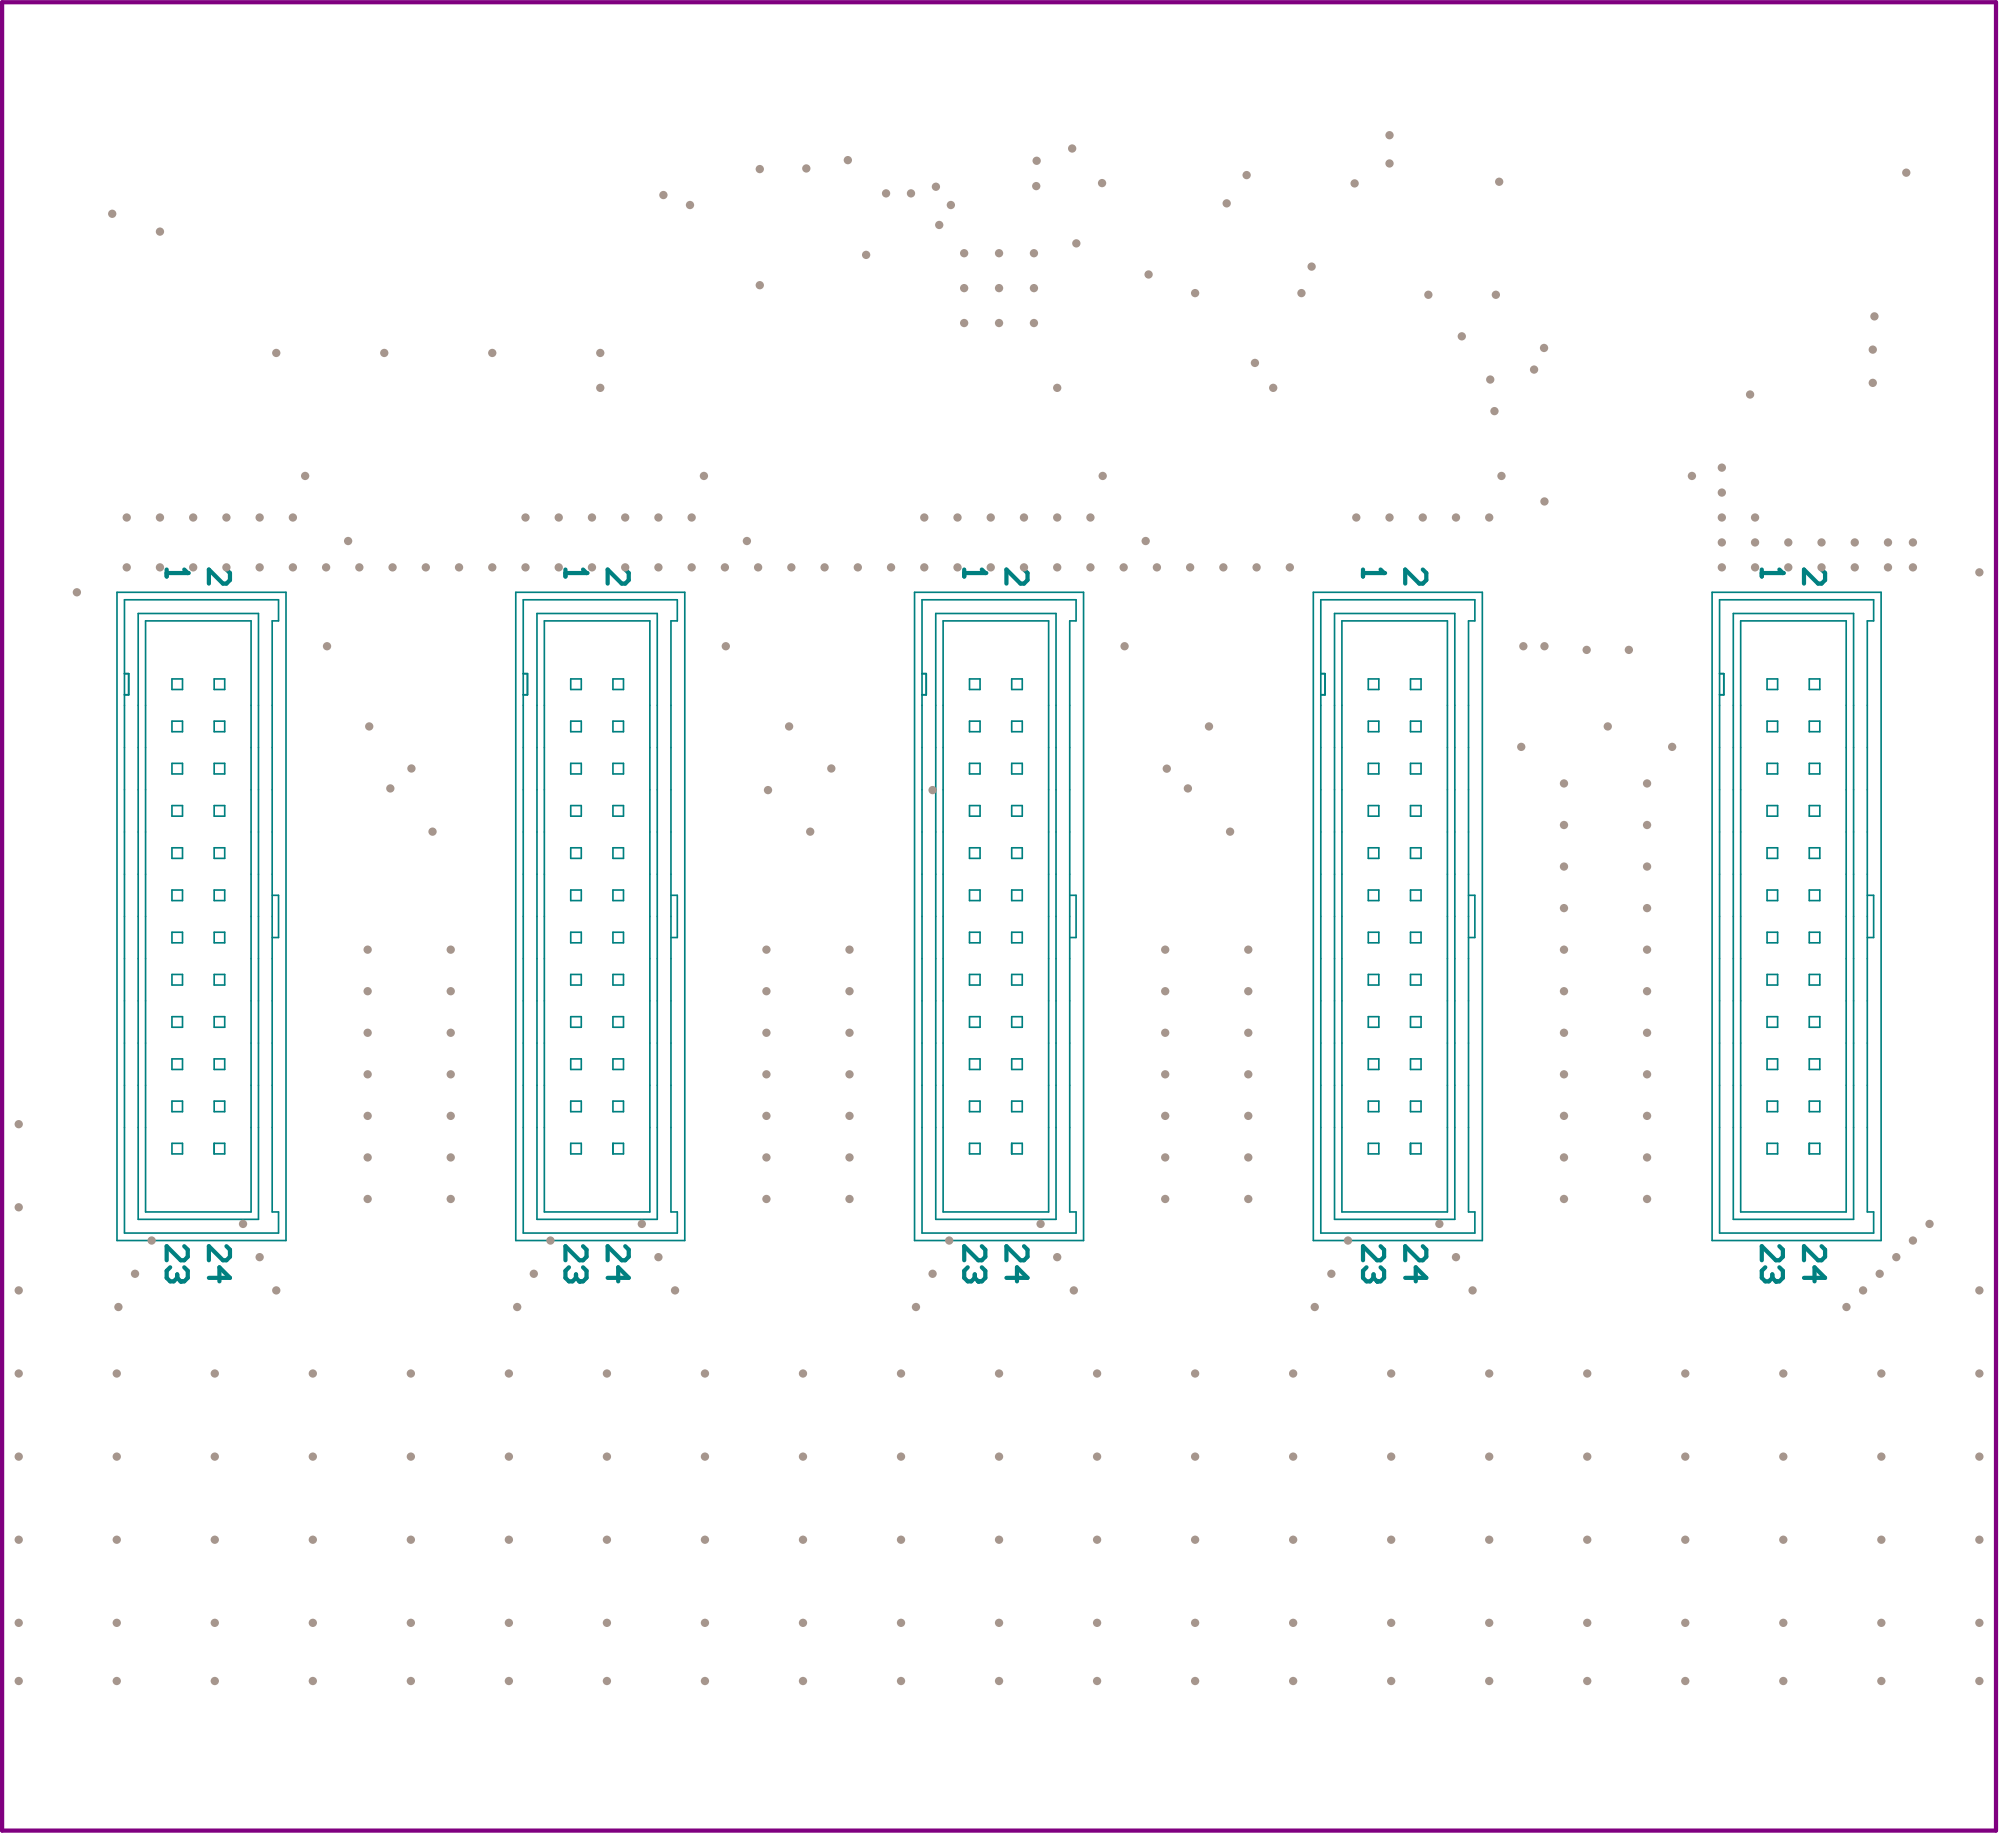
[picture p187: page 7]

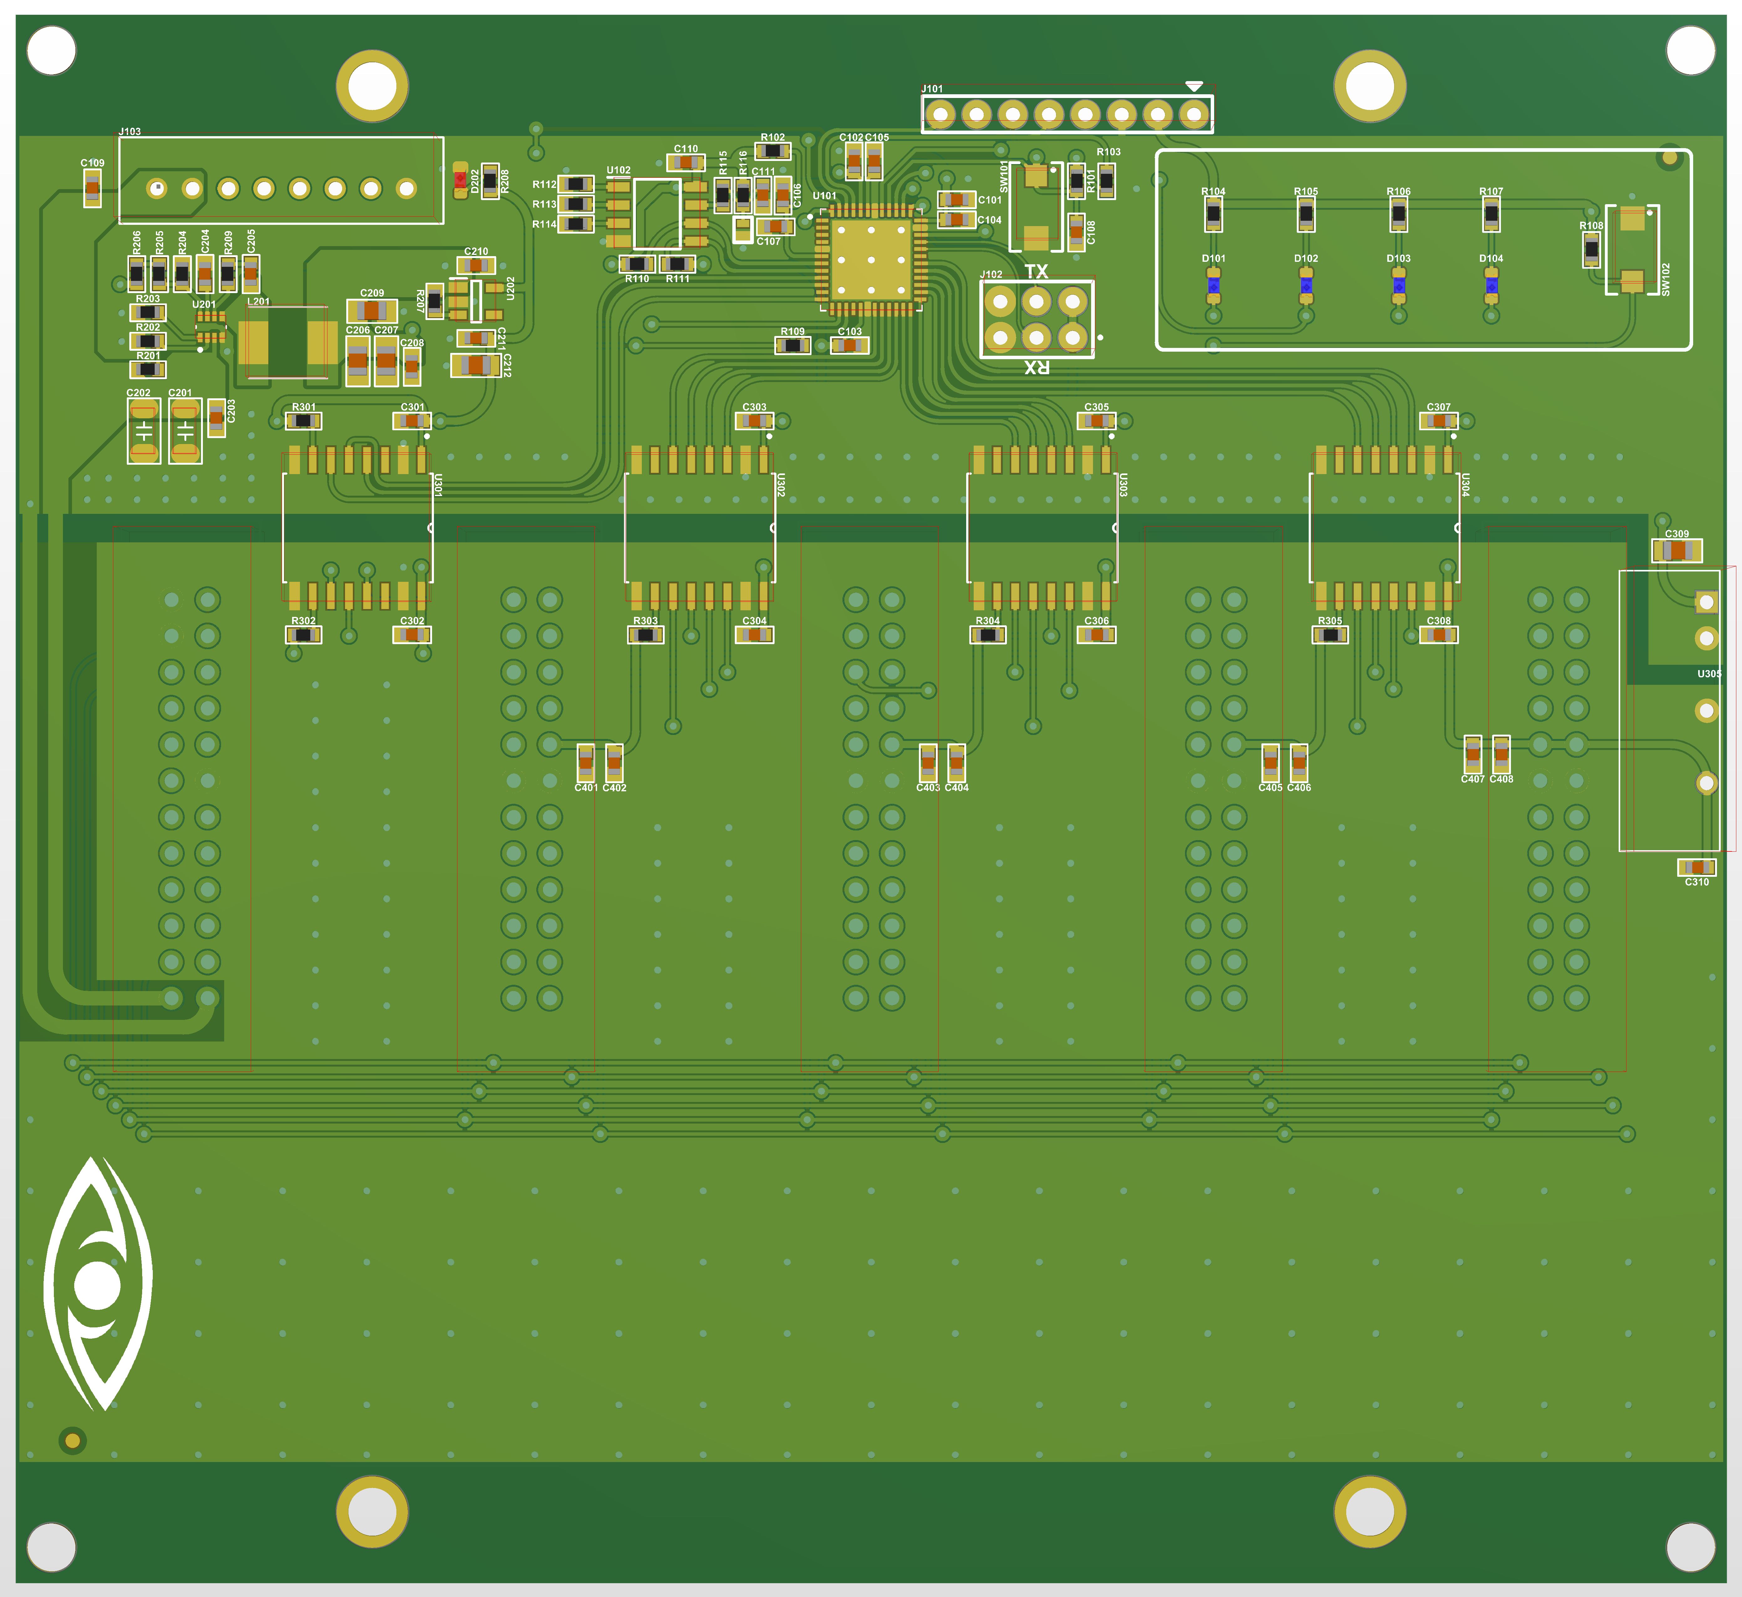
[picture p188: page 8]

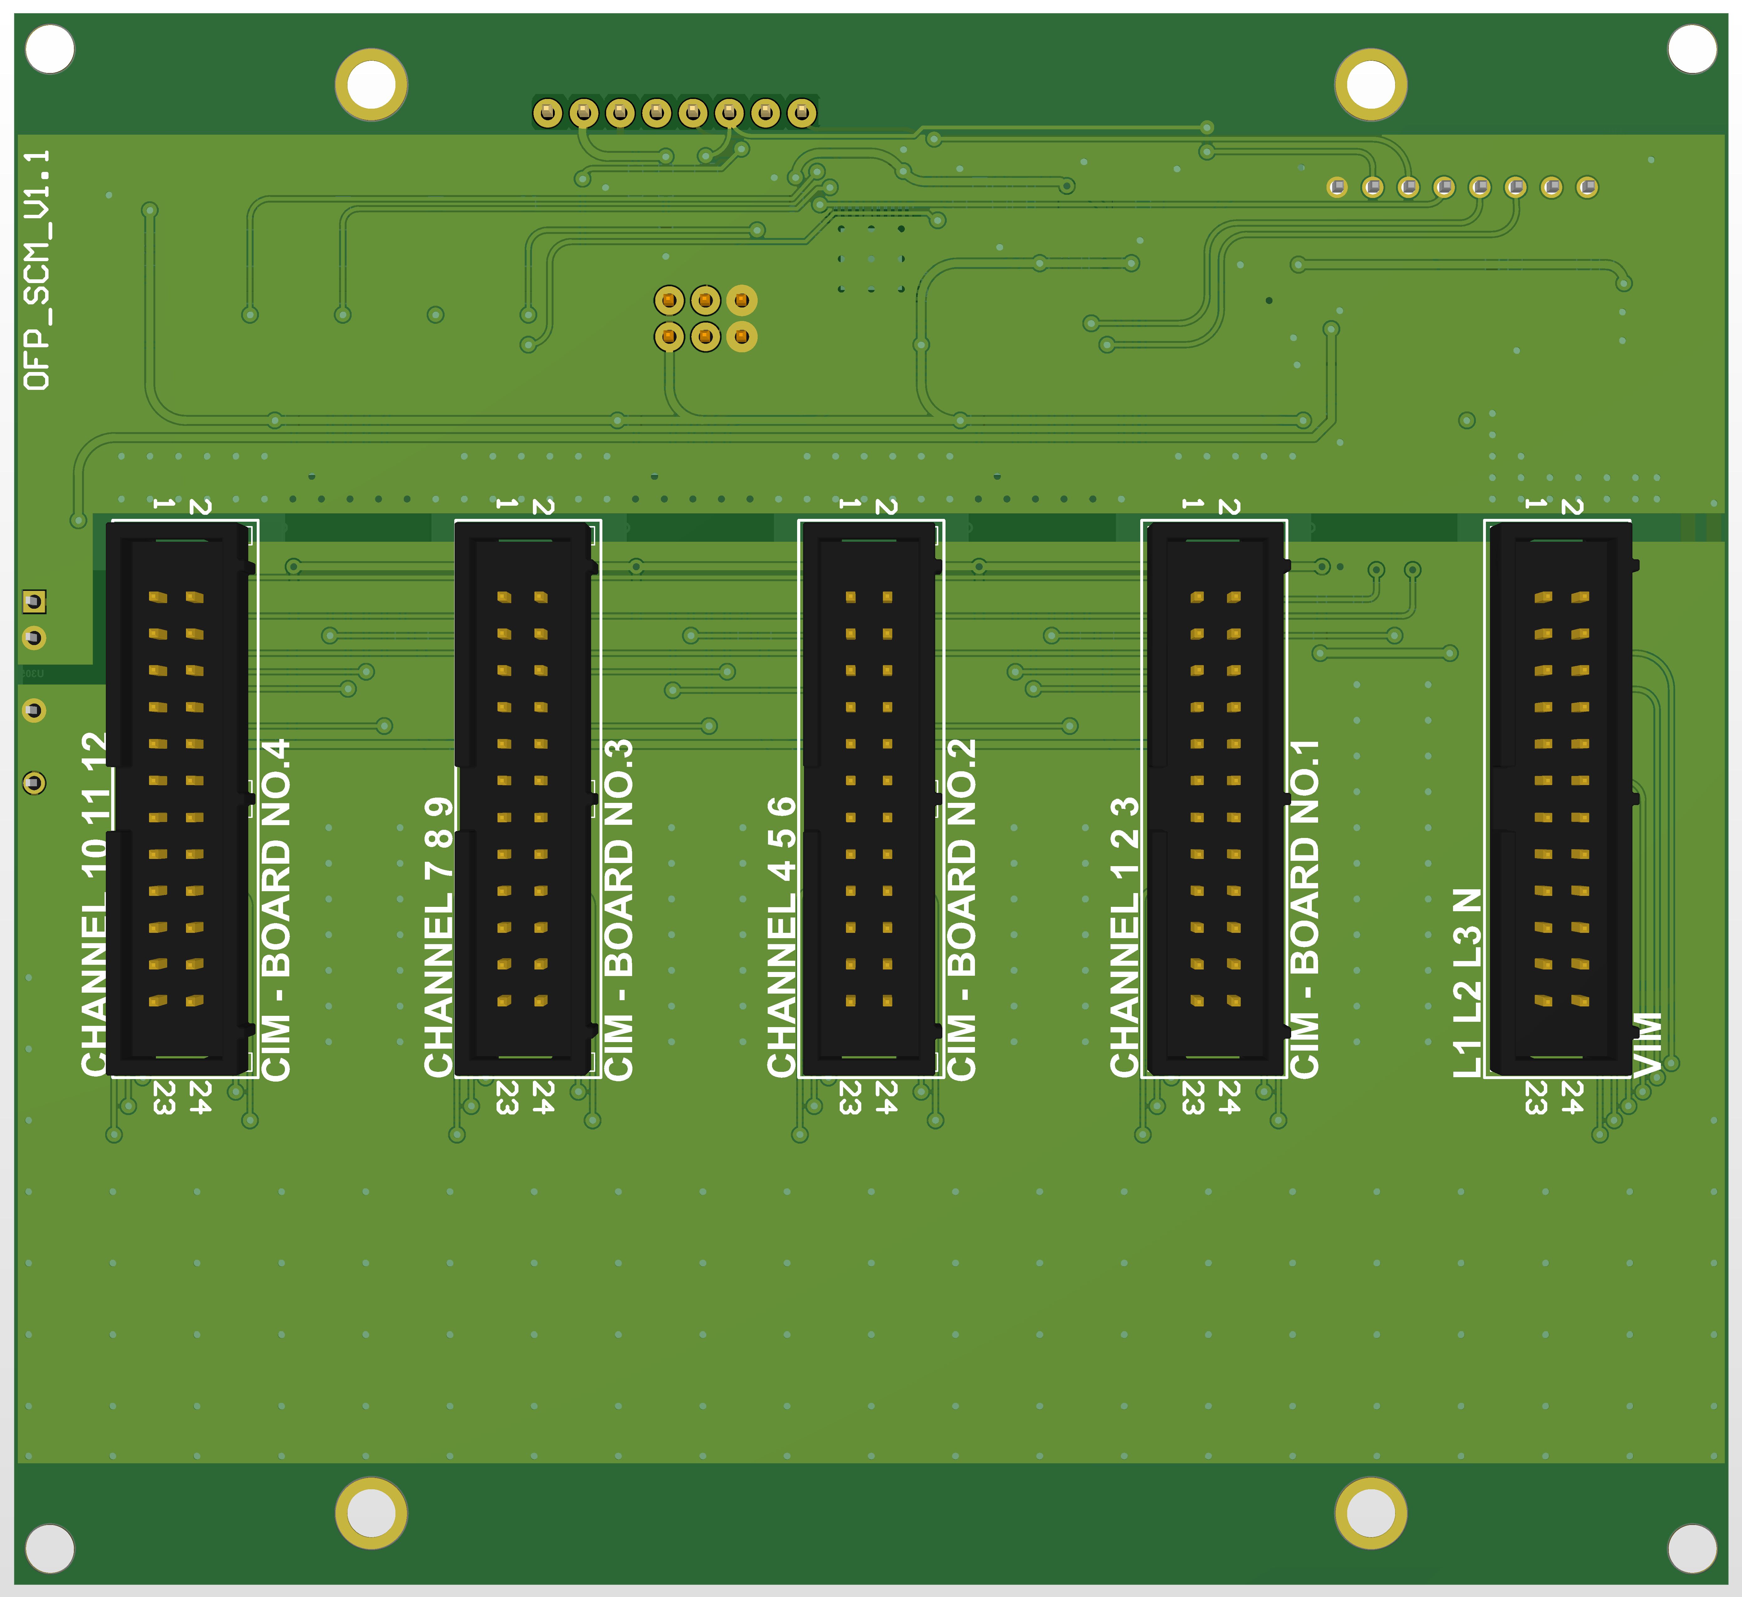
[picture p189: page 9]
