eSpark-Backup/nabilfesal-smartmeter-hw/docs/Client-Files/Product Files/MSM-Documentation-24122024/PCB/PCB_OutJob_USM_V1.0.PDF

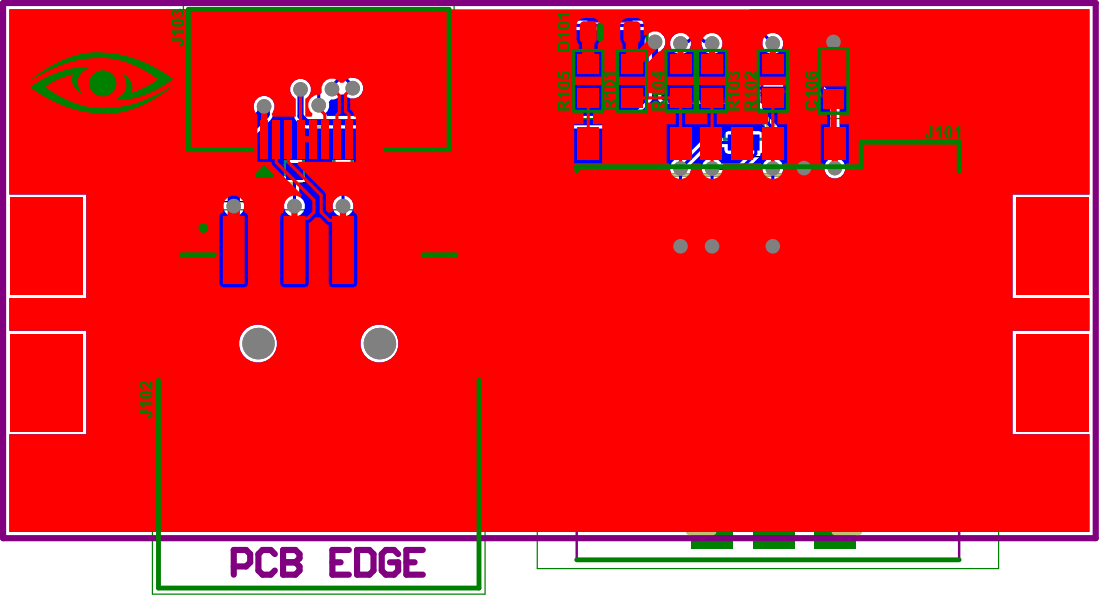
[picture p190: page 1]

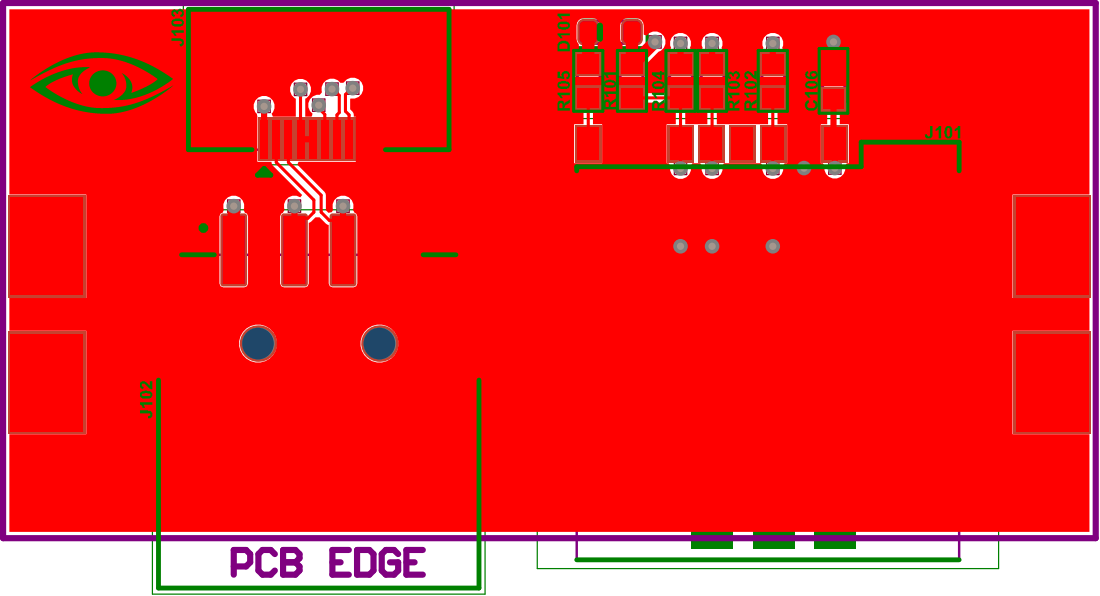
[picture p191: page 2]

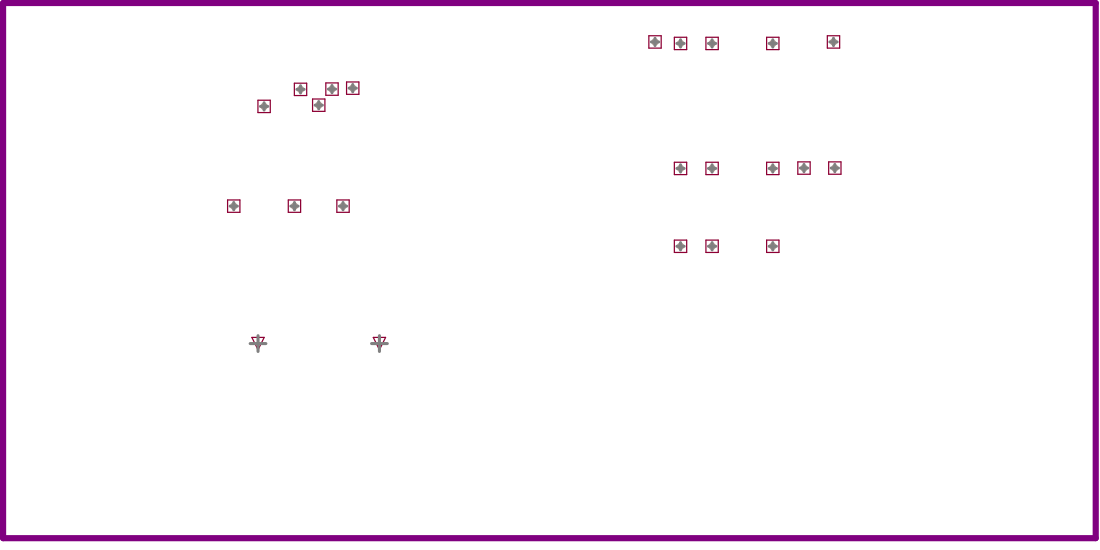
[picture p192: page 3]

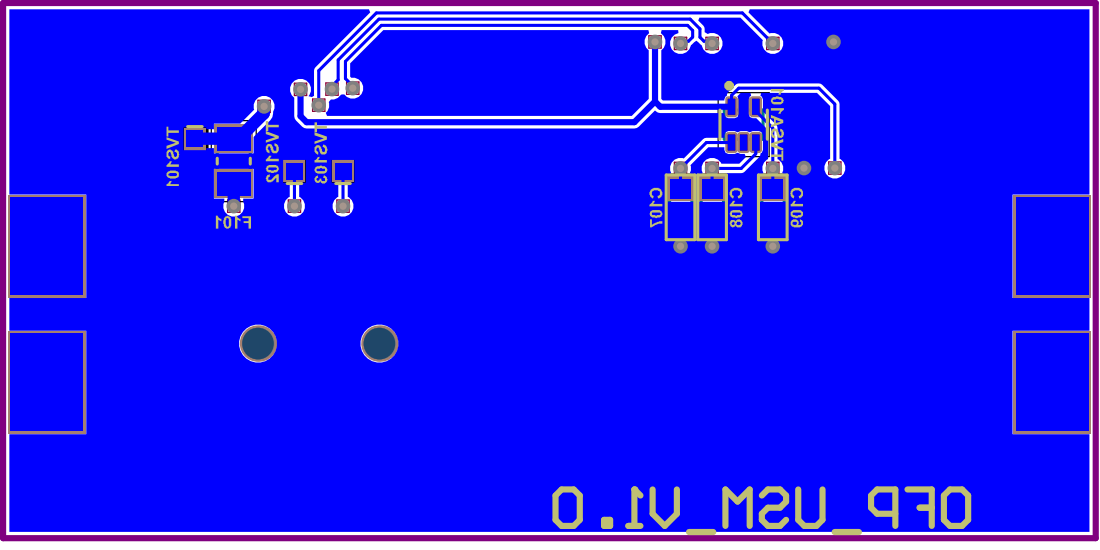
[picture p193: page 5]

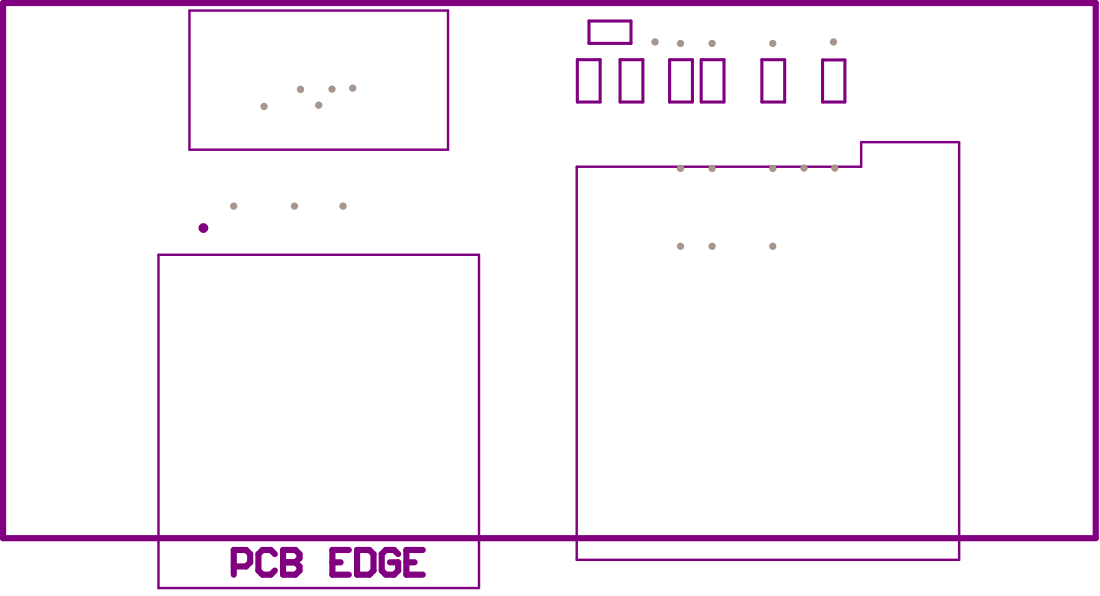
[picture p194: page 6]

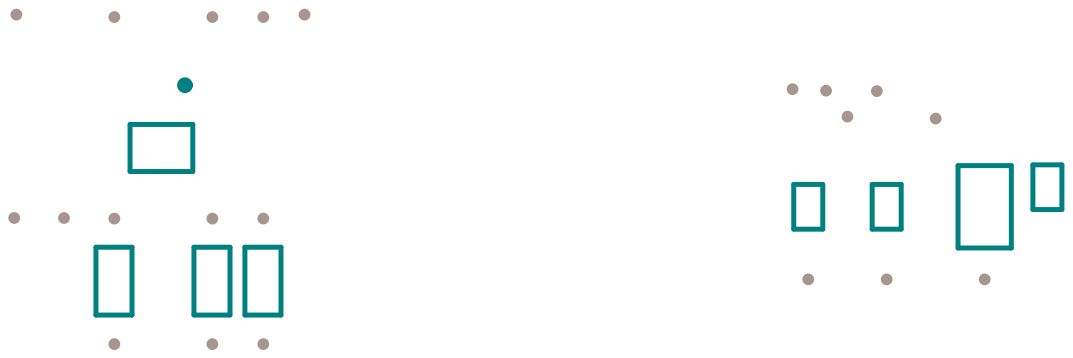
[picture p195: page 7]

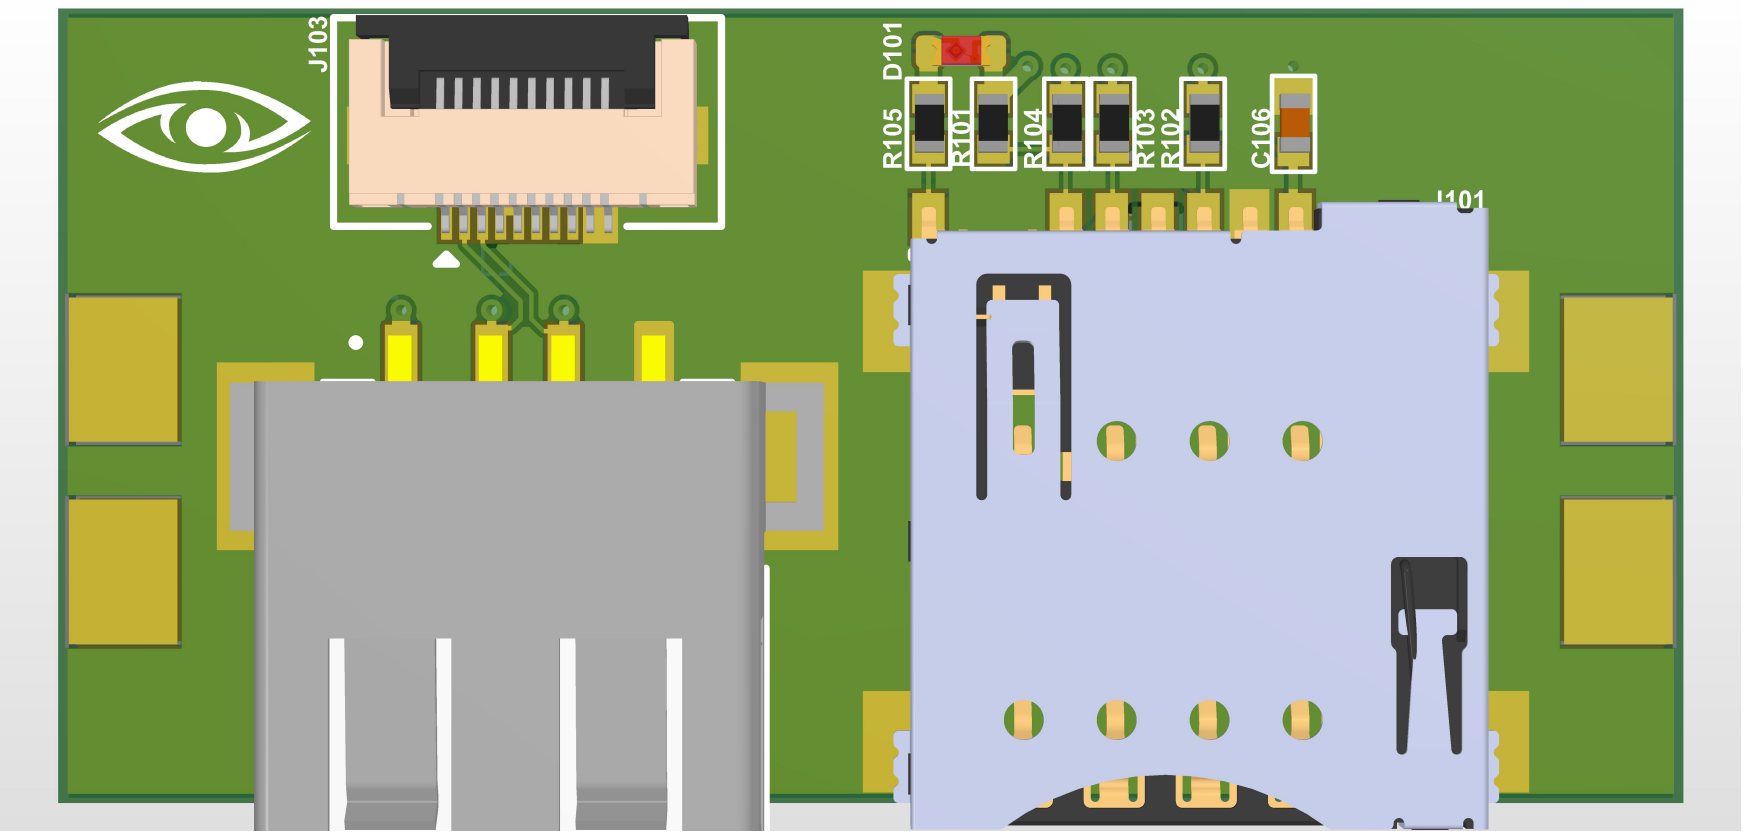
[picture p196: page 8]

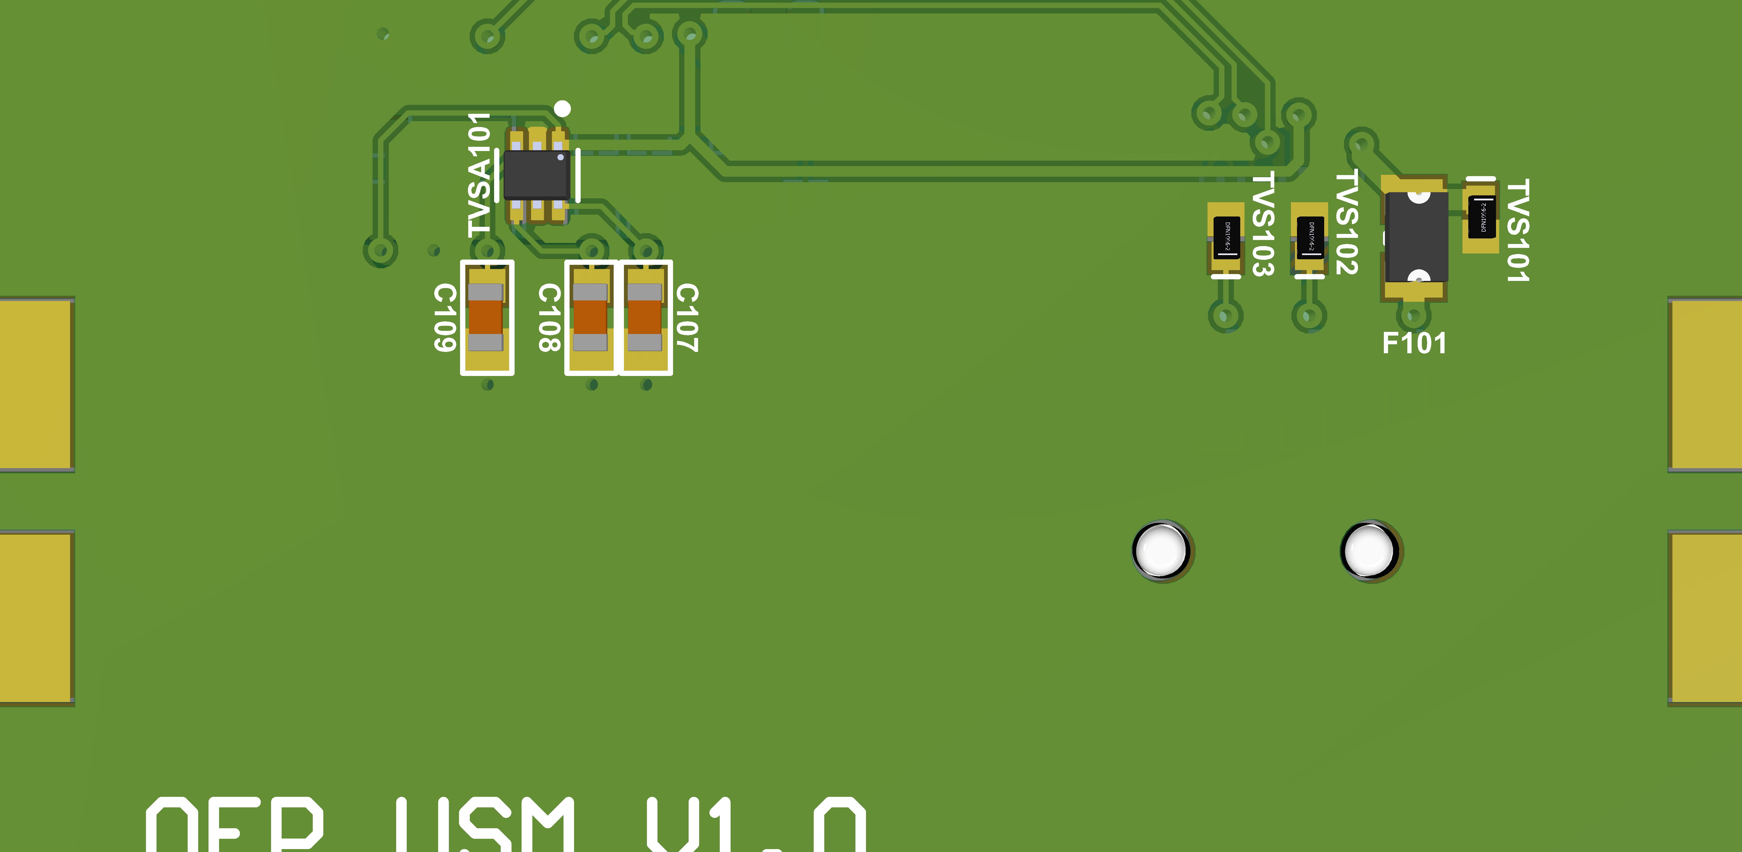
[picture p197: page 9]
