eSpark-Backup/nabilfesal-smartmeter-hw/docs/Client-Files/Product Files/MSM-Documentation-24122024/PCB/PCB_OutJob_VIM_V1.1.PDF

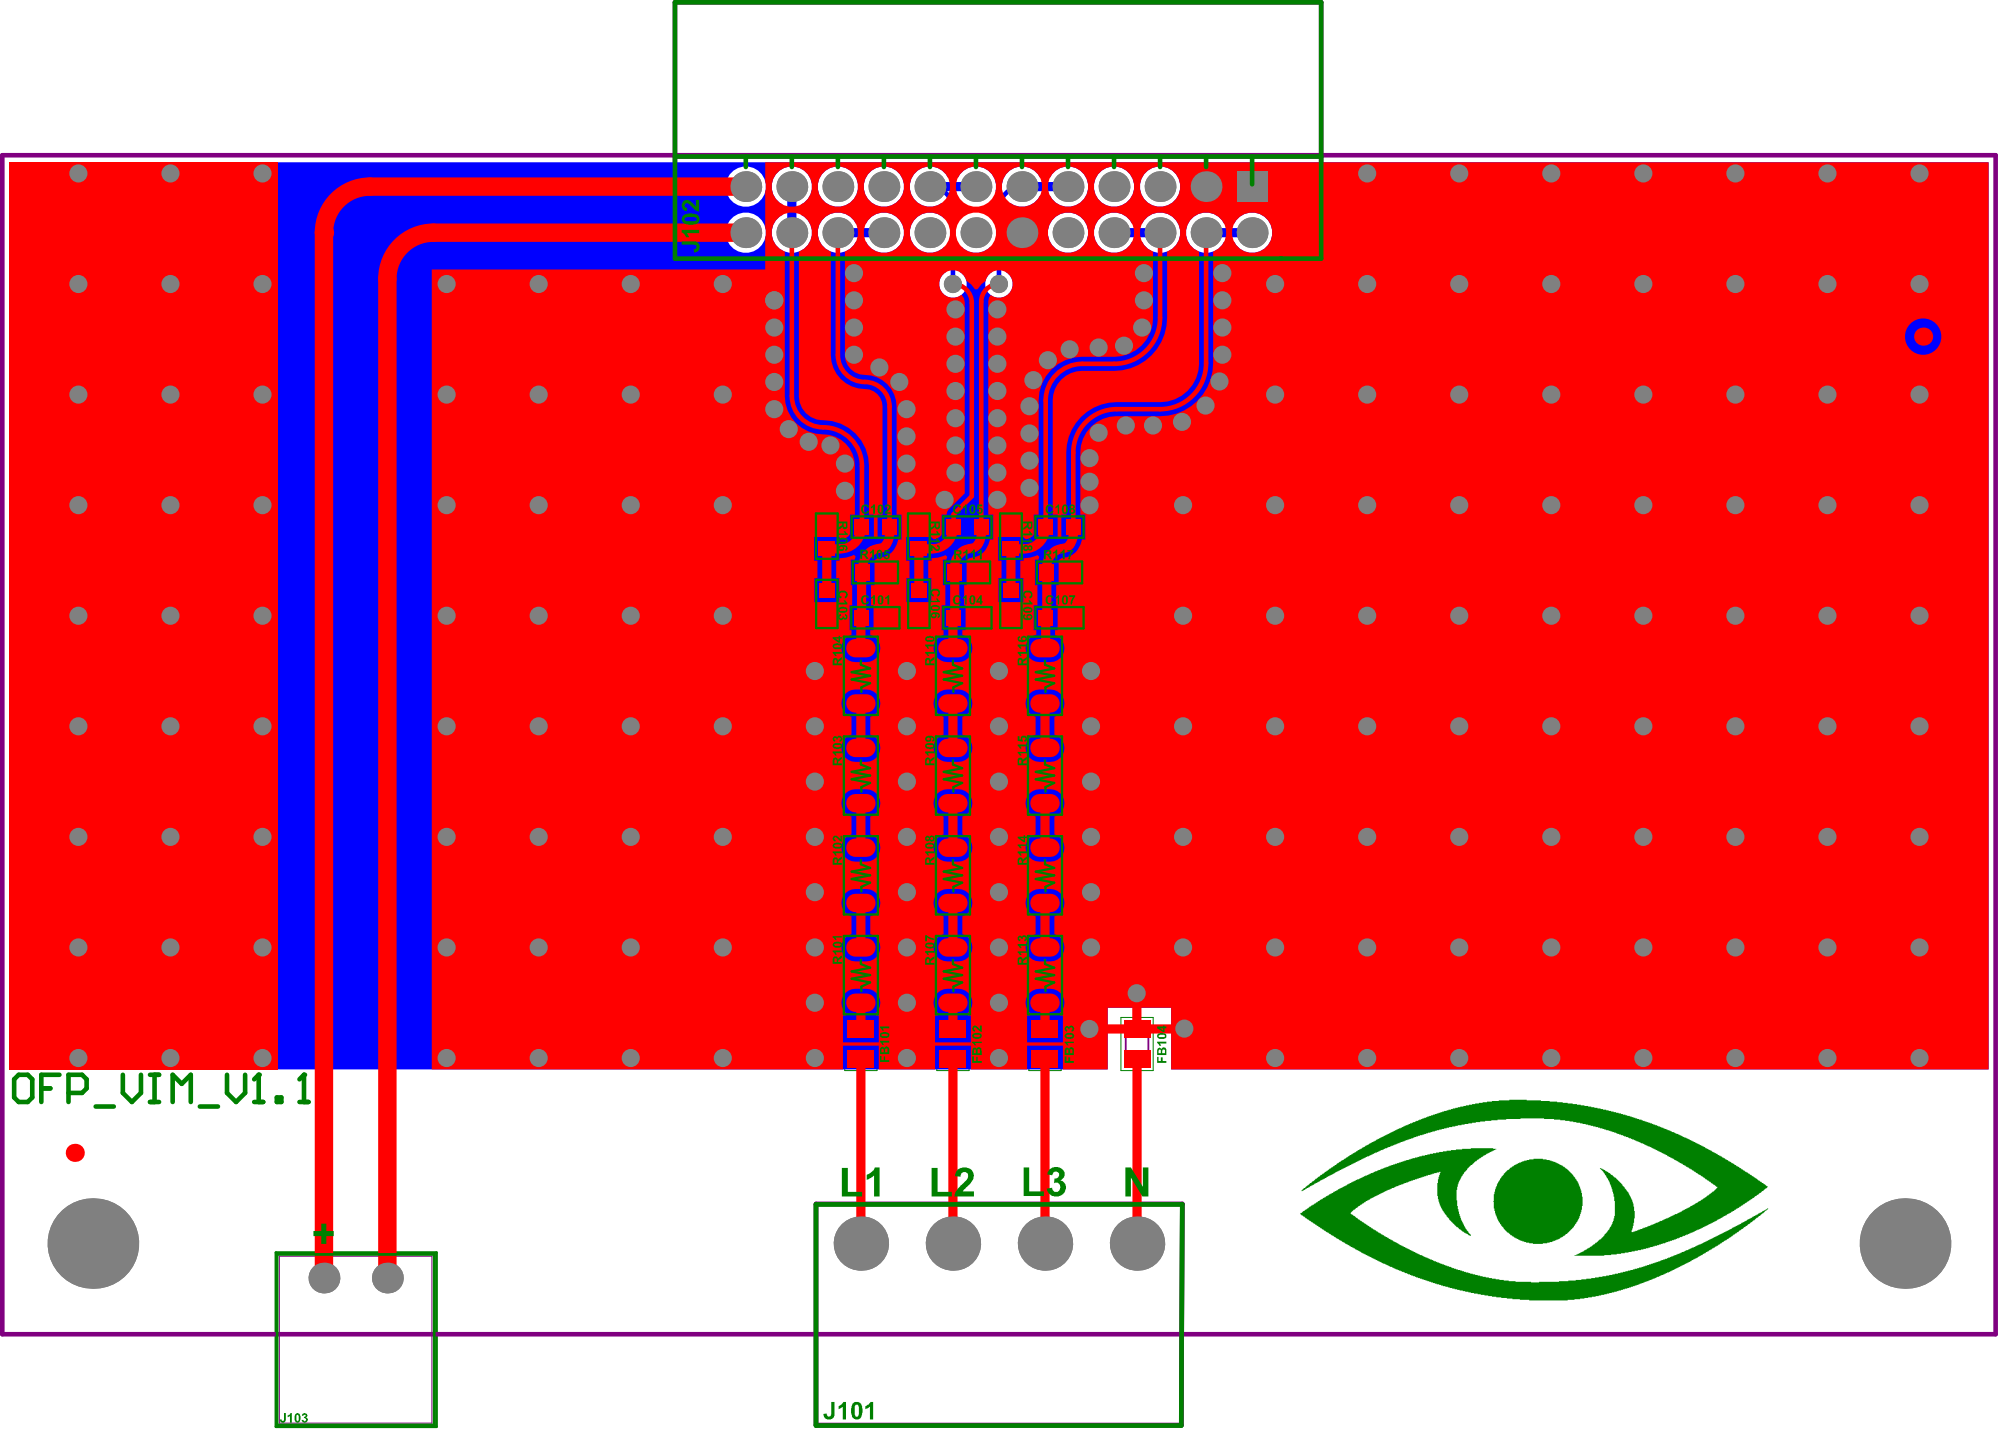
[picture p198: page 1]

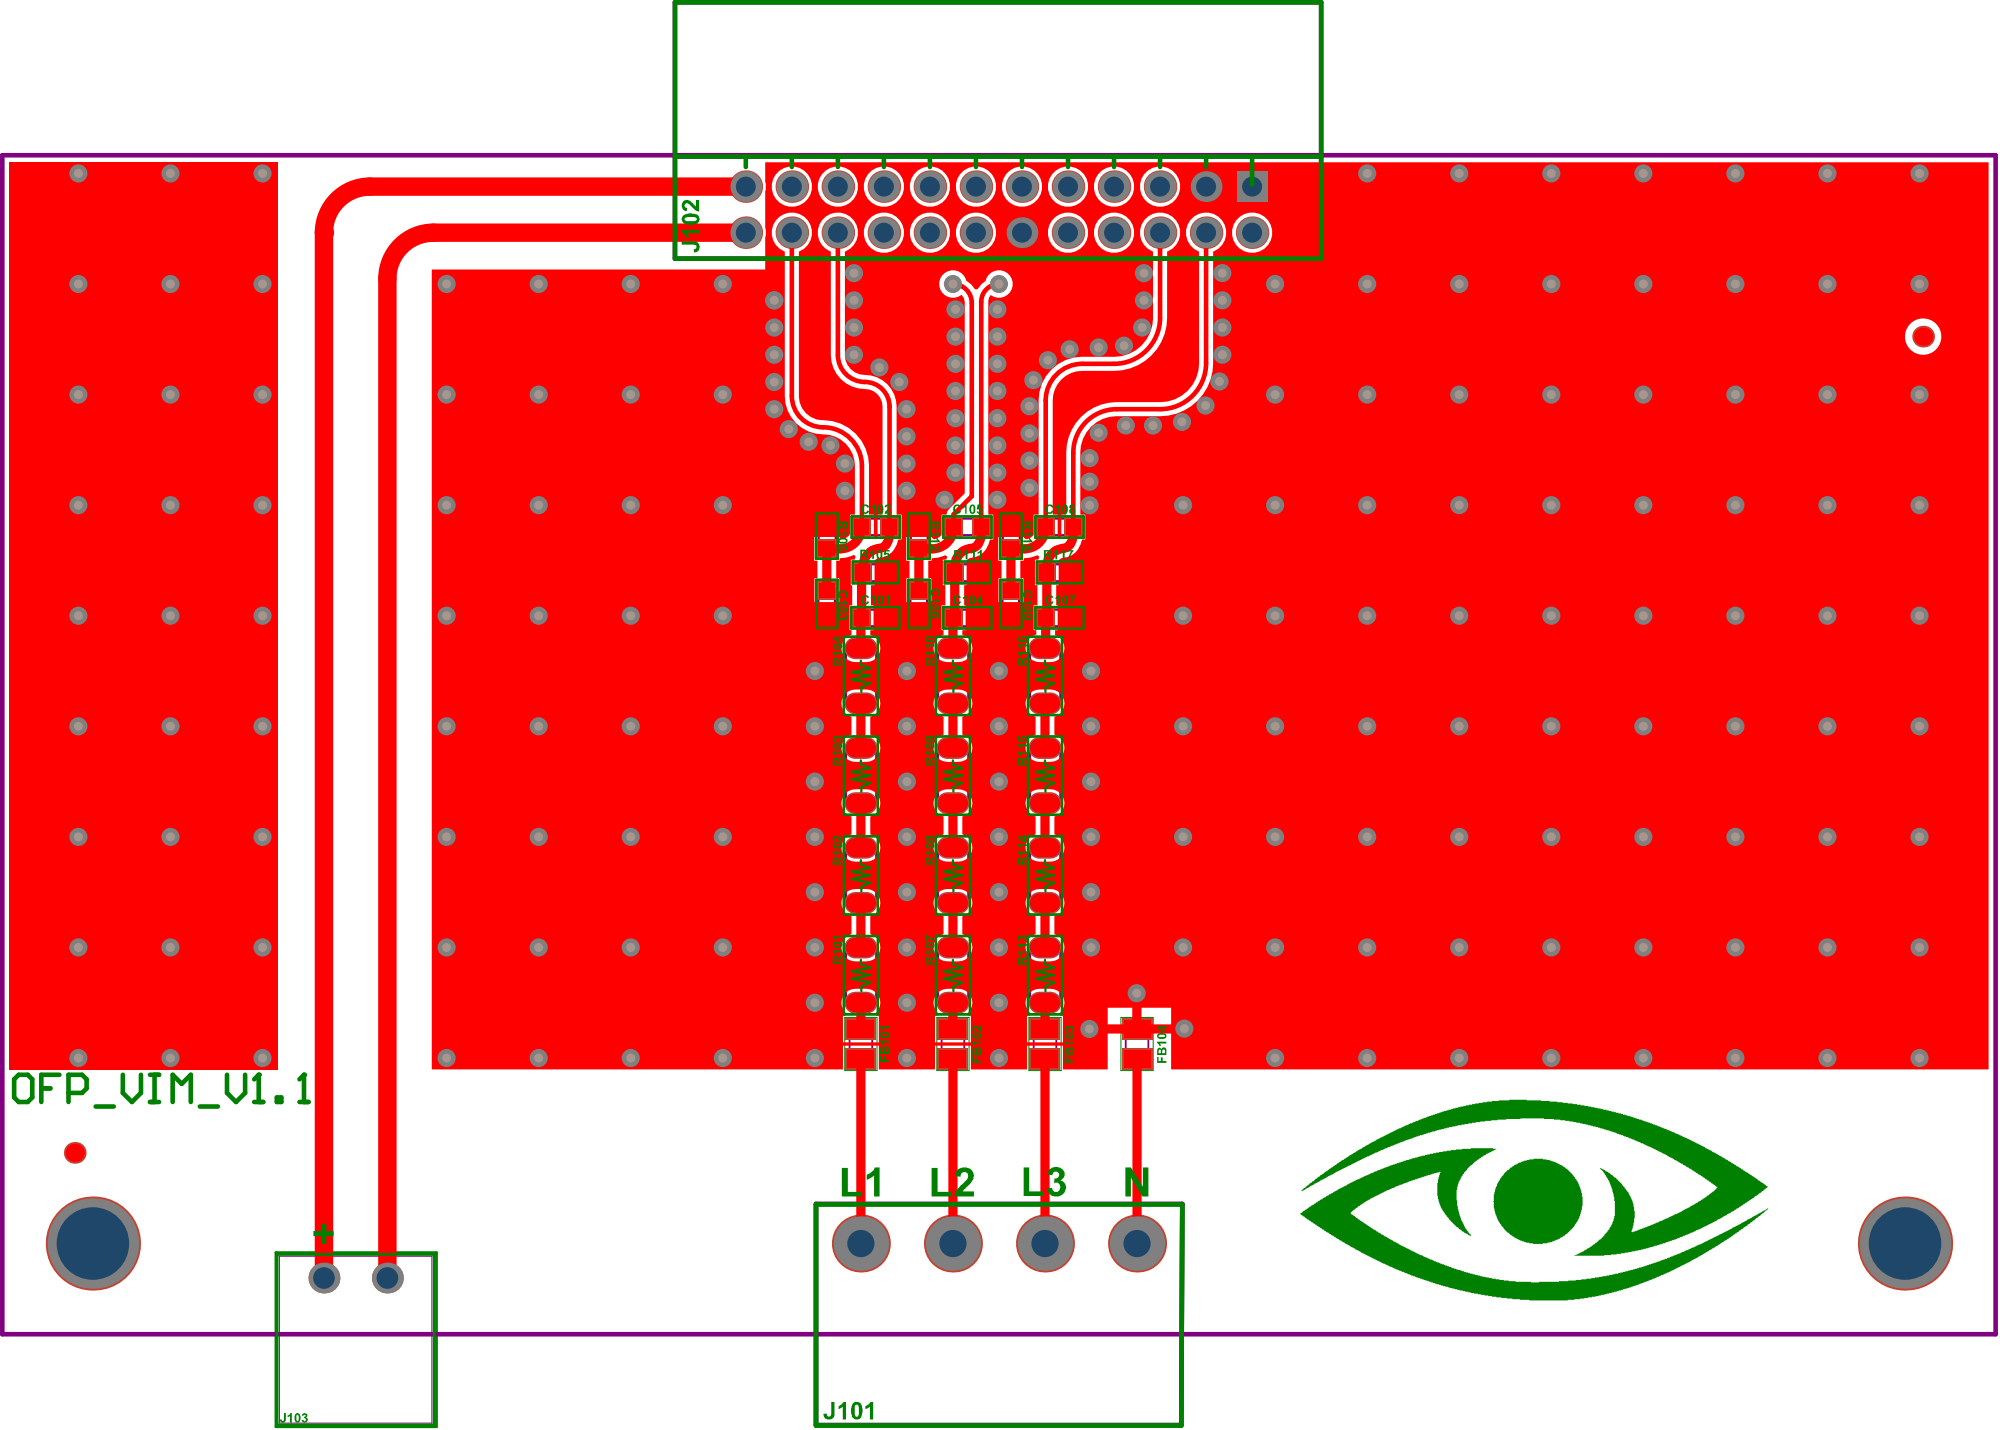
[picture p199: page 2]

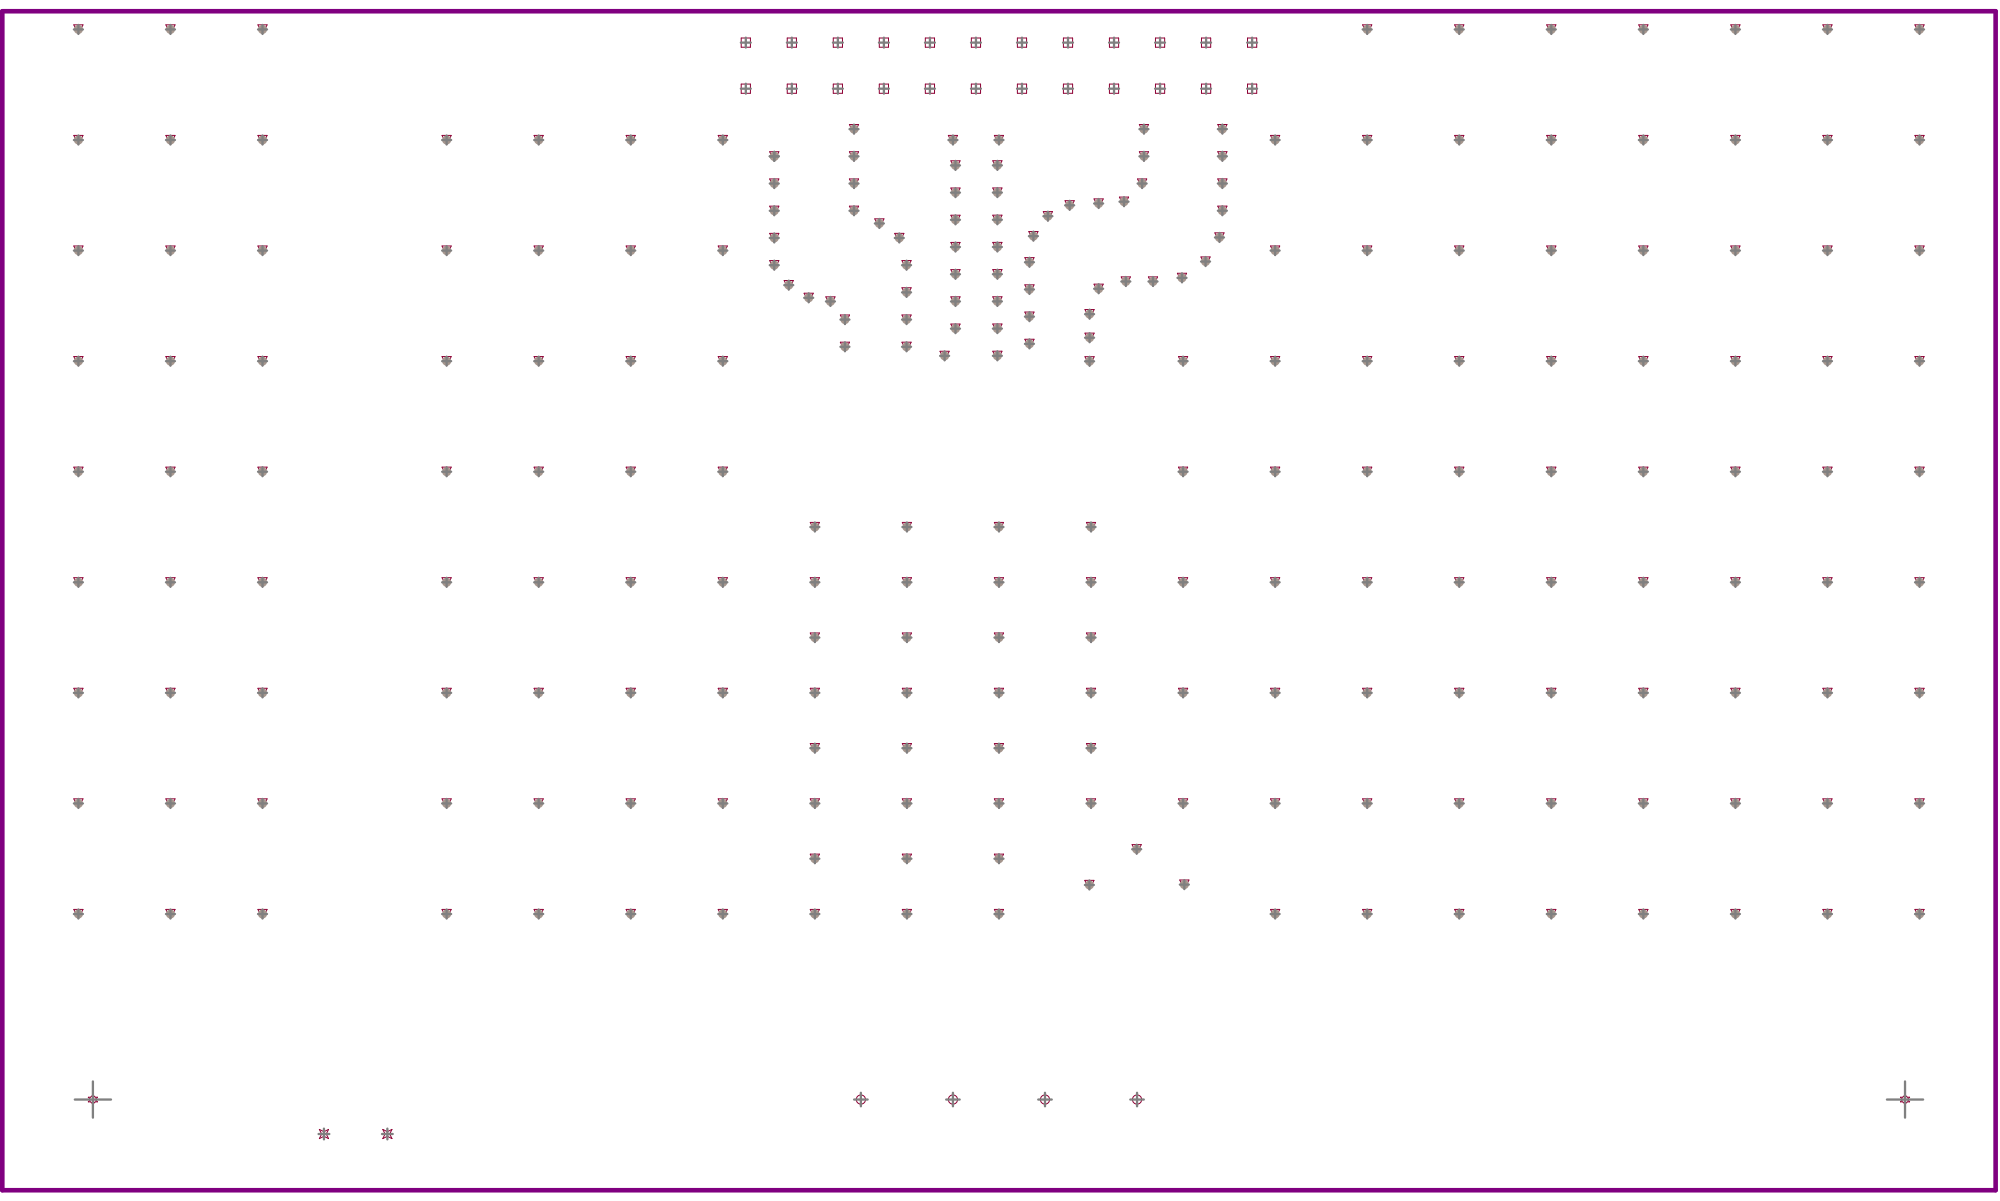
[picture p200: page 3]

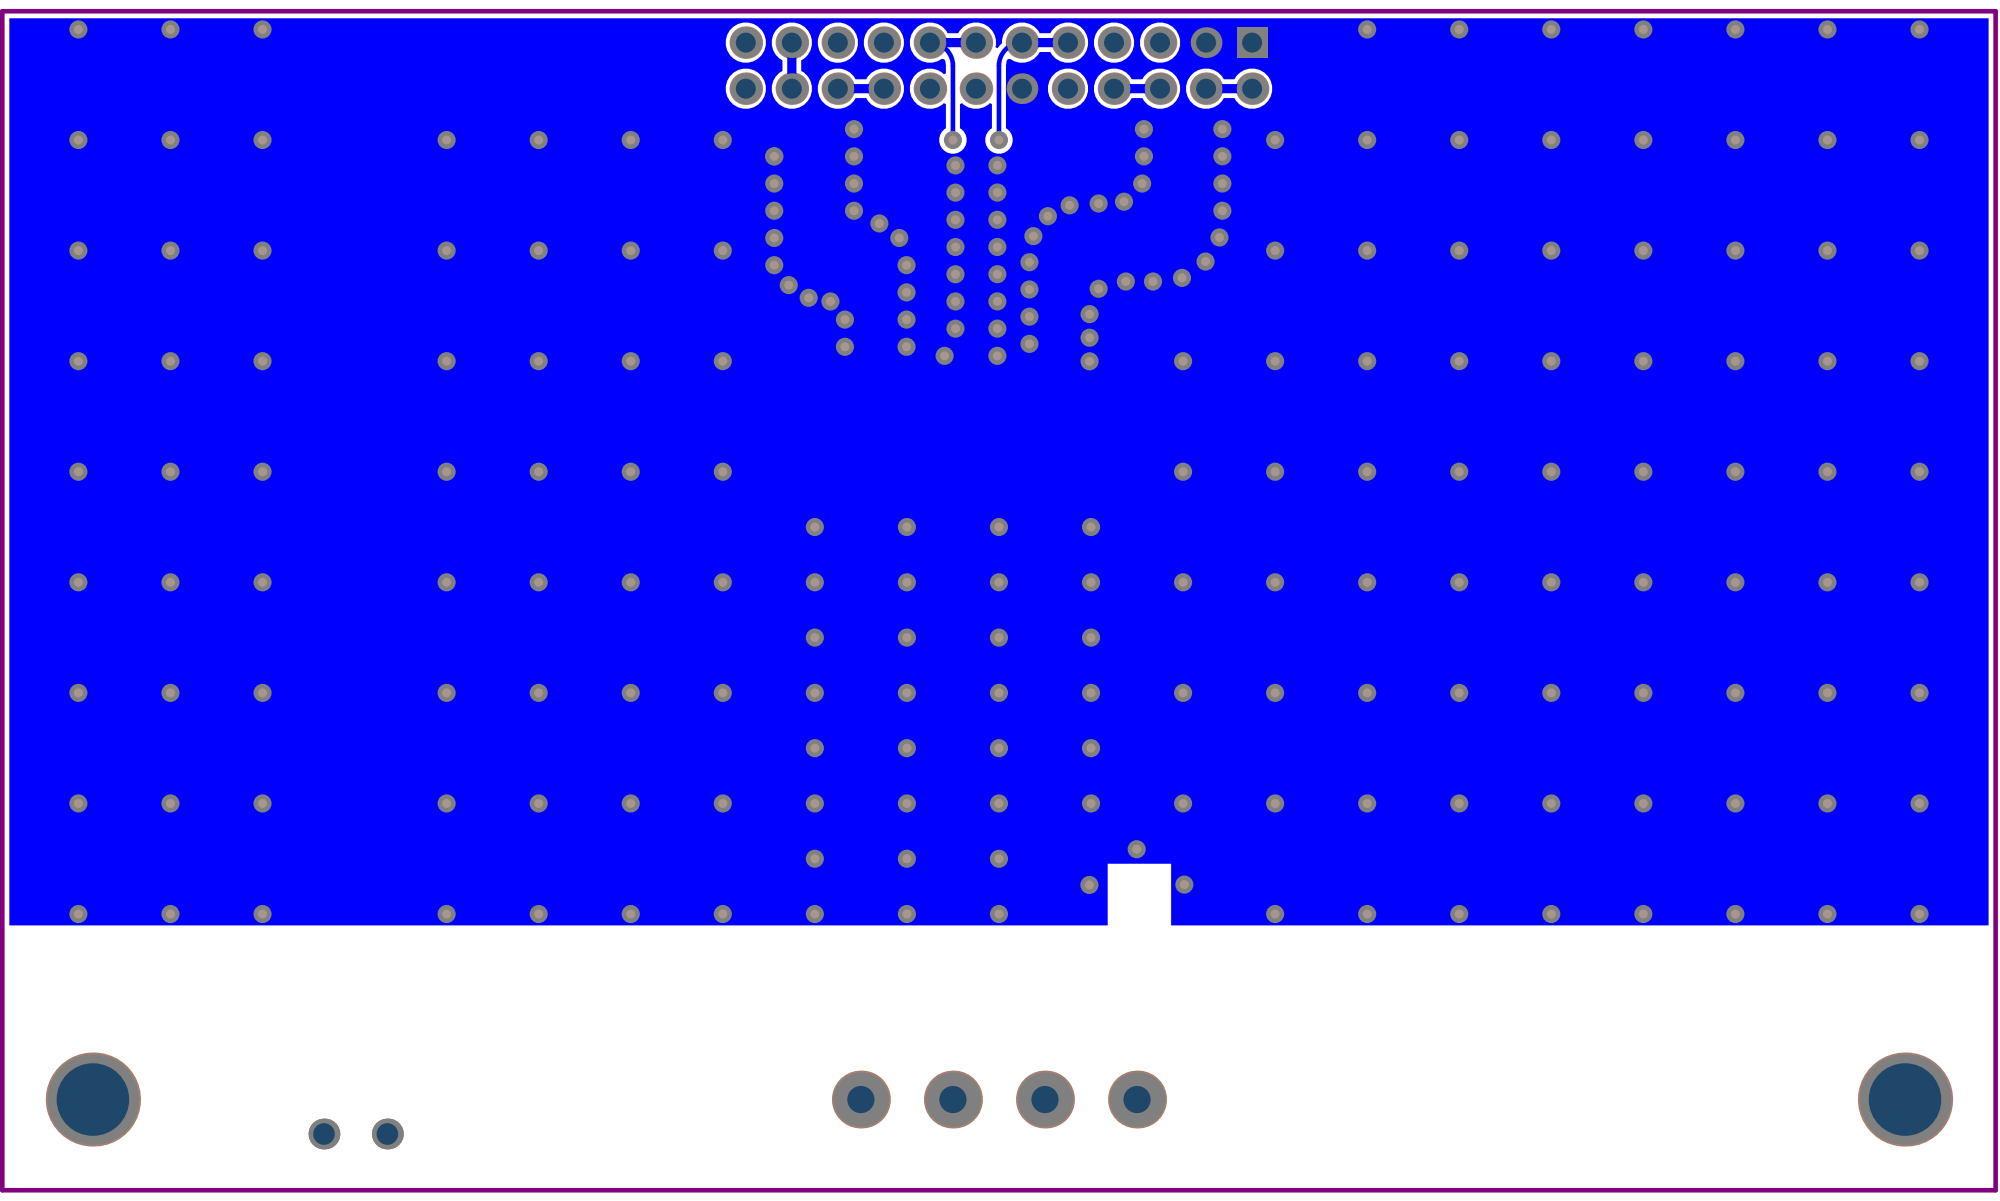
[picture p201: page 5]

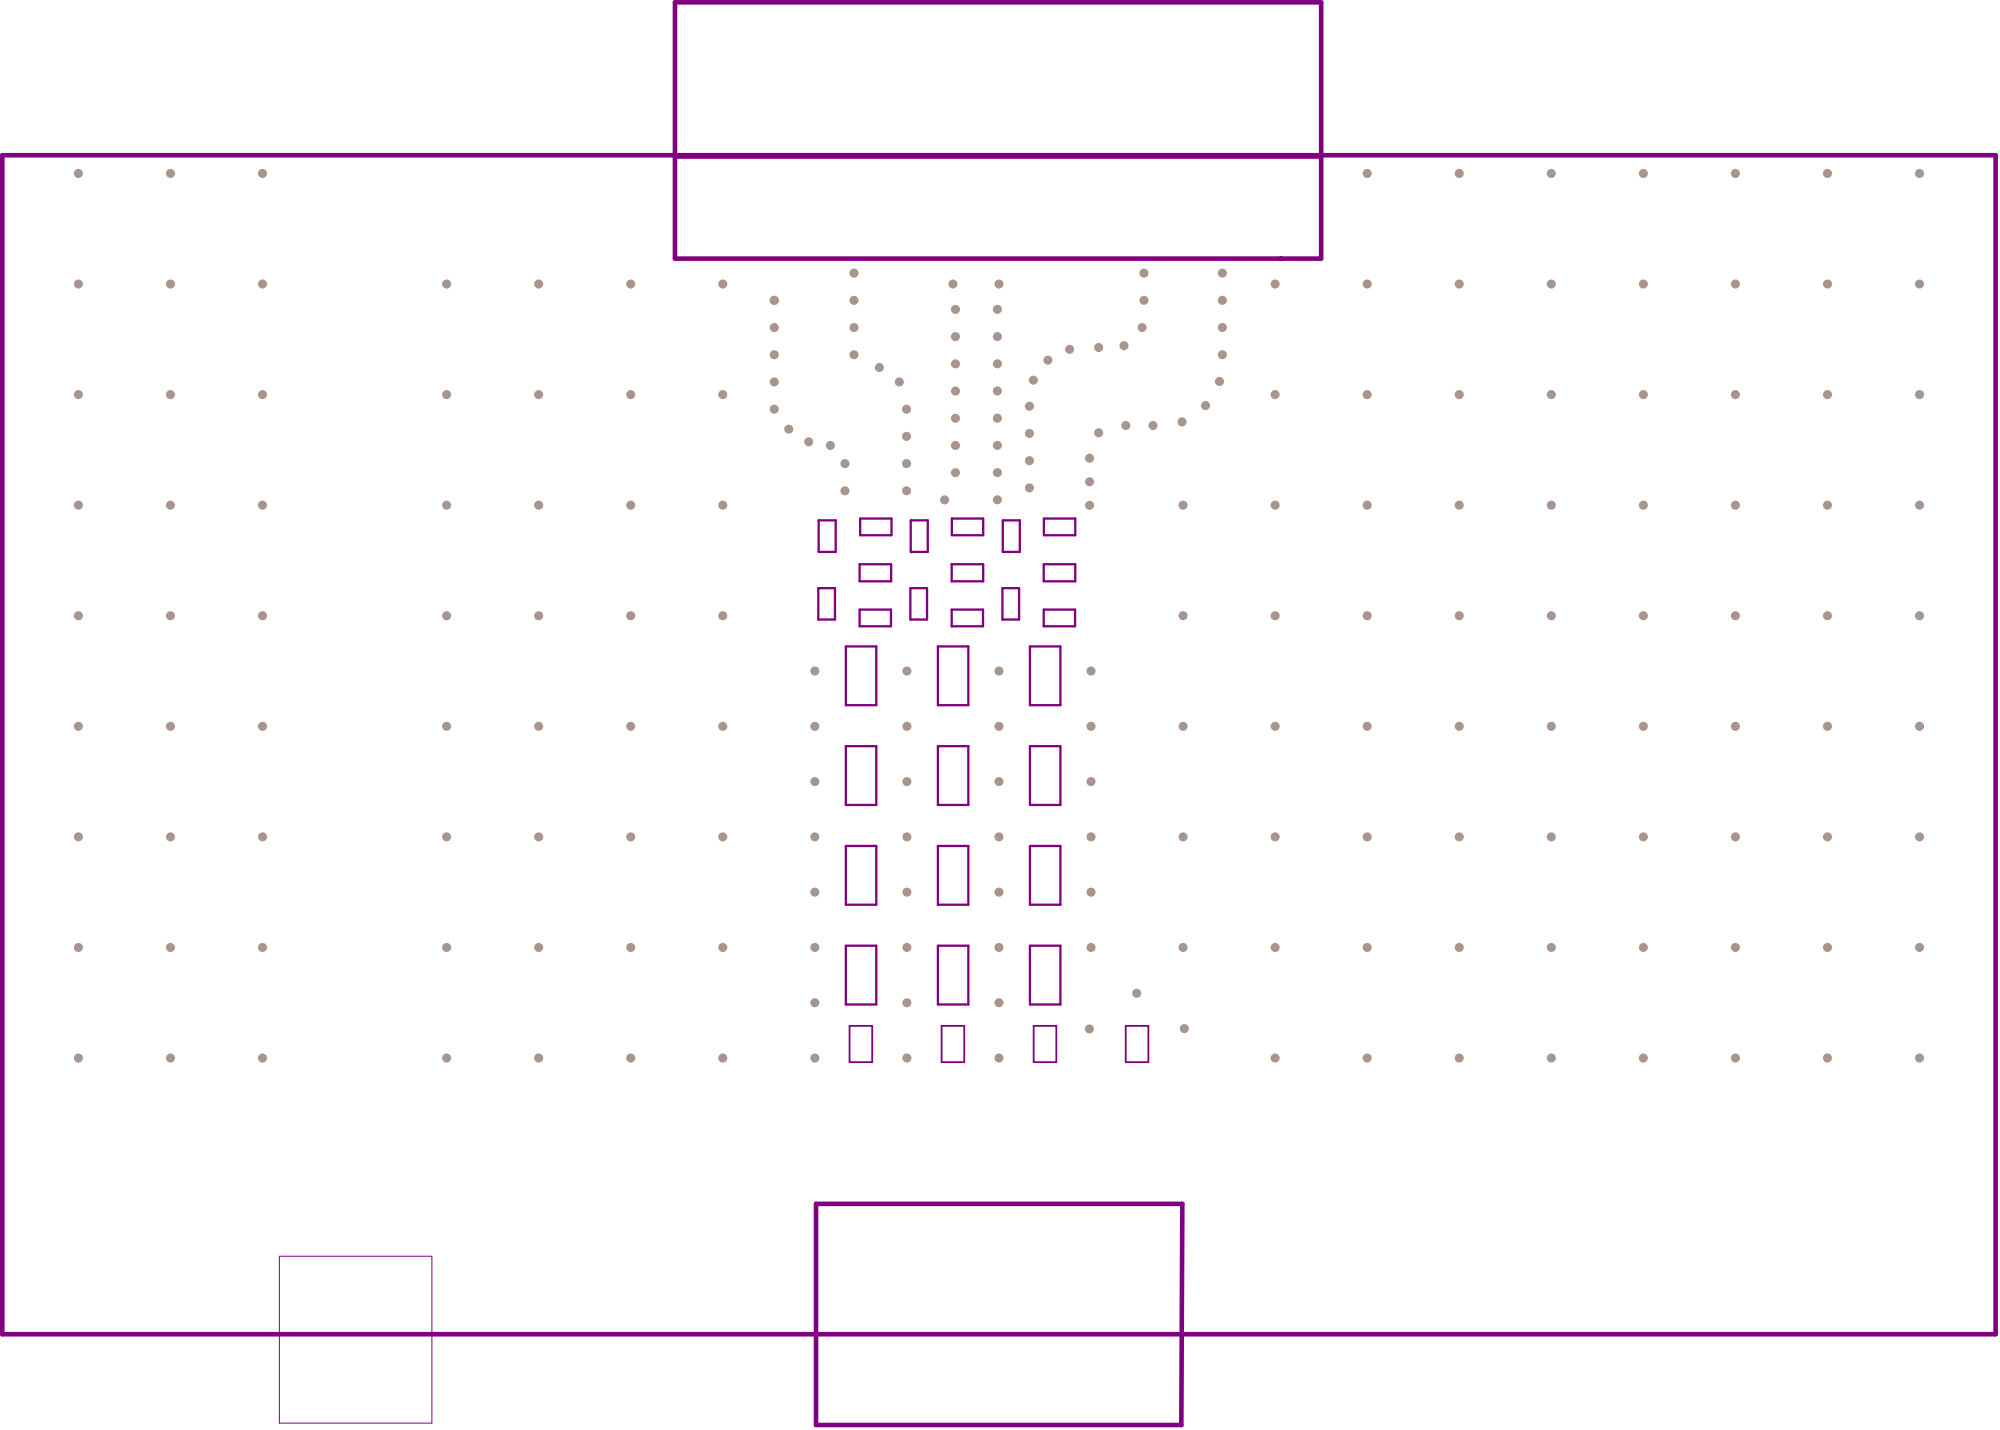
[picture p202: page 6]

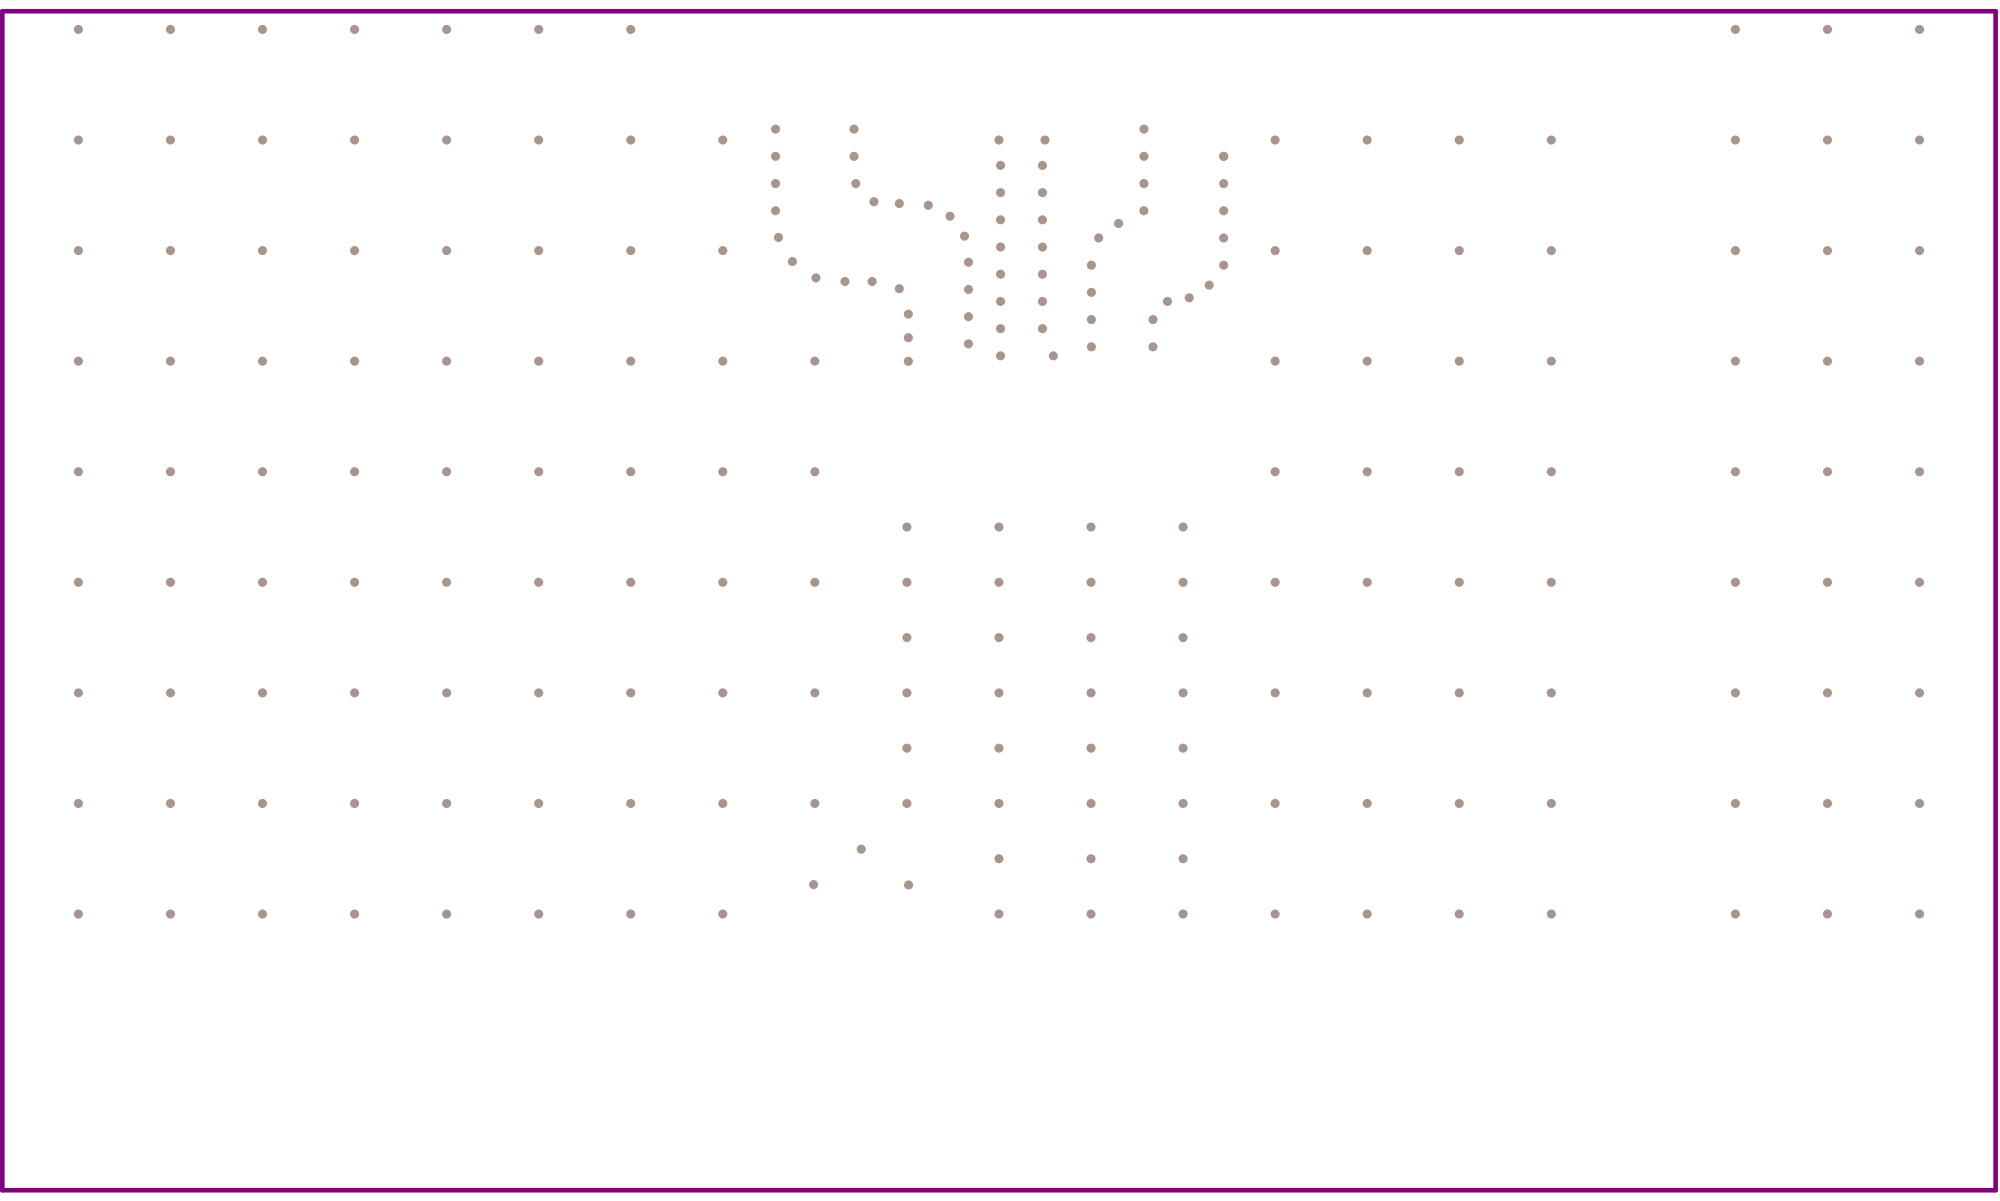
[picture p203: page 7]

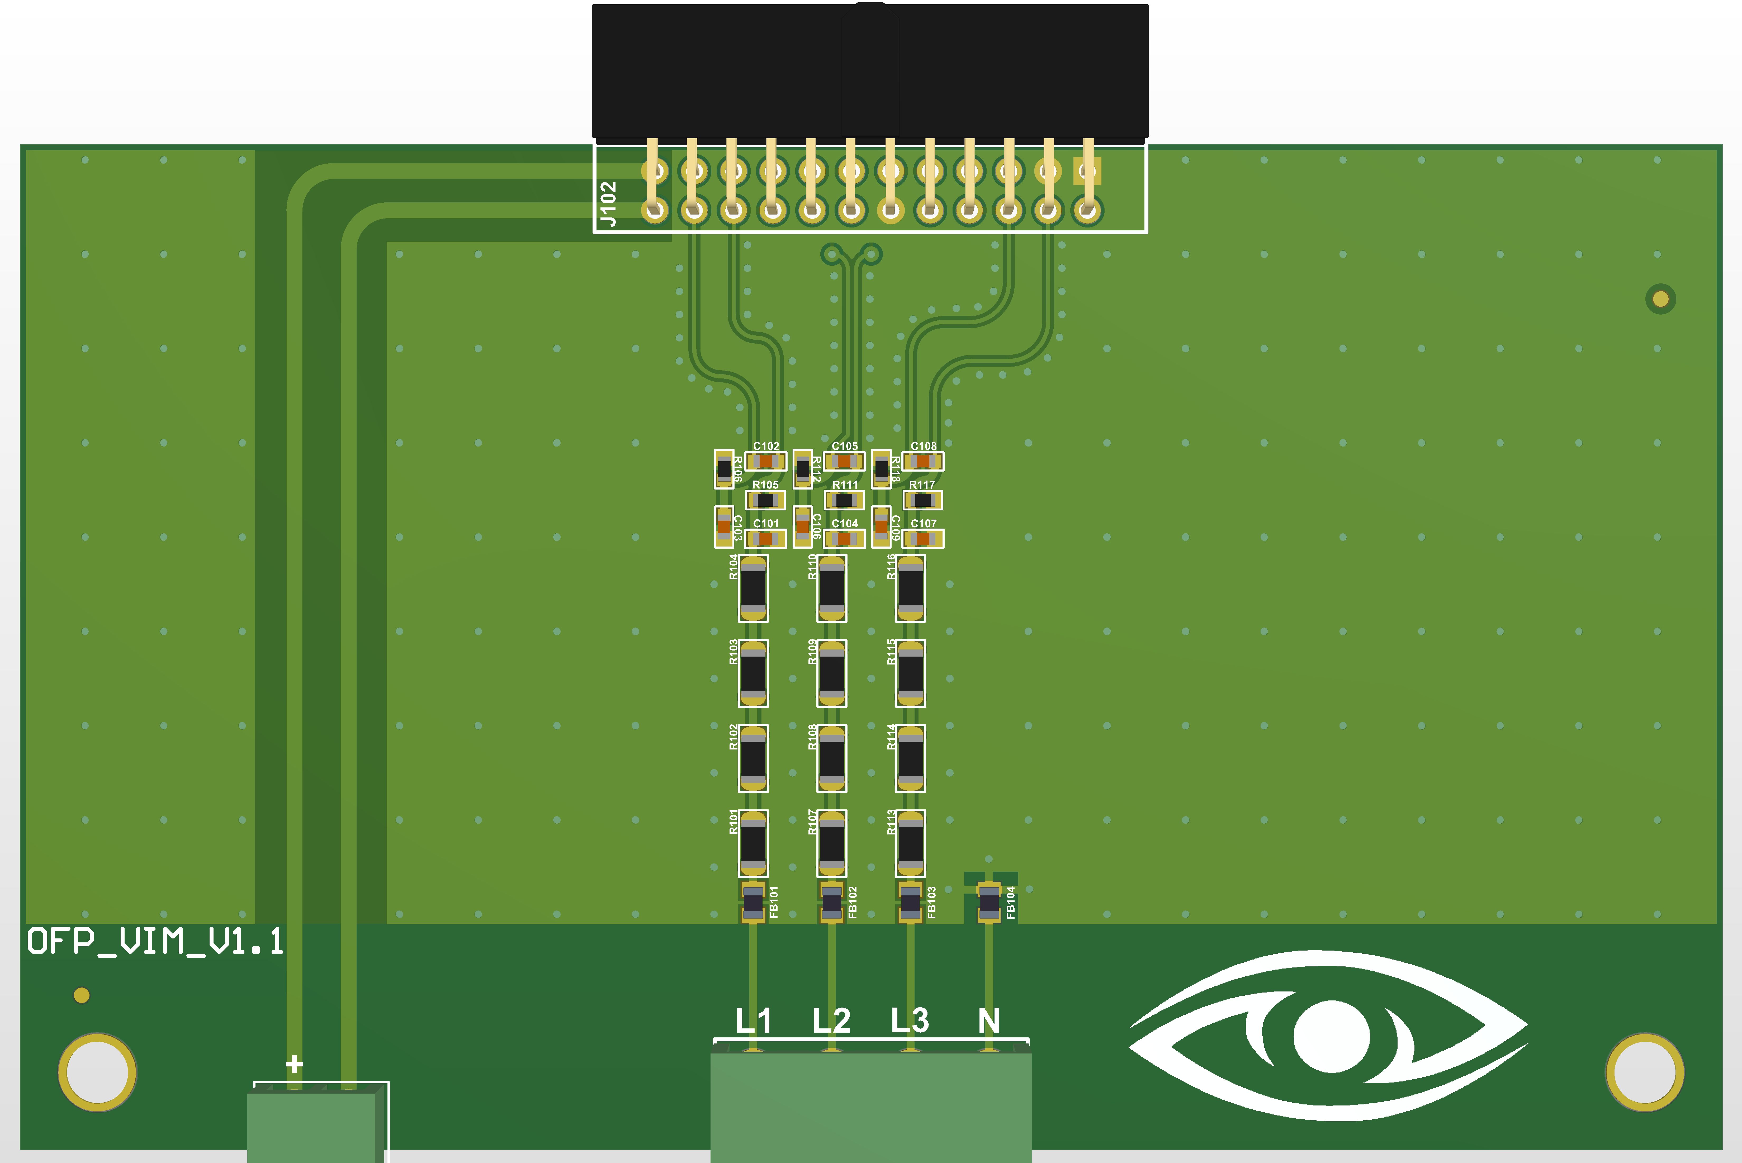
[picture p204: page 8]

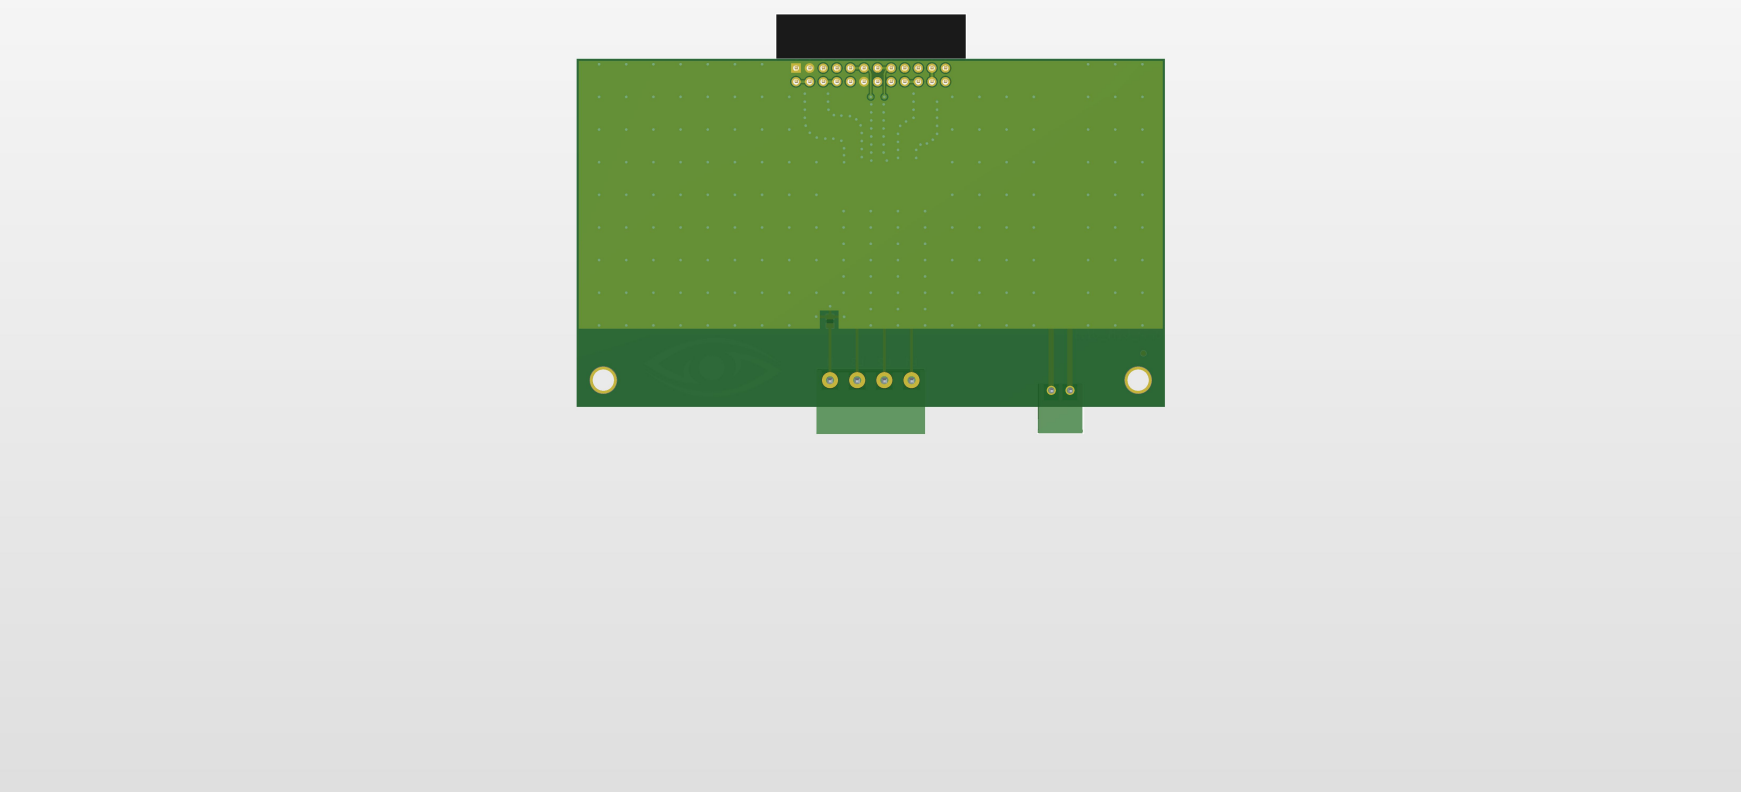
[picture p205: page 9]
