eSpark-Backup/nabilfesal-smartmeter-hw/Design-Files/OFP_SCM_v1.5/Deliverables/Assembly Drawings/OFP_SCM_v1.5.pdf

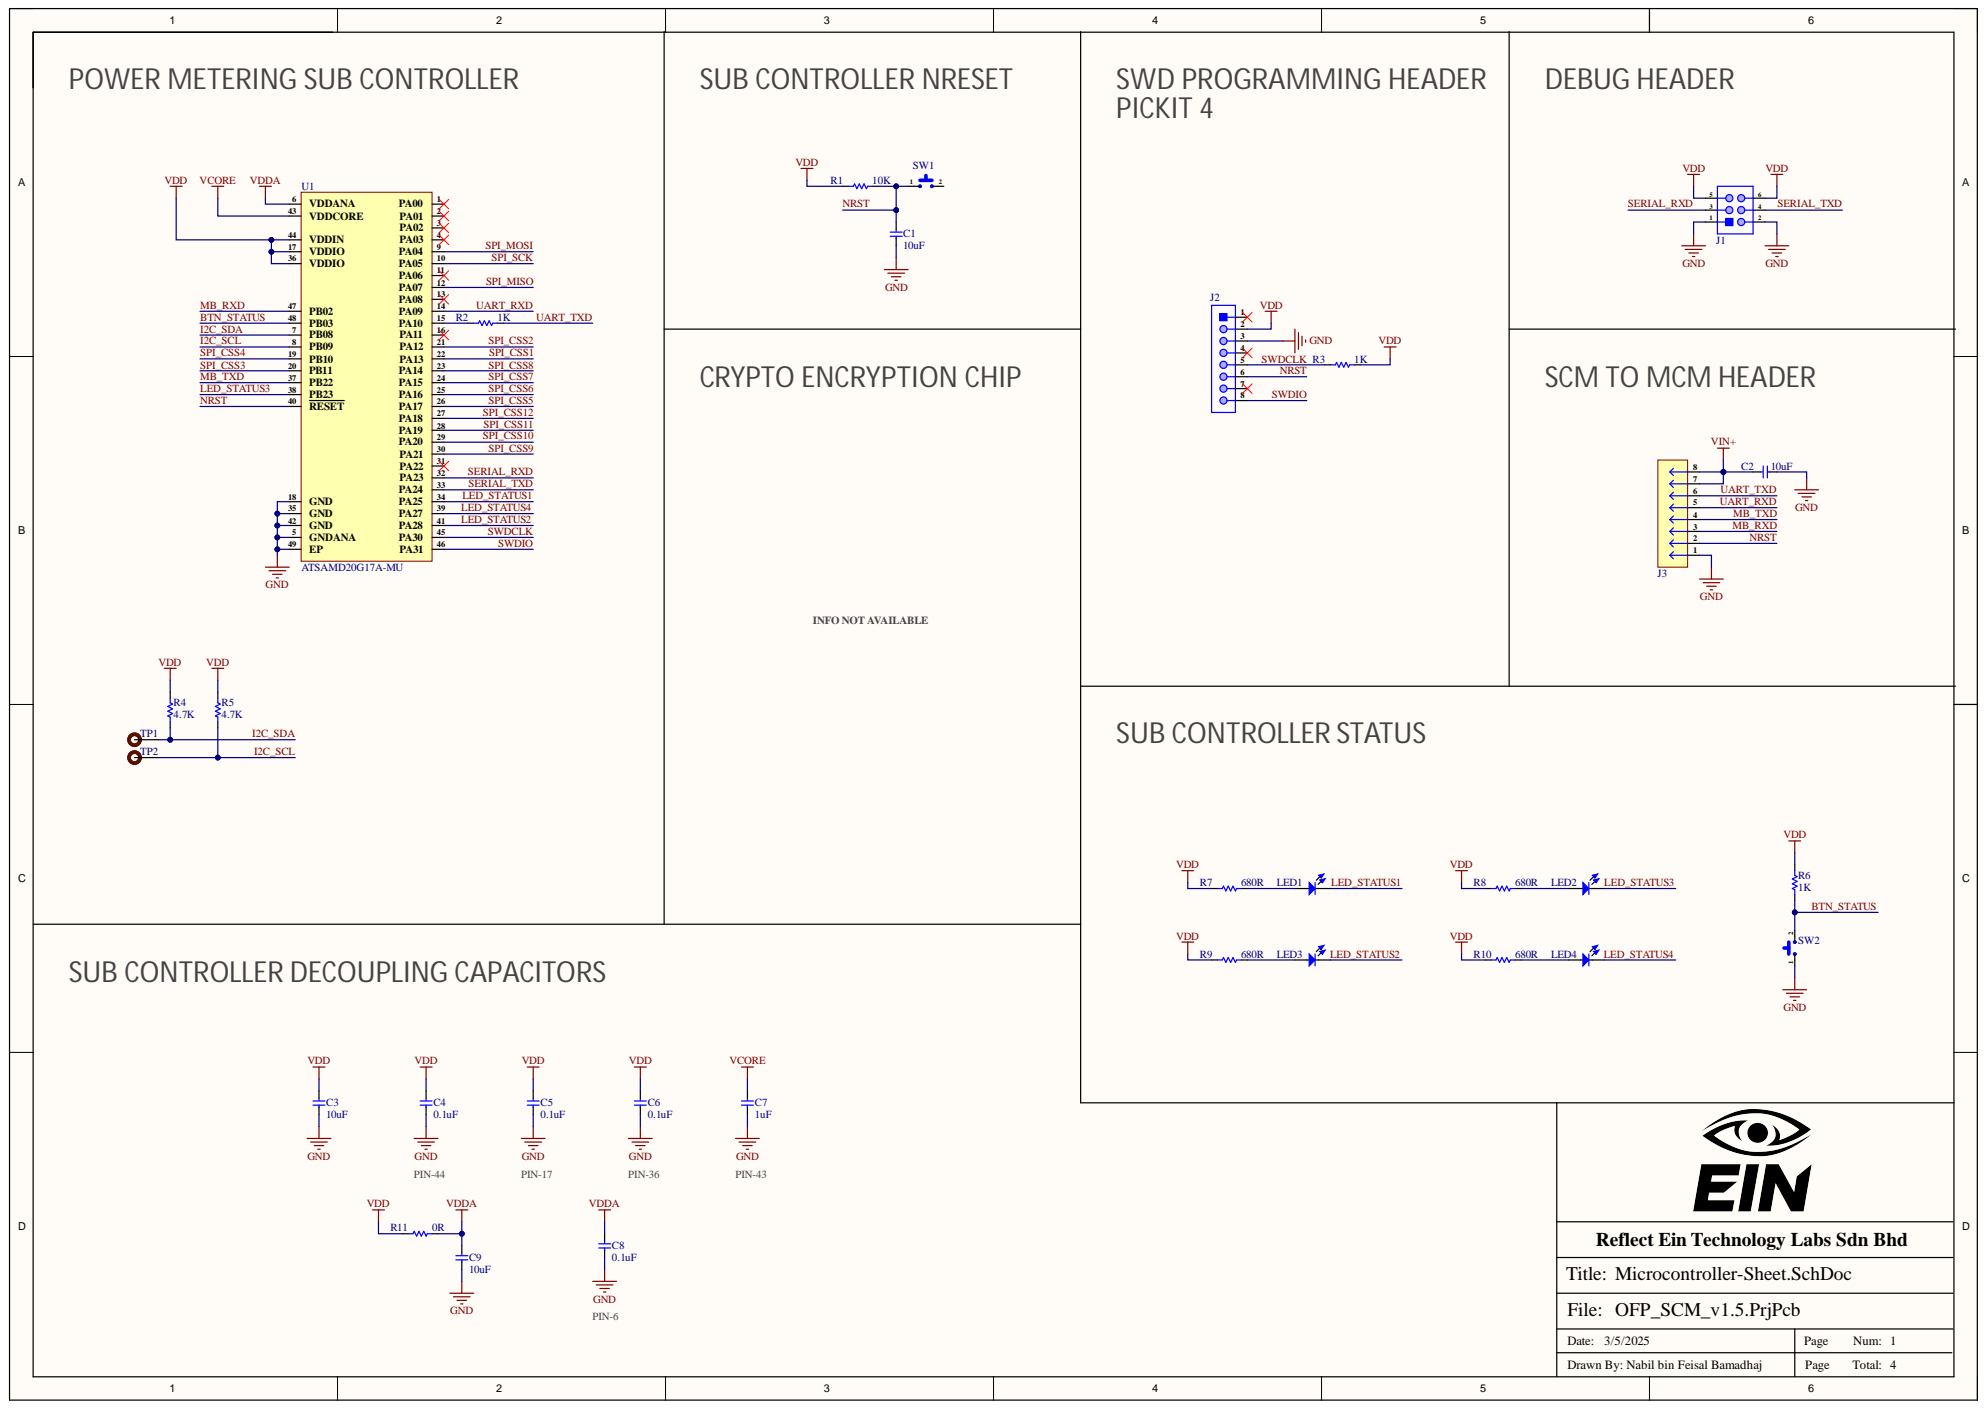
[picture p206: page 1]

POWER METERING SUB CONTROLLER

SUB CONTROLLER DECOUPLING CAPACITORS

Reflect Ein Technology Labs Sdn Bhd

Date: 3/5/2025 | Page Num: 1

Drawn By: Nabil bin Feisal Bamadhaj | Page Total:

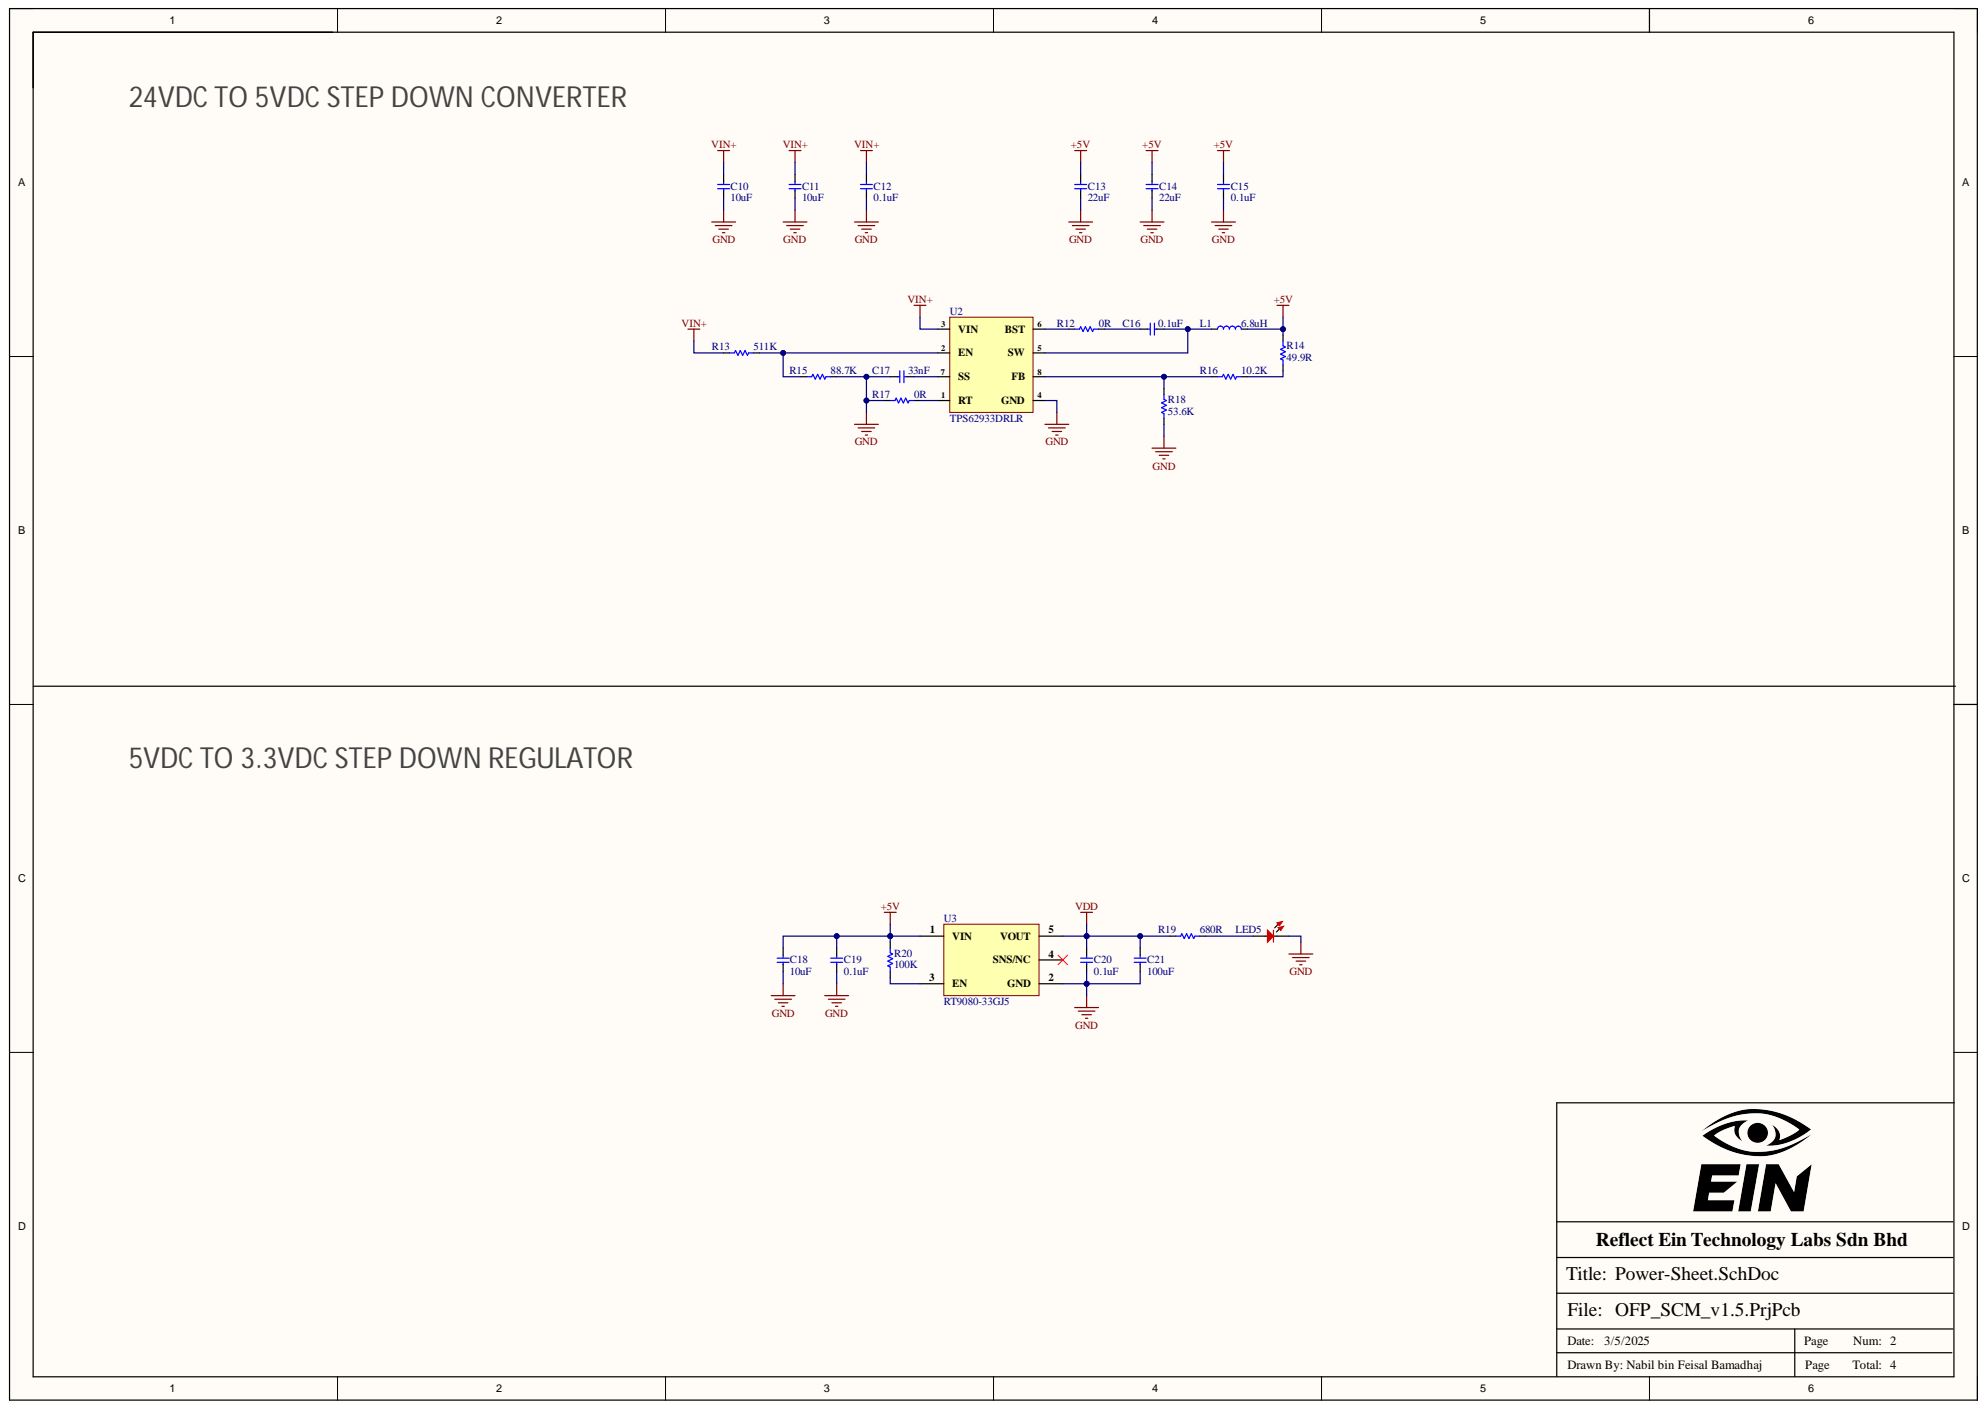
[picture p207: page 2]

24VDC TO 5VDC STEP DOWN CONVERTER

5VDC TO 3.3VDC STEP DOWN REGULATOR

Reflect Ein Technology Labs Sdn Bhd

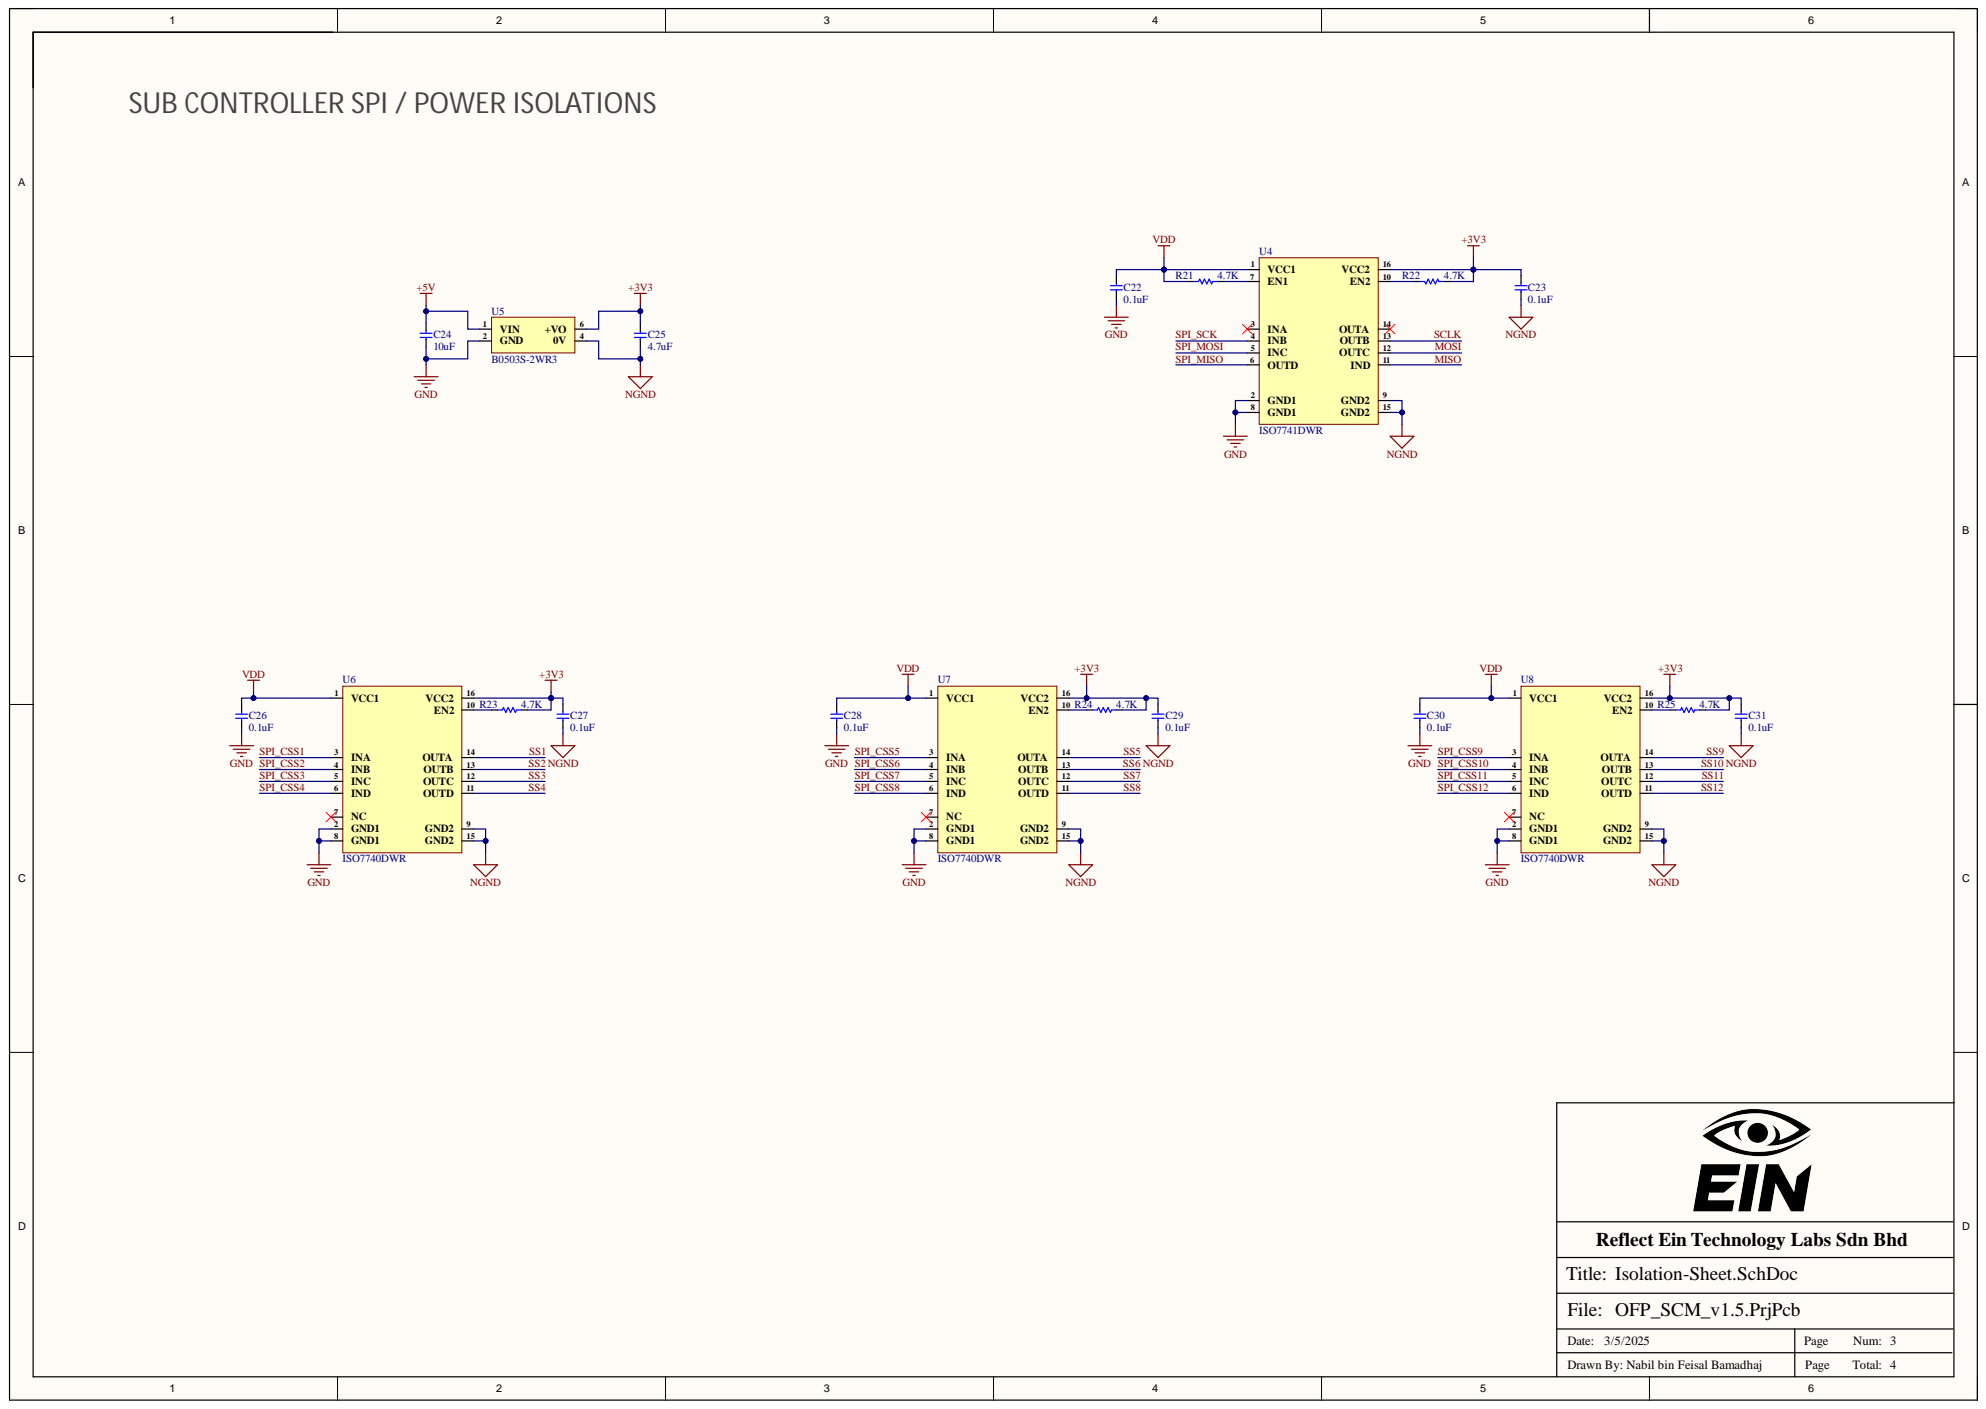
[picture p208: page 3]

SUB CONTROLLER SPI / POWER ISOLATIONS

Reflect Ein Technology Labs Sdn Bhd

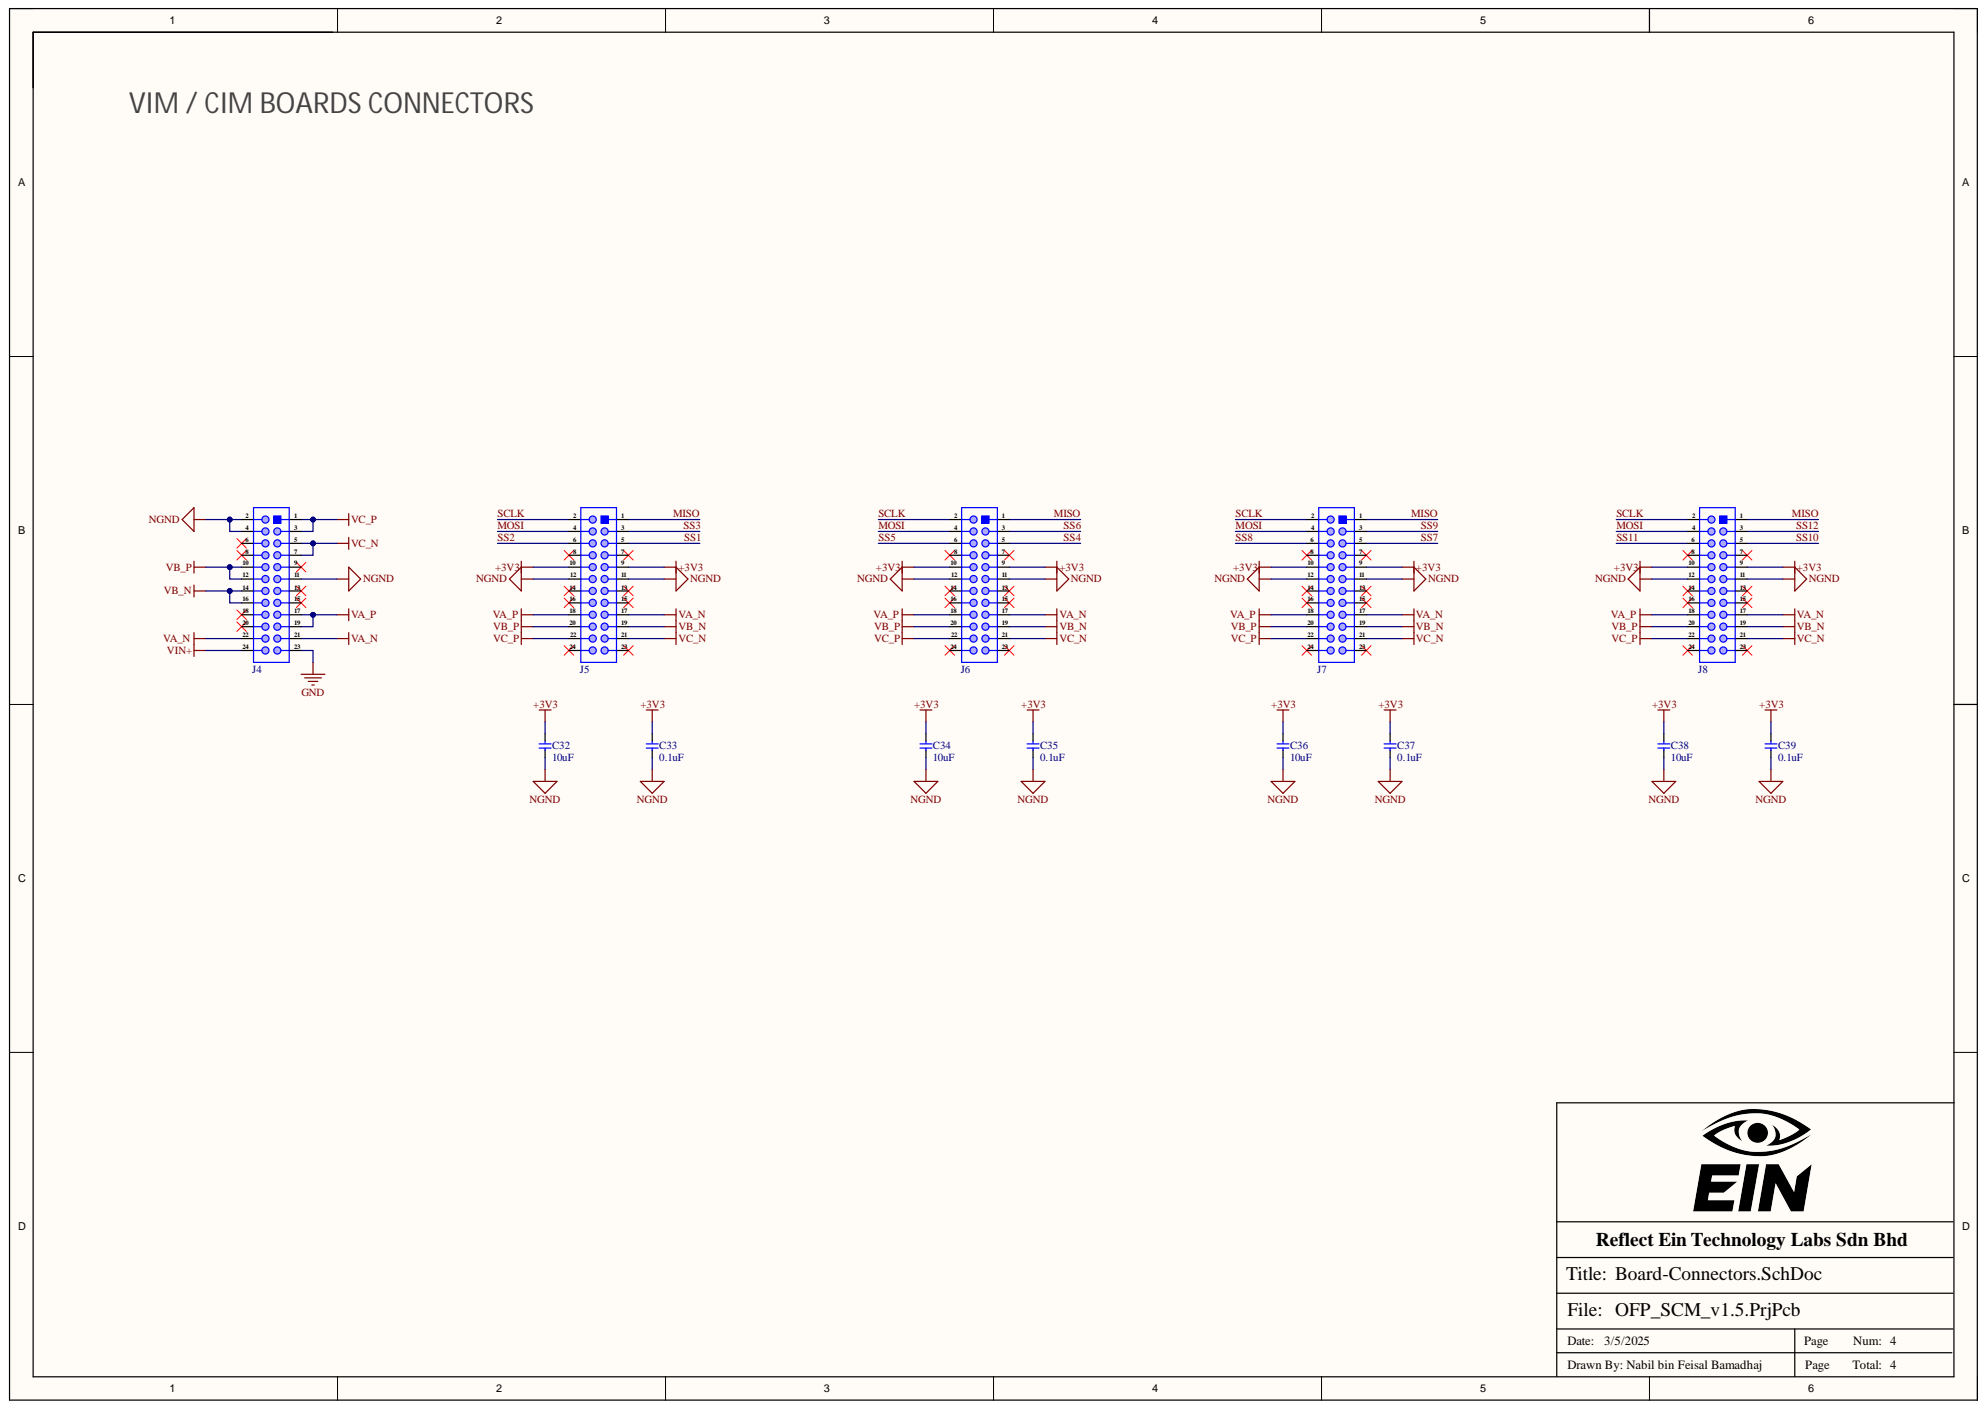
[picture p209: page 4]

VIM / CIM BOARDS CONNECTORS

Reflect Ein Technology Labs Sdn Bhd

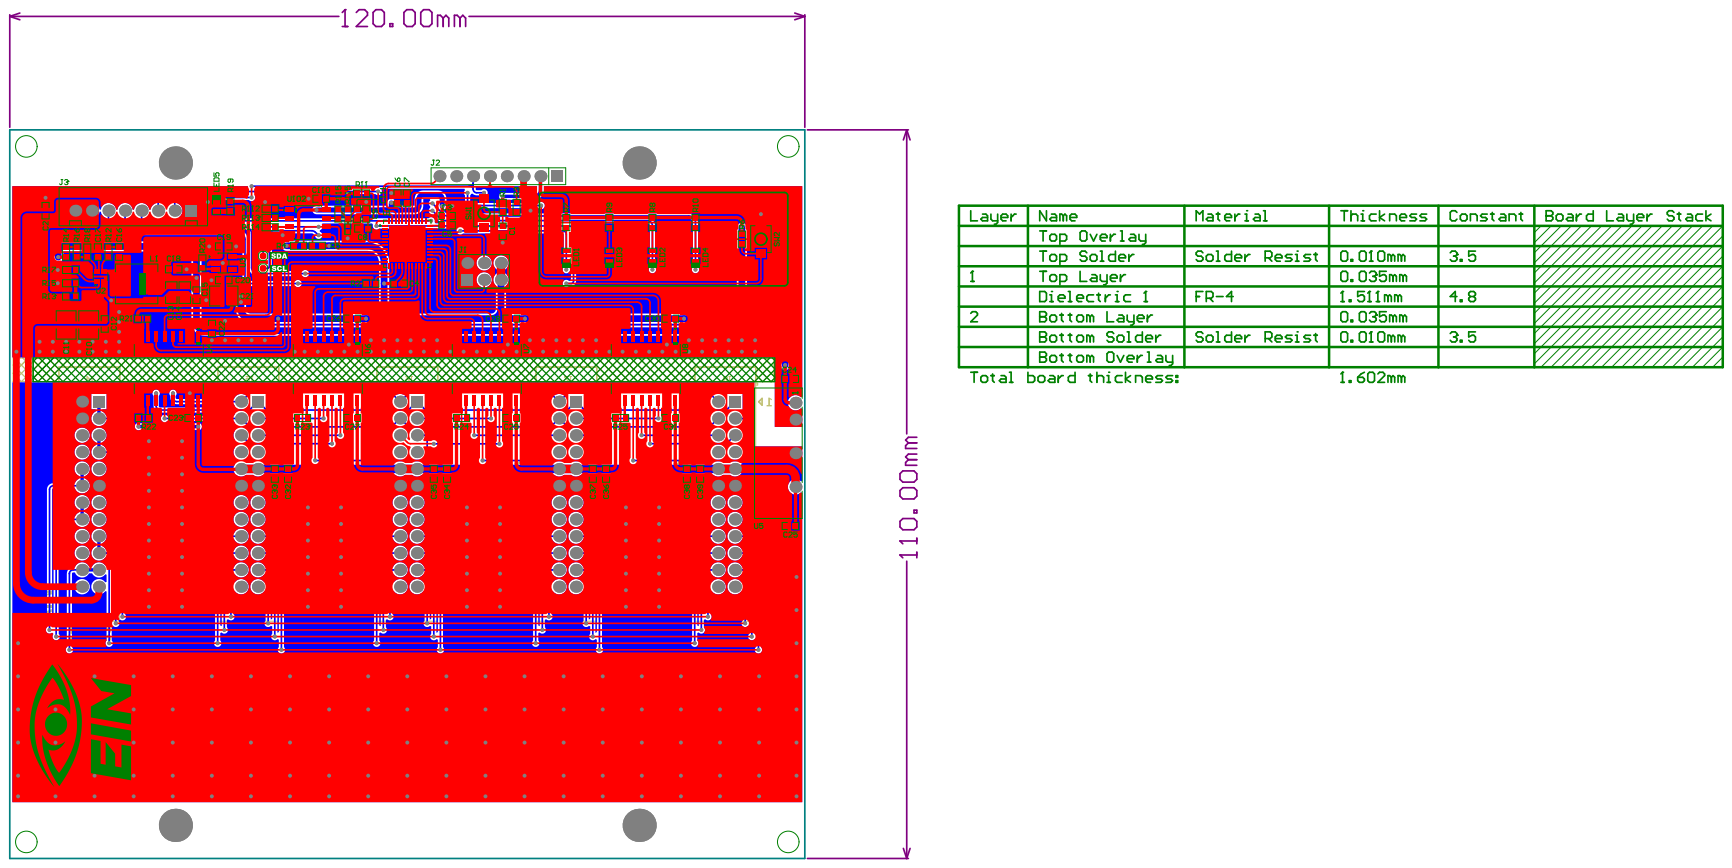
[picture p210: page 5]
