eSpark-Backup/nabilfesal-smartmeter-hw/Design-Files/OFP_SCM_v1.5/Schematic/OFP_SCM_v1.5.pdf

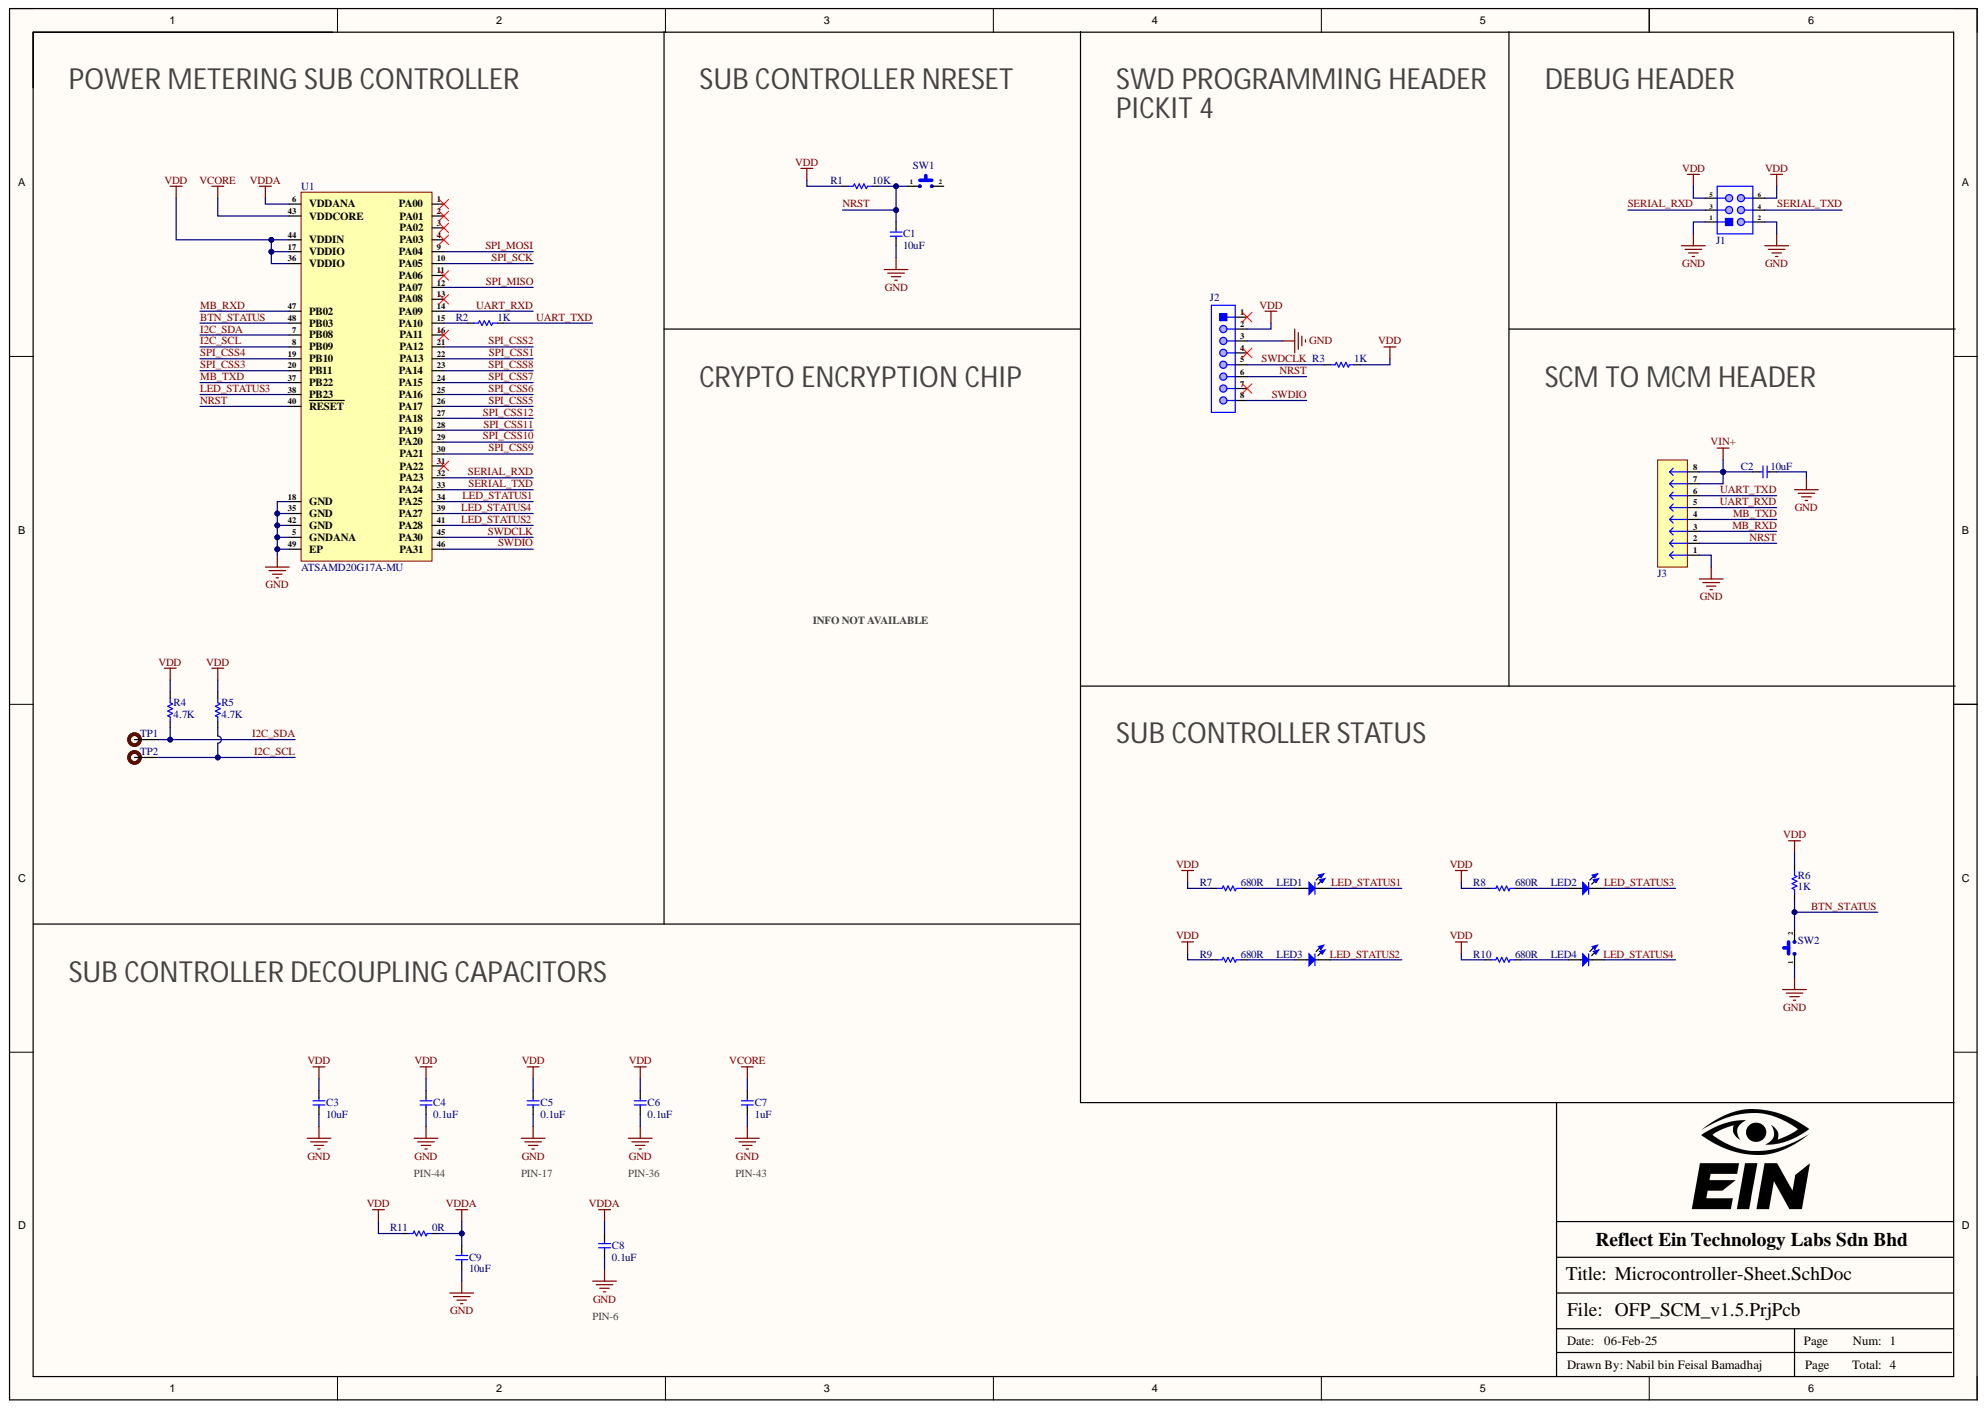
[picture p216: page 1]

POWER METERING SUB CONTROLLER

SUB CONTROLLER DECOUPLING CAPACITORS

Reflect Ein Technology Labs Sdn Bhd

Date: 06-Feb-25 | Page Num: 1

Drawn By: Nabil bin Feisal Bamadhaj | Page Total:

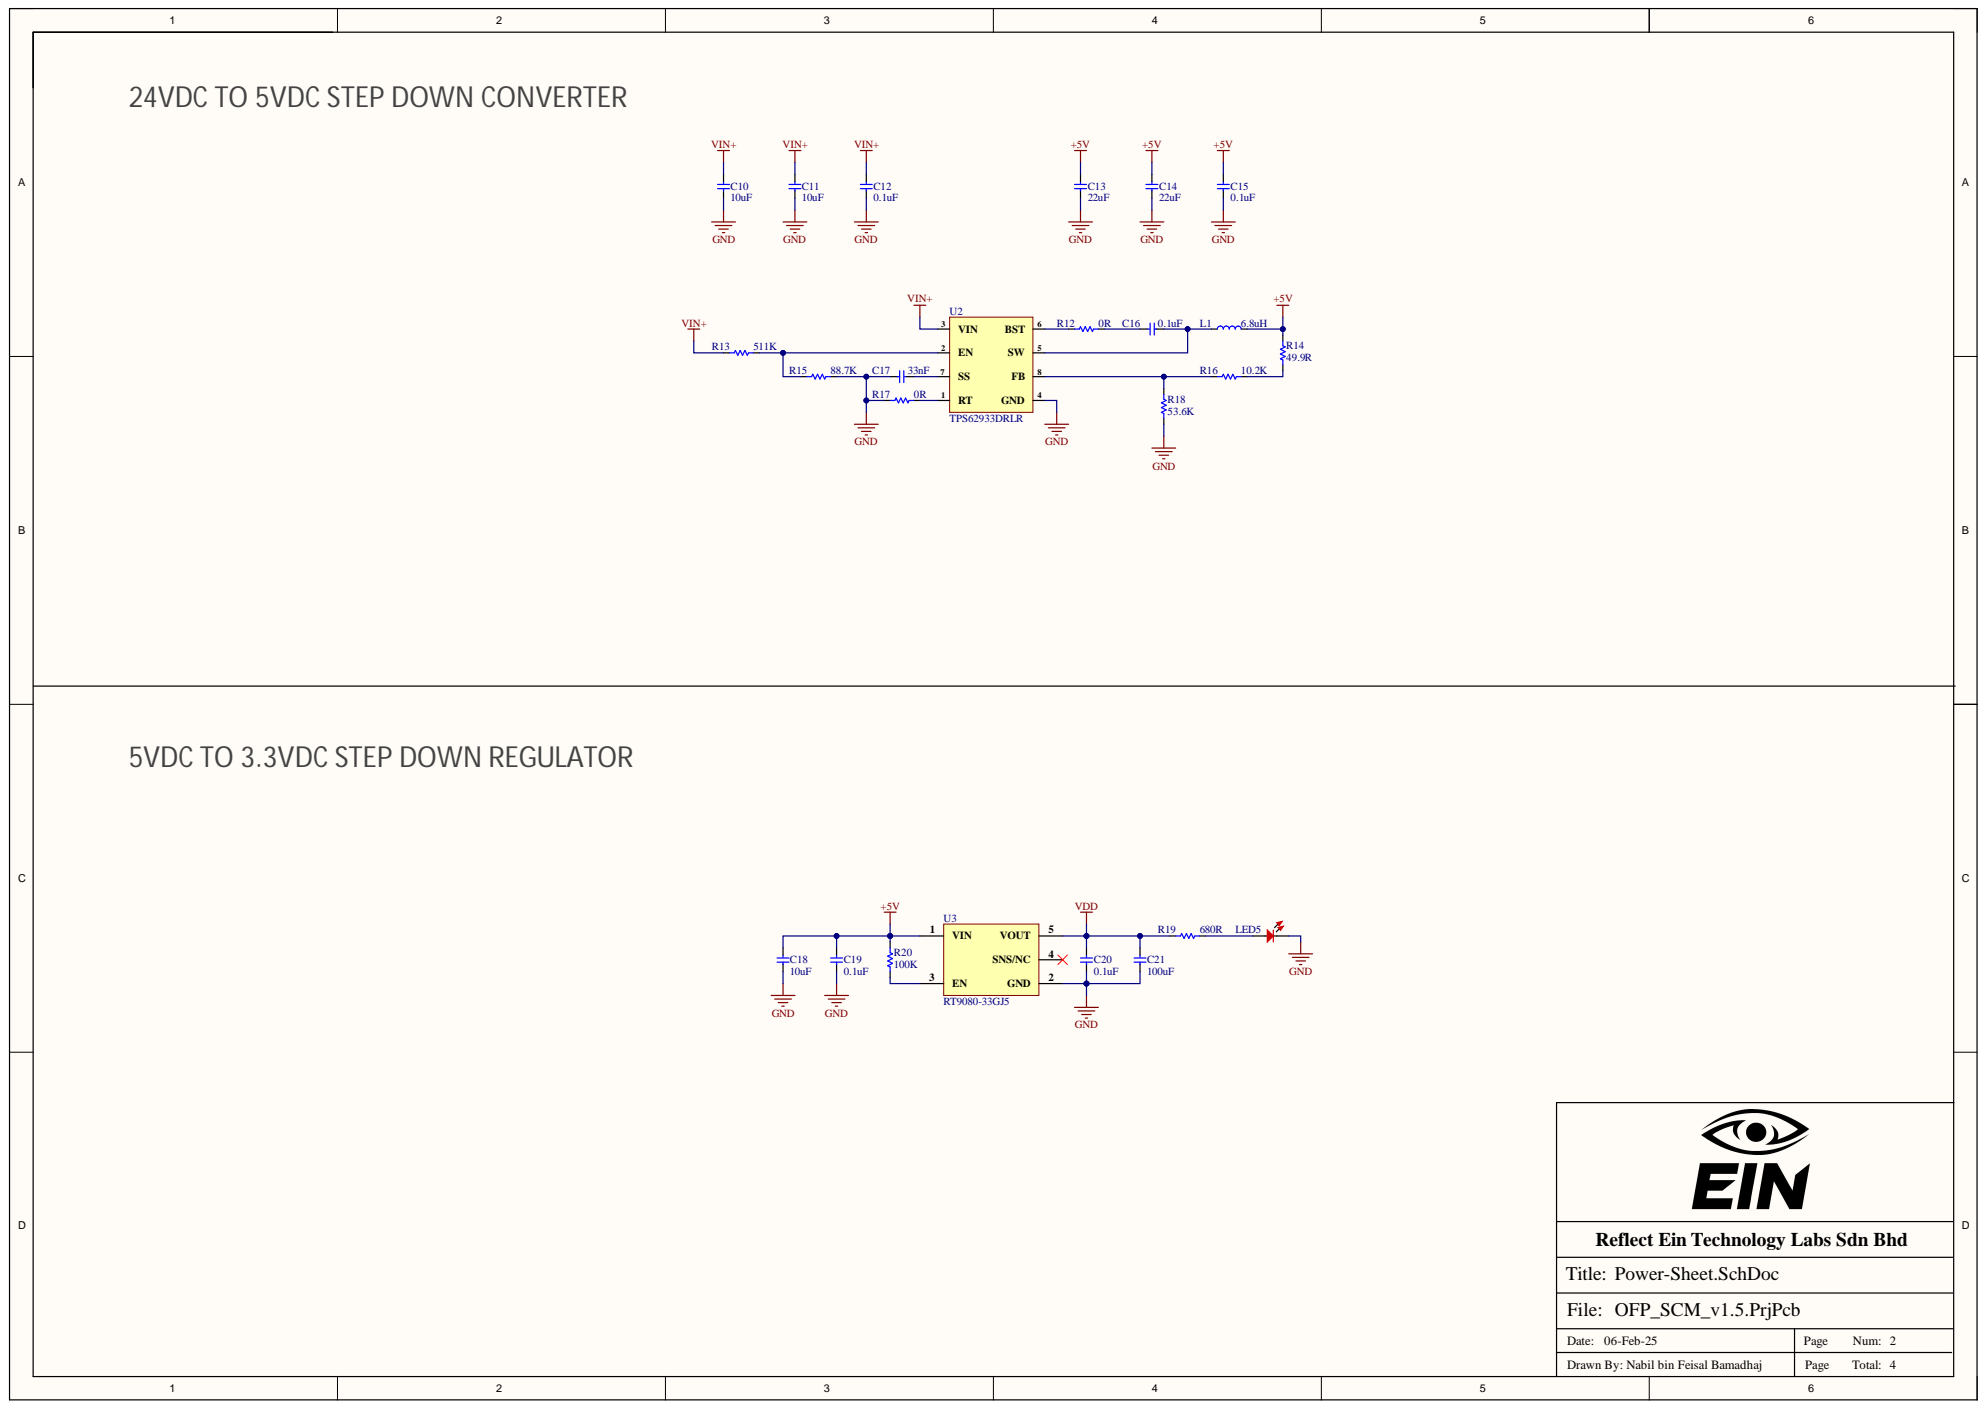
[picture p217: page 2]

24VDC TO 5VDC STEP DOWN CONVERTER

5VDC TO 3.3VDC STEP DOWN REGULATOR

Reflect Ein Technology Labs Sdn Bhd

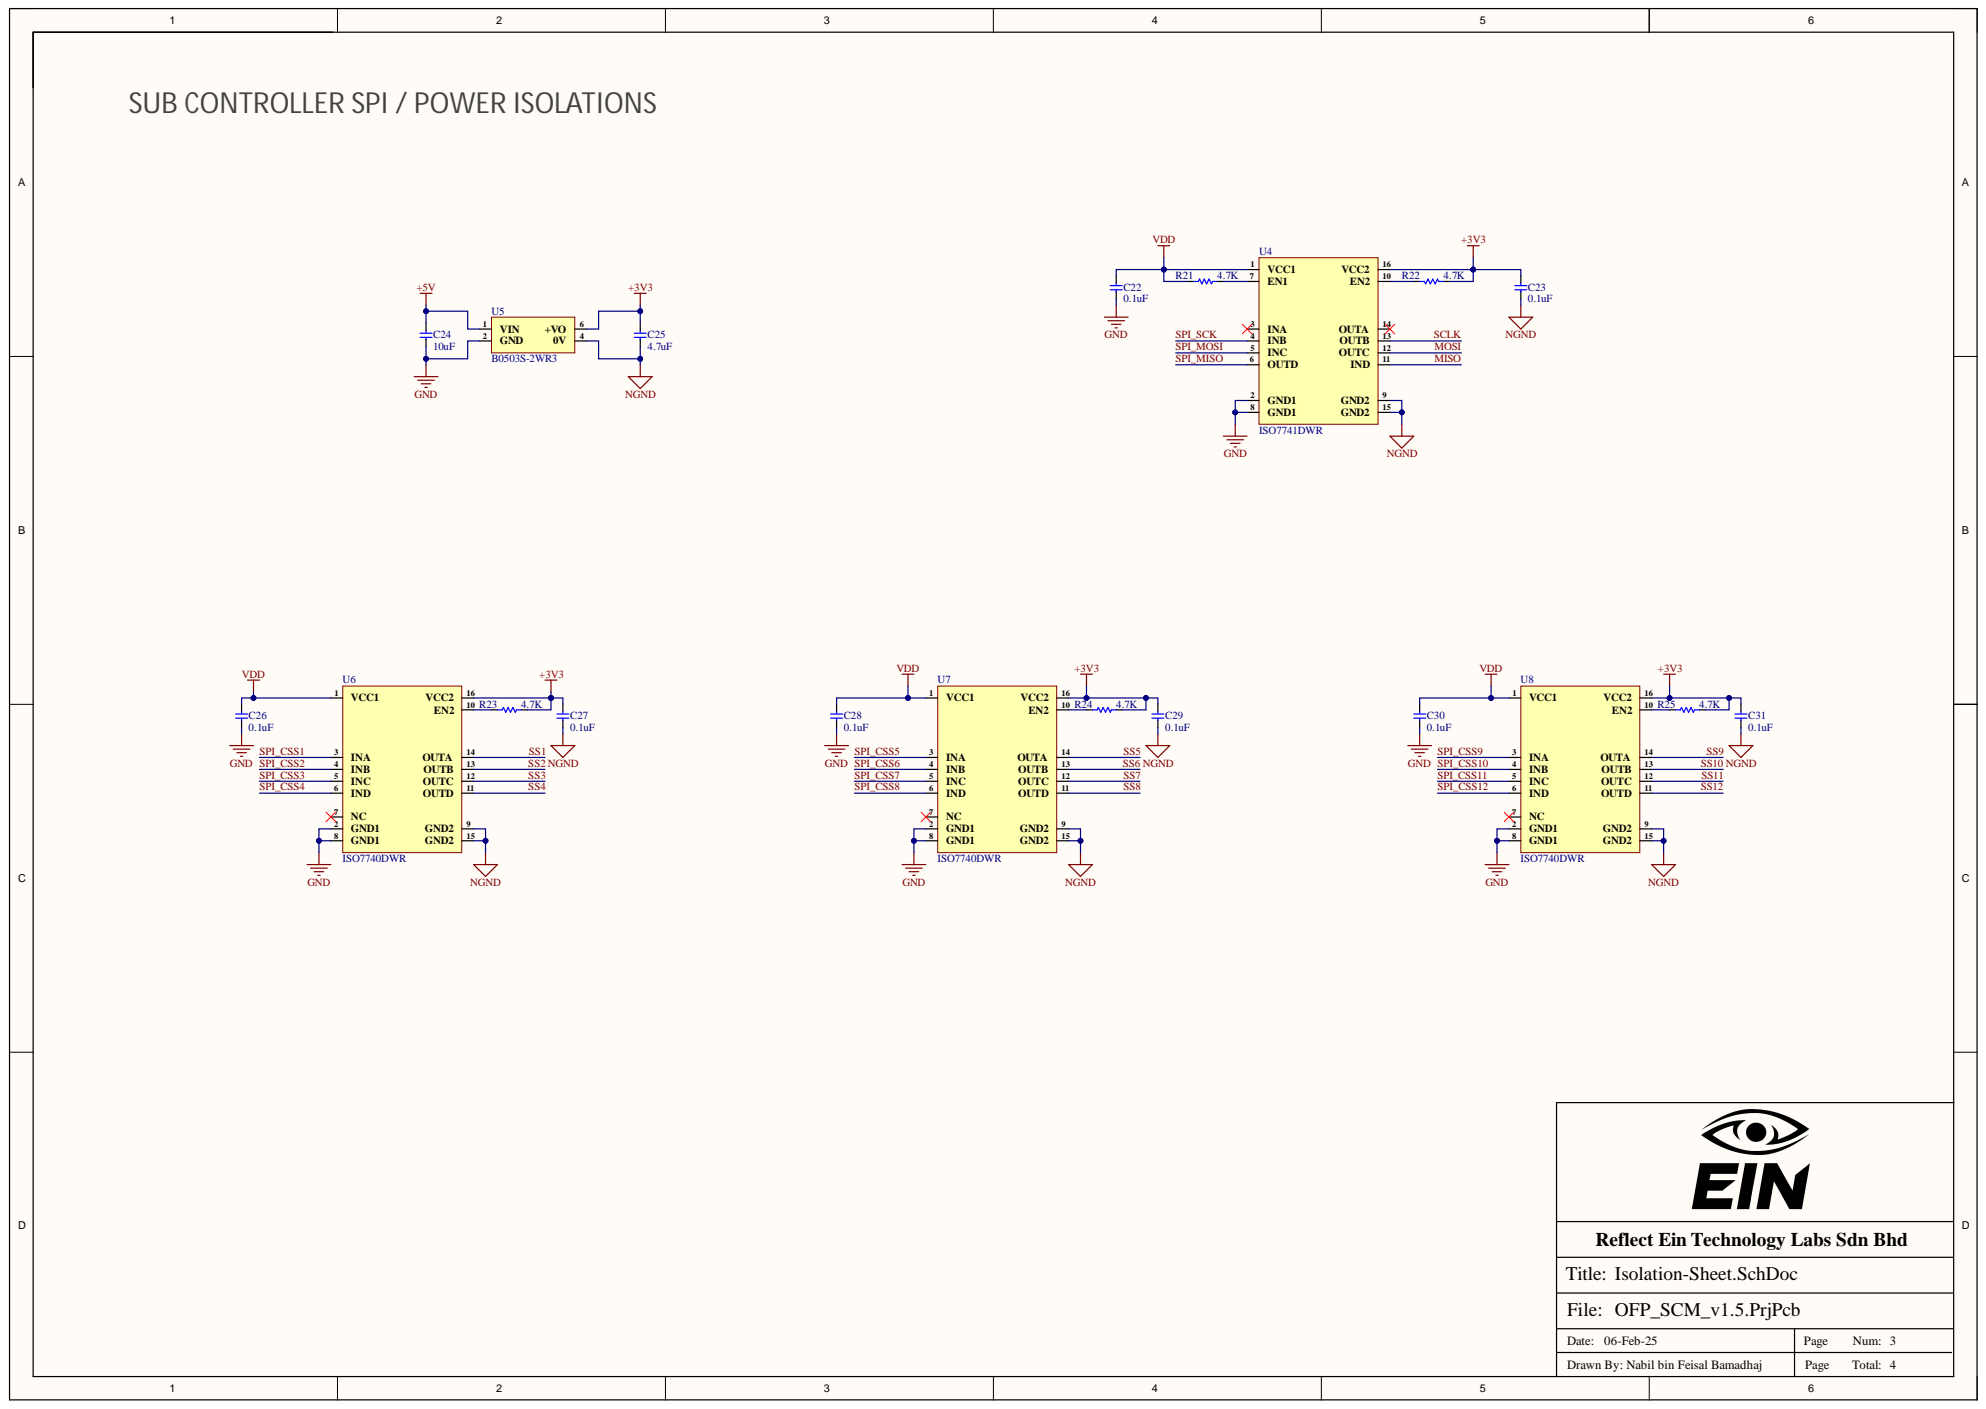
[picture p218: page 3]

SUB CONTROLLER SPI / POWER ISOLATIONS

Reflect Ein Technology Labs Sdn Bhd

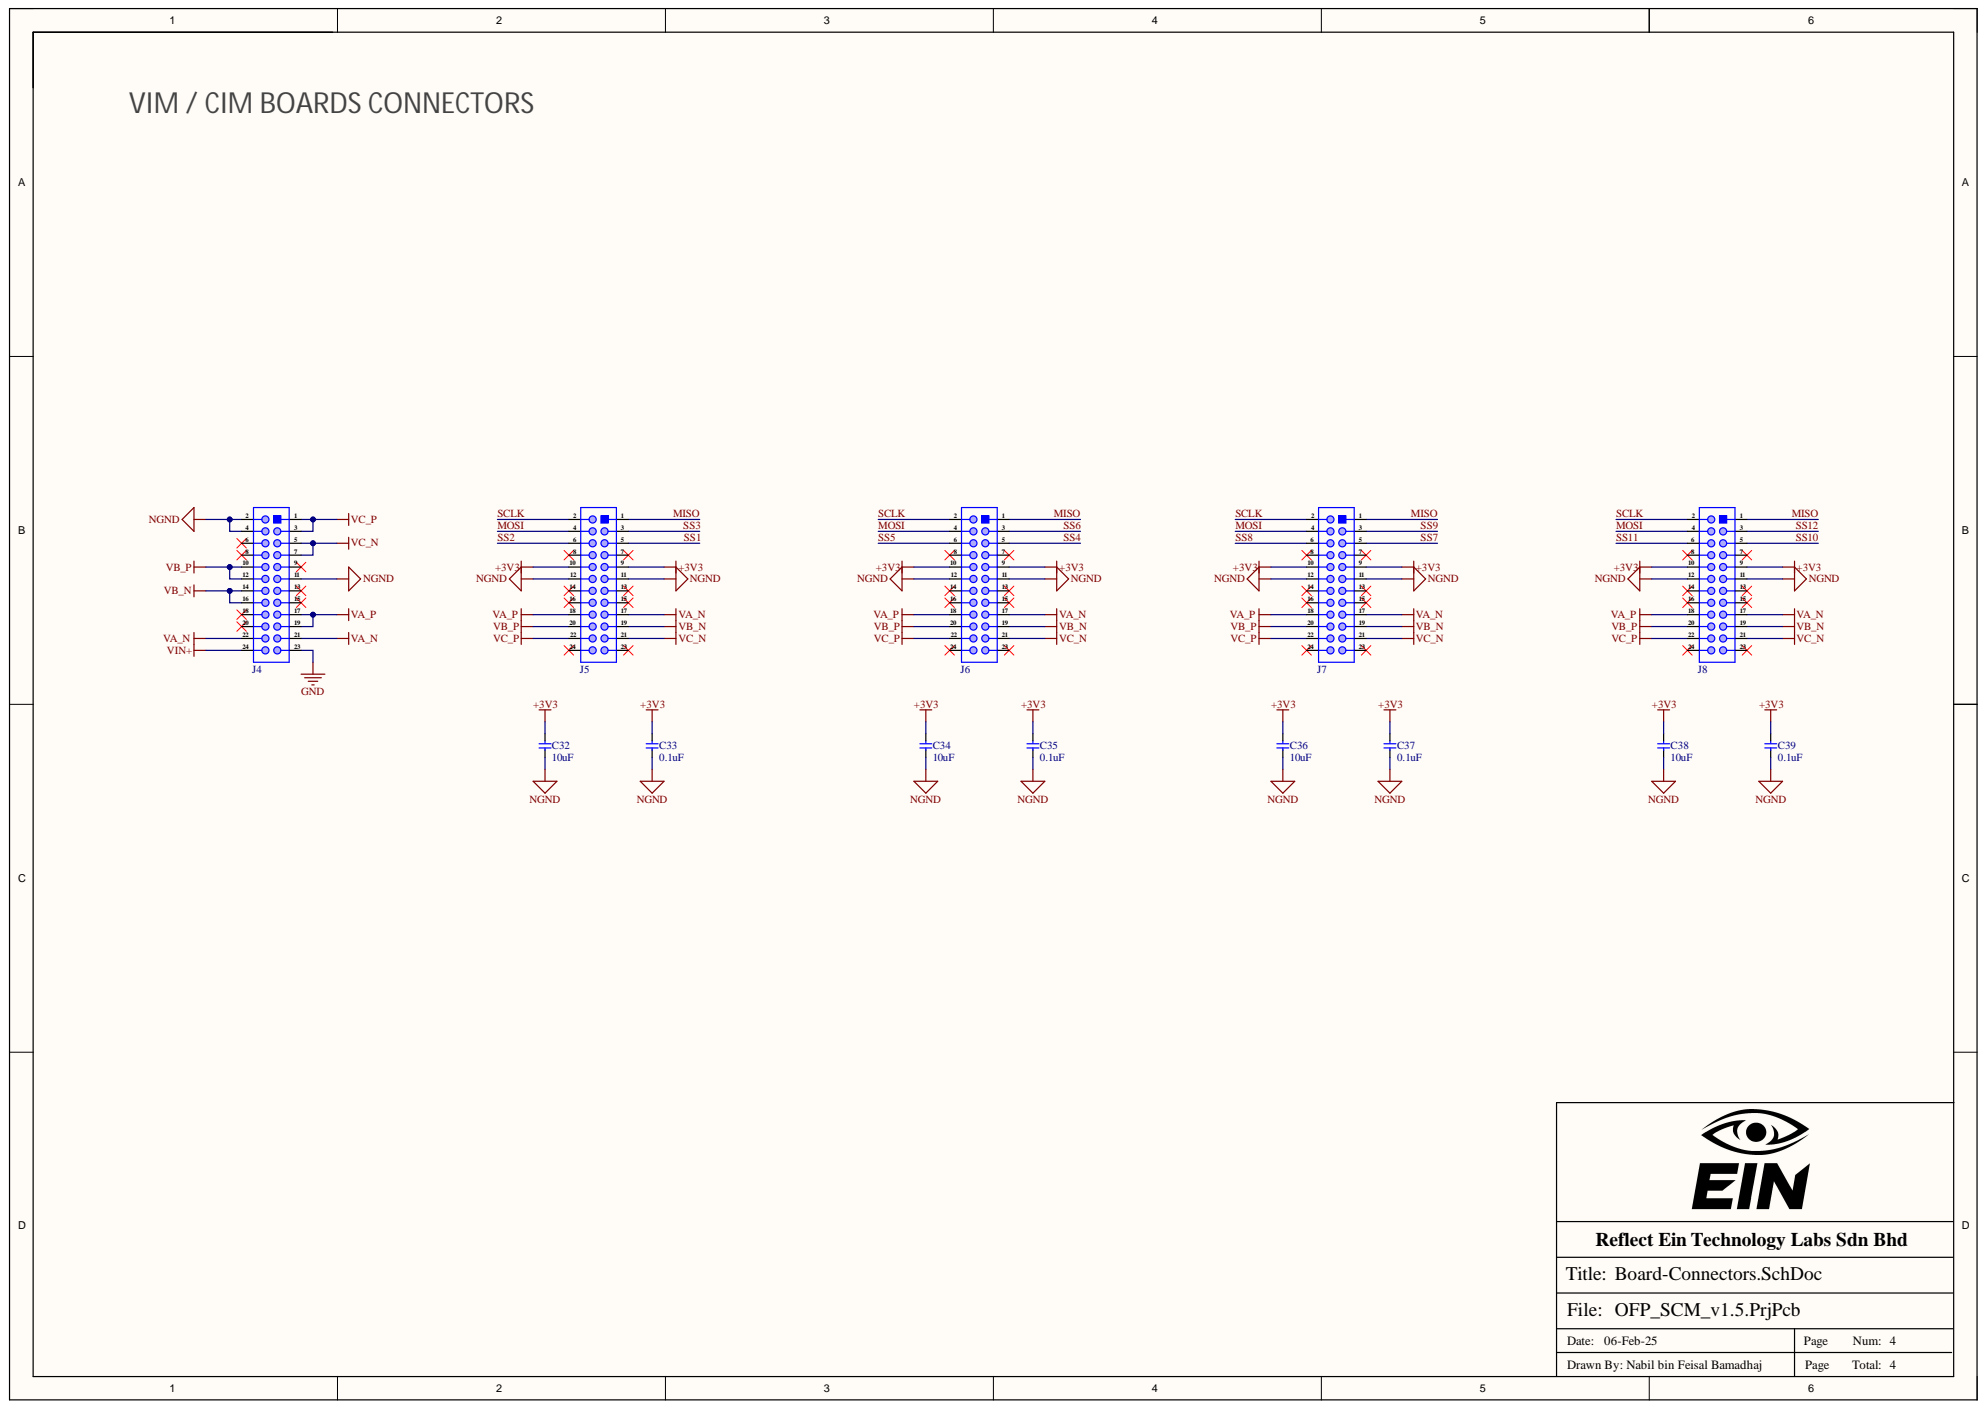
[picture p219: page 4]

VIM / CIM BOARDS CONNECTORS

Reflect Ein Technology Labs Sdn Bhd
