eSpark-Backup/nabilfesal-smartmeter-hw/Design-Files/OFP_MCM_v1.6.1/Deliverables/_Schematics/OFP_MCM_v1.61.pdf

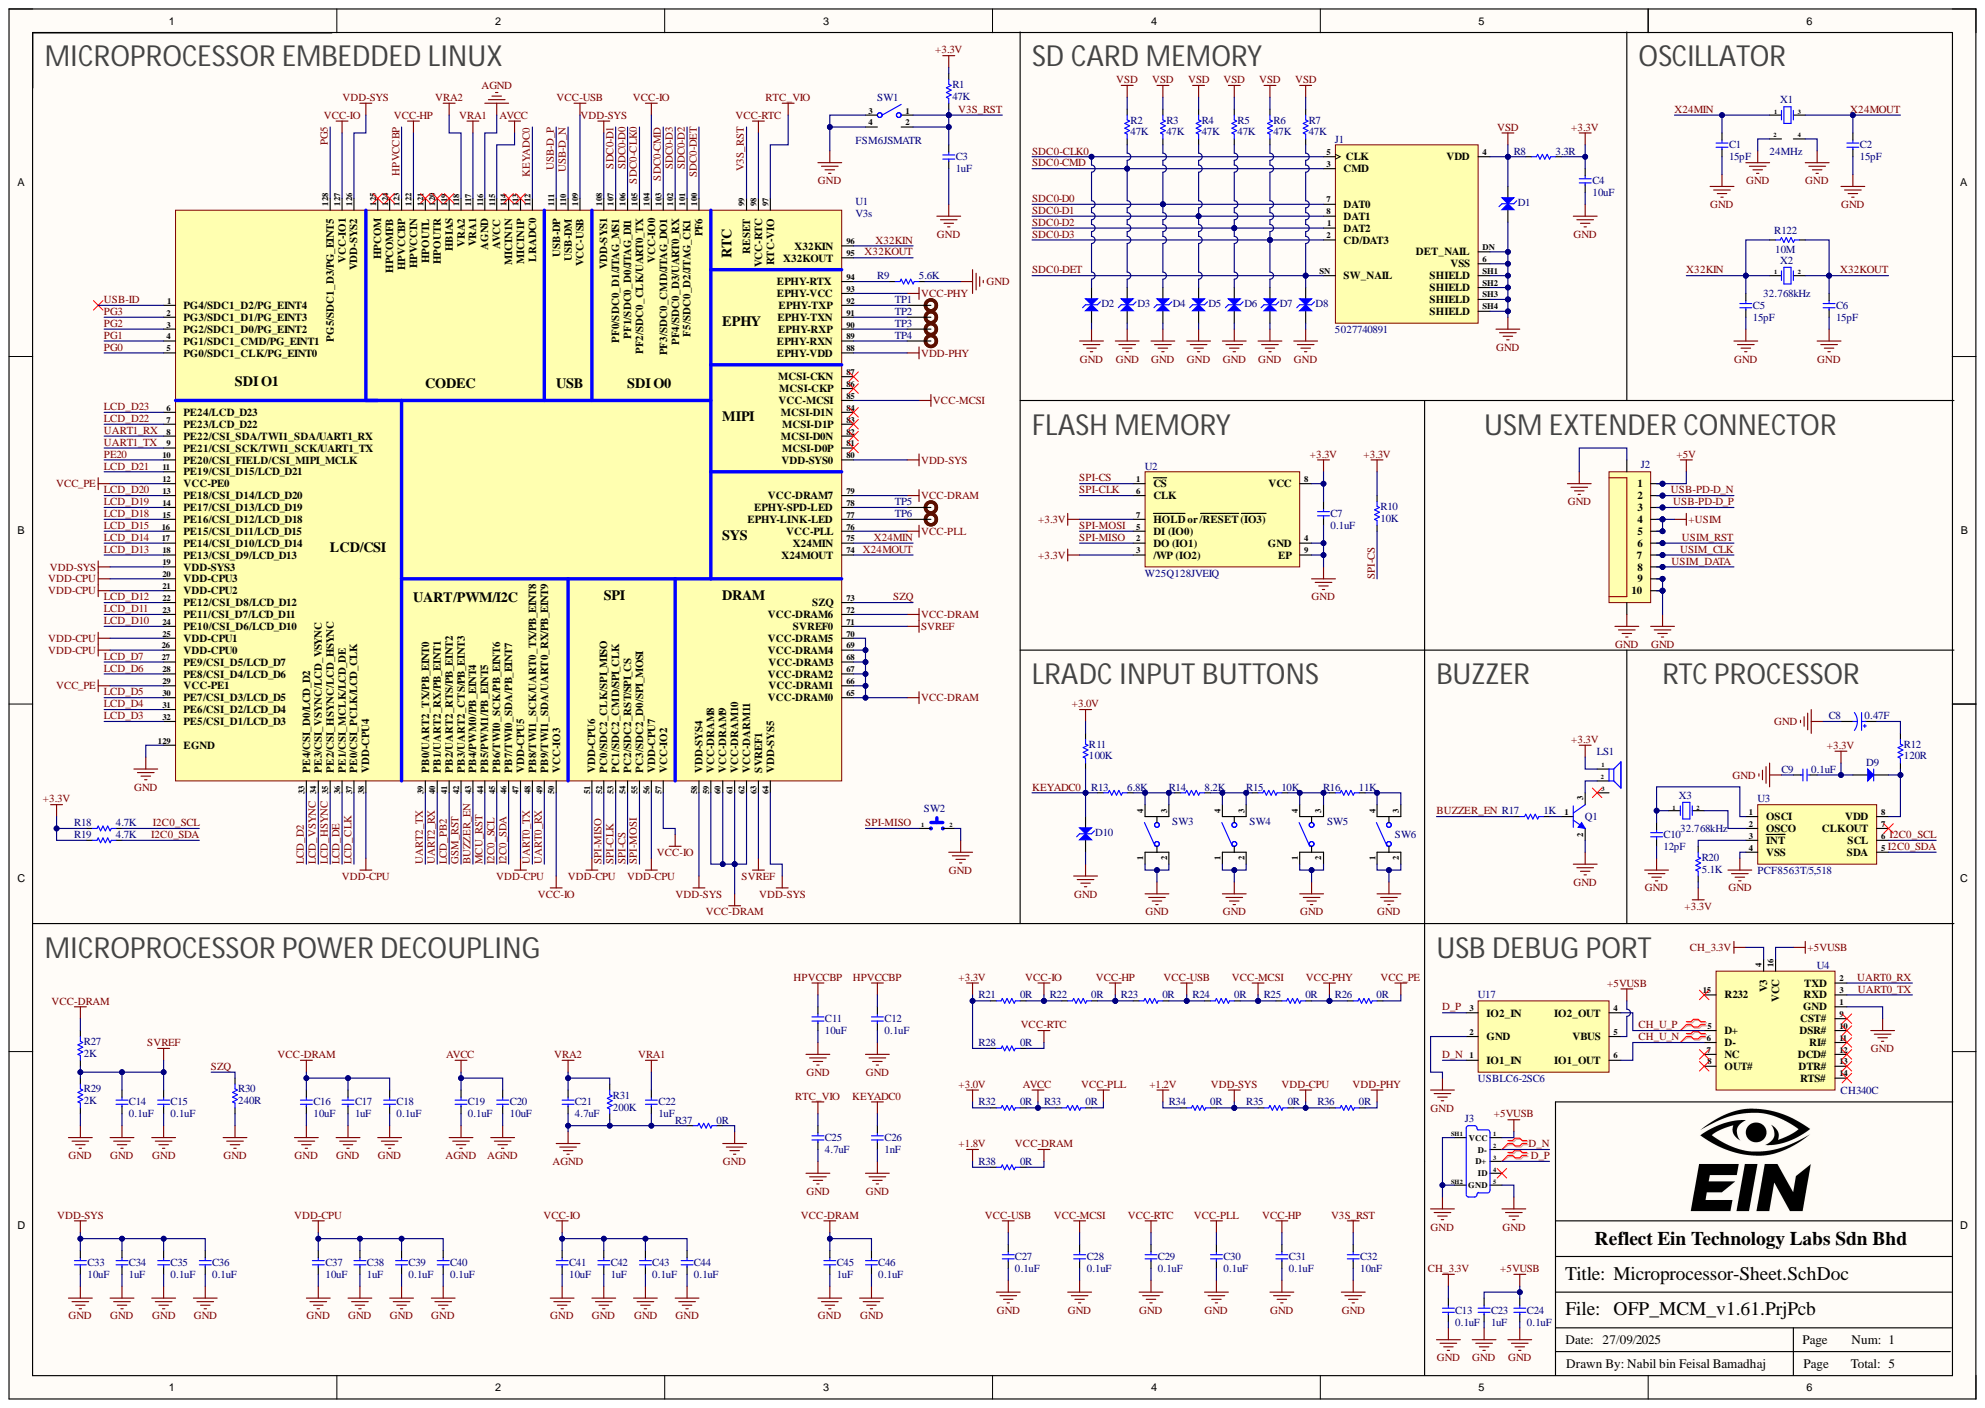
[picture p220: page 1]

VDD-SYS5 64 SVREF1 63 VCC-DARM11 62 VCC-DRAM10 61 VCC-DRAM9 60 VCC-DRAM8 59 VDD-SYS4 58

VCC-IO SPI-MISO

VDD-CPU

GND 2 | CH_U_P

Reflect Ein Technology Labs Sdn Bhd

Date: 27/09/2025 | Page Num: 1

Drawn By: Nabil bin Feisal Bamadhaj | Total:

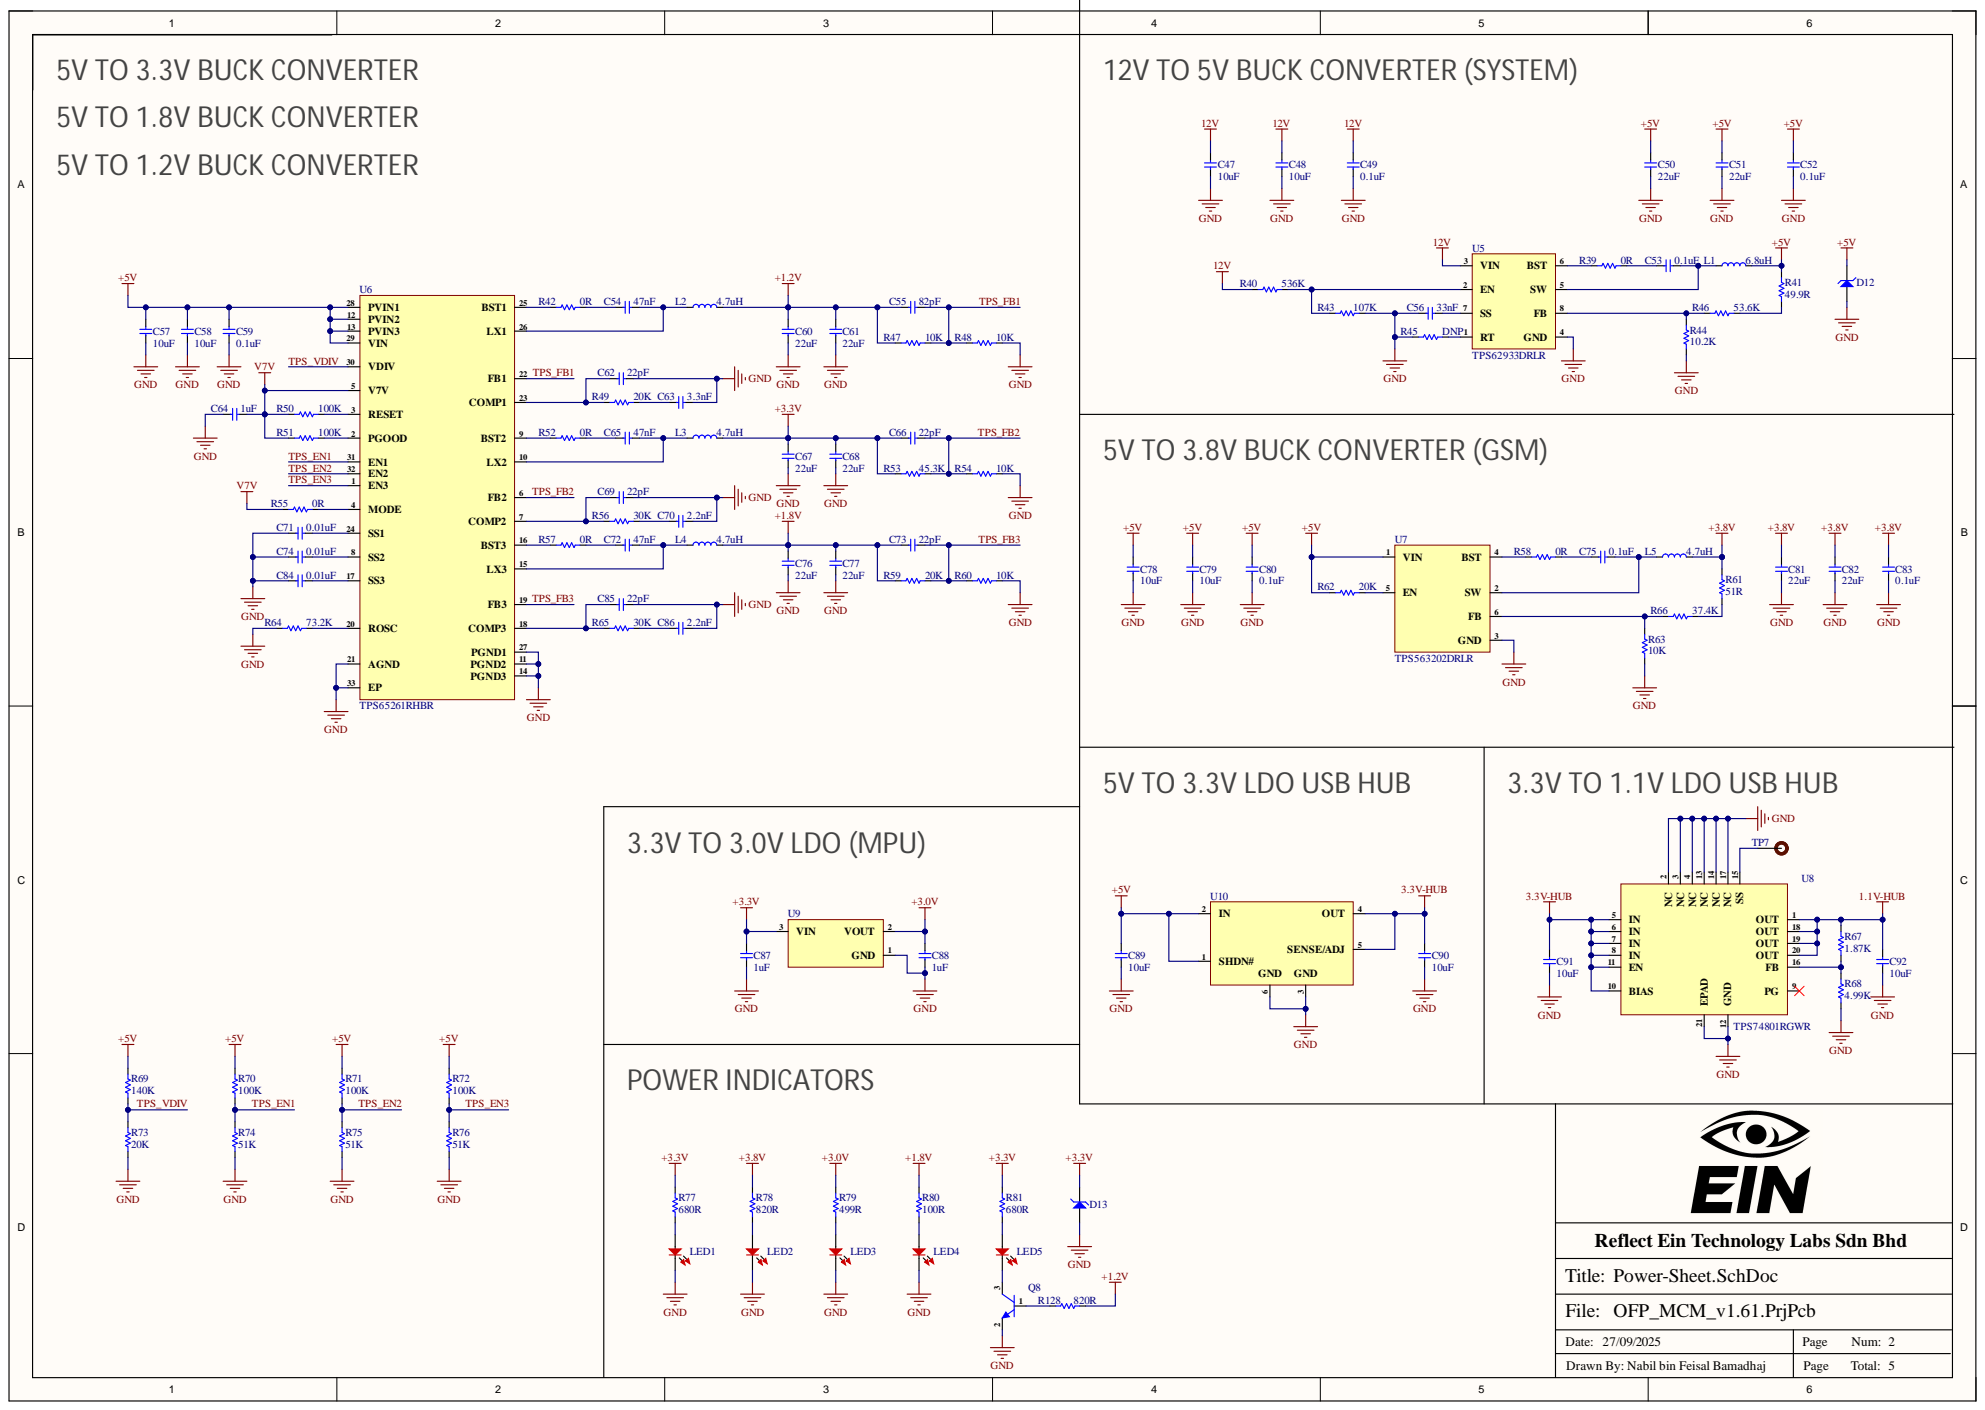
[picture p221: page 2]

12V TO 5V BUCK CONVERTER (SYSTEM)

5V TO 3.8V BUCK CONVERTER (GSM)

Reflect Ein Technology Labs Sdn Bhd

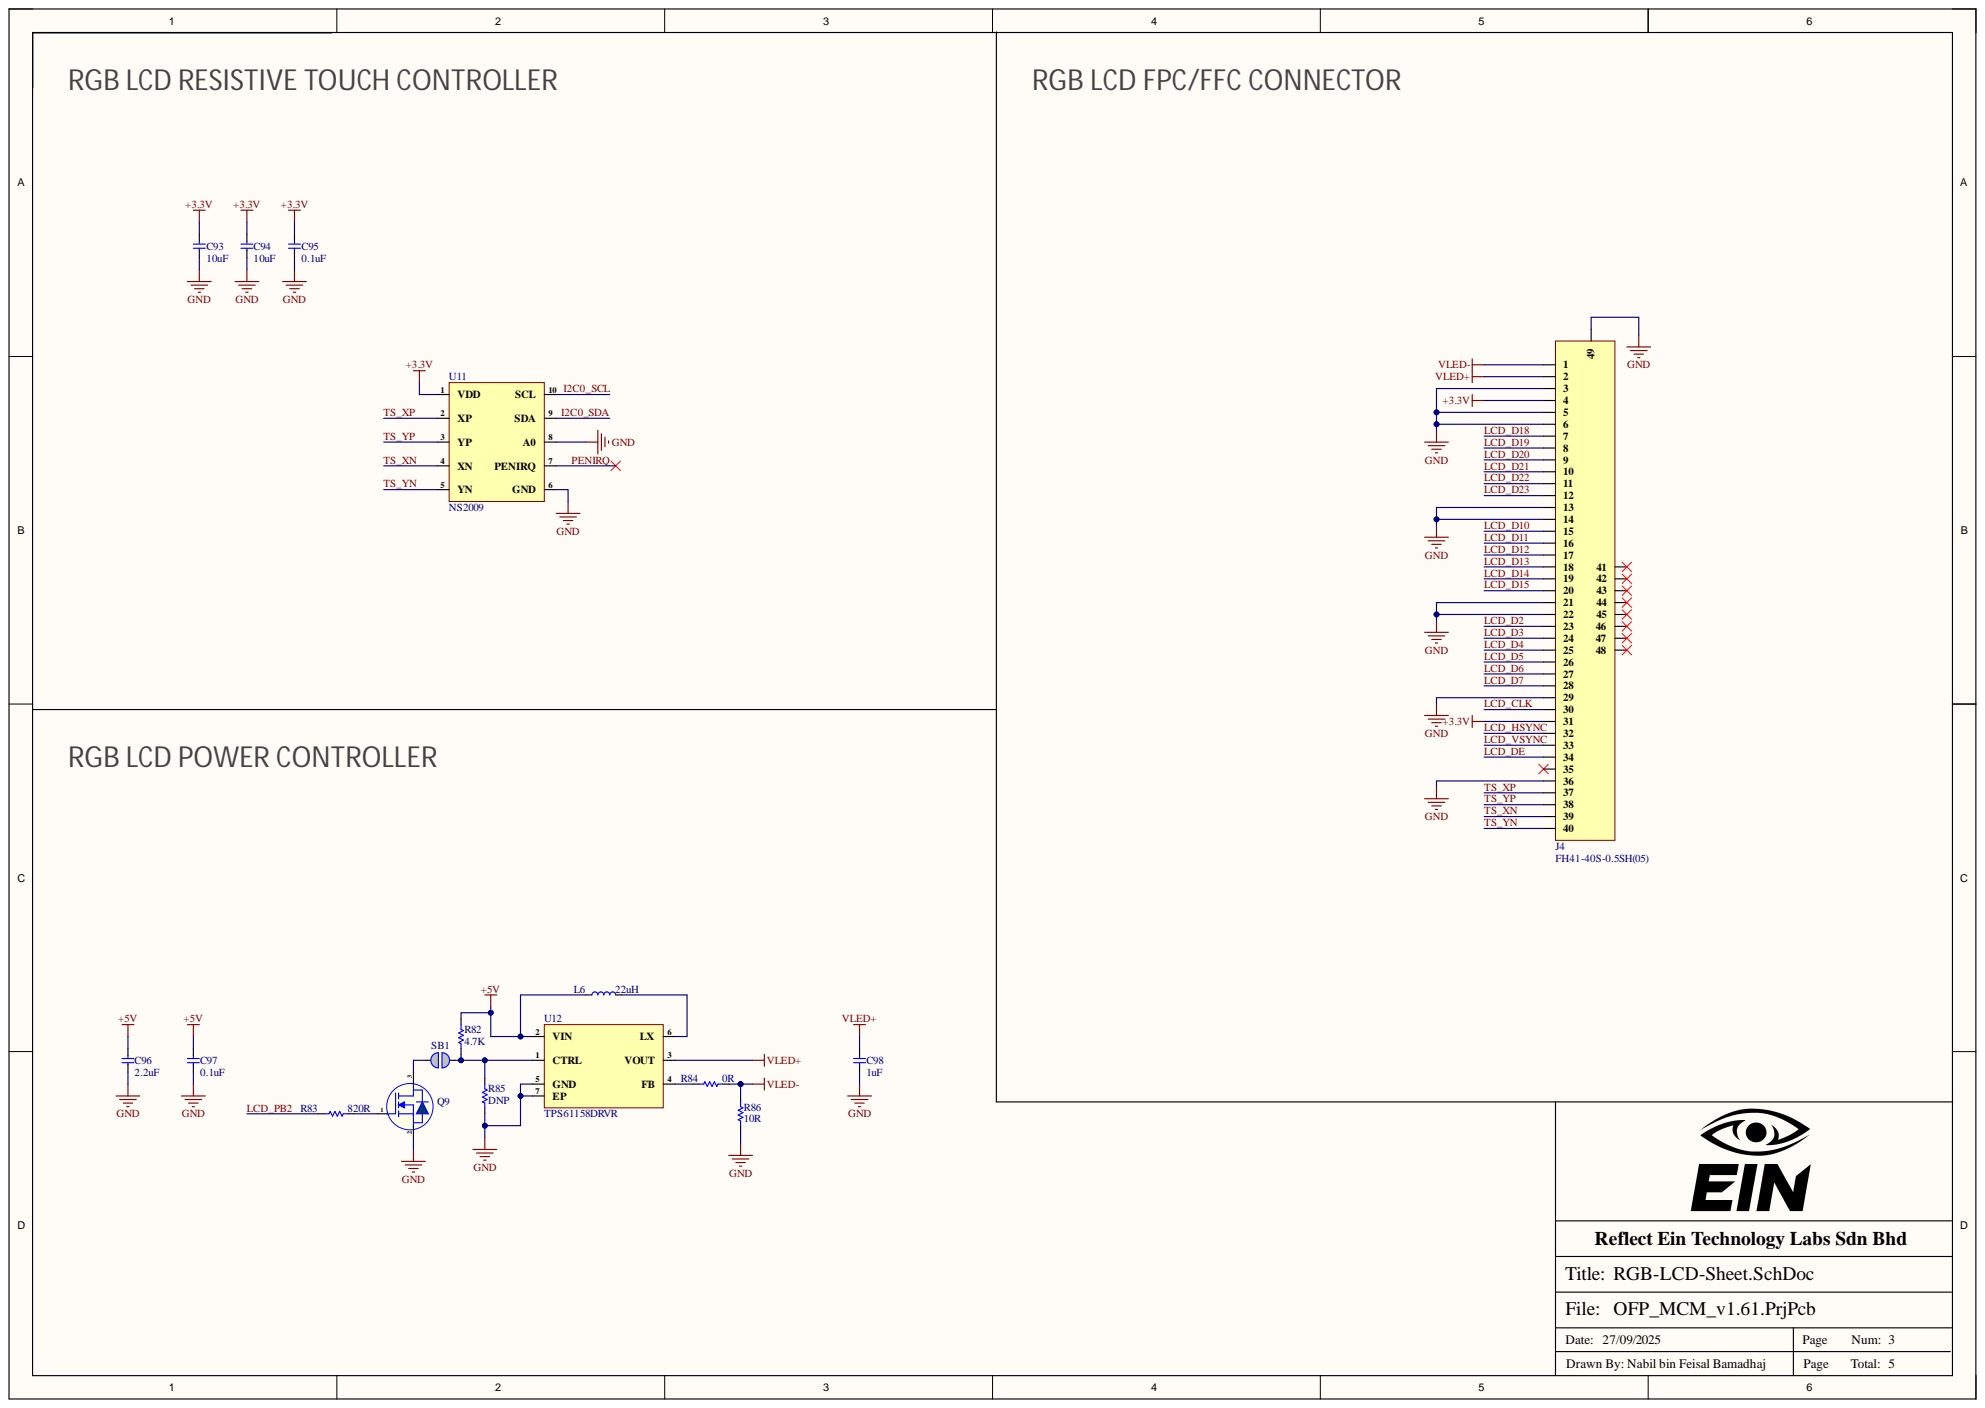
[picture p222: page 3]

RGB LCD FPC/FFC CONNECT

Technology Labs Sdn Bhd

Date: | Pag e N u m :

D raw n B y : Nab i l b i n Feisal Bamad haj | Pag e To tal :

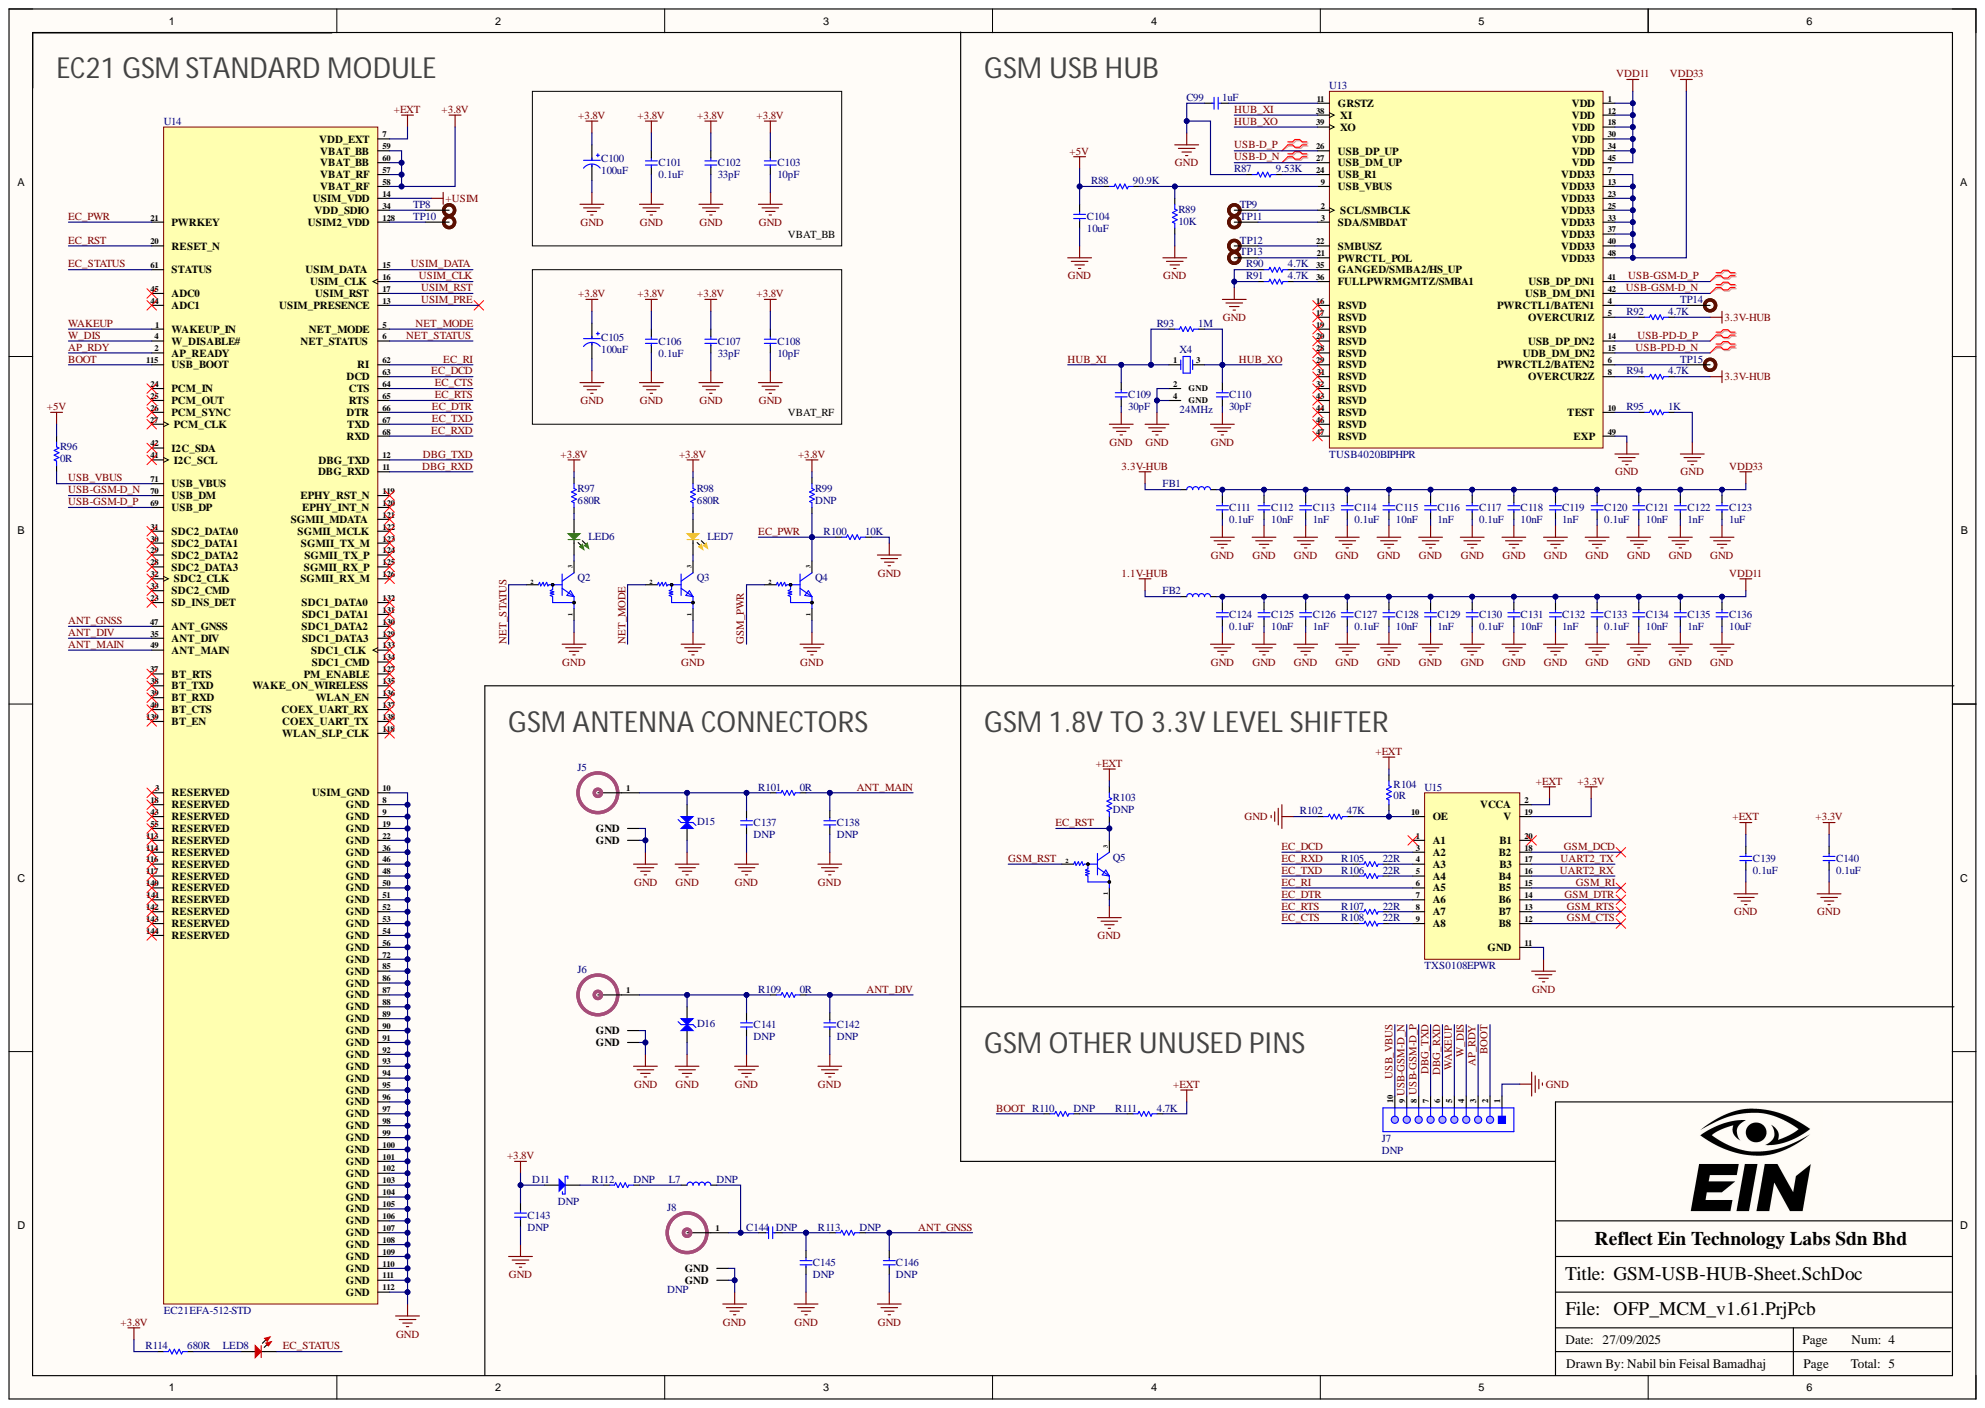
[picture p223: page 4]

GSM 1.8V TO 3.3V LEVEL SHIFTER

GSM OTHER UNUSED PINS

Reflect Ein Technology Labs Sdn Bhd

GSM-USB-HUB-Sheet.SchDoc

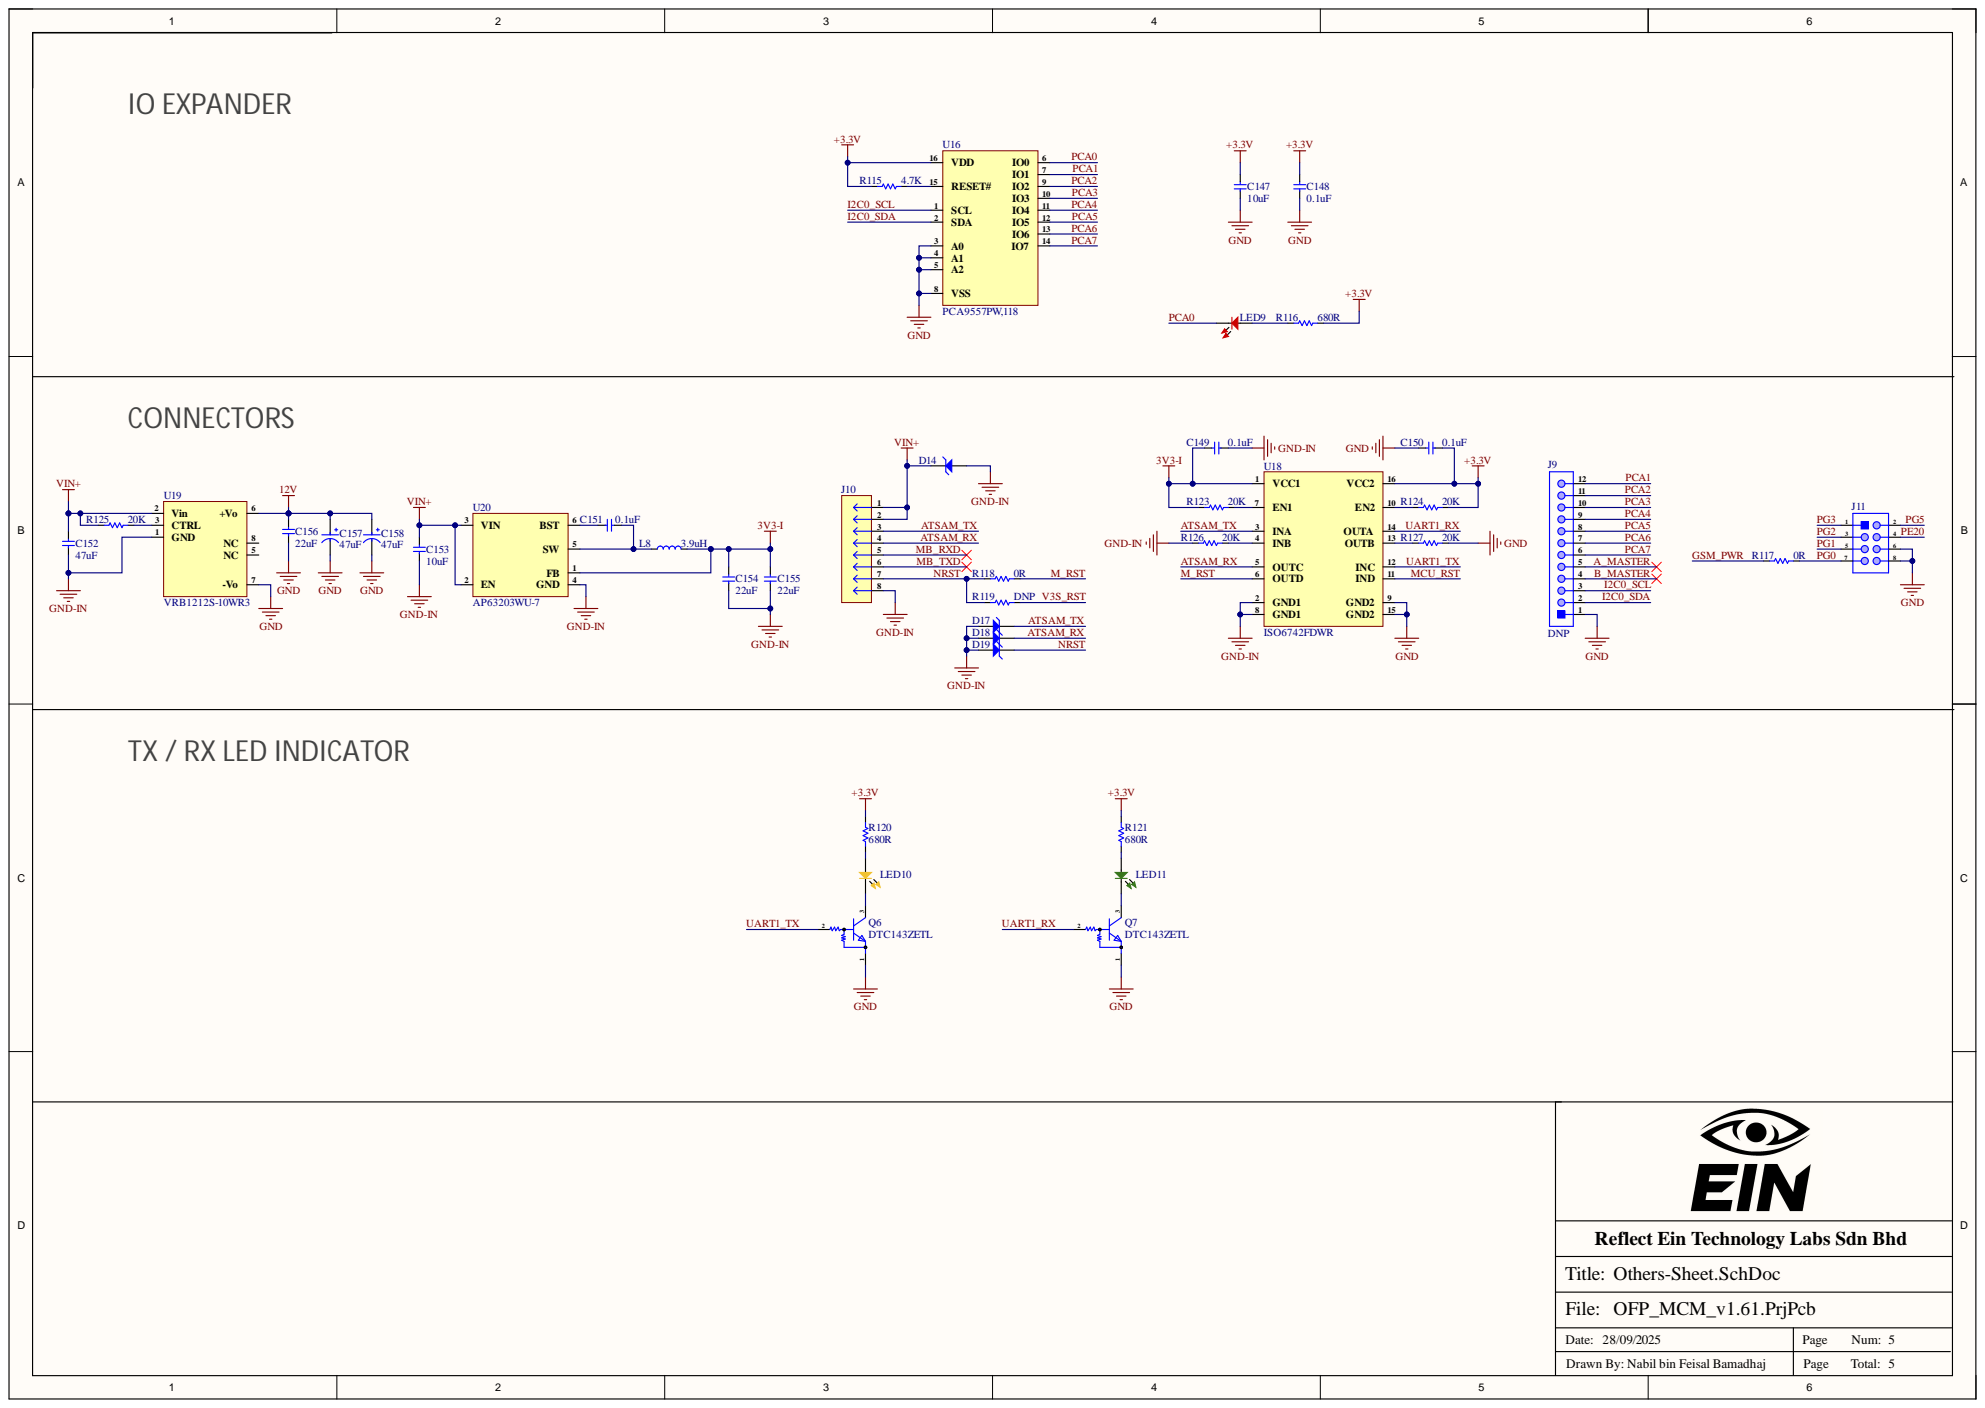
[picture p224: page 5]

D18
D19

TX / RX LED INDICATOR

Reflect Ein Technology Labs Sdn Bhd
