eSpark-Backup/nabilfesal-smartmeter-hw/Design-Files/OFP_MCM_v1.5/Deliverables/_Schematics/OFP_MCM_v1.5.pdf

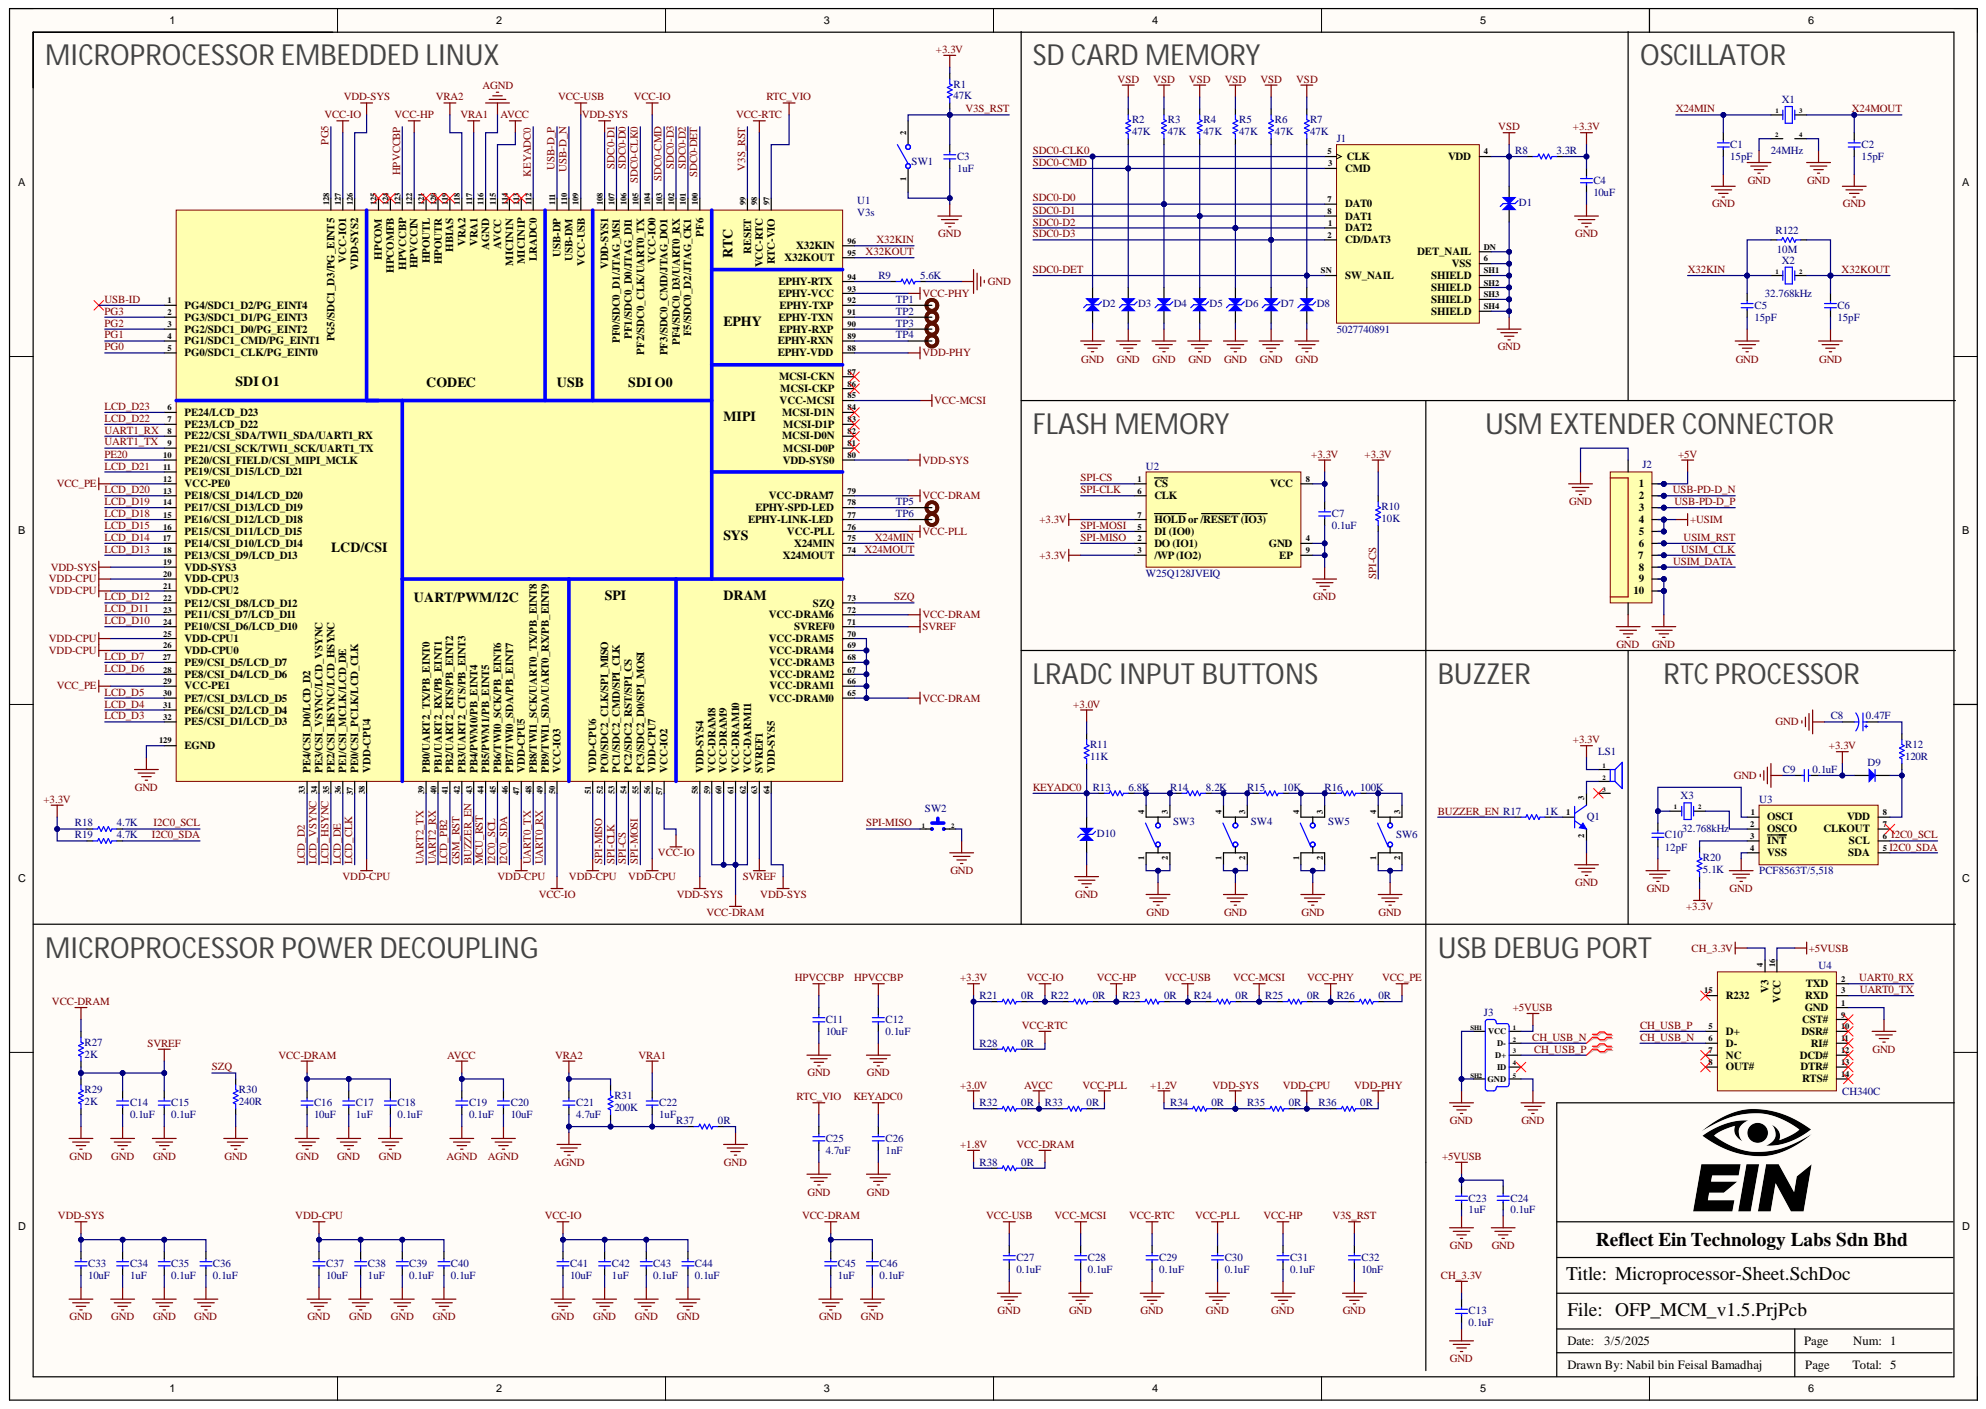
[picture p231: page 1]

VDD-SYS5 64 SVREF1 63 VCC-DARM11 62 VCC-DRAM10 61 VCC-DRAM9 60 VCC-DRAM8 59 VDD-SYS4 58

VCC-IO SPI-MISO

VDD-CPU
VCC-IO

Reflect Ein Technology Labs Sdn Bhd

Date: 3/5/2025 | Page Num: 1

Drawn By: Nabil bin Feisal Bamadhaj | Page Total:

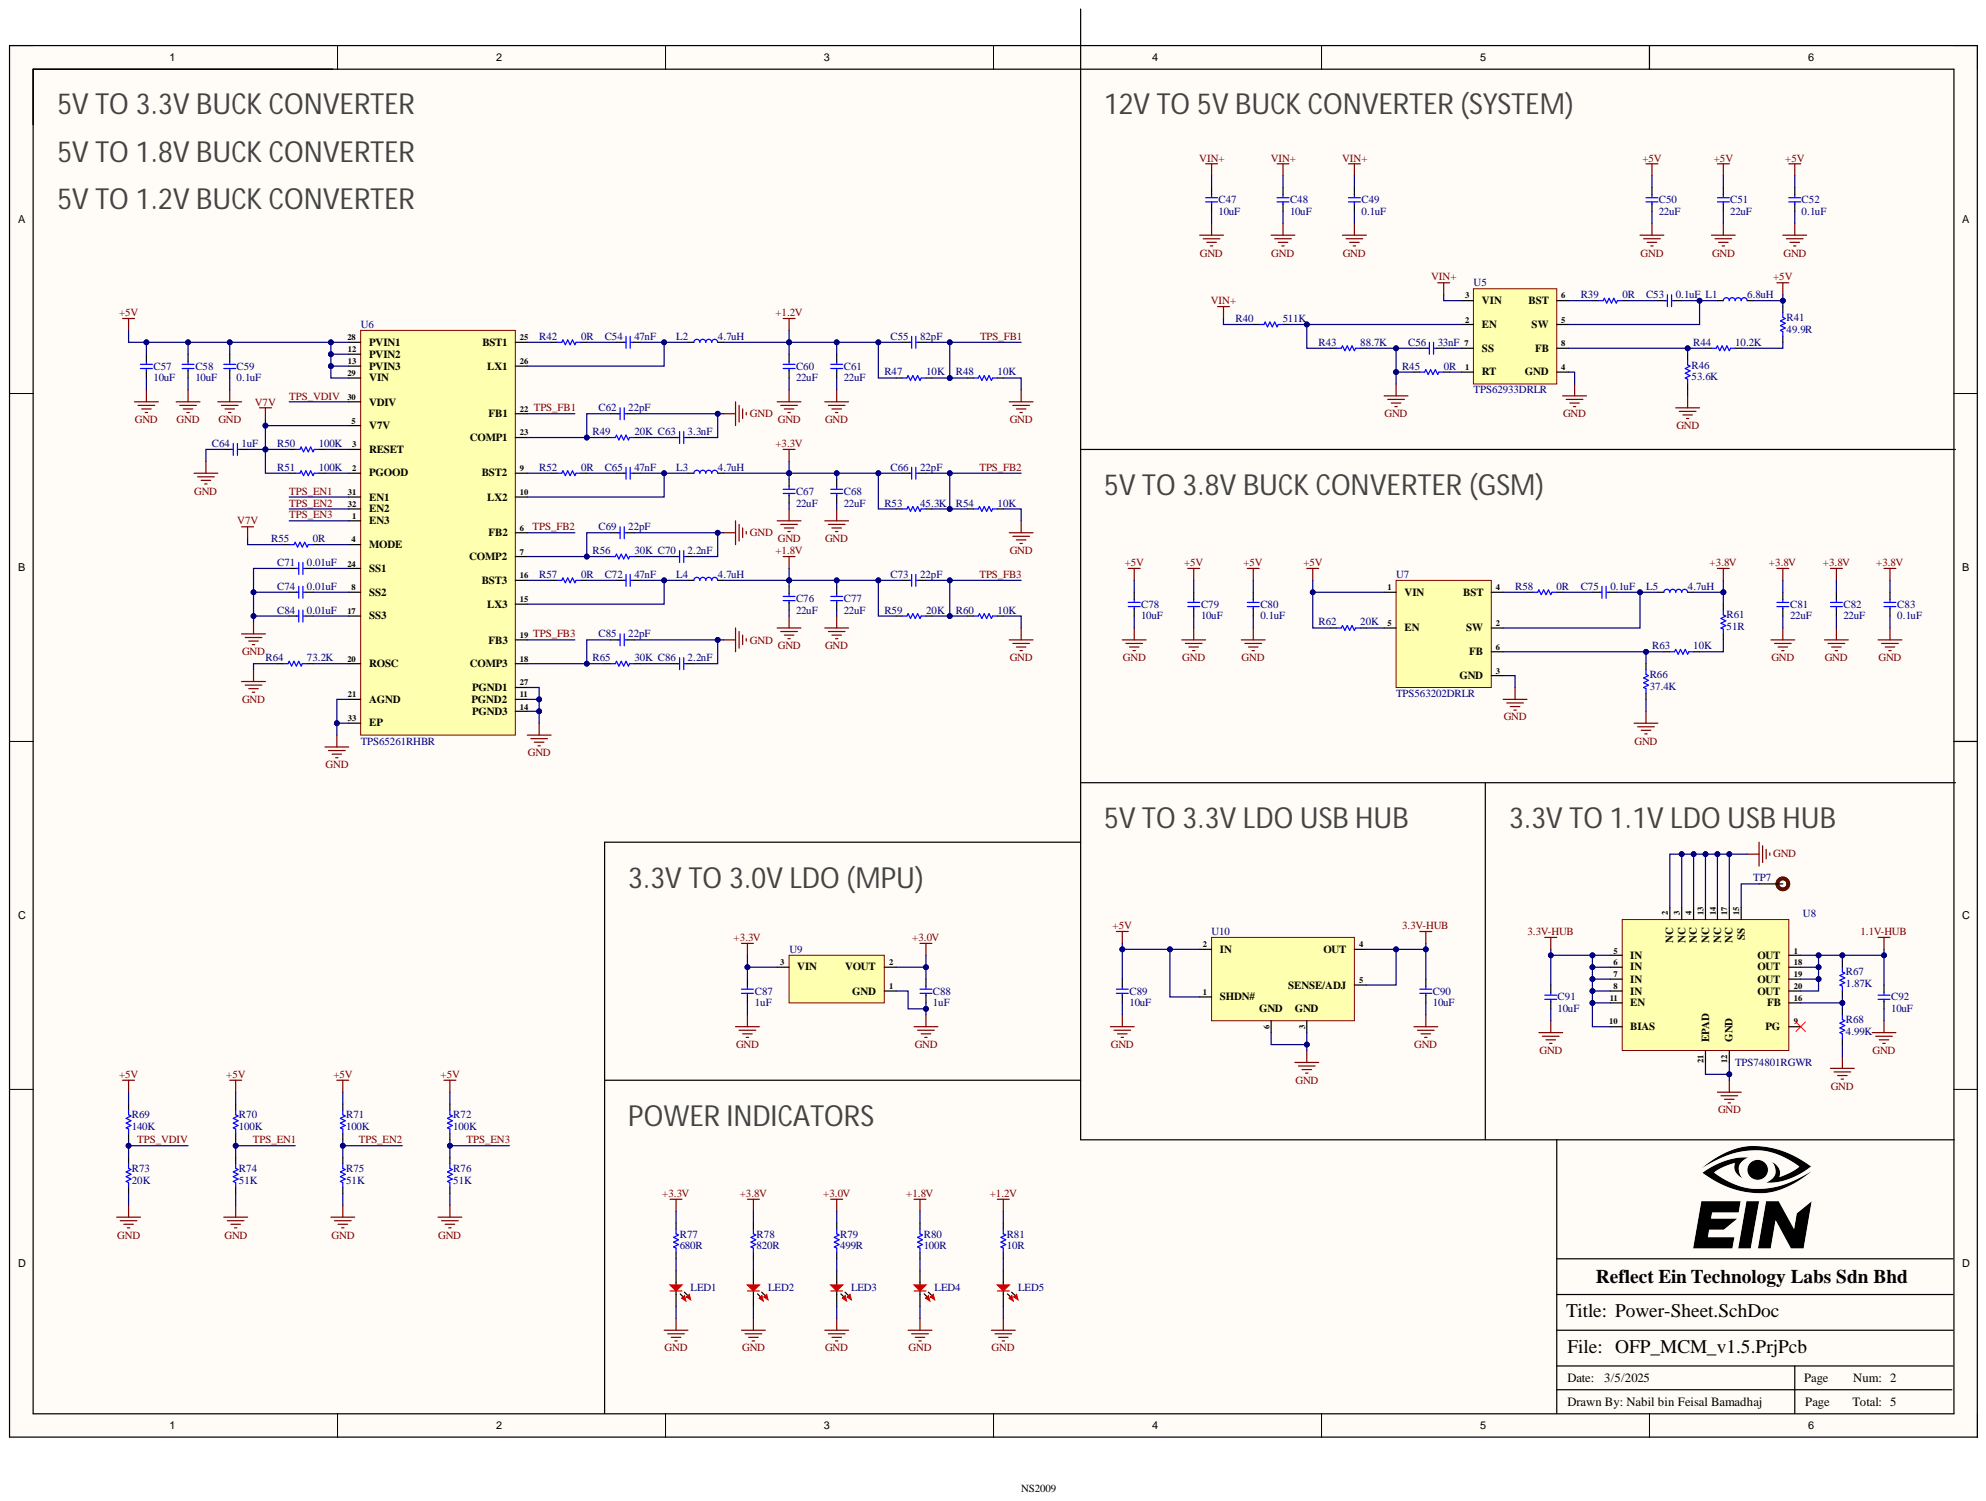
[picture p232: page 2]

12V TO 5V BUCK CONVERTER (SYSTEM)

5V TO 3.8V BUCK CONVERTER (GSM)

Reflect Ein Technology Labs Sdn Bhd

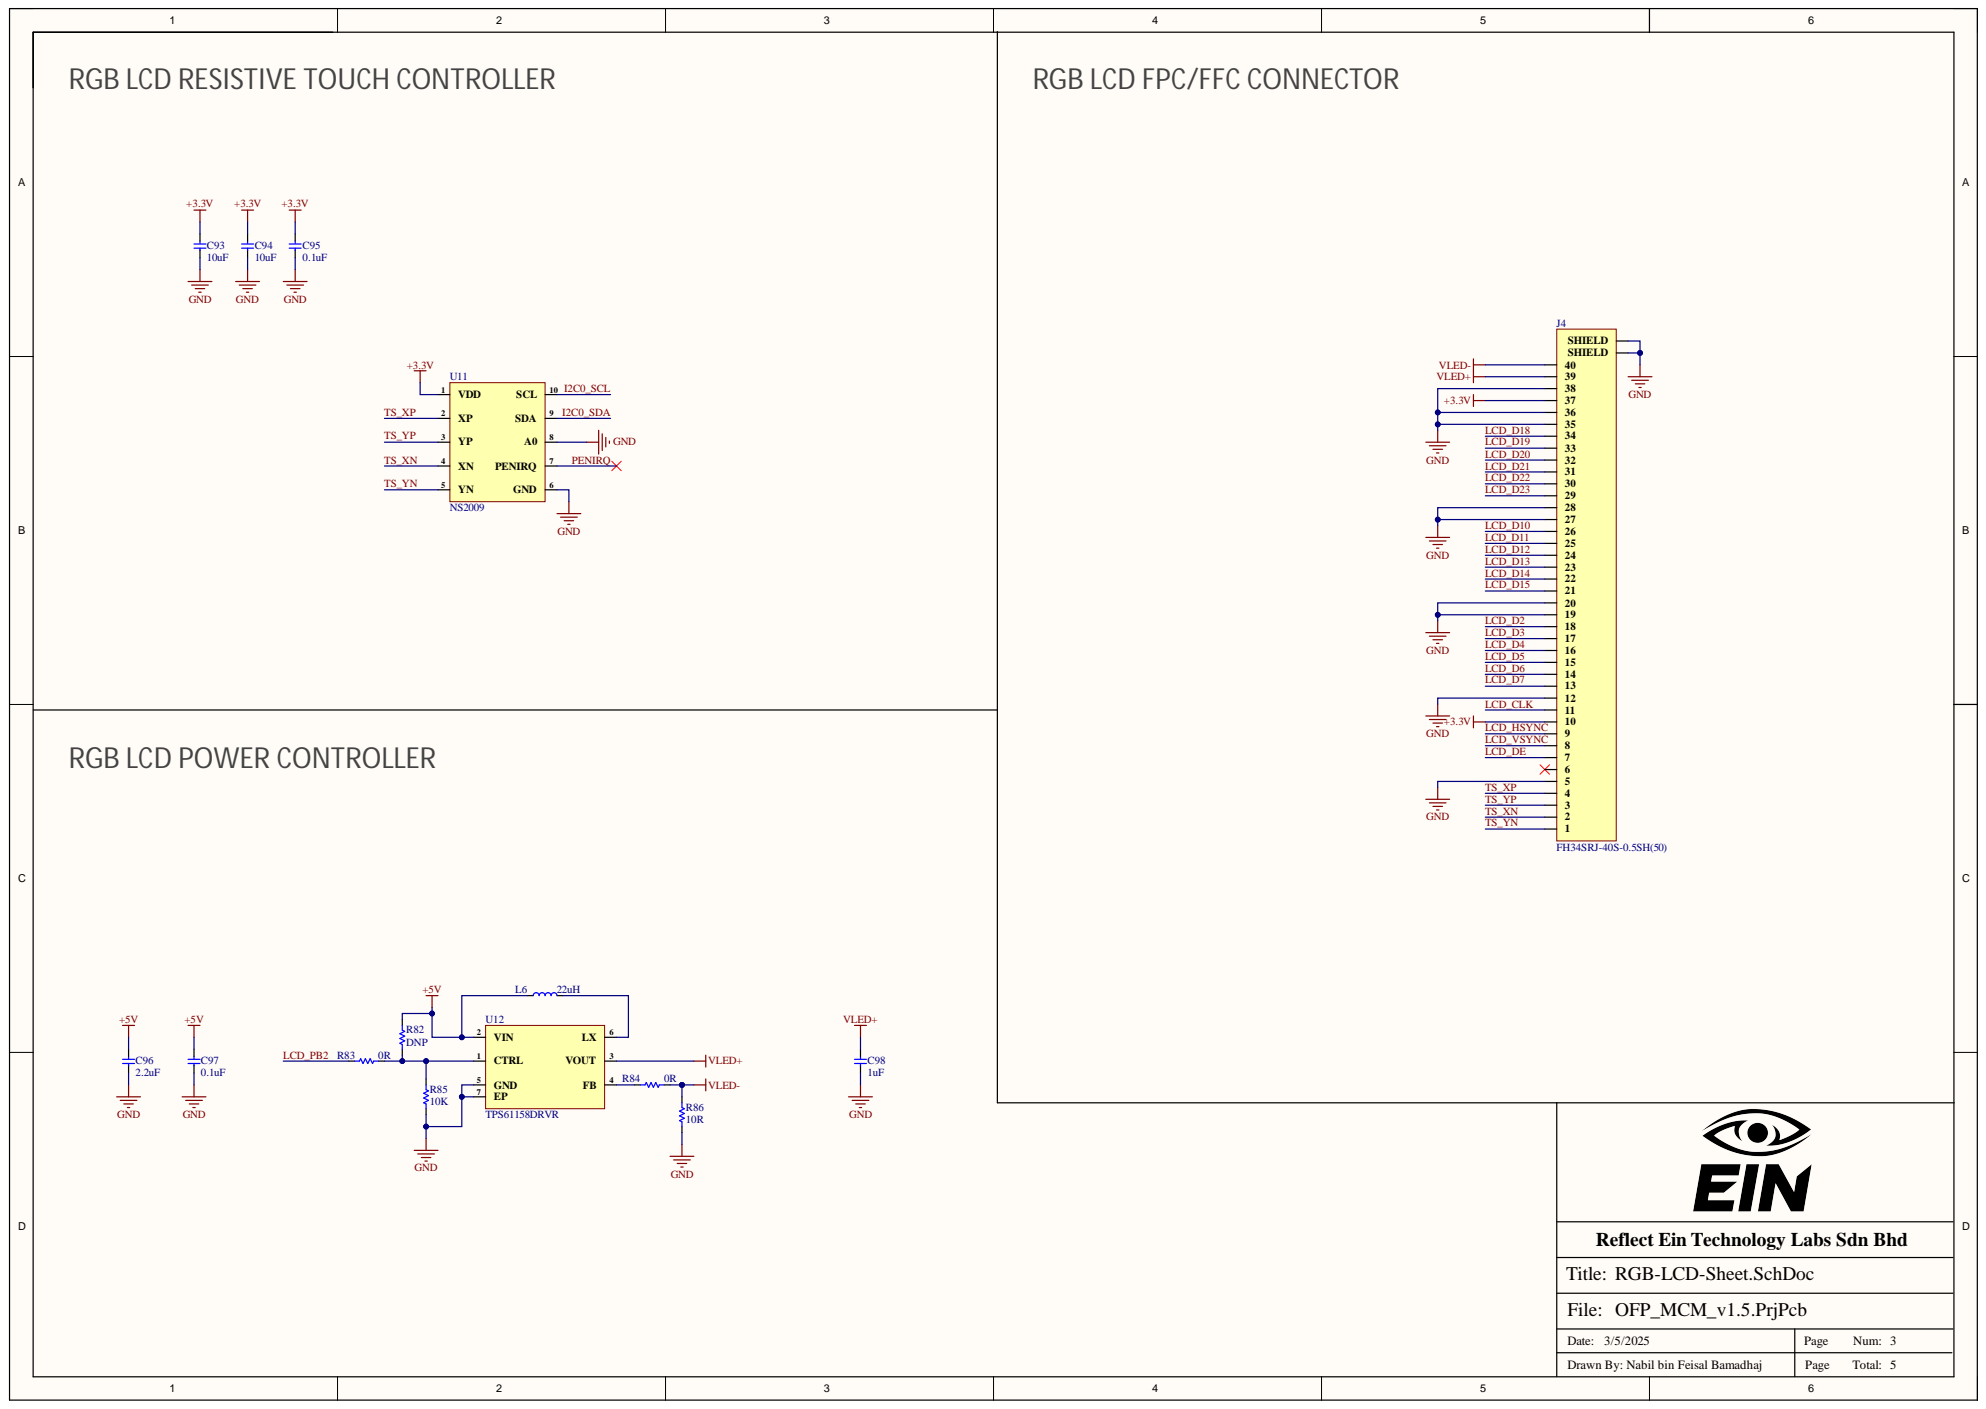
[picture p233: page 3]

RGB LCD RESISTIVE TOUCH CONTROLLER

RGB LCD FPC/FFC CONNECTOR

RGB LCD POWER CONTROLLER

Reflect Ein Technology Labs Sdn Bhd

RGB-LCD-Sheet.SchDoc

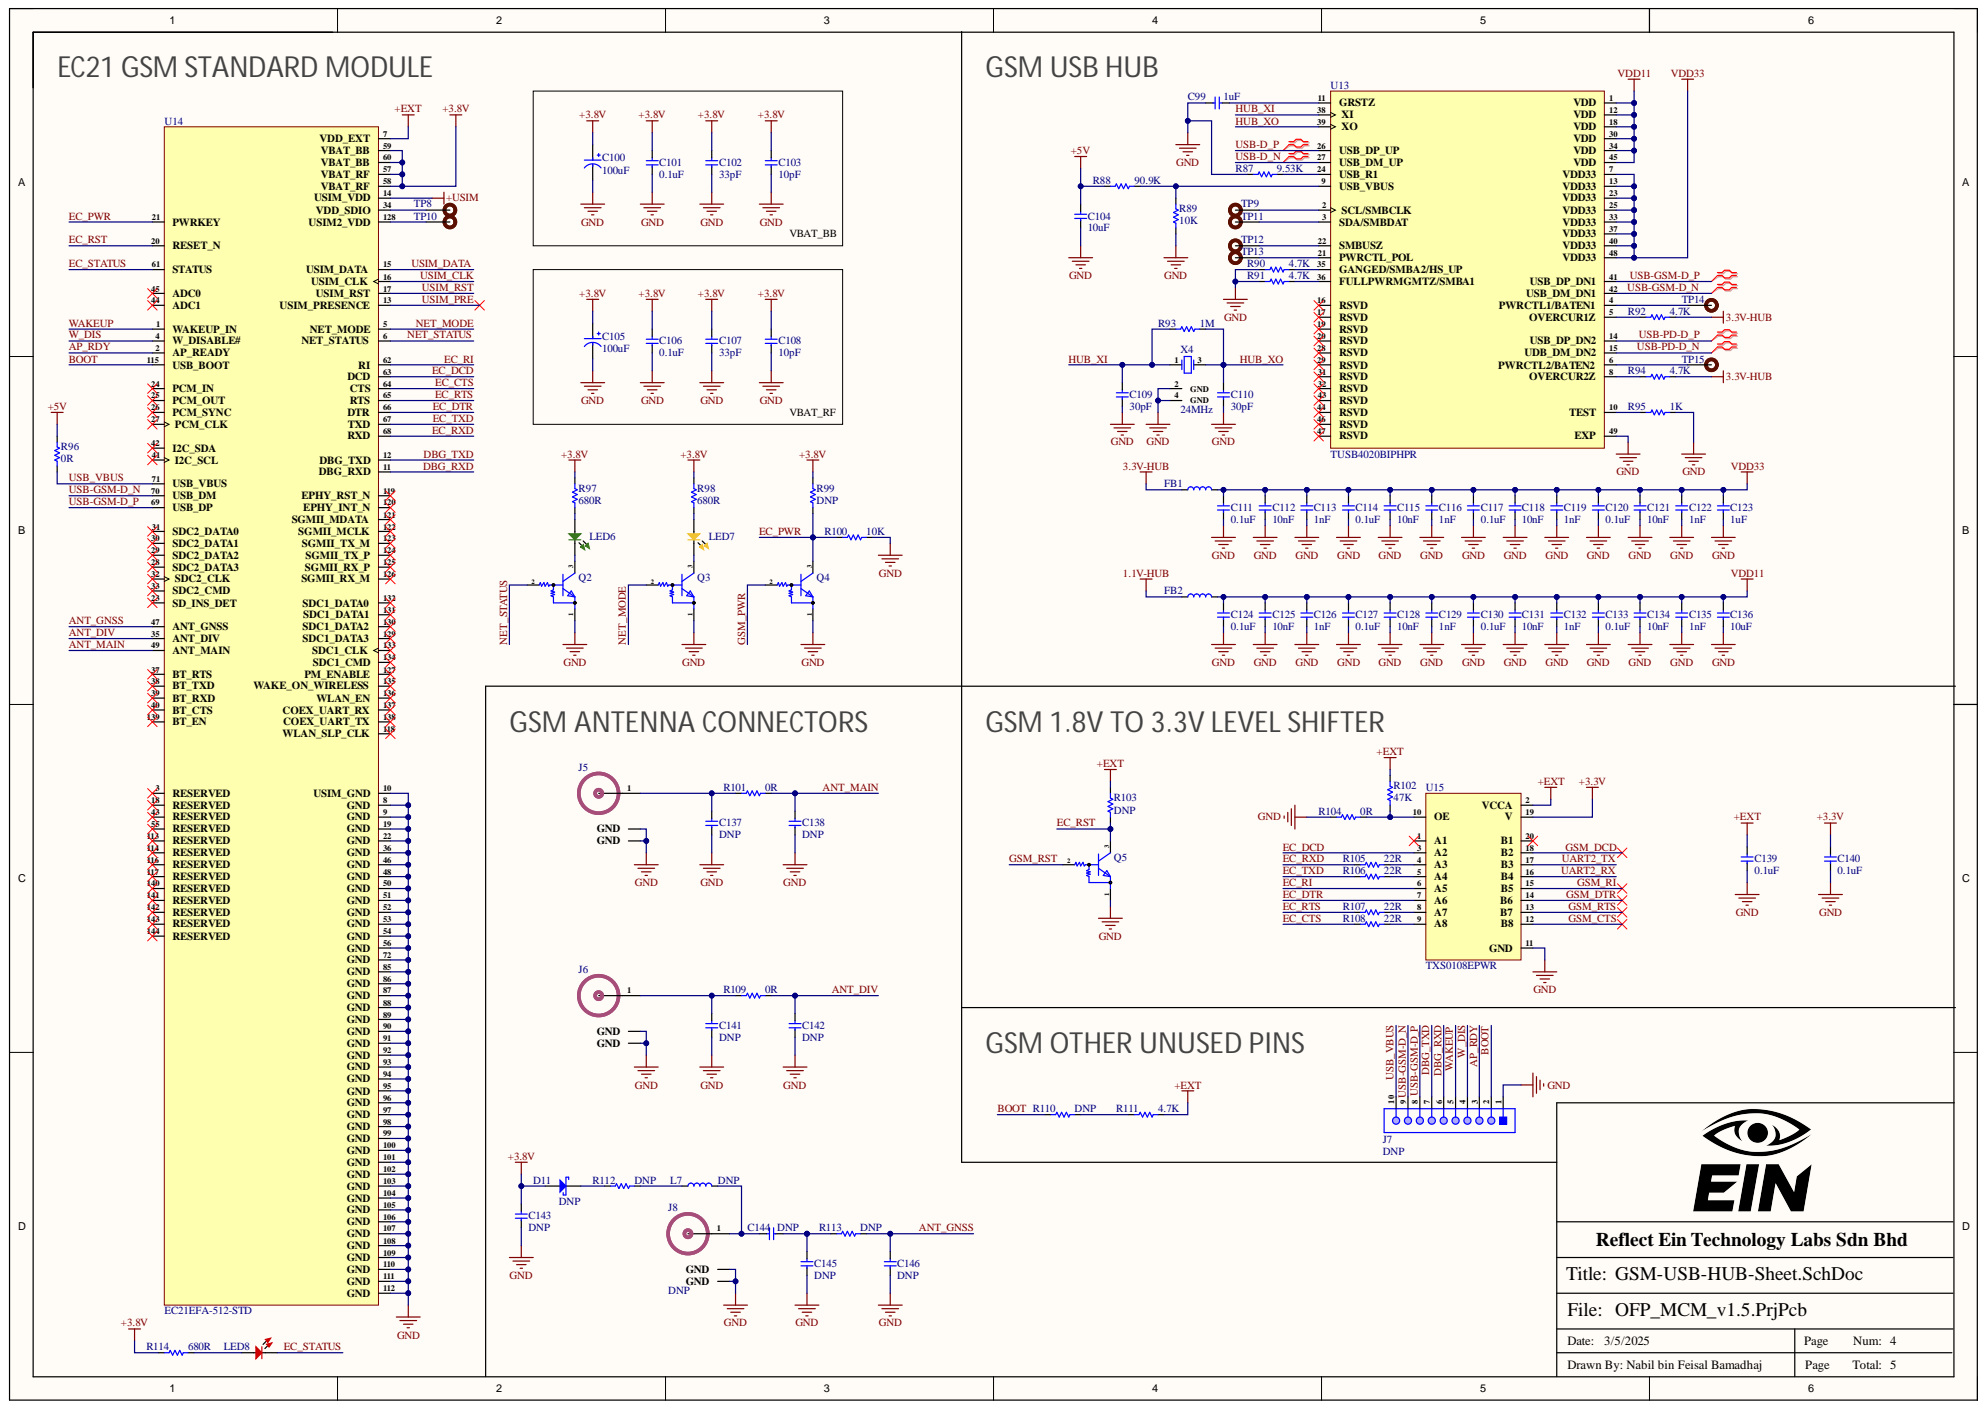
[picture p234: page 4]

GSM 1.8V TO 3.3V LEVEL SHIFTER

GSM OTHER UNUSED PINS

Reflect Ein Technology Labs Sdn Bhd

GSM-USB-HUB-Sheet.SchDoc

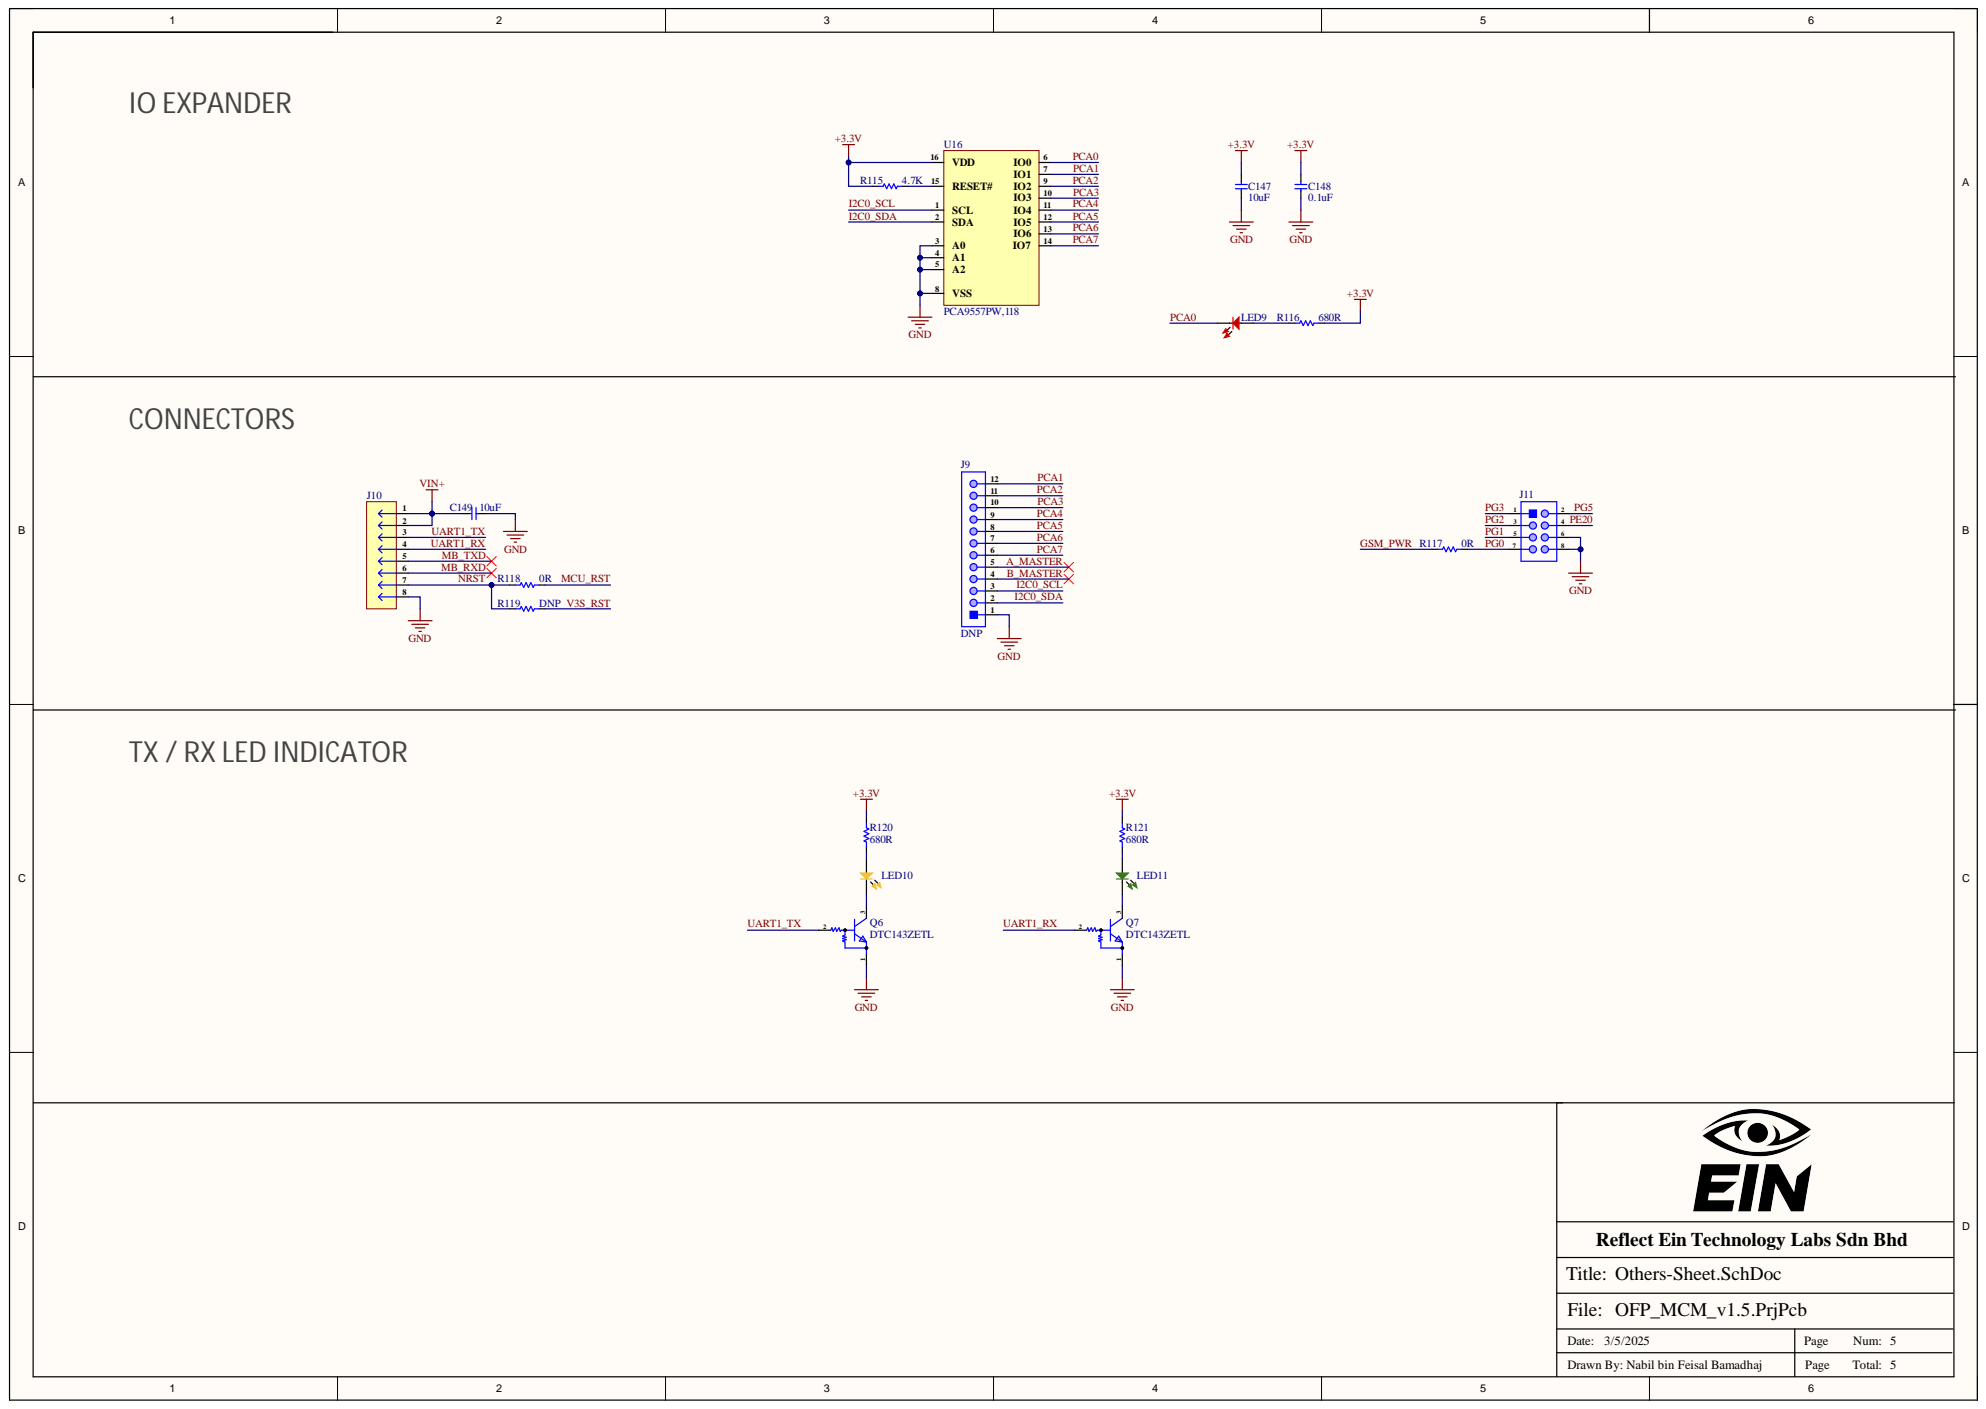
[picture p235: page 5]

TX / RX LED INDICATOR

Reflect Ein Technology Labs Sdn Bhd

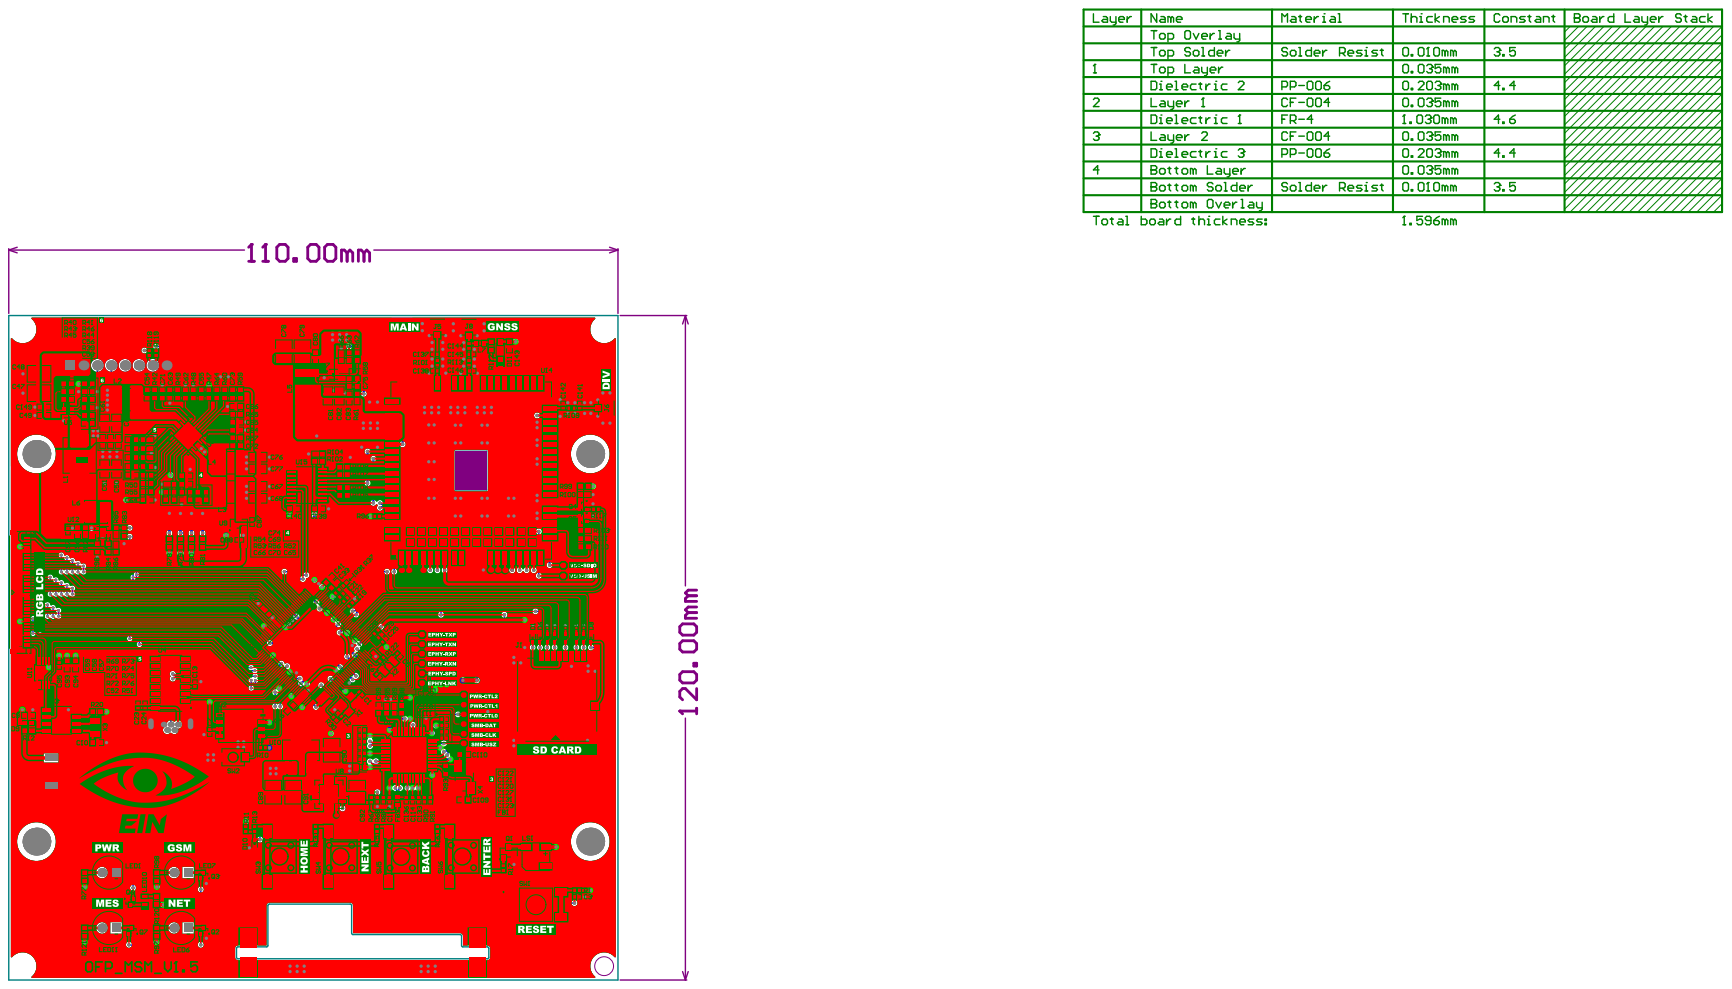
[picture p236: page 6]
