eSpark-Backup/nabilfesal-smartmeter-hw/Design-Files/OFP_MCM_v1.6.1/Deliverables/_Schematics/Assembly File.pdf

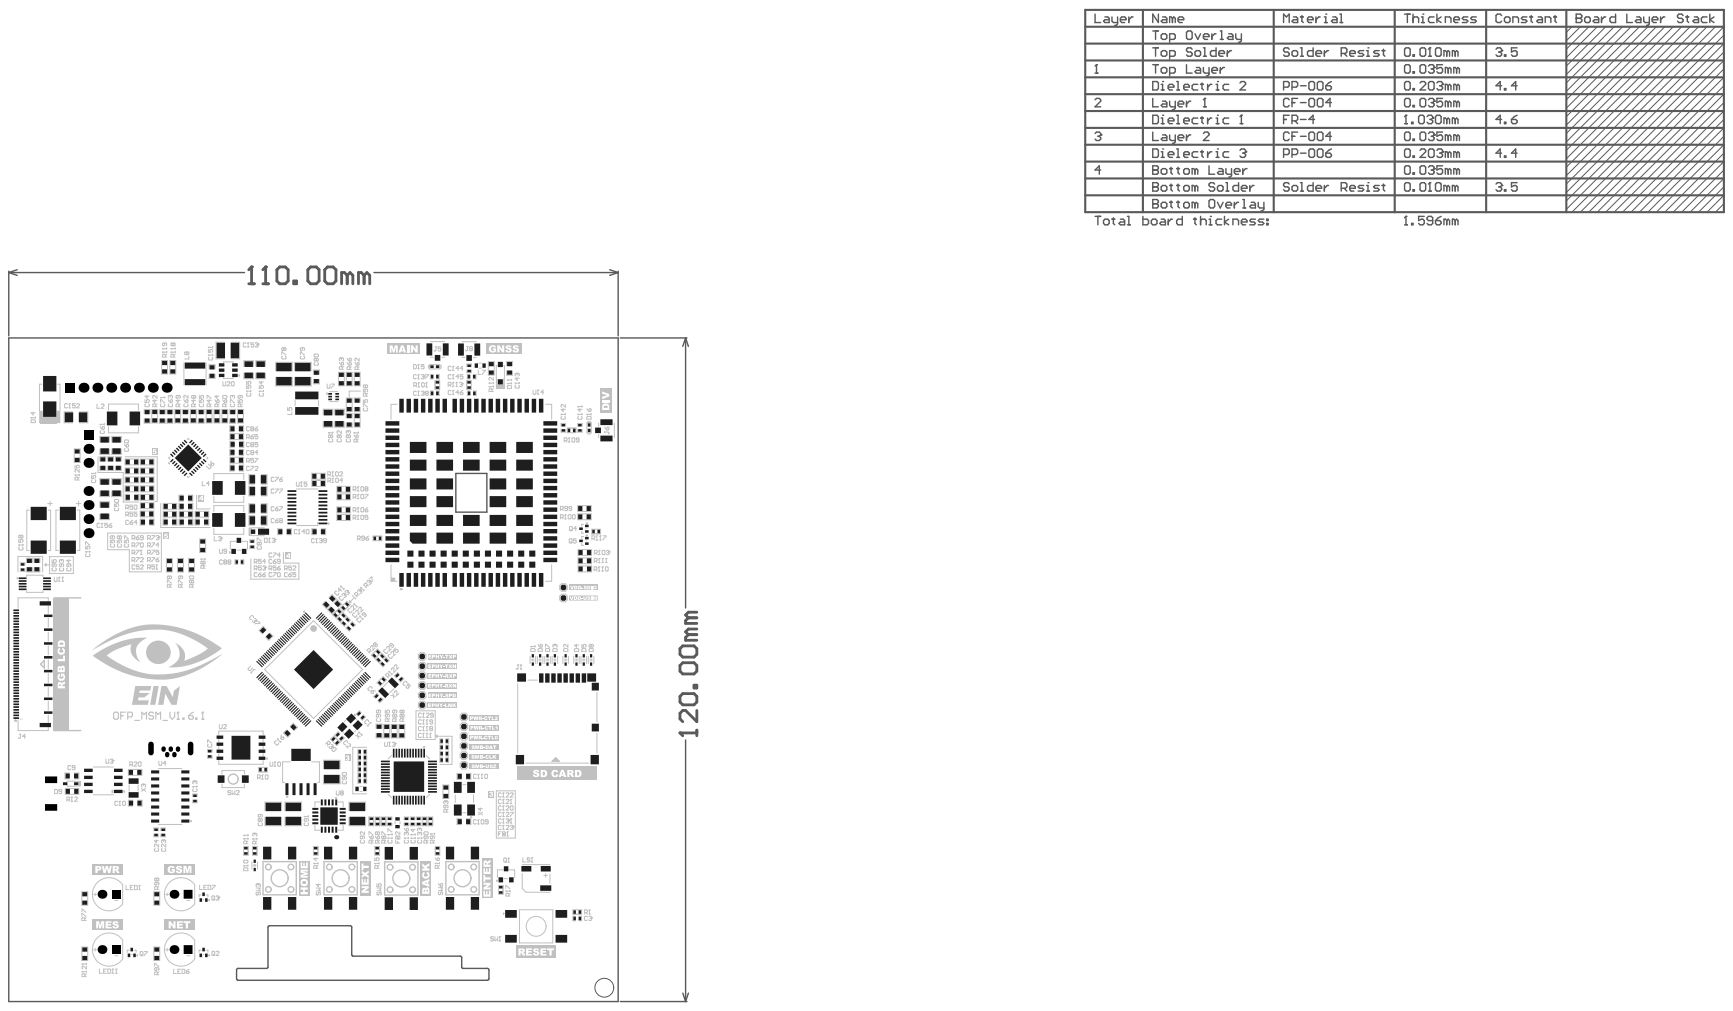
[picture p237: page 1]

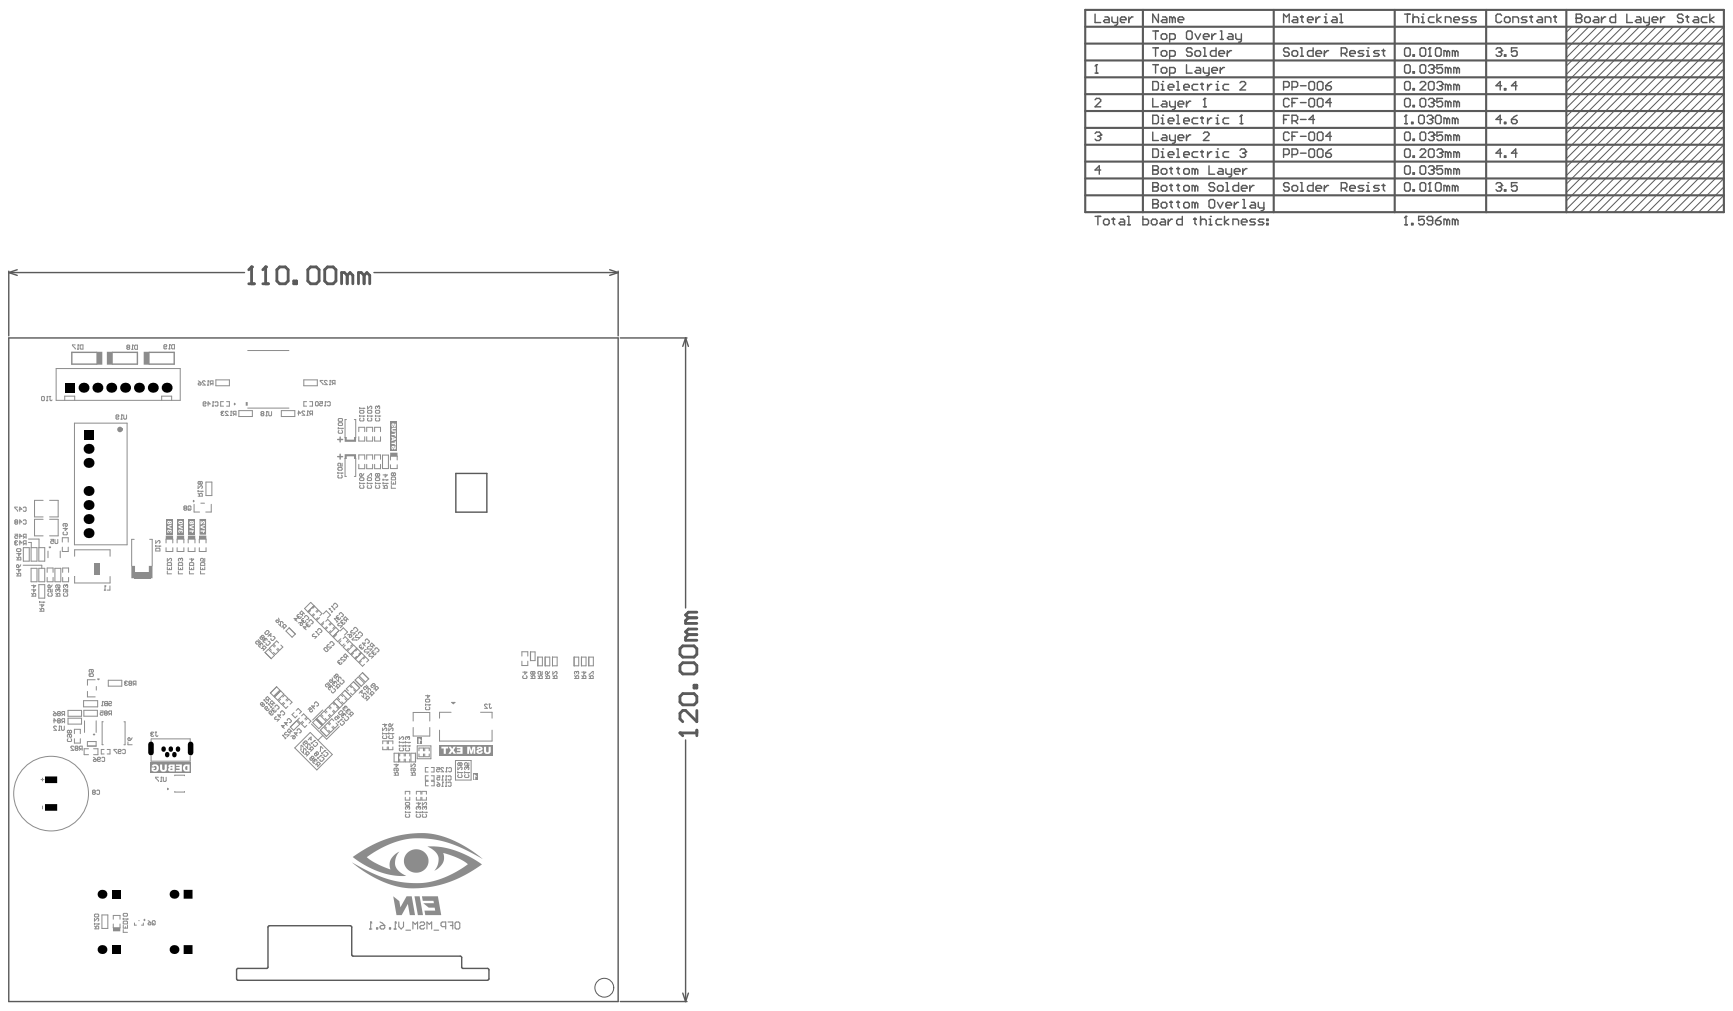
[picture p238: page 2]

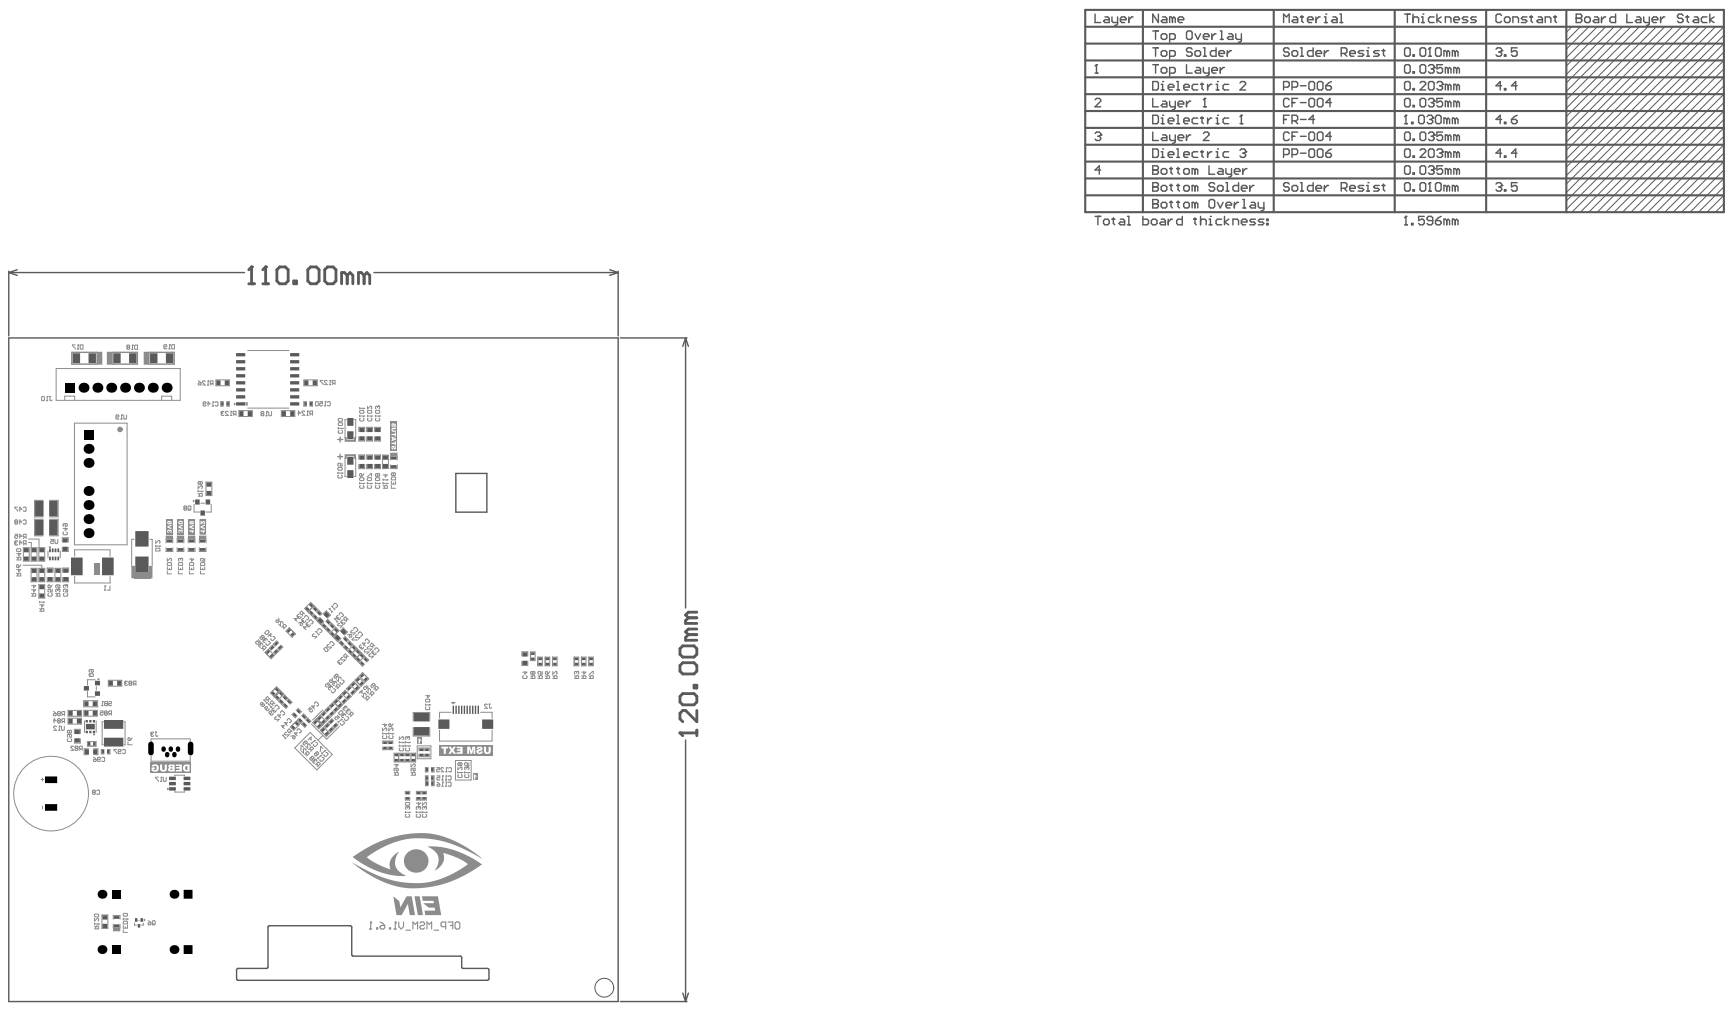
[picture p239: page 4]
