eSpark-Backup/nabilfesal-smartmeter-hw/Design-Files/OFP_MCM_v1.6/Deliverables/_Schematics/Assembly File.pdf

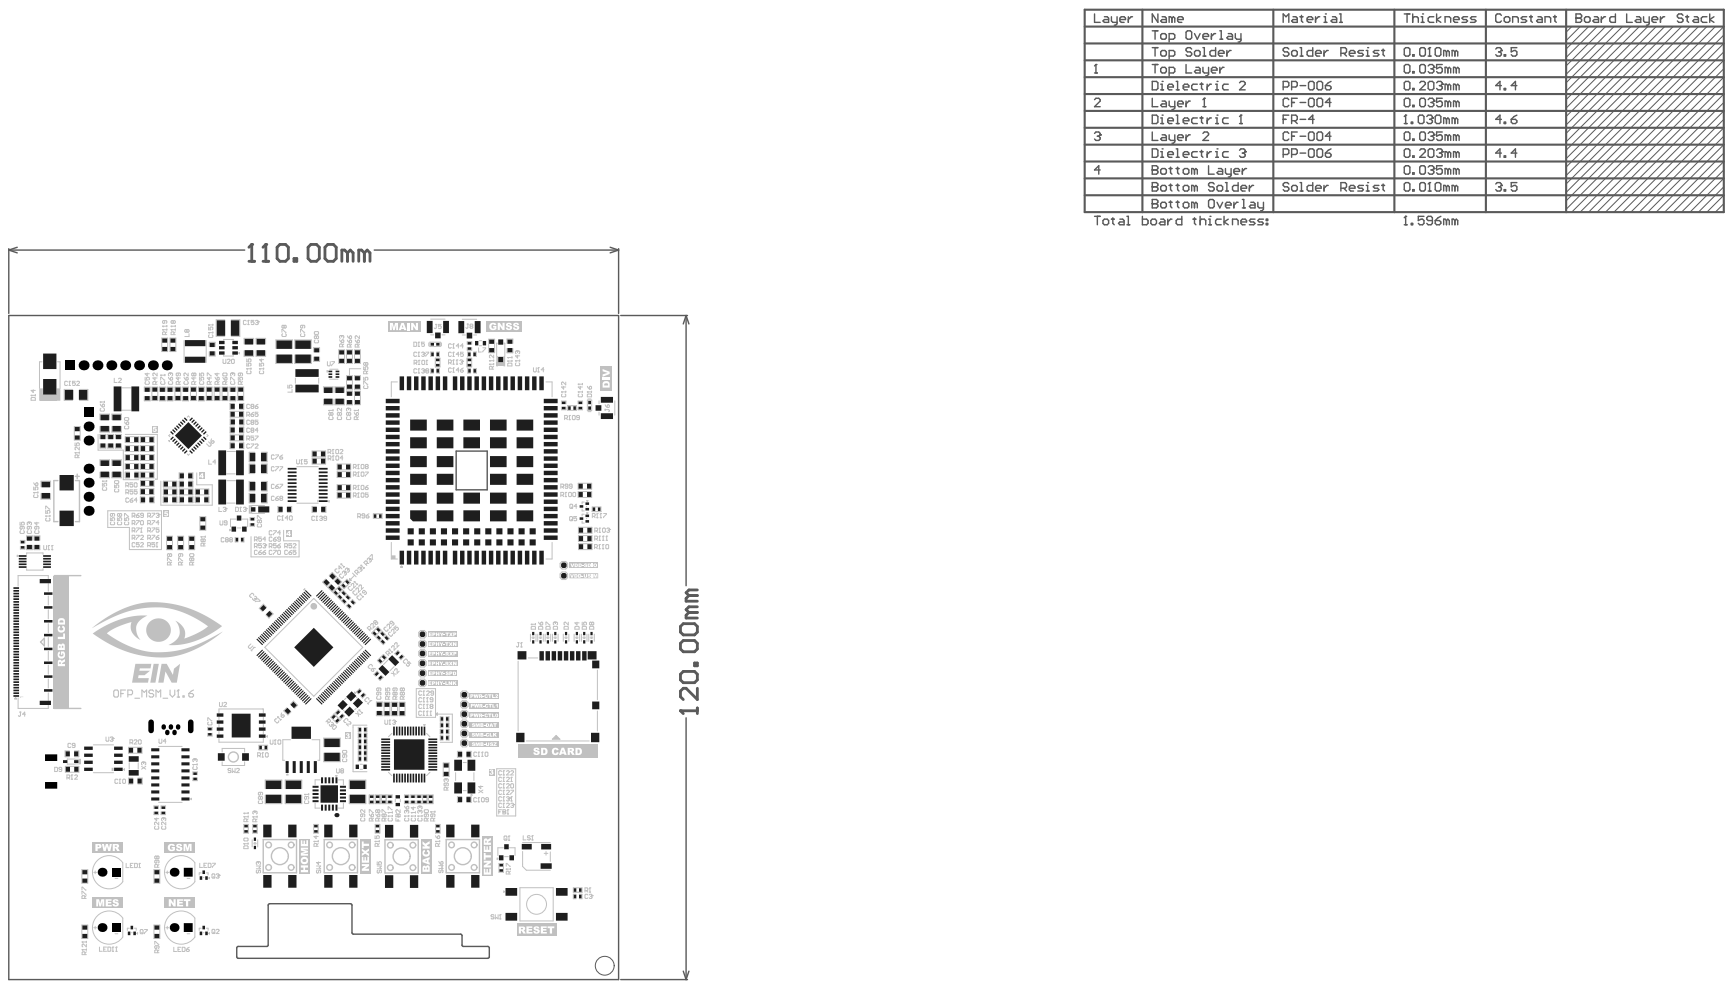
[picture p240: page 1]

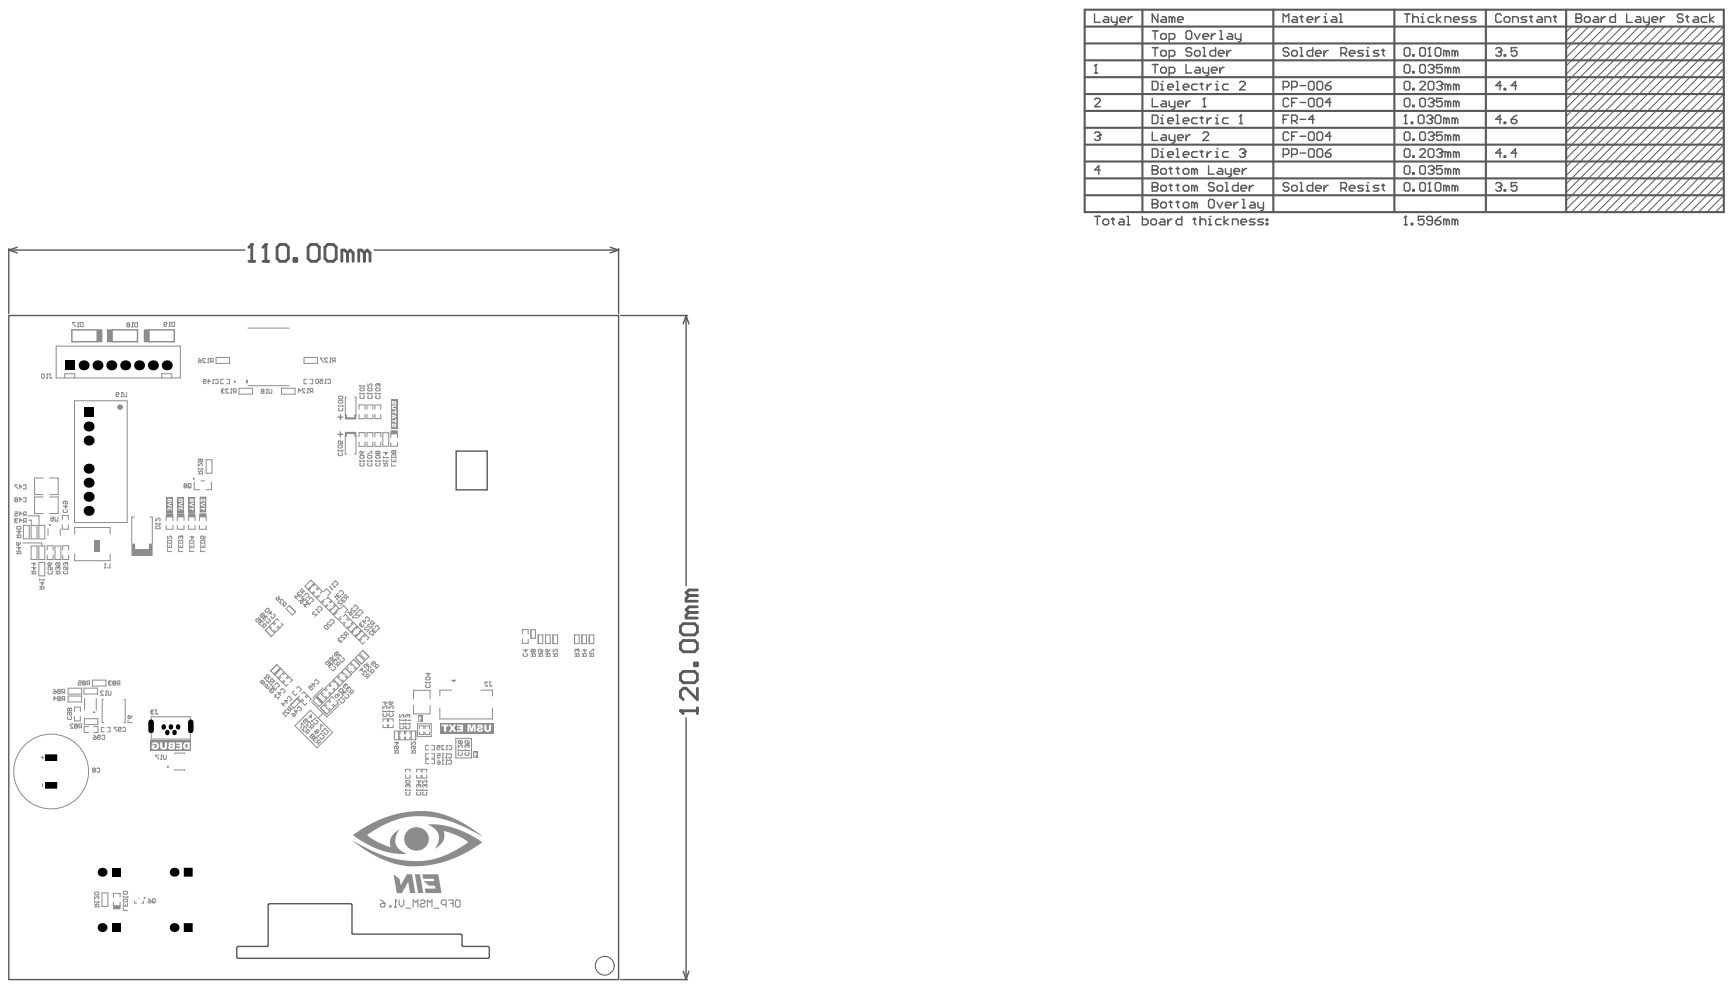
[picture p241: page 2]

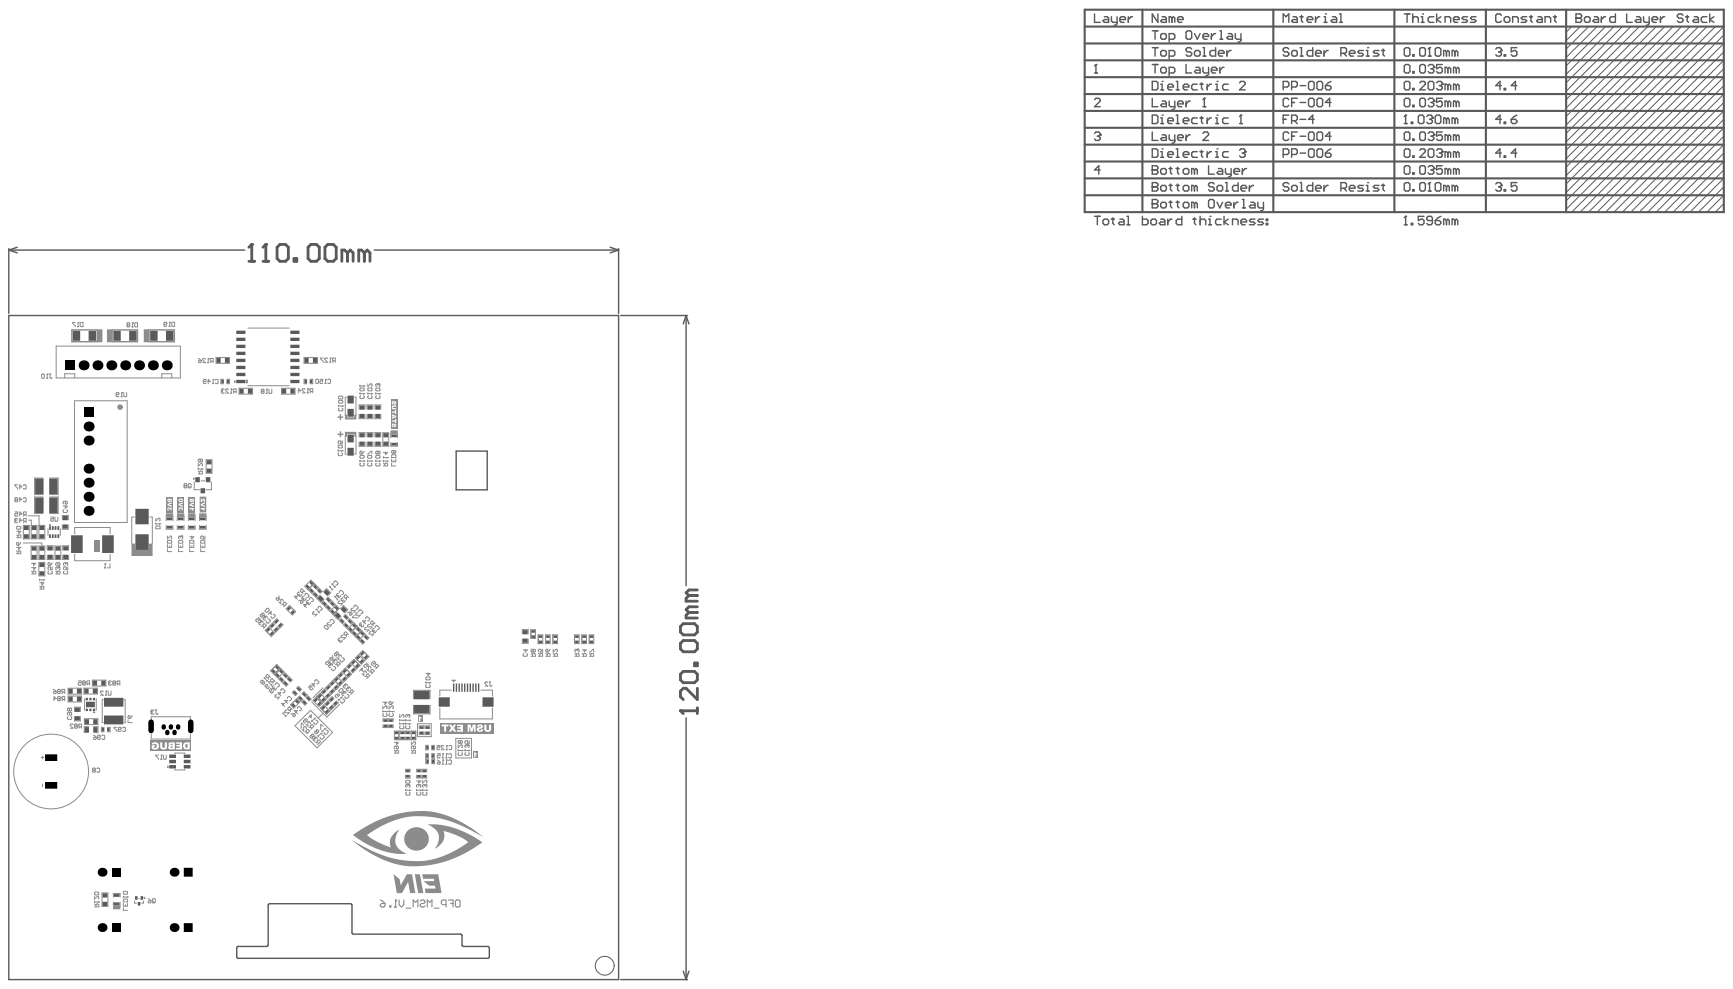
[picture p242: page 4]
