eSpark-Backup/nabilfesal-smartmeter-hw/Design-Files/OFP_MCM_v1.5/Deliverables/_Supporting Files/Assembly File.pdf

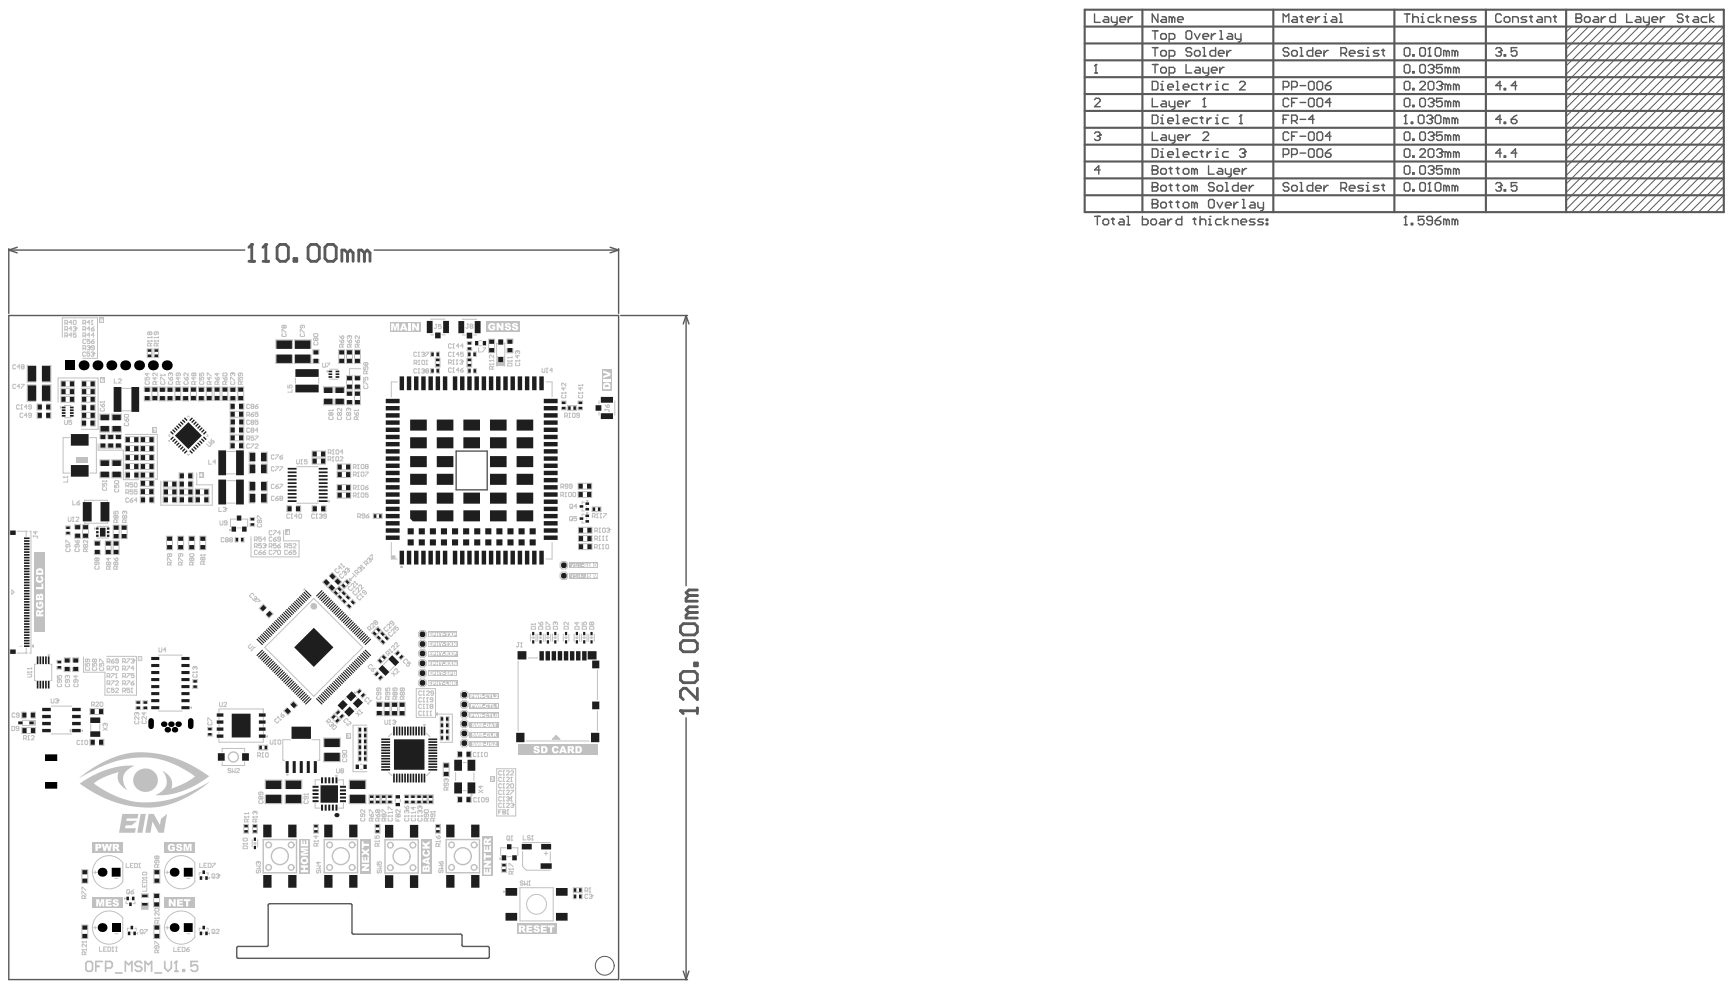
[picture p243: page 1]

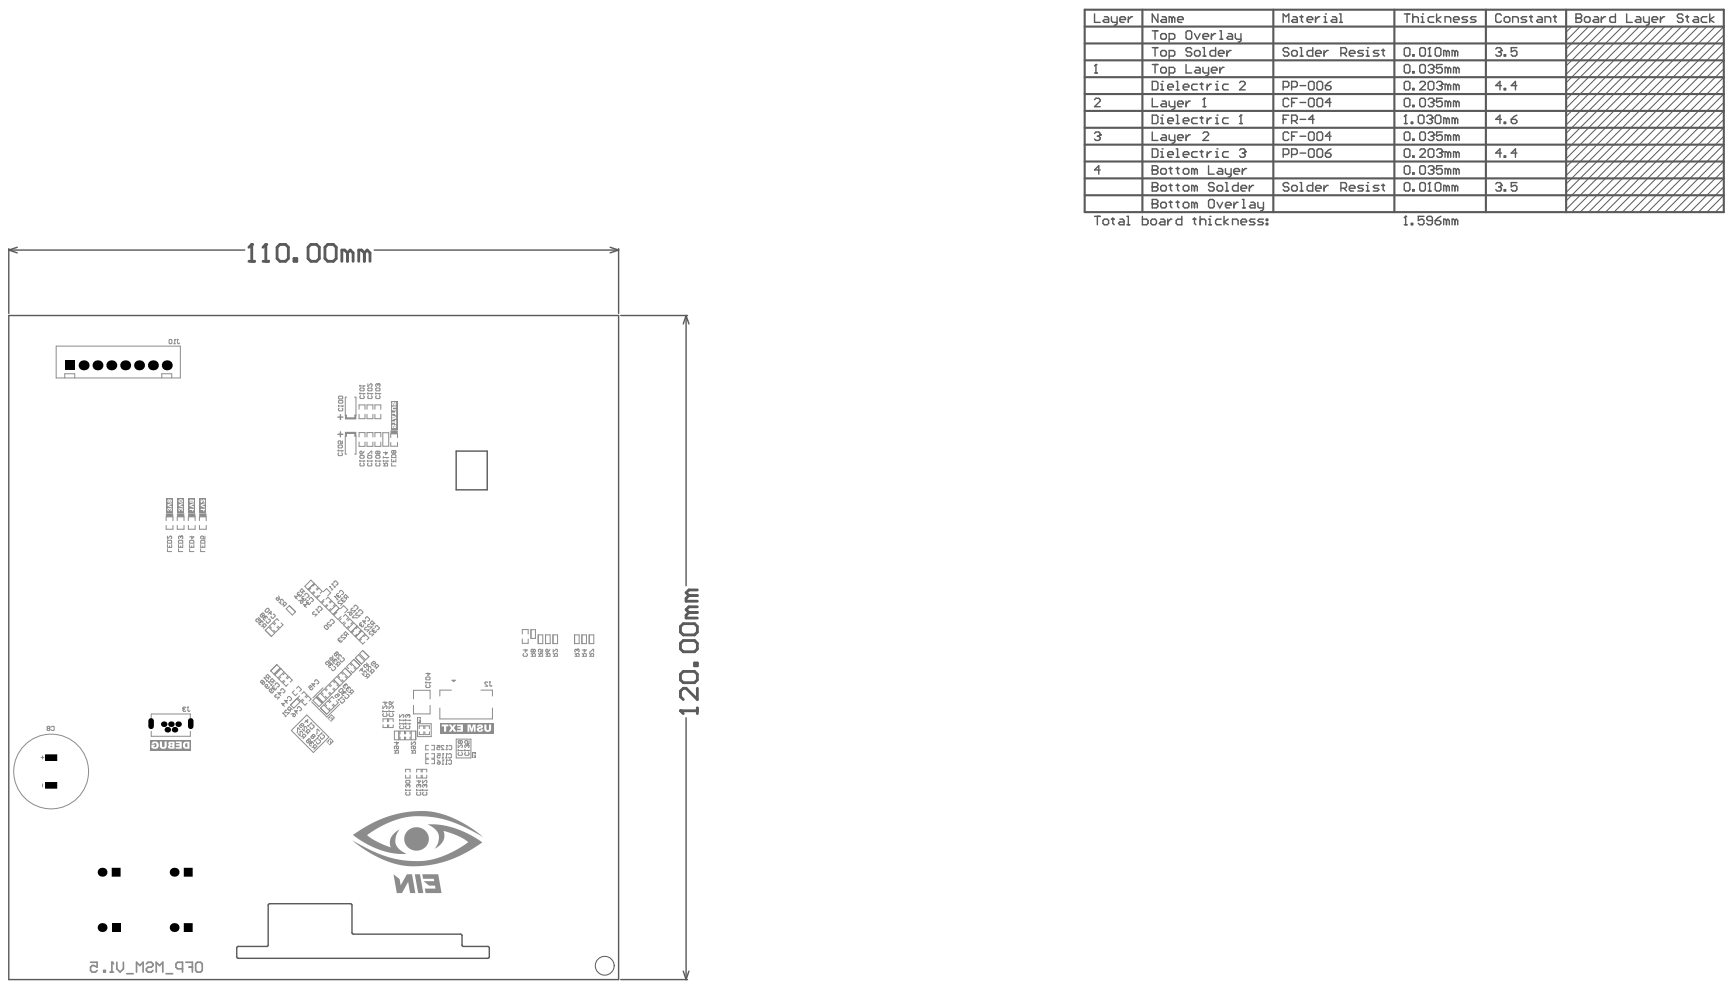
[picture p244: page 2]

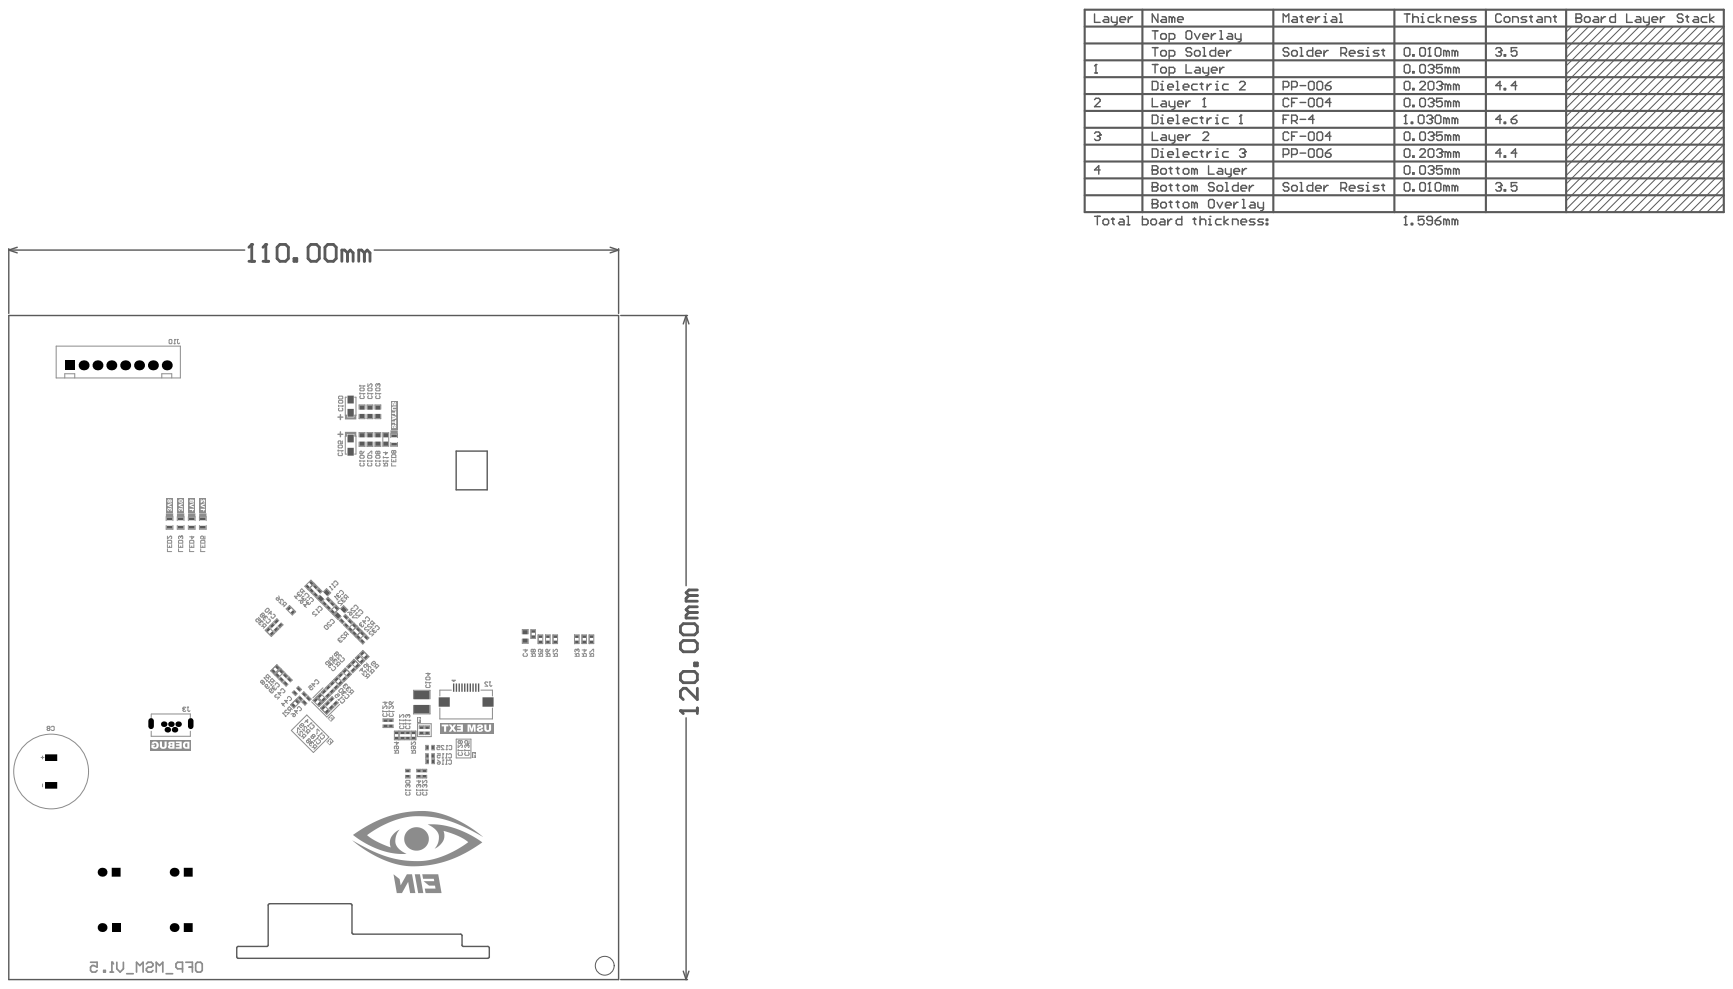
[picture p245: page 4]
