eSpark-Backup/nabilfesal-smartmeter-hw/Design-Files/OFP_SCM_v1.5/Deliverables/Assembly Drawings/Assembly Drawing.pdf

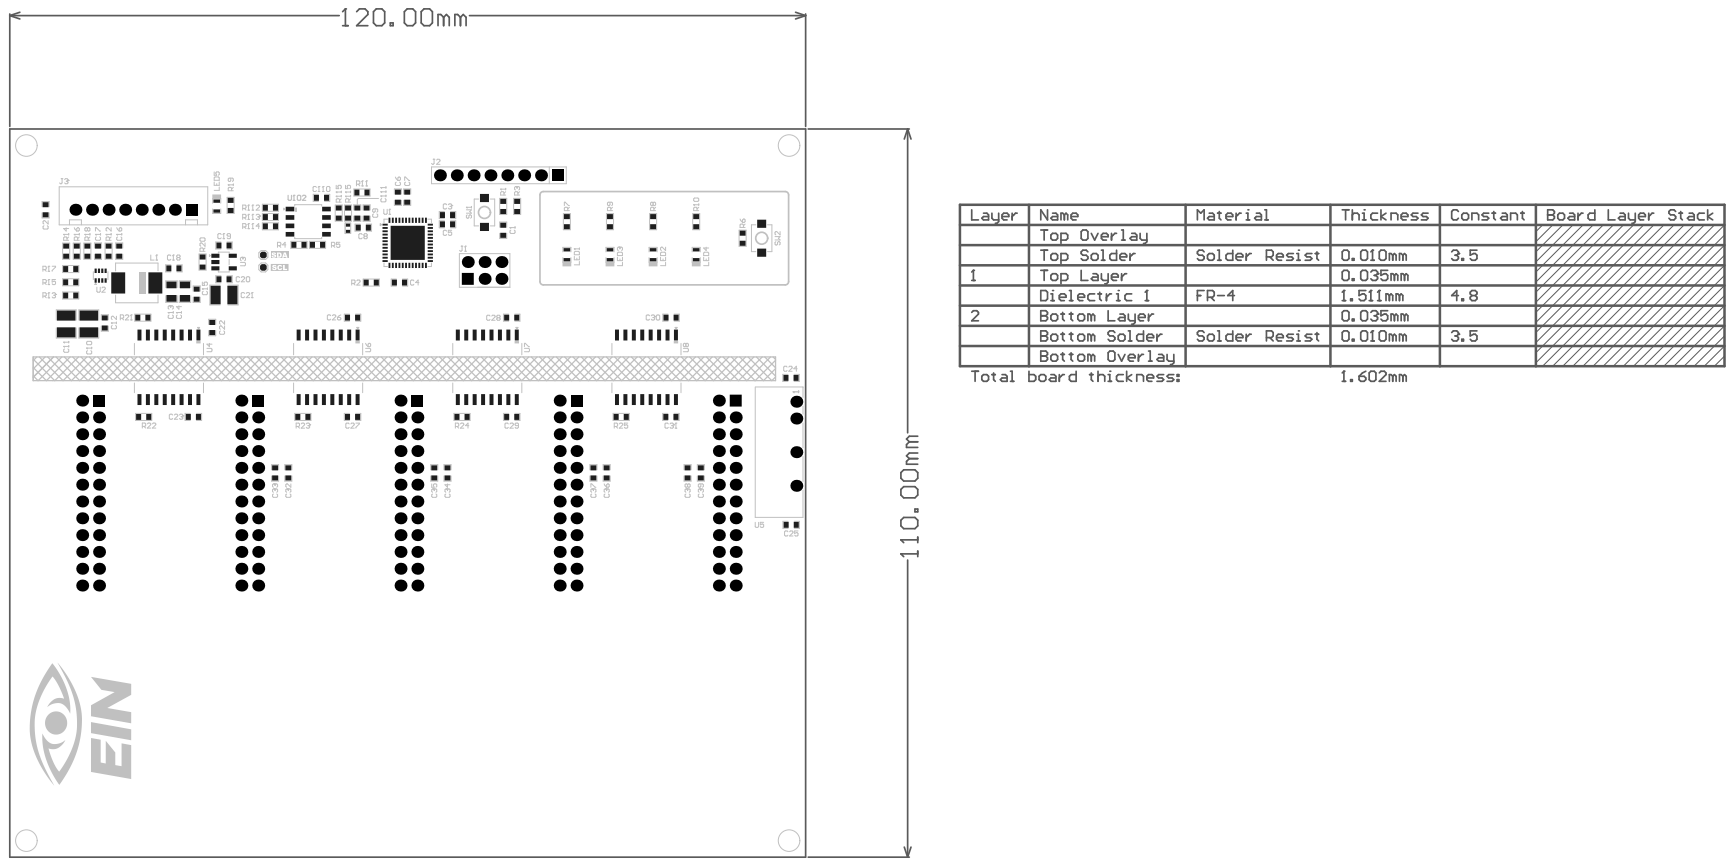
[picture p246: page 1]

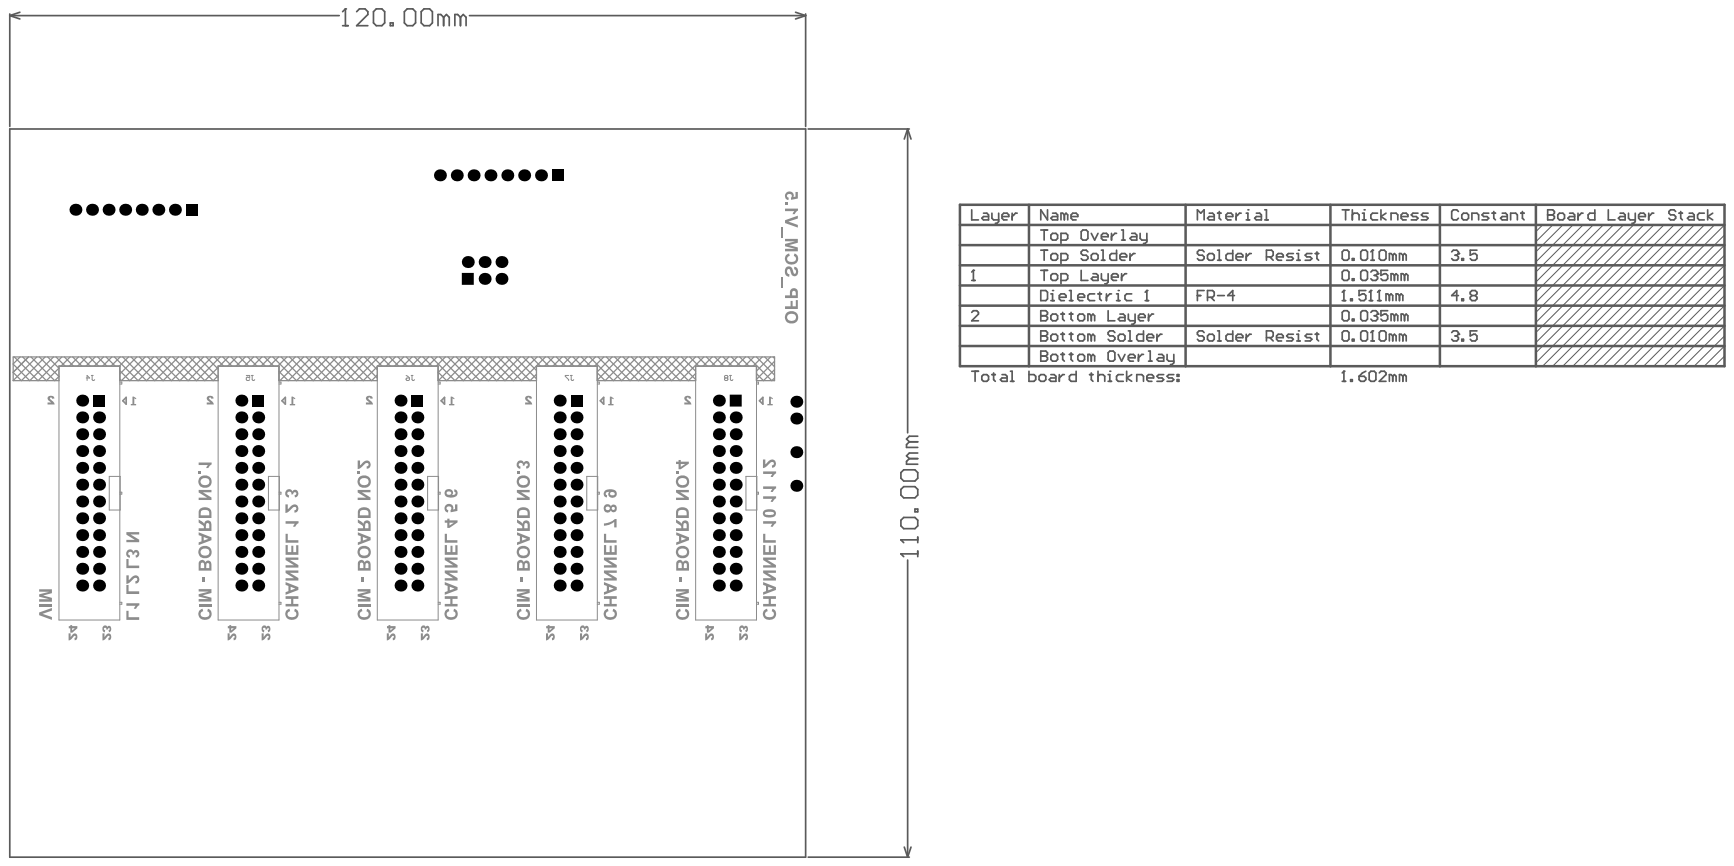
[picture p247: page 2]
