eSpark-Backup/nabilfesal-smartmeter-hw/(list of files, drawings)

Other design files:
Design-Files/OFP_CIM_v1.5/Connectors-Sheet.SchDoc
Design-Files/OFP_CIM_v1.5/OFP_CIM_v1.5.PcbDoc
Design-Files/OFP_CIM_v1.5/OFP_CIM_v1.5.PrjPcb
Design-Files/OFP_CIM_v1.5/Power-Processor-1-Sheet.SchDoc
Design-Files/OFP_CIM_v1.5/Power-Processor-2-Sheet.SchDoc
Design-Files/OFP_CIM_v1.5/Power-Processor-3-Sheet.SchDoc
Design-Files/OFP_MCM_v1.5/GSM-USB-HUB-Sheet.SchDoc
Design-Files/OFP_MCM_v1.5/Microprocessor-Sheet.SchDoc
Design-Files/OFP_MCM_v1.5/OFP_MCM_v1.5.PcbDoc
Design-Files/OFP_MCM_v1.5/OFP_MCM_v1.5.PrjPcb
Design-Files/OFP_MCM_v1.5/Others-Sheet.SchDoc
Design-Files/OFP_MCM_v1.5/Power-Sheet.SchDoc
Design-Files/OFP_MCM_v1.6.1/GSM-USB-HUB-Sheet.SchDoc
Design-Files/OFP_MCM_v1.6.1/Microprocessor-Sheet.SchDoc
Design-Files/OFP_MCM_v1.6.1/OFP_MCM_v1.61.PcbDoc
Design-Files/OFP_MCM_v1.6.1/OFP_MCM_v1.61.PrjPcb
Design-Files/OFP_MCM_v1.6.1/Others-Sheet.SchDoc
Design-Files/OFP_MCM_v1.6.1/Power-Sheet.SchDoc
Design-Files/OFP_MCM_v1.6.1/RGB-LCD-Sheet.SchDoc
Design-Files/OFP_MCM_v1.6.2/GSM-USB-HUB-Sheet.SchDoc
Design-Files/OFP_MCM_v1.6.2/Microprocessor-Sheet.SchDoc
Design-Files/OFP_MCM_v1.6.2/OFP_MCM_v1.62.PcbDoc
Design-Files/OFP_MCM_v1.6.2/OFP_MCM_v1.62.PrjPcb
Design-Files/OFP_MCM_v1.6.2/Others-Sheet.SchDoc
Design-Files/OFP_MCM_v1.6.2/Power-Sheet.SchDoc
Design-Files/OFP_MCM_v1.6.2/RGB-LCD-Sheet.SchDoc
Design-Files/OFP_MCM_v1.6.3/GSM-USB-HUB-Sheet.SchDoc
Design-Files/OFP_MCM_v1.6.3/Microprocessor-Sheet.SchDoc
Design-Files/OFP_MCM_v1.6.3/OFP_MCM_v1.6.3.PcbDoc
Design-Files/OFP_MCM_v1.6.3/OFP_MCM_v1.6.3.PrjPcb
Design-Files/OFP_MCM_v1.6.3/Others-Sheet.SchDoc
Design-Files/OFP_MCM_v1.6.3/Power-Sheet.SchDoc
Design-Files/OFP_MCM_v1.6.3/RGB-LCD-Sheet.SchDoc
Design-Files/OFP_MCM_v1.6/OFP_MCM_v1.6.PrjPcb
Design-Files/OFP_SCM_v1.5/OFP_SCM_v1.5.PcbDoc
Design-Files/OFP_SCM_v1.5/OFP_SCM_v1.5.PrjPcb
Design-Files/OFP_SCM_v1.6/Board-Connectors.SchDoc
Design-Files/OFP_SCM_v1.6/Isolation-Sheet.SchDoc
Design-Files/OFP_SCM_v1.6/Microcontroller-Sheet.SchDoc
Design-Files/OFP_SCM_v1.6/OFP_SCM_v1.6.PcbDoc
Design-Files/OFP_SCM_v1.6/OFP_SCM_v1.6.PrjPcb
Design-Files/OFP_SCM_v1.6/Power-Sheet.SchDoc
Design-Files/OFP_USM_v1.5/OFP_USM_v1.5.PcbDoc
Design-Files/OFP_USM_v1.5/OFP_USM_v1.5.PrjPcb
Design-Files/OFP_USM_v1.5/USB-SIM-Connector-Sheet.SchDoc
Design-Files/OFP_VIM_DC_v1.51/INPUT-Connectors-Sheet.SchDoc
Design-Files/OFP_VIM_DC_v1.51/OFP_VIM_DC_v1.51.PcbDoc
Design-Files/OFP_VIM_DC_v1.51/OFP_VIM_DC_v1.51.PrjPcb
Design-Files/OFP_VIM_v1.5.2/INPUT-Connectors-Sheet.SchDoc
Design-Files/OFP_VIM_v1.5.2/OFP_VIM_v1.5.2.PcbDoc
Design-Files/OFP_VIM_v1.5.2/OFP_VIM_v1.5.2.PrjPcb
Design-Files/OFP_VIM_v1.5.2/Power-Supply-Sheet.SchDoc
Design-Files/OFP_VIM_v1.51/OFP_VIM_v1.51.PrjPcb
