eSpark-Backup/nabilfesal-smartmeter-hw/(commit log)

2025-01-22 #2 CIM Board In progress
    [BACK_V1.1.STEP, BODY_V1.1.STEP, Bracket LCD_V1.3.STEP, EIN-BOM_MSM-Final-010824.xlsx, FRONT_V1.4.STEP, OFP_CIM_v1.5.PrjPcb, Power-Processor-1-Sheet.SchDoc]
2025-01-23 #2 CIM board complete. PDF generated. Graphical error remaining
    [Connectors-Sheet.SchDoc, OFP_CIM_v1.5.PrjPcb, Power-Processor-1-Sheet.SchDoc, Power-Processor-2-Sheet.SchDoc, Power-Processor-3-Sheet.SchDoc]
2025-01-24 #2 Graphical Error removed. PDF Updated
    [Connectors-Sheet.SchDoc, Power-Processor-1-Sheet.SchDoc, Power-Processor-2-Sheet.SchDoc, Power-Processor-3-Sheet.SchDoc]
2025-01-24 #3 SCM Board In Progress
    [Isolation-Sheet.SchDoc, Microcontroller-Sheet.SchDoc, OFP_SCM_v1.5.PrjPcb, Power-Sheet.SchDoc]
2025-01-27 #3 SCM Board Complete. PDF Generated.
    [Board-Connectors.SchDoc, Isolation-Sheet.SchDoc, Microcontroller-Sheet.SchDoc, OFP_SCM_v1.5.PrjPcb, Power-Sheet.SchDoc]
2025-01-29 #4 Complete. PDF generated
    [OFP_USM_v1.5.PrjPcb, USB-SIM-Connector-Sheet.SchDoc]
2025-01-30 #5 In Progress
    [Microprocessor-Sheet.SchDoc, OFP_MCM_v1.5.PrjPcb]
2025-02-03 #3 Complete. PDF generated. Minor footprints updated remaining.
    [GSM-USB-HUB-Sheet.SchDoc, Microprocessor-Sheet.SchDoc, OFP_MCM_v1.5.PrjPcb, Others-Sheet.SchDoc, Power-Sheet.SchDoc, RGB-LCD-Sheet.SchDoc]
2025-02-04 #5 Symbol/footprint corrections. PDF udpated.
    [GSM-USB-HUB-Sheet.SchDoc, OFP_MCM_v1.5.PrjPcb, Others-Sheet.SchDoc, Power-Sheet.SchDoc, RGB-LCD-Sheet.SchDoc]
2025-02-04 #5 Warnings removed. PDF updated.
    [GSM-USB-HUB-Sheet.SchDoc, Microprocessor-Sheet.SchDoc, Others-Sheet.SchDoc, Power-Sheet.SchDoc, RGB-LCD-Sheet.SchDoc]
2025-02-04 #6 Schematic Complete. PDF generated. Transformer will need to change when PCB will start.
    [INPUT-Connectors-Sheet.SchDoc, OFP_VIM_v1.5.PrjPcb, Power-Supply-Sheet.SchDoc]
2025-02-04 #7 PCB Design Completed
    [OFP_CIM_v1.5.PcbDoc, OFP_CIM_v1.5.PrjPcb]
2025-02-06 EIN Altium schematic template added. EIN logo added.
2025-02-06 #2 EIN logo template added. PDF updated.
    [Connectors-Sheet.SchDoc, Power-Processor-1-Sheet.SchDoc, Power-Processor-2-Sheet.SchDoc, Power-Processor-3-Sheet.SchDoc]
2025-02-06 #5 EIN logo template added. PDF updated.
    [GSM-USB-HUB-Sheet.SchDoc, Microprocessor-Sheet.SchDoc, Others-Sheet.SchDoc, Power-Sheet.SchDoc, RGB-LCD-Sheet.SchDoc]
2025-02-06 #5 PDF moved to schematic folder
2025-02-06 #3 EIN logo template added. PDF updated.
    [Board-Connectors.SchDoc, Isolation-Sheet.SchDoc, Microcontroller-Sheet.SchDoc, OFP_SCM_v1.5.PrjPcb, Power-Sheet.SchDoc]
2025-02-06 #4 EIN logo template added. PDF updated.
    [USB-SIM-Connector-Sheet.SchDoc]
2025-02-06 #6 EIN logo template added. PDF updated.
    [INPUT-Connectors-Sheet.SchDoc, Power-Supply-Sheet.SchDoc]
2025-02-06 #3 Connector pins inverted according to the PCB requirements. PDF updated.
    [Board-Connectors.SchDoc, Microcontroller-Sheet.SchDoc]
2025-02-06 #3 Debug connector inverted as per PCB request. PDF updated.
    [Microcontroller-Sheet.SchDoc]
2025-02-06 #8 Placement Completed
    [OFP_SCM_v1.5.PcbDoc, OFP_SCM_v1.5.PrjPcb]
2025-02-07 #8 PCB Design Completed
    [OFP_CIM_v1.5.PcbDoc, OFP_SCM_v1.5.PcbDoc, OFP_SCM_v1.5.PrjPcb]
2025-02-13 #10 Routing in Progress
    [GSM-USB-HUB-Sheet.SchDoc, Microprocessor-Sheet.SchDoc, OFP_MCM_v1.5.PcbDoc, OFP_MCM_v1.5.PrjPcb, OFP_SCM_v1.5.PcbDoc, OFP_USM_v1.5.PcbDoc, OFP_USM_v1.5.PrjPcb, OFP_USM_v1.5.step]
2025-02-14 Routing In Progress
    [OFP_MCM_v1.5.PcbDoc, Power-Sheet.SchDoc]
2025-02-21 #10 Routing Completed.. Finalizing in Progress
    [GSM-USB-HUB-Sheet.SchDoc, OFP_MCM_v1.5.PcbDoc, OFP_MCM_v1.5.PrjPcb]
2025-02-24 #10 Design Completed
    [GSM-USB-HUB-Sheet.SchDoc, OFP_MCM_v1.5.PcbDoc]
2025-02-25 #9 Placement Completed
    [INPUT-Connectors-Sheet.SchDoc, OFP_VIM_v1.5.PcbDoc, Power-Supply-Sheet.SchDoc]
2025-02-26 #15 #14 #13 #12 Client BOM added.
    [Client-BOM-OFP_CIM_v1.5.xlsx, Client-BOM-OFP_MCM_v1.5.xlsx, Client-BOM-OFP_SCM_v1.5.xlsx, Client-BOM-OFP_USM_v1.5.xlsx]
2025-02-27 #15 #14 #13 #12 BOM added.
    [Client-BOM-OFP_CIM_v1.5.xlsx, Client-BOM-OFP_MCM_v1.5.xlsx, Client-BOM-OFP_SCM_v1.5.xlsx, Client-BOM-OFP_USM_v1.5.xlsx, Client-BOM-OFP_VIM_v1.5.xlsx]
2025-02-28 #16 Updated BOM.
    @basit-eSpark @faizi968 VIM design k BOM me Transformer ki details edit kr di han
    [Client-BOM-OFP_VIM_v1.5.xlsx]
2025-02-28 #12 eSpark BOM added.
    [eSpark-BOM-OFP_CIM_v1.5.xlsx]
2025-02-28 #13 eSpark BOM added.
    [Client-BOM-OFP_MCM_v1.5.xlsx, eSpark-BOM-OFP_MCM_v1.5.xlsx]
2025-03-03 #16 #15 #14 eSpark and Client BOM Completed.
    [Client-BOM-OFP_MCM_v1.5.xlsx, eSpark-BOM-OFP_MCM_v1.5.xlsx, eSpark-BOM-OFP_SCM_v1.5.xlsx, eSpark-BOM-OFP_USM_v1.5.xlsx, eSpark-BOM-OFP_VIM_v1.5.xlsx]
2025-03-06 #6 Custom transformer added in the schematics
    [Power-Supply-Sheet.SchDoc]
2025-03-07 #6 3-phase AC connector changed. PDF updated
    [INPUT-Connectors-Sheet.SchDoc, Power-Supply-Sheet.SchDoc]
2025-03-07 #6 3-phase connector changed again to KF2EDGSRM-7.62-4P
    [INPUT-Connectors-Sheet.SchDoc]
2025-03-07 #9 Design Completed
    [OFP_VIM_v1.5.PcbDoc]
2025-03-10 #6 Connector updated - PDF updated
    [INPUT-Connectors-Sheet.SchDoc]
2025-03-10 #5 Enable pin directly pulled up as in the current firmware usage. PDF updated
    [RGB-LCD-Sheet.SchDoc]
2025-03-10 #10 All Design files ,Deliverables Generated
    [Centroid File.csv, OFP_CIM_v1.5..DWG, OFP_CIM_v1.5.DXF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]
2025-03-10 #13 Mark R83, R85 as DNP. R82 0ohm will be fitted.
    @basit-eSpark BOM Update kr dia ha
    [Client-BOM-OFP_MCM_v1.5.xlsx, eSpark-BOM-OFP_MCM_v1.5.xlsx]
2025-03-10 #16 Client and eSpark BOM Updated.
    [Client-BOM-OFP_VIM_v1.5.xlsx, eSpark-BOM-OFP_VIM_v1.5.xlsx]
2025-03-12 #10 Step 3D file for push button updated
    [OFP_MCM_v1.5.PcbDoc]
2025-03-13 #13 LCD Peripheral added.
    [Client-BOM-OFP_MCM_v1.5.xlsx, eSpark-BOM-OFP_MCM_v1.5.xlsx]
2025-03-18 #16 Transformer Price remove from eSpark BOM
    [eSpark-BOM-OFP_VIM_v1.5.xlsx]
2025-03-18 #9 Connector moved and Deliverables updated
    [Centroid File.csv, OFP_VIM_v1.5..DWG, OFP_VIM_v1.5.DWG, OFP_VIM_v1.5.DXF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]
2025-03-24 Add: sample data file for MSM
    [IND10000124-20241106-105806-testfile.csv]
2025-03-27 #2 #6 Terminal Block connector changed.
    [Connectors-Sheet.SchDoc, INPUT-Connectors-Sheet.SchDoc]
2025-03-27 #7 Connector Updated in VIM and CIM and Deliverables Updated
    [Centroid File.csv, OFP_CIM_v1.5..DWG, OFP_CIM_v1.5.DXF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]
2025-03-27 #17 CIM and VIM Client BOM Updated.
    Connector Change kiye han
    [Client-BOM-OFP_CIM_v1.5.xlsx, Client-BOM-OFP_VIM_v1.5.xlsx]
2025-03-27 #7 Deliverables updated
    [OFP_CIM_v1.5..DWG, OFP_CIM_v1.5.DXF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]
2025-04-03 #10 Solder Paste updated in PCB and Deliverables generated
    [OFP_MCM_v1.5.GBL, OFP_MCM_v1.5.GBO, OFP_MCM_v1.5.GBP, OFP_MCM_v1.5.GBS, OFP_MCM_v1.5.GKO, OFP_MCM_v1.5.GM1, OFP_MCM_v1.5.GTL, OFP_MCM_v1.5.GTO]
2025-04-03 #9 R5 and C11 updated in PCB and Deliverables generated
    [Centroid File.csv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]
2025-04-11 #13 Client and eSpark BOM updated.
    @basit-eSpark @faizi968 C149 Capacitor GRM188Z71A106KA73D to ---> GRM188R61E106KA73D
    [Client-BOM-OFP_MCM_v1.5.xlsx, eSpark-BOM-OFP_MCM_v1.5.xlsx]
2025-05-06 LCD datasheet and testing individual MSM boards doc added.
2025-05-13 Prototype Pics added
2025-06-13 #6 VIM_DC added
    [Client-BOM-OFP_VIM_v1.5.xlsx, INPUT-Connectors-Sheet.SchDoc, OFP_VIM_DC_v1.5.PcbDoc, OFP_VIM_DC_v1.5.PrjPcb, eSpark-BOM-OFP_VIM_v1.5.xlsx]
2025-06-13 #6 PDF for DC_VIM board updated
2025-06-13 #10 #9 Changes Completed
    [Centroid File.csv, Client-BOM-OFP_MCM_v1.5.xlsx, GSM-USB-HUB-Sheet.SchDoc, INPUT-Connectors-Sheet.SchDoc, Microprocessor-Sheet.SchDoc, OFP_MCM_v1.6.DWG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]
2025-06-13 #9 Client BOM added
    [Client-BOM-OFP_VIM_DC_v1.5.xlsx, Client-BOM-OFP_VIM_v1.5.xlsx, eSpark-BOM-OFP_VIM_v1.5.xlsx]
2025-07-14 #9 Silk updated and Deliverables generated
    [Centroid File.csv, Client-BOM-OFP_VIM_DC_v1.5.xlsx, Client-BOM-OFP_VIM_v1.51.xlsx, INPUT-Connectors-Sheet.SchDoc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]
2025-08-21 #18 MCM v1.6 schematic changes complete. PDF updated
    [GSM-USB-HUB-Sheet.SchDoc, Microprocessor-Sheet.SchDoc, OFP_MCM_v1.6.PcbDoc, OFP_MCM_v1.6.PrjPcb, Others-Sheet.SchDoc, Power-Sheet.SchDoc, RGB-LCD-Sheet.SchDoc]
2025-08-22 #20 Changes completed, deliverables generated
    [Centroid.csv, OFP_MCM_v1.6.DWG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]
2025-08-22 @basit-eSpark MCM-v1.6 Client BOM Updated.
    [Client-BOM-OFP_MCM_v1.5.xlsx, Client-BOM-OFP_MCM_v1.6.xlsx, eSpark-BOM-OFP_MCM_v1.5.xlsx]
2025-08-25 #18 Additional protection added.
    [Client-BOM-OFP_MCM_v1.5.xlsx, Client-BOM-OFP_MCM_v1.6.xlsx, OFP_MCM_v1.6.PrjPcb, Others-Sheet.SchDoc, RGB-LCD-Sheet.SchDoc]
2025-08-25 #18 LCD connector changed back to the existing one
    [Client-BOM-OFP_MCM_v1.6.xlsx, RGB-LCD-Sheet.SchDoc]
2025-08-25 #18 Protections added on GSM. Protection scheme changed according to detail info
    [GSM-USB-HUB-Sheet.SchDoc, Others-Sheet.SchDoc, Power-Sheet.SchDoc]
2025-08-26 #18 Model update
    [Others-Sheet.SchDoc, Power-Sheet.SchDoc]
2025-08-26 #18 LCD connector updated according to PCB placement
    [RGB-LCD-Sheet.SchDoc]
2025-08-26 #18 PDF updated
    [Power-Sheet.SchDoc]
2025-08-26 @basit-eSpark Client BOM updated.
    [Client-BOM-OFP_MCM_v1.6.xlsx]
2025-08-27 #20 Placement Completed
    [OFP_MCM_v1.6.PcbDoc, OFP_MCM_v1.6.PrjPcb]
2025-08-28 #18 TVS Orientation correct. PDF Updated
    [Others-Sheet.SchDoc]
2025-08-28 #20 PCB Design Completed and Deliverables Generated
    [Centroid File.csv, OFP_MCM_v1.6..DWG, OFP_MCM_v1.6.DWG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]
2025-08-28 Client BOM updated.
    [Client-BOM-OFP_MCM_v1.6.xlsx]
2025-08-28 #20 Antenna Holes Updated and deliverables Generated
    [OFP_MCM_v1.6..DWG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]
2025-08-28 #18 MCM BOM tactile buttons part number updated to 13mm height
    [Client-BOM-OFP_MCM_v1.6.xlsx]
2025-09-26 MCM v1.61 initial push
    [Client-BOM-OFP_MCM_v1.6.xlsx, GSM-USB-HUB-Sheet.SchDoc, Microprocessor-Sheet.SchDoc, OFP_MCM_v1.61.PcbDoc, OFP_MCM_v1.61.PrjPcb, Others-Sheet.SchDoc, Power-Sheet.SchDoc, RGB-LCD-Sheet.SchDoc]
2025-09-26 MCM v1.61 Schematic Changes complete - PDF updated
    [Others-Sheet.SchDoc, Power-Sheet.SchDoc, RGB-LCD-Sheet.SchDoc]
2025-09-26 #20 Changes Completed v1.6.1 and deliverables generated
    [Centroid File.csv, Client-BOM-OFP_MCM_v1.6.xlsx, OFP_MCM_v1.61..DWG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]
2025-09-27 MCM v1.61 BOM added
    [Client-BOM-OFP_MCM_v1.61.xlsx, OFP_MCM_v1.61.PrjPcb, Others-Sheet.SchDoc, RGB-LCD-Sheet.SchDoc]
2025-09-28 #23 R129 removed. PDF and BOM updated
    [Client-BOM-OFP_MCM_v1.61.xlsx, Others-Sheet.SchDoc]
2025-10-09 #23 Diode D20 added in Design and Deliverables Updated
    [Centroid File.csv, Client-BOM-OFP_MCM_v1.62.xlsx, GSM-USB-HUB-Sheet.SchDoc, Microprocessor-Sheet.SchDoc, OFP_MCM_v1.62..DWG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]
2025-10-16 Enclosure files pushed
    [Box Top Label.dxf, INNER BOX.DXF, MSM BoM with Reamrks updated.xlsx, MSM Serial Number - 200 pcs.xlsx, MSM Serial Number.xlsx, OUTER BOX.DXF, QC label.dxf, Serial Number Label.dxf]
2025-10-22 #23 Push Button netlabels changed and deliverables Generated
    [Cenroid File.csv, Centroid File.csv, Client-BOM-OFP_MCM_v1.61.xlsx, Client-BOM-OFP_MCM_v1.62.xlsx, GSM-USB-HUB-Sheet.SchDoc, Microprocessor-Sheet.SchDoc, OFP_MCM_v1.6.3.DWG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]
2025-12-31 #24 Filter cap updated, Bleed resistor added
    [INPUT-Connectors-Sheet.SchDoc, OFP_VIM_v1.5.2.PcbDoc, OFP_VIM_v1.5.2.PrjPcb, Power-Supply-Sheet.SchDoc]
2026-01-13 #25 SCM Design updated, in progress
    [Board-Connectors.SchDoc, Isolation-Sheet.SchDoc, Microcontroller-Sheet.SchDoc, OFP_SCM_v1.6.PcbDoc, OFP_SCM_v1.6.PrjPcb, Power-Sheet.SchDoc]
